CougsInSpace/CougSat1-Hardware/CougSat1-RadioBoard/Documentation/Native/Comms.docx

[Type the author(s)]

[Abstract]

Comms

Inter-Communication System

Revision: [Version]


# 1 Example Heading

Lorem ipsum dolor sit amet, consectetur adipiscing elit. Ut auctor dui vel orci congue imperdiet. Nunc sollicitudin sodales metus. Nunc congue, sem semper egestas dictum, turpis augue feugiat tellus, eget posuere orci ligula ac nunc. Pellentesque quis ex lorem. Suspendisse et tincidunt massa. Curabitur maximus magna id ex ultrices pharetra vel nec ante. Aliquam erat volutpat. Phasellus at felis ullamcorper, molestie tortor a, imperdiet diam. Pellentesque ut porttitor nunc. Pellentesque pharetra at eros eget consectetur. Quisque elementum, libero et scelerisque tristique, leo augue tempor risus, sodales ultricies justo arcu tempus neque. Nulla et cursus velit. Proin sit amet auctor nulla. Mauris ultricies volutpat turpis et bibendum. Mauris sit amet turpis vel felis tristique varius non non lectus. Vestibulum dignissim volutpat erat in luctus.

## 1.1 Example Subheading

Lorem ipsum dolor sit amet, consectetur adipiscing elit. Ut auctor dui vel orci congue imperdiet. Nunc sollicitudin sodales metus. Nunc congue, sem semper egestas dictum, turpis augue feugiat tellus, eget posuere orci ligula ac nunc. Pellentesque quis ex lorem. Suspendisse et tincidunt massa. Curabitur maximus magna id ex ultrices pharetra vel nec ante. Aliquam erat volutpat. Phasellus at felis ullamcorper, molestie tortor a, imperdiet diam. Pellentesque ut porttitor nunc. Pellentesque pharetra at eros eget consectetur. Quisque elementum, libero et scelerisque tristique, leo augue tempor risus, sodales ultricies justo arcu tempus neque. Nulla et cursus velit. Proin sit amet auctor nulla. Mauris ultricies volutpat turpis et bibendum. Mauris sit amet turpis vel felis tristique varius non non lectus. Vestibulum dignissim volutpat erat in luctus.

### 1.1.1 Example Subheading

Lorem ipsum dolor sit amet, consectetur adipiscing elit. Ut auctor dui vel orci congue imperdiet. Nunc sollicitudin sodales metus. Nunc congue, sem semper egestas dictum, turpis augue feugiat tellus, eget posuere orci ligula ac nunc. Pellentesque quis ex lorem. Suspendisse et tincidunt massa. Curabitur maximus magna id ex ultrices pharetra vel nec ante. Aliquam erat volutpat. Phasellus at felis ullamcorper, molestie tortor a, imperdiet diam. Pellentesque ut porttitor nunc. Pellentesque pharetra at eros eget consectetur. Quisque elementum, libero et scelerisque tristique, leo augue tempor risus, sodales ultricies justo arcu tempus neque. Nulla et cursus velit. Proin sit amet auctor nulla. Mauris ultricies volutpat turpis et bibendum. Mauris sit amet turpis vel felis tristique varius non non lectus. Vestibulum dignissim volutpat erat in luctus.

# 2 Example Heading

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

## 2.1 Example Subheading

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

### 2.1.1 Example Subheading

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

Rev. [Version]

Inter-Communication System Comms
