CougsInSpace/CougSat1-Hardware/CougSat1-AvionicBoard/Documentation/Images/AvionicsBottom.1.3.0.png

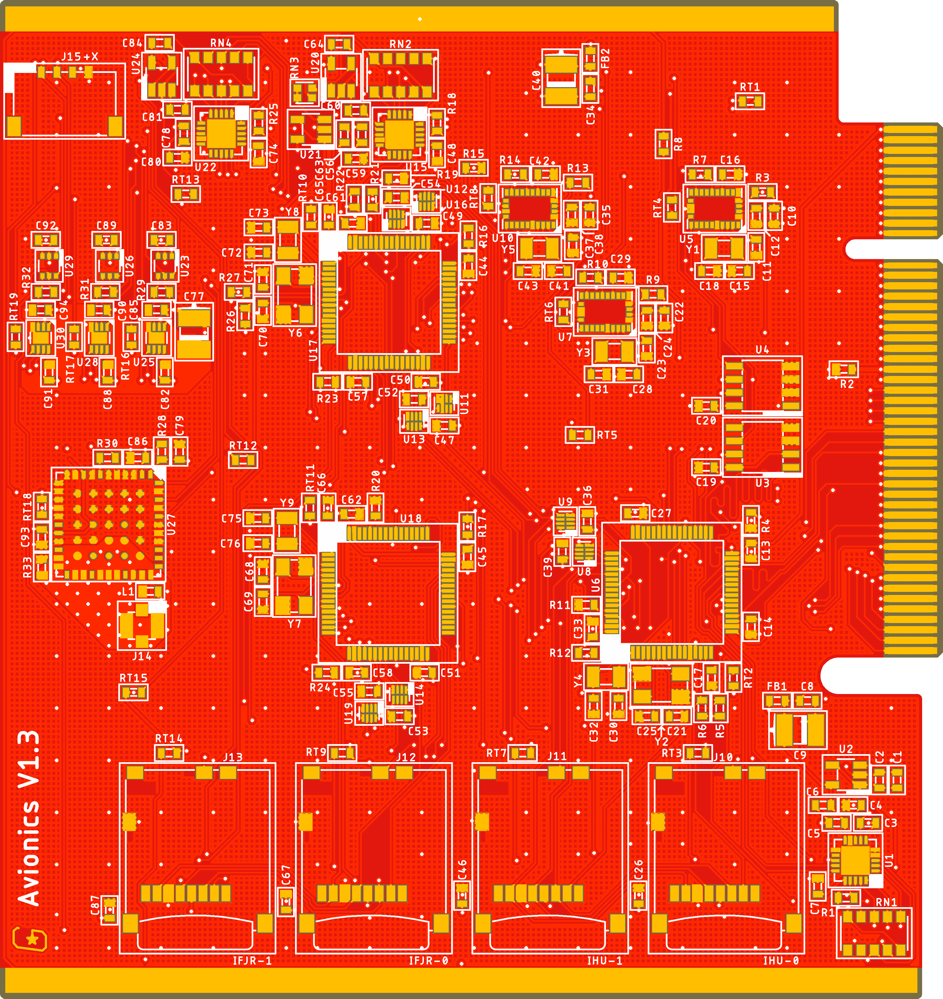
CougSat1-AvionicBoard/Documentation/Images/AvionicsBottom.1.3.0.png
