CougsInSpace/CougSat1-Hardware/CougSat1-Backplane/Documentation/Images/BackplaneBottom.3.0.4.png

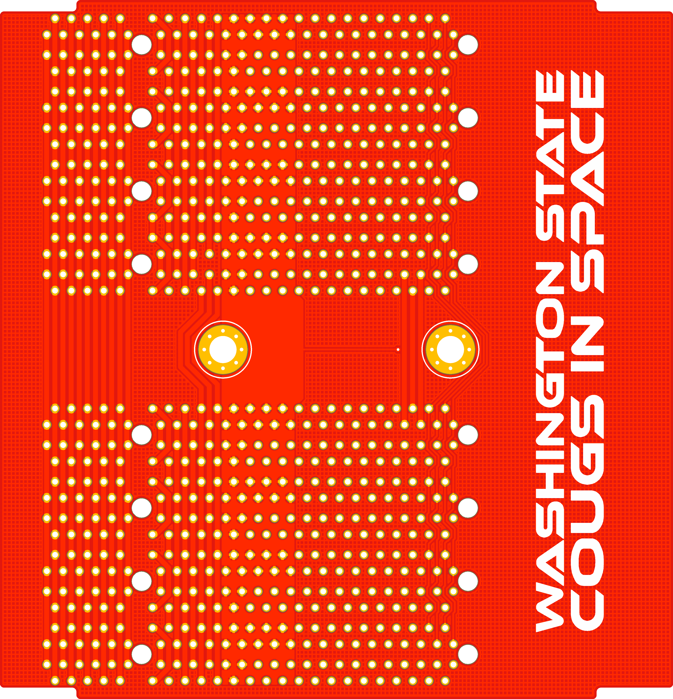
CougSat1-Backplane/Documentation/Images/BackplaneBottom.3.0.4.png
