CougsInSpace/CougSat1-Hardware/CougSat1-Backplane/Documentation/Images/BackplaneBottom.3.2.1.png

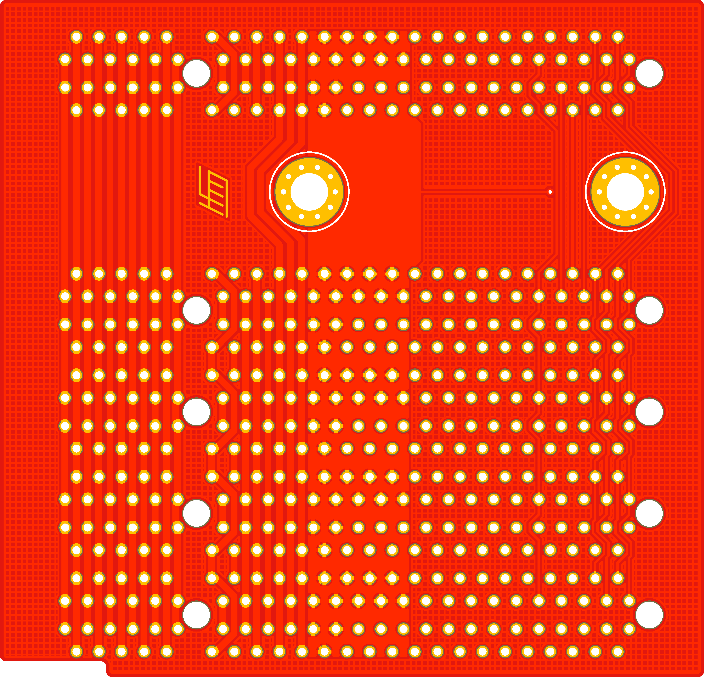
CougSat1-Backplane/Documentation/Images/BackplaneBottom.3.2.1.png
