CougsInSpace/CougSat1-Hardware/CougSat1-Backplane/Documentation/Images/BackplaneTop.3.2.1.png

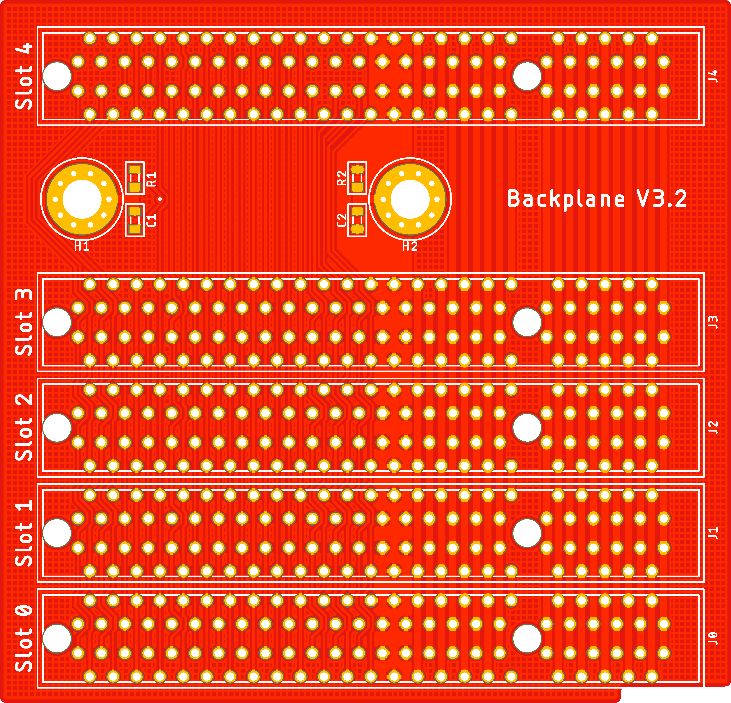
CougSat1-Backplane/Documentation/Images/BackplaneTop.3.2.1.png
