CougsInSpace/CougSat1-Hardware/CougSat1-Backplane/Documentation/Native/PCBImages/Layer_BottomSilkscreen.png

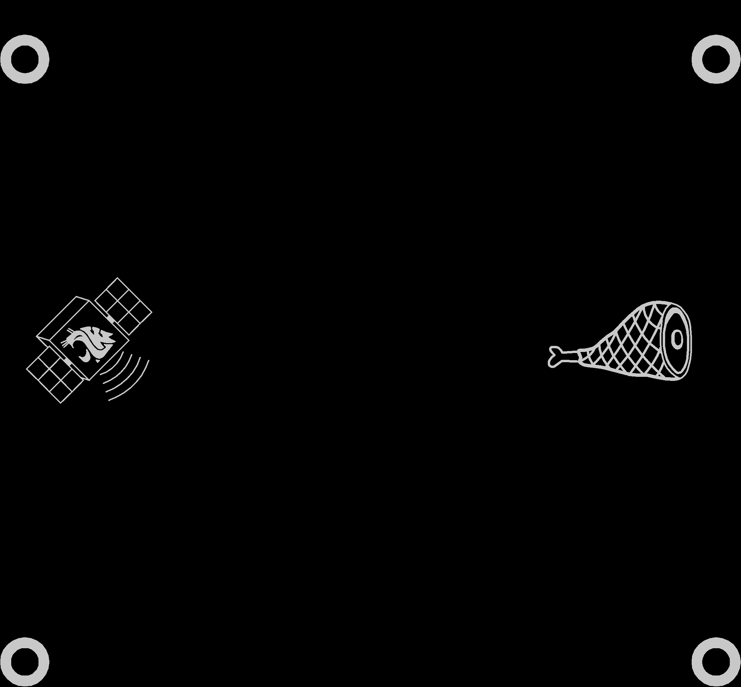
CougSat1-Backplane/Documentation/Native/PCBImages/Layer_BottomSilkscreen.png
