CougsInSpace/CougSat1-Hardware/CougSat1-Backplane/Documentation/Native/PCBImages/Layer_BottomStopmask.png

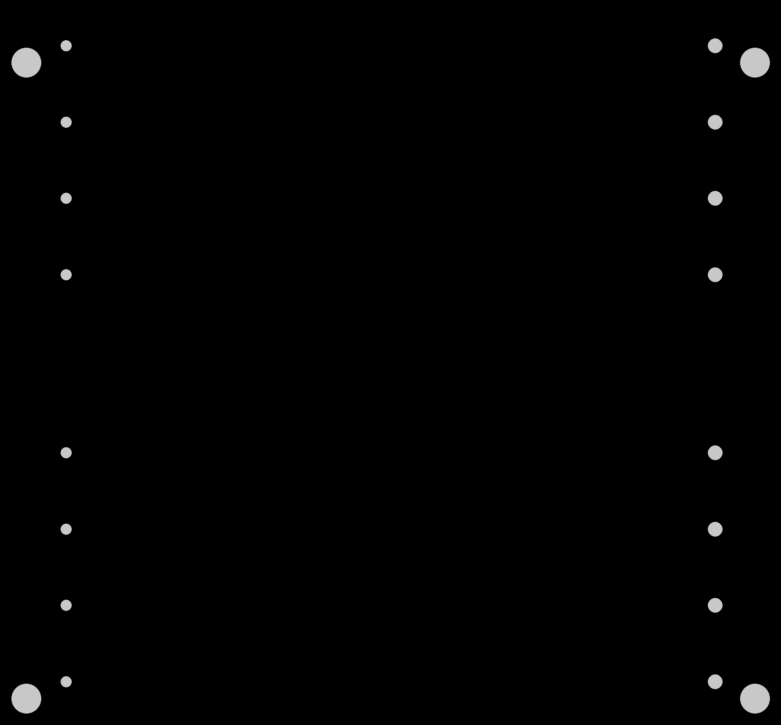
CougSat1-Backplane/Documentation/Native/PCBImages/Layer_BottomStopmask.png
