CougsInSpace/CougSat1-Hardware/CougSat1-Backplane/Documentation/Native/PCBImages/Layer_Drills.png

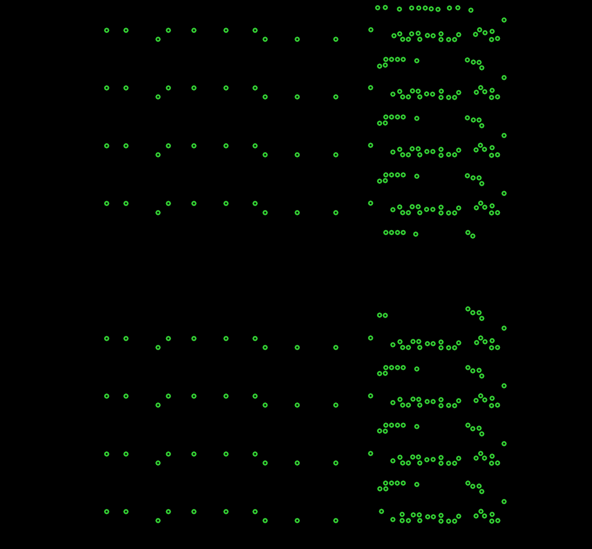
CougSat1-Backplane/Documentation/Native/PCBImages/Layer_Drills.png
