CougsInSpace/CougSat1-Hardware/CougSat1-Payload/Documentation/Images/Payload-CameraTop.1.1.2.png

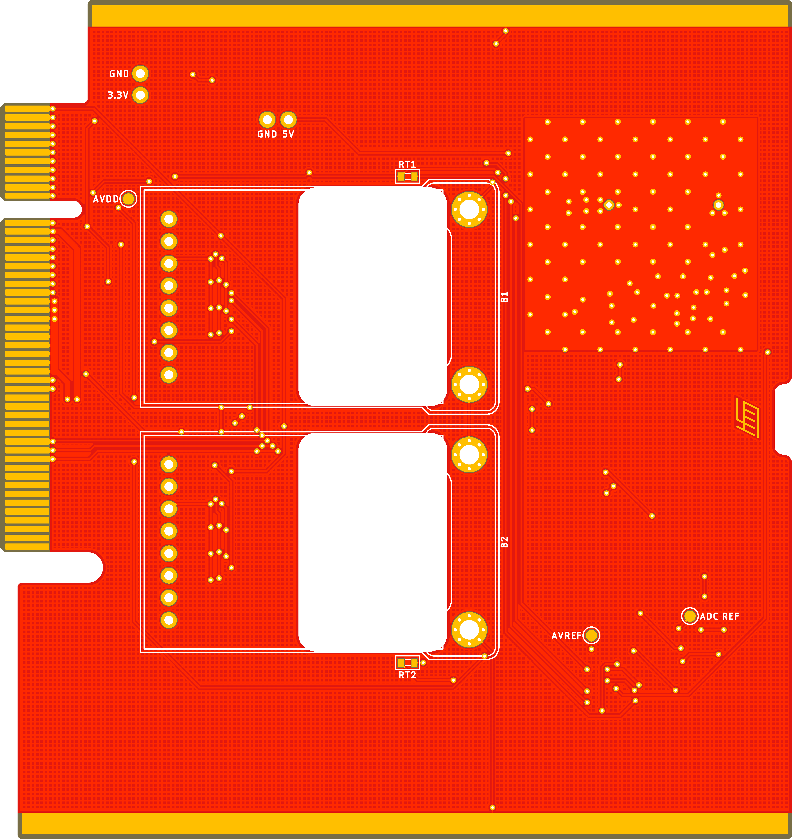
CougSat1-Payload/Documentation/Images/Payload-CameraTop.1.1.2.png
