CougsInSpace/CougSat1-Hardware/CougSat1-PowerBoard/Documentation/Images/EPSBottom.2.1.5.png

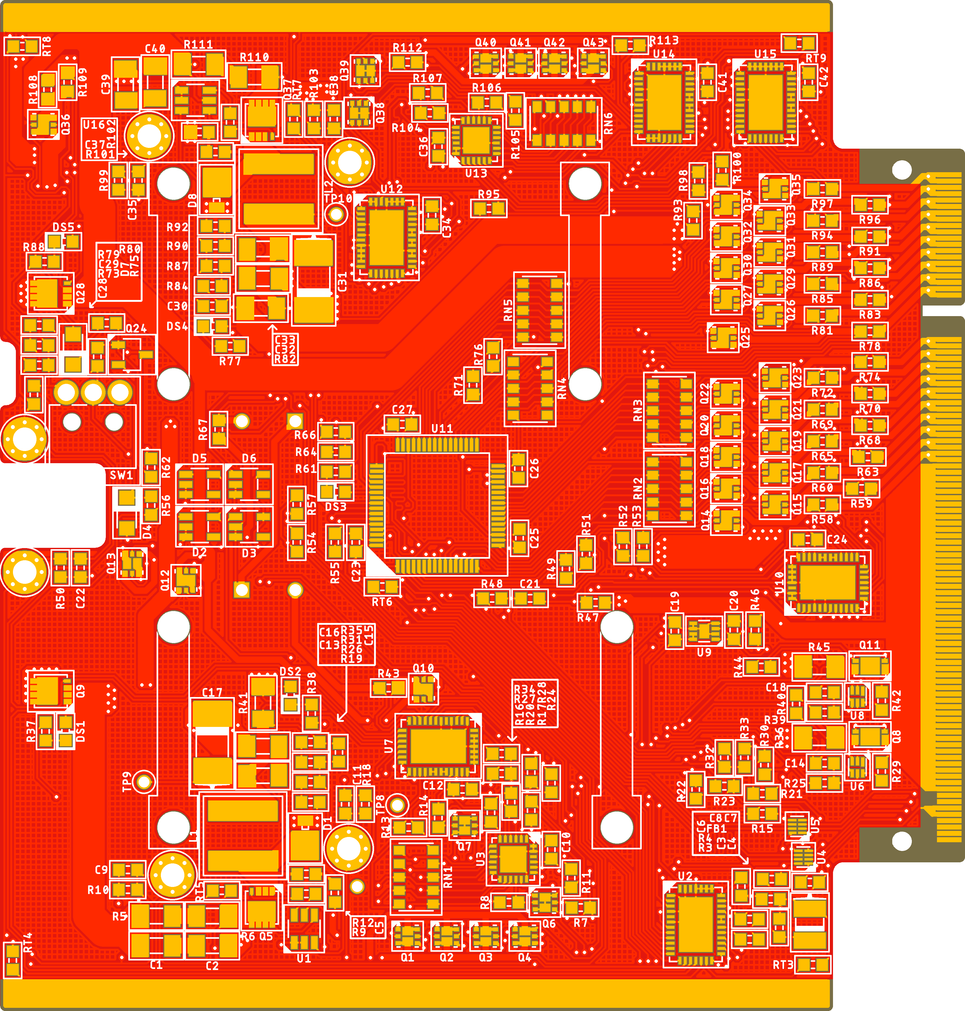
CougSat1-PowerBoard/Documentation/Images/EPSBottom.2.1.5.png
