CougsInSpace/CougSat1-Hardware/CougSat1-PowerBoard/Documentation/Images/EPSBottom.3.0.2.png

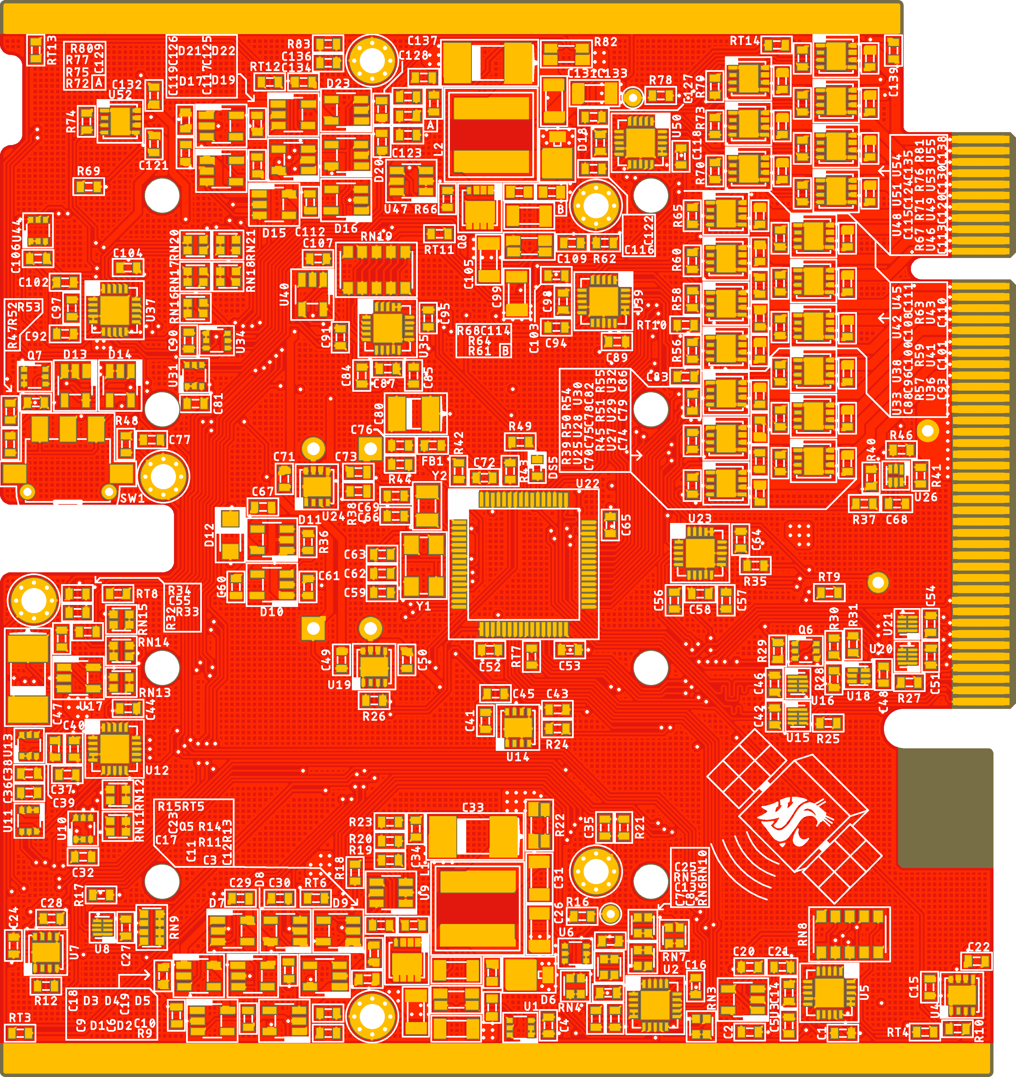
CougSat1-PowerBoard/Documentation/Images/EPSBottom.3.0.2.png
