CougsInSpace/CougSat1-Hardware/CougSat1-PowerBoard/Documentation/Images/EPSBottom.3.1.0.png

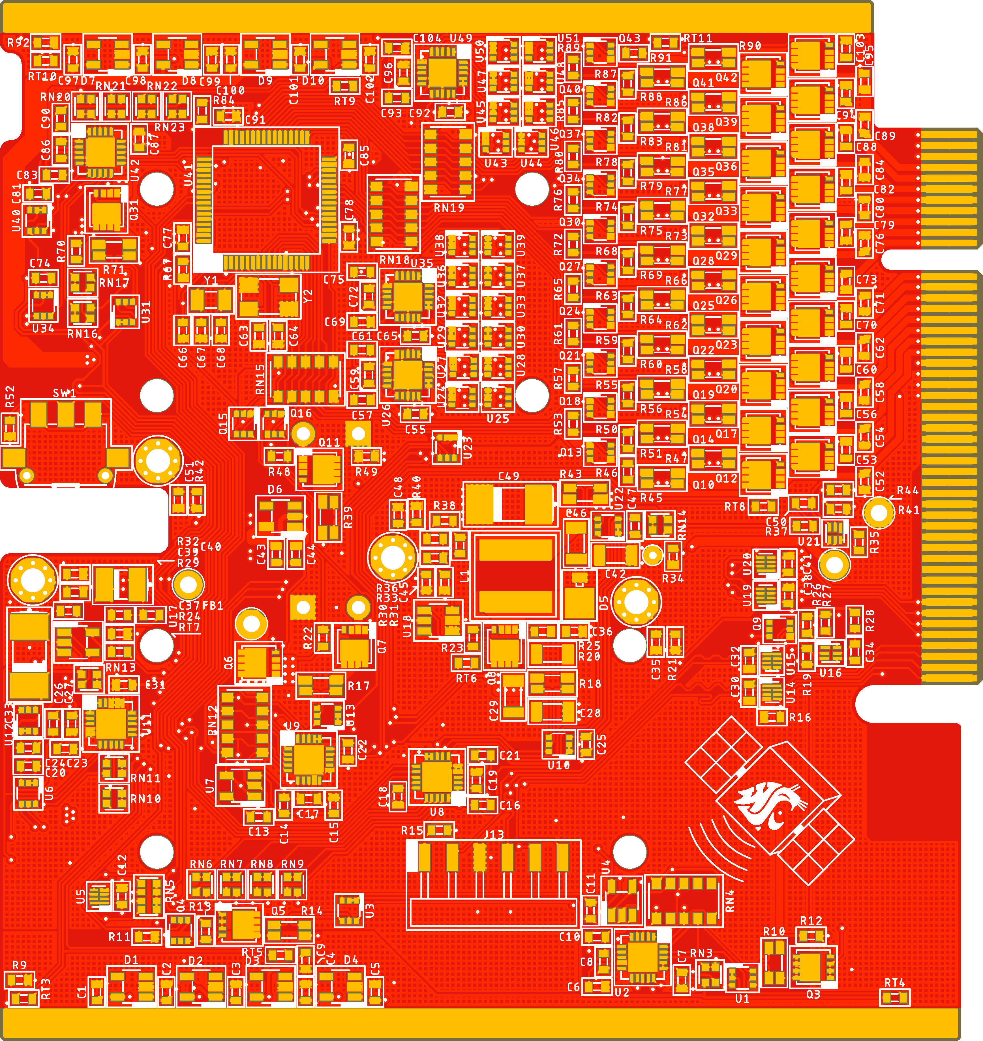
CougSat1-PowerBoard/Documentation/Images/EPSBottom.3.1.0.png
