CougsInSpace/CougSat1-Hardware/CougSat1-PowerBoard/Documentation/Images/EPSTop.2.1.5.png

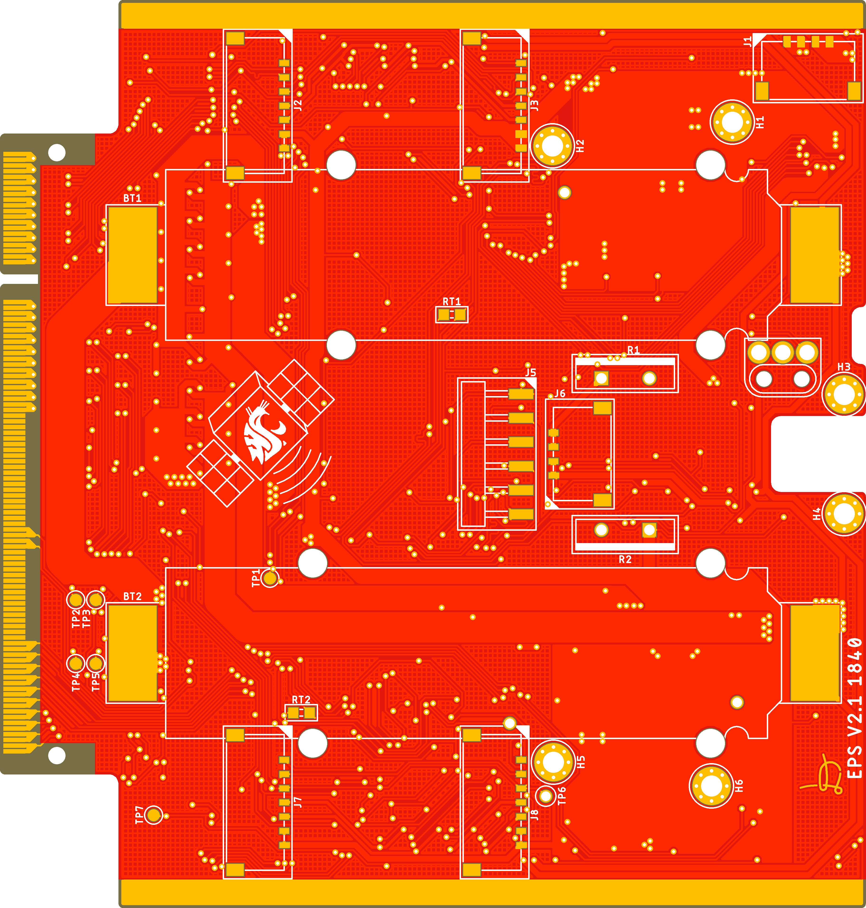
CougSat1-PowerBoard/Documentation/Images/EPSTop.2.1.5.png
