CougsInSpace/CougSat1-Hardware/CougSat1-PowerBoard/Documentation/Images/EPSTop.3.0.2.png

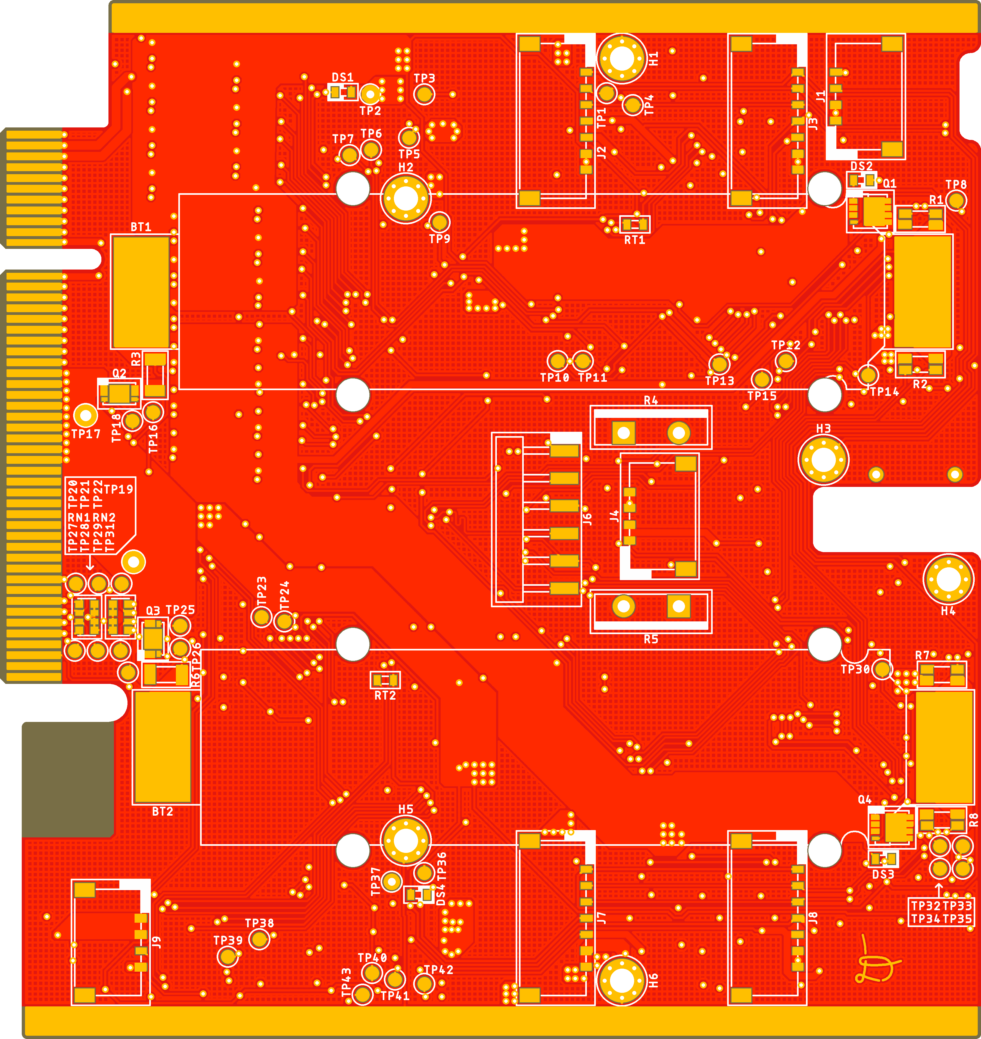
CougSat1-PowerBoard/Documentation/Images/EPSTop.3.0.2.png
