CougsInSpace/CougSat1-Hardware/CougSat1-PowerBoard/Documentation/Images/EPSTop.3.1.0.png

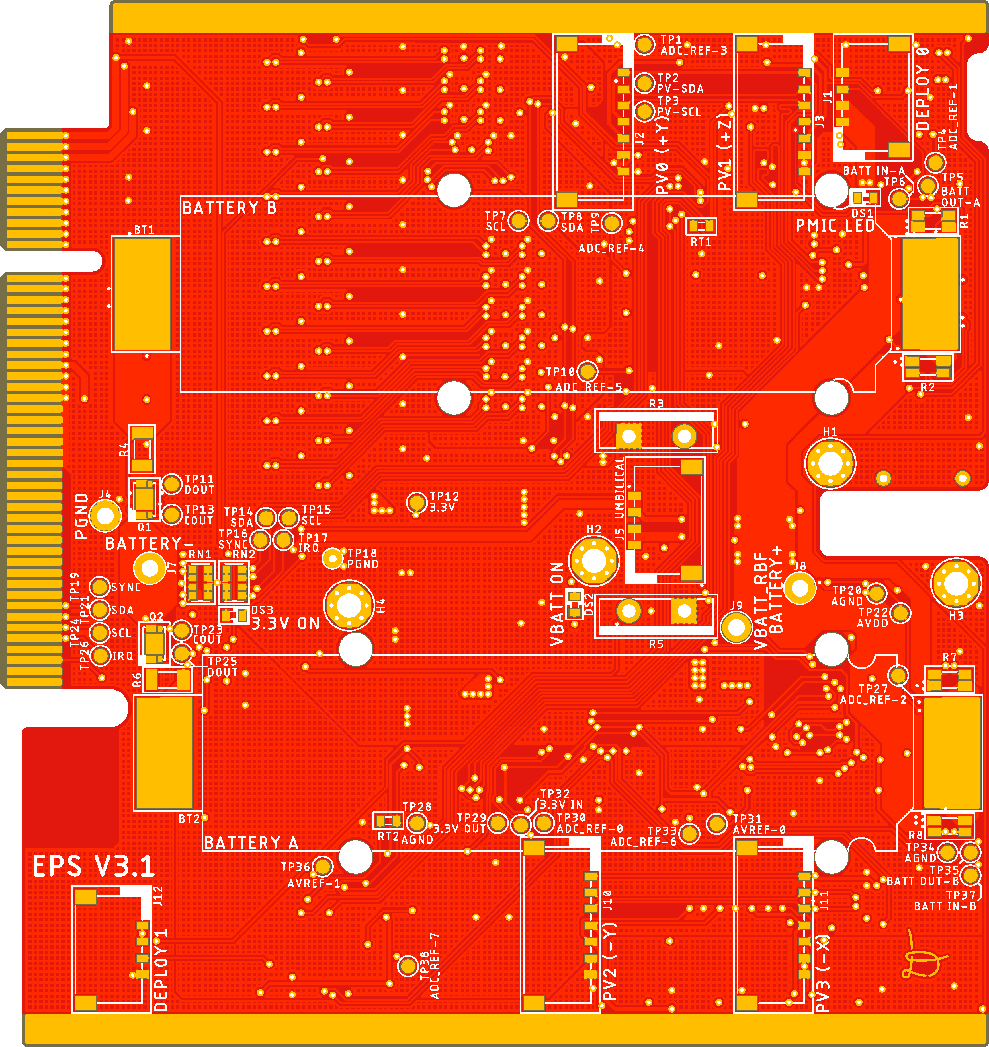
CougSat1-PowerBoard/Documentation/Images/EPSTop.3.1.0.png
