CougsInSpace/CougSat1-Hardware/CougSat1-PowerBoard/Documentation/Images/SolarPanelBottom.2.0.4.png

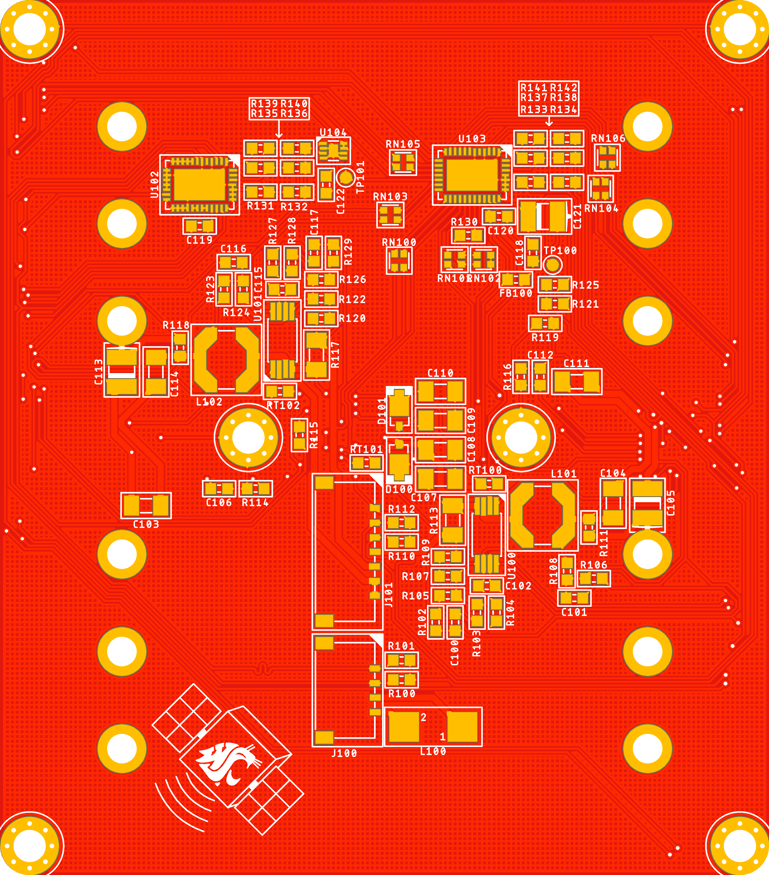
CougSat1-PowerBoard/Documentation/Images/SolarPanelBottom.2.0.4.png
