CougsInSpace/CougSat1-Hardware/CougSat1-PowerBoard/Documentation/Images/SolarPanelBottom.2.1.0.png

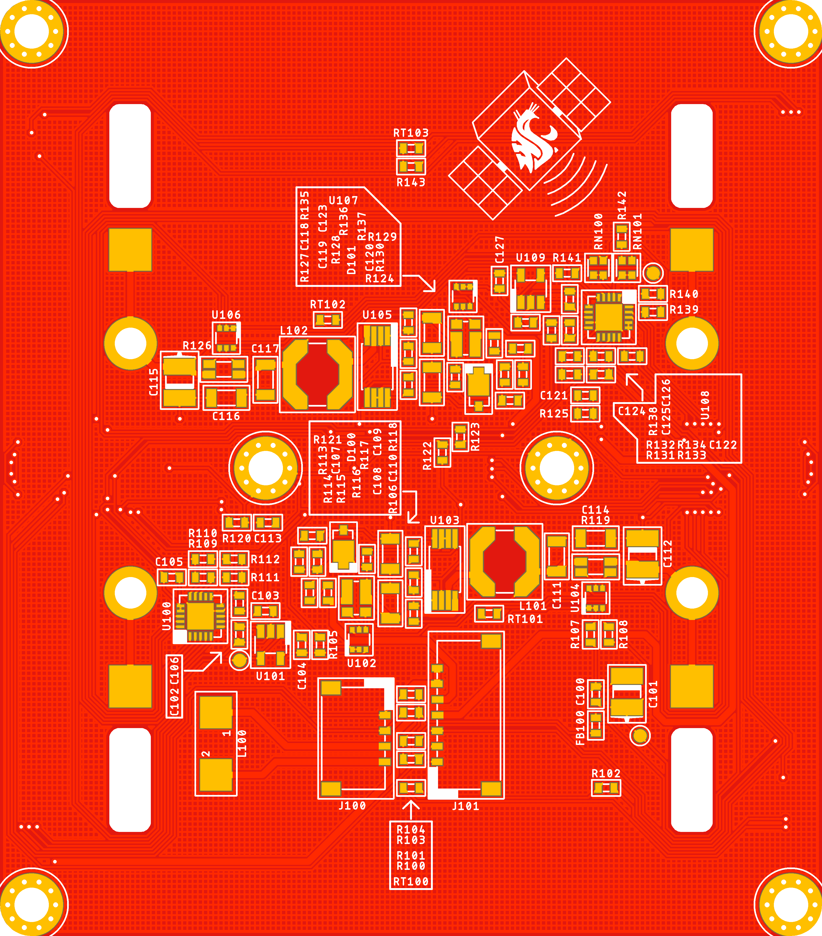
CougSat1-PowerBoard/Documentation/Images/SolarPanelBottom.2.1.0.png
