CougsInSpace/CougSat1-Hardware/CougSat1-RadioBoard/Documentation/Images/+XPanelTop.1.1.png

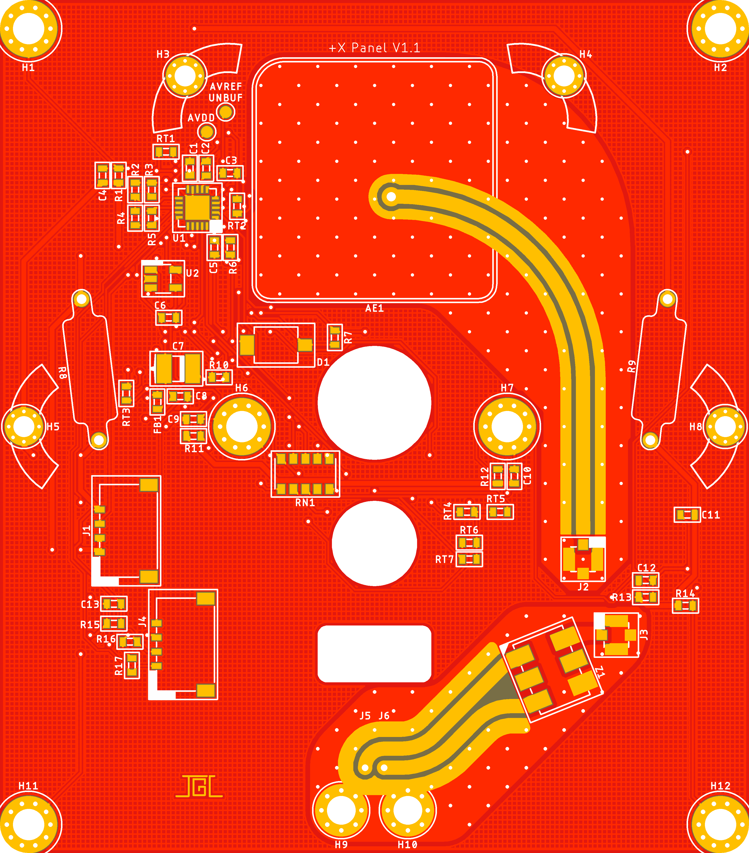
CougSat1-RadioBoard/Documentation/Images/+XPanelTop.1.1.png
