CougsInSpace/CougSat1-Hardware/CougSat1-RadioBoard/Documentation/Images/-ZPanelTop.1.1.1.png

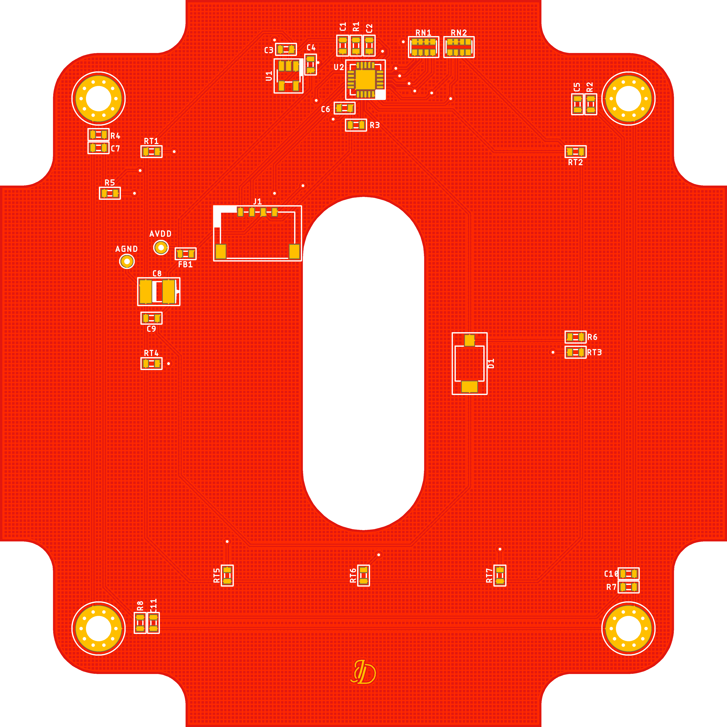
CougSat1-RadioBoard/Documentation/Images/-ZPanelTop.1.1.1.png
