CougsInSpace/CougSat1-Hardware/CougSat1-RadioBoard/Documentation/Images/CommsBottom.1.0.4.png

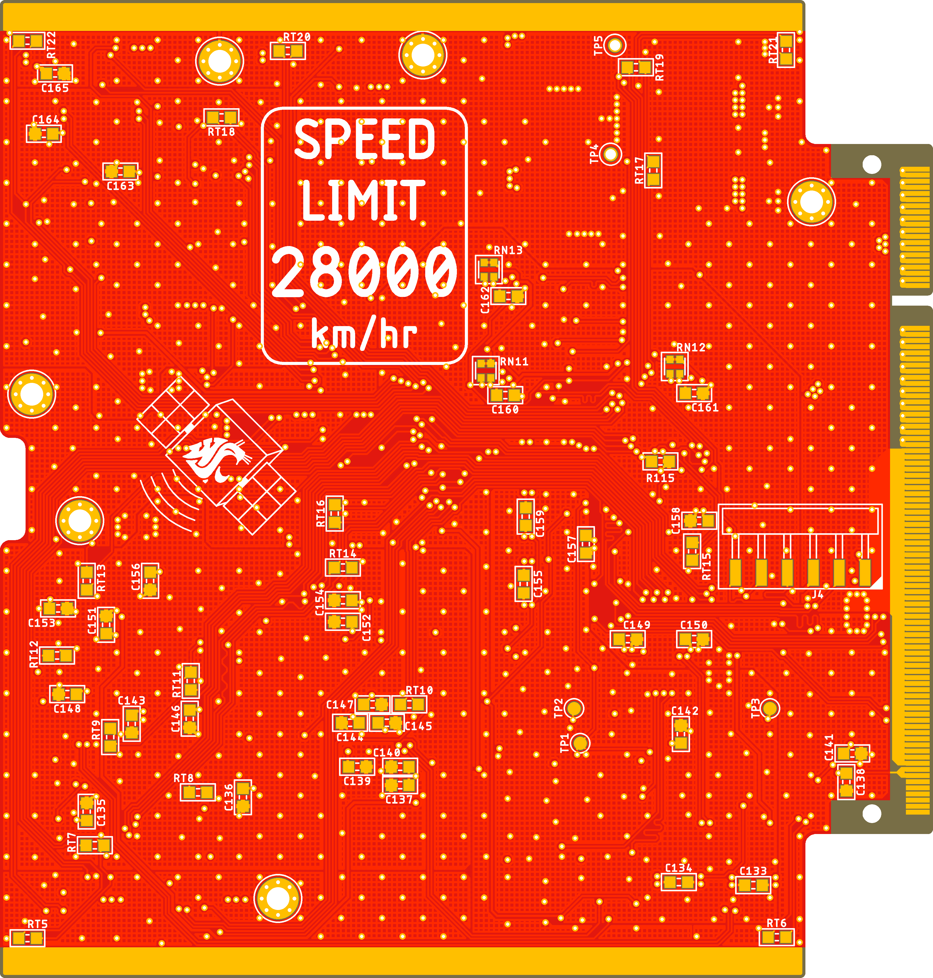
CougSat1-RadioBoard/Documentation/Images/CommsBottom.1.0.4.png
