CougsInSpace/CougSat1-Hardware/CougSat1-RadioBoard/Documentation/Images/CommsTop.1.2.0.png

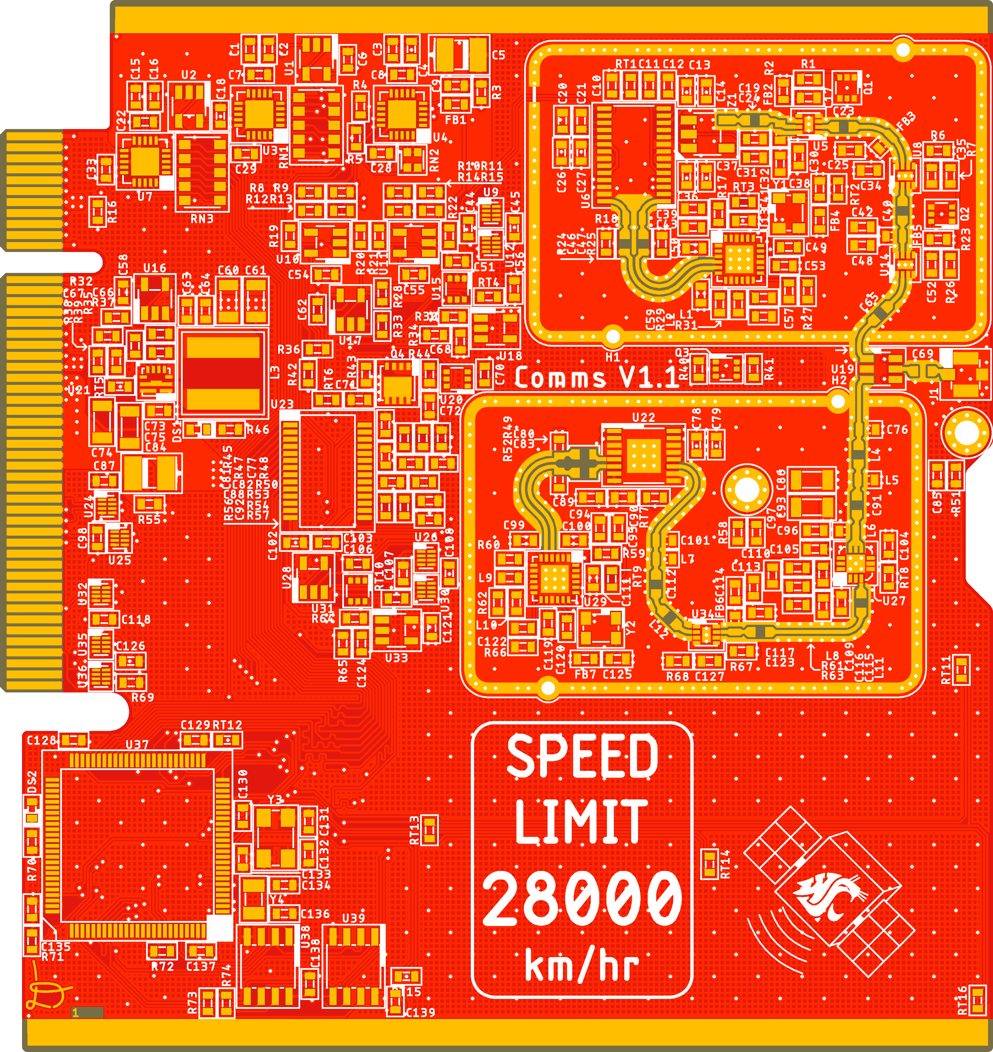
CougSat1-RadioBoard/Documentation/Images/CommsTop.1.2.0.png
