CougsInSpace/CougSat1-Hardware/CougSat1-RadioBoard/Documentation/Native/Link Budget.xlsx

Sheet: Title Page
 |  |  | AMSAT / IARU Annotated Link Model System
 | University: |  | Washington State University
 | Project: |  | CougSat-1
Developed by: Jan A. King, W3GEY/VK4GEY With Editorial Assistance and Support from Ralph Wallio, WФRPK
 | NOTE #1: |  | Enter Name of Communications Engineer:
 |  | Com. System Engineer: | Bradley Davis
 | NOTE #2: |  | Enter Name of Lead Systems Engineer
 |  | Lead Systems Engineer: | Bradley Davis
 |  |  | Enter Name of Project Manager:
 |  | Project Manager: | Bradley Davis
 | NOTE #3: | Orbit Type: | Near Circular; Polar; 600 km Altitude
 | NOTE #4: | Model Under | Helical High Speed Link
 |  | Investigation: | PICOSATELLITE
 | NOTE #5: | File Name/Revision | Link Budget 1.0.0
 |  | Date Data Last Modified: | 2020 January 17
 | NOTE #6
 |  | Date W/S Formulas | 2005 June 23
 |  | Last Modified:

Sheet: I.I.R.R.
Introduction, Instructions for Use, References, Revisions: |  |  |  |  |  |  |  |  | CougSat-1 |  | 2020 January 17
 | Introduction:
 | This spreadsheet system is an attempt to provide a new kind of learning tool. It is intended, clearly, to be a working link model in order to allow satellite
 | system designers to design and then document fully the RF radio links associated with Command (uplink) and Telemetry (downlink) equipment. It is,
 | however, also intended to be a tutorial on the RF portion of a satellite system. The model makes liberal use of "pop-up" notes and "tools" to enhance the
 | understanding (and hopefully the knowledge) of the Link Model Operator (that's you). After you use the model for awhile, let me know if I have
 | been successful. - Jan A. King, W3GEY and VK4GEY; w3gey@amsat.org
 | Instructions for Use:
 |  | Colors: | Colors are used in the link model to make it easier to find data and to protect the link model from crashing. Many of the worksheets
 |  | are interconnected in that equations in one W/S refer forward or back to data located in other worksheets. Loss of this connection could be critical.
 |  | Also, the cells are not yet protected (and may never be) as the system has not yet been finalized. Color can be used to provide "coded" messages to
 |  | the link model operator's brain, once it has been used for awhile. This has been found by the designer to be fairly effective (at least with his brain).
 |  | Color is used for both the text and the cell background. Some colors have been picked for large field areas where it is not so nice to have the
 |  | Excel cell grid structure showing. Typically, light grey |  |  |  |  |  | light green |  | light yellow | or white are used this way.
 |  | These colors have been found by our staff psychologist to have a relaxing effect on the operator. Now let's look at the important uses of color:
 |  |  | NOTE: | This is a "pop-up" note. You will see a lot of single cells throughout the model that look like this. Using your mouse, place
 |  |  | your cursor on the cell. You don't need to click. A note will pop up. These are either local instructions on how to enter data or use
 |  |  | data or some form of training note. You will find that some notes are somewhat larger than the screen. I've tried hard to avoid this, but
 |  |  | I haven't been entirely successful. The problem with this is that if you scroll to see the rest of the note and if the yellow cell scrolls off of
 |  |  | the screen then the note will close. Frustration will ensue. There are two solutions: 1) Reduce the scale of the viewing page from
 |  |  | 100% (the ususal setting) to 75% or 85%. This should allow you to see all of the note. 2) Alternatively, using the mouse, select from
 |  |  | the upper toolbar, "View", "Toolbars", and select the one called "Reviewing". There should now be a checkmark to the left of that option.
 |  |  | Now, you should find a new toolbar up above the text area of Excel. The far left icon will say "new comment" if you are making a new
 |  |  | one. But, if you move the curser over the far left icon you will notice the pop-up prompt now says "edit cell." Now, move the curser
 |  |  | over the "NOTE:" cell and left click then left click on the same far left icon. This will allow you to edit the cell BUT it will also FREEZE
 |  |  | the cell in the ON condition. Now, you can move the note around by using the slide bars on the side and bottom of the screen to see
 |  |  | all of the note. It's probably a good idea not to modify the note. You can close the note by just moving the cursor to an empty cell
 |  |  | somewhere and left clicking. It is suggested that you try this process now with the test note above at Cell [D23]. It's been set up
 |  |  | to frustrate you in just such a way as the real notes might do later on.
 |  |  | X.XX | This is a data entry cell. The link model operator is expected to enter data. The blue background means it is a critcal
 |  |  | data entry cell. It is anticipated that your system's selected value is quite likely to be different than the default value used in the cell when you
 |  |  | received this link model.
 |  |  | X.XX | This is also a data entry cell. This type of cell may not need to be changed as the value you are likely to use may be the same
 |  |  |  | as the default value.
 |  |  | X.XX | This is a cell containing an equation or a constant that should not be changed. The operator should not modify these cells. A
 |  |  | majority of the link model contains this type of cell.
 |  |  | X.XX | or | X.XX | These are cells containing important but, intermediate results. Two colors were used to provide a slight gradation
 |  |  | of importance. The orange color is considered to be a result having slightly more significance than the lighter yellow cell.
 |  |  | X.XX | This is a key "bottom line" result. It is a primary output of a particular W/S.
 |  |  | X | or | X | or | X | A few cells use conditional fomatting which allow the cell colors to change depending on
 |  |  | the outcome of the preceeding calculations. Typically a RED box means the result was not successful in achieving the desired performance.
 |  |  | A GREEN box means the result did meet or exceed the desired performance. A YELLOW box means the result achieved the performance
 |  |  | threshould but, is considered marginal.
 |  |  | Sub-Title Box |  | A pink box like this is simply a sub-title for a sub-worksheet.
 |  |  | X.XX | An olive green box is a location where data has been transferred to this worksheet from another and may be transferred to yet another.
 |  |  | No action need be taken here. It's purpose is only so that the operator is aware that the data is being transferred from and to other locations.
 |  |  | Frequency | Sometimes an olive green cell will be used to re-emphasize a frequency selection as in the "System Performance Summary" W/S.
 |  |  | Non-Coherent FSK |  | Sometimes a tan color cell is used to denote a selected system condition that is non-numeric.
 |  | Gains and Losses: |  | A positive gain or directivity is always experssed as a positive number. Sometimes the value may be seen to have a + in front of it.
 |  | Gains can also be negative (remember, the gain of an antenna is expressed as 10log(P/Pisotropic). So, if the gain in a particular direction, is below that of an
 |  | isotropic radiator, then the gain will be expressed as a negative number in dBi.
 |  | Losses in link budgets are commonly found as either positive or negative. A loss, by it's nature, is a negative quantity but, some believe that if the loss
 |  | is clearly referred to as such in the budget parameter column, it can have a positive sign. That is the case in this link budget. All losses are shown
 |  | as being a positive value. The argument is symantic. The question could be asked, "Is a positive loss a negative? And is a negative loss, positive?
 |  | The important thing for the link model operator to know when using this modeling system is that the losses are show as positive values BUT,
 |  | in the equations that sum the gains and losses to yield the result, the gains are added and the losses are subtracted. For example,
 |  | see the equation in Cell [B11] of the "Uplink" W/S.
 |  | Speciality W/S vs. Tools: |  |  | The first 13 W/Ss are all interconnected, in that they all have equations that make use of data
 |  | contained in one or more of the other W/Ss. These worksheets, taken together, constitute the link model. The next 5 W/Ss are supplementary
 |  | to the model and are considered to be tools. The important distinction is, that tools never produce results that are automatically linked
 |  | into the model itself, whereas within the first 13 W/Ss there is lots of interlinking going on. The primary process is one where data
 |  | calculated or selected in one of the Speciality W/Ss (e.g., Receivers) becomes just one entry in either the Uplink or the Downlink budget.
 |  | The usefulness of a tool is to be able to explore a specific tradeoff without having to worry about that data winding up in the formal
 |  | Uplink or Downlink pages.
 |  | There is one additional and imporatant comment about tools. Within the Speciality W/Ss, there are some embedded tools. The best
 |  | example of this is in the "Receivers" W/S. Contained in separate sub-tables is a Noise Figure/Noise Temperature Calculator (Tool)
 |  | and a Ground Station, Antenna or Sky Noise Temperature Calculation Tool.
 |  | Proceeding Through the Model: |  |  |  | Starting with the "Title Page" W/S, proceed through each Speciality W/S, adding data,
 |  | in sequence. Then select the next tab at the bottom of the W/S. The "Uplink", "Downlink" and "System Performance Summary" W/Ss
 |  | contain the final results of the model. The Tools W/Ss are located beyond the "System Perfomance Summary" W/S and may be
 |  | explored and used as they may be helpful to you. Any comments you may have on this model will be greatfully received by me. Thanks!
 |  | Jan, VK4GEY.
 | References: |  | The following references were used to prepare this link model:
 | 1 | A.R.R.L., The ARRL Antenna Handbook, American Radio Relay League, 1974, pp. 153-155.
 | 2 | Deloraine, E.M., Westman, H.P., Edie, L.C. Reference Data for Radio Engineers, 3rd Edition, Federa Telephone & Radio Corp., 1949, pp. 362-396.
 | 3 | Feher, Dr. Kamilo, Digital Communications, Satellite/Earth Station Engineering, Prentice-Hall Books, 1983, Chapter 4.
 | 4 | Ippolito, L.J.Jr., Radiowave Propagation in Satellite Communications, Van Norstrand Reinhold Co., 1986, Chapters 3 and 7.
 | 5 | Jordan, E.C. (Edit.), Reference Data for Engineers: Radio, Electronics, Computer, and Communications, 7th Edition, Howard W. Sams & Co.,
 |  | 1985, pp. 29-26 - 29-37 and pp. 30-03 - 30-11.
 | 6 | Martin, W.L., AMMOS and DSN Support of Earth Orbiting and Deep Space Missions, Jet Propulsion Laboratory, TMOD Directorate, 1996, p.44-46.
 | 7 | Morgan, W.L. and Gordon, G.D., Principles of Communicaitons Satellites, John Wiley & Sons, Inc., 1993, Chapter 2 and pp.140-143.
 | 8 | Van Wie, D.G. and Roark, R.C., A New Alert Protocol, Blue Water Design, LLC, 2003, pp. 18-23.
 | 9 | Jackson, R.B., The Canted Turnstile as an Omnidirectional Spacecraft Antenna, X-712-67-441, NASA/Goddard Space Flight Center, 1967, Entire Document.
 | Revisions: |  | The following formal revisons have been made to this Link Model System:
 | Version: | Date: | Adjustments and/or Modifications Made:
 | 2.0 | 2005-01-30 | NEW; b-Test Version
 | 2.1 | 2005-02-07 | Revised All "Pop-up" Notes; Corrected some cell colors to improve consistancy; Added reference 9; Corrected cells A19 & D19 in "Uplink" W/S.
 | 2.1.1 | 2005-02-12 | Revised Equation at Cell [B15] of "Uplink Budget" W/S. Index function should use column H values not column C values.
 | 2.1.2 | 2005-02-21 | Modified Data for Monopole Antenna Pattern in Monopole Table in "Antenna Patterns" W/S. Added 3 dB to all Values (0° to 90°)
 | 2.1.3 | 2005-02-26 | Modified "Receviers" W/S. Added loss value for cable D. Modified 2nd Stage to "Communications Receiver" at Ground Station.
 | 2.1.4 | 2005-02-27 | Added Tubo Code Option to "Modulation-Demodulation Method" W/S.
 | 2.2 | 2005-02-27 | Added EZNEC+ and Chart Wizzard Antenna Plots to "Antenna Pattern" W/S.
 | 2.2.1 | 2005-05-15 | Edited Notes in I.I.R.R W/S.
 | 2.2.2 | 2005-06-23 | Edited More Notes Throughout Link Model.

Sheet: Orbit & Frequency
System Orbit Performance: |  |  |  | CougSat-1 |  |  | 2020 January 17 |  | 0
CougSat-1
 | NOTE: |  | Blue | = User Data Entry Values |  |  | Red | = Key Results |  | NOTE: Cells Not Yet Protected
Element Reference Epoch: | 2005, 87.50000 |  | Black | = Computed Values (No Data Entry) |  |  | Blue | =Critical User Data Entry Values
Orbit Properties
Slant Range to Spacecraft vs. Elevation Angle
Parameter: | Value: | Unit:
Earth Radius: | 6378.14 | km
Height of Apogee (ha): | 410.0 | km
Height of Perigee (hp): | 408.0 | km
Semi-Major Axis (a): | 6787.1 | km
Eccentricity (e): | 0.000147
Inclination (I): | 51.64 | degrees
Argument of Perigee (w): | 142.8 | degrees
R.A.A.N. (W): | 13.94260 | degrees
Mean Anomaly (M): | 217.32 | degrees
Period: | 92.745 | minutes
dw/dt: | 3.7085 | deg./day
dW/dt: | -4.9725 | deg./day
dM/dt: | Not Implemented | deg./day
Mean Orbit Altitude: | 409.00 | km
Mean Orbit Radius: | 6787.14 | km
Sun Synchronous Inclination: | 97.07 | degrees
Elevation Angle (d): | 10.0 | degrees
Slant Range (S): | 1463.69 | km.
UPLINK & DOWNLINK Frequency Choices:
 | Option: | Frequency: |  | Wavelength (l): |  | Path Loss:
Uplink: | #1: | 145.800 | MHz | 2.056 | meters | 139.0 | dB | Uplink Frequency Choice: |  |  | 2 | 437.500 | MHz
 | #2: | 437.500 | MHz | 0.685 | meters | 148.6 | dB
 | #3: | 1269.900 | MHz | 0.236 | meters | 157.8 | dB
Operator Selected Option: | #4: | 145.800 | MHz | 2.056 | meters | 139.0 | dB
 |  |  |  |  |  |  |  | Path Loss = 22.0 + 20 log (S/l)
Downlink: | #1: | 145.800 | MHz | 2.056 | meters | 139.0 | dB | Downlink Frequency Choice: |  |  | 2 | 437.450 | MHz
 | #2: | 437.450 | MHz | 0.685 | meters | 148.6 | dB
 | #3: | 2405.000 | MHz | 0.125 | meters | 163.4 | dB
Operator Selected Option: | #4: | 1269.900 | MHz | 0.236 | meters | 157.8 | dB
 | NOTE:

Sheet: Transmitters
System Transmitters & Line Losses: |  |  |  |  | CougSat-1 |  |  |  | 2020 January 17
 | Uplink Transmitter System (At Ground Station):
 | NOTE:
 |  | Block Diagram:
 |  |  |  |  | Line B |  | Line C |  | Antenna Mismatch
 |  | Transmitter Power: |  | 10.00 | Watts = | 10.0 | dBW = | 40.00 | dBm
 |  | Cable or Waveguide ("Line") Losses:
 |  |  | Line A Length: |  |  |  |  | 0.0 | meters
 |  |  | Line B Length: |  |  |  |  | 0.0 | meters
 |  |  | Line C Length: |  |  |  |  | 10.0 | meters
 |  |  | Total Line Length (Line A+B+C): |  |  |  |  | 10.0 | meters
 |  |  | Cable/W. Guide Type: |  |  |  |  | RG-8 | cable
 |  |  | Cable/W.Guide Loss/meter: | 0.05 dB/m | At (freq.) | 437.5 | MHz = | 0.5 | dB
 |  | Other Components in Line:
 |  |  | No. of In-Line Connectors: | 4 | Connectors X 0.05 dB/Con. = |  |  | 0.2 | dB
 |  |  | Filter Insertion Losses: |  |  |  |  | 0.0 | dB
 |  |  | Other In-Line Losses: | Device: |  |  |  | 0 | dB
 |  |  | Antenna Mismatch Losses: |  | (See "VSWR Loss Tool" W/S) |  |  | 0.18 | dB
 |  | Total Line Losses: |  |  |  |  |  | 0.88 | dB
 |  | Total Power Delivered to Antenna: |  |  |  |  |  | 9.12 | dBW
 | Downlink Transmitter System (At Spacecraft):
 |  | Block Diagram:
 |  |  | Line A |  | Line B |  | Line C |  | Antenna Mismatch
 |  | Transmitter Power: |  | 1.000 | Watts = | 0.0 | dBW = | 30.00 | dBm
 |  | Cable or Waveguide Loss:
 |  |  | Line A Length: |  |  |  |  | 0 | meters
 |  |  | Line B Length: |  |  |  |  | 0 | meters
 |  |  | Line C Length: |  |  |  |  | 0.1 | meters
 |  |  | Total Line Length (Lines A+B+C): |  |  |  |  | 0.1 | meters
 |  |  | Cable/Guide Type: |  |  |  |  | RG-188/AU | cable
 |  |  | Cable/Guide Loss/meter: | 0.58 dB/m | At (freq.) | 437.45 | MHz = | 0.058 | dB
 |  | Other Components in Line:
 |  |  | No. of In-Line Connectors: | 2 | Connectors X 0.05 dB = |  |  | 0.1 | dB
 |  |  | Filter Insertion Losses: |  |  |  |  | 0.0 | dB
 |  |  | Other In-Line Losses: | Device: |  |  |  | 0 | dB
 |  |  | Antenna Mismatch Losses: |  | (See "VSWR Loss Tool" W/S) |  |  | 0.180 | dB
 |  | Total Line Losses: |  |  |  |  |  | 0.34 | dB
 |  | Total RF Power Delivered to Antenna: |  |  |  |  |  | -0.34 | dBW

Sheet: Receivers
System Receivers and Line Losses: |  |  |  |  |  |  | CougSat-1 |  |  | 2020 January 17
 | Uplink Receiver System (At Spacecraft):
 |  | NOTE:
 |  | Block Diagram: |  |  |  |  |  |  |  |  |  | Section Verification
 |  |  |  |  |  |  |  | TLNA |  | T2nd Stage
 |  |  |  |  |  |  |  |  |  |  |  | Com. System Engineer: |  |  | John Oakes
 |  |  |  |  |  |  |  |  |  |  |  |  | x
 |  |  | LA |  | LB |  | LC
 |  |  |  |  |  |  |  |  |  |  |  | Lead Systems Engineer: |  |  | Philip Zanin Holtzman
 |  |  | To |  | To |  |  |  |  |  |  |  | X
 |  |  |  |  |  |  |  |  | To | To
 |  |  | System Noise Temperature (Ts):
 |  |  | Ts= (a)Ta + (1-a)To + TLNA + T2ndStage/GLNA
 |  |  | Where:
 |  |  | Ta º Antenna Temperature or Sky Temperature (°K)
 |  |  | To º System Line Temperature (Physical Temperature) (°K) º System Reference Temperature
 |  |  | TLNAº Noise Temperature of the Low Noise Amplifier (°K)
 |  |  | T2nd Stage º Noise Temperature of Next Stage Amplifier or Mixer (°K)
 |  |  | GLNA º The gain of the LNA in linear (non-dB) units |  |  |  |  | NOTE:
 |  |  | a º Feed Line Coefficient = 10^ -((LA/10)+(LB/10)+(LC/10)+(LBPF/10)+(Lother/10))
 |  |  | Where:
 |  |  |  | LA, LB, LC º All Cable or Waveguide Losses (expressed in dB)
 |  |  |  | LBPF º Insertion Loss of any bandpass fiter used in front of LNA (expressed in dB)
 |  |  |  | Lother º Insertion Loss of any other In-Line device in front of LNA (expressed in dB)
 |  |  | Cable or Waveguide "Line" Losses:
 |  |  |  | Line A Length: |  |  |  |  | 0.1 | meters
 |  |  |  | Line B Length: |  |  |  |  | 0 | meters
 |  |  |  | Line C Length: |  |  |  |  | 0 | meters
 |  |  |  | Cable/Guide Type: |  |  |  |  | RG-188/AU | cable
 |  |  |  | Cable/Guide Loss/meter: |  |  | 0.4 | dB at frequency | 437.5 | MHz
 |  |  |  | Line A Loss: |  |  |  | LA = | 0.04 | dB
 |  |  |  | Line B Loss: |  |  |  | LB = | 0 | dB
 |  |  |  | Line C Loss: |  |  |  | LC = | 0 | dB
 |  |  |  | Bandpass Filter Insertion Loss: |  |  |  | LBPF = | 0.0 | dB
 |  |  |  | Insertion Loss of Other In-Line Devices: |  |  |  | Lother = | 0.27 | dB
 |  |  |  | No. of In-Line Connectors: |  |  | 2 | X .05 dB/Con.= | 0.1 | dB
 |  |  |  | Other In-Line Device Type: |  |  |  |  | RF Switch
 |  |  |  |  |  |  |  |  |  |  |  |  | Noise Temperature/Noise Figure Calculator (Tool): |  |  |  |  |  |  | NOTE:
 |  |  |  | Total In-Line Losses from Antenna to LNA: |  |  |  |  | 0.41 | dB
 |  |  |  |  |  |  |  |  |  |  |  |  |  |  | NFdB = 10 LOG10[1+(T/To)]
 |  |  | Transmission Line Coefficient: |  |  |  |  | a = | 0.9099 |  |  |  |  |  |  | or
 |  |  |  |  |  |  |  |  |  |  |  |  |  |  | T = To[10^(NFdB/10)-1]
 |  |  | Antenna or "Sky" Temperature: |  |  | NOTE: |  | Ta = | 152.5 | K | From Charlie Brown
 |  |  |  |  |  |  |  |  |  |  | 1/2 sky, 1/2 earth |  | From Charlie Brown
 |  |  | Spacecraft Temperature: |  |  |  |  | To = | 280 | K |  |  | Galactic Noise |  | NFdB = | 1.0 | dB | T = | 72.5 | K
 |  |  |  |  |  |  |  |  |  |  |  |  | 145MHZ | 190.00 K
 |  |  | LNA Temperature: |  |  |  |  | TLNA = | 97.7 | K |  |  | 435MHz | 15.00 K |  |  | OR
 |  |  | LNA Gain: |  | 19.5 | dB |  | GLNA = | 89.1 |  |  |  |  |  | T = | 190.0 | K | NFdB = | 2.25 | dB
 |  |  | 2nd Stage Temperature: |  |  |  |  | T2ndStage = | 97.7 | K
 |  |  |  |  |  |  |  |  |  |  |  |  |  |  |  | Enter Data Here: |  |  | Result is Here
 |  |  | System Noise Temperature: |  |  |  |  | Ts = | 262.8 | K
 | Downlink Receiver System (At Ground Station):
 |  | Block Diagram:
 |  |  |  |  |  |  |  | TLNA |  | TComRcvr
 |  |  | LA |  | LB |  | LC
 |  |  | To |  | To
 |  |  | System Noise Temperature (Ts):
 |  |  | Ts= (a)Ta + (1-a)To + TLNA + TComRcvr/(GLNA/LD)
 |  |  | Where:
 |  |  | Ta º Antenna Temperature or Sky Temperature (°K)
 |  |  | To º System Line Temperature (Physical Temperature) (°K)
 |  |  | TLNAº Noise Temperature of the Low Noise Amplifier (°K)
 |  |  | TComRcvr º Noise Temperature of Communications Receiver Front End (°K)
 |  |  | GLNA º The gain of the LNA in linear (non-dB) units |  |  |  |  | NOTE:
 |  |  | a º Feed Line Coefficient = 10^ -((LA/10)+(LB/10)+(LC/10)+(LBPF/10)+(Lother/10))
 |  |  | Where:
 |  |  |  | LA, LB, LC º All Cable or Waveguide Losses (expressed in dB)
 |  |  |  | LBPF º Insertion Loss of any bandpass fiter used in front of LNA (expressed in dB)
 |  |  |  | Lother º Insertion Loss of any other In-Line device in front of LNA (expressed in dB)
 |  |  | Cable or Waveguide "Line" Losses: |  |  |  | NOTE:
 |  |  |  | Line A Length: |  |  |  |  | 0 | meters
 |  |  |  | Line B Length: |  |  |  |  | 0 | meters
 |  |  |  | Line C Length: |  |  |  |  | 0 | meters
 |  |  |  | Cable/Guide Type: |  |  |  |  | RG-8U
 |  |  |  | Cable/Guide Loss/meter: |  |  | 0.092 | dB/m (at freq.) | 437.4 | MHz
 |  |  |  | Line A Loss: |  |  |  | LA = | 0 | dB
 |  |  |  | Line B Loss: |  |  |  | LB = | 0 | dB
 |  |  |  | Line C Loss: |  |  |  | LC = | 0 | dB
 |  |  |  | Bandpass Filter Insertion Loss: |  |  |  | LBPF = | 0.0 | dB
 |  |  |  | Insertion Loss of Other In-Line Devices: |  |  |  | Lother = | 0.0 | dB |  |  | Ground Station, Antenna or Sky Noise Temperature Calculation Tool:
 |  |  |  | No. of In-Line Connectors: |  |  | 6 | X 0.05 dB/con.= | 0.3 | dB
 |  |  |  | Other In-Line Device Type: |  |  |  |  | none |  |  |  |  | Galactic Noise Component:
 |  |  |  | Total In-Line Losses from Antenna to LNA: |  |  |  |  | 0.30 | dB |  |  |  |  | Receiver Frequency: |  |  | 437.5 | MHz
 |  |  | Transmission Line Coefficient: |  |  |  |  | a = | 0.9333 |  |  |  |  |  | Coldest Galactic Noise Temp.: |  |  | 19.86861861 | K
 |  |  | Antenna or "Sky" Temperature: |  |  | NOTE: |  | Ta = | 132.552663 | K |  |  |  |  | Warmest Galactic Noise Temp: |  |  | 84.25093839 | K
 |  |  | Ground Station Feedline Temperature: |  |  |  |  | To = | 290 | K
 |  |  |  |  |  |  |  |  |  |  |  |  |  | Terrestrial Noise Component:
 |  |  | LNA Temperature: |  |  |  |  | TLNA = | 70 | K
 |  |  |  |  |  |  |  |  |  |  |  |  |  |  | Receiver Bandwidth: |  |  | 9.0 | KHz
 |  |  | LNA Gain: |  | 29.0 | dB |  | GLNA = | 794.3
 |  |  |  |  |  |  |  |  |  |  |  |  |  | NOTE: | Estimated or Measured Noise Level: |  |  | -140 | dBm
 |  |  | Cable/Waveguide D Length: |  |  | NOTE: |  |  | 10.0 | meteres
 |  |  |  |  |  |  |  |  |  |  |  |  |  |  | Noise Source Effective Temperature: |  |  | 80.49288445 | K
 |  |  | Cable/Waveguide D Type: |  |  |  |  |  | RG-8U
 |  |  |  |  |  |  |  |  |  |  |  |  |  | Minimum Sky Noise Temp: |  |  |  | 100.3615031 | K
 |  |  | Cable/Waveguide D Loss/meter: |  |  |  |  |  | 0.170 | dB/m
 |  |  |  |  |  |  |  |  |  |  |  |  |  | Maximum Sky Noise Temp: |  |  |  | 164.7438228 | K
 |  |  | Cable/Waveguide D Loss: |  |  |  |  |  | 1.7 | dB
 |  |  | Communications Receiver Front End Temperature |  |  |  |  | TComRcvr = | 270 | K
 |  |  | System Noise Temperature: |  |  |  |  | Ts = | 213.5643591 | K
 |  |  | front-end noise temperature: A measure of the thermal noise generated in the first stage of a receiver.
 |  |  | Noise factor is defined as the ratio of the Carrier Power to Thermal Noise ratio at the input of a device to the
 |  |  | Carrier Power to Thermal Noise ratio at the output of the device. Noise factor is defined by the following ratio. |  |  |  |  |  |  |  |  | F = (Ci / Ni) / (Co / No)
 |  |  | The Noise Figure is the decibel representation of the noise factor.
 |  |  | NF(db) = 10 * Log10 (F)
 |  |  | Given a noise factor, it is possible to calculate an equivalent noise temperature using the following expression.
 |  |  | Where To is 290 degrees Kelvin.
 |  |  | Where series losses (transmission line loss) is present, their impact is expressed as a power ratio of input over output (L),
 |  |  | and included, the noise factor is amended to the following expression.
 |  |  | L is a ratio in this expression, whereas in practice it will often be given in decibels, and must be converted.
 |  |  | Noise temperature (T) = 290 * (10^(Noise Figure/10)-1) K

Sheet: Antenna Gain
System Antenna Gains (Directivities): |  |  |  |  |  | CougSat-1 |  |  |  |  | 2020 January 17
Uplink Antenna System:
 | NOTE:
 | Ground Station:
 |  |  |  | Frequency: | 437.5 | MHz |  |  | Wavelength: | 0.6853 | meters
 |  |  |  |  | Operator Selects Option 1 to 4 Here
 |  |  |  | 2 | Helix |  |  |  | Polarization: | RHCP
OPTION:
1 | Yagi |  | Boom Length (l): | 3.2 |  | Optimum Elements (n): | 12 | per Plane | (in V and in H) |  |  | Maximum Gain: | 16.3 | dBiC | Beamwidth: | 30.6 | ° | Antenna Length: |  | 2.193 | meters
2 | Helix |  | Turns (n): | 10 |  | Turn Spacing (l): | 0.25 |  | Circumference (l): | 1.0 |  | Gain: | 15.7 | dBiC | Beamwidth: | 33.0 | ° |  | Antenna Length: | 1.713 | meters
3 | Parabolic Reflector |  |  |  |  | Diameter: | 5.4 m |  | Aperture Efficiency: | 55% |  | Gain: | 25.3 | dBiC | Beamwidth: | 8.9 | °
4 | User Defined |  | 22 Element Yagi (22XB 2m OSCAR BOOMER) |  |  |  |  |  |  |  |  | Gain: | 16.1 | dBiC | Beamwidth: | 30.0 | ° | Antenna Length: |  | 4.043017143 | meters
 | Spacecraft:
 |  |  |  | Frequency: | 437.5 | MHz |  |  | Wavelength: | 0.6853 | meters
 |  |  |  |  | Operator Selects Option 1 to 5 Here
 |  |  |  | 2 | Dipole |  |  |  | Polarization: | Linear
OPTION:
1 | Monopole |  |  |  |  | Gain: | 2.15 | dBiL |  | Beamwidth: | 156.2 | ° | No Radiation in Back Hemisphere AND Null on Axis ("Tip Null")
2 | Dipole |  |  |  |  | Gain: | 2.15 | dBiL |  | Beamwidth: | 156.2 | ° | Null On Axis; Both Poles
3 | Canted Turnstyle |  |  |  |  | Gain: | 0.5 | dBiC | (typical) | Beamwidth: | 180 | ° | Circular Pol. On Axis; RHCP one pole, LHCP Opposite Pole, Linear in Equatorial Plane
4 | Quadrifilar Helix |  | Loop (l): | 1/2 |  | Gain: | 4.0 | dBiC |  | Beamwidth: | 150 | ° | No Radiation in Back Hemisphere; Excellent Axial Ratio Performance Off-Axis
5 | Other (User Defined) |  | Isotropic |  |  | Gain: | 0.0 | dBi (L or C) |  | Beamwidth: | 360 | ° | Isotropic antenna, omnidirectional, antenna pattern is added to Link Budget during Matlab analysis
 |  | UPLINK |  |  |  |  |  |  | DOWNLINK
Downlink Antenna System:
 | Spacecraft:
 |  |  |  | Frequency: | 437.45 | MHz |  |  | Wavelength: | 0.6853 | meters
 |  |  |  |  | Operator Selects Option 1 to 5 Here
 |  |  |  | 2 | Dipole |  |  |  | Polarization: | Linear
OPTION:
1 | Monopole |  |  |  |  | Gain: | 2.15 | dBiL |  | Beamwidth: | 156.2 | ° | No Radiation in Back Hemisphere & Null on Axis ("Tip Null")
2 | Dipole |  |  |  |  | Gain: | 2.15 | dBiL |  | Beamwidth: | 156.2 | ° | Null On Axis; Both Poles
3 | Canted Turnstyle |  |  |  |  | Gain: | 0.5 | dBiC | (typical) | Beamwidth: | 180 | ° | Circular Pol. On Axis; RHCP one pole, LHCP Opposite Pole, Linear in Equatorial Plane
4 | Quadrifilar Helix |  | Loop (l): | 1/2 |  | Gain: | 4.0 | dBiC |  | Beamwidth: | 150 | ° | No Radiation in Back Hemisphere
5 | Other (User Defined) |  | Helical Antenna |  |  | Gain: | 10.0 | dBi (L or C) |  | Beamwidth: | 52 | ° | Isotropic antenna, omnidirectional, antenna pattern is added to Link Budget during Matlab analysis
 | Ground Station:
 |  |  |  | Frequency: | 437.45 | MHz |  |  | Wavelength: | 0.6853 | meters
 |  |  |  |  | Operator Selects Option 1 to 4 Here
 |  |  |  | 2 | Helix |  |  |  | Polarization: | RHCP
OPTION:
1 | Yagi |  | Boom Length (l): | 2.0 |  | Optimum Elements (n): | 12 | per Plane | (in V and in H) |  |  | Maximum Gain: | 14.1 | dBiC | Beamwidth: | 39.7 | ° | Antenna Length: |  | 1.371 | meters
2 | Helix |  | Turns (n): | 10 |  | Turn Spacing (l): | 0.25 |  | Circumference (l): | 1.0 |  | Gain: | 15.7 | dBiC | Beamwidth: | 33.0 | ° | Antenna Length: |  | 1.713 | meters
3 | Parabolic Reflector |  |  |  |  | Diameter: | 5.4 m |  | Aperture Efficiency: | 55% |  | Gain: | 25.3 | dBiC | Beamwidth: | 259.2 | °
4 | User Defined |  | 38 Element Yagi (738XB 70cm OSCAR BOOMER) |  |  |  |  |  |  |  |  | Gain: | 17.6 | dBiC | Beamwidth: | 24.0 | ° | Antenna Length: |  | 3.0086227 | meters
 |  |  | Look-Up Table
 | Optimum Yagi Antenna Performance:
 | Boom |  | Optimum |  | Maximum
 | Length (l): |  | No. Elements (n): |  | Gain (dBi):
 | 0.35 |  | 3 |  | 9.65
 | 0.55 |  | 4 |  | 10.86
 | 0.80 |  | 5 |  | 11.85
 | 1.15 |  | 6 |  | 12.45
 | 1.45 |  | 7 |  | 13.35
 | 1.80 |  | 8 |  | 14.05
 | 2.10 |  | 9 |  | 14.40
 | 2.45 |  | 10 |  | 15.25
 | 2.80 |  | 11 |  | 15.95
 | 3.15 |  | 12 |  | 16.30
 | 3.55 |  | 13 |  | 16.95
 | 4.00 |  | 14 |  | 17.45
 | 4.40 |  | 15 |  | 18.15
 | 4.75 |  | 16 |  | 18.65
 | 5.20 |  | 17 |  | 19.35
 | 5.55 |  | 18 |  | 19.85
 | 6.00 |  | 19 |  | 20.25
 | 6.50 |  | 20 |  | 20.75
 | 7.00 |  | 21 |  | 21.35
 | 7.50 |  | 22 |  | 21.65
 | Data Taken from ARRL Antenna Book

Sheet: Antenna Pointing Losses
System Antenna Pointing Losses: |  |  |  |  |  | CougSat-1 |  |  |  | 2020 January 17
 | NOTE: | Uplink: |  |  |  | Downlink:
 |  |  |  | Spacecraft
 |  |  |  | Antenna
 |  |  |  | [Types 1 thru 5]
 |  |  |  | Ground Station
 |  |  |  | Antenna
 |  |  |  | [Type 1,2,3 or 4]
 |  | Figure 1 |  |  |  | Figure 2
Antenna Loss Determination: |  |  |  |  |  |  |  |  |  |  |  |  |  |  |  | (See Also Figure 8)
Uplink Antenna System:
 | NOTE:
 | Ground Station: |  |  |  |  |  |  |  |  |  |  |  |  |  | NOTE:
 |  |  | Uplink | Frequency: | 437.5 | MHz |  |  | Wavelength: | 0.6853 | meters
 |  |  |  |  | This Option was Selected on the Previous Page
 |  |  |  | 2 | Helix |  |  |  | Polarization: | RHCP
 | 1 | Yagi |  |  | Maximum Gain: | 16.3 | dBiC | Beamwidth: | 30.6 | ° |  |  |  | 24.16
 | 2 | Helix |  |  | Gain: | 15.7 | dBiC | Beamwidth: | 33.0 | °
 | 3 | Parabolic Reflector |  |  | Gain: | 25.3 | dBiC | Beamwidth: | 8.9 | °
 | 4 | User Defined |  |  | Gain: | 16.1 | dBiC | Beamwidth: | 30.0 | °
 |  | Esimated Pointing Error (θ1): |  |  | 5 | ° | Approx. Antenna Pointing Loss: |  |  | 0.3 | dB
 | Spacecraft:
 |  |  | Uplink | Frequency: | 437.5 | MHz |  |  | Wavelength: | 0.6853 | meters |  |  | Antenna Roll-Off
 |  |  |  |  | This Option was Selected on the Previous Page
 |  |  |  | 2 | Dipole |  |  |  | Polarization: | Linear |  | Antenna |  | Calculation Formulas
 |  |  |  |  |  |  |  |  |  |  |  | Coordinate System:
 | 1 | Monopole |  |  |  | Gain: | 2.15 | dBiL | Beamwidth: | 156.2 | ° | See Figures 1and 3 | monopole | 3.0 | dB
 | 2 | Dipole |  |  |  | Gain: | 2.15 | dBiL | Beamwidth: | 156.2 | ° | See Figures 1and 4 | dipole | 0.6 | dB
 | 3 | Canted Turnstyle |  |  |  | Gain: | 2.0 | dBiC | Beamwidth: | 180 | ° | See Figures 1, 5 & 8 | canted turnstyle | 16.9 | dB
 | 4 | Quadrifilar Helix |  | Loop (l): | 1/2 | Gain: | 4.0 | dBiC | Beamwidth: | 150 | ° | See Figures 1and 6 | quadrifilar helix | 0.5 | dB
 | 5 | Other (User Defined) |  | Isotropic |  | Gain: | 0.0 | dBi | Beamwidth: | 360 | ° | See Figures 1and 7 | Isotropic | 0.0 | dB
 |  | Angle between S/C symmetry axis |  |  |  |  |  | Approx. Antenna
 |  | and vector from S/C to gnd. station (θ2): |  |  |  | 30 | ° | Pointing Loss: |  | 0.6 | dB
 |  | UPLINK |  |  |  |  |  |  | DOWNLINK
Downlink Antenna System:
 | Spacecraft:
 |  |  | Downlink | Frequency: | 437.45 | MHz |  |  | Wavelength: | 0.6853 | meters |  |  | Antenna Roll-Off
 |  |  |  |  | This Option was Selected on the Previous Page
 |  |  |  | 2 | Dipole |  |  |  | Polarization: | Linear |  | Antenna |  | Calculation Formulas
 |  |  |  |  |  |  |  |  |  |  |  | Coordinate System:
 | 1 | Monopole |  |  |  | Gain: | 2.15 | dBiL | Beamwidth: | 156.2 | ° | See Figures 2 and 3 | monopole | 3.0 | dB
 | 2 | Dipole |  |  |  | Gain: | 2.15 | dBiL | Beamwidth: | 156.2 | ° | See Figures 2 and 4 | dipole | 0.6 | dB
 | 3 | Canted Turnstyle |  |  |  | Gain: | 2.0 | dBiC | Beamwidth: | 180 | ° | See Figures 2, 5 & 8 | canted turnstyle | 16.9 | dB
 | 4 | Quadrifilar Helix |  | Loop (l): | 1/2 | Gain: | 4.0 | dBiC | Beamwidth: | 150 | ° | See Figures 2 and 6 | quadrifilar helix | 0.5 | dB
 | 5 | Other (User Defined) |  | Helical Antenna |  | Gain: | 10.0 | dBi | Beamwidth: | 52 | ° | See Figures 2 and 7 | Helical Antenna | 0.5 | dB
 |  | Angle between S/C symmetry axis |  |  |  |  |  | Approx. Antenna
 |  | and vector from S/C to gnd. station (θ3): |  |  |  | 30 | ° | Pointing Loss: |  | 0.6 | dB
 | Ground Station:
 |  |  | Downlink | Frequency: | 437.45 | MHz |  |  | Wavelength: | 0.6853 | meters
 |  |  |  |  | This Option was Selected on the Previous Page
 |  |  |  | 2 | Helix |  |  |  | Polarization: | RHCP
 | 1 | Yagi |  |  | Maximum Gain: | 14.1 | dBiC | Beamwidth: | 39.7 | ° |  |  |  | 24.16
 | 2 | Helix |  |  | Gain: | 15.7 | dBiC | Beamwidth: | 33.0 | °
 | 3 | Parabolic Reflector |  |  | Gain: | 25.3 | dBiC | Beamwidth: | 259.2 | °
 | 4 | User Defined |  |  | Gain: | 17.6 | dBiC | Beamwidth: | 24.0 | °
 |  | Esimated Pointing Error (θ4): |  |  | 5 | ° | Approx. Antenna Pointing Loss: |  |  | 0.3 | dB

Sheet: Polarization Loss
System Polarization Loss and Cross Polarization Isolation: |  |  |  |  |  |  |  |  | CougSat-1 |  |  | 2020 January 17
 |  |  |  | Power Emitted (or Received) with Antenna Aligned with Major Axis
 | Axial Ratio ≡ 10*LOG
 |  |  |  | Power Emitted (or Received) with Antenna Aligned with Minor Axis |  |  |  |  |  | Circular |  | Elliptical |  | Linear
 | NOTE: |  |  |  |  |  |  |  |  | Right Hand or Left Hand |  | Right Hand or Left Hand |  | Vertical or Horizontal
 |  |  |  |  |  |  |  |  |  |  |  |  |  | Axial Ratio = ∞
 |  |  |  |  |  |  | Transmit Antenna
 |  |  |  |  |  |  |  |  |  |  |  |  |  | Axial Ratio = ∞
 |  |  |  |  |  |  | Receive Antenna
 | NOTE:
 | UPLINK: | Operator selects uplink antenna characteristics in blue boxes.
 |  | Polarization Loss Calculation:
 | Co-Polarization Loss:
 |  |  |  | Axial ratio of Tx Antenna (Ant. #1) in dB = | 3.00 | [dB] |  |  |  |  |  |  | Polarization Angle (θ) ≡
 |  |  |  | Axial ratio (Ant. #1) = | 2.00 | [ ] |  |  |  |  |  |  | Angle between transmit and receive
 |  |  |  | Axial ratio of Rx Antenna (Ant. #2) in dB = | 20.00 | [dB] |  |  |  |  |  |  | major axes.
 |  |  |  | Axial ratio (Ant. #2) = | 100.00 | [ ]
 |  |  |  | Polarization Angle θ between antennas = | 90.0 | [degrees] | (worst case)
 |  |  |  | Polarization Angle θ between antennas = | 1.570796327 | [Radians]
 |  |  |  | Polarization Loss = | 0.20883 | [ ]
 |  |  |  | Polarization Loss = | 6.80 | [dB] |  |  |  |  | Polarization Loss Equation:
 | Cross Polarization Coupling/Isolation: |  |  |  |  |  |  | PL | = 0.5*(1+((1-r_1^2)*(1-r_2^2)*COS(2*θ)+4*r_1*r_2)/((1+r_1^2)*(1+r_2^2)))
 |  | Cross Pol. Power Fraction = |  |  | 0.79117
 |  | Cross Pol. Power Fraction = |  |  | -1.02 | [dB]
 |  | Cross Polarization Isolation = |  |  | 7.82 | [dB]
 | DOWNLINK: |  | Operator selects uplink antenna characteristics in blue boxes.
 |  | Polarization Loss Calculation:
 | Co-Polarization Loss:
 |  |  |  | Axial ratio of Tx Antenna (Ant. #1) in dB = | 20.00 | [dB]
 |  |  |  | Axial ratio (Ant. #1) = | 100.00 | [ ]
 |  |  |  | Axial ratio of Rx Antenna (Ant. #2) in dB = | 3.00 | [dB]
 |  |  |  | Axial ratio (Ant. #2) = | 2.00 | [ ]
 |  |  |  | Polarization Angle θ between antennas = | 90.0 | [degrees] | (worst case)
 |  |  |  | Polarization Angle θ between antennas = | 1.570796327 | [Radians]
 |  |  |  | Polarization Loss = | 0.20883 | [ ]
 |  |  |  | Polarization Loss = | 6.80 | [dB]
 | Cross Polarization Coupling/Isolation:
 |  | Cross Pol. Power Fraction = |  |  | 0.79117
 |  | Cross Pol. Power Fraction = |  |  | -1.02 | [dB]
 |  | Cross Polarization Isolation = |  |  | 7.82 | [dB]
 |  |  |  |  | Example Calculations:
 |  |  | Tx Ant. |  | Rx Ant. |  | θ |  | Pol. Loss
 |  |  | A.R. #1: |  | A.R. #2: |  | (degrees) |  | (dB)
 |  |  | (dB) |  | (dB)
 | Tx Circular, |  | 0.0 |  | 0.0 |  | 90.0 |  | 0.0
 | Rx Variable: |  | 0.0 |  | 1.0 |  | 90.0 |  | -0.1
 |  |  | 0.0 |  | 2.0 |  | 90.0 |  | -0.2
 |  |  | 0.0 |  | 3.0 |  | 90.0 |  | -0.5
 |  |  | 0.0 |  | 6.0 |  | 90.0 |  | -1.3
 |  |  | 0.0 |  | 10.0 |  | 90.0 |  | -2.2
 |  |  | 0.0 |  | 30.0 |  | 90.0 |  | -3.0 |  | NOTE: A linearly polarized antenna may be
 |  |  | 0.0 |  | 30.0 |  | 0.0 |  | -3.0 |  | represented by an Axial Ratio value of 30 dB.
 | Tx & Rx Elliptical: |  | 3.0 |  | 3.0 |  | 0.0 |  | 0.0
 |  |  | 3.0 |  | 3.0 |  | 45.0 |  | -0.9 |  | NOTE: This is a typical small satellite case.
 |  |  | 3.0 |  | 3.0 |  | 90.0 |  | -1.9
 | Tx & Rx Linear: |  | 30.0 |  | 30.0 |  | 0.0 |  | 0.0
 |  |  | 30.0 |  | 30.0 |  | 30.0 |  | -1.2
 |  |  | 30.0 |  | 30.0 |  | 45.0 |  | -3.0
 |  |  | 30.0 |  | 30.0 |  | 60.0 |  | -6.0
 |  |  | 30.0 |  | 30.0 |  | 90.0 |  | -54.0
 | Tx Elliptical, |  | 2.0 |  | 30.0 |  | 0.0 |  | -1.4
 | Rx Linear |  | 2.0 |  | 30.0 |  | 45.0 |  | -3.0 |  | NOTE: This is also a typical small satellite case.
 |  |  | 2.0 |  | 30.0 |  | 90.0 |  | -4.0

Sheet: Atmos. & Ionos. Losses
Atmospheric and Ionospheric Losses: |  |  |  |  |  | CougSat-1 | 2020 January 17
 | Loss due to Atmospheric Gases: |  |  |  |  | Link Losses Resulting from Signals Passing Through Atmospheric Gases:
 | Uplink and Downlink:
 | Elevation Angle: |  | Loss: | Unit:
 | 0 | ° | 10.2 | dB | Losses due to atmospheric gases (Nitrogen, Oxygen, Carbon Dioxide, Hydrogen, etc.)
 |  |  |  |  | are nearly independent of atmospheric temperature, mean density and relative humidity
 | 2.5 | ° | 4.6 | dB | at frequencies below 2 GHz. Atmospheric absorption depends strongly upon the total number of molecules
 |  |  |  |  | distributed along the path between the spacecraft and the ground station. This, in turn,
 | 5 | ° | 2.1 | dB | means that the losses from or to the satellite are elevation angle dependent.
 | 10 | ° | 1.1 | dB | The table to the left is a look-up table. The minimum elevation angle selected in the
 |  |  |  |  | "Orbit & Frequency" worksheet is matched against the closest fit from the table and the
 | 30 | ° | 0.4 | dB | result is given at Cell [D23] and is automatically inserted into the uplink and downlink budgets.
 | 45 | ° | 0.3 | dB | The data used here is taken from "Radiowave Propagation in Satellite Communications" by
 |  |  |  |  | Louis J. Ippolito, Jr., Van Nostrand-Reinhold, 1986, pp. 33-34, Tables 3-3a-c.
 | 90 | ° | 0.0 | dB
 |  |  |  |  | One additional interpolated value is added at 2.5° elevation angle. This was not taken
 |  |  |  |  | from Ippolito's text.
 | Min. Elev. Angle: |  | 10 | deg.
 |  |  |  |  | If you are using uplink or downlink frequencies above 2 GHz, refer to the referenced text given above
 | Loss Determined: |  | 1.1 | dB | to determine the appropriate atmosperic losses. At millimeter wave frequencies the losses can be much higher.
 |  |  |  |  |  | Link Losses Resulting from Signals Passing Through the Ionosphere:
 | Loss due to Ionosphere: |  |  |  | Radio waves passing through the ionosphere at VHF, UHF and Microwave frequencies are influenced
 | Uplink: | Loss Determined: |  | 0.4 dB | far less by this layer of ionized particles than at frequencies in the HF, MF and LF portions of the
 | Frequency: | Unit: | Loss: | Unit: | radio spectrum. While there is certainly some correlation between the elevation angle to a
 |  |  |  |  | satellite and the signal absorption or scintillation experienced, this dependency is nearly masked
 | 146 | MHz | 0.7 | dB | out by the time variability of effects.
 | 438 | MHz | 0.4 | dB
 | 2410 | MHz | 0.1 | dB | There is, however, a frequency depencency that can be quantified, on average. As transmitter frequencies
 | 145.8 | MHz | 0.7 | dB | go below 100 MHz there are times when the attenuation can increase to as much as tens of dB,
 |  |  |  |  | especially at low elevation angles. The ionosphere certainly limits the lowest frequency at which
 |  |  |  |  | satellite communications is feasible. Below 20 MHz, during solar maximum space signals are usually
 | Link Model Operator Estimate Inserted Here. |  |  |  | fully absorbed or reflected by the layers of the ionosphere (D, E, F1 and F2).
 |  |  |  |  | The values provided in this table are approximate mean values for low earth station elevation angles.
 | Loss due to Ionosphere: |  |  |  | It is proposed that these values can be conservatively used in satellite link analyses. The higher order
 | Downlink: | Loss Determined: |  | 0.4 dB | statistics of these loss parameters would be interesting to review, however, this effort is more
 | Frequency: | Unit: | Loss: | Unit: | than is necessary for the development of an effective link budget.
 | 146 | MHz | 0.7 | dB | The losses determined here for the uplink and downlink are based on the operator-selected frequency
 | 438 | MHz | 0.4 | dB | choice made in the "Orbit & Frequency" worksheet. If the "User Defined" option is selected by the
 | 2410 | MHz | 0.1 | dB | link model operator, then the operator must estimate the appropriate ionospheric loss value and manually
 | 1269.9 | MHz | 0.2 | dB | insert it in either Cell [D35] or Cell [D48] accordingly.
 | Link Model Operator Estimate Inserted Here. |  |  |  | Proceed to the "Modulation-Demodulation Method" W/S.
 | If the "Link Model Operator" has selected a
 | user option for the frequency, then an
 | estimate of the ionospheric losses must be
 | provided by the operator.

Sheet: Modulation-Demodulation Method
Modulation/Demodulation Method: |  |  |  | CougSat-1 |  | 2020 January 17
NOTE: |  |  |  | Select Here: | Choice Made: | Result:
UPLINK: |  | Modulation, Coding & BER Option: |  | 13 | QPSK |  | Eb/No:
Command Link |  |  |  |  |  |  | Threshold
 | Option: | Modulation Type: | Coding: | Bit Error Rate Spec: | Required Eb/No (dB): |  | 9.6
 | 1 | AFSK/FM | None | 0.0001 | 21.0 |  | dB
 | 2 | AFSK/FM | None | 1e-05 | 23.2
 | 3 | G3RUH FSK | None | 0.0001 | 16.7
 | 4 | G3RUH FSK | None | 1e-05 | 18.0
 | 5 | Non-Coherent FSK | None | 0.0001 | 13.4
 | 6 | Non-Coherent FSK | None | 1e-05 | 13.8
 | 7 | Coherent FSK | None | 0.0001 | 10.5
 | 8 | Coherent FSK | None | 1e-05 | 11.9
 | 9 | GMSK | None | 0.0001 | 8.4
 | 10 | GMSK | None | 1e-05 | 9.6
 | 11 | BPSK | None | 1e-05 | 9.6
 | 12 | BPSK | None | 1e-06 | 10.5
 | 13 | QPSK | None | 1e-05 | 9.6
 | 14 | QPSK | None | 1e-06 | 10.5
 | 15 | BPSK | Convolutional R=1/2, K=7 | 1e-06 | 4.8
 | 16 | BPSK | Conv. R=1/2,K=7 & R.S. (255,223) | 1e-06 | 2.5
 | 17 | BPSK | Conv. R=1/6,K=15 & R.S. (255,223) | 1e-07 | 0.8
 | 18 | User Defined | None | 1e-05 | 9.6
 |  |  | Operator Estimate of Implementation Loss
 | NOTE: |  | Implementation Loss Estimate: | 0.0 | dB
 |  | UPLINK: |  | DOWNLINK:
 |  |  |  | Select Here: | Choice Made: | Result:
DOWNLINK: |  | Modulation, Coding & BER Option: |  | 13 | QPSK |  | Eb/No:
Telemetry Link: |  |  |  |  |  |  | Threshold
 | Option: | Modulation Type: | Coding: | Bit Error Rate Spec: | Required Eb/No (dB): |  | 9.6
 | 1 | AFSK/FM | None | 0.0001 | 21.0 |  | dB
 | 2 | AFSK/FM | None | 1e-05 | 23.2
 | 3 | G3RUH FSK | None | 0.0001 | 16.7
 | 4 | G3RUH FSK | None | 1e-05 | 18.0
 | 5 | Non-Coherent FSK | None | 0.0001 | 13.4
 | 6 | Non-Coherent FSK | None | 1e-05 | 13.8
 | 7 | Coherent FSK | None | 0.0001 | 10.5
 | 8 | Coherent FSK | None | 1e-05 | 11.9
 | 9 | GMSK | None | 0.0001 | 8.4
 | 10 | GMSK | None | 1e-05 | 9.6
 | 11 | BPSK | None | 1e-05 | 9.6
 | 12 | BPSK | None | 1e-06 | 10.5
 | 13 | QPSK | None | 1e-05 | 9.6
 | 14 | QPSK | None | 1e-06 | 10.5
 | 15 | BPSK | Convolutional R=1/2, K=7 | 1e-06 | 4.8
 | 16 | BPSK | Conv. R=1/2,K=7 & R.S. (255,223) | 1e-06 | 2.5
 | 17 | BPSK | Conv. R=1/6,K=15 & R.S. (255,223) | 1e-07 | 0.8
 | 18 | BPSK | Turbo Code (Parallel w. Interleaver) | 1e-06 | 0.75
 | 19 | User Defined | None | 1e-05 | 9.6
 |  |  | Operator Estimate of Implementation Loss
 |  |  | Implementation Loss Estimate: | 0.0 | dB
 | NOTE:

Sheet: Uplink Budget
CougSat-1 | NOTE: |  | CougSat-1 |  | Date Data Last Modified:
Uplink Command Budget: |  |  | 0 |  | 2020 January 17
Parameter: | Value: | Units: | Comments:
Ground Station:
Ground Station Transmitter Power Output: | 10.0 | watts | This value is transferred from "Transmitters" W/S, Cell [E15]. |  |  |  | NOTE: Click " + " above column J to restore comment column.
In dBW: | 10.0 | dBW | Transmitter power expressed in dB above one watt
In dBm: | 40.0 | dBm | Transmitter power expressed in dB above one milliwatt
Ground Stn. Total Transmission Line Losses: | 0.9 | dB | This value is transferred from "Transmitters" W/S, Cell [I33]
Antenna Gain: | 15.7 | dBi | This value is selected at "Antenna Gain" W/S, Cell [E9]
Ground Station EIRP: | 24.9 | dBW | Ground Station Effective Isotropic Radiated Power (EIRP) [EIRP=Pt x Ltl x Ga]
Uplink Path:
Ground Station Antenna Pointing Loss: | 0.3 | dB | This value is calculated in the "Antenna Pointing Losses" W/S, and transferred from Cell [K41]
Gnd-to-S/C Antenna Polarization Losses: | 6.8 | dB | This value is calculated in the "Polarization Loss" W/S and is transferred from Cell [F40].
Path Loss: | 148.6 | dB | Lp = 22 + 20LOG(D/l); Transferred from "Orbit & Frequency" W/S
Atmospheric Losses: | 1.1 | dB | This value is transferred from "Atmos. & Ionos. Losses" W/S, Cell [D23]
Ionospheric Losses: | 0.4 | dB | This value is transferred from "Atmos. & Ionos. Losses" W/S, Cell [D47:D50]
Rain Losses: | 0.0 | dB | This value should be estimated by the link model operator and place into Cell [B18]
Isotropic Signal Level at Spacecraft: | -132.3 | dBW | This is the signal level received in space in the vacinity of the spacecraft using an omnidirectional antenna.
Spacecraft (Eb/No Method):
------- Eb/No Method -------
Spacecraft Antenna Pointing Loss: | 0.6 | dB | This value is transferred from "Antenna Pointing Losses" W/S, Cell [K59]
Spacecraft Antenna Gain: | 2.1 | dBi | This value is selected at "Antenna Gain" W/S, Cell [E22]
Spacecraft Total Transmission Line Losses: | 0.4 | dB | This value is transferred from the "Receivers" W/S, Cell [J52]
Spacecraft Effective Noise Temperature: | 262.7822698 | K | This value is calculated in the "Receivers" W/S and Transferred from Cell [J67]
Spacecraft Figure of Merrit (G/T): | -22.5 | dB/K | G/T = Ga-Ltl-10log(Ts). This is the uptimate measure of the receiver's performance.
S/C Signal-to-Noise Power Density (S/No): | 74.5 | dBHz | Boltzman's Constant: |  | -228.6 | dBW/K/Hz
System Desired Data Rate: | 200000 | bps | Operator selects this value. Be Careful! This is the data rate, not the symbol rate.
In dBHz: | 53.0 | dBHz | This is simply = 10log(R); R= data rate
Command System Eb/No: | 21.5 | dB
Demodulation Method Seleted: | QPSK |  | Values selected in "Modulation-Demodulation W/S, Cell [E3]
Forward Error Correction Coding Used: | None |  | Value selected in "Modulation-Demodulation" W/S, also Cell [E3]
System Allowed or Specified Bit-Error-Rate: | 1e-05 |  | The selected value is transferred from the "Modulation-Demodulation W/S, Cells [E6:E23]
Demodulator Implementation Loss: | 0.0 | dB | This value is transferred from the "Modulation-Demodulation W/S, Cell[E25]
Telemetry System Required Eb/No: | 9.6 | dB | The selected value is transferred from the "Modulation-Demodulation W/S, Cells [F6:F23]
Eb/No Threshold: | 9.6 | dB | This is the result of the "Modulation-Demodulation" W/S and is transferred from Cell [H32]
System Link Margin: | 11.9 | dB
Spacecraft Alternative Signal Analysis Method (SNR Computation): |  |  |  | NOTE:
---------- SNR Method ------------
Spacecraft Antenna Pointing Loss: | 0.6 | dB | This value is transferred from "Antenna Pointing Losses" W/S, Cell [K59]
Spacecraft Antenna Gain: | 2.1 | dBi | This value is selected at "Antenna Gain" W/S, Cell [E22]
Spacecraft Total Transmission Line Losses: | 0.4 | dB | This value is transferred from the "Receivers" W/S, Cell [J52]
Spacecraft Effective Noise Temperature: | 262.7822698 | K | This value is calculated in the "Receivers" W/S and Transferred from Cell [J67]
Spacecraft Figure of Merrit (G/T): | -22.5 | dB/K | G/T = Ga-Ltl-10log(Ts). This is the ultimate measure of the receiver's performance.
Signal Power at Spacecraft LNA Input: | -131.2 | dBW | Ps = Piso+Ga-Lpl-Ltl; This is the signal power that has arrived at the ground station receiver.
Spacecraft Receiver Bandwidth: | 120000 | Hz | Signal Spectrum Must Pass Through This Data Filter.
Spacecraft Receiver Noise Power (Pn = kTB) | -153.6 | dBW | Pn = K + 10log(Ts) + 10log(B). This is the total noise power arriving at the ground station receiver.
Signal-to-Noise Power Ratio at G.S. Rcvr: | 22.4 | dB | Ps/Pn = Ps(in dBW) - Pn(in dBW)
Analog or Digital System Required S/N: | 9.6 | dB | If system is digital, use values from "Modulation-Demodulation" W/S. If analog, use appropriate value from text book.
System Link Margin | 12.8 | dB

Sheet: Downlink Budget
CougSat-1 | NOTE: |  | CougSat-1 | Date Data Last Modified:
Downlink Telemetry Budget: |  |  | 0 | 2020 January 17
Parameter: | Value: | Units: | Comments:
Spacecraft:
Spacecraft Transmitter Power Output: | 1.0 | watts | This value is transferred from "Transmitters" W/S, Cell [E50] |  |  | NOTE: Click " + " above column K to restore comment column.
In dBW: | 0.0 | dBW | Transmitter power expressed in dB above one watt
In dBm: | 30.0 | dBm | Transmitter power expressed in dB above one milliwatt
Spacecraft Total Transmission Line Losses: | 0.3 | dB | This value is transferred from "Transmitters" W/S, Cell [I68]
Spacecraft Antenna Gain: | 2.1 | dBi | This value is selected at "Antenna Gain" W/S, Cell [E37]
Spacecraft EIRP: | 1.8 | dBW | Spacecraft Effective Isotropic Radiated Power (EIRP) [EIRP=Pt x Ltl x Ga]
Downlink Path:
Spacecraft Antenna Pointing Loss: | 0.6 | dB | This value is calculated in the "Antenna Pointing Losses" W/S, and trasferred from Cell [K79]
S/C-to-Ground Antenna Polarization Loss: | 6.8 | dB | This value is calculated in the "Polarization Loss" W/S and is transferred from Cell [F60].
Path Loss: | 148.6 | dB | Lp = 22 + 20LOG(D/l); Transferred from "Orbit & Frequency" W/S
Atmospheric Loss: | 1.1 | dB | This value is transferred from "Atmos. & Ionos. Losses" W/S, Cell [D23]
Ionospheric Loss: | 0.4 | dB | This value is transferred from "Atmos. & Ionos. Losses" W/S, Cell [D47:D50]
Rain Loss: | 0.0 | dB | This value should be estimated by the link model operator and place into Cell [B18]
Isotropic Signal Level at Ground Station: | -155.7 | dBW | This is the signal level received at the Earth in the vacinity of the ground station using an omnidirectional antenna.
Ground Station (EbNo Method):
------- Eb/No Method -------
Ground Station Antenna Pointing Loss: | 0.3 | dB | This value is transferred from "Antenna Pointing Losses" W/S, Cell [K96]
Ground Station Antenna Gain: | 15.7 | dBi | This value is selected at "Antenna Gain" W/S, Cell [E52]
Ground Station Total Transmission Line Losses: | 0.3 | dB | This value is transferred from the "Receivers" W/S, Cell [J123]
Ground Station Effective Noise Temperature: | 213.5643591 | K | This value is calculated in the "Receivers" W/S and Transferred from Cell [J138]
Ground Station Figure of Merrit (G/T): | -7.9 | dB/K | G/T = Ga-Ltl-10log(Ts). This is the uptimate measure of the receiver's performance.
G.S. Signal-to-Noise Power Density (S/No): | 64.8 | dBHz | Boltzman's Constant: | -228.6 | dBW/K/Hz
System Desired Data Rate: | 200000 | bps | Operator selects this value. Be Careful! This is the data rate, not the symbol rate.
In dBHz: | 53.0 | dBHz | This is simply = 10log(R); R= data rate
Telemetry System Eb/No for the Downlink: | 11.8 | dB
Demodulation Method Seleted: | QPSK |  | Values selected in "Modulation-Demodulation W/S, Cell [E30]
Forward Error Correction Coding Used: | None |  | Value selected in "Modulation-Demodulation" W/S, also Cell [E30]
System Allowed or Specified Bit-Error-Rate: | 1e-05 |  | The selected value is transferred from the "Modulation-Demodulation W/S, Cells [E33:E50]
Demodulator Implementation Loss: | 0 | dB | This value is transferred from the "Modulation-Demodulation W/S, Cell[E52]
Telemetry System Required Eb/No: | 9.6 | dB | The selected value is transferred from the "Modulation-Demodulation W/S, Cells [F33:F50]
Eb/No Threshold: | 9.6 | dB | This is the result of the "Modulation-Demodulation" W/S and is transferred from Cell [H32]
System Link Margin: | 2.2 | dB
Ground Station Alternative Signal Analysis Method (SNR Computation):
---------- SNR Method ------------
Ground Station Antenna Pointing Loss: | 0.3 | dB | This value is transferred from "Antenna Pointing Losses" W/S, Cell [K96]
Ground Station Antenna Gain: | 15.7 | dBi | This value is selected at "Antenna Gain" W/S, Cell [E52]
Ground Station Total Transmission Line Losses: | 0.3 | dB | This value is transferred from the "Receivers" W/S, Cell [J123]
Ground Station Effective Noise Temperature: | 213.5643591 | K | This value is calculated in the "Receivers" W/S and Transferred from Cell [J138]
Ground Station Figure of Merrit (G/T): | -7.9 | dB/K | G/T = Ga-Ltl-10log(Ts). This is the ultimate measure of the receiver's performance.
Signal Power at Ground Station LNA Input: | -140.5 | dBW | Ps = Piso+Ga-Lpl-Ltl; This is the signal power that has arrived at the ground station receiver.
Ground Station Receiver Bandwidth (B): | 120000 | Hz | Signal Spectrum Must Pass Through This Data Filter
G.S. Receiver Noise Power (Pn = kTB) | -154.5 | dBW | Pn = K + 10log(Ts) + 10log(B). This is the total noise power arriving at the ground station receiver.
Signal-to-Noise Power Ratio at G.S. Rcvr: | 14.0 | dB | Ps/Pn = Ps(in dBW) - Pn(in dBW)
Analog or Digital System Required S/N: | 9.6 | dB | If system is digital, use values from "Modulation-Demodulation" W/S. If analog, use appropriate value from text book.
System Link Margin | 4.4 | dB

Sheet: System Peformance Summary
System Performance Summary: |  |  |  |  |  | CougSat-1 |  |  |  | 2020 January 17
 | COMMAND |  |  |  |  |  |  | TELEMETRY
 | UPLINK SYSTEM: |  |  | Frequency: | 437.50 MHz |  |  | DOWNLINK SYSTEM: |  |  | Frequency: | 437.45 MHz
Eb/No Method: | Eb/No = | 21.5 dB |  | Link Margin: | 11.9 dB | LINK CLOSES |  |  | R = | 200000 bps
 |  |  |  |  |  |  |  |  |  |  |  | Modulation Method:
S/N Method: | S/N = | 22.4 dB |  | Link Margin: | 12.8 dB | LINK CLOSES |  |  |  |  |  | QPSK
NOTE: |  |  |  |  |  |  |  |  |  |  |  | F.E.C. Encoder Type:
 |  | R = | 200000 bps |  |  |  |  |  |  |  |  | None
 |  |  |  |  |  |  |  |  |  |  |  | hTx = | 40.0%
 |  |  |  |  | F.E.C. Decoder Type:
 |  |  |  |  | None |  |  |  |  |  |  | Tx DC Pwr: | 2.5 watts
 |  |  |  |  |  |  |  |  |  |  |  | Tx Dissipation: | 1.5 watts
 |  |  |  |  |  |  |  |  |  | Line A
 |  |  |  |  | Spec. B.E.R.: | 1e-05 |  |  |  |  |  | PTx = | 1.0 watts
 |  |  |  |  | Demodulator Type:
 |  |  |  |  | QPSK |  |  |  |  |  |  | LA = | 0.0 dB
 |  |  |  |  | Eb/No Threshold: | 9.6 dB
 |  |  |  |  |  |  |  |  |  |  |  | LTXbpf = | 0.0 dB
 |  |  |  |  |  |  |  |  |  | Line B
 |  |  |  |  |  |  |  |  |  |  |  | LB = | 0.0 dB
 |  |  |  |  | BRbpf = | 120000 Hz
 |  |  |  |  | (Used Only in S/N Calc.) |  |  |  |  |  |  | LTother = | 0.0 dB
 |  |  |  |  |  |  |  |  |  |  |  | 0
 |  |  |  |  |  |  |  |  |  |  |  | LC = | 0.1 dB
 |  |  |  |  |  |  |  |  |  | Line C
 |  |  |  |  |  |  |  |  |  |  |  | Ltotal line = | 0.3 dB
 |  |  |  |  |  |  |  |  |  |  | Transmit Antenna
 |  |  |  |  | G/T = | -22.5 dB/K
 |  |  |  |  |  |  |  |  |  |  |  | GT = | 2.1 dBi
 |  |  |  |  | Tsys = | 262.7822698 K |  |  |  |  |  | Polarization: | Linear
 |  |  |  |  |  |  |  |  |  |  |  | EIRPS/C = | 1.8 dBW
 |  |  |  |  | T2nd Amp = | 97.7 K
 |  |  |  |  |  |  |  |  |  |  |  | Total Link Losses:
 |  |  |  |  |  |  |  |  |  |  |  | 157.8 | dB
 |  |  |  |  |  |  |  |  |  |  |  | LP = | 148.6 dB
 |  |  |  |  | GLNA = | 19.5 dB
 |  |  |  |  | TLNA = | 97.7 K |  |  |  |  |  | GR = | 15.7 dBi
 |  |  |  |  |  |  |  |  |  |  |  | Polarization: | RHCP
 |  |  |  |  | Ltotal line = | 0.41 dB
 |  |  |  |  |  |  |  |  |  |  | Receive Antenna
 |  |  |  | Line A | LA = | 0.04 dB
 |  |  |  |  | LRbpf = | 0.0 dB
 |  |  |  |  |  |  |  |  |  |  | Line C | LC = | 0.00 dB
 |  |  |  | Line B | LB = | 0.00 dB
 |  |  |  |  |  |  |  |  |  |  |  | LRother = | 0.0 dB
 |  |  |  |  |  |  |  |  |  |  |  | none
 |  |  |  |  | LTother = | 0.3 dB
 |  |  |  |  | RF Switch |  |  |  |  |  | Line B | LB = | 0.00 dB
 |  |  |  | Line C | LC= | 0.00 dB
 |  |  |  |  |  |  |  |  |  |  |  | LRbpf = | 0.0 dB
 |  |  |  | Receive Antenna
 |  |  |  |  |  |  |  |  |  |  | Line A | LA = | 0.04 dB
 |  |  |  |  | GR = | 2.1 dBi
 |  |  |  |  | Polarization: | RHCP |  |  |  |  |  | Ltotal = | 0.4 dB
 |  |  |  |  | Lp = | 148.6 dB |  |  |  |  |  | TLNA = | 70 K
 |  |  |  |  | Total Link Losses: |  |  |  |  |  |  | GLNA = | 29.0 dB
 |  |  |  |  | 157.8 | dB
 |  |  |  |  | EIRPgs = | 24.9 dBW
 |  |  |  |  |  |  |  |  |  |  |  | T2nd amp = | 270 K
 |  |  |  |  | GT = | 15.7 dBi
 |  |  |  |  | Polarization: | RHCP
 |  |  |  | Transmit Antenna
 |  |  |  |  | Ltotal line = | 0.88 dB
 |  |  |  | Line C | LC = | 0.500 dB
 |  |  |  |  | LTother = | 0.0 dBi
 |  |  |  |  | 0 |  |  |  |  |  |  | BRbpf = | 120000 Hz
 |  |  |  |  |  |  |  |  |  |  |  | (Used only in S/N Calc.)
 |  |  |  | Line B | LB = | 0.000 dB
 |  |  |  |  | LTbpf = | 0.0 dB |  |  |  |  |  | Spec. B.E.R.: | 1e-05
 |  |  |  |  |  |  |  |  |  |  |  | Demodulator Type:
 |  |  |  | Line A | LA = | 0.000 dB |  |  |  |  |  | QPSK
 |  |  |  |  |  |  |  |  |  |  |  | Eb/No Threshold: | 9.6 dB
 |  |  |  |  | PTx = | 10.0 watts
 |  |  |  |  |  |  |  |  |  |  |  | F.E.C. Decoder Type:
 |  |  |  |  |  |  |  |  |  |  |  | None
 |  |  |  |  | Modulation Method:
 |  |  |  |  | QPSK
 |  |  |  |  |  |  |  |  | R = | 200000 Hz
 |  |  |  |  | F.E.C. Encoder Type:
 |  |  |  |  | None |  | Eb/No Method: |  | Eb/No = | 11.8 dB |  | Link Margin: | 2.2 dB | MARGINAL LINK
 |  | R = | 200000 bps |  |  |  | S/N Method: |  | S/N = | 14.0 dB |  | Link Margin: | 4.4 dB | MARGINAL LINK

Sheet: Antenna Patterns
Commonly Used Spacecraft Antenna Radiation Patterns
Spacecraft Antennas:
NOTE:
 | Monopole: | S/C Ð wrt Symmetry Axis (θ)°: | Antenna Gain (dBi):
 |  | 0 | -156.98
 |  | 5 | -5.45
 |  | 10 | -2.45
 |  | 15 | -0.72
 |  | 20 | 0.49
 |  | 25 | 1.41
 |  | 30 | 2.14
 |  | 35 | 2.74
 |  | 40 | 3.23
 |  | 45 | 3.64 |  |  |  |  | Monopole Polar Radiation Plot
 |  | 50 | 3.99 |  |  |  |  |  | HERE
 |  | 55 | 4.28
 |  | 60 | 4.53
 |  | 65 | 4.72
 |  | 70 | 4.88
 |  | 75 | 5.00
 |  | 80 | 5.08
 |  | 85 | 5.13
 |  | 90 | 5.15
 |  | 92.5 | 0.00
 |  | 95 | -20.00
 |  | 97.5 | -60.00
 |  | 100 | -160.00
 |  | 110 | No Signal
 |  |  |  |  |  |  |  |  |  |  | MONOPOLE ELEVATION PATTERN
 |  |  |  |  | Peak Gain: |  | 5.15 | dBi
 |  |  |  |  | Beamwidth: |  | 38.6 | degrees | (-3dB gain loss)
 |  |  |  |  | Peak Gain at: |  | 0.0 | degrees | Elevation
 |  |  |  |  | Outer Ring: |  | 5.15 | dBi | (Add this value to 0.0 dB)
 |  |  |  |  | Azimuth Cut: |  | 0.0 | degrees
 | Dipole: | S/C Ð wrt Symmetry Axis (θ)°: | Antenna Gain (dBi):
 |  | 0 | 2.15
 |  | 10 | 2.08
 |  | 20 | 1.88
 |  | 30 | 1.53
 |  | 40 | 0.99
 |  | 50 | 0.23
 |  | 60 | -0.86
 |  | 70 | -2.51
 |  | 80 | -5.45
 |  | 85 | -8.45
 |  | 87.5 | -11.45
 |  | 90 | -40.00
 |  | 92.5 | -11.45
 |  | 95 | -8.45
 |  | 100 | -5.45
 |  | 110 | -2.51
 |  | 120 | -0.86
 |  | 130 | 0.23
 |  | 140 | 0.99
 |  | 150 | 1.53
 |  | 160 | 1.88
 |  | 170 | 2.08
 |  | 180 | 2.15
 |  | 190 | 2.08
 |  | 200 | 1.88
 |  | 210 | 1.53
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
 |  | 155.00001 | -7.6
 |  | 160.00001 | -8.1
 |  | 165.00001 | -8.8
 |  | 170.00001 | -9.8
 |  | 175.00001 | -11.0
 |  | 180.00001 | -12.6
 |  | 185.00001 | -11.0
 |  | 190.00001 | -9.8
 |  | 195.00001 | -8.8
 |  | 200.00001 | -8.1
 |  | 205.00001 | -7.6
 |  | 210.00001 | -7.4
 |  | 215.00001 | -7.3
 |  | 220.00001 | -7.4
 |  | 225.00001 | -7.7
 |  | 230.00001 | -8.4
 |  | 235.00001 | -9.3
 |  | 240.00001 | -10.7
 |  | 245.00001 | -12.9
 |  | 250.00001 | -16.4
 |  | 255.00001 | -23.7
 |  | 260.00001 | -30.2
 |  | 265.00001 | -17.3
 |  | 270.00001 | -8.6
 |  | 275.00001 | -6.0
 |  | 280.00001 | -4.0
 |  | 285.00001 | -2.3
 |  | 290.00001 | -0.9
 |  | 295.00001 | 0.3
 |  | 300.00001 | 1.3
 |  | 305.00001 | 2.2
 |  | 310.00001 | 3.0
 |  | 315.00001 | 3.7
 |  | 320.00001 | 4.2
 |  | 325.00001 | 4.7
 |  | 330.00001 | 5.1
 |  | 335.00001 | 5.4
 |  | 340.00001 | 5.7
 |  | 345.00001 | 5.9
 |  | 350.00001 | 6.0
 |  | 355.00001 | 6.0

Sheet: Beam Roll-Off Tool
 |  | "Design a Dish"
Antenna Beam Roll-Off Tool
Beam Roll-Off & Sidelobe Positions Based on Sin (θ)/ θ Formulation |  |  |  |  |  |  |  | J. A. King | 2020 January 17
Frequency: | 1.27 | GHz |  | Peak Gain: | 23.4 dBi |  | (See Plot at Next Worksheet)
Antenna Dia.: | 1.5 | Meters
Aperture Efficiency: | 55 | % | Half Power | (P/2) Beamwidth: | 11.0 | ° | =2q (@ -3dB Roll-off) |  |  | 5.51
NOTE: | NOTE: Do not modify or use cells to left of table.
 |  |  |  |  | Pwr (q) w.r.t. Peak Gain: |  |  | q (degrees):
 | 0.0001 | 0.000305 | 304.6174198 | 1.000000 | 0.00 | dB |  | 6.910495265e-06 | Main Lobe
 | 0.1 | 0.000305 | 304.6171105 | 0.9999990496 | -0.000004 | dB |  | 0.007
 | 3.5 | 0.0003042387085 | 304.2387085 | 0.9987568291 | -0.01 | dB |  | 0.242
 | 10 | 0.0003015368961 | 301.5368961 | 0.9898873015 | -0.04 | dB |  | 0.7
 | 25 | 0.0002857699123 | 285.7699123 | 0.9381273435 | -0.3 | dB |  | 1.7
 | 30 | 0.0002777777778 | 277.7777778 | 0.911890712 | -0.4 | dB |  | 2.1
 | 40 | 0.0002582349445 | 258.2349445 | 0.8477353706 | -0.7 | dB |  | 2.8
 | 47 | 0.0002421359153 | 242.1359153 | 0.7948853719 | -1.00 | dB |  | 3.2
 | 56.5 | 0.0002178292941 | 217.8292941 | 0.7150914365 | -1.5 | dB |  | 3.9
 | 60 | 0.0002083333333 | 208.3333333 | 0.683918034 | -1.6 | dB |  | 4.1
 | 70 | 0.0001802086166 | 180.2086166 | 0.5915900295 | -2.3 | dB |  | 4.8
 | 79.76 | 0.0001522240349 | 152.2240349 | 0.499722061 | -3.01 | dB |  | 5.5 | (Half Power B.W.)/2
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
 | 820 | 1.442365126e-06 | 1.442365126 | 0.004735005701 | -23.2 | dB |  | 56.7
 | 830 | 1.281785777e-06 | 1.281785777 | 0.00420785476 | -23.8 | dB |  | 57.4
 | 840 | 1.06292517e-06 | 1.06292517 | 0.003489377725 | -24.6 | dB |  | 58.0

Sheet: Line Loss Tools & Tables
Transmission Line Loss Tools and Tables:
 | NOTE:
 | Ground Station Systems:
 |  | Best Internet Cable Loss Calculator: |  |  |  | http://www.ocarc.ca/coax.htm
 |  | 2nd Best Internet Cable Loss Calculator: |  |  |  | http://www.timesmicrowave.com/cgi-bin/calculate.pl
 |  | Coax Cable Loss Tables:
 |  |  |  |  |  | http://www.radio-ware.com/products/techinfo/coax.loss.htm
 |  |  |  |  |  | http://www.meteorscatter.net/cable.htm
 |  | Wave Guide Loss Table: |  |  |  | http://www.advancedmicrowave.com/products/product_frame.htm
 |  | Wave Guide Primer: |  |  |  | http://www.microwaves101.com/encyclopedia/waveguide.cfm#frequency
 | Spacecraft Systems:
 | RG-188 A/U: A PTFE (Teflon)-wrapped "clean" cable for general purpose spacecraft transmission lines.
 |  | Losses are quite high per unit length as the cable diameter is only 0.098" (2.49 mm). Still, the losses are acceptable
 |  | for short cable runs. The shield is silver plated copper (19 strands, each #33AWG). Typically used with SMA or SMC connectors.
 |  | This is the most commonly used cable for short coax runs in very small spacecraft but, connector installation is moderately difficult.
 | Band: | Frequency: |  | Attenuation (dB/100 m): |  |  | Attenuation (dB/m):
 | 1 | 10 | MHz | 12.0 | dB/100m |  | 0.12 | dB/m
 | 2 | 30 | MHz | 17.0 | dB/100m |  | 0.17 | dB/m |  | Band: | 8
 | 3 | 50 | MHz | - | dB/100m |  | - | dB/m
 | 4 | 100 | MHz | 28.0 | dB/100m |  | 0.28 | dB/m |  | Frequency: | 435 MHz
 | 5 | 145 | MHz | 32.0 | dB/100m |  | 0.32 | dB/m
 | 6 | 200 | MHz | 40.0 | dB/100m |  | 0.4 | dB/m |  | Cable Length: | 0.10 m
 | 7 | 400 | MHz | - | dB/100m |  | - | dB/m
 | 8 | 435 | MHz | 58.0 | dB/100m |  | 0.58 | dB/m |  | Cable Loss: | 0.06 dB
 | 9 | 500 | MHz | 68.0 | dB/100m |  | 0.68 | dB/m
 | 10 | 1270 | MHz | 113.0 | dB/100m |  | 1.13 | dB/m
 | 11 | 2400 | MHz | 165.0 | dB/100m |  | 1.65 | dB/m |  |  | NOTE:
 | 12 | 3300 | MHz | 268.0 | dB/100m |  | 2.68 | dB/m
 | 13 | 5000 | MHz | - | dB/100m |  | - | dB/m | Data courtesy K1TTT, W3LPL,PE1OYF, DJ5RH
 | RG-142 A/U: An FEP (Teflon) solid covered "clean" cable for general purpose spacecraft transmission lines.
 |  | Losses are moderate per unit length as the cable diameter is 0.195" (4.95 mm). The losses are quite acceptable even
 |  | for longer S/C cable runs. The cable is double shielded with two silver coated copper braids. The center conductor is
 |  | solid copper AWG #18. Typically used with SMA or even TNC connectors. Connector installation is moderately difficult.
 | Band: | Frequency: |  | Attenuation (dB/100 m): |  |  | Attenuation (dB/m):
 | 1 | 10 | MHz | 7.0 | dB/100m |  | 0.07 | dB/m
 | 2 | 30 | MHz | 9.0 | dB/100m |  | 0.09 | dB/m |  | Band: | 8
 | 3 | 50 | MHz | - | dB/100m |  | - | dB/m
 | 4 | 100 | MHz | 14.0 | dB/100m |  | 0.14 | dB/m |  | Frequency: | 435 MHz
 | 5 | 145 | MHz | 15.0 | dB/100m |  | 0.15 | dB/m
 | 6 | 200 | MHz | 20.0 | dB/100m |  | 0.2 | dB/m |  | Cable Length: | 0.10 m
 | 7 | 400 | MHz | 28.0 | dB/100m |  | 0.28 | dB/m
 | 8 | 435 | MHz | 30.0 | dB/100m |  | 0.3 | dB/m |  | Cable Loss: | 0.03 dB
 | 9 | 500 | MHz | 35.0 | dB/100m |  | 0.35 | dB/m
 | 10 | 1270 | MHz | 49.0 | dB/100m |  | 0.49 | dB/m
 | 11 | 2400 | MHz | 72.0 | dB/100m |  | 0.72 | dB/m |  |  | NOTE:
 | 12 | 3300 | MHz | 95.0 | dB/100m |  | 0.95 | dB/m
 | 13 | 5000 | MHz | 128.0 | dB/100m |  | 1.28 | dB/m | Data courtesy K1TTT, W3LPL, PE1OYF, DJ5RH
 | RG-303 /U: A PTFE (Teflon) solid covered "clean" cable for ruggedized spacecraft transmission line applications.
 |  | Losses are moderate per unit length as the cable diameter is 0.170" (4.32 mm). The losses are quite acceptable even
 |  | for longer S/C cable runs. The cable is single shielded with a silver coated copper braid. The center conductor is
 |  | silver over copper over steel 0.039" (1 mm) dia. Typically used with SMA or even TNC connectors. This is a very rugged cable type.
 | Band: | Frequency: |  | Attenuation (dB/100 m): |  |  | Attenuation (dB/m):
 | 1 | 10 | MHz | 9.3 | dB/100m |  | 0.0931 | dB/m
 | 2 | 30 | MHz | 12.0 | dB/100m |  | 0.12 | dB/m |  | Band: | 8
 | 3 | 50 | MHz | - | dB/100m |  | - | dB/m
 | 4 | 100 | MHz | 18.6 | dB/100m |  | 0.186 | dB/m |  | Frequency: | 435 MHz
 | 5 | 145 | MHz | 19.9 | dB/100m |  | 0.1995 | dB/m
 | 6 | 200 | MHz | 26.6 | dB/100m |  | 0.266 | dB/m |  | Cable Length: | 0.10 m
 | 7 | 400 | MHz | 37.2 | dB/100m |  | 0.3724 | dB/m
 | 8 | 435 | MHz | 40.0 | dB/100m |  | 0.4 | dB/m |  | Cable Loss: | 0.04 dB
 | 9 | 500 | MHz | 46.5 | dB/100m |  | 0.4655 | dB/m
 | 10 | 1270 | MHz | 65.2 | dB/100m |  | 0.652 | dB/m
 | 11 | 2400 | MHz | 95.8 | dB/100m |  | 0.9575 | dB/m |  |  | NOTE:
 | 12 | 3300 | MHz | 126.4 | dB/100m |  | 1.264 | dB/m
 | 13 | 5000 | MHz | 170.2 | dB/100m |  | 1.702 | dB/m | Can not find data source. Data estimated by VK4GEY.
 | 50 W Semi-Rigid Cable (0.085" dia.): Semi-Rigid cable is intended to be bent and/or formed one time and then left in position. This
 |  | cable has a solid copper outer conductor (tube). Some versions are silver plated. This version has an exterior diameter of 0.86"
 |  | (2.18 mm) and a solid copper inner conductor. SMA, SMC or TNC connectors can be used and are easily installed.
 |  | Losses are superior to flexible cables.
 | Band: | Frequency: |  | Attenuation (dB/100 m): |  |  | Attenuation (dB/m):
 | 1 | 30 | MHz | 13.0 | dB/100m |  | 0.13 | dB/m
 | 2 | 145 | MHz | 25.0 | dB/100m |  | 0.25 | dB/m |  | Band: | 3
 | 3 | 435 | MHz | 33.0 | dB/100m |  | 0.33 | dB/m
 | 4 | 1270 | MHz | 53.0 | dB/100m |  | 0.53 | dB/m |  | Frequency: | 435 MHz
 | 5 | 2000 | MHz | 88.6 | dB/100m |  | 0.89 | dB/m
 | 6 | 2400 | MHz | 96.0 | dB/100m |  | 0.96 | dB/m |  | Cable Length: | 0.10 m
 | 7 | 10000 | MHz | 200.1 | dB/100m |  | 2.00 | dB/m
 | 8 | 18000 | MHz | 275.5 | dB/100m |  | 2.75 | dB/m |  | Cable Loss: | 0.03 dB
 |  |  |  |  |  |  |  |  |  |  | NOTE:
 |  |  |  |  |  |  |  |  | Data courtesy Storm Products Co. [Bold Text].
 |  |  |  |  |  |  |  |  | Data extrapolated by VK4GEY
 | 50 W Semi-Rigid Cable (0.141" dia.): Semi-Rigid cable is intended to be bent and/or formed one time and then left in position. This
 |  | cable has a solid copper outer conductor (tube). Some versions are silver plated. This version has an exterior diameter of 0141"
 |  | (3.58 mm) and a solid copper inner conductor. SMA, SMC or TNC connectors can be used and are easily installed.
 |  | Losses are superior to flexible cables.
 | Band: | Frequency: |  | Attenuation (dB/100 m): |  |  | Attenuation (dB/m):
 | 1 | 30 | MHz | 8.0 | dB/100m |  | 0.08 | dB/m
 | 2 | 145 | MHz | 15.0 | dB/100m |  | 0.15 | dB/m |  | Band: | 3
 | 3 | 435 | MHz | 24.0 | dB/100m |  | 0.24 | dB/m
 | 4 | 1270 | MHz | 57.5 | dB/100m |  | 0.57 | dB/m |  | Frequency: | 435 MHz
 | 5 | 2000 | MHz | 65.6 | dB/100m |  | 0.66 | dB/m
 | 6 | 2400 | MHz | 68.5 | dB/100m |  | 0.69 | dB/m |  | Cable Length: | 0.10 m
 | 7 | 10000 | MHz | 91.8 | dB/100m |  | 0.92 | dB/m
 | 8 | 18000 | MHz | 124.6 | dB/100m |  | 1.25 | dB/m |  | Cable Loss: | 0.02 dB
 |  |  |  |  |  |  |  |  |  |  | NOTE:
 |  |  |  |  |  |  |  |  | Data courtesy Storm Products Co.[Bold Text].
 |  |  |  |  |  |  |  |  | Data extrapolated by VK4GEY

Sheet: VSWR Loss Tool
Losses Resulting from Antenna Mismatch - Measured Using Voltage Standing Wave Ratio(VSWR) Method
 | NOTE:
 |  | Transmitter Power Output: |  | 30.0 | watts
 |  |  |  |  |  | Manually Enter Results of Test #1 or Test #2 at Cell [H8]
 |  | Measured or Estimated VSWR: |  | 1.5 | :1
 |  | Power Reflected and Lost: |  | 1.20 | watts | 4.0% | % of Power
 |  | Power Transmitted: |  | 28.80 | watts | 96.0% | % of Power
 |  | Power Loss due to Mismatch (dB): |  | 0.18 | dB | This value should be entered in the "Transmitters" W/S
 |  |  |  |  |  | at Cell [I31].
 |  |  |  |  |  |  |  |  |  |  |  | Don't Change These Formulas
 |  |  |  |  |  |  |  |  |  |  |  | |Ztx| = | 50.0 | W
 |  |  |  |  |  |  |  | Measured Ztx: | 50 | 0.0 j
 |  |  |  |  |  |  |  |  |  |  |  | |Zsys| = | 79.1 | W
 |  |  |  |  |  |  |  | Measured Zsys: | 75 | -25.0 j
 |  |  |  |  |  |  |  |  |  |  |  |  | NOTE:
 |  |  |  |  |  |  |  | VSWR: | 1.58 :1
 |  |  |  |  |  |  |  |  |  | TEST 1
 |  |  |  |  |  |  |  |  |  |  | OR
 |  |  |  |  |  |  |  |  |  | TEST 2
 |  |  |  |  |  |  |  | Forward Power Measured: |  | 5.0 watts
 |  |  |  |  |  |  |  | Reverse Power Measured: |  | 0.2 watts
 |  |  |  |  |  |  |  | VSWR: |  | 1.58 :1
 |  |  | NOTE:

Sheet: Orbit Shape Data
Earth and Orbit Shape for Figure in Orbit & Frequency W/S [NOTE: DO NOT MODIFY]
NOTE: | Y | X | R | Y1 | X1 | R1
 | 3.519943181 | -1.9 | 16 | 3.57456291 | -1.9 | 16.2
 | 3.546477125 | -1.85 | 16 | 3.6 | -1.85 | 16.2
 | 3.57211422 | -1.8 | 16 | 3.62456894 | -1.8 | 16.2
 | 3.596873642 | -1.75 | 16 | 3.648287269 | -1.75 | 16.2
 | 3.620773398 | -1.7 | 16 | 3.671171475 | -1.7 | 16.2
 | 3.643830402 | -1.65 | 16 | 3.693237063 | -1.65 | 16.2
 | 3.666060556 | -1.6 | 16 | 3.71449862 | -1.6 | 16.2
 | 3.687478813 | -1.55 | 16 | 3.734969879 | -1.55 | 16.2
 | 3.708099244 | -1.5 | 16 | 3.754663767 | -1.5 | 16.2
 | 3.727935085 | -1.45 | 16 | 3.773592453 | -1.45 | 16.2
 | 3.746998799 | -1.4 | 16 | 3.791767398 | -1.4 | 16.2
 | 3.765302113 | -1.35 | 16 | 3.809199391 | -1.35 | 16.2
 | 3.782856064 | -1.3 | 16 | 3.825898587 | -1.3 | 16.2
 | 3.799671038 | -1.25 | 16 | 3.841874542 | -1.25 | 16.2
 | 3.815756806 | -1.2 | 16 | 3.857136243 | -1.2 | 16.2
 | 3.831122551 | -1.15 | 16 | 3.871692137 | -1.15 | 16.2
 | 3.845776905 | -1.1 | 16 | 3.885550154 | -1.1 | 16.2
 | 3.85972797 | -1.05 | 16 | 3.898717738 | -1.05 | 16.2
 | 3.872983346 | -1 | 16 | 3.911201861 | -1 | 16.2
 | 3.885550154 | -0.95 | 16 | 3.923009049 | -0.95 | 16.2
 | 3.897435054 | -0.9 | 16 | 3.934145396 | -0.9 | 16.2
 | 3.908644266 | -0.85 | 16 | 3.944616585 | -0.85 | 16.2
 | 3.919183588 | -0.8 | 16 | 3.954427898 | -0.8 | 16.2
 | 3.929058411 | -0.75 | 16 | 3.963584237 | -0.75 | 16.2
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
 | 3.620773398 | 1.7 | 16 | 3.648287269 | 1.7 | 16.2
 | 3.596873642 | 1.75 | 16 | 3.62456894 | 1.75 | 16.2
 | 3.57211422 | 1.8 | 16 | 3.6 | 1.8 | 16.2
 | 3.546477125 | 1.85 | 16 | 3.57456291 | 1.85 | 16.2
 | 3.519943181 | 1.9 | 16 | 3.548239 | 1.9 | 16.2
