CougsInSpace/CougSat1-Hardware/CougSat1-Payload/CADModel/Germination.1.0.0.stp

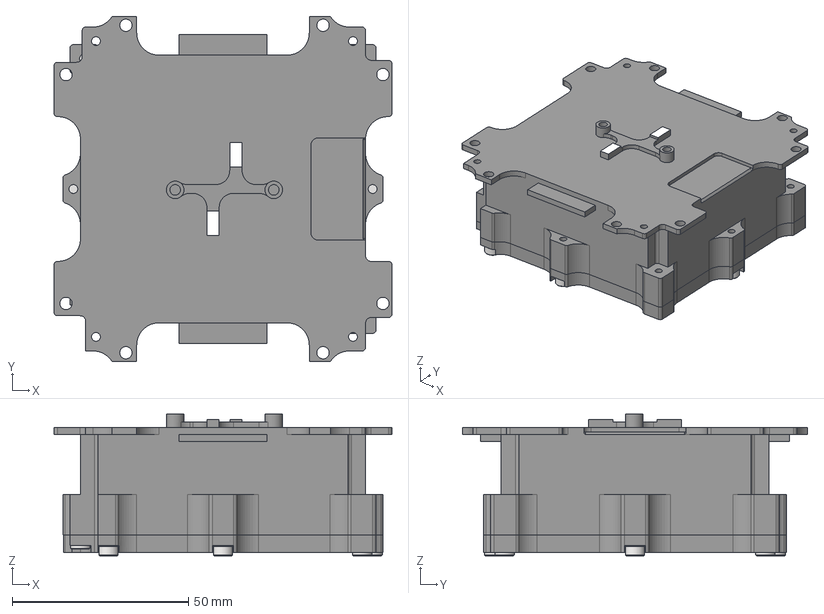
[picture p101: CAD file, 2020-10-22]
CougSat1-Payload/CADModel/Germination.1.0.0.stp
96.0 x 98.0 x 40.3 mm
Germination_Bottom
Germination_Top
Bolt_M3x0.35_6mm_SH x 6
