CougsInSpace/CougSat1-Hardware/CougSat1-RadioBoard/CADModel/-ZPanel.1.1.1.stp

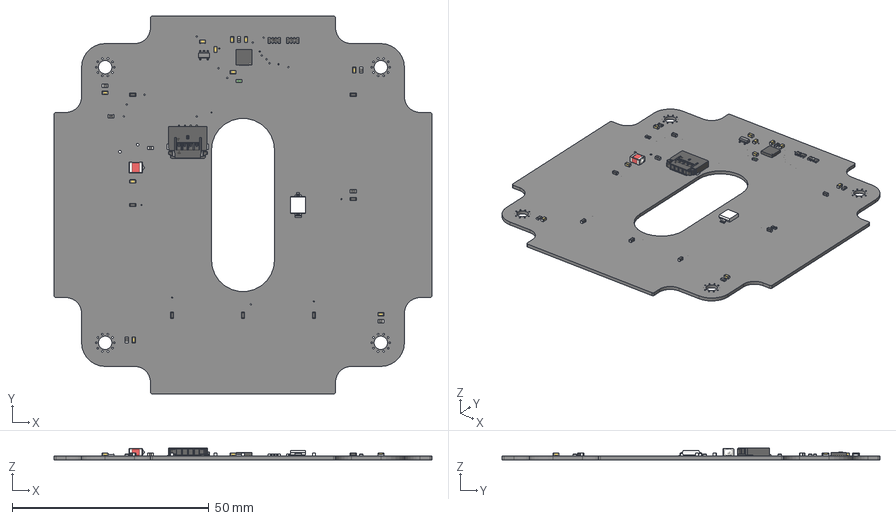
[picture p102: CAD file, 2020-03-05]
CougSat1-RadioBoard/CADModel/-ZPanel.1.1.1.stp
96.0 x 96.0 x 3.00 mm
Resistor_1608-0.5mm
Capacitor_1608-0.8mm
Capacitor_4028-Tantalum
Capacitor_1608-0.8mm_1
ResistorArray-1632 x 2
Resistor_1608-0.5mm_1 x 7
Capacitor_1608-0.8mm_2 x 8
Semiconductor_QFN24-4x4
Semiconductor_SOT23-5
Photodiode_SFH2430
PicoLock--J-4
PicoLock--P-4
-ZPanel_PCB
