CougsInSpace/CougSat1-Hardware/CougSat1-Structure/CADModel/Native/STR_nX (1).SLDPRT

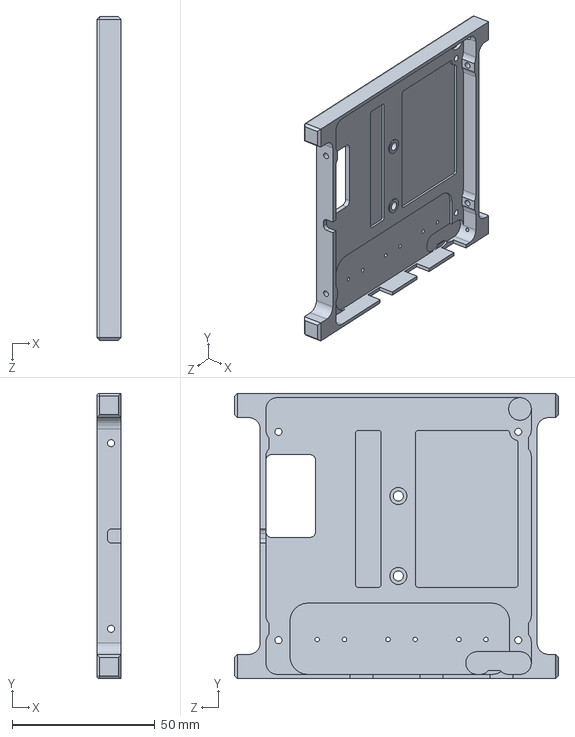
[picture p103: CAD file, 2020-10-22]
CougSat1-Structure/CADModel/Native/STR_nX (1).SLDPRT
8.50 x 100.0 x 113.5 mm
