CougsInSpace/CougSat1-Hardware/CougSat1-Structure/CADModel/Structure.2.18.0.stp

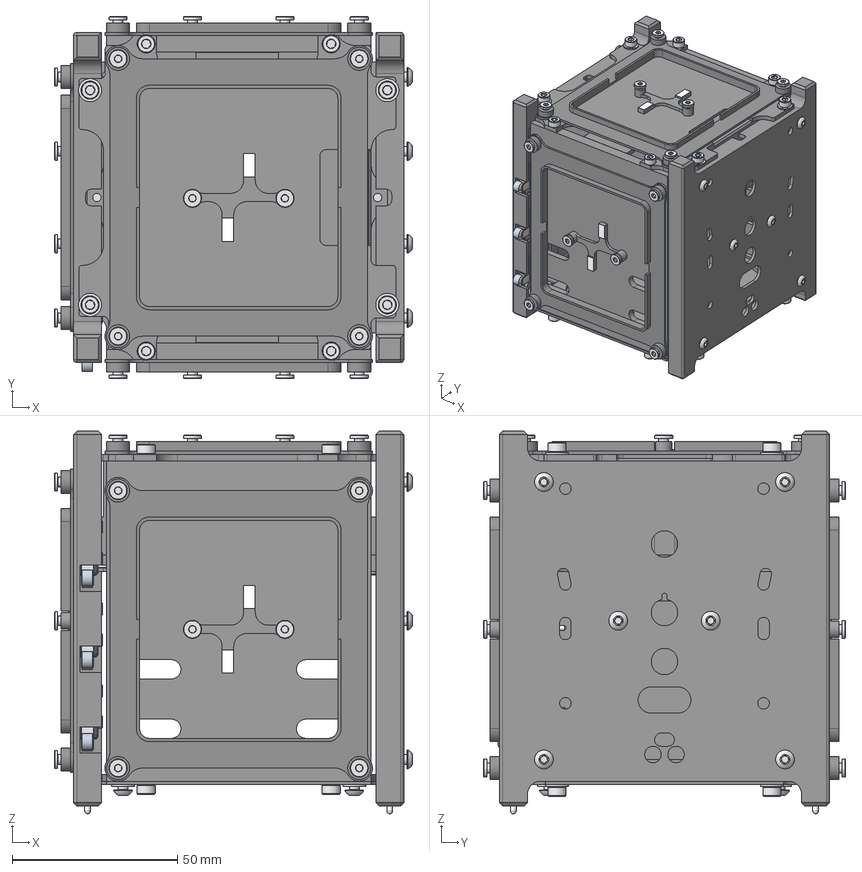
[picture p104: CAD file, 2020-10-22]
CougSat1-Structure/CADModel/Structure.2.18.0.stp
108.4 x 109.6 x 115.9 mm
Spring_Separation x 2
Washer_3.2x7.0x0.6mm x 12
Bolt_M3x0.35_6mm_SH_1 x 14
Bolt_M3x0.35_6mm_SH x 18
48-03A1 x 2
Structure_+X
Structure_-X
Structure_-Z
Structure_MagnetorquerForm x 4
Structure_SolarPanelHeatsink x 3
Structure_Y x 2
Germination_Bottom
Germination_Top
