CougsInSpace/CougSat1-Hardware/CougSat1-RadioBoard/CADModel/-ZPanel.1.0.0.stp

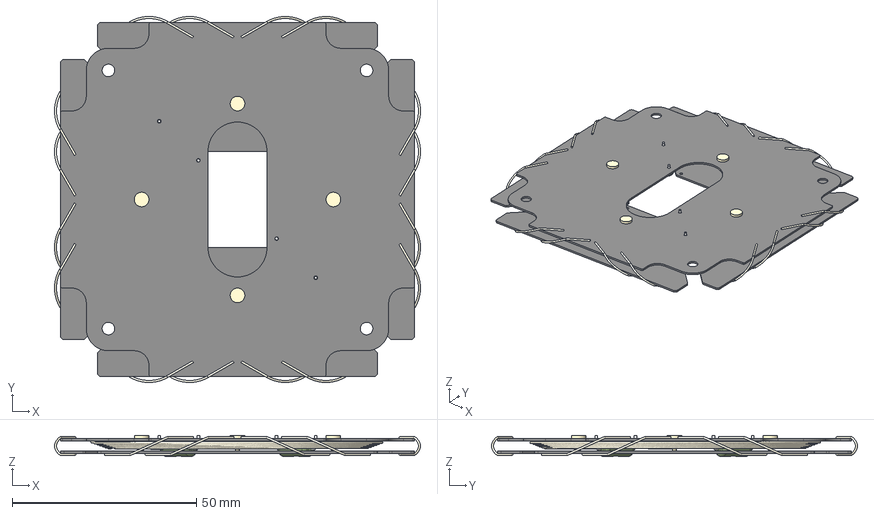
[picture p105: CAD file, 2018-11-18]
CougSat1-RadioBoard/CADModel/-ZPanel.1.0.0.stp
99.2 x 99.2 x 5.80 mm
-ZPanel_PCB
-ZPanel_AntennaStored
PicoLock--J-4
PicoLock--P-4
U.FL_Male
U.FL_Female
Resistor_TH-15mm x 2
-ZPanel_PCBExtender x 4
-ZPanel_SpringLeft x 8
-ZPanel_SpringRight x 8
Base x 4
Plunger x 4
