CougsInSpace/CougSat1-Hardware/CougSat1-Structure/CADModel/Native/Str_nZ4.SLDPRT

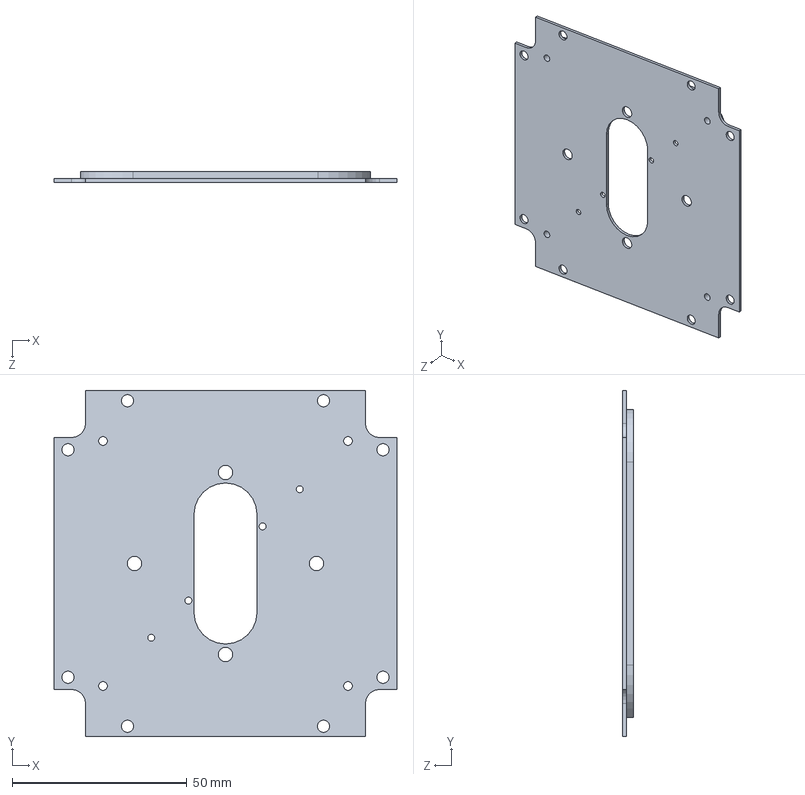
[picture p106: CAD file, 2020-10-22]
CougSat1-Structure/CADModel/Native/Str_nZ4.SLDPRT
98.0 x 99.0 x 3.00 mm
