CougsInSpace/CougSat1-Hardware/CougSat1-Structure/CADModel/Native/SolarHeatSinkStandoff.SLDPRT

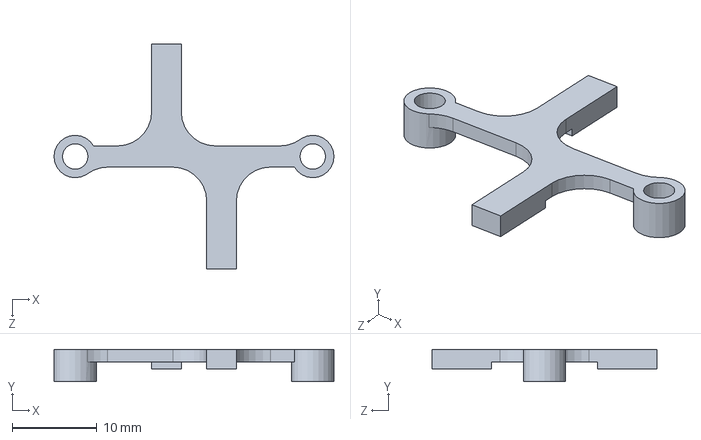
[picture p107: CAD file, 2020-10-22]
CougSat1-Structure/CADModel/Native/SolarHeatSinkStandoff.SLDPRT
33.0 x 3.80 x 26.5 mm
