CougsInSpace/CougSat1-Hardware/CougSat1-Structure/CADModel/Native/Clamping Plate -E.SLDPRT

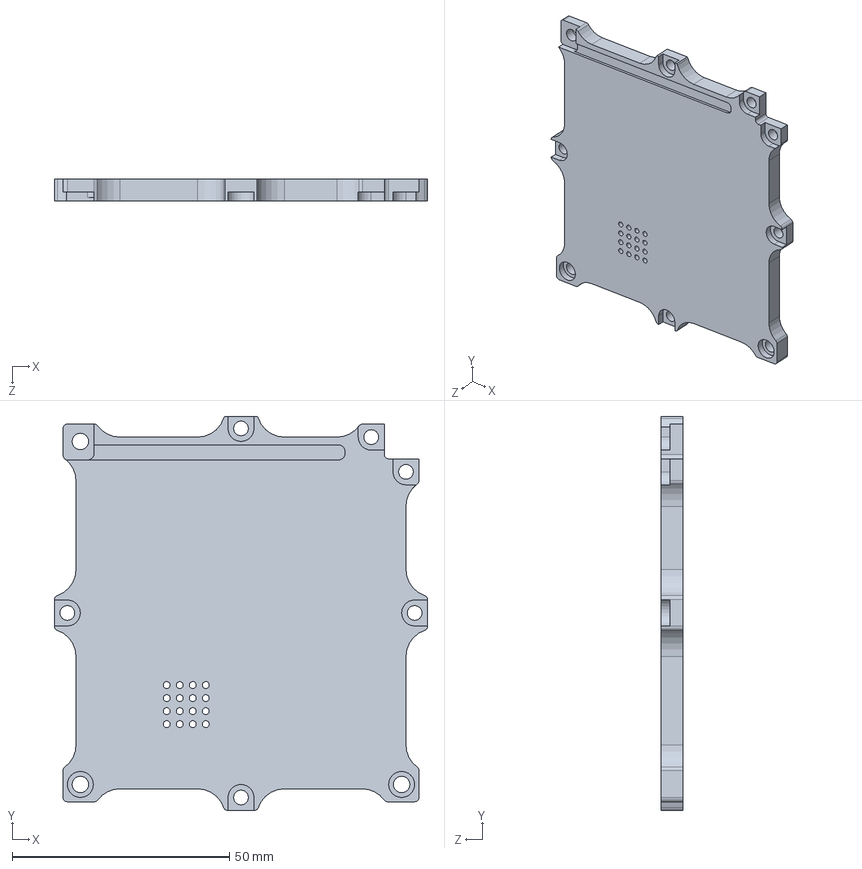
[picture p108: CAD file, 2020-10-22]
CougSat1-Structure/CADModel/Native/Clamping Plate -E.SLDPRT
86.0 x 90.8 x 5.00 mm
