CougsInSpace/CougSat1-Hardware/CougSat1-Structure/CADModel/Native/Chamber Base -E.SLDPRT

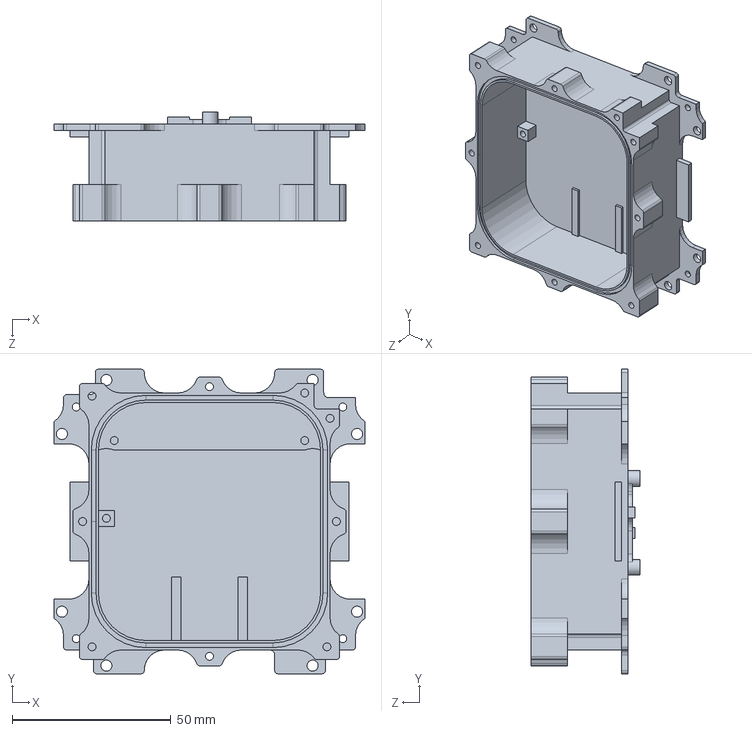
[picture p109: CAD file, 2020-10-22]
CougSat1-Structure/CADModel/Native/Chamber Base -E.SLDPRT
98.0 x 96.0 x 34.3 mm
