CougsInSpace/CougSat1-Hardware/CougSat1-Structure/CADModel/Native/STR_nY.SLDPRT

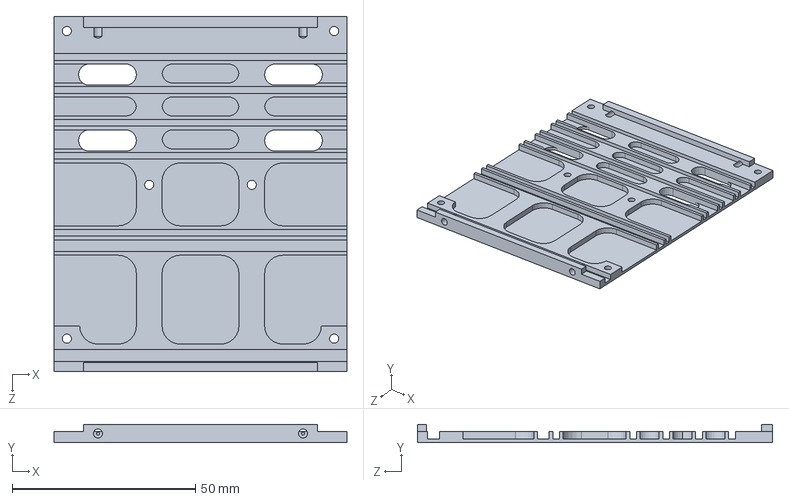
[picture p110: CAD file, 2020-10-22]
CougSat1-Structure/CADModel/Native/STR_nY.SLDPRT
80.0 x 5.00 x 97.0 mm
