CougsInSpace/CougSat1-Hardware/CougSat1-Structure/CADModel/Native/MagnetorquerStandoff.SLDPRT

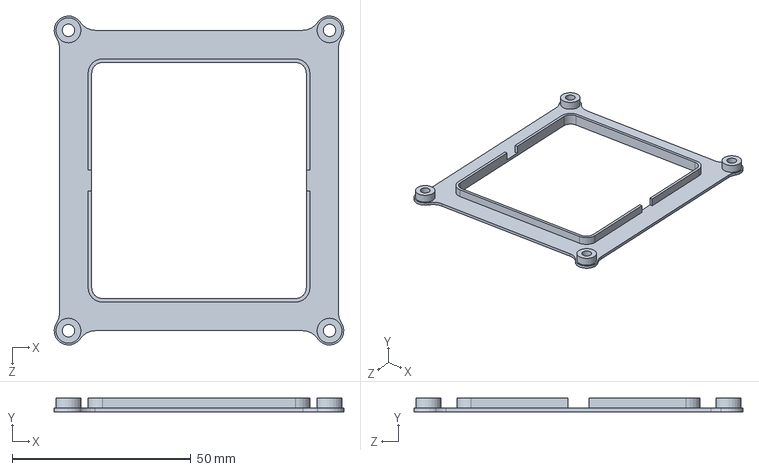
[picture p111: CAD file, 2020-10-22]
CougSat1-Structure/CADModel/Native/MagnetorquerStandoff.SLDPRT
81.0 x 3.80 x 92.0 mm
