CougsInSpace/CougSat1-Hardware/(list of files, cad)

Other CAD files:
CougSat1-Structure/CADModel/Native/STR_pX.SLDPRT
CougSat1-AvionicBoard/CADModel/Native/Avionics.iam
CougSat1-AvionicBoard/CADModel/Native/Avionics_PCB.ipt
CougSat1-Backplane/CADModel/Native/Backplane.iam
CougSat1-Backplane/CADModel/Native/Backplane_CenterNut.ipt
CougSat1-Backplane/CADModel/Native/Backplane_PCB.ipt
CougSat1-Backplane/Documentation/Native/CardRailStandard.ipt
CougSat1-Backplane/Documentation/Native/CardStandard.idw
CougSat1-Backplane/Documentation/Native/CardStandard.ipt
CougSat1-GroundStation/CADModel/Native/Ground.iam
CougSat1-GroundStation/CADModel/Native/Ground_Antenna230mm.iam
CougSat1-GroundStation/CADModel/Native/Ground_Antenna230mm_Helix.ipt
CougSat1-GroundStation/CADModel/Native/Ground_Antenna230mm_Reflector.ipt
CougSat1-GroundStation/CADModel/Native/Ground_Antenna230mm_Support.ipt
CougSat1-GroundStation/CADModel/Native/Ground_Antenna230mm_SupportArm.ipt
CougSat1-GroundStation/CADModel/Native/Ground_Antenna700mm.iam
CougSat1-GroundStation/CADModel/Native/Ground_Antenna700mm_Helix.ipt
CougSat1-GroundStation/CADModel/Native/Ground_Antenna700mm_Reflector.ipt
CougSat1-GroundStation/CADModel/Native/Ground_Antenna700mm_Support.ipt
CougSat1-GroundStation/CADModel/Native/Ground_Antenna700mm_SupportArm.ipt
CougSat1-GroundStation/CADModel/Native/Ground_Tracker.iam
CougSat1-GroundStation/CADModel/Native/Ground_Tracker_Bearing.ipt
CougSat1-GroundStation/CADModel/Native/Ground_Tracker_CrossTube.ipt
CougSat1-GroundStation/CADModel/Native/Ground_Tracker_CrossTubeCollar.ipt
CougSat1-GroundStation/CADModel/Native/Ground_Tracker_ElevationGear.ipt
CougSat1-GroundStation/CADModel/Native/Ground_Tracker_ElevationPinion.ipt
CougSat1-GroundStation/CADModel/Native/Ground_Tracker_ServoMount.ipt
CougSat1-GroundStation/CADModel/Native/Ground_Tracker_Spacer.ipt
CougSat1-GroundStation/CADModel/Native/Ground_Tracker_TripodMount.ipt
CougSat1-Payload/CADModel/Imported/Germination.iam
CougSat1-Payload/CADModel/Imported/Germination_Bottom.ipt
CougSat1-Payload/CADModel/Imported/Germination_Top.ipt
CougSat1-Payload/CADModel/Native/Payload-Camera.iam
CougSat1-Payload/CADModel/Native/Payload-Camera_PCB.ipt
CougSat1-Payload/CADModel/Native/Payload-Camera_Support.ipt
CougSat1-Payload/CADModel/Native/Payload-Interposer.iam
CougSat1-Payload/CADModel/Native/Payload-Interposer_PCB.ipt
CougSat1-PowerBoard/CADModel/Native/EPS.iam
CougSat1-PowerBoard/CADModel/Native/EPS_BatteryHeatsink.ipt
CougSat1-PowerBoard/CADModel/Native/EPS_BatteryTab.ipt
CougSat1-PowerBoard/CADModel/Native/EPS_BatteyTie.ipt
CougSat1-PowerBoard/CADModel/Native/EPS_PCB.ipt
CougSat1-PowerBoard/CADModel/Native/EPS_RBFPinHolder.ipt
CougSat1-PowerBoard/CADModel/Native/EPS_RegulatorHeatsink-A.ipt
CougSat1-PowerBoard/CADModel/Native/EPS_RegulatorHeatsink-B.ipt
CougSat1-PowerBoard/CADModel/Native/EPS_RegulatorHeatsink.ipt
CougSat1-PowerBoard/CADModel/Native/EPS_RegulatorHeatsinkBatteryAdapter.ipt
CougSat1-PowerBoard/CADModel/Native/EPS_RegulatorHeatsinkClamp.ipt
CougSat1-PowerBoard/CADModel/Native/SolarPanel.iam
CougSat1-PowerBoard/CADModel/Native/SolarPanel_CellJumper.ipt
CougSat1-PowerBoard/CADModel/Native/SolarPanel_PCB.ipt
CougSat1-RadioBoard/CADModel/Native/+XPanel.iam
CougSat1-RadioBoard/CADModel/Native/+XPanel_AntennaDeployed.ipt
CougSat1-RadioBoard/CADModel/Native/+XPanel_AntennaMount.ipt
CougSat1-RadioBoard/CADModel/Native/+XPanel_AntennaPost.ipt
CougSat1-RadioBoard/CADModel/Native/+XPanel_AntennaStored+Y.ipt
CougSat1-RadioBoard/CADModel/Native/+XPanel_AntennaStored-Y.ipt
CougSat1-RadioBoard/CADModel/Native/+XPanel_PCB.ipt
CougSat1-RadioBoard/CADModel/Native/-ZPanel.iam
CougSat1-RadioBoard/CADModel/Native/-ZPanel_PCB.ipt
CougSat1-RadioBoard/CADModel/Native/Comms_PCB.ipt
CougSat1-Structure/CADModel/Imported/Structure.iam
CougSat1-Structure/CADModel/Imported/Structure_+X.ipt
CougSat1-Structure/CADModel/Imported/Structure_-X.ipt
CougSat1-Structure/CADModel/Imported/Structure_-Z.ipt
CougSat1-Structure/CADModel/Imported/Structure_MagnetorquerForm.ipt
CougSat1-Structure/CADModel/Imported/Structure_SolarPanelHeatsink.ipt
CougSat1-Structure/CADModel/Imported/Structure_Y.ipt
CougSat1/CADModel/Native/CougSat-1/AIP/Cable and Harness/CougSat-1.Harness.iam
