CougsInSpace/CougSat1-Hardware/CougSat1-Structure/Documentation/Native/CougSat1 Assembly Process 9.10.18.docx

CougSat1 Rough Assembly Process (As of 9.10.18)

This document describes the rough assembly of CougSat1

The 4 primary structural parts look like this, and are fitted as seen below:

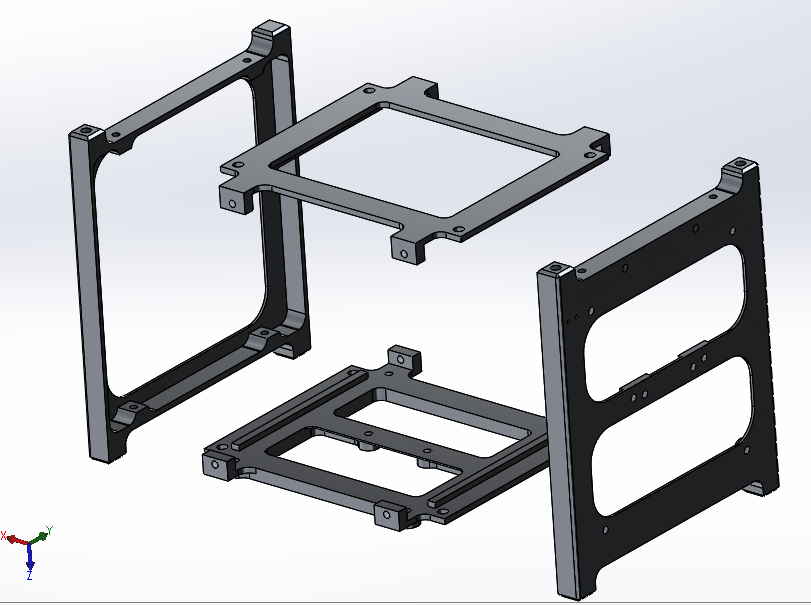
[picture p112: figure]
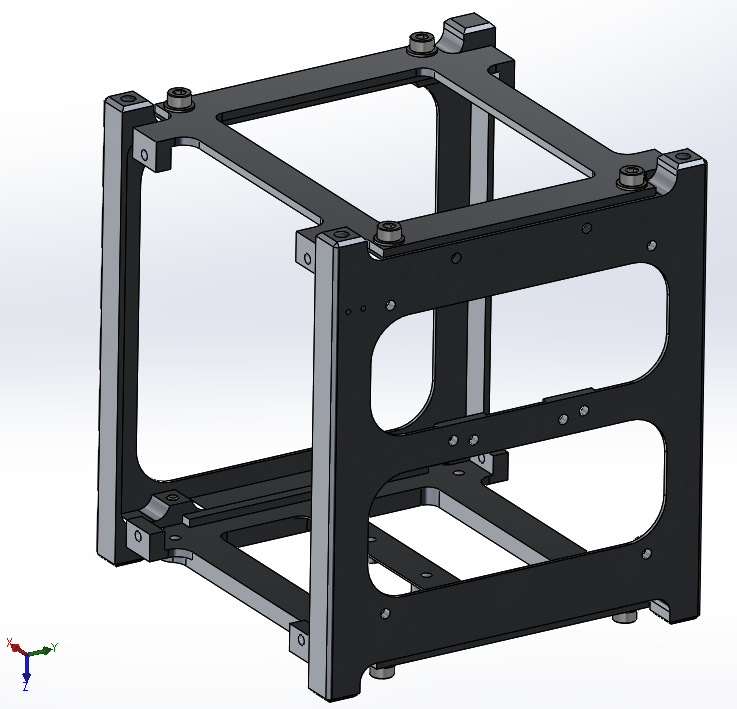
[picture p113: figure]
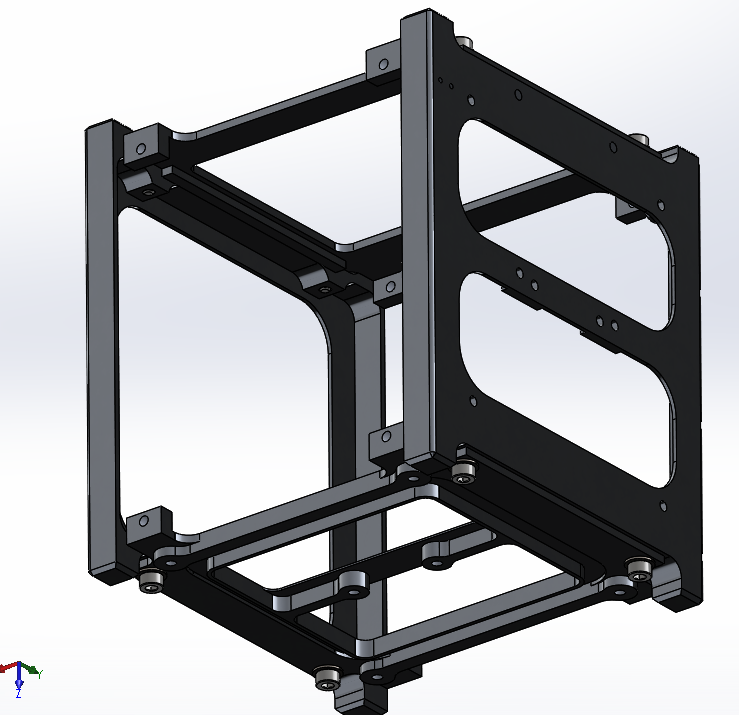
[picture p114: figure]

Fitting will be done before the final assembly process. This will attach all major parts to ensure they fit, including the board and backplane, as well as the sideplates of the structure. We will ensure the boards are not being overly stressed and that the overall dimensions of the assembled structure are within the allowed volume limits. This does not need to be done in a cleanroom.

ASSEMBLY:

1. The structure will be set up as followed (the side plates, frontplane (left) and top/bottom should not have been moved since last disassembly). Only the backplane should be missing from the structural parts.

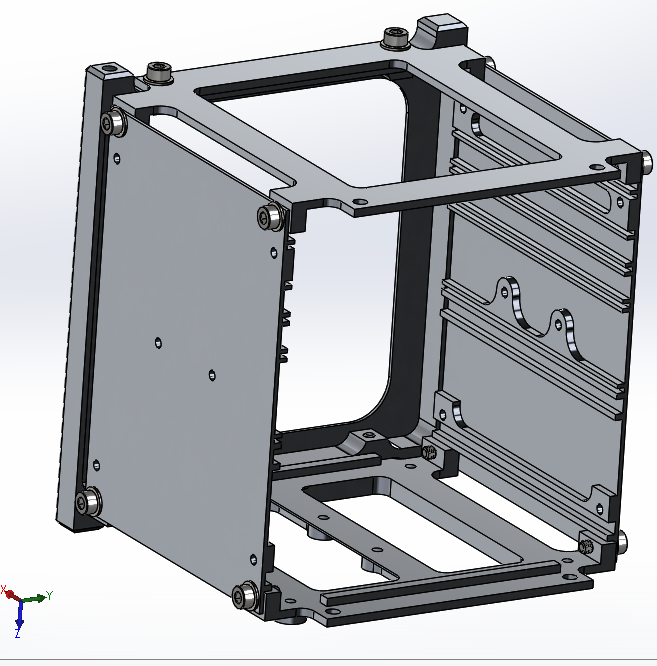
[picture p115: figure]

2. Then the backboard will have the backplane attached to it as such:

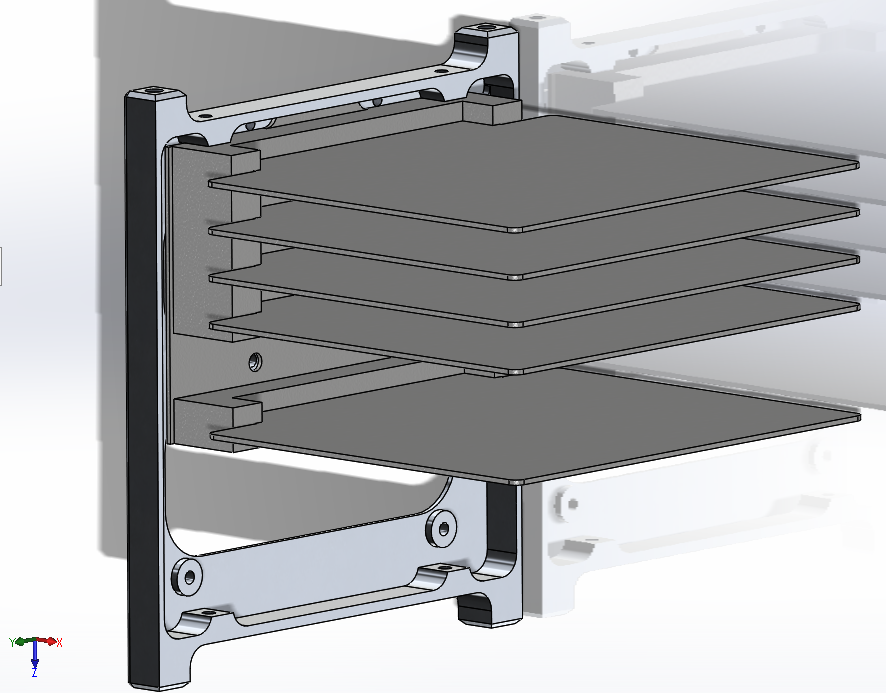
[picture p116: figure]
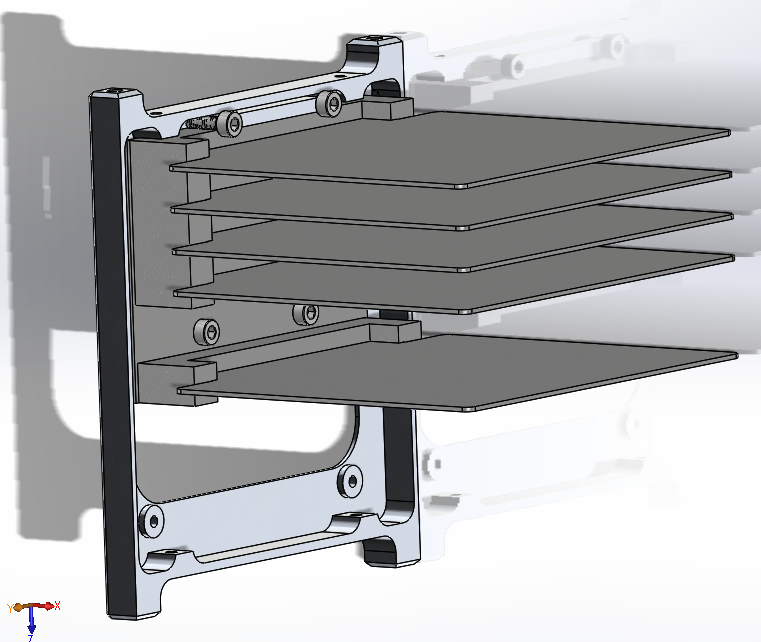
[picture p117: figure]

3. And the separation spring/deployment switch will be attached (may be before step 2)

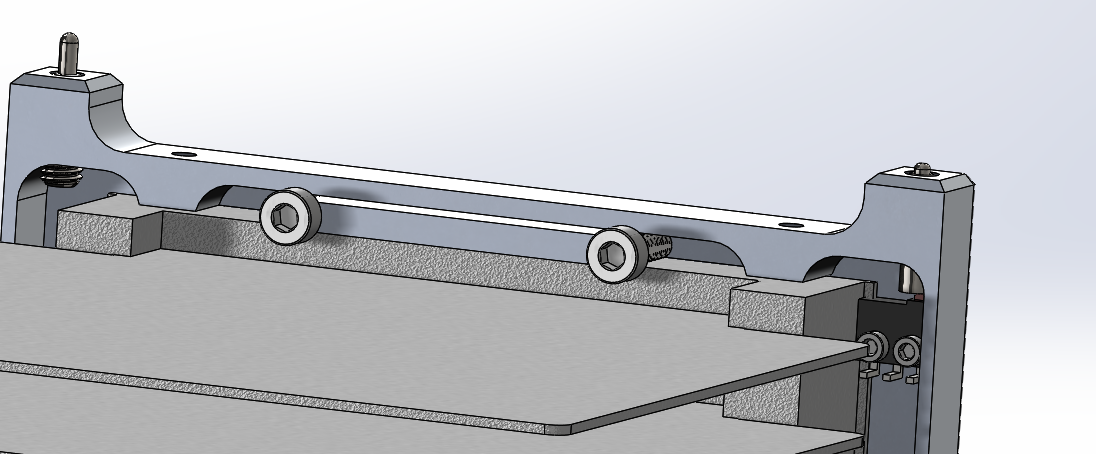
[picture p118: figure]

4. This backplate will be inserted into the structure with the boards sliding into the slots:

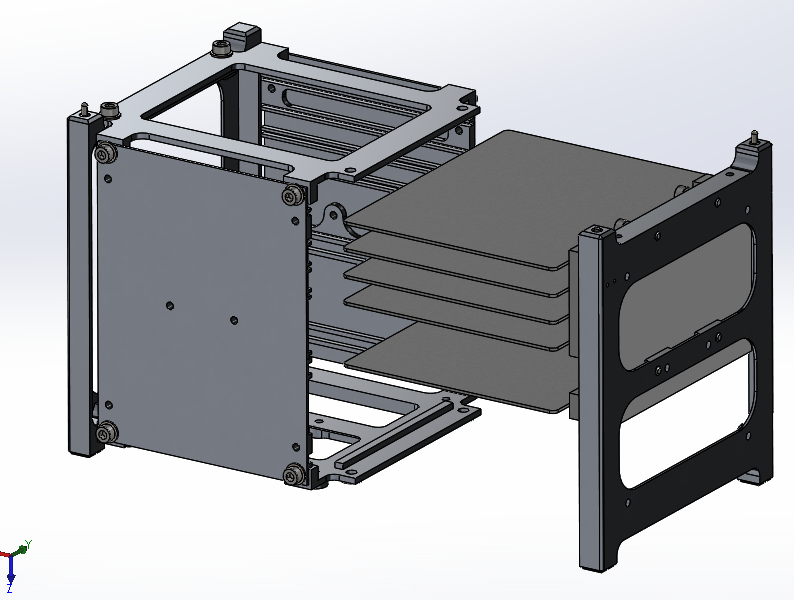
[picture p119: figure]
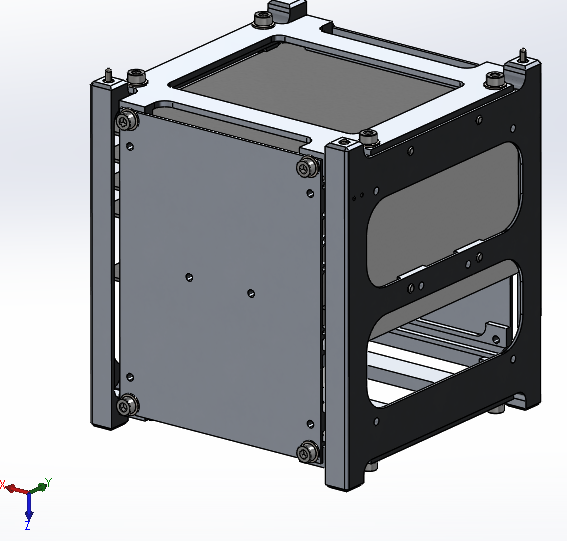
[picture p120: figure]

5. The magnetorquers and standoffs for the solar arrays will be installed, one by one:

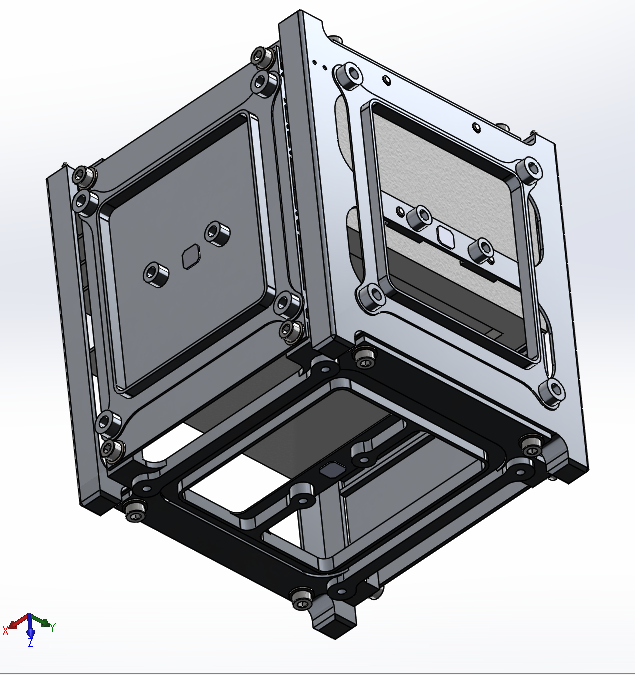
[picture p121: figure]
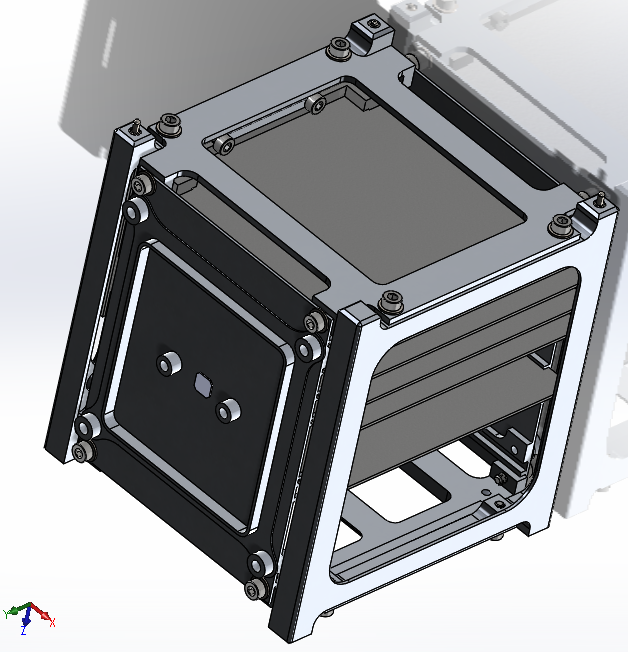
[picture p122: figure]

6. Finally, the solar arrays will be attached:

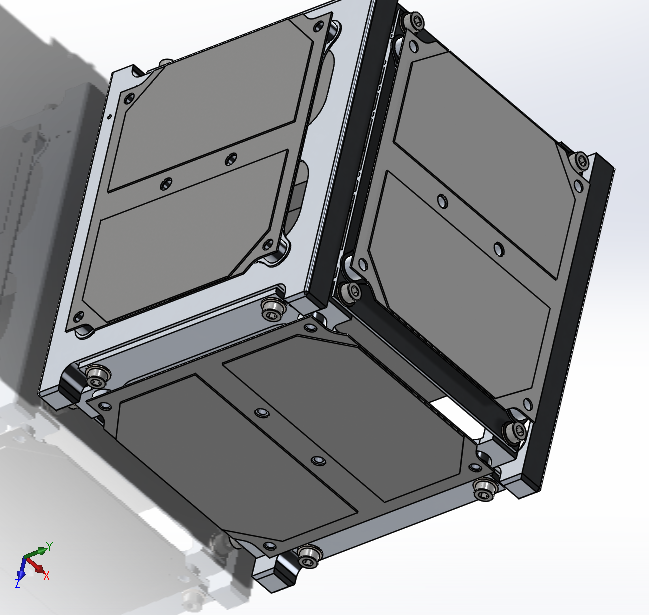
[picture p123: figure]
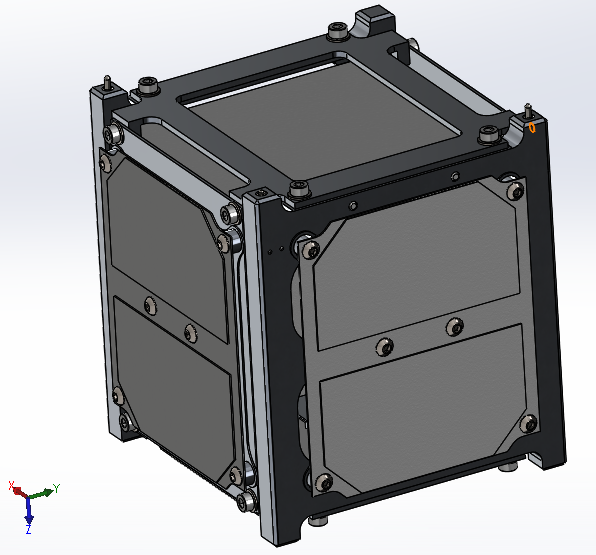
[picture p124: figure]
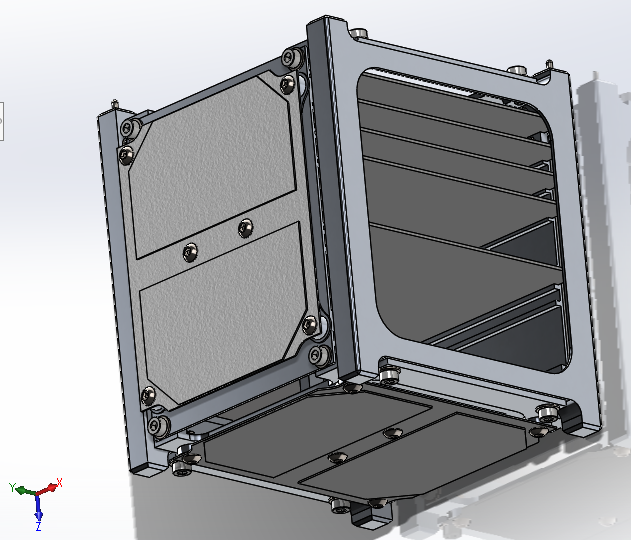
[picture p125: figure]
