CougsInSpace/CougSat1-Hardware/CougSat1-RadioBoard/Testing/Comms.1.0/3.10/5V - Efficiency.xlsx

Sheet: By Loads
Voltage In | Current In | Voltage Out | Shunt Out | Current Out | Power In | Power Out | Efficiency
3.256 V | 24.1 mA | 5.201 V | 0.544 mV | 10.9 mA | 78.5 mW | 56.6 mW | 72.1%
3.695 V | 21.2 mA | 5.209 V | 0.547 mV | 10.9 mA | 78.3 mW | 57.0 mW | 72.7%
4.067 V | 18.4 mA | 5.208 V | 0.542 mV | 10.8 mA | 74.8 mW | 56.5 mW | 75.4%
Voltage In | Current In | Voltage Out | Shunt Out | Current Out | Power In | Power Out | Efficiency
3.330 V | 38.6 mA | 5.198 V | 0.882 mV | 17.6 mA | 128.5 mW | 91.7 mW | 71.3%
3.637 V | 35.0 mA | 5.204 V | 0.883 mV | 17.7 mA | 127.3 mW | 91.9 mW | 72.2%
4.045 V | 30.6 mA | 5.206 V | 0.882 mV | 17.6 mA | 123.8 mW | 91.8 mW | 74.2%
Voltage In | Current In | Voltage Out | Shunt Out | Current Out | Power In | Power Out | Efficiency
3.279 V | 66.3 mA | 5.209 V | 1.941 mV | 38.8 mA | 217.4 mW | 202.2 mW | 93.0%
3.693 V | 58.4 mA | 5.209 V | 1.941 mV | 38.8 mA | 215.7 mW | 202.2 mW | 93.8%
4.107 V | 52.1 mA | 5.208 V | 1.941 mV | 38.8 mA | 214.0 mW | 202.2 mW | 94.5%
Voltage In | Current In | Voltage Out | Shunt Out | Current Out | Power In | Power Out | Efficiency
3.245 V | 139.2 mA | 5.209 V | 4.060 mV | 81.2 mA | 451.7 mW | 423.0 mW | 93.6%
3.679 V | 121.6 mA | 5.209 V | 4.057 mV | 81.1 mA | 447.4 mW | 422.7 mW | 94.5%
4.105 V | 108.1 mA | 5.209 V | 4.053 mV | 81.1 mA | 443.8 mW | 422.2 mW | 95.2%
Voltage In | Current In | Voltage Out | Shunt Out | Current Out | Power In | Power Out | Efficiency
3.268 V | 180.6 mA | 5.205 V | 5.313 mV | 106.3 mA | 590.2 mW | 553.1 mW | 93.7%
3.712 V | 157.7 mA | 5.208 V | 5.320 mV | 106.4 mA | 585.4 mW | 554.1 mW | 94.7%
4.038 V | 144.1 mA | 5.208 V | 5.315 mV | 106.3 mA | 581.9 mW | 553.6 mW | 95.1%
Voltage In | Current In | Voltage Out | Shunt Out | Current Out | Power In | Power Out | Efficiency
3.239 V | 303.7 mA | 5.195 V | 8.876 mV | 177.5 mA | 983.7 mW | 922.2 mW | 93.8%
3.721 V | 263.6 mA | 5.200 V | 8.913 mV | 178.3 mA | 980.9 mW | 927.0 mW | 94.5%
4.084 V | 281.4 mA | 5.196 V | 10.577 mV | 211.5 mA | 1149.2 mW | 1099.2 mW | 95.6%

Sheet: By Input
3.3V In |  | 3.7V In |  | 4.1V In
Load | Efficiency | Load | Efficiency | Load | Efficiency
56.6 mW | 72.1% | 57.0 mW | 72.7% | 56.5 mW | 75.4%
91.7 mW | 71.3% | 91.9 mW | 72.2% | 91.8 mW | 74.2%
202.2 mW | 93.0% | 202.2 mW | 93.8% | 202.2 mW | 94.5%
423.0 mW | 93.6% | 422.7 mW | 94.5% | 422.2 mW | 95.2%
553.1 mW | 93.7% | 554.1 mW | 94.7% | 553.6 mW | 95.1%
922.2 mW | 93.8% | 927.0 mW | 94.5% | 1099.2 mW | 95.6%
