CougsInSpace/CougSat1-Hardware/CougSat1-RadioBoard/Testing/Comms.1.0/3.10/9V - Efficiency.xlsx

Sheet: By Loads
Voltage In | Shunt In | Current In | Voltage Out | Shunt Out | Current Out | Power In | Power Out | Efficiency
3.291 V | 2.055 mV | 41.1 mA | 8.985 V | 0.566 mV | 11.3 mA | 135.3 mW | 101.7 mW | 75.2%
3.691 V | 1.814 mV | 36.3 mA | 8.984 V | 0.567 mV | 11.3 mA | 133.9 mW | 101.9 mW | 76.1%
4.092 V | 1.628 mV | 32.6 mA | 8.984 V | 0.570 mV | 11.4 mA | 133.2 mW | 102.4 mW | 76.9%
Voltage In | Shunt In | Current In | Voltage Out | Shunt Out | Current Out | Power In | Power Out | Efficiency
3.286 V | 3.233 mV | 64.7 mA | 8.985 V | 0.992 mV | 19.8 mA | 212.5 mW | 178.3 mW | 83.9%
3.687 V | 2.877 mV | 57.5 mA | 8.985 V | 0.992 mV | 19.8 mA | 212.1 mW | 178.3 mW | 84.0%
4.089 V | 2.605 mV | 52.1 mA | 8.985 V | 0.991 mV | 19.8 mA | 213.0 mW | 178.1 mW | 83.6%
Voltage In | Shunt In | Current In | Voltage Out | Shunt Out | Current Out | Power In | Power Out | Efficiency
3.292 V | 7.167 mV | 143.3 mA | 8.986 V | 2.366 mV | 47.3 mA | 471.9 mW | 425.2 mW | 90.1%
3.695 V | 6.411 mV | 128.2 mA | 8.986 V | 2.375 mV | 47.5 mA | 473.8 mW | 426.8 mW | 90.1%
4.098 V | 5.752 mV | 115.0 mA | 8.986 V | 2.381 mV | 47.6 mA | 471.4 mW | 427.9 mW | 90.8%
Voltage In | Shunt In | Current In | Voltage Out | Shunt Out | Current Out | Power In | Power Out | Efficiency
3.297 V | 14.08 mV | 281.6 mA | 8.988 V | 4.772 mV | 95.4 mA | 928.4 mW | 857.8 mW | 92.4%
3.703 V | 12.53 mV | 250.6 mA | 8.987 V | 4.780 mV | 95.6 mA | 928.0 mW | 859.2 mW | 92.6%
4.098 V | 11.25 mV | 225.0 mA | 8.987 V | 4.776 mV | 95.5 mA | 922.0 mW | 858.4 mW | 93.1%
Voltage In | Shunt In | Current In | Voltage Out | Shunt Out | Current Out | Power In | Power Out | Efficiency
3.296 V | 22.67 mV | 453.4 mA | 8.990 V | 7.733 mV | 154.7 mA | 1494.4064 mW | 1390.3934 mW | 93.0%
3.696 V | 20.15 mV | 403.0 mA | 8.989 V | 7.754 mV | 155.1 mA | 1489.488 mW | 1394.01412 mW | 93.6%
4.093 V | 18.12 mV | 362.4 mA | 8.988 V | 7.765 mV | 155.3 mA | 1483.3032 mW | 1395.8364 mW | 94.1%
Voltage In | Shunt In | Current In | Voltage Out | Shunt Out | Current Out | Power In | Power Out | Efficiency
3.298 V | 38.65 mV | 773.0 mA | 8.995 V | 13.29 mV | 265.8 mA | 2549.354 mW | 2390.871 mW | 93.8%
3.694 V | 34.42 mV | 688.4 mA | 8.994 V | 13.31 mV | 266.2 mA | 2542.9496 mW | 2394.2028 mW | 94.2%
4.098 V | 30.96 mV | 619.2 mA | 8.992 V | 13.33 mV | 266.6 mA | 2537.4816 mW | 2397.2672 mW | 94.5%

Sheet: By Input
3.3V In |  | 3.7V In |  | 4.1V In
Load | Efficiency | Load | Efficiency | Load | Efficiency
101.7 mW | 75.2% | 101.9 mW | 76.1% | 102.4 mW | 76.9%
178.3 mW | 83.9% | 178.3 mW | 84.0% | 178.1 mW | 83.6%
425.2 mW | 90.1% | 426.8 mW | 90.1% | 427.9 mW | 90.8%
857.8 mW | 92.4% | 859.2 mW | 92.6% | 858.4 mW | 93.1%
1390.4 mW | 93.0% | 1394.0 mW | 93.6% | 1395.8 mW | 94.1%
2390.9 mW | 93.8% | 2394.2 mW | 94.2% | 2397.3 mW | 94.5%
