CougsInSpace/CougSat1-Hardware/CougSat1-PowerBoard/Testing/SolarPanel.2.0/3.2/Efficiency.xlsx

Sheet: By Loads
Shunt Voltage In | Current In | Voltage In | Shunt Voltage Out | Current Out | Voltage Out | Power In | Power Out | Efficiency
48.100 mV | 962.0 mA | 2.500 V | 55.200 mV | 552.0 mA | 3.100 V | 2405.0 mW | 1711.2 mW | 71.15%
61.100 mV | 1222.0 mA | 2.404 V | 65.200 mV | 652.0 mA | 3.200 V | 2937.7 mW | 2086.4 mW | 71.02%
62.100 mV | 1242.0 mA | 2.407 V | 64.200 mV | 642.0 mA | 3.300 V | 2989.5 mW | 2118.6 mW | 70.87%
59.700 mV | 1194.0 mA | 2.411 V | 60.300 mV | 603.0 mA | 3.400 V | 2878.7 mW | 2050.2 mW | 71.22%
25.200 mV | 504.0 mA | 1.988 V | 24.100 mV | 241.0 mA | 3.377 V | 1002.0 mW | 813.9 mW | 81.23%
24.600 mV | 492.0 mA | 2.480 V | 14.600 mV | 146.0 mA | 4.061 V | 1220.2 mW | 592.9 mW | 48.59%
 | 0.0 mA | 2.500 V |  | 0.0 mA |  | 0.0 mW | 0.0 mW | #DIV/0!
 | 0.0 mA | 2.500 V |  | 0.0 mA |  | 0.0 mW | 0.0 mW | #DIV/0!
 | 0.0 mA | 2.500 V |  | 0.0 mA |  | 0.0 mW | 0.0 mW | #DIV/0!

Sheet: By Input
2.5V In
Load | Efficiency
0.000 W | 0.0%
0.000 W | 0.0%
0.000 W | 0.0%
0.000 W | 0.0%
0.000 W | 0.0%
0.000 W | 0.0%
0.000 W | 0.0%
