CougsInSpace/CougSat1-Hardware/CougSat1-PowerBoard/Testing/EPS.2.1/3.8/Efficiency.xlsx

Sheet: By Loads
Voltage In | Shunt In | Current In | Voltage Out | Shunt Out | Current Out | Power In | Power Out | Efficiency
3.042 V | 0.211 mV | 0.01 A | 3.042 V | 0.105 mV | 0.010 A | 0.0321 W | 0.0319 W | 99.5%
3.332 V | 0.242 mV | 0.01 A | 3.317 V | 0.115 mV | 0.011 A | 0.0403 W | 0.0381 W | 94.6%
3.705 V | 0.225 mV | 0.01 A | 3.333 V | 0.110 mV | 0.011 A | 0.0417 W | 0.0367 W | 88.0%
4.015 V | 0.206 mV | 0.01 A | 3.335 V | 0.113 mV | 0.011 A | 0.0414 W | 0.0377 W | 91.1%
Voltage In | Shunt In | Current In | Voltage Out | Shunt Out | Current Out | Power In | Power Out | Efficiency
3.025 V | 2.10 mV | 0.11 A | 3.025 V | 1.03 mV | 0.103 A | 0.318 W | 0.312 W | 98.1%
3.302 V | 2.31 mV | 0.12 A | 3.287 V | 1.12 mV | 0.112 A | 0.381 W | 0.368 W | 96.5%
3.701 V | 2.14 mV | 0.11 A | 3.304 V | 1.13 mV | 0.113 A | 0.396 W | 0.373 W | 94.3%
4.012 V | 1.99 mV | 0.10 A | 3.290 V | 1.13 mV | 0.113 A | 0.399 W | 0.372 W | 93.1%
Voltage In | Shunt In | Current In | Voltage Out | Shunt Out | Current Out | Power In | Power Out | Efficiency
3.006 V | 6.17 mV | 0.31 A | 2.983 V | 3.01 mV | 0.301 A | 0.927 W | 0.898 W | 96.8%
3.357 V | 6.80 mV | 0.34 A | 3.297 V | 3.33 mV | 0.333 A | 1.14 W | 1.10 W | 96.2%
3.754 V | 6.22 mV | 0.31 A | 3.293 V | 3.32 mV | 0.332 A | 1.17 W | 1.09 W | 93.6%
3.989 V | 5.93 mV | 0.30 A | 3.296 V | 3.35 mV | 0.335 A | 1.18 W | 1.10 W | 93.4%
Voltage In | Shunt In | Current In | Voltage Out | Shunt Out | Current Out | Power In | Power Out | Efficiency
3.055 V | 12.4 mV | 0.62 A | 3.012 V | 6.06 mV | 0.61 A | 1.89 W | 1.83 W | 96.4%
3.297 V | 13.4 mV | 0.67 A | 3.246 V | 6.54 mV | 0.65 A | 2.21 W | 2.12 W | 96.1%
3.751 V | 12.3 mV | 0.61 A | 3.274 V | 6.60 mV | 0.66 A | 2.31 W | 2.16 W | 93.7%
4.003 V | 11.7 mV | 0.58 A | 3.276 V | 6.64 mV | 0.66 A | 2.34 W | 2.18 W | 92.9%
Voltage In | Shunt In | Current In | Voltage Out | Shunt Out | Current Out | Power In | Power Out | Efficiency
2.995 V | 18.0 mV | 0.90 A | 2.933 V | 8.80 mV | 0.88 A | 2.70 W | 2.58 W | 95.8%
3.335 V | 20.1 mV | 1.01 A | 3.265 V | 9.77 mV | 0.98 A | 3.35 W | 3.19 W | 95.2%
3.710 V | 18.5 mV | 0.93 A | 3.263 V | 9.78 mV | 0.98 A | 3.43 W | 3.19 W | 93.0%
3.986 V | 17.5 mV | 0.88 A | 3.272 V | 9.88 mV | 0.99 A | 3.49 W | 3.23 W | 92.7%
Voltage In | Shunt In | Current In | Voltage Out | Shunt Out | Current Out | Power In | Power Out | Efficiency
2.950 V | 28.0 mV | 1.40 A | 2.853 V | 13.7 mV | 1.37 A | 4.13 W | 3.91 W | 94.6%
3.272 V | 31.0 mV | 1.55 A | 3.156 V | 15.1 mV | 1.51 A | 5.07 W | 4.77 W | 94.0%
3.674 V | 29.8 mV | 1.49 A | 3.255 V | 15.6 mV | 1.56 A | 5.47 W | 5.08 W | 92.8%
3.936 V | 28.3 mV | 1.42 A | 3.260 V | 15.7 mV | 1.57 A | 5.57 W | 5.12 W | 91.9%
Voltage In | Shunt In | Current In | Voltage Out | Shunt Out | Current Out | Power In | Power Out | Efficiency
2.890 V | 43.1 mV | 2.16 A | 2.733 V | 21.0 mV | 2.10 A | 6.23 W | 5.74 W | 92.2%
3.296 V | 49.0 mV | 2.45 A | 3.123 V | 23.9 mV | 2.39 A | 8.08 W | 7.46 W | 92.4%
3.596 V | 49.4 mV | 2.47 A | 3.239 V | 25.0 mV | 2.50 A | 8.88 W | 8.10 W | 91.2%
3.951 V | 46.0 mV | 2.30 A | 3.241 V | 25.1 mV | 2.51 A | 9.09 W | 8.13 W | 89.5%

Sheet: By Input
3.0V In |  | 3.3V In |  | 3.7V In |  | 4.1V In
Load | Efficiency | Load | Efficiency | Load | Efficiency | Load | Efficiency
0.032 W | 99.5% | 0.038 W | 94.6% | 0.037 W | 88.0% | 0.038 W | 91.1%
0.312 W | 98.1% | 0.368 W | 96.5% | 0.373 W | 94.3% | 0.372 W | 93.1%
0.898 W | 96.8% | 1.098 W | 96.2% | 1.093 W | 93.6% | 1.104 W | 93.4%
1.825 W | 96.4% | 2.123 W | 96.1% | 2.161 W | 93.7% | 2.175 W | 92.9%
2.581 W | 95.8% | 3.190 W | 95.2% | 3.191 W | 93.0% | 3.233 W | 92.7%
3.909 W | 94.6% | 4.766 W | 94.0% | 5.078 W | 92.8% | 5.118 W | 91.9%
5.739 W | 92.2% | 7.464 W | 92.4% | 8.098 W | 91.2% | 8.135 W | 89.5%
