CougsInSpace/CougSat1-Hardware/CougSat1-PowerBoard/Testing/EPS.2.1/3.8/RegulatorA-10kHz.csv

-5.28E-02
5.28E-02
5.12E-02
-5.52E-02
5.12E-02
-5.36E-02
-5.28E-02
5.20E-02
-5.28E-02
5.28E-02
5.36E-02
-5.36E-02
-5.44E-02
5.36E-02
-5.44E-02
5.36E-02
-5.36E-02
5.44E-02
-5.36E-02
5.44E-02
-5.28E-02
5.04E-02
-5.36E-02
5.20E-02
5.12E-02
-5.28E-02
5.12E-02
-5.36E-02
5.12E-02
-5.36E-02
-5.52E-02
5.12E-02
-5.36E-02
5.44E-02
-5.28E-02
5.28E-02
5.12E-02
-5.36E-02
-5.36E-02
5.12E-02
-5.36E-02
5.12E-02
-5.28E-02
5.28E-02
-5.28E-02
5.28E-02
-5.28E-02
5.12E-02
5.12E-02
-5.36E-02
5.44E-02
-5.28E-02
-5.28E-02
5.28E-02
5.12E-02
-5.36E-02
5.12E-02
-5.28E-02
5.28E-02
-5.36E-02
-5.44E-02
5.12E-02
-5.28E-02
5.28E-02
-5.28E-02
5.28E-02
5.28E-02
-5.28E-02
-5.20E-02
5.52E-02
-5.28E-02
5.44E-02
5.52E-02
-5.36E-02
5.12E-02
-5.28E-02
5.52E-02
-5.36E-02
5.44E-02
-5.12E-02
-5.12E-02
5.36E-02
5.28E-02
-5.36E-02
-5.28E-02
5.20E-02
-5.28E-02
5.44E-02
5.44E-02
-5.20E-02
-5.20E-02
5.28E-02
-5.28E-02
5.28E-02
-5.20E-02
5.44E-02
-5.20E-02
5.28E-02
-5.28E-02
5.44E-02
-5.44E-02
5.36E-02
-5.20E-02
5.28E-02
5.36E-02
-5.28E-02
5.28E-02
-5.28E-02
5.12E-02
-5.28E-02
-5.28E-02
5.52E-02
5.28E-02
-5.36E-02
5.52E-02
-5.28E-02
5.52E-02
-5.28E-02
5.28E-02
-5.20E-02
-5.20E-02
5.44E-02
-5.36E-02
5.28E-02
5.44E-02
-5.36E-02
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
