CougsInSpace/CougSat1-Hardware/CougSat1-PowerBoard/Testing/EPS.2.1/3.7/VBATT-A Short Circuit - Applied.png

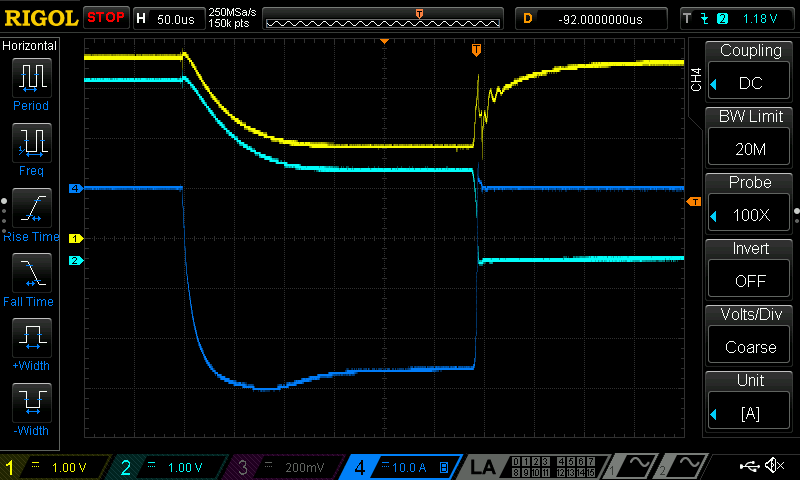
CougSat1-PowerBoard/Testing/EPS.2.1/3.7/VBATT-A Short Circuit - Applied.png
