CougsInSpace/CougSat1-Hardware/CougSat1-PowerBoard/Testing/EPS.2.1/3.9/VBATT-A 10µF.png

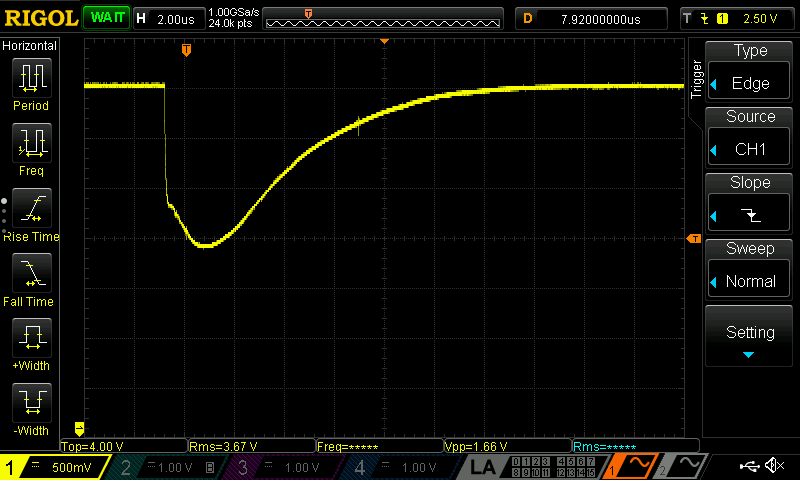
CougSat1-PowerBoard/Testing/EPS.2.1/3.9/VBATT-A 10µF.png
