CougsInSpace/CougSat1-Hardware/CougSat1-PowerBoard/Testing/EPS.2.1/3.10/3.3V-B 1A Short Removed.png

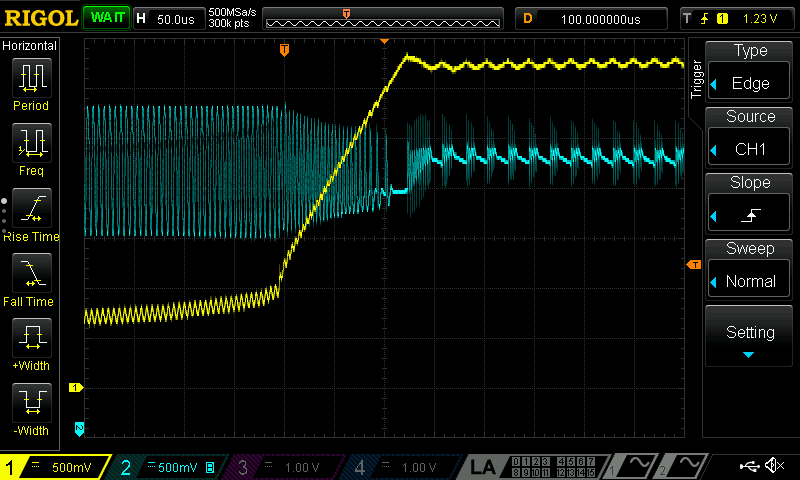
CougSat1-PowerBoard/Testing/EPS.2.1/3.10/3.3V-B 1A Short Removed.png
