CougsInSpace/CougSat1-Hardware/CougSat1-PowerBoard/Testing/EPS.3.0/3.2/Insertion and removal.png

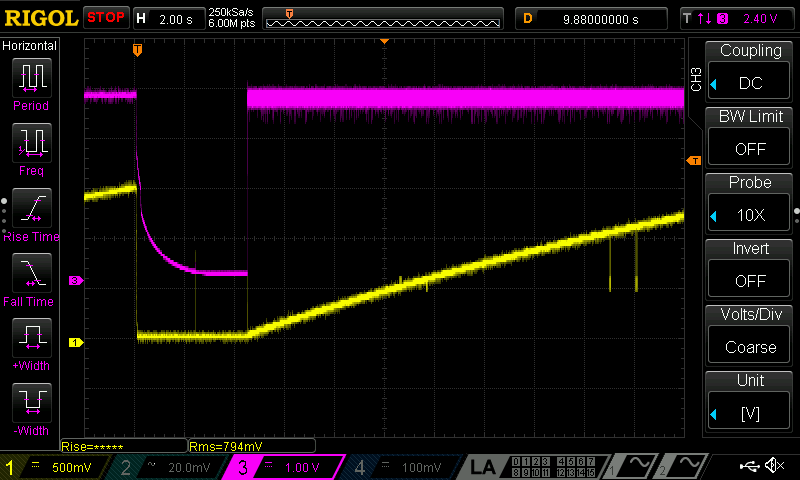
CougSat1-PowerBoard/Testing/EPS.3.0/3.2/Insertion and removal.png
