CougsInSpace/CougSat1-Hardware/CougSat1-PowerBoard/Testing/EPS.3.0/3.7/OCC-B-Applied.png

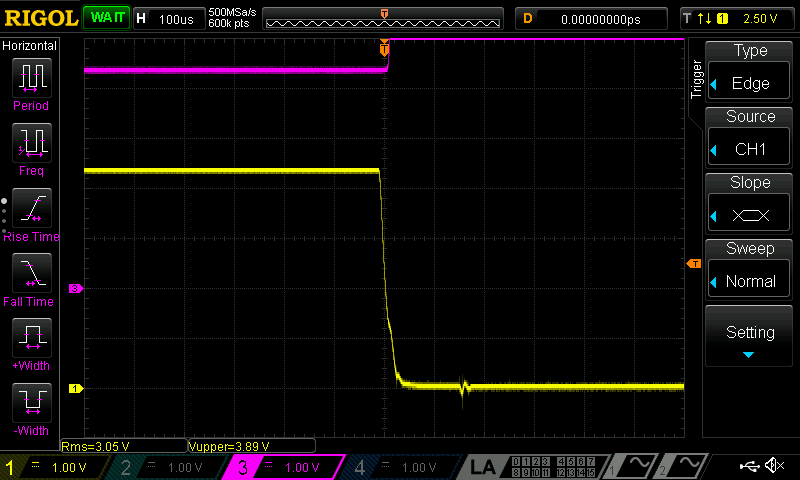
CougSat1-PowerBoard/Testing/EPS.3.0/3.7/OCC-B-Applied.png
