CougsInSpace/CougSat1-Hardware/CougSat1-PowerBoard/Testing/EPS.3.0/3.7/SCD-A-Removed.png

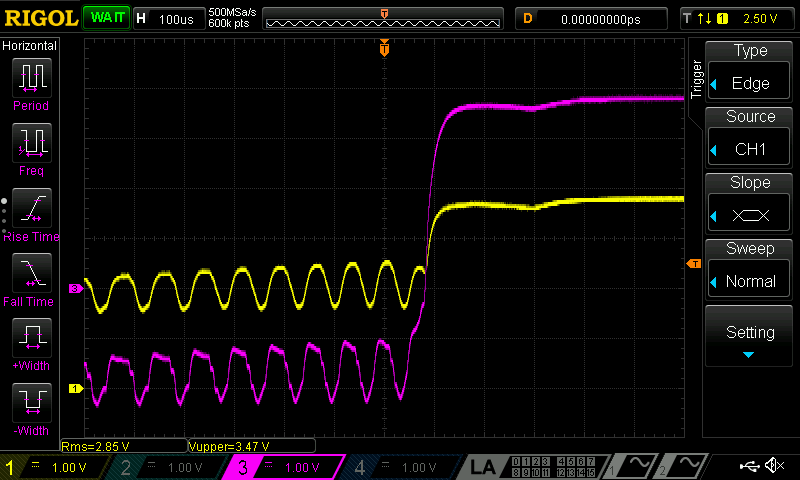
CougSat1-PowerBoard/Testing/EPS.3.0/3.7/SCD-A-Removed.png
