CougsInSpace/CougSat1-Hardware/CougSat1-PowerBoard/Testing/EPS.3.0/3.8/A - Ripple.png

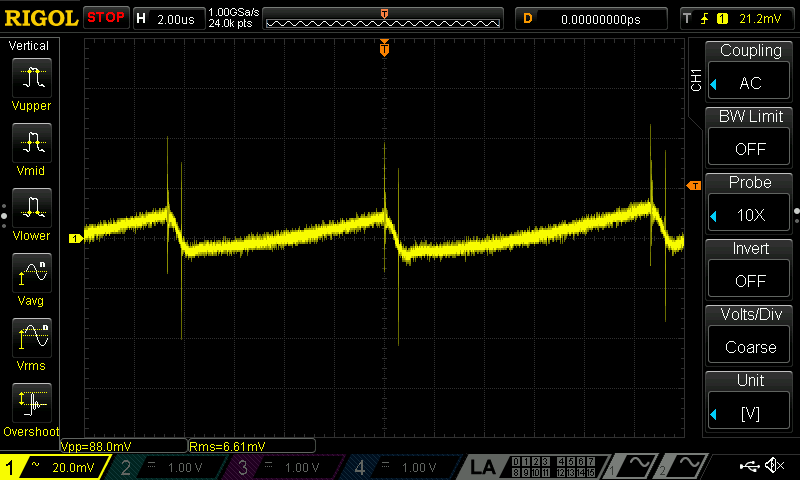
CougSat1-PowerBoard/Testing/EPS.3.0/3.8/A - Ripple.png
