CougsInSpace/CougSat1-Hardware/CougSat1-PowerBoard/Testing/EPS.3.0/3.9/A - 1A Removed.png

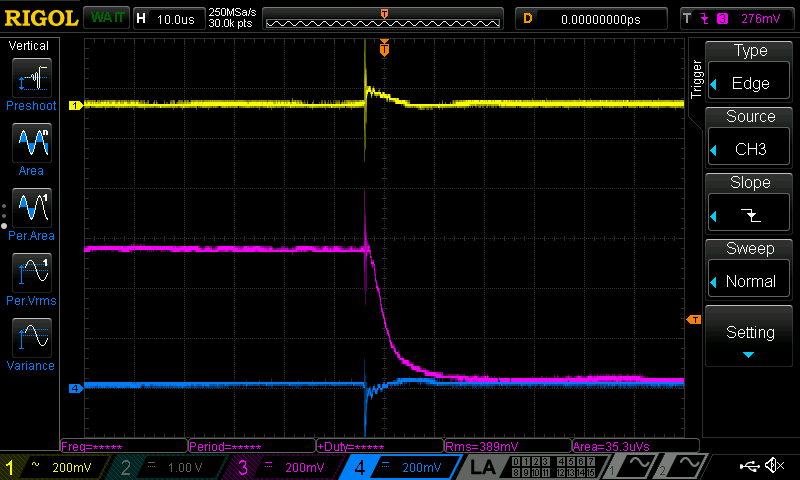
CougSat1-PowerBoard/Testing/EPS.3.0/3.9/A - 1A Removed.png
