CougsInSpace/CougSat1-Hardware/CougSat1-PowerBoard/Testing/EPS.3.0/3.10/A - 1A 10µF MLCC.png

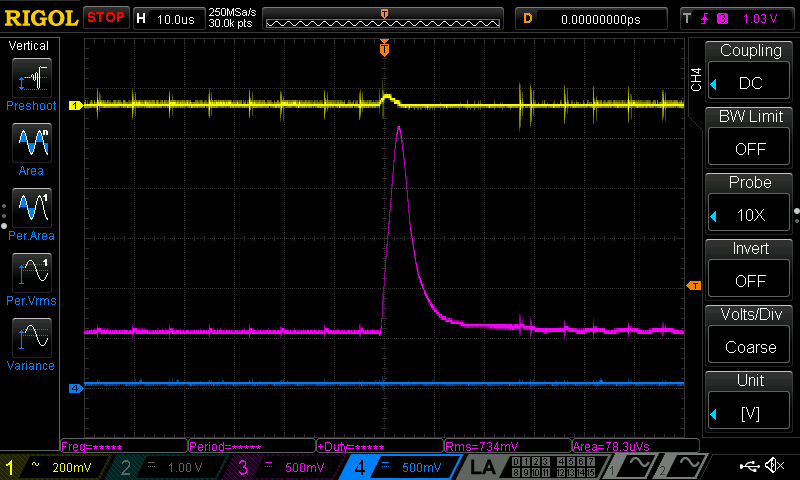
CougSat1-PowerBoard/Testing/EPS.3.0/3.10/A - 1A 10µF MLCC.png
