CougsInSpace/CougSat1-Hardware/CougSat1-PowerBoard/Testing/EPS.3.0/3.10/A - Short Continuous.png

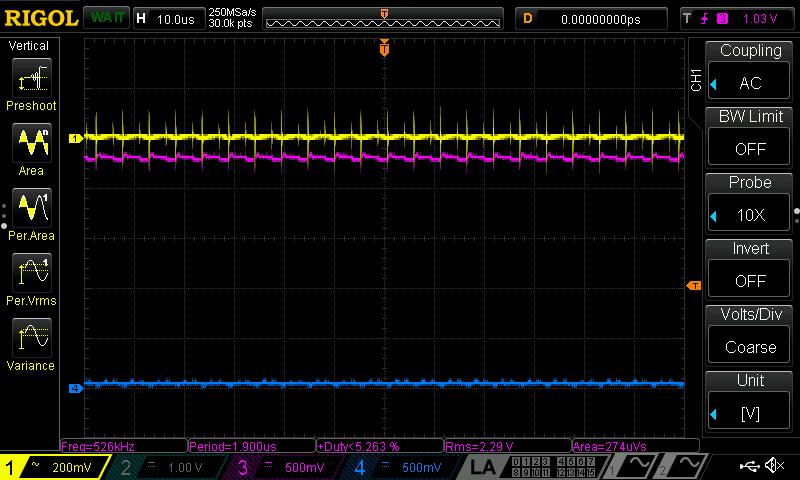
CougSat1-PowerBoard/Testing/EPS.3.0/3.10/A - Short Continuous.png
