CougsInSpace/CougSat1-Hardware/CougSat1-PowerBoard/Testing/EPS.3.0/3.10/B - 1A Short Removed.png

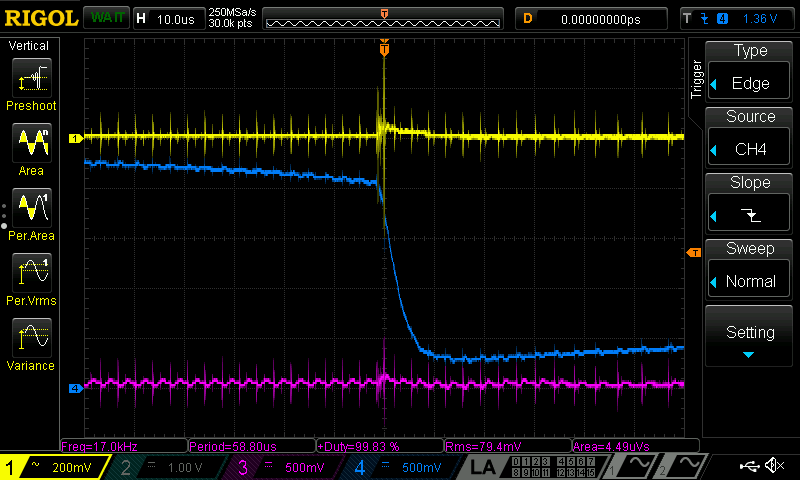
CougSat1-PowerBoard/Testing/EPS.3.0/3.10/B - 1A Short Removed.png
