CougsInSpace/CougSat1-Hardware/CougSat1-PowerBoard/Testing/EPS.3.0/3.10/B - Short Applied.png

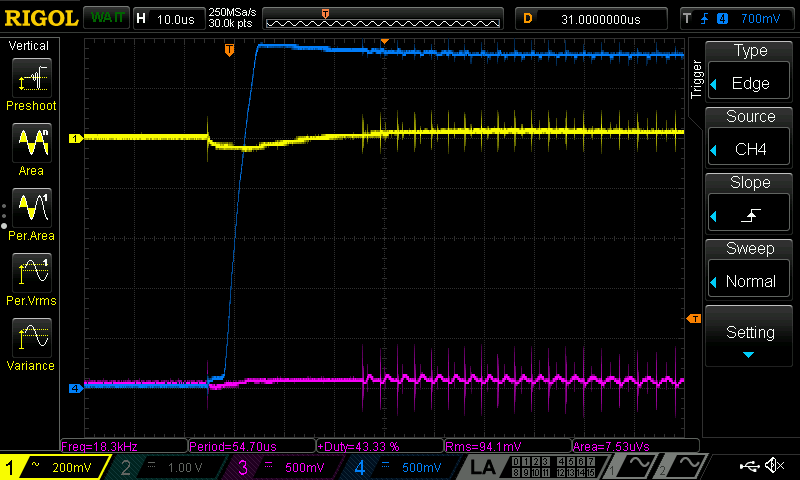
CougSat1-PowerBoard/Testing/EPS.3.0/3.10/B - Short Applied.png
