CougsInSpace/CougSat1-Hardware/CougSat1-PowerBoard/Testing/EPS.3.0/3.11/I2C.png

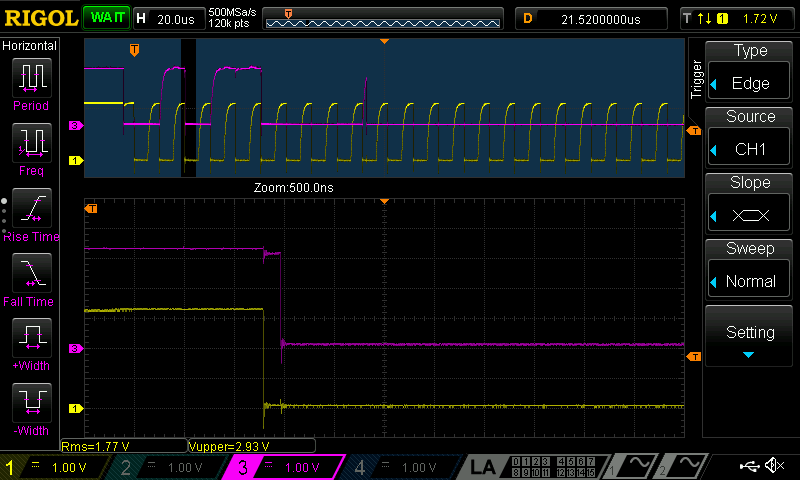
CougSat1-PowerBoard/Testing/EPS.3.0/3.11/I2C.png
