CougsInSpace/CougSat1-Hardware/CougSat1-RadioBoard/Testing/Comms.1.0/3.3/I2C.png

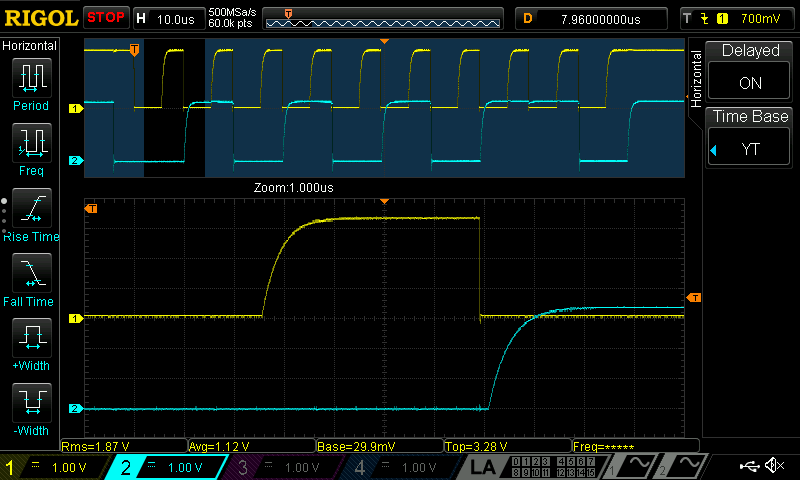
CougSat1-RadioBoard/Testing/Comms.1.0/3.3/I2C.png
