CougsInSpace/CougSat1-Hardware/CougSat1-RadioBoard/Testing/Comms.1.0/3.10/5V - Short Continuous.png

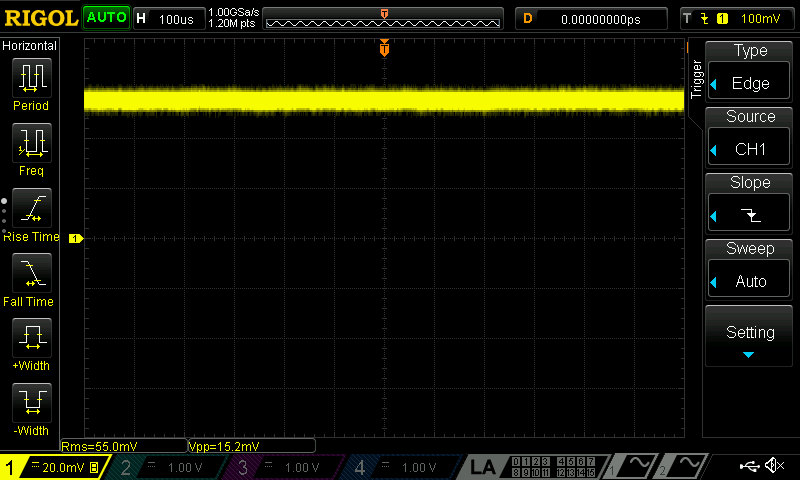
CougSat1-RadioBoard/Testing/Comms.1.0/3.10/5V - Short Continuous.png
