CougsInSpace/CougSat1-Hardware/CougSat1-RadioBoard/Testing/Comms.1.0/3.10/9V - 10µF.png

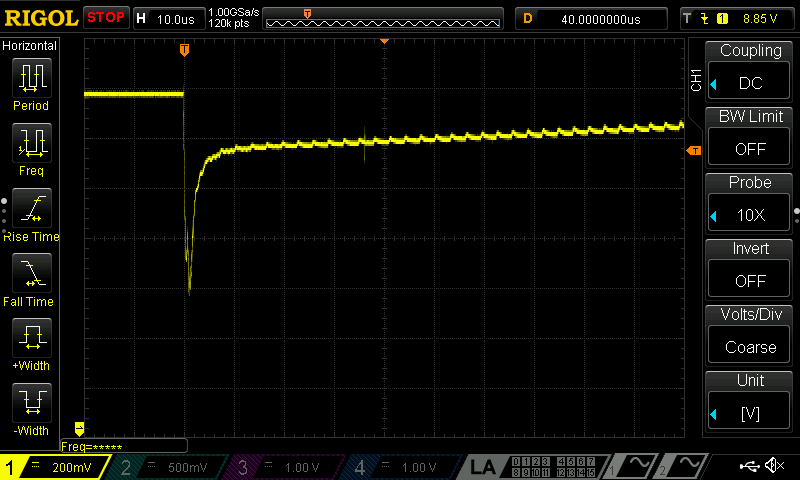
CougSat1-RadioBoard/Testing/Comms.1.0/3.10/9V - 10µF.png
