CougsInSpace/CougSat1-Hardware/CougSat1-RadioBoard/Testing/Comms.1.0/3.13/MOD_230_ID.png

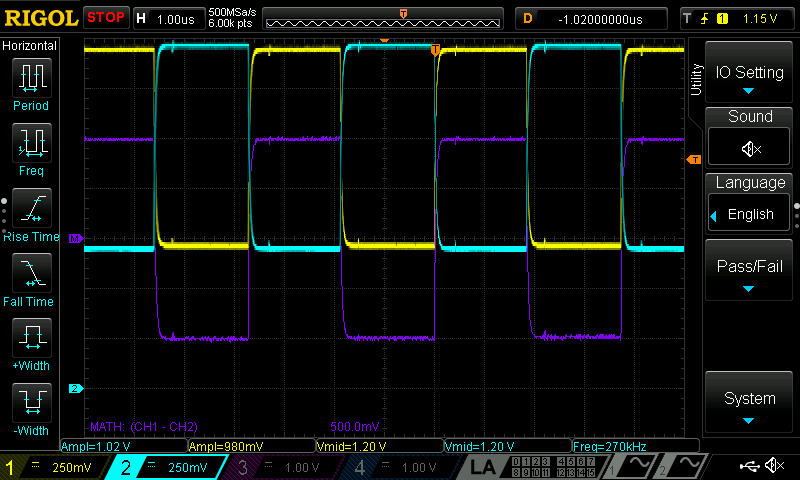
CougSat1-RadioBoard/Testing/Comms.1.0/3.13/MOD_230_ID.png
