CougsInSpace/CougSat1-Hardware/CougSat1-RadioBoard/Testing/Comms.1.0/3.14/230mm.png

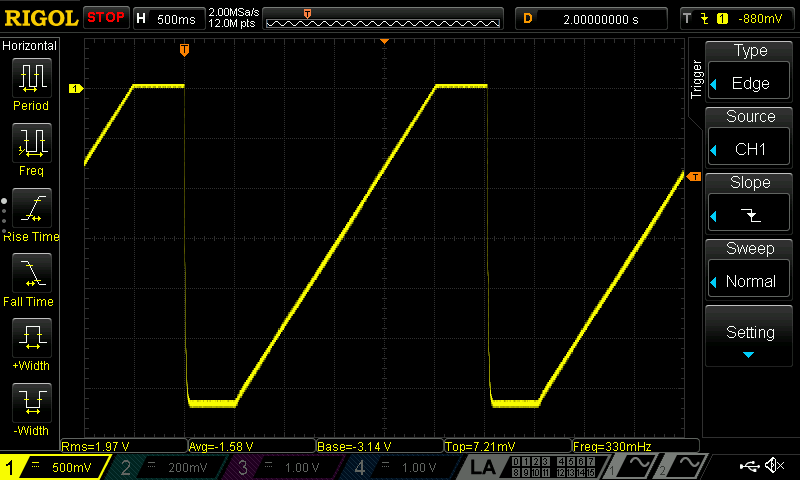
CougSat1-RadioBoard/Testing/Comms.1.0/3.14/230mm.png
