CougsInSpace/CougSat1-Hardware/(threads)

Thread 1 (2018-04-08):

EPS: Test basic solar panel function

reidcol12, 2018-04-08:
Test current voltage output of solar cell

WattsUp, 2018-07-22:
Solar cells output 2.45Voc and 25mAsc under our grow light
Voltages of 2.7 have been recorded under the real sun through the window
Currents of 80mA have been recorded under the real sun through the window
Our SpectroLabs contact confirmed we will not see the rated 400mA without being in orbit or under an artifical sun with AM0 spectrum.

Closed 2018-07-22.

Thread 11 (2018-04-12):

Order Germination Enclosure Parts for Prototyping

colinwarn, 2018-04-12:
**To Buy:**
-Srynge. Hydrophonics gel
-CO2 Sensor. DigiKey B
-Aluminum.
-Aluminized Mylar (buy)
-Blue and red LEDS. Small ones B.
-Electrical connection restrictions to the CO2 sensor. Limitations on how they’re connection.
-Pass through. Hit up Greg
-Camera (Bradley)
-Nutrient substraites (cotton balls, plant vitamins), Lady May have some
-Pressure sensor
-Heating resistor
-Temperature.

Closed 2018-06-24.

Thread 12 (2018-04-12):

Integrate Germination Chamber into CubeSat (due end of October)

colinwarn, 2018-04-12:
As stated above.  This includes:

-Mounting all of the following components:
- -Deployment System
- -CO2 Sensor
- -Blue and red LEDS. Small ones B.
- -Pass through.
- -Camera
- -Nutrient substrates (cotton balls, plant vitamins),
- -Pressure sensor
- -Heating resistor
- -Temperature.

-Place gasket
-Leak Test
-Attaching the enclosure to the Cubesat.
-Wiring the components to systems
-Programming the components

Most up to date design review reference document:
https://docs.google.com/document/d/1KBFZvgP-oryENmhXvi5IniEUsiZV1cuqhVG-OTOQ64g/edit

colinwarn, 2021-09-05:
Redundant.

Closed 2021-09-05.

Thread 14 (2018-04-12):

Get Vibration Testing Equipment and Facility

colinwarn, 2018-04-12:
-Find/obtain equipment to run vibration tests on.
-Find piezoelectric accelerometers to use
-Create mounting board

Closed 2018-06-24.

Thread 15 (2018-04-12):

Machine Cougsat-I Prototype I

colinwarn, 2018-04-12:
-Determine whether we can mill it in-house or whether we'll have to mill it in a local shop.
-Mill two side panels, a front plane and the top/bottom mounts.

WattsUp, 2018-07-20:
This was completed with the fabrication of the model for the aerospace launch

Closed 2018-07-20.

Thread 2 (2018-04-12):

AVIONICS: Test GPS Reciever

WattsUp, 2018-04-12:

WattsUp, 2018-05-29:
The GPS got a lock once the antenna was placed on the board. I assume the board was acting as a ground plane for the antenna. The board with the antenna will need to act in this way as well
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

Closed 2018-05-29.

Thread 20 (2018-04-22):

Research Thermal Expansion of PCBs

WattsUp, 2018-04-22:

WattsUp, 2018-07-06:
FR4 vs the copper vs the solder vs the components
Large components could have the leads torn/stressed off with differential expansion

mvguerrero, 2018-10-24:
(The research gathered from the 21st is included in the new slack channel "ec-research" and is available for any to observe)
In conclusion, the heating and cooling of the satellite will fatigue the components of the PCB's. If we want to determine more specific information about parts we are worried about, we need to find the exact material properties of each PCB element , and the exact physical arrangement of the components in question.
Once we create a baseline for temperature ranges the interior of the satellite reaches we can find the stress developed from differences of thermal expansion. Once our equations of interior temperatures are established we can better predict the extent that this phenomenon would be a problem with our current arrangements of PCB's
 An issue for next sprint would be to use this research to determine which components are at the most risk, and determine from their physical arrangement if the part experiences forces outside the fatigue limit, and if not or how many cycles it would take to reach that limit and fail.

Closed 2018-10-24.

Thread 21 (2018-04-22):

Backplane Board Updates

colinwarn, 2018-04-22:
Bradley has informed us that we get full reign to move the holes as we see fit.  Let's not make their job too hard now.

We'll also have to figure out how to mount a solar panel as well as a mangetorquer on the back of it.

Closed 2018-06-24.

Thread 27 (2018-04-29):

STRUCT - Fitting components (end of summer)

colinwarn, 2018-04-29:
o	Get attitude’s final mounting mechanism (end of summer)
o	Get attitude’s prototyped mounting mechanism (end of May)
o	Get power’s final board dimensions (end of summer)
o	Send power backplane board dimensions (end of May) – Colin

Closed 2018-07-25.

Thread 31 (2018-04-29):

PAYLOAD - Solidworks Analysis of payload vibration-pressure testing (end of June)

colinwarn, 2018-04-29:
Test the leakrate of payload when under GEVS-7000 Acceptance testing levels.

Thread 33 (2018-04-29):

Physical Analysis of vibration-pressure leak testing (mid July)

colinwarn, 2018-04-29:

Thread 35 (2018-04-30):

Early stage vibration analysis guide (June 15th)

colinwarn, 2018-04-30:
[general process, not necessarily step by step details]

Closed 2018-06-24.

Thread 39 (2018-04-30):

Model Mk1 components (end of May)

colinwarn, 2018-04-30:
To model:
Boards
Batteries
Magnetorquers x3
Insulation
Payload
Cameras/Lasers
Solar Panels

Closed 2018-06-25.

Thread 40 (2018-04-30):

STRUCT - Assemble Mk2 components (end of August)

colinwarn, 2018-04-30:
Model and assemble components for the final CougSat iteration.

WattsUp, 2018-07-20:
Duplicate of #98

Abandoning this issue

Closed 2018-07-20.

Thread 51 (2018-05-06):

Integrate Camera (May 21st)

colinwarn, 2018-05-06:
Determine which camera we'll be using for our germination enclosure.

Determine how we'll mount said camera.

Closed 2018-06-24.

Thread 52 (2018-05-09):

Test MPPT Charger in CC/CV Mode

reidcol12, 2018-05-09:
Ensure that the MPPT circuit on the power board can successfully charge a Lithium-ion battery starting in constant current mode and moving to constant voltage mode.

Thread 53 (2018-05-09):

Test/Verify Battery Protection Circuit on Powerboard (due May 13th)

reidcol12, 2018-05-09:
Verify that the battery protection IC on the powerboard does protect the battery for the expected conditions.

WattsUp, 2018-05-16:
Over voltage protection: PASS 4.25V
Under voltage protection: PASS 2.8V
Short circuit protection: PASS, re-enables after charger (solar) is on
Over current protection: Probably PASS, cannot test without large load resistors but SCP works and they use the same mechanism

Closed 2018-05-16.

Thread 56 (2018-05-10):

Make a List of All Components That Need to Be Modeled, and Where They'll Be Placed (May 31st)

colinwarn, 2018-05-10:
4-6 10g PCB boards
Backplane
Magnetorquers x3
Batteries x2
Insulation
Payload
A camera (on top of the one in payload) and a laser
Solar panels
Separation switch

Closed 2018-06-24.

Thread 61 (2018-05-17):

EPS: Define Solar Panel ⇄ EPS Hardware Interface

WattsUp, 2018-05-17:

WattsUp, 2018-07-19:
9 Conductors:

1. 3.3V for measurement ICs
2. I²C SDA
3. I²C SCL
4. PV_IN-A
5. PV_IN-B
6. PGND
7. PGND
8. Magnetorquer +
9. Magnetorquer -

Closed 2018-07-19.

Thread 63 (2018-05-17):

EPS: Draw Solar Panel Board Outline V2.0

WattsUp, 2018-05-17:

WattsUp, 2018-07-13:
The solar panels on +Z, -X, AND (-Y OR +Y) will have magnetorquers underneath them. Work with #277

WattsUp, 2018-10-24:
[SolarPanel_PCB.pdf](https://github.com/CougsInSpace/CougSat1-Hardware/files/2508588/SolarPanel_PCB.pdf)
Greg has approved this design

Closed 2018-10-24.

Thread 80 (2018-05-17):

EPS: Test Power Channel Control V2.1

WattsUp, 2018-05-17:

WattsUp, 2019-04-03:
Test results: Fail
See report for more details

Closed 2019-04-03.

Thread 82 (2018-05-17):

EPS: Test ADCs V2.1

WattsUp, 2018-05-17:

WattsUp, 2019-05-20:
The EPS's current ADCs short their inputs when off, test the solar panel or comms and implement that circuit

Closed 2019-05-20.

Thread 83 (2018-05-20):

EPS: Remove VRefCurrent Divider

WattsUp, 2018-05-20:
ADCs only work with 0.7V across Vref. Remove the divider so the VRef IC's output of 1.024V is directly across the ADC's Vref

Closed 2018-07-27.

Thread 93 (2018-05-30):

THERMAL - Thermal Simulation Contraption (due end of July)

colinwarn, 2018-05-30:
Create a contraption that roughly simulates the thermal environment our Cubesat will be in:  Allowing us to  test the payload's environmental control system.

mvguerrero, 2018-06-10:
Looks like we will get the chance to use a real metal model in this case. Greg commented that the rates would be the same, but the internal temperatures may differ since it's a simpler model.

Closed 2018-06-30.

Thread 94 (2018-05-30):

ENVIRONMENTAL CONTROL - Bakeout Testing With Respect to Payload

colinwarn, 2018-05-30:
We are currently planning to germinate either corn, wheat or peas:  Each of which can survive between 0 and 38 degrees Celsius optimally.  Given our satellite has to go through thermal vacuum testing, we need thermal to check to see if this testing could potentially kill out seeds: And if so whether we can get a waiver or how we can make sure our seeds survive said testing.

mvguerrero, 2018-08-02:
[627972main_LSP-REQ-317_01A.pdf](https://github.com/CougsInSpace/CougSat1-Hardware/files/2251821/627972main_LSP-REQ-317_01A.pdf)
 Kevin found this about Bakeout Testing

daelinmalizia, 2018-08-02:
We also have a CAD thermal simulation currently in progress. We had some software issues, but now we need to update it to account for radiation.

mvguerrero, 2018-08-28:
We are encountering an issue where as we add more simulated insulation, the internal equilibrium temperature would rise compared to having none. We are unsure if this phenomenon is based in reality or an issue with the simulation.

mvguerrero, 2018-09-02:
This is information from Levi:
Currently the thermal study is defined as follows, with "bonding" contact sets between the Kapton layers, as well as radiative surfaces defined. Currently the simulation results don't indicate that temperature drops very much. This is probably a fault within the definitions of the simulation and will need to be tried with several differing initial settings as well as try to compare with other similar thermal studies found online. Biggest roadblocks thus far are (1) trying to accurately define the initial settings and (2)  making sure the simulation results are in line with real world experiments.
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

mvguerrero, 2019-09-15:
MICROTASK: Research Bakeout procedure and  post the conditions of the test. These conditions are used in simulation of the test

mvguerrero, 2019-09-15:
MICROTASK: Use the Grabcad Payload chamber, or its analogue in a thermal simulation which is like the bake out procedure, and list results.

mvguerrero, 2019-09-15:
MICROTASK: Create bakeout test thermal simulation with Bus (satellite body) surface, and list results

mvguerrero, 2019-09-15:
MICROTASK: Combine the bakeout tests together using superposition and list results.

mvguerrero, 2019-09-29:
With the news that NANORACKS does not require a bakeout test to be performed for our hardware to launch. Since Cougsat 1 will ride in a pressurized container alongside ISS supplies, the container will not experience outgassing conditions. Therefore, the extreme temperatures we were concerned about the seeds facing in a bakeout test will no longer be an issue.

Closed 2019-09-29.

Thread 97 (2018-05-30):

STRUCT- Machine Mounting Mechanism for Connector (due end of July)

colinwarn, 2018-05-30:
Machine mounting mechanism for this part to Bradley's board.
Part model can be found on the GrabCad under Components -> PowerBoard -> PinHolder

colinwarn, 2018-07-05:
Abandoned due to the connector already having a mounting mechanism.

Closed 2018-07-05.

Thread 98 (2018-05-31):

STRUCT - Initial Assembly of Components (due end of September)

colinwarn, 2018-05-31:
Assemble all of the components for the CougSat-I MK2 launch.  **Note**: Disregard integrating the laser for now.

Use this guide to determine where to locate the components:
https://drive.google.com/open?id=1dSMHhPlmZaIyFk8FEH8SmxUpdRj2TDZR

All the components can be found in the component folder on our GrabCad:
https://workbench.grabcad.com/workbench/projects/gcZyVL8e3jBFst25EMOCFOSOSSCCtw5Og6qSO3SCIElLVA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

Use the MKV2 Version of the satellite.  Also include the Chamber MK1 version.

To Do:
Go through components and use feature recognition. See how complicated it makes the model. If it's too complicated, model by hand. Hand weigh part. Know what material it's made out of. Moment of inertia.
Get for each part:
-Weight
-Moment of intertia
-Center of Mass

Closed 2018-09-02.

Thread 100 (2018-06-05):

STRUCT - Create a Metal Model of the Germination Chamber (end of October)

colinwarn, 2018-06-05:
Create a simplified payload chamber that we can send to get manufacture out of aluminum:  Allowing thermal to start testing said chamber.

colinwarn, 2021-09-05:
Prototyped model was machined around a year ago. Final model is being machined as we speak.

Closed 2021-09-05.

Thread 103 (2018-06-05):

STRUCT - Create Hole and Mounting Mechanism for EPS HR10 (due end of June)

colinwarn, 2018-06-05:
Create a hole and a mounting mechanism for the HR10 to our front plane.  The required hole dimensions can be found on the last page of this document, we are working with a size 7:
https://media.digikey.com/pdf/Data%20Sheets/Hirose%20PDFs/HR10_Rev2010.pdf

The part in question can be found on grabcad in CougSatI-> Components -> Powerboard -> Powerboard2.1.1.stp

colinwarn, 2018-07-13:
Redundant as this is already one requirement for the completion of the frontplane design.

Closed 2018-07-13.

Thread 99 (2018-06-05):

STRUCT - Create a Very Simplified Metal Model for Thermal (due end of June)

colinwarn, 2018-06-05:
Create a simplified metal model for thermal using the average wall thickness.  If we want to manufacture it ourselves, rails can be 6.35mm if need be so we can use .25" aluminum stock material.

Closed 2018-07-13.

Thread 105 (2018-06-06):

THERMAL- Integrate a new or current battery in the Temperature reading Aurdino Uno Board.

mvguerrero, 2018-06-06:
Discover and order a battery for the temperature sensor OR rig the current battery meant for the Adafruit to work for the Uno board.

The Adafruit battery has a voltage of 3.7 volts, and 5 volts can be found printed on the Uno board.

Run any orders by Mario Guerrero first, and I will let Matt know through the official form.

If you inform the assembler with specific instructions to integrate the board but you can't be here to do it, Mario can assign you to the task to get credit.

mvguerrero, 2018-08-26:
Alex and Levi suggested to use the existing 9 volt connector on the microcontroller board with the appropriate 9 volt battery adapter.

Levi suggested to use the 9 volt connector since it is much more compact. He demonstrated that unless mounted diagonally it would not fit within the metal model which Structures had created.

Mario added that the 9 volt battery will allow good power storage capacity, as well as a replaceable and generic power source. This is ideal for testing, as the setup can easily be replicated in case of failure.

Alex volunteered his own Arduino connector and battery for the team to use for now, and additional connectors and batteries are on the way. He had tested this method on his own setup, and it had worked with a nearly identical board.

Closed 2018-08-26.

Thread 106 (2018-06-06):

THERMAL- Program or use software capable of helping interpret Arduino data

mvguerrero, 2018-06-06:
Find a way to read the SD card text file in Excell or Matlab, and plot it.
 Stretch goals: Find maxes, mins, and slope of the data.

mvguerrero, 2018-06-10:
If you would like to work on this project, I  will attach an example of the SD card output to this comment for you to use.

mvguerrero, 2018-08-26:
Alex Lambert approached this problem through Excell , and successfully created a plot from the data stored in the text file. He is now working on a way to make it more friendly to excell. But for now we can use what he created.
-Mario Guerrero

Closed 2018-08-26.

Thread 108 (2018-06-06):

THERMAL- Get GrabCAD accounts and Link it to The CIS Group. Solidworks Download Optional

mvguerrero, 2018-06-06:
Download Solidworks and get a grabcad account. Aaron can link you to the grabcad once you make an account.

If you don't have access to a computer which can run solidworks, let me know below as well. You can still get access to the Grabcad, and be ready once you are back at Voiland and have access to the Computer/CAD lab.

Post your progress below, and the issue will close when everyone has an account.

mvguerrero, 2018-06-17:
I have a linked grabcad account, but not solidworks yet. I will work on getting Solidworks.

WattsUp, 2018-06-24:
Add this information to a formal document or just Slack not an issue

Abandoning this issue

Closed 2018-06-24.

Thread 109 (2018-06-06):

THERMAL- Learn the basics of Aurdino assembly and programming

mvguerrero, 2018-06-06:
Alex has taken the task of becoming familiar with the creation of useful micro controller based gadgets.

He has bought a kit with the requisite parts and instructions to gain this capability.
Please tell me your github name so I can give you credit Alex

WattsUp, 2018-07-20:
Not directly related to CougSat-1. Not an issue

Abandoning this issue.

Closed 2018-07-20.

Thread 110 (2018-06-06):

THERMAL- Live Documentation Zone

mvguerrero, 2018-06-06:
Mario will post the current Thermal Team documentation he has created here.
Feel free to comment so I can improve it!
-Mario

mvguerrero, 2018-06-17:
[Thermal Team Documentation V1.docx](https://github.com/CougsInSpace/CougSat1-Hardware/files/2109388/Thermal.Team.Documentation.V1.docx)

WattsUp, 2018-06-23:
Either put documentation in the repository or the Google Drive

Closing this issue

Closed 2018-06-23.

Thread 112 (2018-06-06):

THERMAL- Math Based Thermal Models

mvguerrero, 2018-06-06:
Meet with Dr. Ian Richards to create a mathematical model of the space environment, as it pertains to Cougsat 1.  Topics include:
Orbit timing
Orbit period
Beta angle
Heat dissipation
Temperature dependency

mvguerrero, 2018-06-08:
The scholar document for cube sat thermal analysis showed our procedure for our work:
1: Thermal calculations for cube without internal components
2: Determining orbit time and cube rotation determination
3: Beta angle defining system temperature dependency
4: Power budget and analysis with all components

Done: Found that cold dependent is a priority, and our beta angle must be less than 60deg. Still need an exact, part to part power budget
-Kevin

WattsUp, 2019-09-16:
What is the reason for reopening this?

mvguerrero, 2019-09-25:
Issue was reopened to add more information from the team's old drive. Instead we added the information in the resources tab. Closing issue

Closed 2019-09-25.

Thread 114 (2018-06-06):

ENVIRONMENTAL CONTROL: Store the thermal vacuum

mvguerrero, 2018-06-06:
Housing indefinitely
Will need to transport it

WattsUp, 2018-06-07:
Darin can house the T-Vac for the foreseeable future.

mvguerrero, 2018-06-07:
Darin is housing the T-Vac at his apartment

mvguerrero, 2018-06-17:
The oven is no longer at our disposal, Thus this issue is reopened

mvguerrero, 2018-09-11:
I recontacted Darin, he is very busy and cannot spare much time. But he is now asking the individual who lent us the T-Vac if we can borrow it again. He will still get credit for resolving this issue.

mvguerrero, 2019-01-20:
We already have a vacuum chamber which we can modify to suit our needs. we no longer need to seek the T-Vac

Closed 2019-01-20.

Thread 117 (2018-06-12):

COUGSAT-1: Create System Requirements

WattsUp, 2018-06-12:

WattsUp, 2018-07-08:
This also involves a SRR

WattsUp, 2018-07-08:
Need to separate system requirements and design requirements
"The CubeSat shall have contact with the ground station at all times" vs "The RCS should be full duplex"
Must haves vs nice to haves
And design requirement should be traceable to a system requirement
System requirements are a "constitution": able to change but difficult/long process

Change CubeSat specifications to "Must comply with CubeSat Specification 3.1.1" to allow the CubeSat document to change without needing to update our document. It's okay with a small project though. Might add  a revision number that we are referencing to.

Rename priority levels: minimum requirement (non negotiable), can change the value, cosmetic, etc.
Key performance parameters
Bare minimum
Expectations
All design requirements are equal

CodySigvartson, 2018-07-09:
[meetingnotes.docx](https://github.com/CougsInSpace/CougSat1-Hardware/files/2174283/meetingnotes.docx)

This file contains notes on requirement revisions from the SRR. If you have any questions please reach out to me

Closed 2018-09-11.

Thread 131 (2018-06-24):

BACKPLANE: Test Circuits V2.1

WattsUp, 2018-06-24:

WattsUp, 2019-02-26:
The large thermal mass made soldering difficult and the test could not be passed. Changing to backplane 3.0 with a PCIe x8 connector

Closed 2019-02-26.

Thread 132 (2018-06-24):

Comms: Evaluate Prototype

WattsUp, 2018-06-24:

WattsUp, 2018-08-29:
Too slow. Senior design team says it can go faster with multi-thousand dollar software
Range tested not performed
Integration into CougSat-1 is difficult

I recommend the CC1110 is not pursued in future iterations of Comms

Closed 2018-08-29.

Thread 144 (2018-06-24):

Comms: Test Non-RF Circuits V1.0

WattsUp, 2018-06-24:
- [x] 3.1
- [x] 3.2
- [x] 3.3
- [x] ~3.4~ Testing in #497
- [x] ~3.5~ Changing ADCs
- [x] ~3.6~ Changing ADCs
- [x] ~3.7~ Changing ADCs
- [x] 3.8
- [x] 3.9
- [x] 3.10 - 5V
- [x] 3.10 - 9V
- [x] 3.11
- [x] 3.13
- [x] 3.14

WattsUp, 2019-07-31:
This is complete, 3.4 was requires a lot of software and was broken off to #497

Closed 2019-07-31.

Thread 186 (2018-06-24):

PAYLOAD: Review Germination Schematic V1.0

WattsUp, 2018-06-24:

WattsUp, 2020-03-10:
Fixed in #560

Closed 2020-03-10.

Thread 189 (2018-06-24):

PAYLOAD: Germination Board Layout V1.0

WattsUp, 2018-06-24:

WattsUp, 2019-10-14:
This is done, being reviewed in #171

WattsUp, 2019-10-14:
Wrong one silly

Thread 217 (2018-06-24):

GROUND: Fabricate Antenna Tracker and Antennas V1.0

WattsUp, 2018-06-24:

colinwarn, 2019-03-31:
Finished.  Check the room for the parts.

Please award points to the following people to the following amount:

Aiden Pyle - 10 points
Makenna Mullen - 8 Points
Alyssa Hovenkotter - 8 Points

RyanDorosh, 2020-03-01:
The individual towers were completed a while ago, I just forgot to close this issue.

Closed 2020-03-01.

Thread 223 (2018-06-26):

EPS: Write Software for controlling switched outputs and solar panel GPIO

reidcol12, 2018-06-26:

WattsUp, 2018-06-26:
Wrong repository

Abandoning this issue

Closed 2018-06-26.

Thread 227 (2018-06-26):

EPS: Write Software for Regulating Battery Temperature

reidcol12, 2018-06-26:

WattsUp, 2018-06-26:
Wrong repository

Abandoning this issue

Closed 2018-06-26.

Thread 229 (2018-06-27):

PAYLOAD: CAD Germination Chamber V1.0

ugradbhull, 2018-06-27:

ugradbhull, 2018-08-23:
Germination chamber design is completed, the design is prepared for review and verification.

Design file is on GrabCad

Closed 2018-08-23.

Thread 234 (2018-06-27):

PAYLOAD: Validate seal specifications and bolt pattern of Payload System V1.0 via thermal vacuum and vibration testing

ugradbhull, 2018-06-27:

Thread 238 (2018-06-27):

PAYLOAD: Create BOM

ugradbhull, 2018-06-27:

ugradbhull, 2018-10-21:
The bill of materials has been created and uploaded to the Payload Google Drive: Payload Seed Germination

WattsUp, 2018-11-10:
Here it is: https://drive.google.com/file/d/1bHMbOwo5KyuRpMogXwbD9WomerX-OgpM/view?usp=sharing

Closed 2018-11-10.

Thread 239 (2018-06-27):

PAYLOAD: Verify and print final drawings and assembly plans for Payload System V1.0

ugradbhull, 2018-06-27:

ugradbhull, 2018-10-21:
Engineering drawings for V1.0 were created.  The drawings are located in the Payload Google Drive: Payload Seed Germination.

Thread 243 (2018-06-29):

STRUCT: Frontplane (+X Cover) Design (due end of July)

colinwarn, 2018-06-29:
Create a 1-2mm panel for the frontplane of the Cubesat that can integrate:

-Umbilical cord hole
-RBF Hole
(solar panels?)
(magnetorquer?)
(Thermal insulation?)

Attitude is responsible for their own mounting mechanism.

WattsUp, 2018-07-02:
It will need pass through for two antenna cables. Maybe three.
No solar panels nor magnetorquer mounting needed

colinwarn, 2018-07-16:
[Front Plane.PDF](https://github.com/CougsInSpace/CougSat1-Hardware/files/2199541/Front.Plane.PDF)
[Front Plane.zip](https://github.com/CougsInSpace/CougSat1-Hardware/files/2199542/Front.Plane.zip)

Latest update to drawings.

colinwarn, 2018-07-17:
[Front Plane.PDF](https://github.com/CougsInSpace/CougSat1-Hardware/files/2203537/Front.Plane.PDF)
[Front Plane.zip](https://github.com/CougsInSpace/CougSat1-Hardware/files/2203538/Front.Plane.zip)

Closed 2018-07-18.

Thread 247 (2018-06-30):

STRUCT: Materials/Parts List with Debris, Outgassing and Hazardous-Designations (due end of October)

colinwarn, 2018-06-30:
Look through all the supplier documents here: https://github.com/CougsInSpace/Resources/tree/master/SupplierDocuments

Crash course on outgassing can be found in this document: https://drive.google.com/file/d/1uy2kXfHkFSPg6wRNPbymaeKjLZSRC59o/view

Make sure components don't outgass.  Check orbital inclination to make sure we'll enter the atmosphere within 25 years to meet orbital debris requirement. For hazardous requirement, check through AFSPCMAN 91-710 Vol 3 for major materials such as solder and aluminum.  Also make sure we have nothing radioactive.

Verify each component doesn't outgass too much.

-What is it's total mass loss when heated up ? (TMV)
-What percentage of the mass collects into volatile condensable materials? (CVCM)
-Is it hazardous according to the specifications found in AFSPCMAN 91-710 Vol 3?

TMV and CVCM data can be found here:
https://outgassing.nasa.gov/cgi/uncgi/search/search_html.sh

colinwarn, 2018-10-21:
Outgassing list compilation: https://drive.google.com/open?id=1LmuybV8ii0qVm2OSRNyNGKrupDe8NRez

Closed 2018-10-20.

Thread 272 (2018-07-02):

EPS: Test RBF Pin Holder V1.0

WattsUp, 2018-07-02:

WattsUp, 2019-05-20:
The pin is difficult to remove and the mount wobbles so much that the switch disconnects. Redesign with a softer detent or a twist lock mechanism and an L shape to stop wibble wobble

Closed 2019-05-20.

Thread 273 (2018-07-07):

Comms: Design Antenna(s)

WattsUp, 2018-07-07:

WattsUp, 2018-07-07:
Attempted to solder to nitinol, all attempts failed. May need special flux/solder/electroplate it
Surface is conductive to maybe mechanical attachment but need to consider RF
Spot welding nitinol to ENIG 1oz works but weakens the nitinol and the bold between the nitonol and PCB is not that strong

WattsUp, 2018-07-08:
Crimping a 0.1in male pin on to nitinol without black oxide yielded a strong mechanical connection (I cannot pull the wire out) and good electrical connection (my dmm said 0.5Ω but not sure about RF loss there).
We crimp some connector on and then solder the connector to the board or solder a pin socket into the board and just insert the nitinol. Like this connector: https://www.digikey.com/product-detail/en/mill-max-manufacturing-corp/3016-0-15-15-21-27-10-0/ED1034-ND/436434
My gut feeling is the pin socket I linked will work. But, we will need to test RF losses and attempt soldering with different nitinol

As for the antenna design, a simple dipole, each whip 1/4λ, will work for the primary communication. I am also thinking about a deployable helix antenna made out of nitinol for either 33cm, 23cm, or 12.5cm bands. This would be for high speed downlink with high gain. Will need to check a link budget

Closed 2018-11-18.

Thread 275 (2018-07-09):

IFJR: Test Tri-State Buffers

WattsUp, 2018-07-09:
Should disconnect the JTAG from the processor and allow the processor to use SWD

WattsUp, 2018-07-22:
This is working properly. Each board needs to pull up the enable pin so they can be programmed via SWD.
Once the enable pin was asserted high, ST-Link could communicate with the IC
The fall time was 4ns with ground antenna probing. Rounding to 10ns up and down means we can reach 100MHz for JTAG. STM shows they default to 9MHz. And work down to 140kHz.

Closed 2018-07-22.

Thread 276 (2018-07-10):

EPS: Develop Temperature Sensor Solution

WattsUp, 2018-07-10:
ON EPS V2.0, we used thermally conductive epoxy to connect the thermistors and the ICs. This resulted in a poor job.

Task: figure out what is the best method for measuring temperatures of ICs.
Different adhesive
Different temperature sensors
Different application process
.....

WattsUp, 2018-08-08:
How about place an smd thermistor close to the IC and have the PCB transfer the heat. This needs to be tested. The thermistor should be +/- 2K off of the actual dut. For the battery, a sil pad could easily be used, they have low out gassing ones.

Thread 291 (2018-07-24):

Get Center of Mass Calculation (due end of September)

colinwarn, 2018-07-24:
-Make sure each component's mass estimate is within 1 gram of it's datasheet weight
-Assemble all components

Center of Mass must be within 2cm^3 of the center of CougSat-I

max volume design - Max volume for hand modeled parts. Fit check, assume worst case. Use premade CAD parts when possible.
mass: For parts 20g or larger, worry about center of mass distribution.
vibration: More than 10% the mass of the board, model it. For connection areas, get contacting surface area modeled correctly.

Unless you can tell explicitly by looking at the object where a given material is, assume uniform distribution.

WattsUp, 2018-07-24:
3.2.14 and 3.2.14.1: within 2cm, not 2 cm³. A volume dimension here doesn't make sense. I believe this means the point can be inside of a 4cm cube centered about the geometric center and not a 4cm diameter sphere. It is kind of ambiguous

Closed 2018-09-03.

Thread 293 (2018-07-27):

EPS: Test MPPT Off State

WattsUp, 2018-07-27:
Apply battery voltage (3.0-4.1V) through a diode to the output on the evaluation board and measure the current when there is no sun and full sun. This current should be zero

WattsUp, 2018-08-23:
At 4.2V battery voltage, the current draw from the battery without a solar panel was 0.15mA. That might be due to the evaluation board's CMOS circuitry

I conclude the MPPT does not drain the battery if there is no sun

Closed 2018-08-23.

Thread 297 (2018-08-09):

EPS: Characterize 3.3V SMPS on EPS V2.0

WattsUp, 2018-08-09:
If the values satisfy our requirements, the design will be reused on EPS V2.1.

WattsUp, 2018-08-10:
90mVpp=2.7% under 2A load and 3.7V input
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
50MHz frequency, same test case
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
The switching spike is the 50MHz as seen in the spectrum analyzer
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
Ripple is about 15mVpp = 0.5%
Average voltage is 3.265V = 1.3%
The only measurement out of requirements is the noise figure 2.7% vs 1%. I believe this can be reduced with improved filtering on EPS V2.1. I approve EPS V2.0  3.3V SMPS for use on EPS V2.1 provided effort is made to improve the noise figure.

Closed 2018-08-10.

Thread 308 (2018-09-06):

ENVIRONMENTAL CONTROL - Orbital and Radiation analysis

kevvillarreal, 2018-09-06:
Using an orbital simulator and or iterations, determine the max and min temperatures for our cube in orbit using our thermal shielding materials. Also determine if our beta angle is sufficient to keep our temperature in range to provide a successful mission.

mvguerrero, 2018-09-27:
Here's a quick summary of the meeting with Dr. Richards
Meeting with Dr. Richards said what we had was on track and good. Missing a few things such as the transient calculations, ( we assumed steady state). Steady state assumes our mass is close to zero. If our mass is zero as we pass the line between dark and light, the temperature change will be instant.  CANNOT ASSUME STEADY STATE. That's where the mass comes in. He said our radiation equation was right, but we need to set it equal to the (M*CP*DeltaTemp)/Time. He also said that because our layering will be very small in mass, using it will have a great effect on the radiation equations than the MCPDeltaT/Time. We have good equations, that we just need to hone with existing information. We also got input on how to test with the vacuum chamber. Summary: we are going to strap a resistor coil to one side of the satellite, we can measure the temperature of the resistor on one side, assume it's the same all around the resistor. We will measure the power consumed by the resistor, and extrapolate the energy output in watts.  Then we read the measurements from the cubesat's interior, and compare to the equation model.

These refinements must be made before the issue is closed, so we are moving the sprint

mvguerrero, 2019-03-24:
In our albeit short experience with free orbital simulation software like NASA's GMAT, we have concluded that utilizing this method of environmental simulation is not time effective for our time-frame. There's a steep learning curve to be surmounted before viable results could be had, and there's no way to know if someone who reached that level will stay with us. Overall, the risks outweigh the benefits for the team at this stage of our project.

Since we explored this method and invested in learning enough about it to know it won't be viable, I am downgrading this issue to Intermediate. We didn't utilize the simulation software to the fullest extent, but I want to be fair to those who worked hard to discover this fact.

Closed 2019-03-24.

Thread 309 (2018-09-06):

EPS: Determine Requirements for Test Board (Due 9/30/18)

reidcol12, 2018-09-06:
The new members of the power team will work on developing a board that can be used to test/prototype new equipment for the power board. This may include things like trying different ways to measure temperature on a processor, using potentiometers to find optimal resistor values for ICs, etc. This will serve as a good introduction to designing PCBs.

WattsUp, 2018-10-23:
No longer creating this board

Thread 311 (2018-09-09):

ENVIRONMENTAL CONTROL-Radiation Equations

Cory-Palmieri1, 2018-09-09:
Develop a Radiation Equation to simulate our thermal layering.

mvguerrero, 2018-11-11:
After our meeting with Dr. Richards, we learned we are still on the right track. When considering the thermal mass of the insulation, we can consider it as constant because the thickness is so small, thus the temperature difference on either side of the insulation is negligible. However the thermal mass of the satellite such as the frame and the components is not, for now we will be simplifying the satellite into "chunks" of materials for calculations.

Mikte, 2019-03-24:
Concluded Radiation calculations.
Created two similar equations representing the thermal behavior of the satellite: one equation determining the inside temperature of the satellite and it's components and another determining the exterior temperature of the satellite (mainly MLI with options for more if necessary).

_Determine Temps based on present material of satellite (modifications available)_
[Interior Temps_Alex Lambert.xlsx](https://github.com/CougsInSpace/CougSat1-Hardware/files/3000911/Interior.Temps_Alex.Lambert.xlsx)

Closed 2019-03-24.

Thread 312 (2018-09-11):

Verify Structure and Assembly Procedure

GregWallace24, 2018-09-11:
Due end of Sunday Sept. 16
Add other teamleads to the assignees as needed

On the GrabCad go to:
CougSat1(Mk2, Master) -> Mk2V12 -> StructureAssemblyVOLUMEMODEL.SLDASM

Also look at:
[CougSat1 Assembly Process 9.10.18.docx](https://github.com/CougsInSpace/CougSat1-Hardware/files/2368970/CougSat1.Assembly.Process.9.10.18.docx)

First, view the GrabCad file described above.  You don’t need solidworks to view the design or take simple measurements, but it is recommended.  You can get Solidworks for yourself from the school or you can access it in Sloan 249 (Message Colin or I and we will tell you how to get on the computers.  I won’t write it here because this is publicly visible).

Then view the rough outline of the assembly process we intend to use (uploaded here).  Several parts aren’t fully designed yet, so they aren’t in the model.

Your job for this issue is to verify that this structure design (Mk2V12) and assembly process do not interfere with your designs yet.  This does not need to be the final design.  The purpose is to push us all towards finalization.

If you cannot describe specifically how it interferes with your subsystem and don’t have detailed modification requests, then it does not interfere with your current design, so mark as accepted.  You can always request edits later.  This issue is NOT intended to verify everything fits: we can’t predict the future.  For non-vital suggestions, we can set them up and implement them when we move onto the next revision (if we do another revision).

If this issue is accepted, then this is the structure will become Revision A, and will be the official one.  After, we will assume there are no problems with the structure unless you notify us.  For modification, you will need to create an issue.  In the case of change, we will create a new revision and then again ask you all to verify that it does not interfere.

If it is not accepted then we will make the requested edits and ask you to verify again in a similar matter.

colinwarn, 2019-01-20:
Final model finished: https://github.com/CougsInSpace/CougSat1-Hardware/tree/Structure/CougSat1-Structure

Closed 2019-01-20.

Thread 315 (2018-09-12):

Design Adapter Board for Vibration Table (due  September 23rd)

colinwarn, 2018-09-12:
Design an adapter board for a small shaker table in ETRL 001.

Dimensions and picture of the shaker table can be found here:
https://imgur.com/a/fIy4bha

Bolts are 8-32 for the small holes and 10-32 for the big hole.

Closed 2018-09-23.

Thread 317 (2018-09-12):

Machine Adapter Board for Vibration Table (due October 5th)

colinwarn, 2018-09-12:

GregWallace24, 2018-09-22:
Goal: Create a mass setup to be tested by the small vibration table.  We want to test at least up to 2kg on the small vibe table in the 406 lab (basement of ETRL) to see if it could be able to test our whole cubesat.  Preferably, have an adaptable setup so we can work our way up to 2kg in increments of 0.25kg or 0.5kg.  Ryan has the dimensions of the mounting holes and has an adapter design.  So we'd like you two to work together to complete this setup and test it out.  This doesn't need to work for testing any specific part, just seeing what mass the vibe table is capable of managing.

We can buy parts off McMaster.com, but preferably use scrap metal from the FIZ and the CIS room (EME 107, where we meet on fridays).  Talk to Colin about these, he is friends with the guys in the FIZ and knows what scrap you can use in the CIS room.  We will likely buy some fasteners for mounting, just to ensure we have the right length.

Let Colin or I know when you have questions!

Thread 319 (2018-09-14):

Find Replacement Motor for Big Vibe Table (due end of November)

colinwarn, 2018-09-14:

Closed 2019-01-12.

Thread 331 (2018-09-23):

Design Main Mounting Plate for Vibration Table (due October 21st)

colinwarn, 2018-09-23:
Picture of shaker:
https://imgur.com/a/fIy4bha

Closed 2018-10-08.

Thread 334 (2018-09-25):

EPS: Write Functional Tests V2.1

WattsUp, 2018-09-25:
Battery Charging
Battery Protection
3.3V Regulator
Power Channel Control
ADCs
PMIC
Any other components

Closed 2018-10-22.

Thread 346 (2018-10-07):

ENVIROMENTAL CONTROL-Create Mass Estimate for Insulation Systems

mvguerrero, 2018-10-07:
In order to establish Environmental Control's portion of the overall mass of the bus and payload, an an overestimation must be made of our insulation systems. An overestimation must be made due to the fact that one side of the satellite lacks exterior hardware such as solar panels and aluminium structure.

mvguerrero, 2018-10-07:
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

Levi calculated the mass of our layering system with a various amount of layers for a system which is evenly spread across the sat.  This information provides a low and a high estimate for the potential mass of our thermal systems. If the image is not displaying properly, it reads:
1 Layer-0.0144kg;5 Layers-0.057kg; 10 Layers-0.144kg; 15 Layers-0.171kg

Closed 2018-10-07.

Thread 348 (2018-10-07):

ENVIRONMENTAL CONTROL- Implement the Lockheed-Martin MLI equations to analyze our Insulation Systems

mvguerrero, 2018-10-07:
Lockheed-Martin developed an equation to represent the total heat flux of a system insulated with MLI in particular. We hope to utilize these equations to more accurately assess the efficacy of our insulation systems.

mvguerrero, 2018-10-07:
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
Here is a snippet of the equations in question

mvguerrero, 2018-10-07:
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
Here's some performance graphs of Lockheed MLI

mvguerrero, 2018-10-07:
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
Here's the refrences at the end of the document

mvguerrero, 2018-10-07:
[CEC2015 Quantifying MLI Thermal Conduction.pdf](https://github.com/CougsInSpace/CougSat1-Hardware/files/2454428/CEC2015.Quantifying.MLI.Thermal.Conduction.pdf)
And here is the document itself

mvguerrero, 2018-10-14:
This task was deemed to be not be as helpful to our goal of creating a model for multi layered insulation, as most of the information required a greater understanding of the subject than we currently have.

Closed 2018-10-14.

Thread 352 (2018-10-14):

ENVIRONMENTAL CONTROL-Temperature Logger Practical Test

mvguerrero, 2018-10-14:
Our refurbished ABS cubesat skeleton models have been updated to work with the new temperature logger, and we now have a heat lamp to apply radiative heat to the system. We intend to plot the temperature data, and compare to the skeleton without insulation.

Stretch goal would be to compare that to our current iteration of the thermal model, but we would have to account for atmosphere.

mvguerrero, 2018-10-14:
The heat lamp itself has a rating of 250 Watts.

mvguerrero, 2018-10-24:
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

These data were gathered as a result of our initial testing of the temperature logger, and it has been shown to provide a steady and reliable source of wireless temperature recording. The only issue we ran into was ensuring that the board and sensor reached room temperature between each test. This can be shown on the first image where some of the data is strange for that reason.

(This issue was finalized during the 21st, but since Github was down I am closing it now)

Closed 2018-10-24.

Thread 354 (2018-10-14):

PAYLOAD: Design cut-extrude into the clamping plate

ugradbhull, 2018-10-14:
Remove a 7mm by 3mm from the clamping plate so that the bolt tab from STR-nX<4> can fit inside the pocket.

ugradbhull, 2018-10-15:
Pocket created and the chamber is integrated in its proper mating orientation.

Closed 2018-10-15.

Thread 355 (2018-10-15):

Research Best Practices for Soldering Solar Cells (due end of October)

colinwarn, 2018-10-15:
Writeup a 1-2 page report on best practices for soldering solar cells for space applications.

Some resources:

How to Solder Circuits: "Soldering Rockets":
https://www.youtube.com/watch?v=xsxZSePV9bE

colinwarn, 2018-11-04:
1-2 Page Writeup: https://drive.google.com/open?id=1cjFGJFt8zu4RyTbEJ4aJebug7TSMNX_f

Closed 2018-11-04.

Thread 360 (2018-10-20):

COMMS: Evaluate RF Chain

WattsUp, 2018-10-20:
ICs under evaluation
https://www.digikey.com/product-detail/en/analog-devices-inc/AD8348ARUZ-REEL7/AD8348ARUZ-REEL7CT-ND/4885431
https://www.digikey.com/product-detail/en/analog-devices-inc/AD8346ARUZ/AD8346ARUZ-ND/671088
https://www.digikey.com/product-detail/en/analog-devices-inc/AD8345AREZ/AD8345AREZ-ND/671087
https://www.digikey.com/product-detail/en/analog-devices-inc/ADF4360-7BCPZRL7/ADF4360-7BCPZRL7CT-ND/3903818

WattsUp, 2018-11-08:
The AD8346 may have been damaged from too large of an input voltage on the local oscillator.
The AD8345 was transmission and the IQ could change the phase. The IQ was connected to a low impedance driver, the waveform generator of the oscilloscope couldn't drive it. It perhaps is due to wrong source impedance.
The ADF4360 required too many discrete components to solder up. It will be tested on the prototype
The AD8348 couldn't be tested without a consistent clock generator (the spectrum analyzer varied its phase and frequency during operation). It will be tested on the prototype

Closed 2018-11-08.

Thread 364 (2018-10-21):

Safety Case for CubeSat

colinwarn, 2018-10-21:
Watertight case, cart for moving, small profile.

WattsUp, 2018-10-24:
I recommend we purchase the Pelican 1300 with anti-static foam. (This is already on the equipment wishlist, might need to remind Matt). The foam will probably be cut out by us to ensure a nice fit

colinwarn, 2019-01-22:
Pelican case ordered: https://www.casesbypelican.net/mobile/product.aspx?ProductCode=APP-1300A-Static

Closed 2019-01-22.

Thread 367 (2018-10-22):

ELECTRICAL: Create Board With Pass Filters for Testing

hendrikmelse, 2018-10-22:

WattsUp, 2018-10-31:
Schematic and board are done:
https://github.com/CougsInSpace/Resources/tree/master/Subsystems/Electronics/Testing/Filters

WattsUp, 2018-11-07:
Assembly and testing is a part of #409. This issue is complete

Closed 2018-11-07.

Thread 372 (2018-10-23):

PAYLOAD: Write Germination Board V1.0 Documentation

WattsUp, 2018-10-23:

WattsUp, 2020-03-10:
Fixed in #560

Closed 2020-03-10.

Thread 373 (2018-10-23):

PAYLOAD: Create an itemized purchase request for pressure testing

ugradbhull, 2018-10-23:
Need to get a purchase order approved:
- pressure sensor
- pass through
- gaskets (pass thru, pressurization fitting, master gasket, pressure transducer for calibration)
- 6061-S stock material (McMaster Carr or on campus location)

Thread 374 (2018-10-23):

PAYLOAD: Create schedule for pressure test

ugradbhull, 2018-10-23:
- Get quotes on manufacturing time for:
    > clamping base and plate
    > gaskets
- locate air compressor
- select testing location
- order and assemble testing instrumentation

Closed 2019-02-14.

Thread 379 (2018-10-25):

ENVIRONMENTAL CONTROL-Research Solar Panel PCB Expansion and Fatigue

mvguerrero, 2018-10-25:
Sunday's research brought a  lot of general info about differential thermal expansion, but we would like to focus on Solar Panel PCB's in this next issue.

mvguerrero, 2018-11-11:
We found the thermal expansion coef for GaAs(5.73*10^-6 celcius^-1) and Germanium (5.9*10^-6 cecius^-1)
We can't find the thermal expansion coef for GALNP2 and we are still searching

jacob-nichols, 2019-04-08:
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

I got the PCB thermal expansion coefficients for the gold/copper alloy as well as the fiberglass. The fiberglass coefficient was given in 2 ways, lengthwise and crosswise. I was not able to get information regarding when the difference in the coefficients becomes dangerous.
I used these links to get the information:
Alloy - https://www.engineeringtoolbox.com/linear-expansion-coefficients-d_95.html
FR4 - https://www.farnell.com/datasheets/1644697.pdf
Unit Conversions:
- http://www.unitconversion.org/unit_converter/thermal-expansion.html
- http://asm.matweb.com/search/GetUnits.asp

mvguerrero, 2019-04-14:
Hey, I think we can find the point at which the expansion is dangerous through theory.
Assuming that the danger comes from the strain caused from differential expansion, we need to find the strain developed due to the difference of expansion coefficients. Also we need to know the endurance limit curve for the material with expands slower. The endurance limit is dependent on both the cycles endured, and the strain at which the cycles take place. That would also give us a lifetime or the part. If it's below the curve, then we shouldn't have any trouble, and if it's above, then we need to find the lifetime.

mvguerrero, 2019-11-17:
This situation should not be a problem for our sat, as it will run cold according to our latest calculations. The thermal cycling will be very slight, and the materials involved should not expand enough for us to worry about.

Closed 2019-11-17.

Thread 380 (2018-10-28):

ADCS - Add addition ADC to solar panels

phillip-whitworth, 2018-10-28:
ADCS needs another ADC on the solar panels to use for the connection of photodiodes.

WattsUp, 2019-02-09:
Added with a dedicated I2C to the ADCS

Closed 2019-02-09.

Thread 381 (2018-10-28):

ADCS - add photodiodes to exterior of cubesat

phillip-whitworth, 2018-10-28:
Need photodiodes for sun sensing.

WattsUp, 2019-02-05:
Solar panel is going to have one flat mounted. The +X and -Z panels will have a teepee formation of four photo diodes if space allows else just single flat ones. These diodes will connect to and ADC for direct sampling from the ADCS

Closed 2019-02-05.

Thread 382 (2018-10-28):

Board Tensile Testing Coupon Design

GregWallace24, 2018-10-28:
Create a SW model of testing coupons made of the PCB board material which we can waterjet out.  Save as DXF for waterjetting.

Assign to Jeffrey Lebo when he gets on github

Closed 2018-11-30.

Thread 383 (2018-10-28):

Waterjet out for Tensile Bolt Testing

GregWallace24, 2018-10-28:
2X Hardened steel M3 holders (COMPLETED)
2-4X Mild steel 3/4" holders (1/2" thick, "Holder0.75.dxf")
2-6X Aluminum threaded blocks (3mm thick, "AluminumBlock.dxf")

See the assembly here: https://workbench.grabcad.com/workbench/projects/gcZyVL8e3jBFst25EMOCFOSOSSCCtw5Og6qSO3SCIElLVA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

[TensileBoltTesting.zip](https://github.com/CougsInSpace/CougSat1-Hardware/files/2523350/TensileBoltTesting.zip)

Closed 2018-11-18.

Thread 385 (2018-10-28):

Design Mount for testing PCBs on the Vibe Table

GregWallace24, 2018-10-28:
[CougSatModuleStandard.2.1.1.pdf](https://github.com/CougsInSpace/CougSat1-Hardware/files/2523313/CougSatModuleStandard.2.1.1.pdf)

Design an adjustable mount for testing PCBs on the vibe table.  Should mount directly to the vibe-table-plate that Ryan made and should be adjustable between the old boards and the new boards.  Shall include holes for bolting in a basic backplane.

colinwarn, 2018-12-08:
CAD here: https://workbench.grabcad.com/workbench/projects/gcZyVL8e3jBFst25EMOCFOSOSSCCtw5Og6qSO3SCIElLVA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

Closed 2018-12-08.

Thread 386 (2018-10-29):

Integrate +X Feature To Mk2V14 pX Model

colinwarn, 2018-10-29:
Integrate the features from this model into the Mk2V14 pX:
https://workbench.grabcad.com/workbench/projects/gcZyVL8e3jBFst25EMOCFOSOSSCCtw5Og6qSO3SCIElLVA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

NOTE: DO NOT integrate the four outer 3.2mm holes.  Integrate everything else.

Mk2V14 pX Cad Link:
https://workbench.grabcad.com/workbench/projects/gcZyVL8e3jBFst25EMOCFOSOSSCCtw5Og6qSO3SCIElLVA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

colinwarn, 2018-10-30:
Model tweaked: https://workbench.grabcad.com/workbench/projects/gcZyVL8e3jBFst25EMOCFOSOSSCCtw5Og6qSO3SCIElLVA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

Closed 2018-10-30.

Thread 404 (2018-11-04):

ENVIRONMENTAL CONTROL-Research Resistor Circuit for the Vacuum Chamber

wilmothalex, 2018-11-04:
The goal of this issue is to research possible designs for creating a circuit which radiates the desired amount of heat onto a satellite model within a vacuum chamber.

mvguerrero, 2018-11-15:
[Circuit Analysis for Vacuum Chamber Heat Transfer.docx](https://github.com/CougsInSpace/CougSat1-Hardware/files/2583239/Circuit.Analysis.for.Vacuum.Chamber.Heat.Transfer.docx)

Here's the document which  the participants created!

Closed 2018-11-15.

Thread 405 (2018-11-05):

ADCS - Wrap Test Coil

phillip-whitworth, 2018-11-05:
Wrap the first coil to specs

phillip-whitworth, 2019-02-05:
We wrapped one of these and found some issues with the procedure. I think we have finished this issue but we will have other coils needing to be wrapped.

phillip-whitworth, 2019-02-05:
Need to Add Jack Price to this as well.

quintonclum-123, 2019-02-07:
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

Image of a wrapped Test Coil inside its wrapping device!

Closed 2019-02-08.

Thread 407 (2018-11-06):

CAD Design of a 3-Axis Helmholtz Coil

colinwarn, 2018-11-06:
About helmholtz coils:
https://en.wikipedia.org/wiki/Helmholtz_coil

Overview of math:
https://drive.google.com/drive/folders/1XKPRZxPWSiA8rwCXX06DLtN5xtx141Nb

Design should look like this:
http://www.ascscientific.com/HelmholzCoils.html
https://www.surrey.ac.uk/sites/default/files/styles/image_gallery/public/2018-02/helm_holtz_DSC_0893.JPG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

- Determine volume of uniform magnetic field
- Determine coil size to achieve volume

colinwarn, 2019-02-07:
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

Closed 2019-02-07.

Thread 409 (2018-11-07):

ELECTRICAL: Assemble and Test Oscilloscope Filters

WattsUp, 2018-11-07:

WattsUp, 2019-02-06:
The filter has the proper cutoffs but mismatched impedance causes some attenuation. Using a unity gain buffer helps. If the board is used a lot, a respin should be made to address the impedance mismatch.

Closed 2019-02-06.

Thread 413 (2018-11-15):

CAD Up a 3U Solar Array Deployment Mechanism

colinwarn, 2018-11-15:
Make a CAD model for deployable solar arrays for the 3U listed below.  The deployables should look something like this: https://www.clyde.space/products/28-3u-singledeployable-solar-array-short-edge

3U to design deployable solar panels for: https://workbench.grabcad.com/workbench/projects/gcZyVL8e3jBFst25EMOCFOSOSSCCtw5Og6qSO3SCIElLVA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

colinwarn, 2019-01-21:
Hinge design:
https://workbench.grabcad.com/workbench/projects/gcZyVL8e3jBFst25EMOCFOSOSSCCtw5Og6qSO3SCIElLVA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

Paper inspiration: http://edge.rit.edu/edge/P16102/public/Problem%20Definition%20Documents/Benchmarking/TripleFold%203U.pdf

Closed 2019-01-21.

Thread 414 (2018-11-15):

ENVIRONMENTAL CONTROL-Draft Vacuum Chamber Test Procedures

mvguerrero, 2018-11-15:
The goal of this issue is to create a procedure for testing components within the acrylic vacuum chamber with regards to the resistor rig.

mvguerrero, 2019-01-20:
Cody Christiansen @ctchris1 has created a fantastic template for testing procedures. Check it out!
[Test Plan - Template.docx](https://github.com/CougsInSpace/CougSat1-Hardware/files/2777136/Test.Plan.-.Template.docx)

mvguerrero, 2019-06-03:
Levi did some even more fantastic work on drafting the procedures from the plans of @ctchris1 .
Attached is the file.
[Uploading Draft_Insulation_Installation_REV01 (1).docx…]()

LeviJCarroll, 2019-09-15:
[Draft_Insulation_Installation_REV01.1.docx](https://github.com/CougsInSpace/CougSat1-Hardware/files/3614330/Draft_Insulation_Installation_REV01.1.docx)

@mvguerrero Document change for the insulation installation (Revision 1.1).
Changes include:
-Changing authority and relevant personnel to reflect moved members
-Added Daelin as a safety contact
-Minor formatting changes

Closed 2019-06-03.

Thread 424 (2019-01-14):

EPS: Fabricate Battery Heatsink V1.0

WattsUp, 2019-01-14:
CAD:
https://workbench.grabcad.com/workbench/projects/gcZyVL8e3jBFst25EMOCFOSOSSCCtw5Og6qSO3SCIElLVA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

We will need at least 2 of the one labelled EPS_BatteryHeatsink.stp for our actual board and then one of the design like EPS_BatteryHeatsink(1).STL. The one that wraps around the entire battery we will want to be around 65 mm in length and as thin as possible for heat transfer purposes.

colinwarn, 2020-10-23:
ProShop is currently machining this part.

colinwarn, 2020-11-21:
Part has been machined.

Closed 2020-11-21.

Thread 427 (2019-01-20):

ENVIRONMENTAL CONTROL-  Implement Internal Heat Dissipation in Current Calculations

mvguerrero, 2019-01-20:
In the current model, we are not regarding the heat dissipated from within the satellite to its environment. By establishing this quantity, we can further determine the impacts of our and other team's designs.

mvguerrero, 2019-01-20:
This is a link to the "All Calculations So Far" Folder on Kevin's Google drive

https://drive.google.com/open?id=1zgsYx0NiDwhIQhn-iBp9NvuTIBXync6f

mvguerrero, 2019-09-29:
This issue was solved over the summer, and I neglected to complete it. I would like to apologize for this oversight. The up to date document can be found on resource tab of our Project page.

Closed 2019-09-29.

Thread 428 (2019-01-20):

ENVIRONMENTAL CONTROL- Establish Component  Failure Temperatures

mvguerrero, 2019-01-20:
In order to determine any trouble our current design might run in to in the space environment, we should first know which components are most susceptible to heating and cooling.

mvguerrero, 2019-01-20:
A good place to start is this out-gassing document, which provides a list of materials that the satellite may have.
https://docs.google.com/spreadsheets/d/1Ffi6Van7d6UFOOZWv35CHvjAYAZviSq5Q2YHk5JZeZU/edit#gid=0

mvguerrero, 2019-09-29:
https://docs.google.com/spreadsheets/d/1-Y5DcxFlxzLKLqIWymtka-N0zlOLK5Fd1R_8o3NRlR0/edit?usp=drivesdk

This is the link to the actual spreadsheet! Originally it was done by manufacturer, but the resources page may have changed from then to now. https://github.com/CougsInSpace/Resources/tree/master/SupplierDocuments

mvguerrero, 2019-10-13:
Looking through the list of capacitors, they are very similar in component failure temps. The most strict range I found so far was -15 to 80. I am going to move on from those

Thread 435 (2019-01-22):

Create Engineering Drawing for Mk2v17 Magnetorquer Standoff

colinwarn, 2019-01-22:
Part:
https://workbench.grabcad.com/workbench/projects/gcZyVL8e3jBFst25EMOCFOSOSSCCtw5Og6qSO3SCIElLVA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

colinwarn, 2019-02-08:
Done: https://workbench.grabcad.com/workbench/projects/gcZyVL8e3jBFst25EMOCFOSOSSCCtw5Og6qSO3SCIElLVA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

Closed 2019-02-08.

Thread 436 (2019-01-22):

Create Engineering Drawing for Mk2v17 Solar Heat Sink Standoff

colinwarn, 2019-01-22:
Part:
https://workbench.grabcad.com/workbench/projects/gcZyVL8e3jBFst25EMOCFOSOSSCCtw5Og6qSO3SCIElLVA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

colinwarn, 2019-02-09:
Done: https://workbench.grabcad.com/workbench/projects/gcZyVL8e3jBFst25EMOCFOSOSSCCtw5Og6qSO3SCIElLVA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

Closed 2019-02-09.

Thread 438 (2019-01-30):

STRUCT: Create Engineering Drawing of Assembly

colinwarn, 2019-01-30:
Create an engineering drawing of the full satellite assembly, with bills of materials.

https://workbench.grabcad.com/workbench/projects/gcZyVL8e3jBFst25EMOCFOSOSSCCtw5Og6qSO3SCIElLVA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

Should end up looking something like this:
https://workbench.grabcad.com/workbench/projects/gcZyVL8e3jBFst25EMOCFOSOSSCCtw5Og6qSO3SCIElLVA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

colinwarn, 2019-02-09:
Done: https://workbench.grabcad.com/workbench/projects/gcZyVL8e3jBFst25EMOCFOSOSSCCtw5Og6qSO3SCIElLVA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

Closed 2019-02-09.

Thread 440 (2019-01-31):

ENVIRONMENTAL CONTROL- Simulate Single Orbit While Changing Qexternal

mvguerrero, 2019-01-31:
Simulating a single orbit is an important milestone, as it allows us to know what heating or Qexternal is occouring during one cycle. We can create more complex studies from this example.

mvguerrero, 2019-02-24:
With our current calculations, we have a temperature of -29 degrees C as our warm temperature. For the cold temperature we have -21 degrees Celsius .However, this does not account for the mass of the components, such as the frame.

Adding mass will smooth out the temperature fluctuations throughout the time, currently calculated at  a 3 to 4 degree difference. These results encourage us to explore insulation options for the 'Top" and "Bottom" of the sat, which would allow less heat transfer from those faces.

Closed 2019-02-24.

Thread 442 (2019-01-31):

ENVIRONMENTAL CONTROL- Define Temperatures at the Center of Each Component.

mvguerrero, 2019-01-31:
Once the effects of the space environment are discovered, it's important to understand what the resultant temperatures of the components of the satellite will experience. If the temperatures of the components are outside their operational range, we will have to modify or install thermal regulation systems.

mvguerrero, 2019-09-08:
MICROTASK:
Determine the equations for radiative heat from surface to center of a regular shape.
-Mario Guerrero

Thread 443 (2019-02-04):

Design Machining Mount for RBF Holder

colinwarn, 2019-02-04:

RyanDorosh, 2020-01-26:
The part was designed, but we no longer need it.

Closed 2020-01-26.

Thread 454 (2019-02-19):

Fabricate 4x Magnetorquer Standoffs

colinwarn, 2019-02-19:
CAD:
https://workbench.grabcad.com/workbench/projects/gcZyVL8e3jBFst25EMOCFOSOSSCCtw5Og6qSO3SCIElLVA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

colinwarn, 2019-09-04:
Parts have been machined by Reid's dad.  Dad does not have a Github.  Therefore Reid gets all the credit.

Closed 2019-09-04.

Thread 455 (2019-02-19):

Fabricate 4x Solar Heatsink Standoffs

colinwarn, 2019-02-19:
CAD:
https://workbench.grabcad.com/workbench/projects/gcZyVL8e3jBFst25EMOCFOSOSSCCtw5Og6qSO3SCIElLVA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

colinwarn, 2019-09-04:
Parts have been machined by Reid's dad.  Dad does not have a Github.  Therefore Reid gets all the credit.

Closed 2019-09-04.

Thread 475 (2019-04-18):

Torque testing Aluminum Thread

RyanDorosh, 2019-04-18:
We would like to test how much torque it takes to tear an aluminum thread using a bolt.  So we should get some 3mm thick aluminum and drill a bunch of 2.5mm holes (talk to Colin) and tap them with the M3 thread.  Then see how much torque it takes to tear out the threads (using the torque wrench).

RyanDorosh, 2019-04-22:
Aluminum Sheet with tapped holes was machined out. Actual torque testing will be done on a later date.

Closed 2019-04-21.

Thread 477 (2019-06-13):

EPS: Fix Bugs for V3.0

WattsUp, 2019-06-13:
- [x] MOD-001
- [x] MOD-002
- [x] MOD-003
- [x] MOD-004
- [x] MOD-005
- [ ] ~MOD-006~ Ideal diodes prevent cross and reverse conduction
- [x] Change switching matrix to balance the two batteries in hardware (use ideal diodes in and out; replaces MOD-006)
- [x] I2C level shifter for going to solar panels (they are 3.3V, EPS is VBATT)
- [x] Change ADC circuit to solar panel implementation
- [ ] ~Change status LED to PA_5~ Can change it in software

WattsUp, 2019-07-12:
Bug fixes have been made

Closed 2019-07-12.

Thread 488 (2019-06-17):

EPS: Test Circuits V3.0

WattsUp, 2019-06-17:

WattsUp, 2019-11-17:
This is done, being reviewed in #567.
3.3V-B has poor routing leading to failures after 5min of heavy usage
Current sensing off of the ORing current mirror doesn't work, needs an ADC buffer

Closed 2019-11-17.

Thread 492 (2019-07-15):

EPS: Create Solar Cell Simulator V1.0

WattsUp, 2019-07-15:
Has the same output voltage vs current response as the solar cells found on the solar panel

WattsUp, 2019-07-15:
Complete: https://github.com/CougsInSpace/Resources/pull/23

Closed 2019-07-15.

Thread 509 (2019-09-03):

ELECTRICAL: Electronic Load Board Layout V1.0

WattsUp, 2019-09-03:

WattsUp, 2019-09-05:
Issue moved to [CougsInSpace/Resources #26](https://github.com/CougsInSpace/Resources/issues/26) via [**ZenHub**](https://www.zenhub.com/)

Closed 2019-09-05.

Thread 517 (2019-09-03):

EPS: Fix Bugs in Solar Panel for V2.1

WattsUp, 2019-09-03:
This includes schematic, layout, document, and mCAD updates

- [x] Efficiency does not meet requirements
- [x] ADC does not function properly
- [x] Change solar cell mounting mechanism

Closed 2020-02-16.

Thread 520 (2019-09-03):

COMMS: Fix Schematic Bugs for V1.1

WattsUp, 2019-09-03:
- [x] MOD 7
- [x] ~MOD 8~ The higher band is okay since the loads are small. The higher impedance actually helps
- [x] MOD 9
- [x] ~MOD 10~ Differential modulator driver
- [x] ~MOD 11~ No negative supply
- [x] ~MOD 12~ No negative supply
- [x] ~MOD 13~ No negative supply
- [x] MOD 14
- [x] ~9V regulator does not fully turn off~ No 9V regulator
- [x] New ADC
- [x] ~9V regulator over current~ No 9V regulator
- [x] ~Filter baseband~ Replace baseband analog parts with 27-0005 DAC
- [x] Filter RF carrier
- [x] Separate RF switch from switched 9V rails
- [x] Update backplane
- [x] Change µController to 476RG or 496ZG
- [x] Add LEDs to power rails
- [x] Change clock generators to 3.1V LDO, their oscillator to a lower power one 42-106A, ~bring CE to microcontroller~ changed PC for each 3.1V rail, change Cn to 440nF
- [x]  add output filter to modulators to reduce spurs
- [x] 700mm PA: 65-0011

WattsUp, 2019-11-04:
This is done, being reviewed in #563

Closed 2019-11-04.

Thread 532 (2019-09-15):

Design and manufacture circular tube to hold ferrofluid for Payload.

RyanDorosh, 2019-09-15:
Help members of the Payload team to design a tube to hold a ferrofluid. This will need to be used to test the feasibility of this mechanism to rotate cubsat 2.

RyanDorosh, 2019-10-06:
The tube was designed and tested. It showed that it is possible to move a ferrofluid in such a device and that a metal tube will be necessary for further testing. The next phase is to test the torque the ferrofluid provides.

Closed 2019-10-06.

Thread 535 (2019-09-15):

ENVIRONMENTAL CONTROL - Vacuum Chamber Testing Procedure Radiation

LeviJCarroll, 2019-09-15:
Draft official procedure for using using the vacuum chamber for the radiation simulation. This will be using an electrical circuit configuration including resistors, wires, and a power source to simulate the 3W power that the satellite will experience in LEO.

Major subjects include:
- Safe handling of chamber including startup and shutdown
- Satellite frame with MLI layer to see effectiveness of blanket
- Circuit configuration for power output

mvguerrero, 2019-09-15:
MICROTASK: Update information to include the new safety officer, Dalin

LeviJCarroll, 2019-09-15:
>
>
> MICROTASK: Update information to include the new safety officer, Dalin

It will be added in the first draft of the document; it hasn't been created yet

mvguerrero, 2019-11-17:
Levi is working hard on the final design for the chamber, and intends to post about the goals for the documentation of the device, as it comes together.

Thread 539 (2019-09-22):

ENVIRONMENTAL CONTROL: Review Orbital Equations

mvguerrero, 2019-09-22:
Kevin is here to explain the Oribital Temperature Equations he had made in the past. We are taking notes and pictures of his explanations to further bolster our understanding of how LEO affects our surface temperature.

mvguerrero, 2019-09-22:
Here is the whiteboard writing that Kevin made
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

kevvillarreal, 2019-09-23:
These are the complete calculations used. These come directly from the SMAD.
Because our cube is so small we can assume that the internal temperature will be the same as the external temperature.
Each photo is numbered according to page order.

NOTE: Because the heat flux equations (Qsolar, Qalbedo, etc.) take into account the beta angle inside the cosine, the values are smaller for the flux as beta reaches 45 degrees.

[Calculating Temperature.zip](https://github.com/CougsInSpace/CougSat1-Hardware/files/3640434/Calculating.Temperature.zip)

mvguerrero, 2019-09-26:
This review session was very productive, and allowed new members to understand the existing sheet, and how we can improve its accuracy in the near future. Soon we will modify the sheet to include the anodized surface in our calculations.

Closed 2019-09-26.

Thread 540 (2019-09-22):

ENVIRONMENTAL CONTROL: Research Water Expansion from Freezing

mvguerrero, 2019-09-22:
The water within the payload chamber could freeze between the satilite powering and deployment. We need to know to what factor the water will increase in volume when frozen. The payload team will be able to know how much to account for. The known volume of water which they plan for is 5ml or water. How much more space does it take up when frozen? How much energy does it take to thaw 5ml of water?

mvguerrero, 2019-09-22:
Carson is planning to work on this issue, but he needs to be added to the GitHub first. This comment will be deleted when he does.

mvguerrero, 2019-09-26:
Carson collected a lot of information about his subject. To summarize, the expansion of water should only increase its volume by around 9 percent. For a volume as small as 5ml, the expansion is not very significant. Carson also calculated the energy required to bring 5ml of frozen water back to liquid. Again, this quantity of energy is relatively small, and within power budget. Carson will attach information to this post in future

carson-mock, 2019-09-29:
[Water Thermal Properties.docx](https://github.com/CougsInSpace/CougSat1-Hardware/files/3668170/Water.Thermal.Properties.docx)

Closed 2019-09-26.

Thread 542 (2019-09-22):

PAYLOAD: Conduct 50 deg C High Temperature Continuous Exposure Experiment

PieFilling, 2019-09-22:

PieFilling, 2019-09-22:
Seeds and water were heated to 50 deg C, the water was then supplied to the seeds and left at 50 deg C to assess germination viability.

Closed 2019-09-22.

Thread 549 (2019-09-29):

ENVIRONMENTAL CONTROL- Calculate the difference between an Anodized dark grey bus, and non-Anodized bus.

mvguerrero, 2019-09-29:
Since the aluminum's surface has changed from our previous calculations, we must determine the impact that this decision could have. Simulate a completely annodized aluminum surface to represent an extreme scenario, and compare that to the more reasonable ratio of solar pannels and annodized surface.

Include the previous results which used a shiny aluminum surface as well.

jacob-nichols, 2019-10-13:
With the current calculations:
     - Cold Case Temperature: -10.7 C
     - Hot Case Temperature: -4.4 C

mvguerrero, 2019-10-27:
[Temperature Analysis Update October.xlsx](https://github.com/CougsInSpace/CougSat1-Hardware/files/3776454/Temperature.Analysis.Update.October.xlsx)
This is Jacob's work for the calculations. Other Contributors researched the governing effects, and talked to teams about materials.

Closed 2019-10-27.

Thread 550 (2019-10-06):

Design and Machine a New Tube to Test the Torque of a Ferrofluid Reaction Wheel

RyanDorosh, 2019-10-06:
Design and machine a tube that can hold a ferrofluid to test the torque it can provide. The tube will most likely need to be made of metal so that the fluid won't leak. Assignees will also need to determine a reasonable method to measure the torque. The final results should include the tube and some measurements of the torque.

Closed 2020-10-23.

Thread 552 (2019-10-06):

ENVIRONMENTAL CONTROL- Determining the Source of the Vaccum Chamber Leak

mvguerrero, 2019-10-06:
Something is causing the vaccum chamber to leak slowly. It is most likely coming from the valves, but there's a lot of places it can come from.

mvguerrero, 2019-10-13:
The source of the leak has not been determined. However, the leak as been mitigated enough to begin testing. While in all likelihood the leak is coming from the umbilical, the exact source is still hard to tell.  By periodically running the air pump, we can retain our desired pressure, just with a careful eye on the pressure.

mvguerrero, 2019-11-17:
Somewhere between the metal plates and the valve there is still a very slow leak in the vacuum chamber. Currently, the leak only matters for long term experiments. And it has been determined that the optimal solution would be to run the pump occasional to return the chamber to the desired level.

Closed 2019-11-17.

Thread 553 (2019-10-06):

ENVIRONMENTAL CONTROL- Research Thermal Vaccum Cooling Equipment

mvguerrero, 2019-10-06:
We intend to create a thermal vaccum chamber which can cool a subject to temperatures which simulate the space environment. The largest challenge is selecting one which won't compromise the chamber's integrity. Research methods for cooling which fulfil these requirements.

Thread 554 (2019-10-06):

ENVIRONMENTAL CONTROL- Research Paint Application to Anodized Aluminum Surfaces

mvguerrero, 2019-10-06:
Research methods to apply paint to annodized aluminum surfaces. Keep in mind that no bubbles can form between the paint and aluminum, since they will expand in the space environment. Also be aware of outgassing for whatever method you use.

mvguerrero, 2019-10-13:
Due to the existing rules which NASA has made for Cubesats, applying paint to the "Rails" of the sat would be strictly forbidden. Therefore this issue will close.

Closed 2019-10-14.

Thread 556 (2019-10-13):

ENVIRONMENTAL CONTROL- Prototype Cooling Chamber Components.

mvguerrero, 2019-10-13:
Use Dry Ice and metal wires to conduct a study about how well metal wires can remove heat from a closed system. This method is currently the main way to remove heat from a system for testing purposes, and its efficacy should be tested in the real world.

The current conduction candidates are copper and aluminum. Copper has greater conductance than aluminum, but aluminum is much less expensive.

pteridophobia, 2019-10-20:
We may need to wrap the exposed copper with an insulator to allow the other cool to cool

mvguerrero, 2019-10-27:
The experiment informed us that aluminum would not be the ideal heat conductor for the chamber, and that coiling copper wire could work to remove heat from a system. We will have to source a medium diameter copper wire compatible with our planned system. Additional research should be done to find the exact diameter.
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

Closed 2019-10-27.

Thread 559 (2019-10-24):

Design and 3D Print a Magnetorquer Sandwich for Quinton

RyanDorosh, 2019-10-24:
Communicate with Quinton to design and 3D print out a usable "Magnetorquer Sandwich." Make sure Quinton is satisfied with the end product.

RyanDorosh, 2019-10-27:
Quinton received his "magnetorquer sandwich." Aiden finished it in a timely manner and Quinton seemed to be happy with the final product. If Quinton needs another one there won't be another issue opened for this project.

Closed 2019-10-27.

Thread 561 (2019-11-01):

Research the Pros and Cons for the Different CubeSat Frame Materials

RyanDorosh, 2019-11-01:
Those assigned to this task will have to look up the different metals available to use for the frame of a CubeSat and research their pros and cons. The list of materials is found on the CubeSat documentation. The final result should be a document with a table listing the pros and cons of each material.

RyanDorosh, 2020-01-30:
Aiden made a very nice and professional document with all of the required aspects. The document can be found in the structure google drive.

RyanDorosh, 2020-01-30:
[https://drive.google.com/drive/folders/1jmAtCJqhGFlRFRCnrbF7pzRbSC4_jmXB](url)

Closed 2020-01-30.

Thread 562 (2019-11-01):

Setup a Club 3D-Printer and Make a Training Program to use it

RyanDorosh, 2019-11-01:
This issue is mainly to reward the work done by Aiden to get a club 3D printer. This task requires organizing the setup of the 3D printer and the making of a certification program for members to use it.

RyanDorosh, 2020-02-01:
Aiden finished making the certification program. You can talk with Aiden to get certified on the printer. There is a demonstration and test part of the program.

Closed 2020-02-01.

Thread 564 (2019-11-11):

ENVIRONMENTAL CONTROL- Create Cooling Interface for Thermal Vac Chamber

mvguerrero, 2019-11-11:
A variety of solutions are available to tackle this problem, and the merits and drawbacks of each should be  considered. Develop the best possible cooling interface for the chamber. Consider efficacy, safety, and ease of construction/procurement.

mvguerrero, 2019-11-14:
At the work party, a new arrangement of cooling interface was considered. If the cooling interface is part of the wall of the vacuum chamber, then the conduction distance is reduced immensely. The currently proposed arrangement is a cylindrical device which has a channel within it for coolants to be applied. Diagrams are to be posted soon.

Thread 571 (2020-01-25):

Engineering Drawings For Final Parts

RyanDorosh, 2020-01-25:
Make the engineering drawings of the final parts.
2) Camera bracket (Al) - https://github.com/CougsInSpace/CougSat1-Hardware/blob/master/CougSat1-Payload/CADModel/Native/Payload-Camera_Support.ipt
(1) Backplane nut (Al) - https://github.com/CougsInSpace/CougSat1-Hardware/blob/master/CougSat1-Backplane/CADModel/Native/Backplane_CenterNut.ipt
(2) Battery heatsink (Al) - https://github.com/CougsInSpace/CougSat1-Hardware/blob/master/CougSat1-PowerBoard/CADModel/Native/EPS_BatteryHeatsink.ipt
(1) RBF pin holder (Al) - https://github.com/CougsInSpace/CougSat1-Hardware/blob/master/CougSat1-PowerBoard/CADModel/Native/EPS_RBFPinHolder.ipt
(1) Antenna mount (UHMW or the like) - https://github.com/CougsInSpace/CougSat1-Hardware/blob/master/CougSat1-RadioBoard/CADModel/Native/%2BXPanel_AntennaMount.ipt
(4) Antenna post (brass or copper) - https://github.com/CougsInSpace/CougSat1-Hardware/blob/master/CougSat1-RadioBoard/CADModel/Native/%2BXPanel_AntennaPost.ipt

Closed 2020-10-23.

Thread 572 (2020-01-27):

Rework The Gearbox For The Communications Tower

RyanDorosh, 2020-01-27:
Either switch out the servos currently in the gearbox with ones that will work, or redesign part of the gearbox to allow the current servos to work. Talk with communications to see what they need the tower to do. The final outcome should be a working communications tower.

Closed 2020-10-23.

Thread 573 (2020-01-27):

Create A Basic Design For Cougsat2

RyanDorosh, 2020-01-27:
Using Cougsat1 and the official CubeSat documentation to create a base design for Cougsat2 that will be refined in the future. Talk with payload to get an understanding of how much space should be devoted to their project. The final result should be a SolidWorks assembly of the frame.

RyanDorosh, 2021-09-21:
This project was completed before the pandemic. The 3D-printed model is in the club room. The design was based on a comerical 3-U CubeSat frame.

Closed 2021-09-21.

Thread 579 (2020-02-11):

EPS: Fix Schematic Errors for V3.1

WattsUp, 2020-02-11:
- [x] MOD-016
- [x] MOD-017
- [x] MOD-018
- [x] MOD-021

Closed 2020-02-23.

Thread 582 (2020-02-11):

BACKPLANE: Adjust board outline for deployment switches for V3.2

WattsUp, 2020-02-11:

WattsUp, 2020-02-23:
Fixed in #583

Closed 2020-02-23.

Thread 590 (2020-04-03):

Laser Cut Low Outgassing Plastic Cutout For Satellite

colinwarn, 2020-04-03:
Find a low outgassing material that can be preferable cutout by a laser cutter. If you can't, no worries we'll just CNC mill it.

CubeSat Design Specification, Page 8, 3.1.8.1 and 3.1.8.2 have the "low outgassing" definitions:
https://www.cubesat.org/resources

You'll find this link helpful for looking up materials:
https://outgassing.nasa.gov/

Cutout should be 0.5mm thick. It need to takeup the full red area as seen in this picture. Holes slightly larger than the ones within it's box must be cut so that the components can continue to stick through:
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

gregstolte, 2020-04-06:
Material is Lexan polycarbonate sheet

[STR_px_Plastic_Cover.zip](https://github.com/CougsInSpace/CougSat1-Hardware/files/4441114/STR_px_Plastic_Cover.zip)

colinwarn, 2020-04-17:
https://workbench.grabcad.com/workbench/projects/gcZyVL8e3jBFst25EMOCFOSOSSCCtw5Og6qSO3SCIElLVA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

Closed 2020-04-17.

Thread 591 (2020-10-23):

Create a Final Assembly Procedure Document for CougSat-I

colinwarn, 2020-10-23:
The final hardware version of CougSat-I has been finished. An assembly procedure needs to be created for us to follow early next when we begin putting this together.  Here are the tasks that need to be done in order to complete this issue:

-  Remate the Solidworks model. There are some undefined mates still open in the final version.
- Add the pX plastic cover part to the Solidworks assembly.
- Add the boards to the backplane. See this following model for boards (LINK TO BE ADDED).
- Create a step by step procedure. Will likely involve an exploded view, as well as a bill of materials.

Solidworks model:
https://workbench.grabcad.com/workbench/projects/gcZyVL8e3jBFst25EMOCFOSOSSCCtw5Og6qSO3SCIElLVA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

Thread 595 (2021-09-05):

PAYLOAD - Mount and Integrate All Satellite Components

colinwarn, 2021-09-05:
-Mounting all of the following components:

-Deployment System
-CO2 Sensor
-Blue and red LEDS. Small ones B.
-Pass through.
-Camera
-Nutrient substrates (cotton balls, plant vitamins),
-Pressure sensor
-Heating resistor
-Temperature.

Thread 596 (2021-09-05):

PAYLOAD - Leak Test

colinwarn, 2021-09-05:
Place chamber into a vacuum chamber, then using the sensor's inside of the chamber determine leak rate.
