CougsInSpace/CougSat1-Hardware/CougSat1-AvionicBoard/Documentation/Avionics.pdf

## I²C

RF

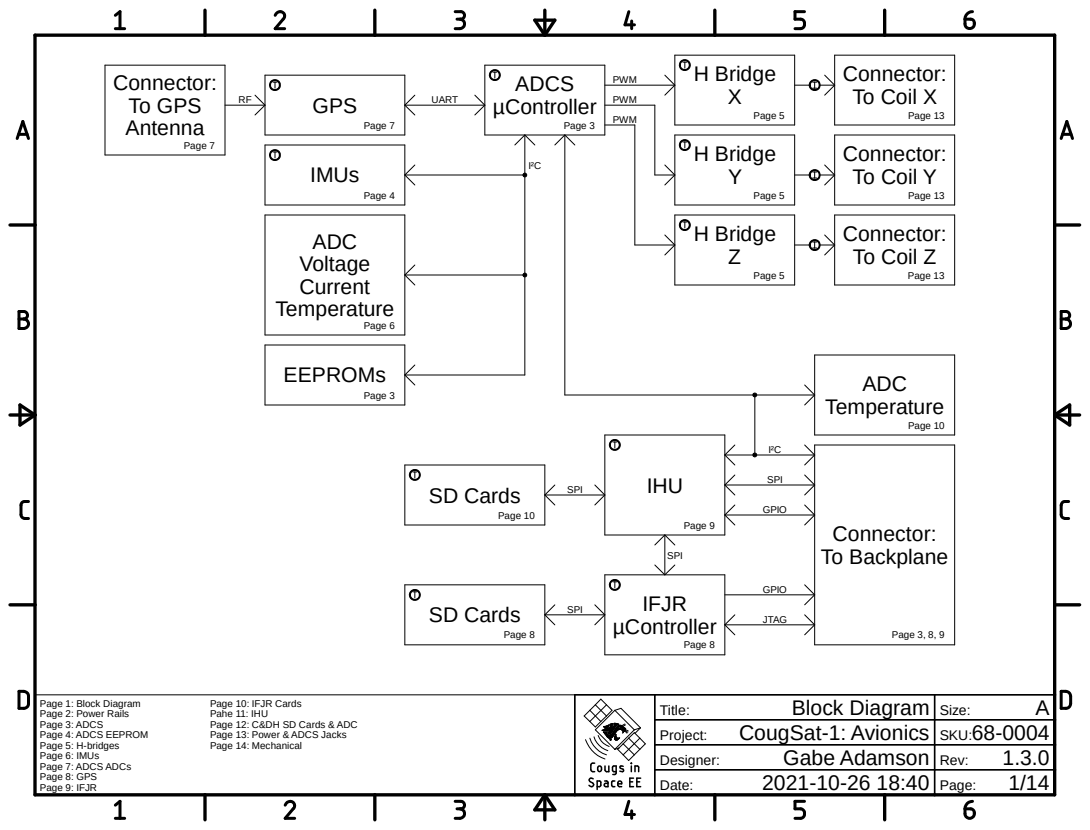
[picture p215: page 1]
PWM; UART; SPI; I²C; JTAG; GPIO; Page 3; Page 4; Page 5; Page 13; Page 6; Page 7; Page 8; Page 9; Page 10; Page 3, 8, 9; ADCS; GPS; µController; IMUs; EEPROMs; ADC Voltage Current Temperature; H Bridge X; H Bridge Y; H Bridge Z; Connector: To Coil X; Connector: To Coil Y; Connector: To Coil Z; Connector: To GPS Antenna; Connector: To Backplane; IFJR; ADC Temperature

IHU SD Cards

µController SD Cards

Page 1: Block Diagram Page 10: IFJR Cards Page 2: Power Rails Pahe 11: IHU Page 3: ADCS Page 12: C&DH SD Cards & ADC Page 4: ADCS EEPROM Page 13: Power & ADCS Jacks Page 5: H-bridges Page 14: Mechanical Page 6: IMUs Page 7: ADCS ADCs Page 8: GPS Page 9: IFJR | Block Diagram Title: | A Size:

CougSat-1: Avionics Project: | 68-0004 SKU:
Gabe Adamson Designer: | 1.3.0 Rev:
2021-10-26 18:40 Date: | 1/14 Page:

## PR_3.3V-0

IHU | C&DH

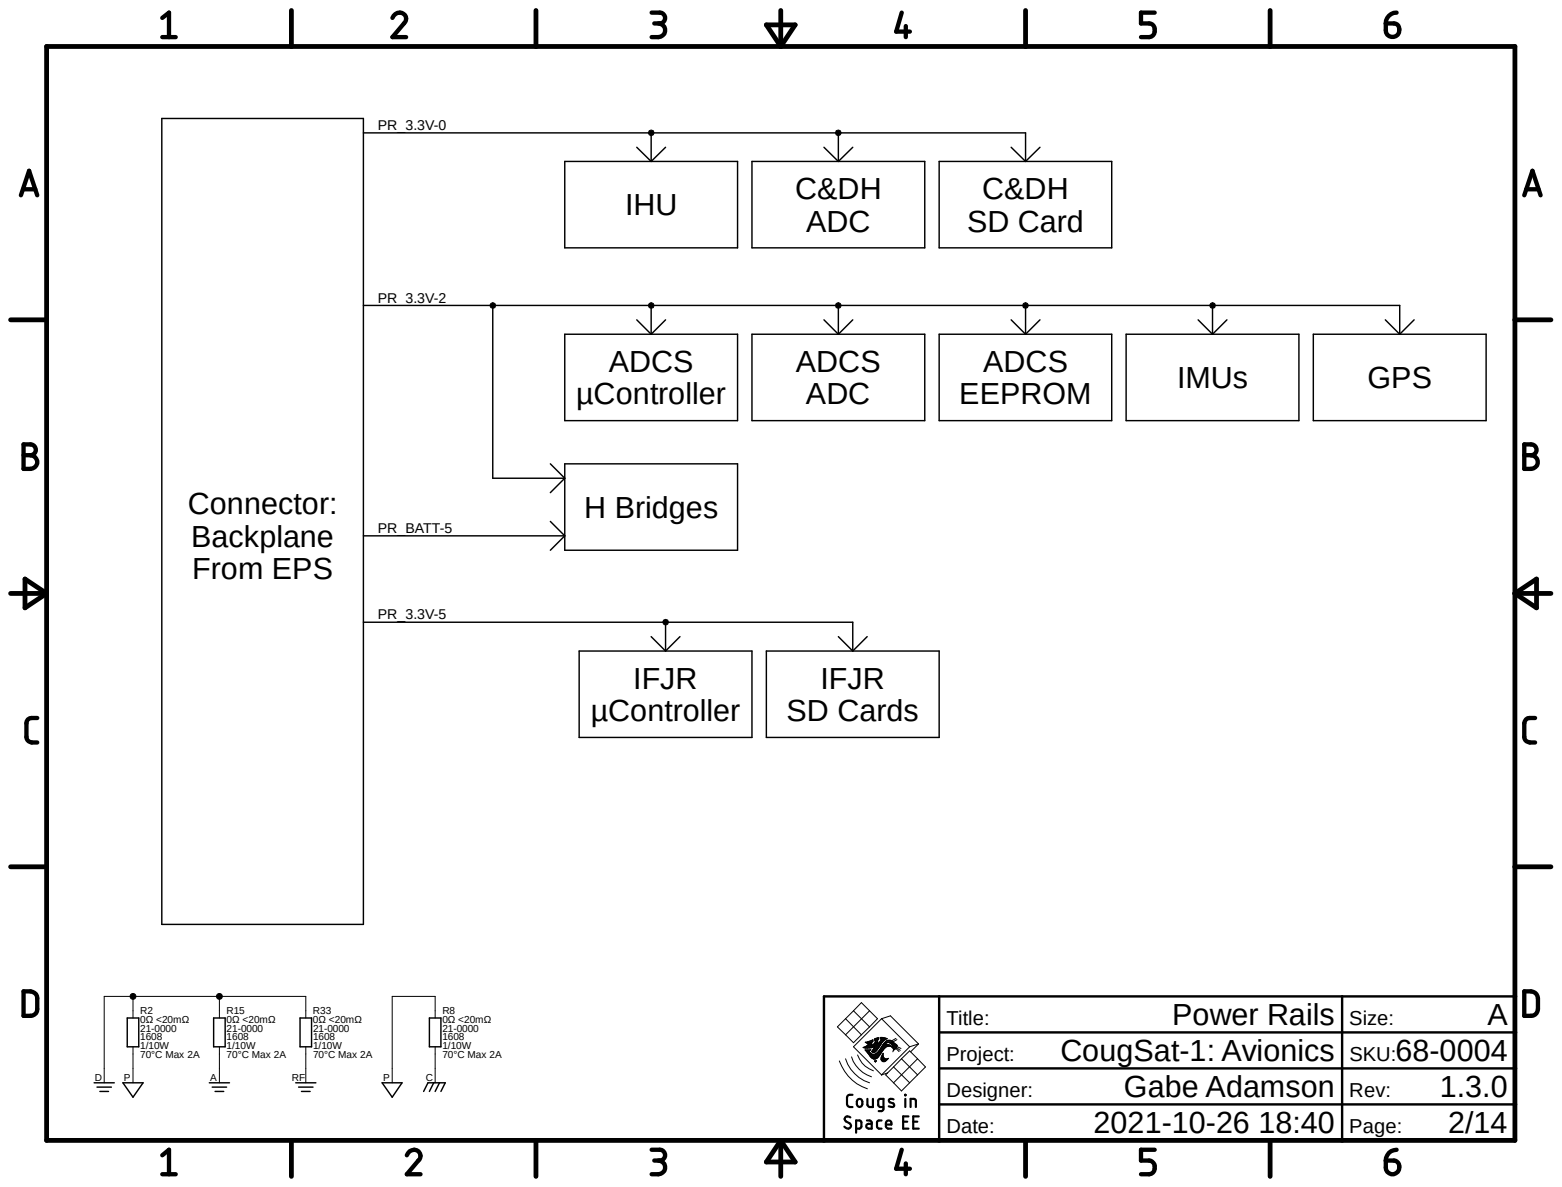
[picture p216: page 2]
PR_BATT-5; 1608 1/10W 70°C Max 2A; Connector: Backplane From EPS; SD Card; IMUs; GPS; IFJR µController; IFJR SD Cards; H Bridges; C&DH ADC; ADCS ADC; ADCS µController; ADCS EEPROM

Power Rails Title: | A Size:
CougSat-1: Avionics Project: | 68-0004 SKU:
Gabe Adamson Designer: | 1.3.0 Rev:

## CAD Note: Decoupling

61-0002

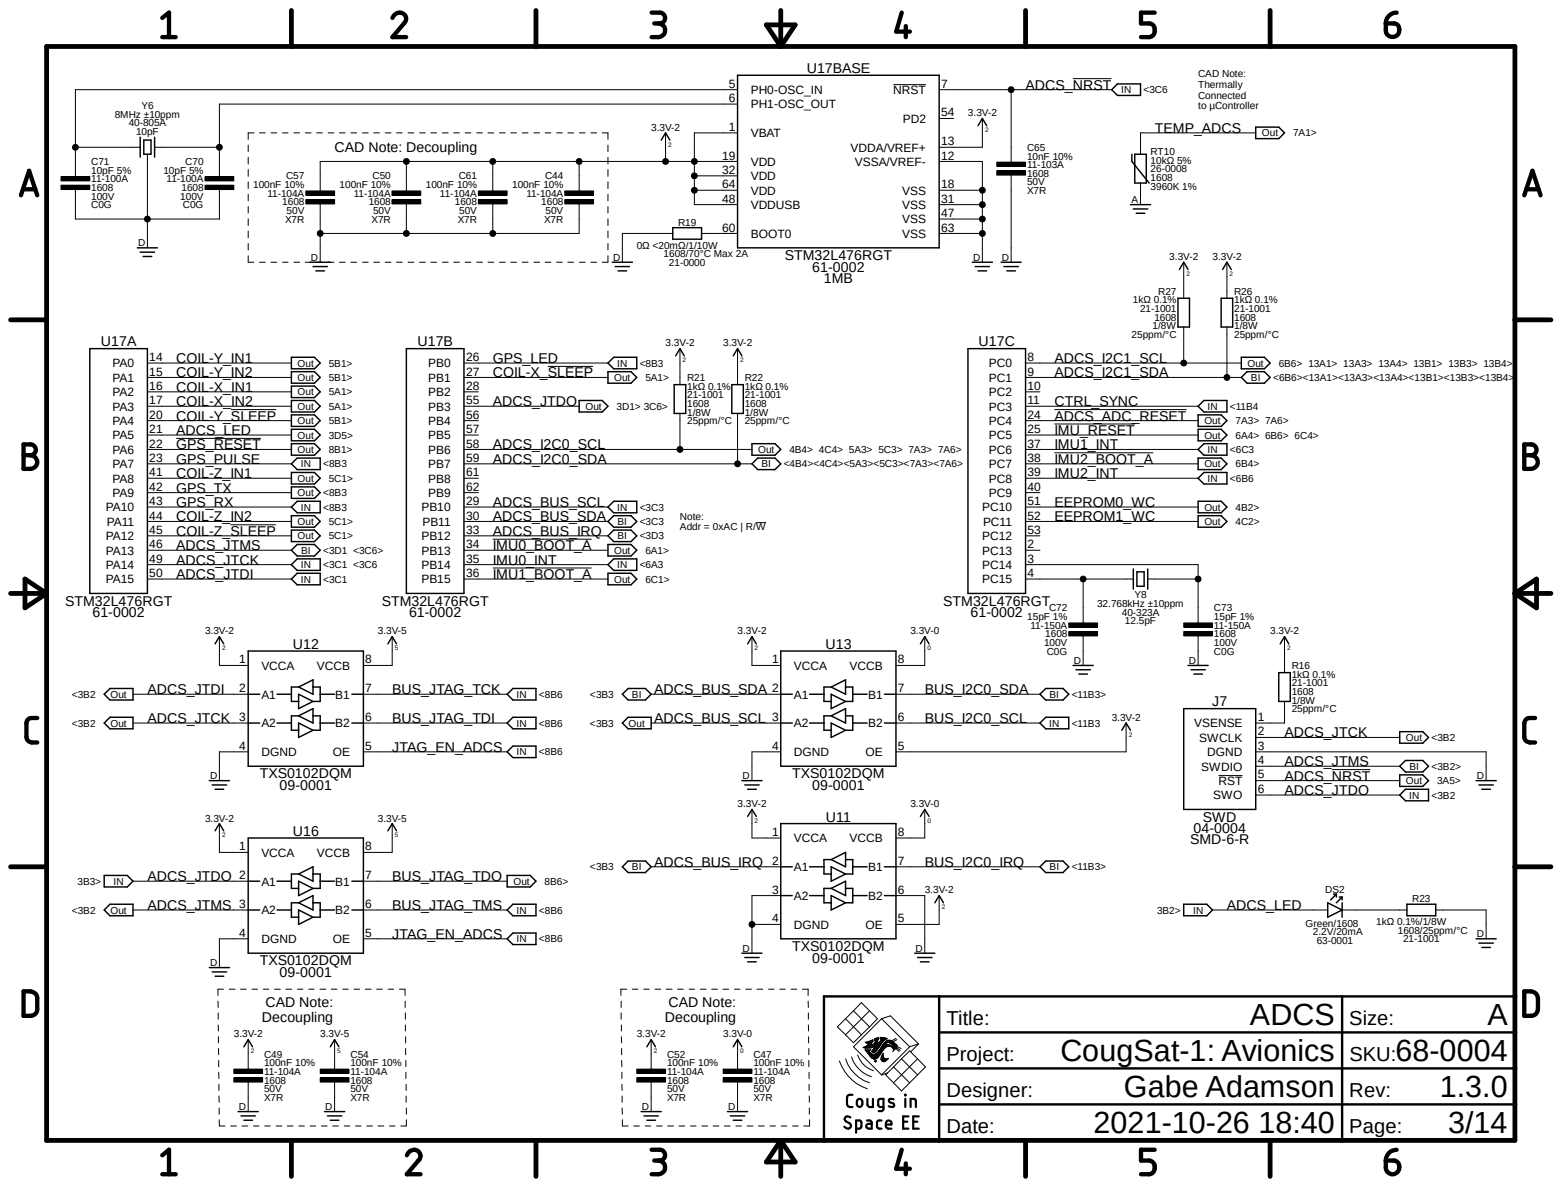
[picture p217: page 3]

CAD Note: Thermally Connected

ADCS Title: | A Size:
CougSat-1: Avionics Project: | 68-0004 SKU:
Gabe Adamson Designer: | 1.3.0 Rev:

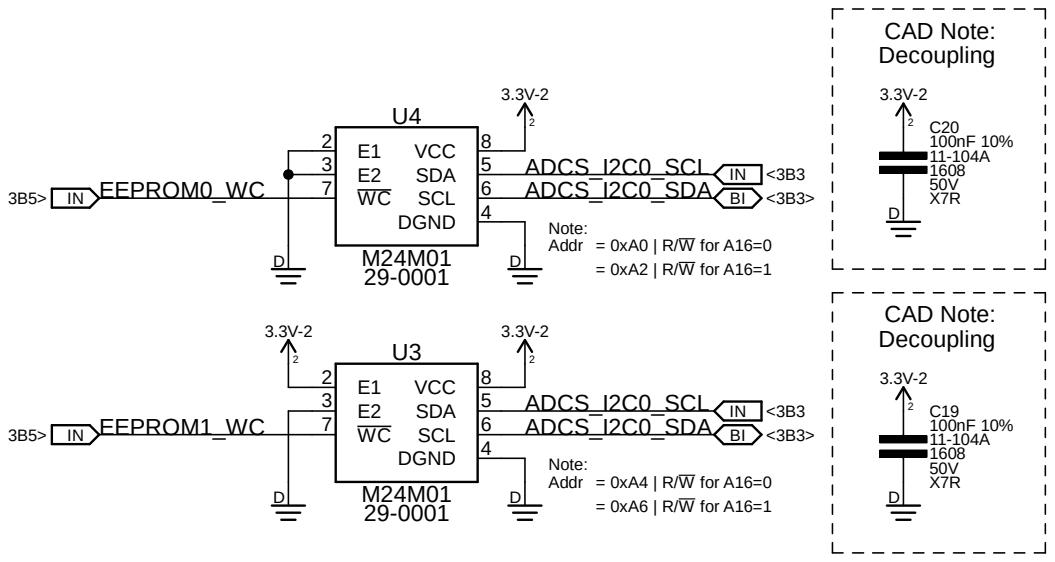
[picture p218: page 4]
CAD Note: Decoupling; CAD Note:; = 0xA2 | R/W for A16=1; = 0xA6 | R/W for A16=1; SCL; 6 DGND; 4 VCC; 8 SDA; C20 C19 ADCS_I2C0_SCL; ADCS_I2C0_SCL ADCS_I2C0_SDA; EEPROM0_WC; EEPROM1_WC

ADCS_I2C0_SDA
Decoupling Note: Addr
= 0xA0 | R/W for A16=0 Note: Addr
= 0xA4 | R/W for A16=0 D

ADCS EEPROM Title: | A Size:
CougSat-1: Avionics Project: | 68-0004 SKU:
Gabe Adamson Designer: | 1.3.0 Rev:

## CAD Note: Decoupling

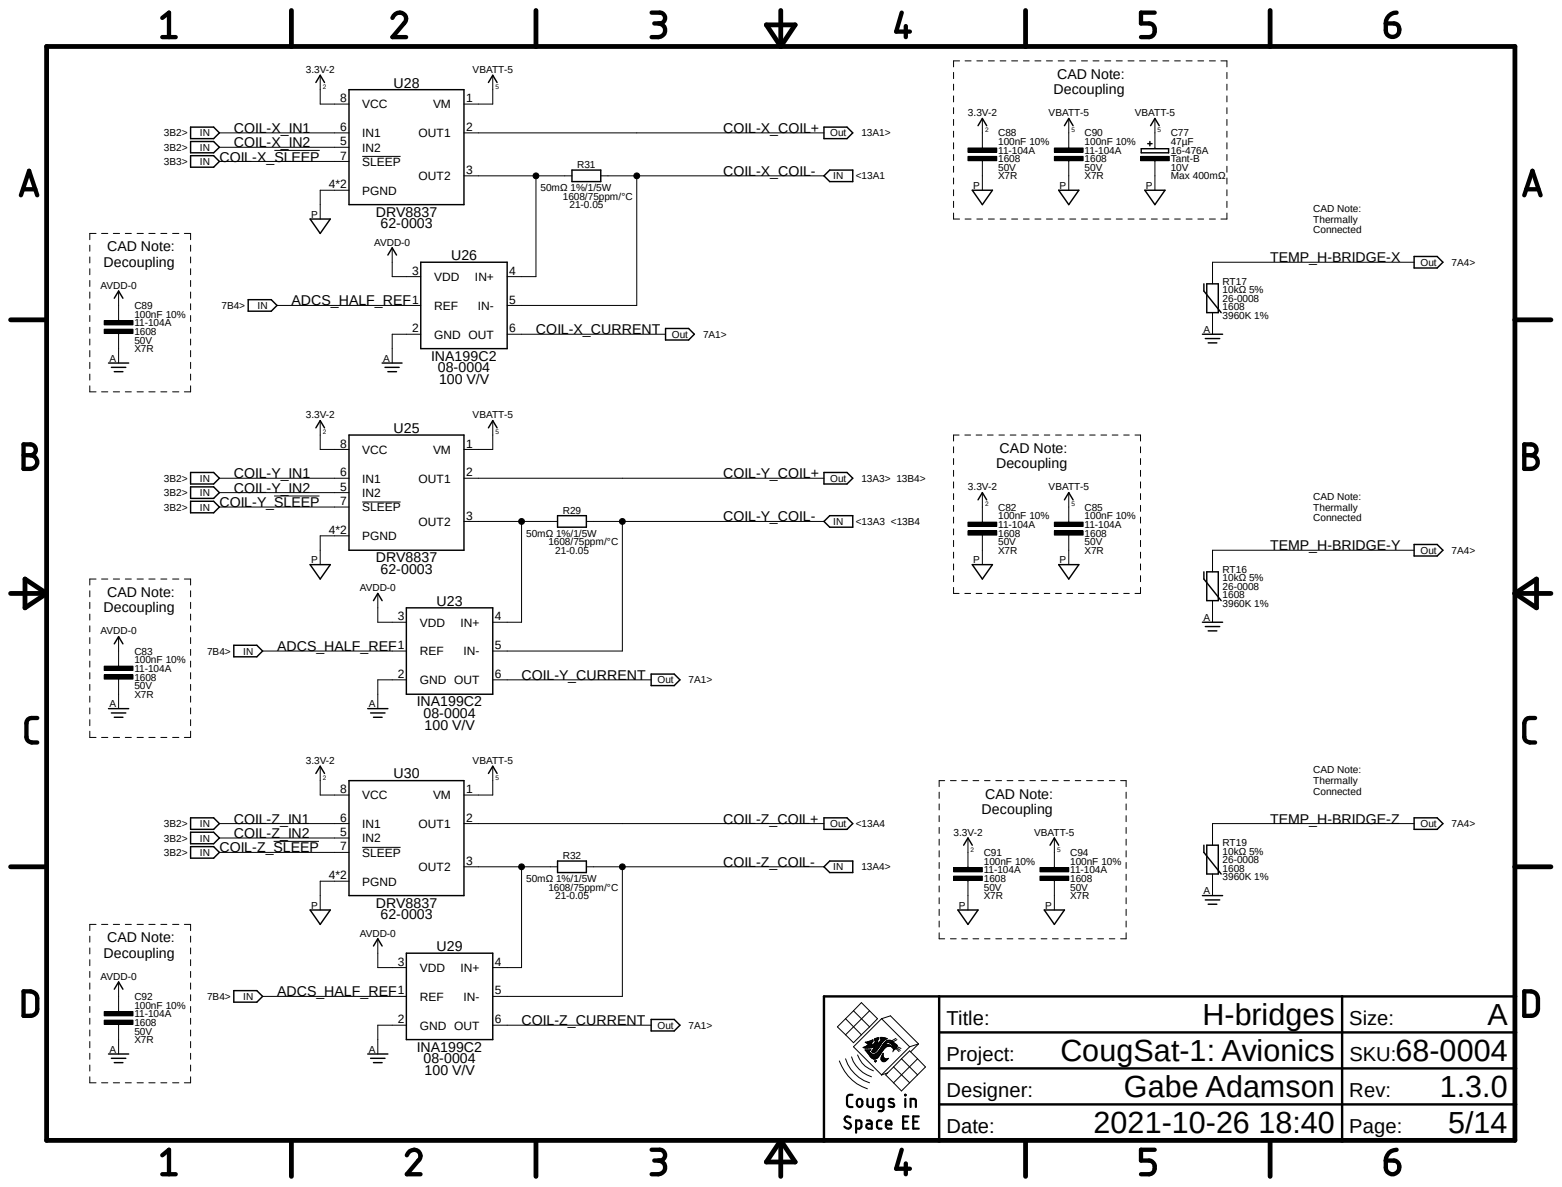
[picture p219: page 5]

CAD Note: Thermally Connected

7A4> CAD Note: Thermally Connected

H-bridges Title: | A Size:
CougSat-1: Avionics Project: | 68-0004 SKU:
Gabe Adamson Designer: | 1.3.0 Rev:

## Note: Addr = 0x28 | R/W

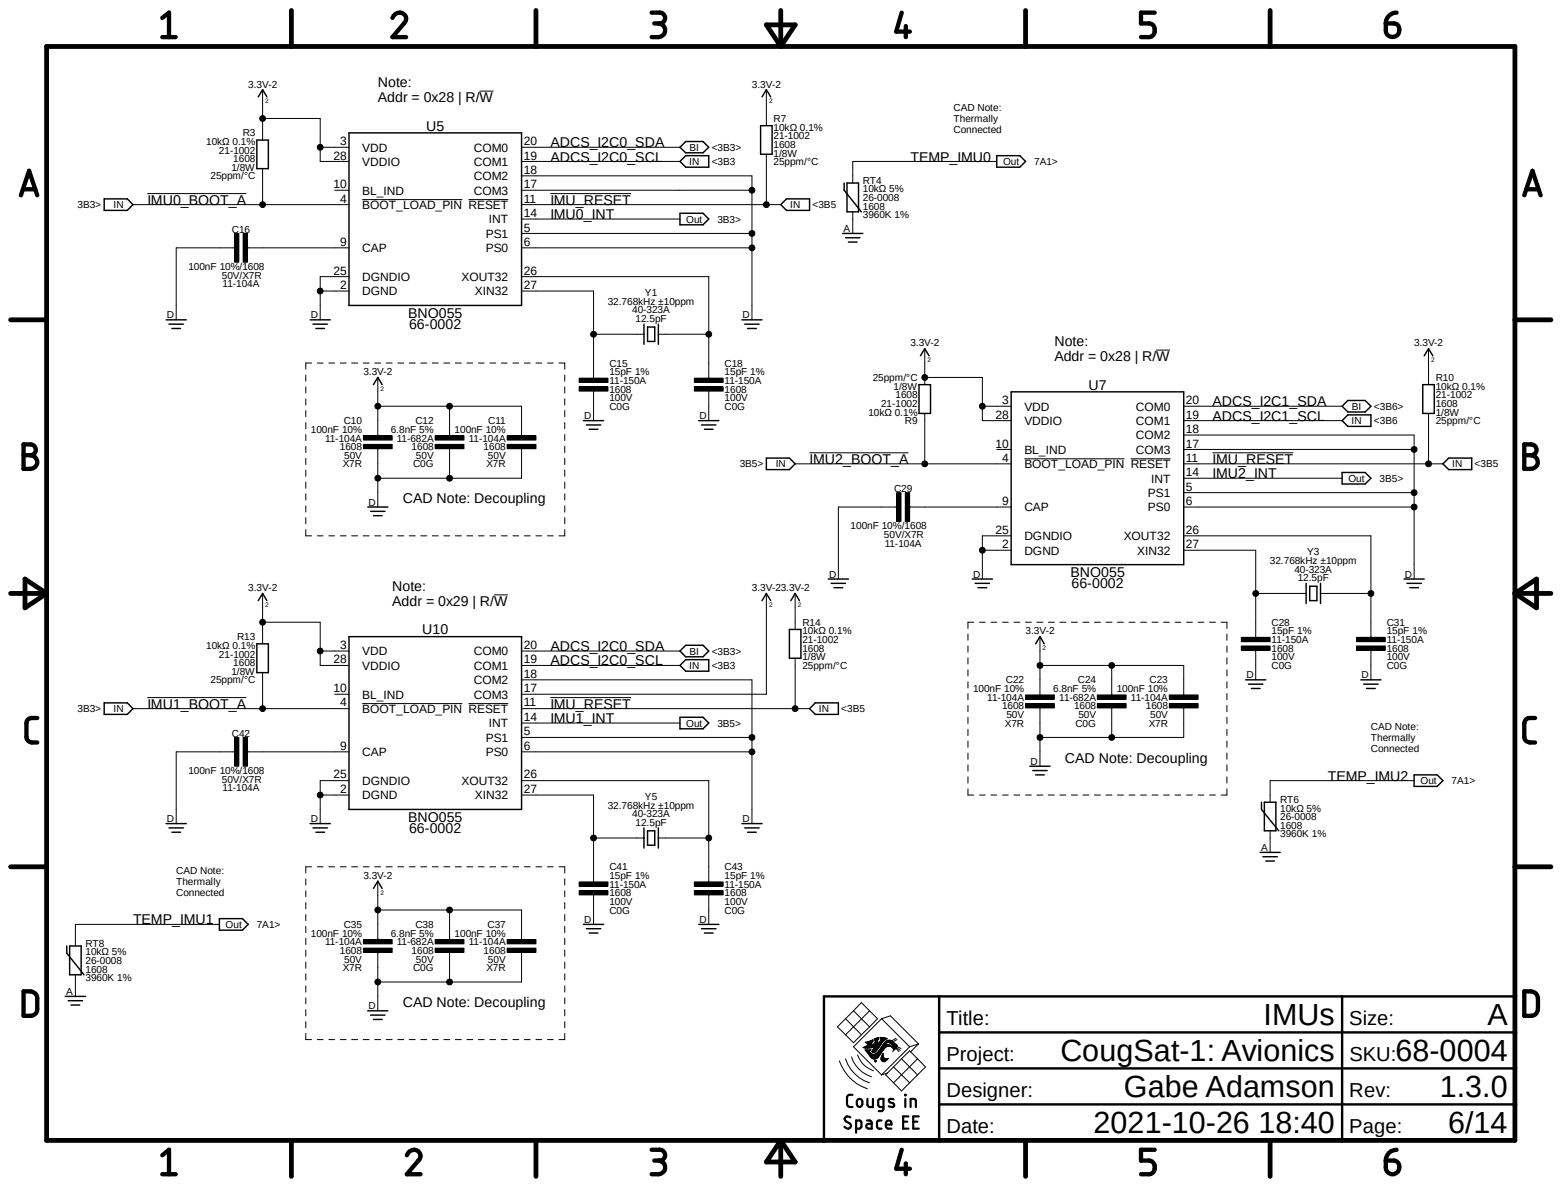
[picture p220: page 6]

CAD Note: Thermally Connected

IMUs Title: | A Size:
CougSat-1: Avionics Project: | 68-0004 SKU:
Gabe Adamson Designer: | 1.3.0 Rev:

## COIL-X_CURRENT COIL-Y_CURRENT

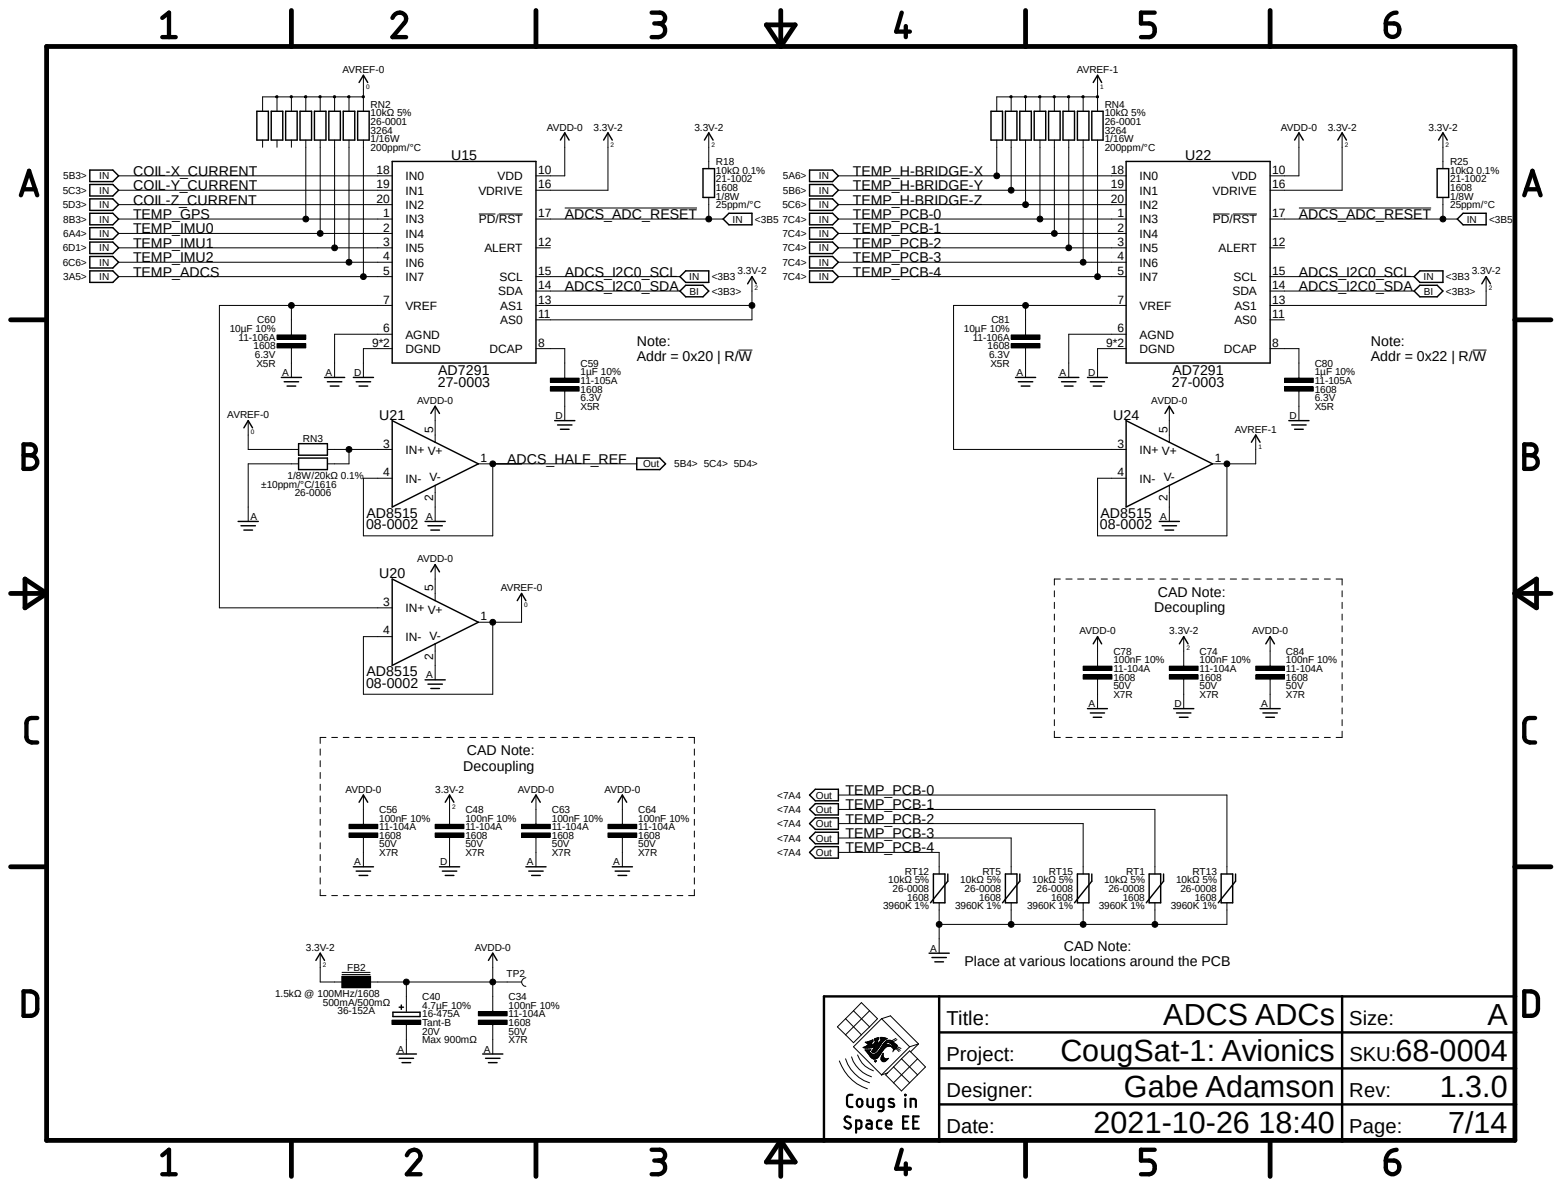
[picture p221: page 7]

Place at various locations around the PCB

ADCS ADCs Title: | A Size:
CougSat-1: Avionics Project: | 68-0004 SKU:
Gabe Adamson Designer: | 1.3.0 Rev:

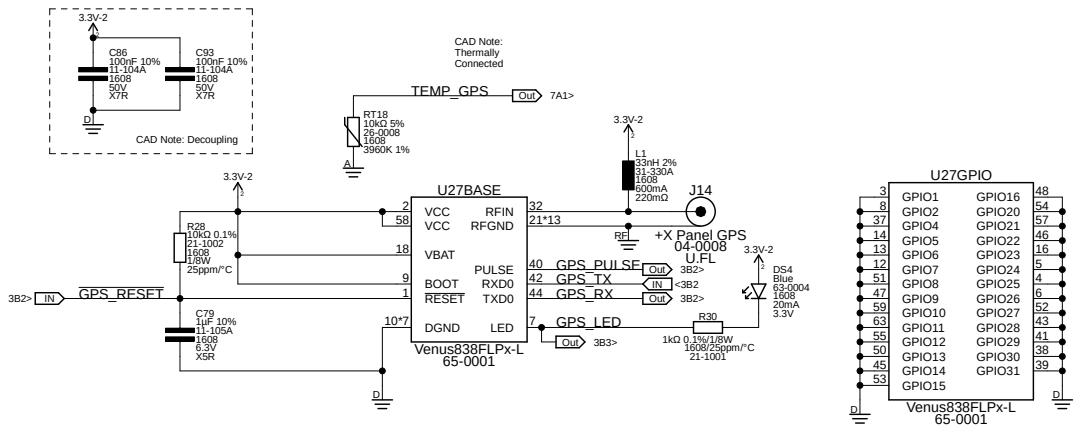
[picture p222: page 8]
/ 1608/1/8W 25ppm/°C 21-1001; D Out Out IN Out; Out; 1608 1/8W 25ppm/°C; Venus838FLPx-L; +X Panel GPS; U.FL VCC 2; VCC 58; DGND 10*7; RFGND; 21*13 RXD0; 42 TXD0; 44 RESET 1; LED; 7 BOOT 9; VBAT 18; RFIN; 32 PULSE; 40 U27BASE; GPIO1 3; GPIO25; 4 GPIO24; 5 GPIO26; 6 GPIO2 8; GPIO6 13; GPIO5 14; GPIO23; 16 GPIO4 37; GPIO30; 38 GPIO31; 39 GPIO29; 41 GPIO22; 46 GPIO28; 43 GPIO14 45; GPIO9 47; GPIO16; 48 GPIO13 50; GPIO8 51; GPIO27; 52 GPIO15 53; GPIO20; 54 GPIO12 55; GPIO21; 57 GPIO10 59; GPIO11 63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

CAD Note: Thermally Connected

CAD Note: Decoupling

GPS Title: | A Size:
CougSat-1: Avionics Project: | 68-0004 SKU:
Gabe Adamson Designer: | 1.3.0 Rev:

## CAD Note: Decoupling

61-0002

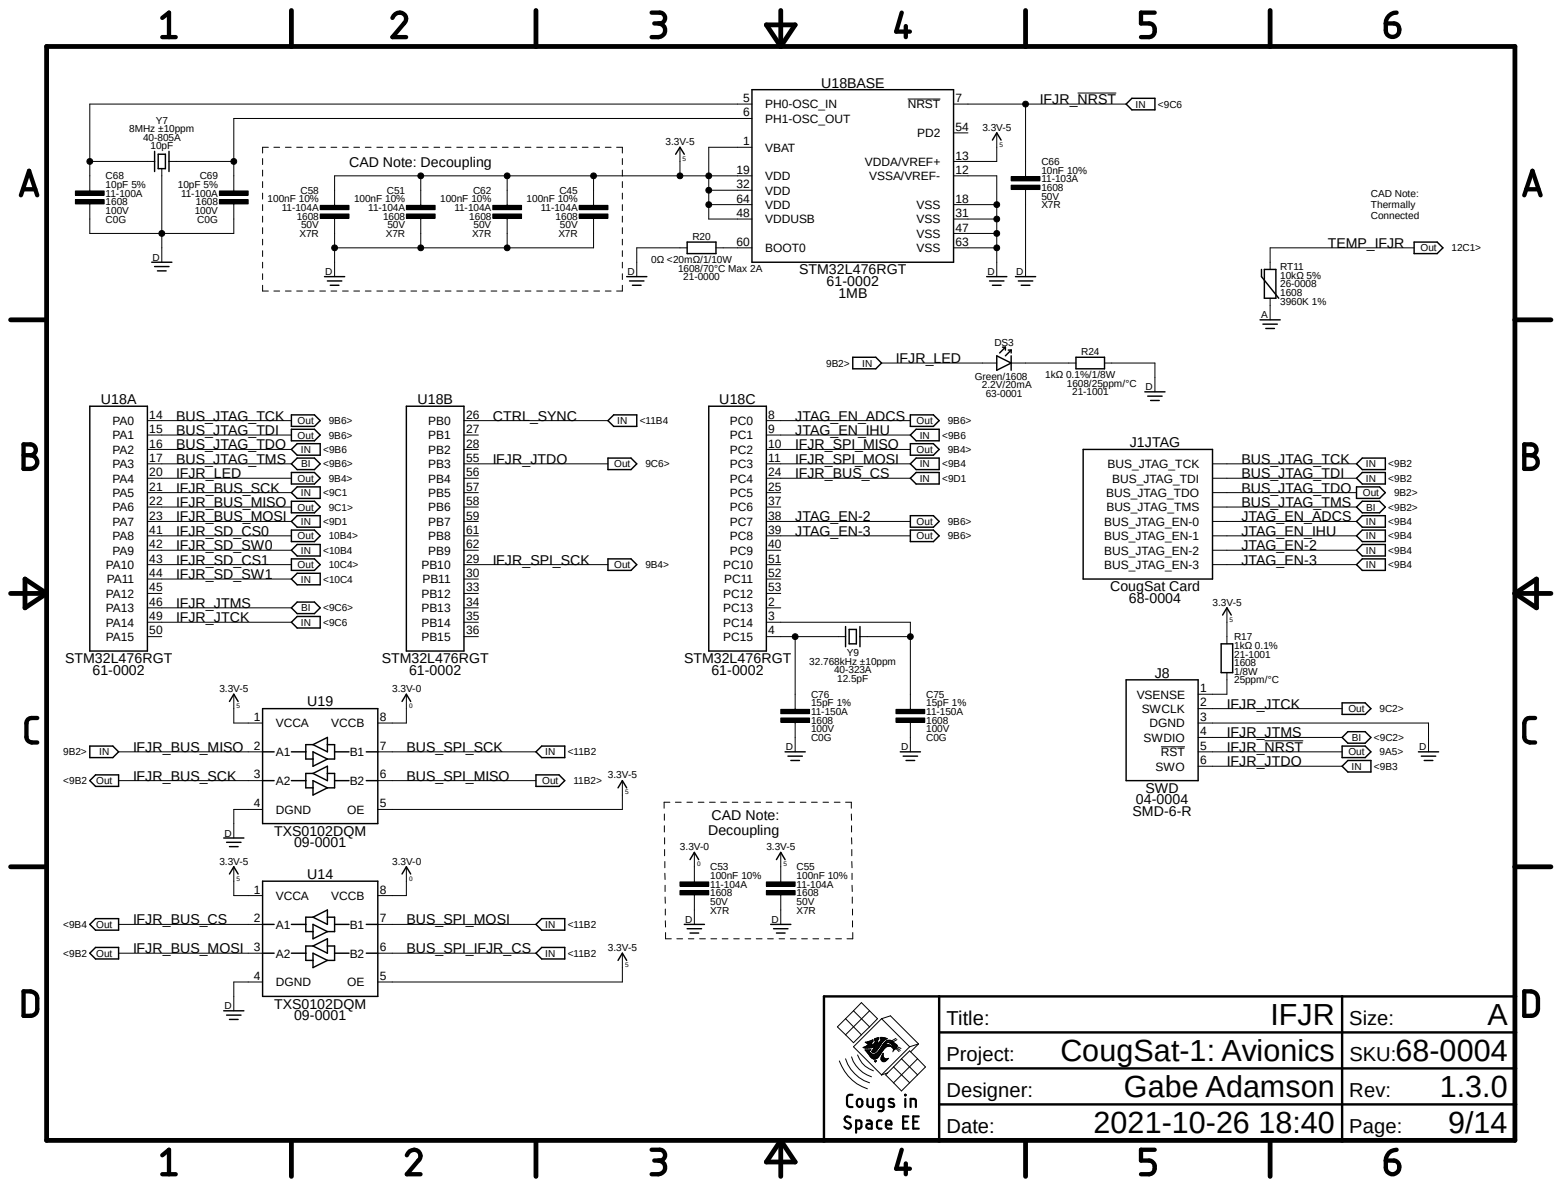
[picture p223: page 9]

IFJR Title: | A Size:
CougSat-1: Avionics Project: | 68-0004 SKU:
Gabe Adamson Designer: | 1.3.0 Rev:

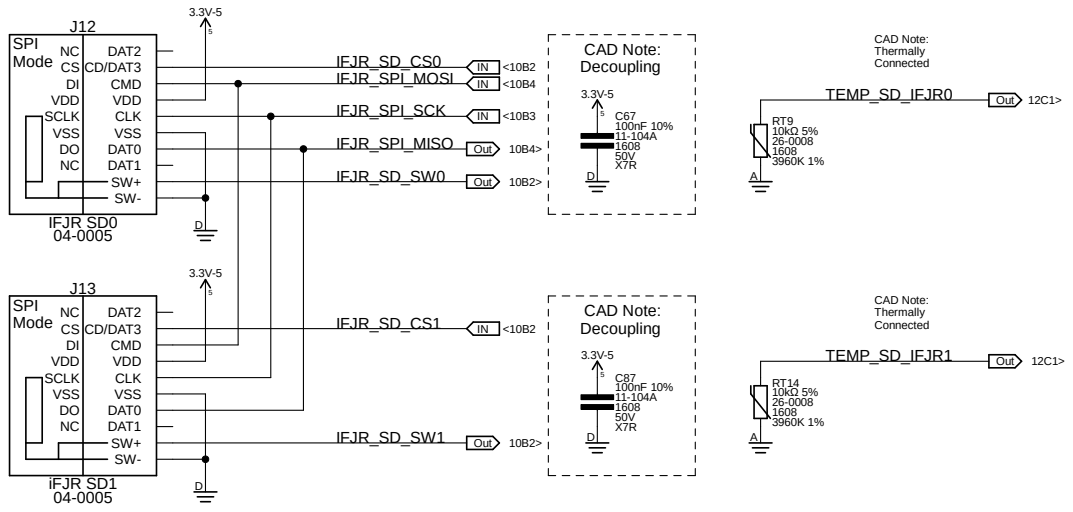
[picture p224: page 10]
CAD Note: Decoupling; CAD Note: Thermally Connected; 12C1> NC CSDI VDD; SCLK VSS DO; SPI Mode; SPI; Mode; INOut Out Out; Out; iFJR SD1 04-0005; IFJR SD0 04-0005; DAT2 CD/DAT3 CMD; VDD CLK; VSS DAT0 DAT1 SW+ SW- J12; IFJR_SD_CS0; IFJR_SD_SW0; IFJR_SD_CS1; IFJR_SD_SW1; IFJR_SPI_SCK; IFJR_SPI_MISO; IFJR_SPI_MOSI; TEMP_SD_IFJR0; TEMP_SD_IFJR1

VSS DAT0 DAT1 SW+ SW- J13 DAT2 CD/DAT3 CMD
CSDI VDD

12C1> CAD Note: Thermally Connected

IFJR Cards Title: | A Size:
CougSat-1: Avionics Project: | 68-0004 SKU:
Gabe Adamson Designer: | 1.3.0 Rev:

## CAD Note: Decoupling

61-0002

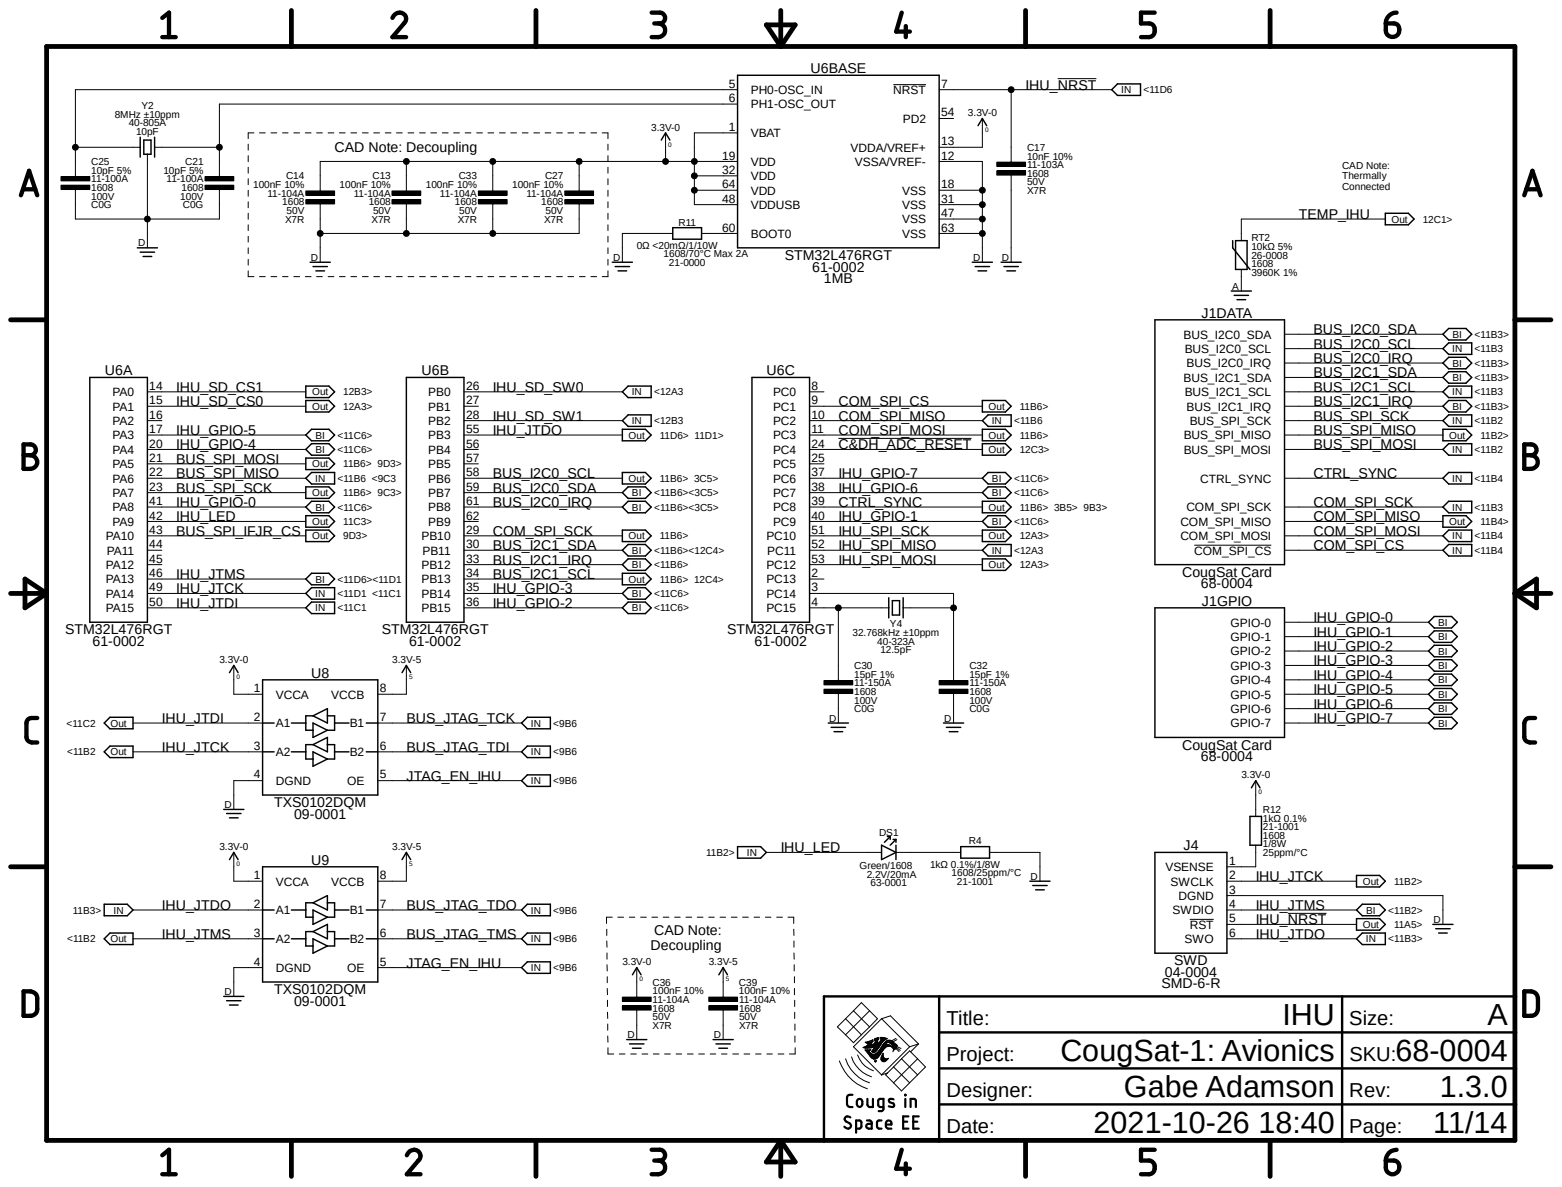
[picture p225: page 11]

CAD Note: Thermally Connected

BUS_I2C0_SDA | INOut BI IHU_GPIO-6

IHU_GPIO-0 | BUS_I2C0_IRQ

IHU Title: | A Size:
CougSat-1: Avionics Project: | 68-0004 SKU:
Gabe Adamson Designer: | 1.3.0 Rev:

## CAD Note: Decoupling

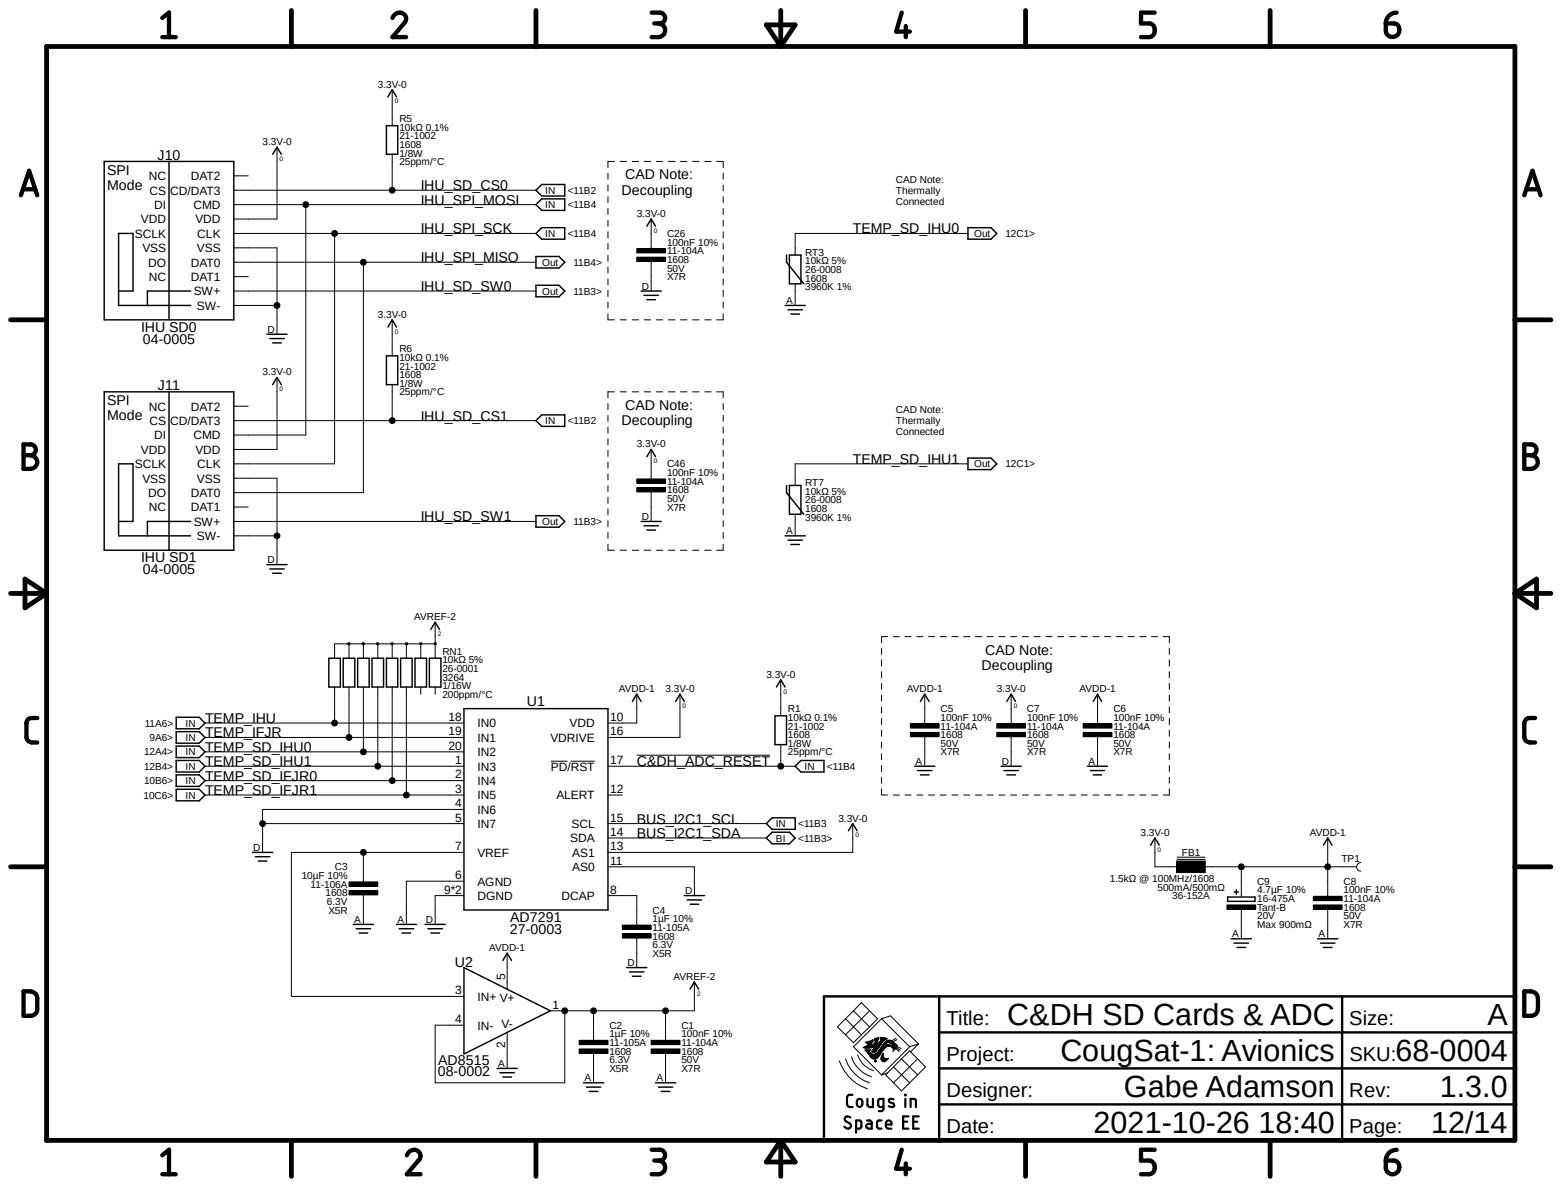
[picture p226: page 12]

VSS DAT0 DAT1 SW+ SW- J11 DAT2 CD/DAT3 CMD
CSDI VDD

CAD Note: Thermally Connected

12C1> CAD Note: Thermally Connected

C&DH SD Cards & ADC Title: | A Size:
CougSat-1: Avionics Project: | 68-0004 SKU:
Gabe Adamson Designer: | 1.3.0 Rev:

04-0001

## PicoLock

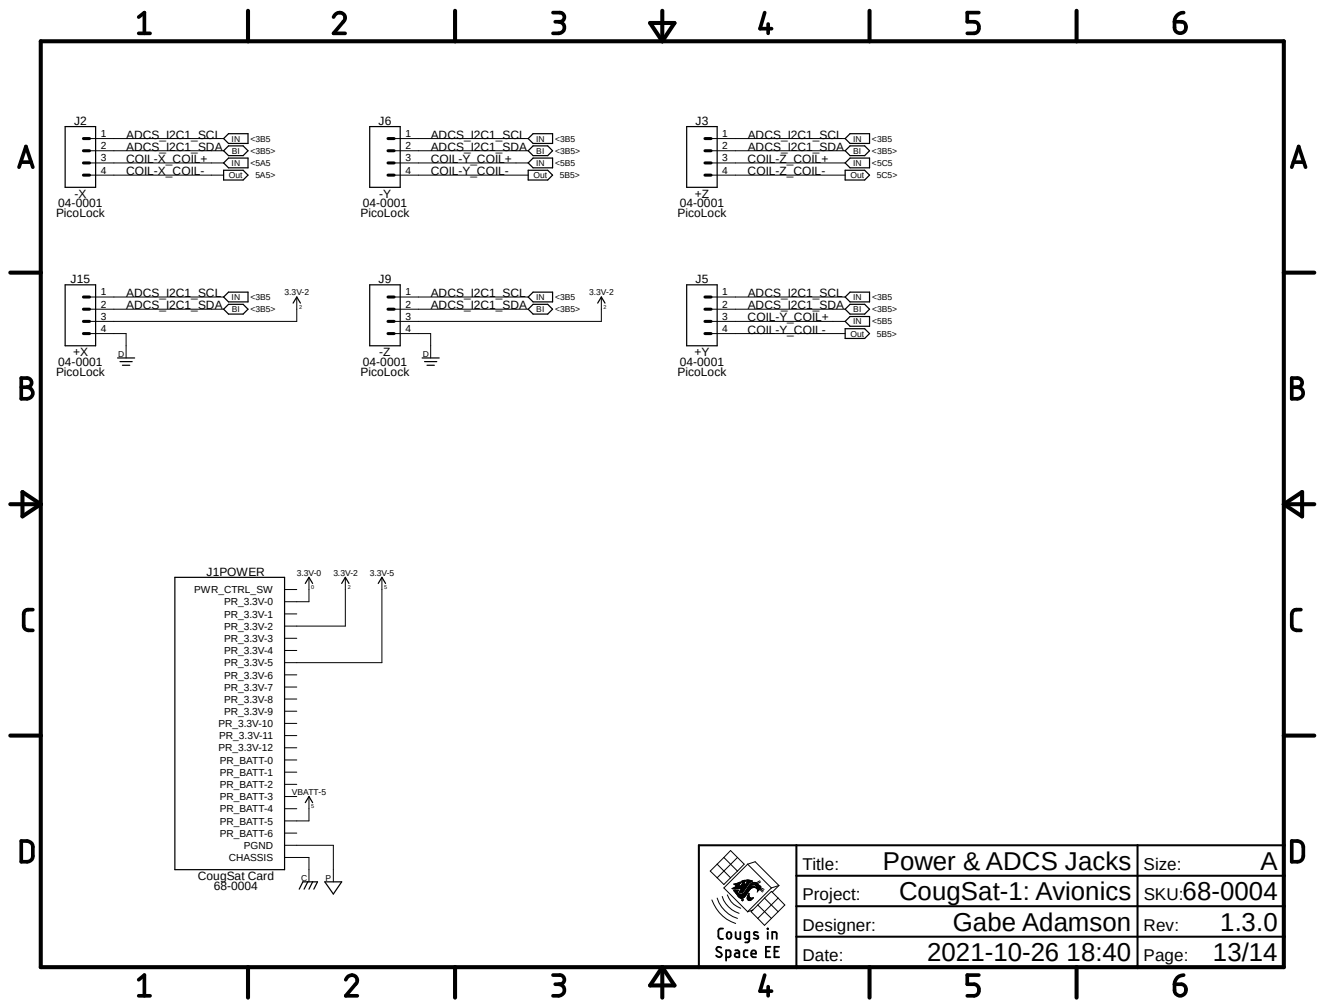
[picture p227: page 13]
04-0001 PicoLock; IN Out; Out; Out BI; INOut; 3.3V-2 VBATT-5; CougSat Card; PR_3.3V-0 PR_3.3V-1 PR_3.3V-2 PR_3.3V-3 PR_3.3V-4 PR_3.3V-5 PR_3.3V-6 PR_3.3V-7 PR_3.3V-8 PR_3.3V-9 PR_3.3V-10 PR_3.3V-11 PR_3.3V-12 PR_BATT-0 PR_BATT-1 PR_BATT-2 PR_BATT-3 PR_BATT-4 PR_BATT-5 PR_BATT-6 PGND; PWR_CTRL_SW; CHASSIS; J1POWER; COIL-X_COIL+ COIL-X_COIL-; COIL-Y_COIL+; COIL-Y_COIL-; COIL-Z_COIL+ COIL-Z_COIL-; ADCS_I2C1_SCL; ADCS_I2C1_SDA

Power & ADCS Jacks Title: | A Size:
CougSat-1: Avionics Project: | 68-0004 SKU:
Gabe Adamson Designer: | 1.3.0 Rev:

J1MECH-TOP | J1MECH-BOTTOM

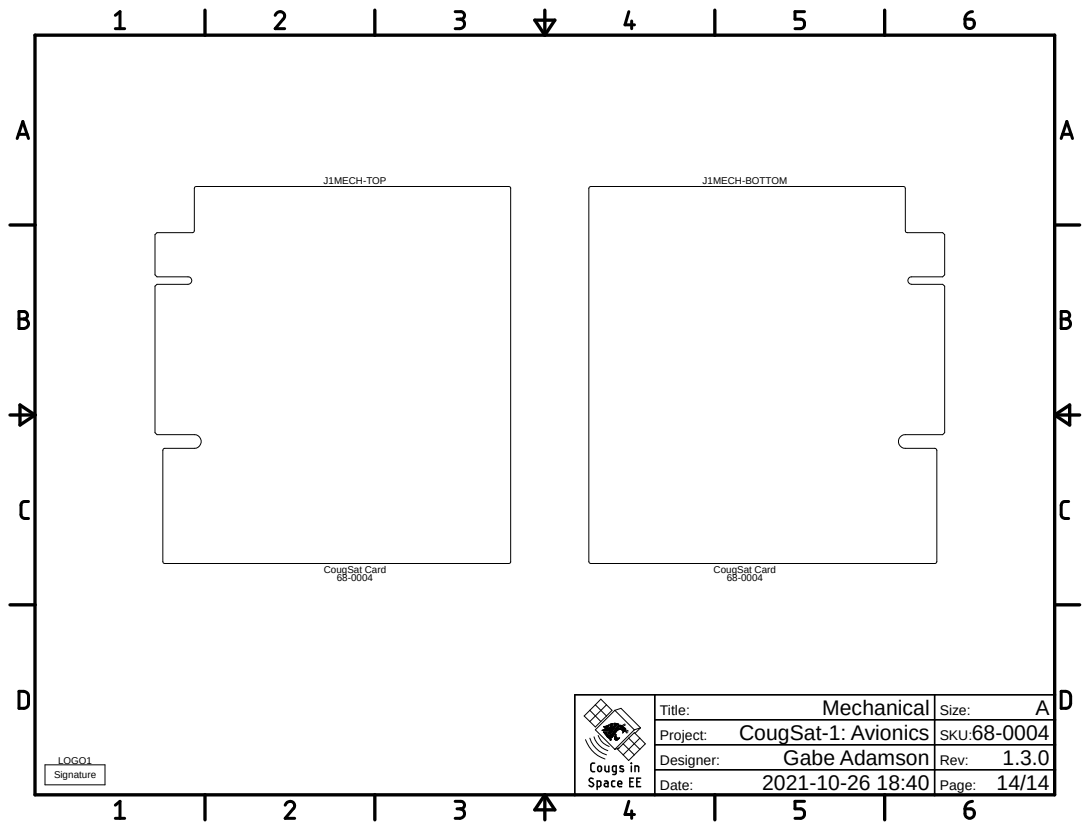
[picture p228: page 14]
68-0004 CougSat Card; CougSat Card; LOGO1 Signature

Mechanical Title: | A Size:
CougSat-1: Avionics Project: | 68-0004 SKU:
Gabe Adamson Designer: | 1.3.0 Rev:
