CougsInSpace/CougSat1-Hardware/CougSat1-PowerBoard/Documentation/EPS.pdf

## 4.1V CC

## Page 4

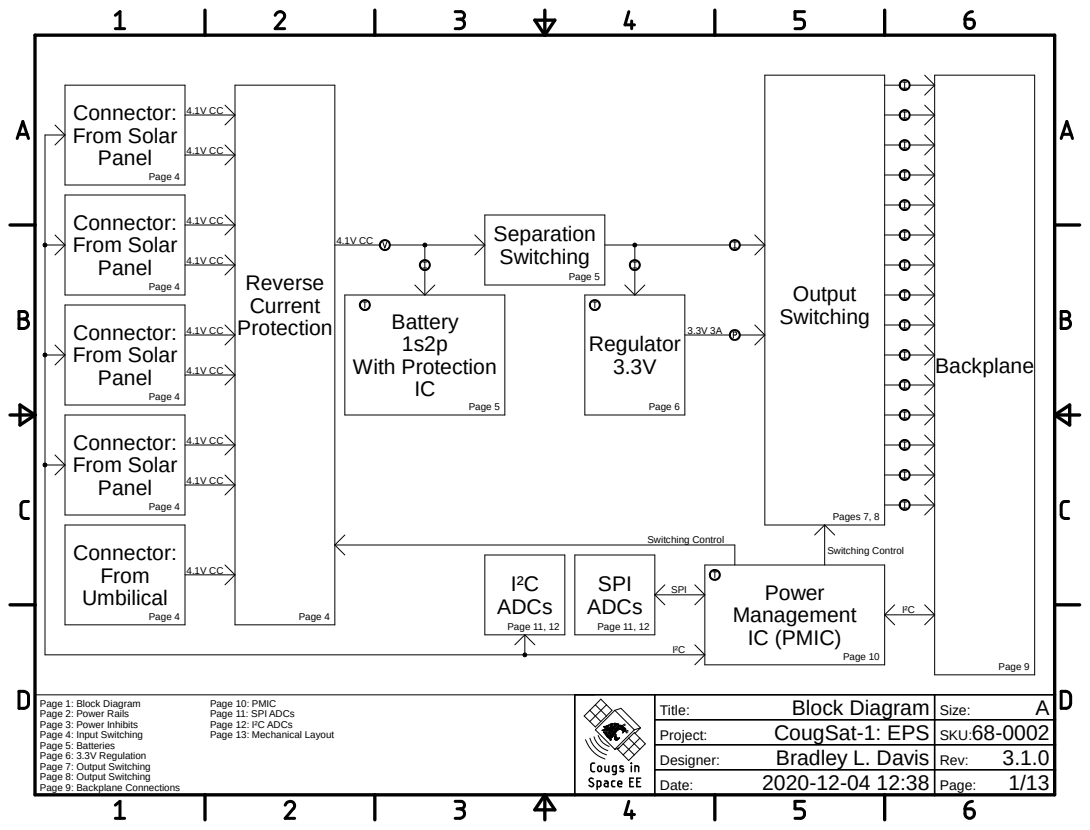
[picture p229: page 1]
I²C; Switching Control; Page 4; Page 5; Page 6; Pages 7, 8; Page 9; Page 10; Page 11, 12; SPI; Connector: From Solar Panel; Reverse Current Protection; Regulator; Backplane; Power Management IC (PMIC); I²C ADCs; Separation Switching; Connector: From Umbilical; Battery 1s2p With Protection IC; SPI ADCs; Output Switching

Page 1: Block Diagram Page 10: PMIC Page 2: Power Rails Page 11: SPI ADCs Page 3: Power Inhibits Page 12: I²C ADCs Page 4: Input Switching Page 13: Mechanical Layout Page 5: Batteries Page 6: 3.3V Regulation Page 7: Output Switching Page 8: Output Switching Page 9: Backplane Connections | Block Diagram Title: | A Size:

CougSat-1: EPS Project: | 68-0002 SKU:
Bradley L. Davis Designer: | 3.1.0 Rev:
2020-12-04 12:38 Date: | 1/13 Page:

## PR_3.3V-0: 80mA

## PR_3.3V-1: 0mA

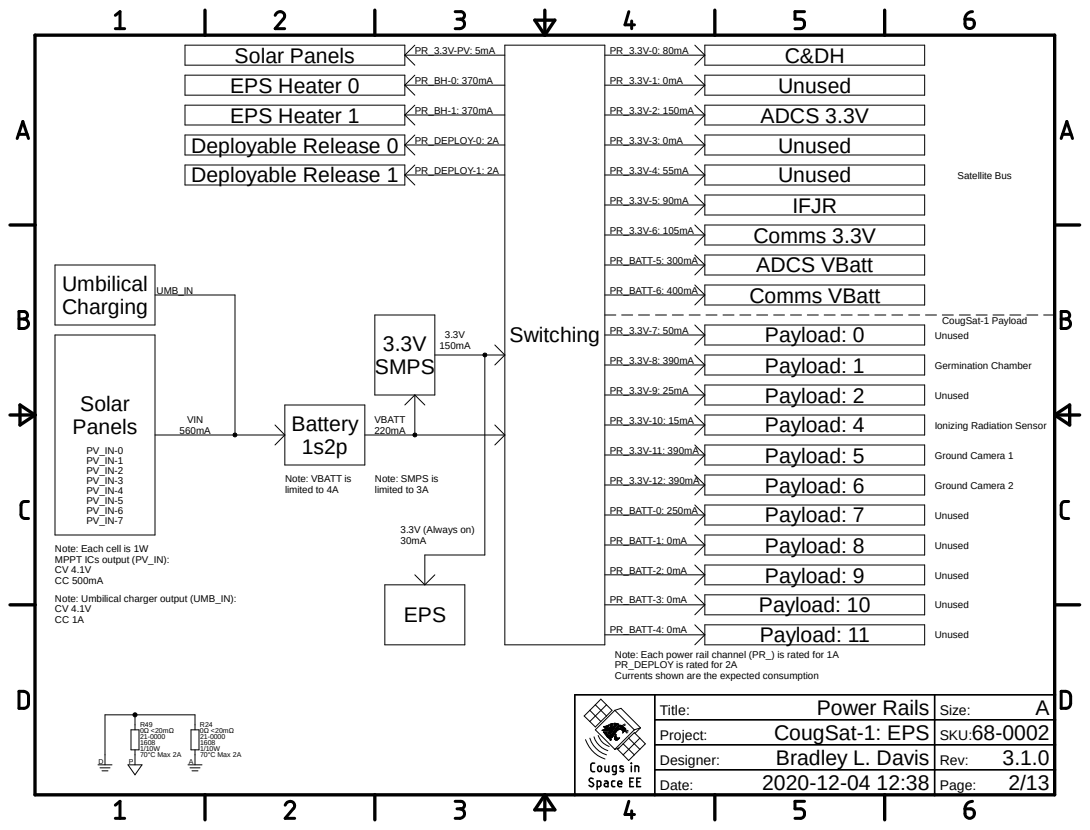
[picture p230: page 2]
3.3V (Always on) 30mA; PR_BATT-5: 300mA; PR_BATT-6: 400mA; PR_BATT-2: 0mA; PR_BATT-3: 0mA; PR_BATT-0: 250mA; PR_BATT-4: 0mA; Unused; Germination Chamber; Ground Camera 1; PR_BATT-1: 0mA; CougSat-1 Payload; Ground Camera 2; Satellite Bus; VBATT 220mA; VIN 560mA; UMB_IN; PR_DEPLOY-0: 2A; PR_DEPLOY-1: 2A; 1608 1/10W 70°C Max 2A; Solar; Panels; Battery; 3.3V SMPS; EPS; C&DH Unused ADCS 3.3V Unused Unused; ADCS VBatt; IFJR; Payload: 10; Payload: 9; Comms 3.3V; Comms VBatt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

Ionizing Radiation Sensor

Note: VBATT is
limited to 4A

Note: SMPS is
limited to 3A

Note: Each cell is 1W
MPPT ICs output (PV_IN):
Note: Umbilical charger output (UMB_IN):

Note: Each power rail channel (PR_) is rated for 1A
PR_DEPLOY is rated for 2A
Currents shown are the expected consumption

Power Rails Title: | A Size:
CougSat-1: EPS Project: | 68-0002 SKU:
Bradley L. Davis Designer: | 3.1.0 Rev:

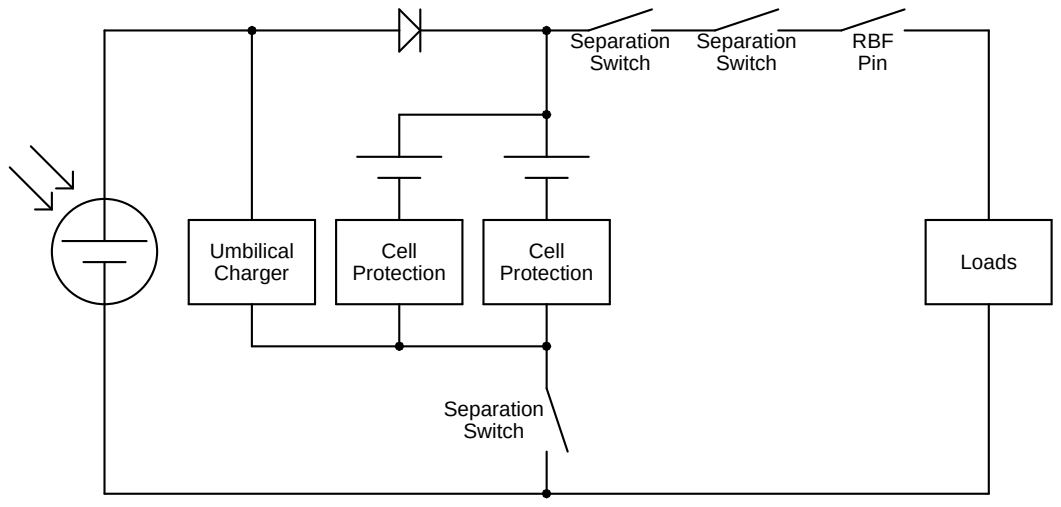
[picture p231: page 3]
Cell Protection; Umbilical Charger; Separation Switch; RBF Pin; Loads

Power Inhibits Title: | A Size:
CougSat-1: EPS Project: | 68-0002 SKU:
Bradley L. Davis Designer: | 3.1.0 Rev:

CAD Note: Decoupling | CAD Note: Decoupling
Internal PU | Internal PU | Internal PU | Internal PU

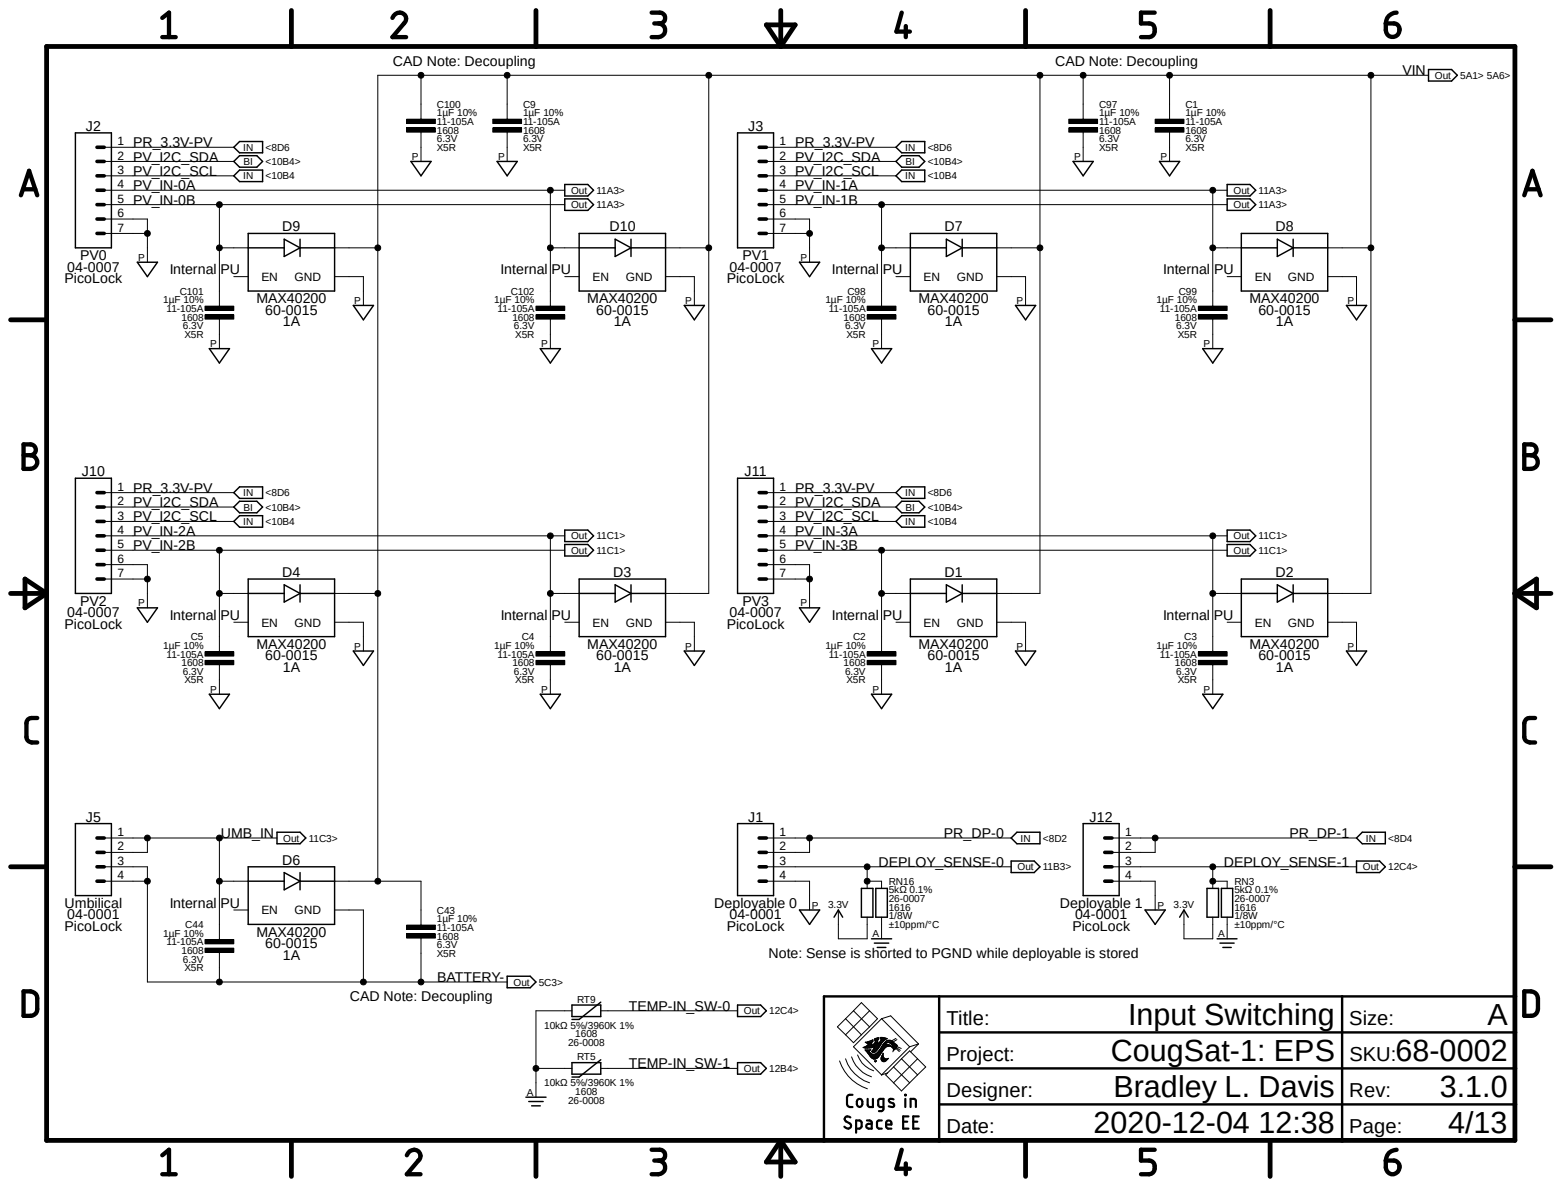
[picture p232: page 4]

Note: Sense is shorted to PGND while deployable is stored

Input Switching Title: | A Size:
CougSat-1: EPS Project: | 68-0002 SKU:
Bradley L. Davis Designer: | 3.1.0 Rev:

## CAD Note: Decoupling

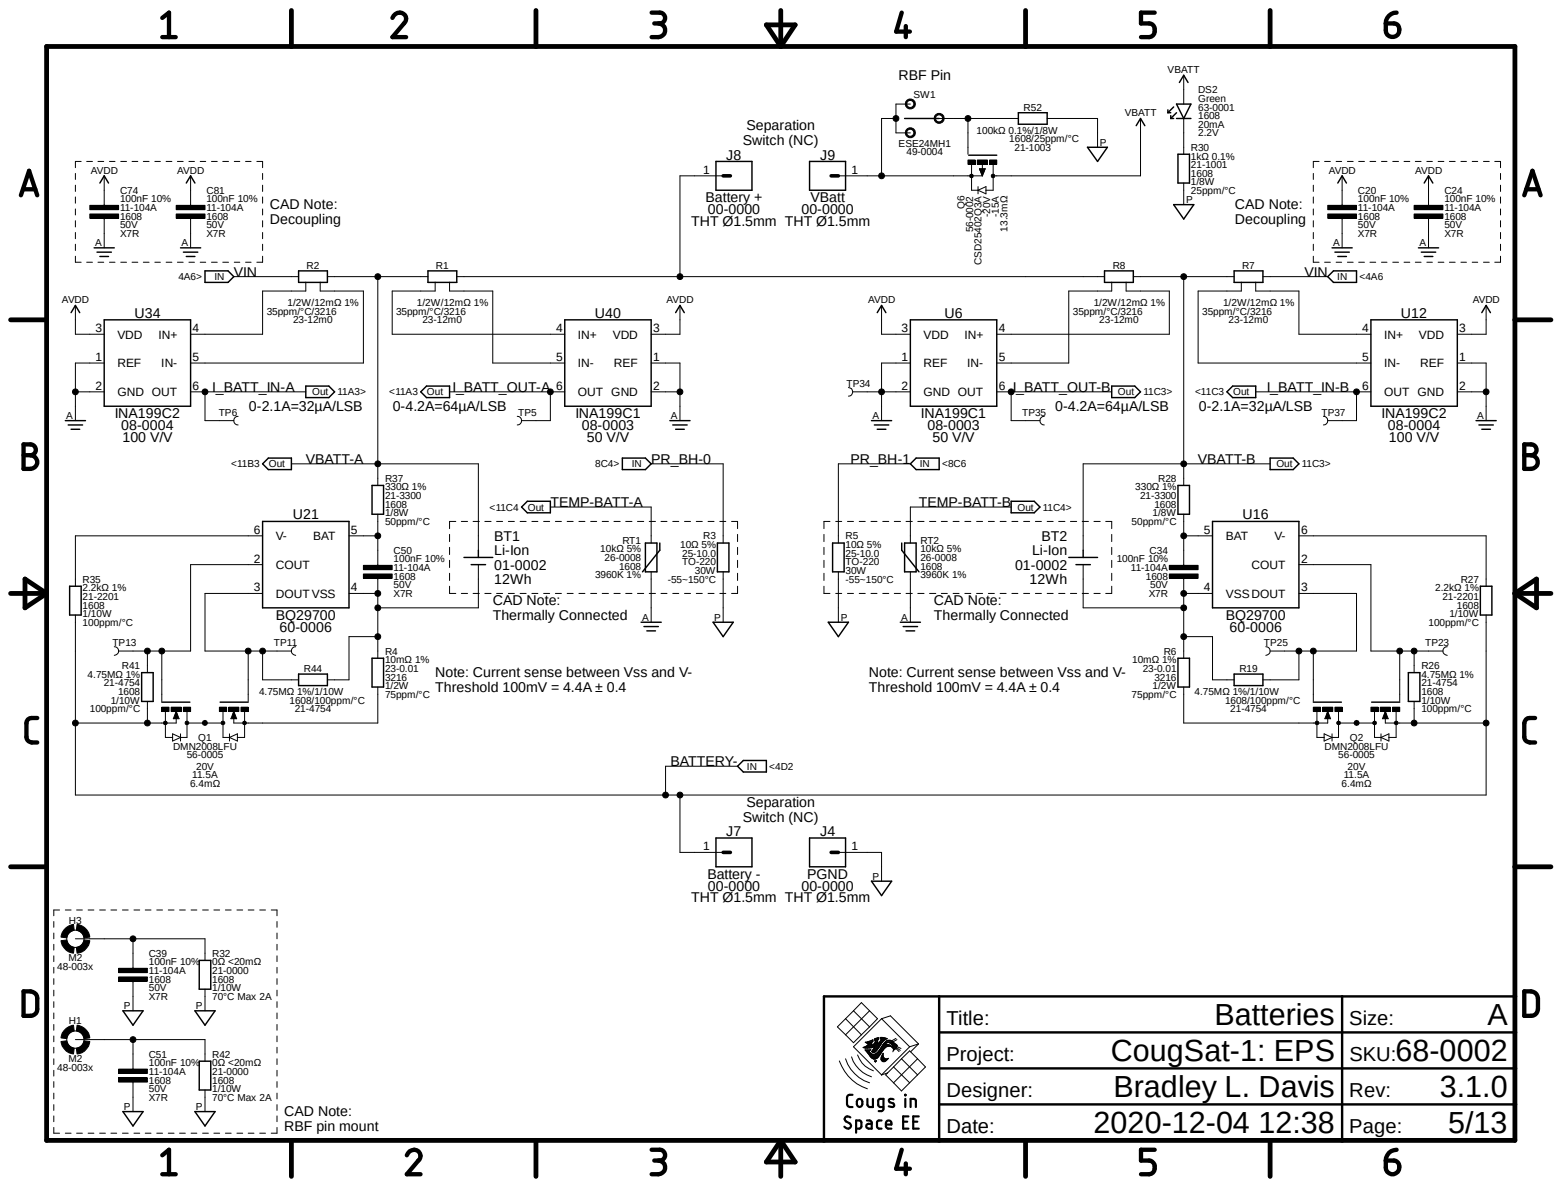
[picture p233: page 5]

Note: Current sense between Vss and V-
Threshold 100mV = 4.4A ± 0.4

Batteries Title: | A Size:
CougSat-1: EPS Project: | 68-0002 SKU:
Bradley L. Davis Designer: | 3.1.0 Rev:

## INA199C1 AVDD

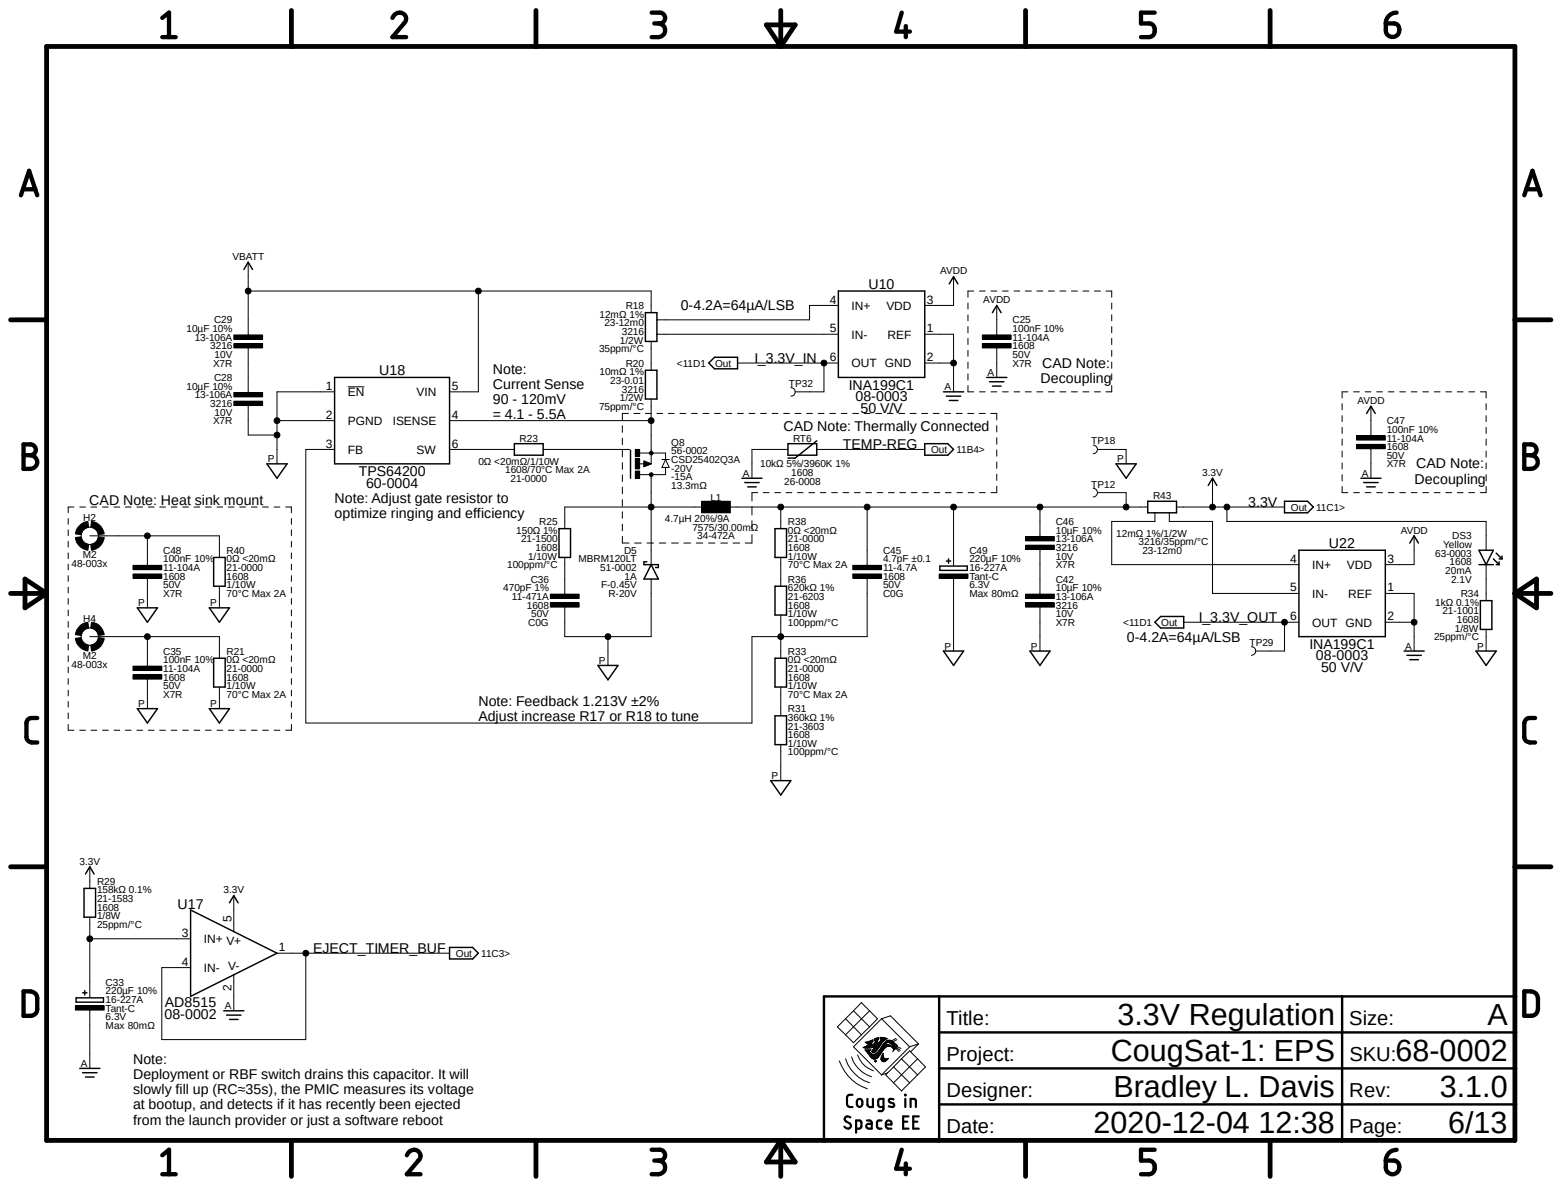
[picture p234: page 6]

CAD Note: Thermally Connected

Note: Feedback 1.213V ±2%
Adjust increase R17 or R18 to tune

3.3V Regulation Title: | A Size:
CougSat-1: EPS Project: | 68-0002 SKU:
Bradley L. Davis Designer: | 3.1.0 Rev:

Note:
Deployment or RBF switch drains this capacitor. It will
slowly fill up (RC≈35s), the PMIC measures its voltage
at bootup, and detects if it has recently been ejected
from the launch provider or just a software reboot

0-2.08A=509µA/LSB | 0-2.08A=509µA/LSB | 0-2.08A=509µA/LSB

08-0004

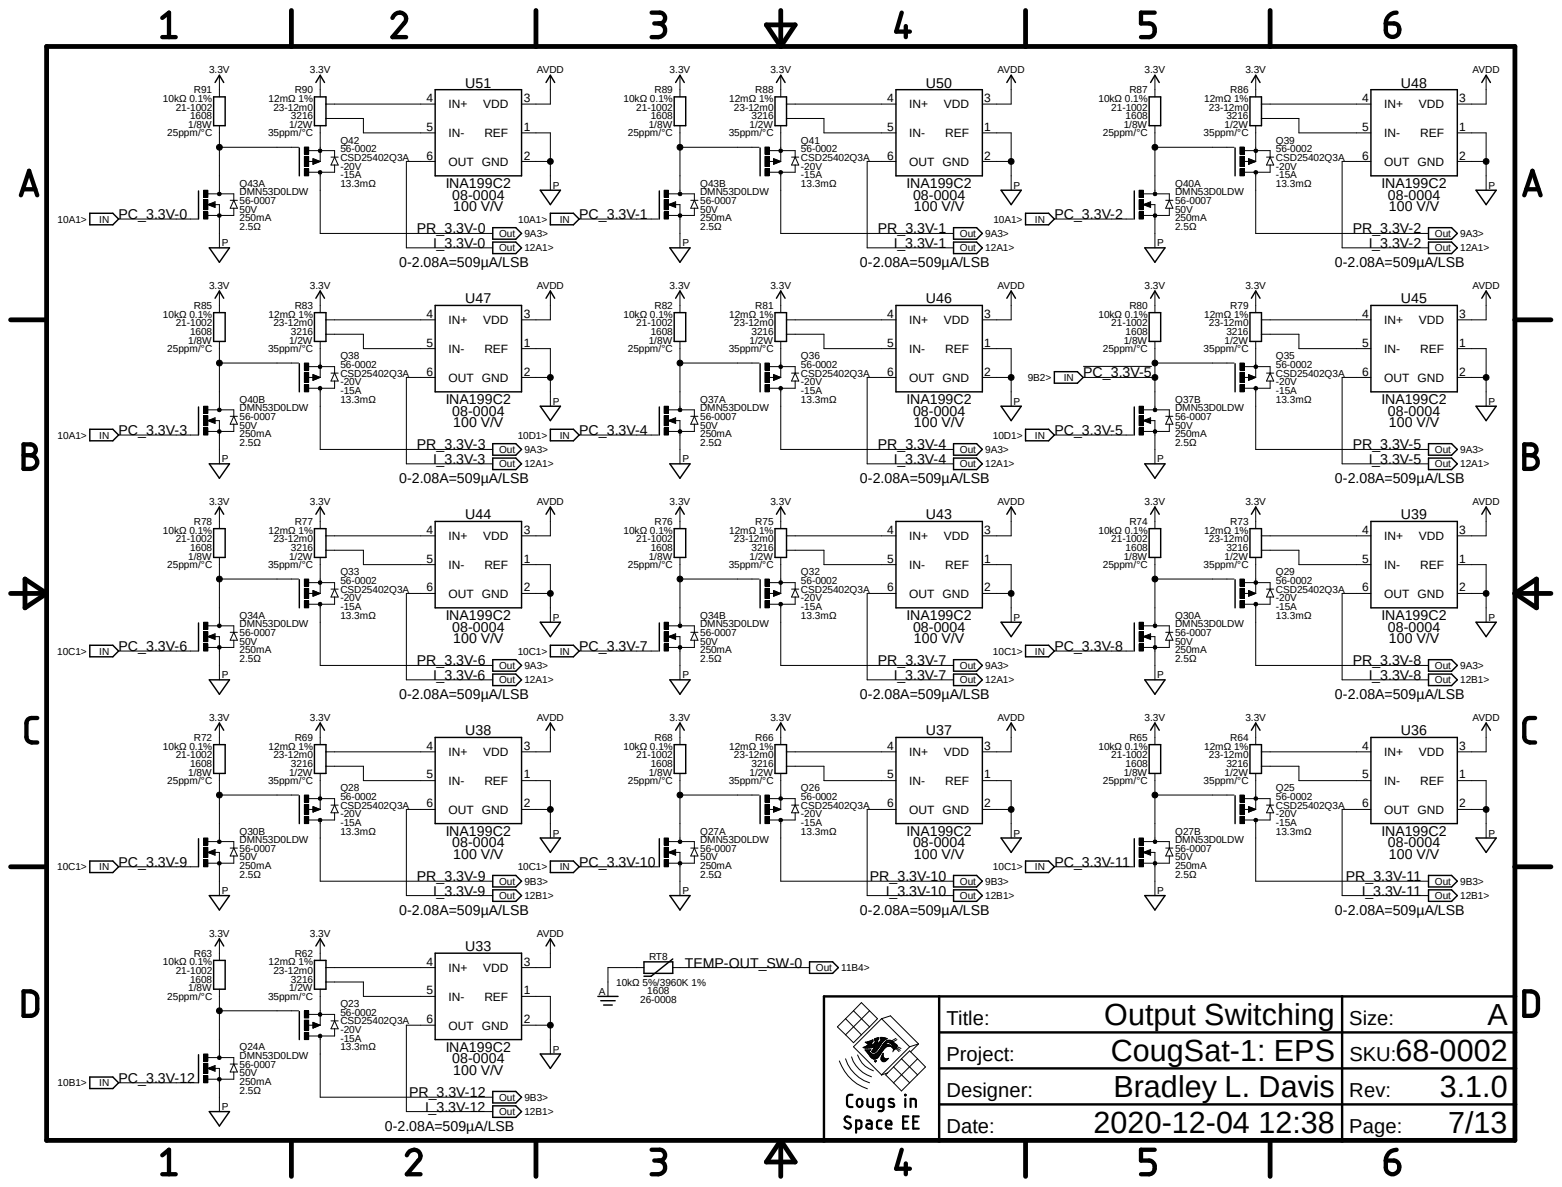
[picture p235: page 7]

Output Switching Title: | A Size:
CougSat-1: EPS Project: | 68-0002 SKU:
Bradley L. Davis Designer: | 3.1.0 Rev:

0-2.08A=509µA/LSB | 0-2.08A=509µA/LSB | 0-2.08A=509µA/LSB

08-0004

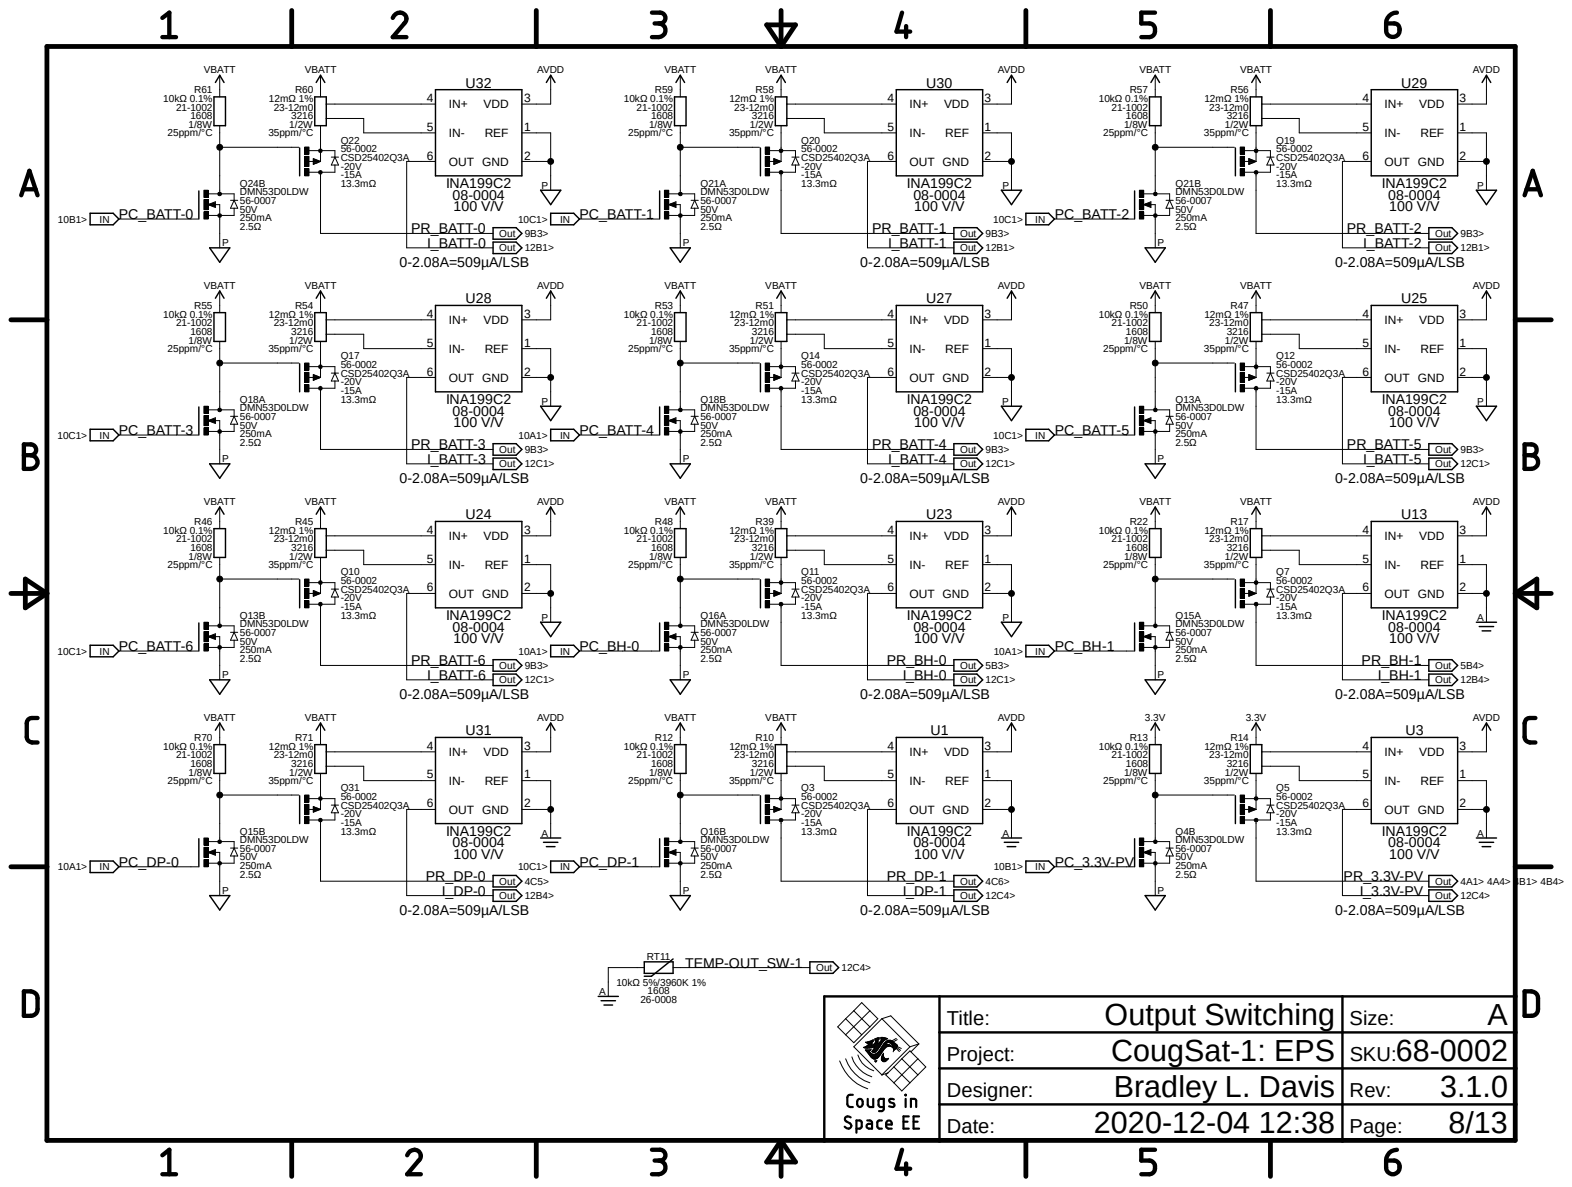
[picture p236: page 8]
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

## CAD Note: Decoupling

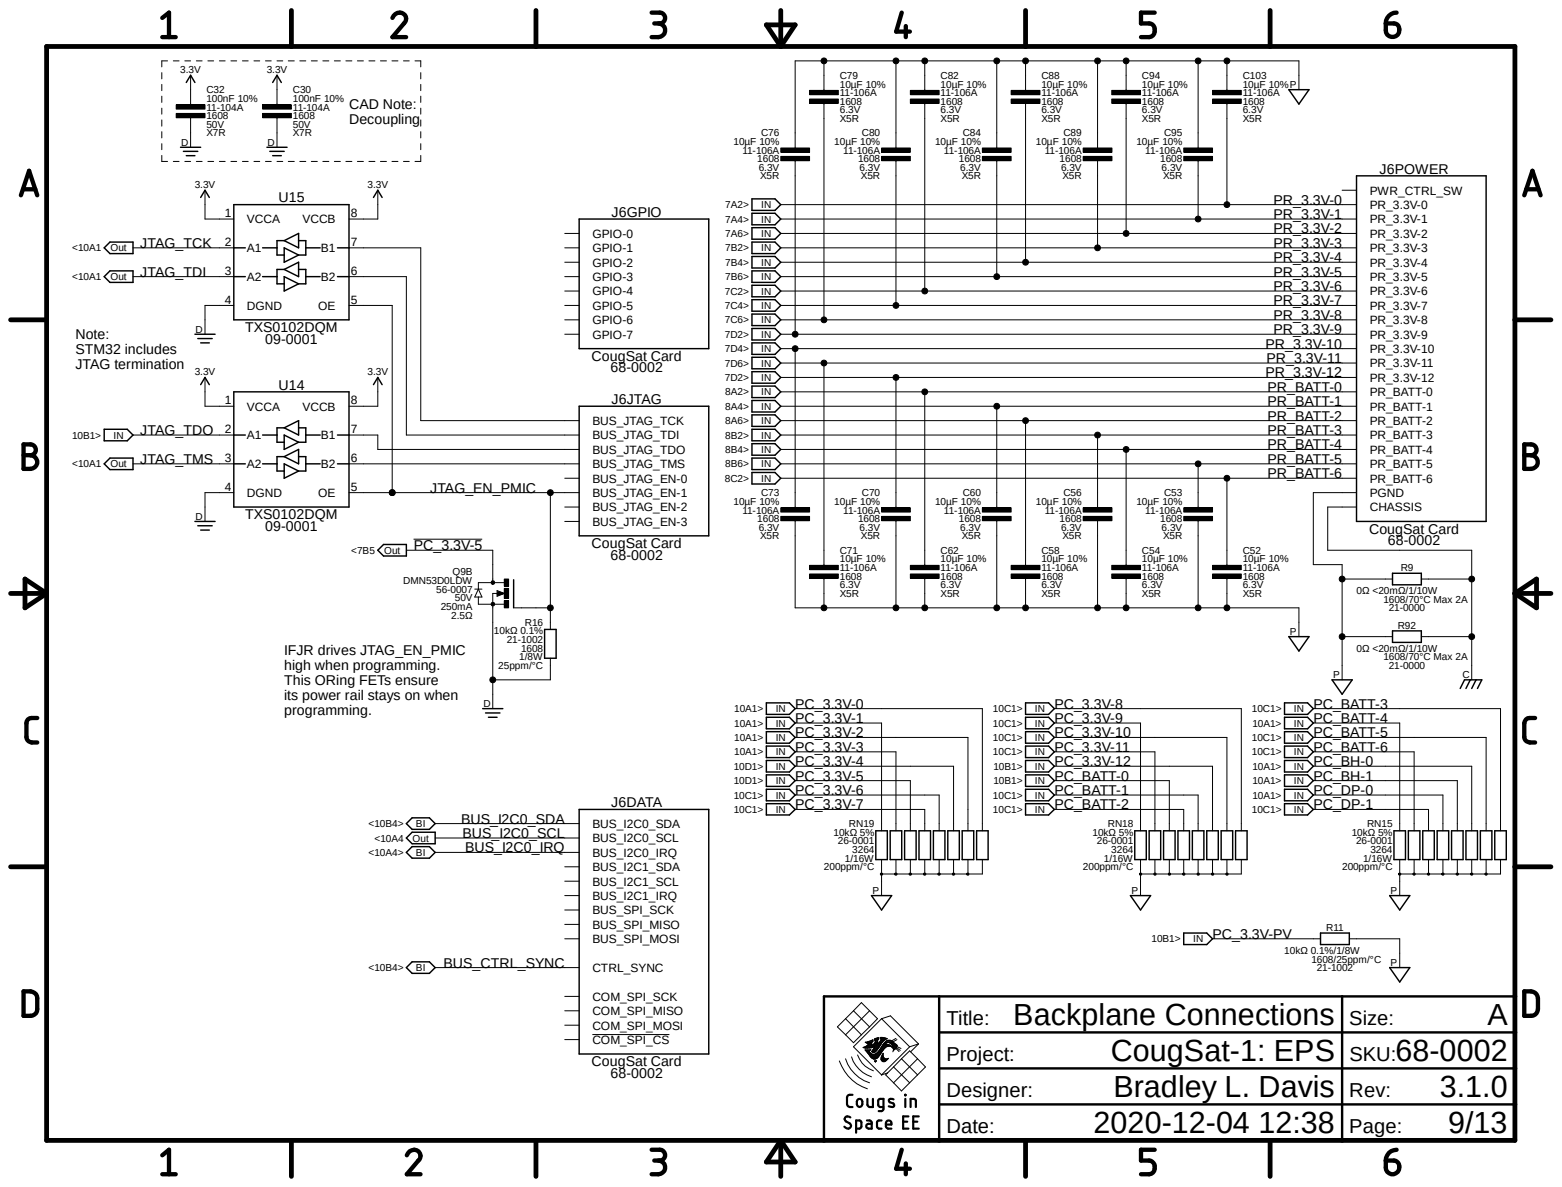
[picture p237: page 9]

J6GPIO
GPIO-0 GPIO-1 GPIO-2 GPIO-3 GPIO-4 GPIO-5 GPIO-6 GPIO-7

PR_3.3V-3
PR_3.3V-4
PR_3.3V-5
PR_3.3V-6
PR_3.3V-7

PR_3.3V-12
PR_BATT-0
PR_BATT-1
PR_BATT-3
PR_BATT-4

IFJR drives JTAG_EN_PMIC
high when programming.
This ORing FETs ensure
its power rail stays on when
programming.

Backplane Connections Title: | A Size:
CougSat-1: EPS Project: | 68-0002 SKU:
Bradley L. Davis Designer: | 3.1.0 Rev:

## CAD Note: Decoupling

# <9C2> <9C2> 9C2> <9D2> <4A1> <4A4> <4B1> <4B4> <4A1 <4A4 <4B1 <4B4

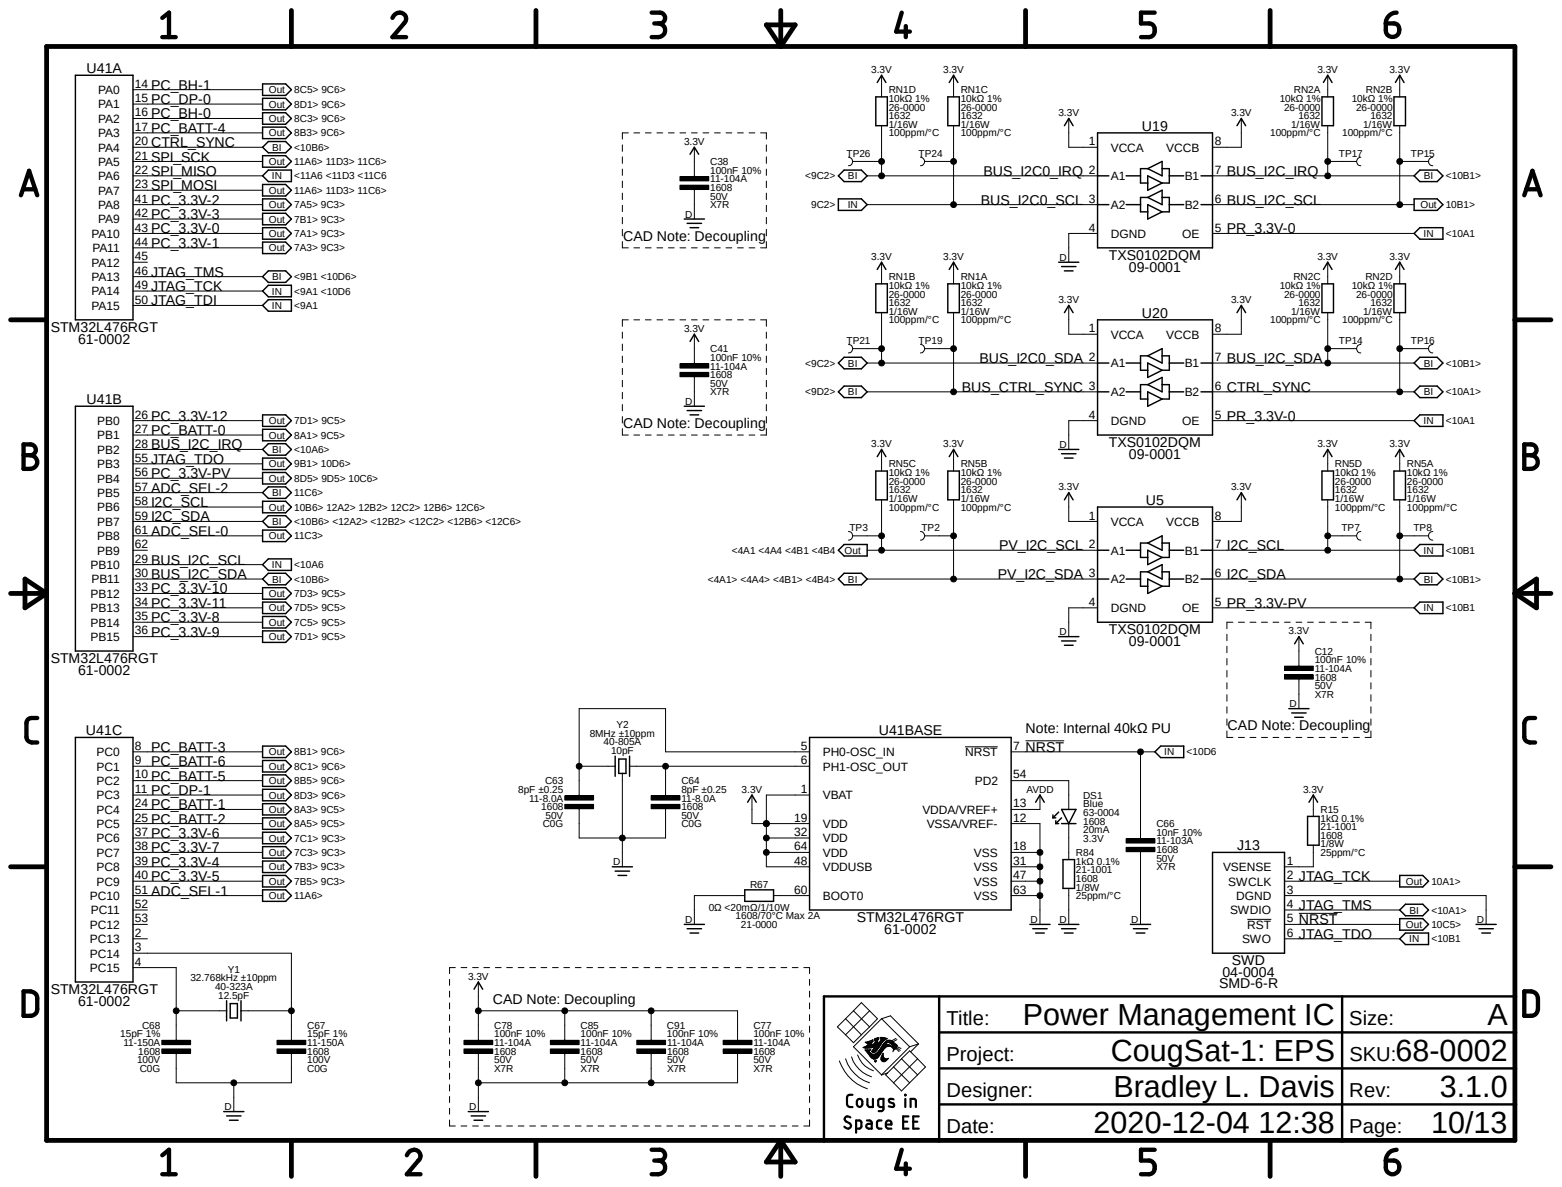
[picture p238: page 10]

Out
Out Out

BI BI BI Out Out

Out Out Out Out Out

Power Management IC Title: | A Size:
CougSat-1: EPS Project: | 68-0002 SKU:
Bradley L. Davis Designer: | 3.1.0 Rev:

## CAD Note: Decoupling

## 0-2.5V=38µV/LSB

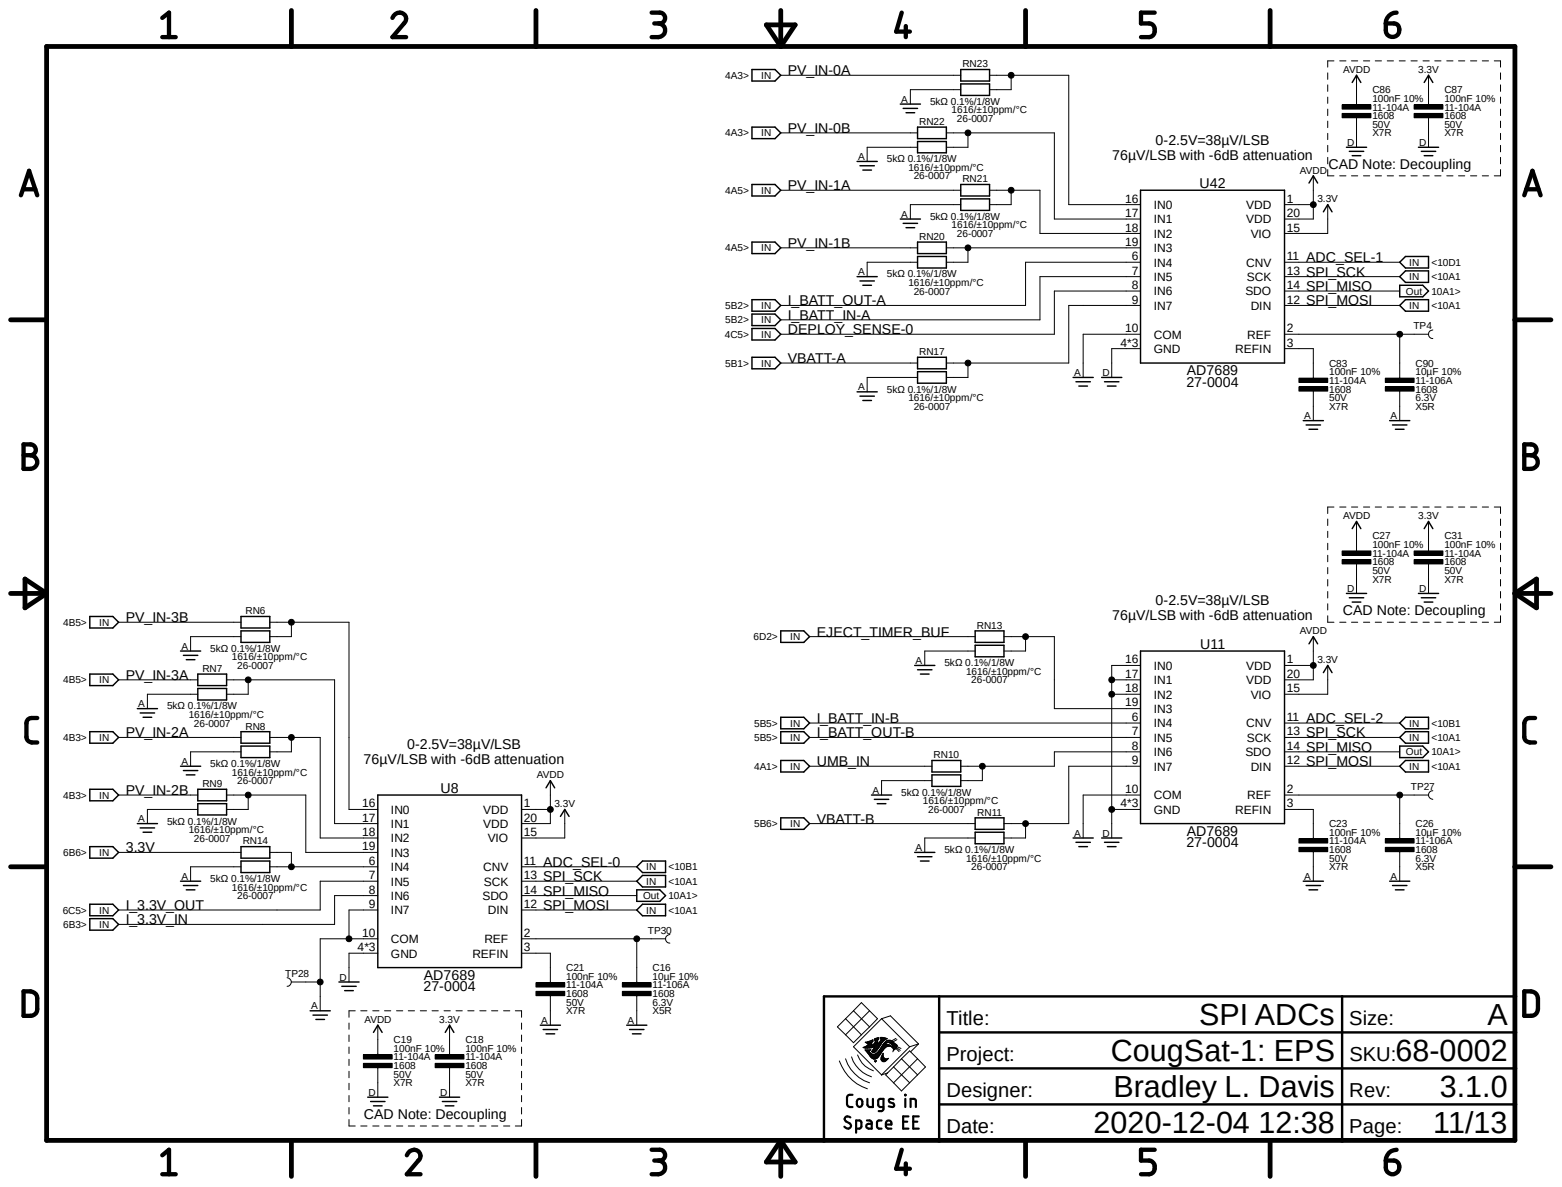
[picture p239: page 11]

SPI ADCs Title: | A Size:
CougSat-1: EPS Project: | 68-0002 SKU:
Bradley L. Davis Designer: | 3.1.0 Rev:

## CAD Note: Decoupling

## Addr=0x2C (7b)

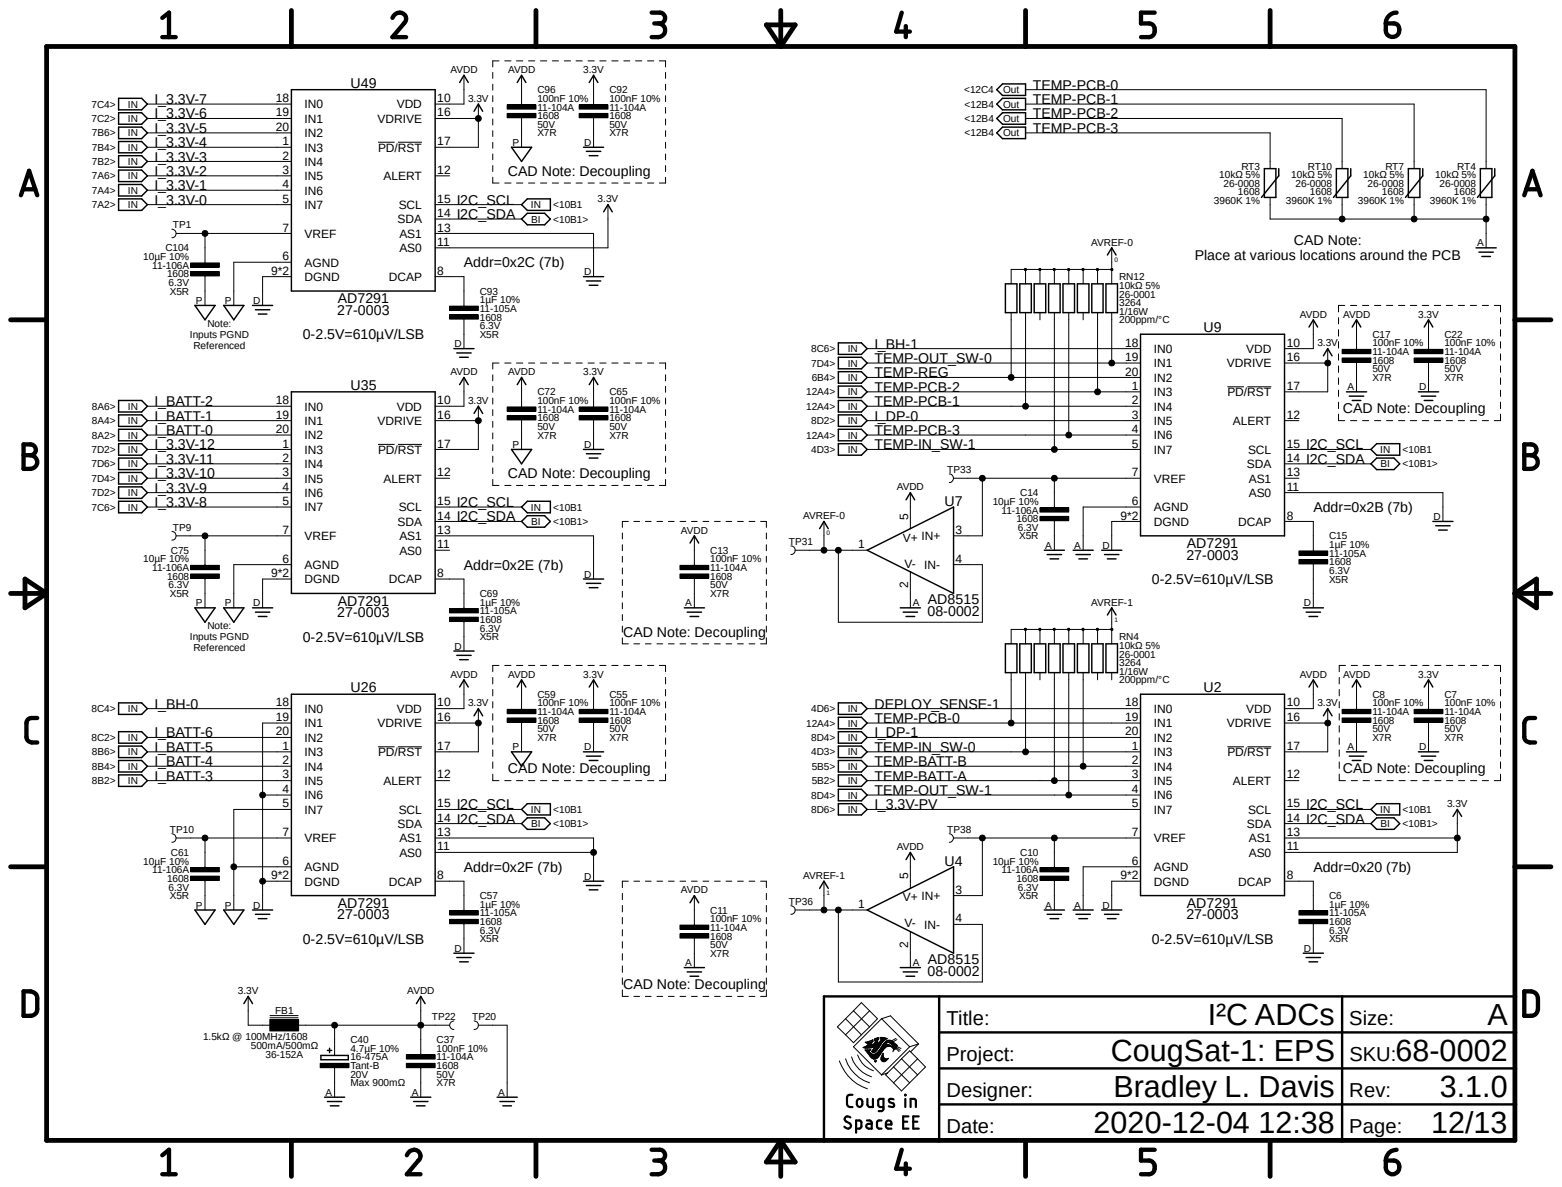
[picture p240: page 12]

Place at various locations around the PCB

I²C ADCs Title: | A Size:
CougSat-1: EPS Project: | 68-0002 SKU:
Bradley L. Davis Designer: | 3.1.0 Rev:

J6MECH-TOP | J6MECH-BOTTOM

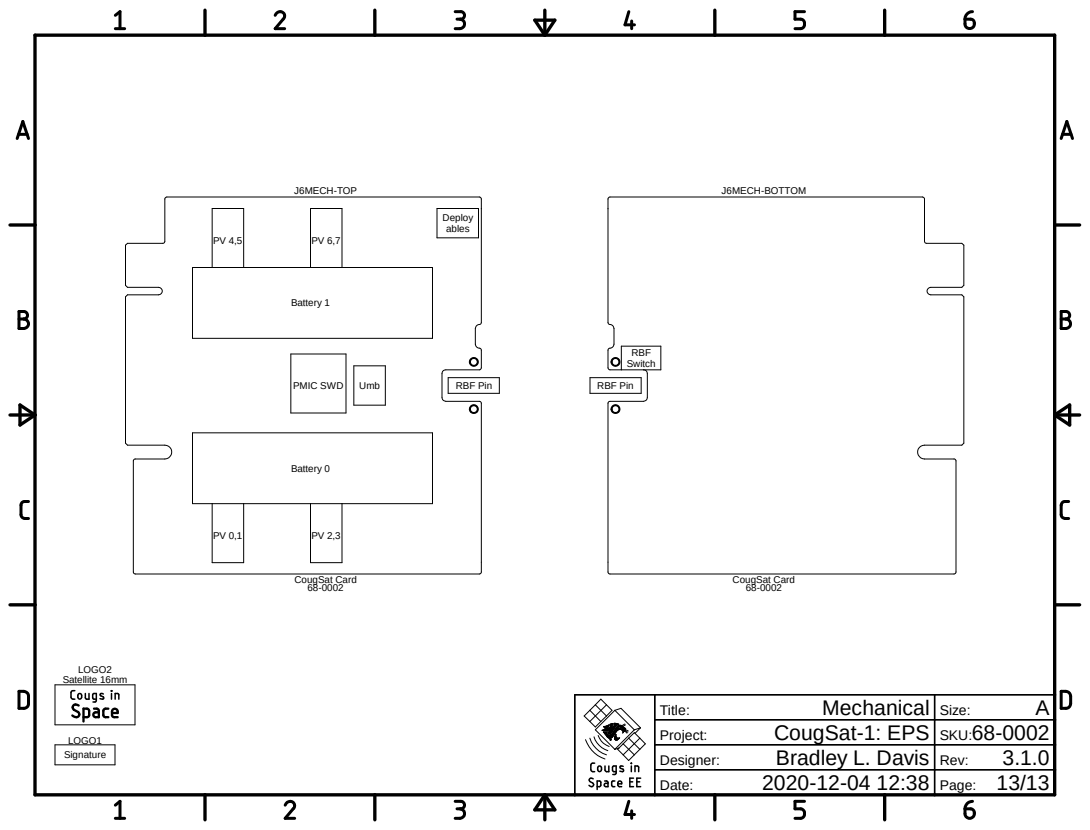
[picture p241: page 13]
Battery 0; Battery 1; PMIC SWD; Umb; RBF Pin; RBF Switch; Deploy ables; Satellite 16mm; CougSat Card; LOGO2; LOGO1; Designer:; Rev:; Bradley L. Davis; Signature

Mechanical Title: | A Size:
CougSat-1: EPS Project: | 68-0002 SKU:
