CougsInSpace/CougSat1-Hardware/CougSat1-RadioBoard/Documentation/+XPanel.pdf

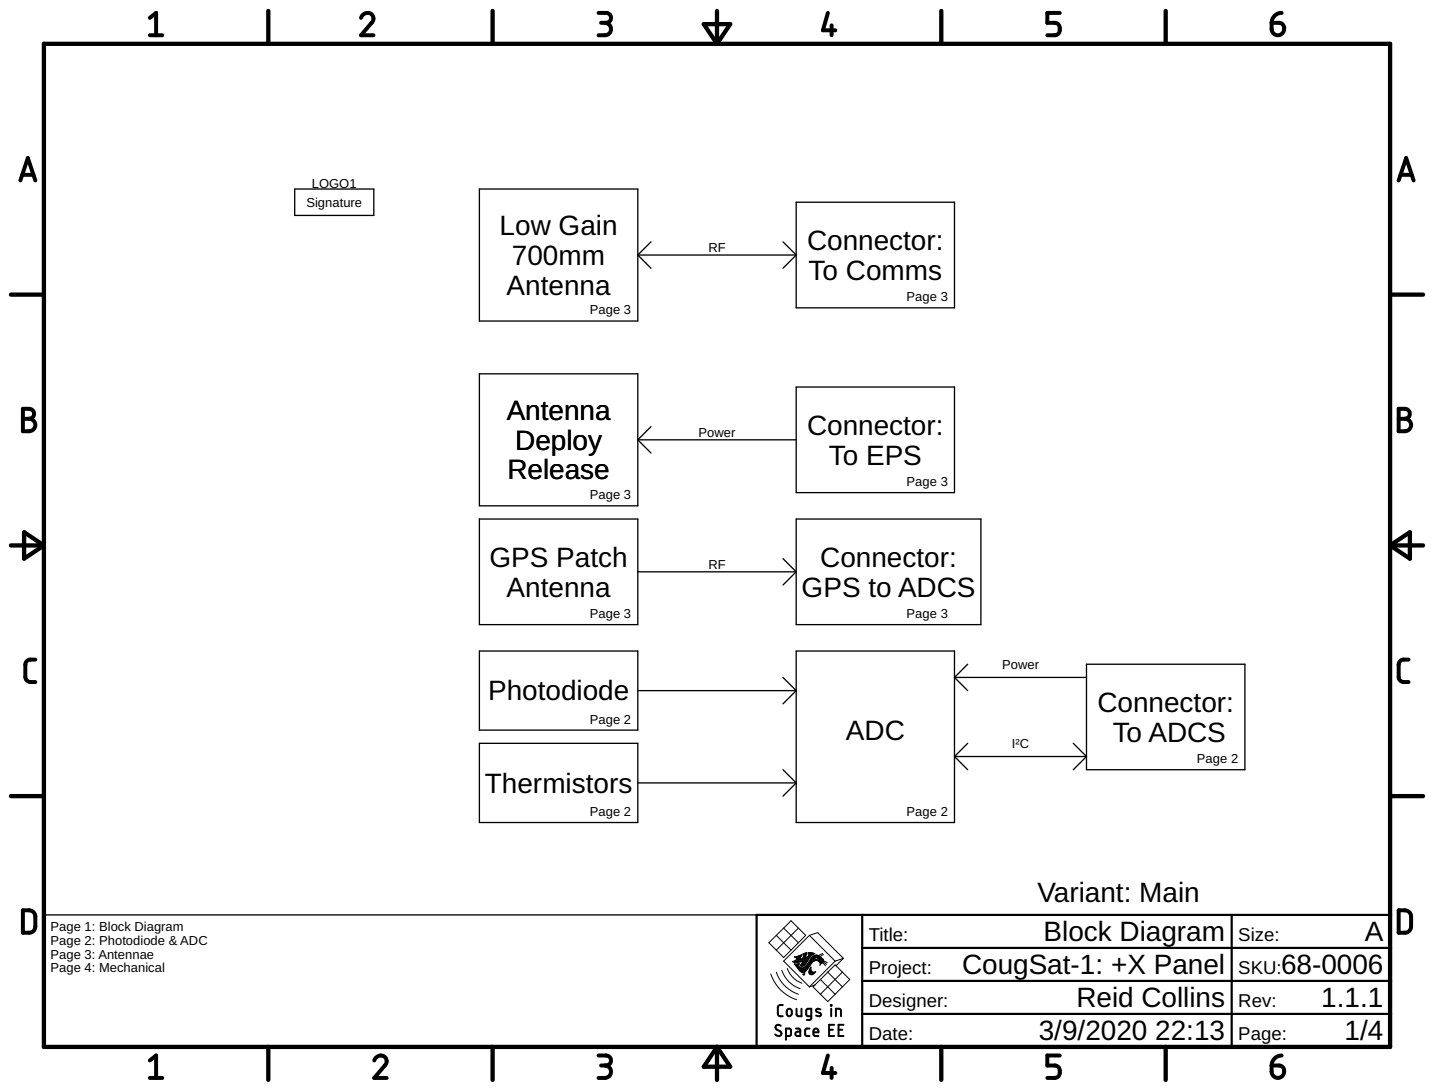
[picture p242: page 1]

Page 1: Block Diagram Page 2: Photodiode & ADC Page 3: Antennae Page 4: Mechanical | Block Diagram Title: | A Size:

CougSat-1: +X Panel Project: | 68-0006 SKU:

Reid Collins Designer: | 1.1.1 Rev:

3/9/2020 22:13 Date: | Page:

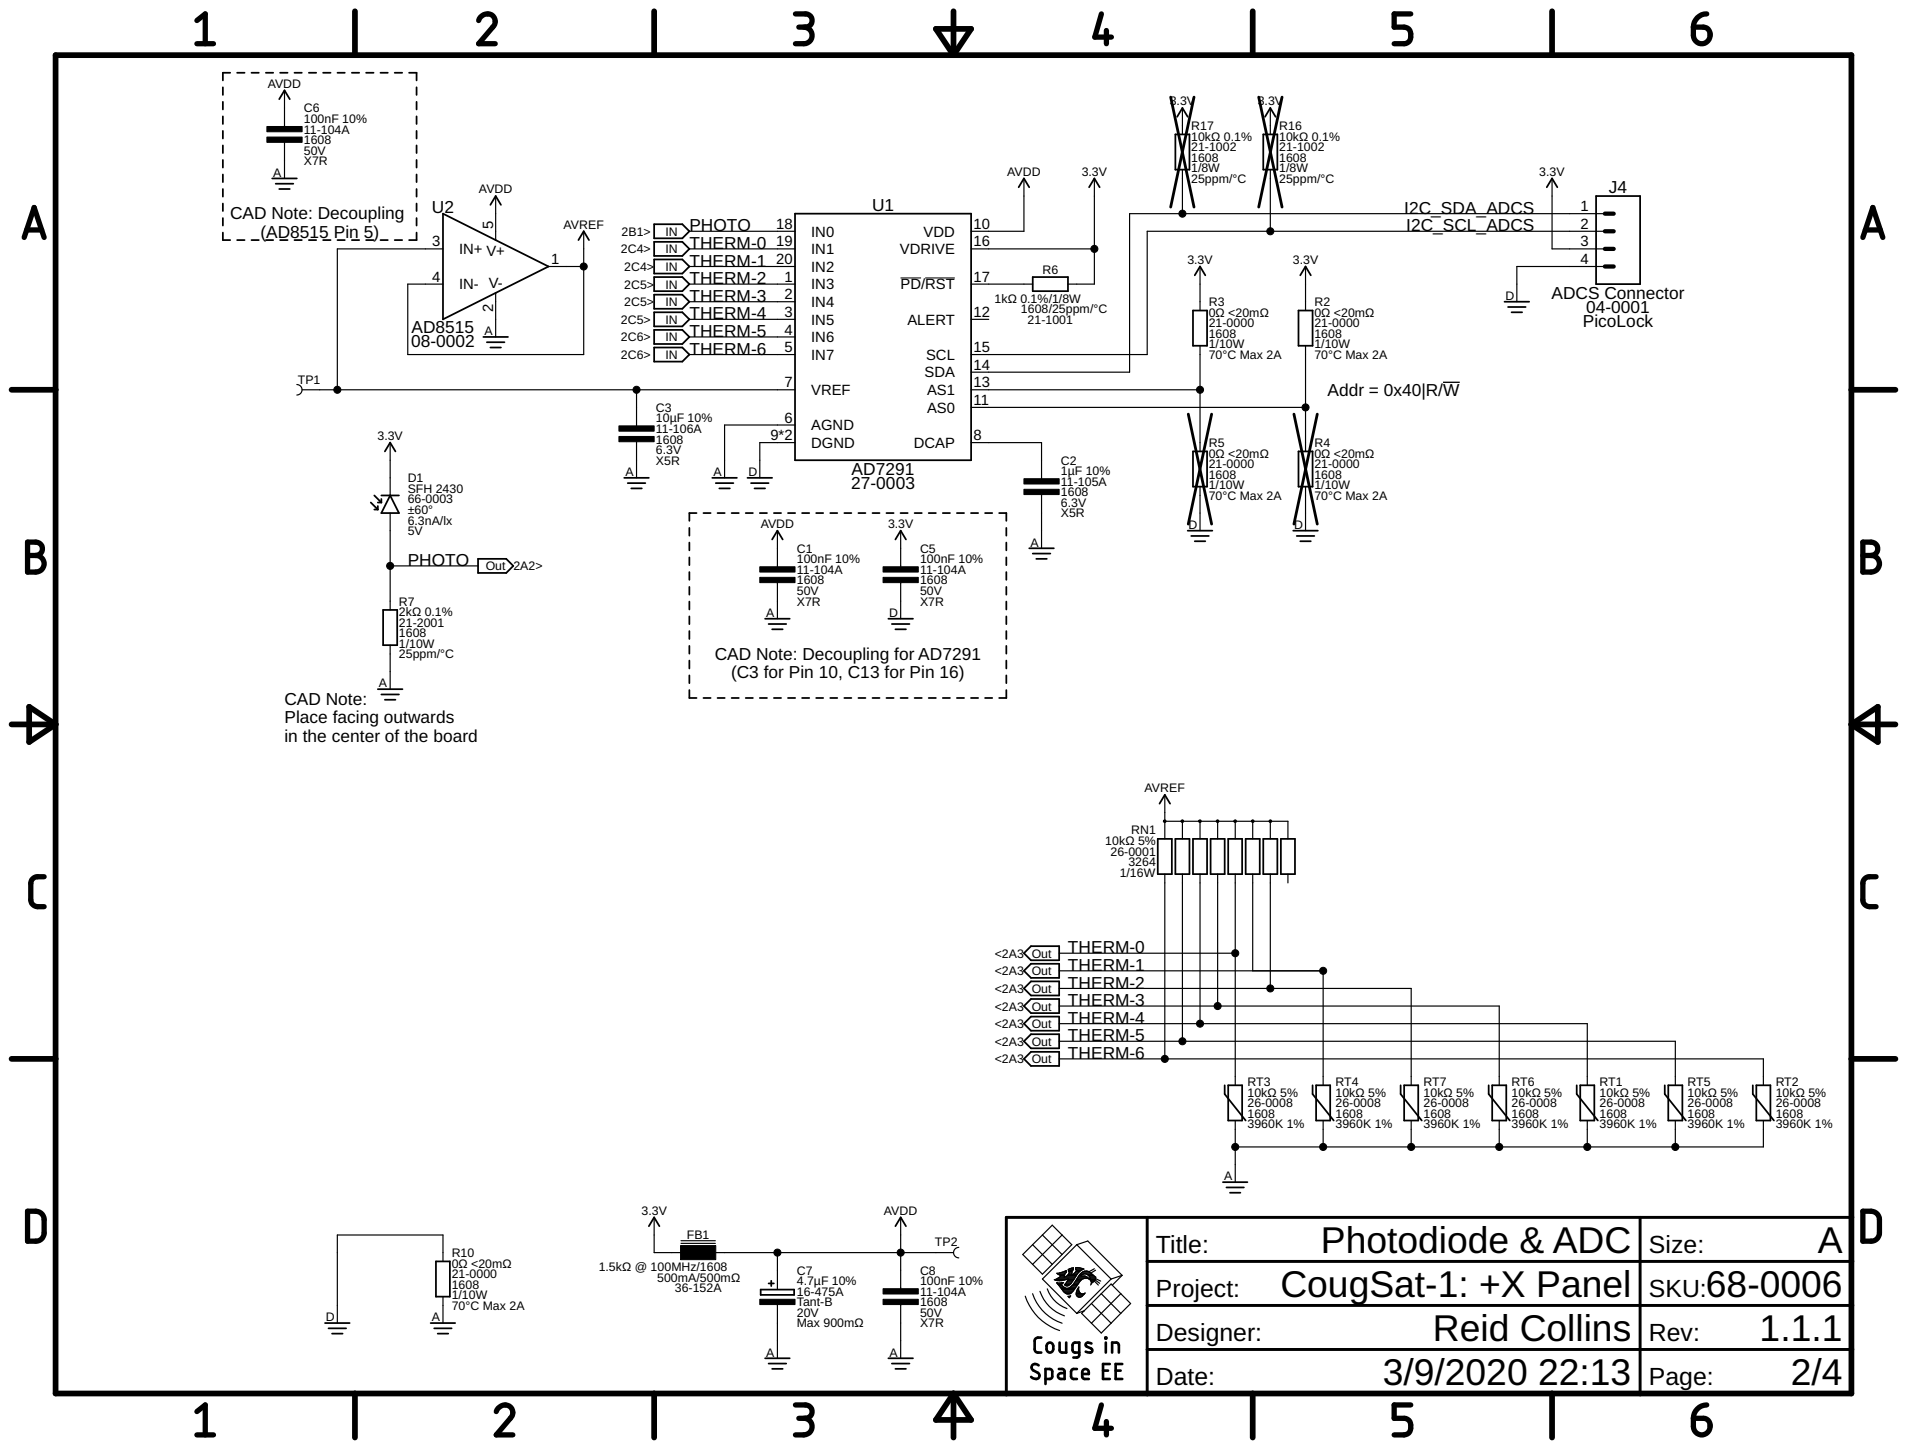
[picture p243: page 2]

CAD Note: Decoupling for AD7291
(C3 for Pin 10, C13 for Pin 16)

CAD Note: Place facing outwards

in the center of the board

THERM-0
Out Out Out

THERM-1
THERM-2
THERM-3
THERM-4
THERM-5
THERM-6

3960K 1% | 3960K 1% | 3960K 1% | 3960K 1% | 3960K 1% | 3960K 1% | 26-0008 Out

Photodiode & ADC Title: | A Size:

CougSat-1: +X Panel Project: | 68-0006 SKU:

Reid Collins Designer: | 1.1.1 Rev:

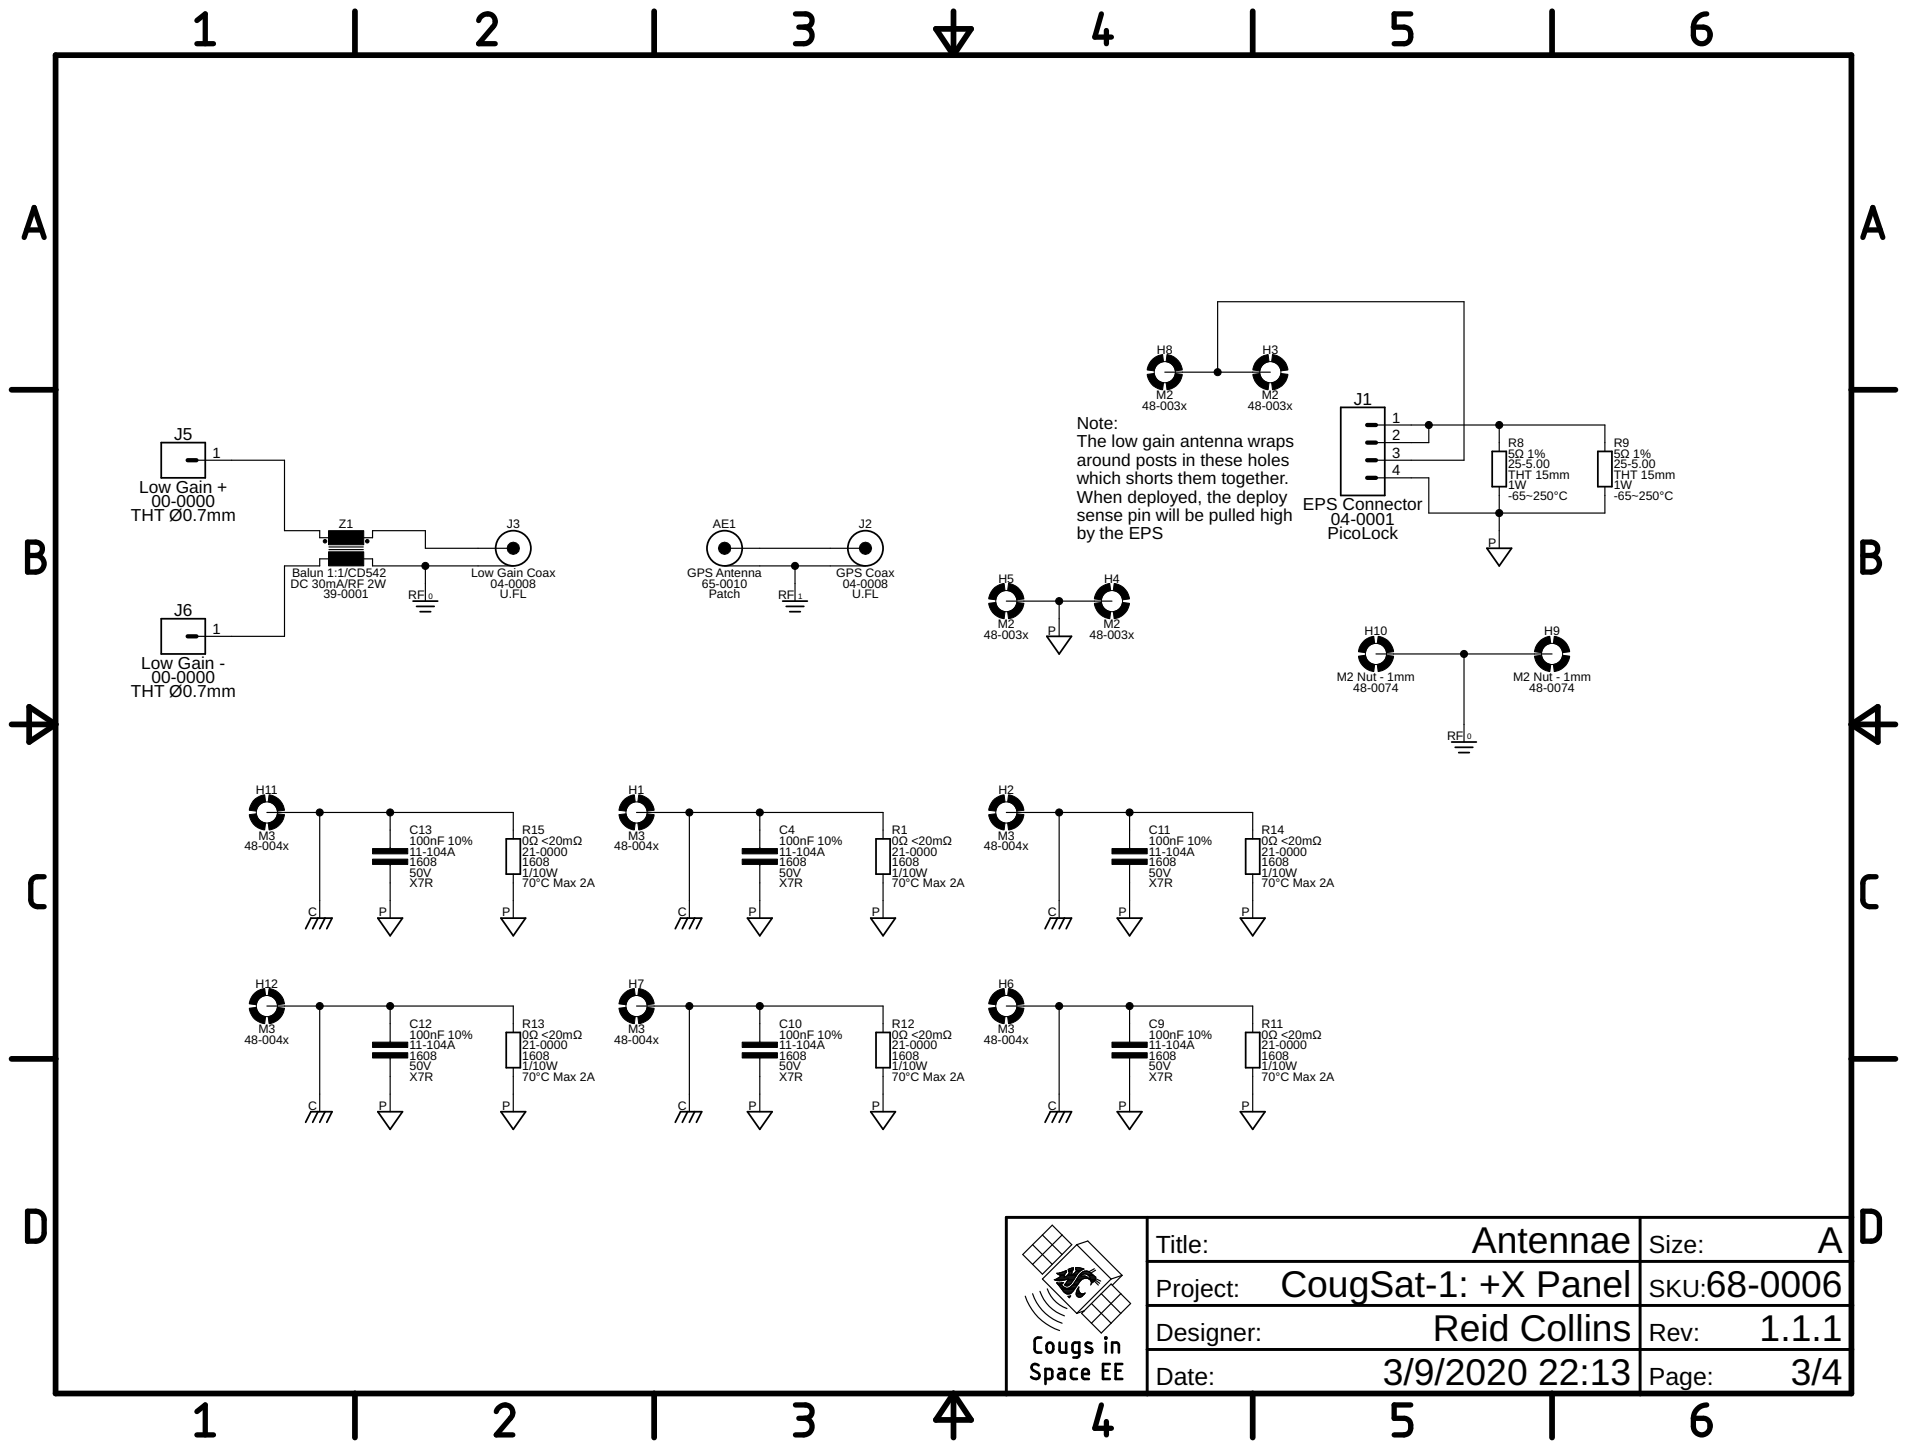
[picture p244: page 3]

Note: The low gain antenna wraps around posts in these holes which shorts them together. When deployed, the deploy

sense pin will be pulled high
by the EPS

Antennae Title: | A Size:

CougSat-1: +X Panel Project: | 68-0006 SKU:

Reid Collins Designer: | 1.1.1 Rev:

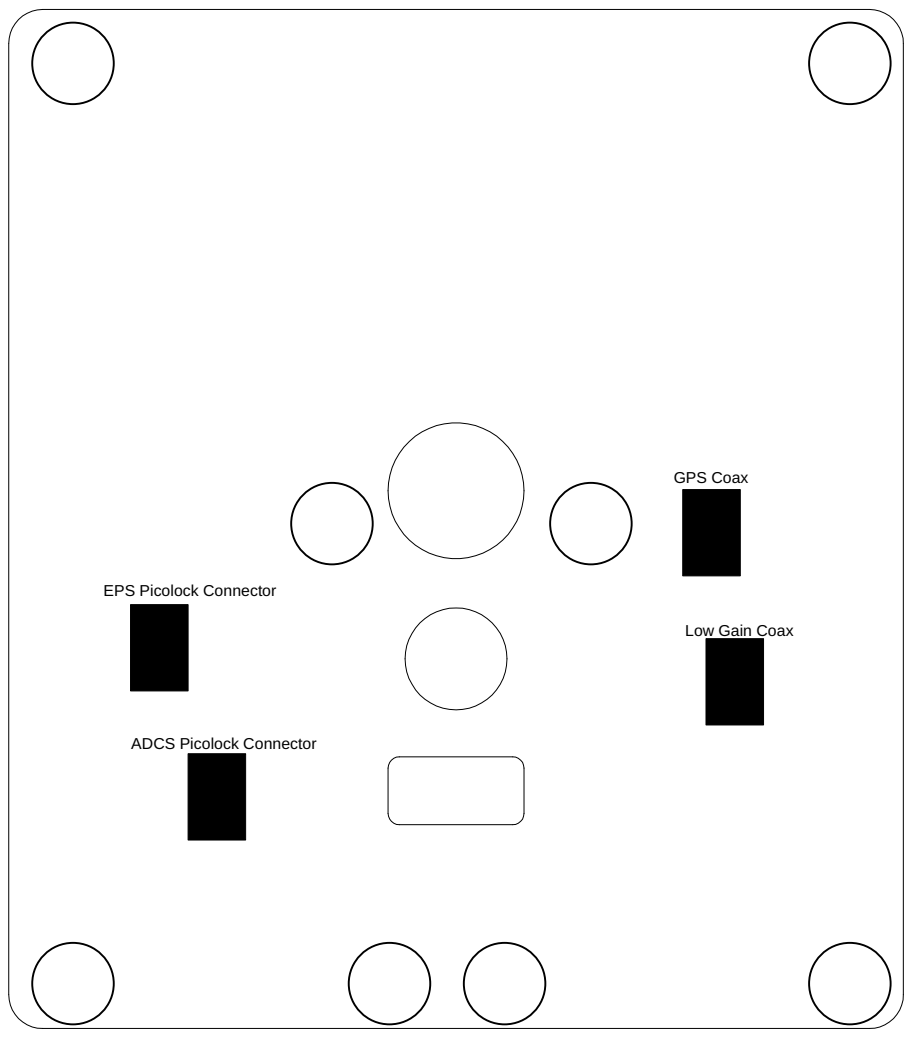
[picture p245: page 4]

Mechanical Title: | A Size:

CougSat-1: +X Panel Project: | 68-0006 SKU:

Reid Collins Designer: | 1.1.1 Rev:
