CougsInSpace/CougSat1-Hardware/CougSat1-RadioBoard/Documentation/-ZPanel.pdf

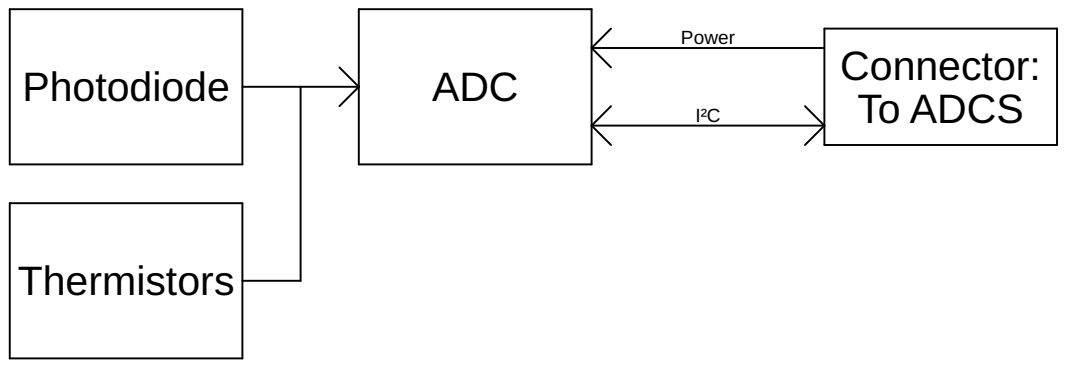
[picture p246: page 1]

Page 1: Block Diagram Page 2: Schematic Page 3: Mechanical | Block Diagram Title: | A Size:

CougSat-1: -Z Panel Project: | 68-0012 SKU:

Joshua Lungstrom Designer: | 1.1.1 Rev:

3/4/2020 23:31 Date: | Page:

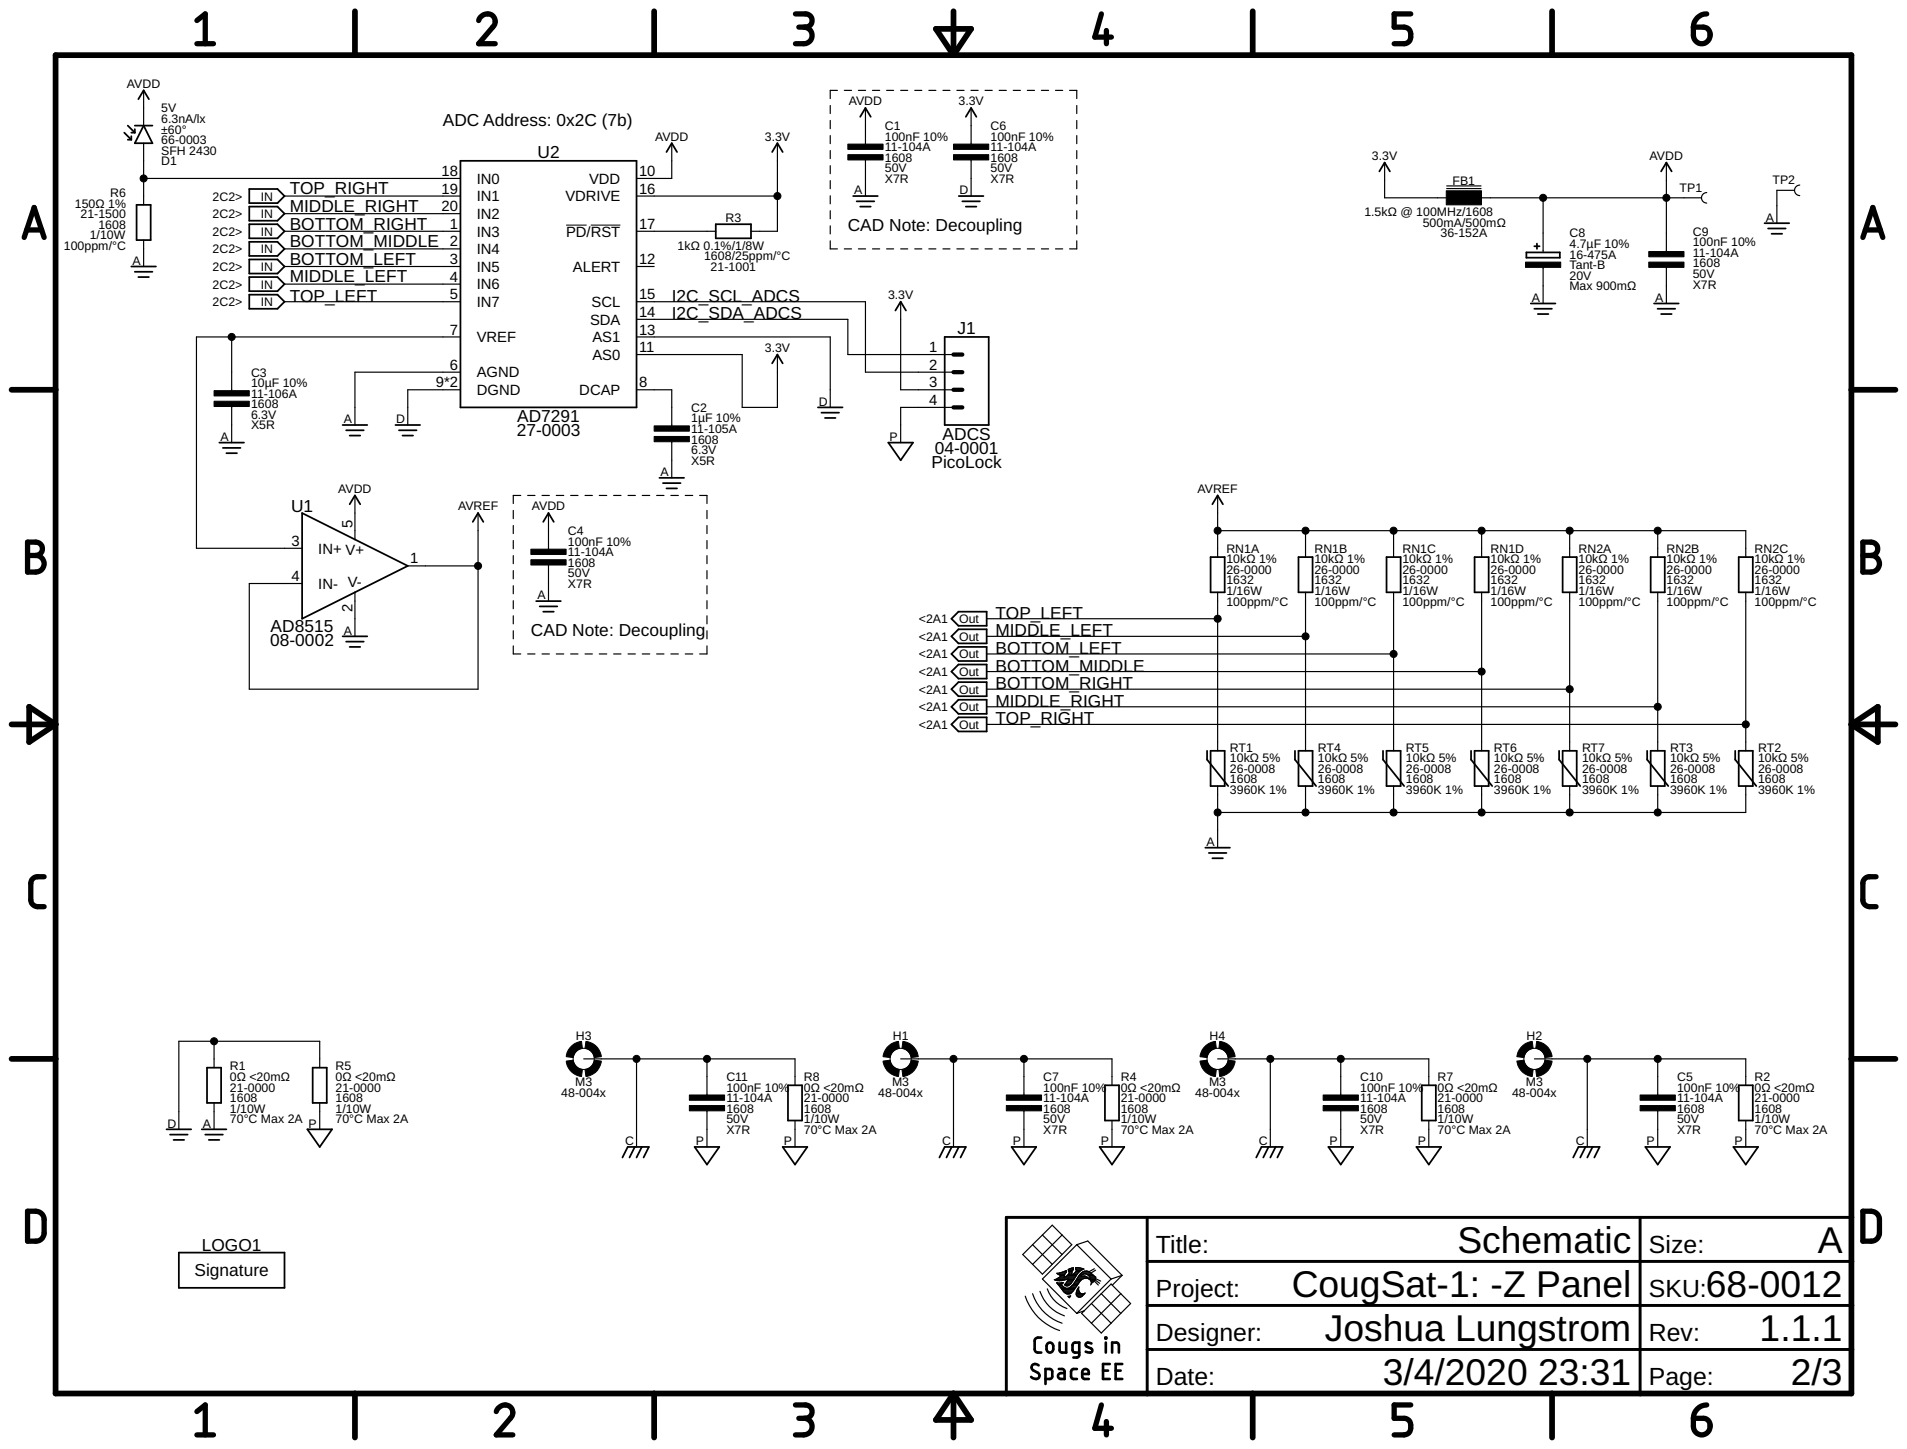
[picture p247: page 2]

Out Out Out
MIDDLE_LEFT

BOTTOM_LEFT
BOTTOM_MIDDLE
BOTTOM_RIGHT
MIDDLE_RIGHT
TOP_RIGHT

3960K 1% | 3960K 1% | 3960K 1% | 3960K 1% | 3960K 1% | 3960K 1% | 26-0008 Out

Schematic Title: | A Size:

CougSat-1: -Z Panel Project: | 68-0012 SKU:

Joshua Lungstrom Designer: | 1.1.1 Rev:

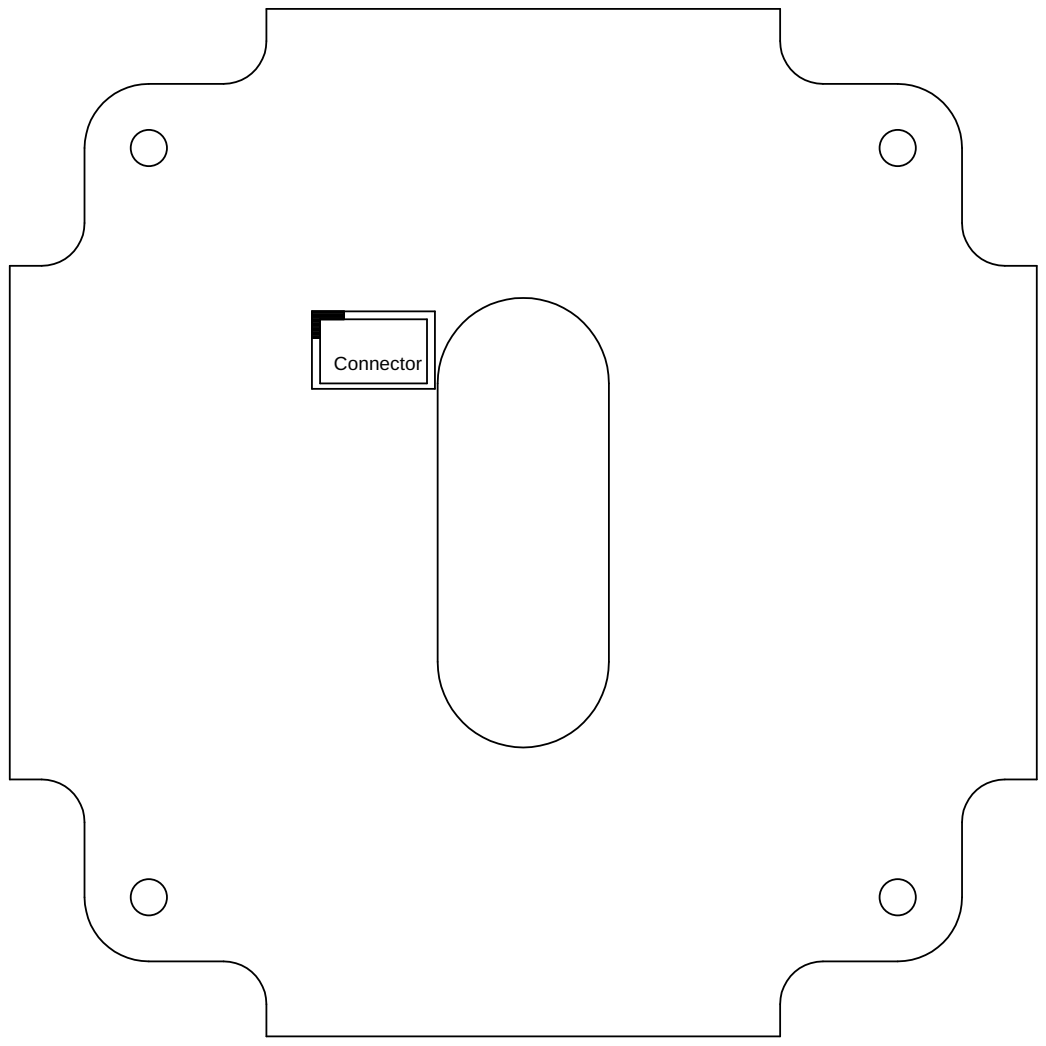
[picture p248: page 3]

Mechanical Title: | A Size:

CougSat-1: -Z Panel Project: | 68-0012 SKU:

Joshua Lungstrom Designer: | 1.1.1 Rev:
