CougsInSpace/CougSat1-Hardware/CougSat1-Backplane/Documentation/Backplane.pdf

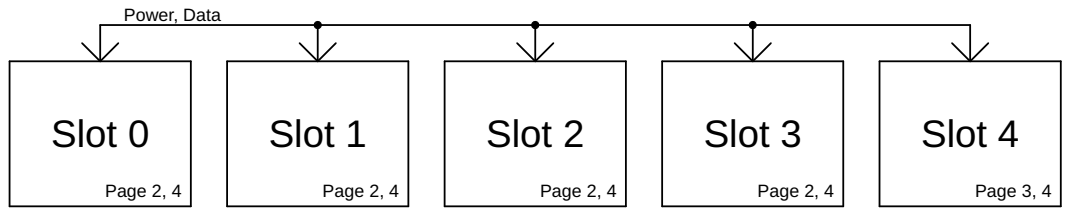
[picture p249: page 1]

Page 1: Block Diagram Page 2: Data Bus Slots 0 - 3 Page 3: Data Bus Slots 4 - 7 Page 4: Power Bus Page 5: Mechanical | Block Diagram Title: | A Size:

CougSat-1: Backplane Project: | 68-0005 SKU:

Hendrik Melse Designer: | 3.2.1 Rev:

2/15/2020 21:30 Date: | Page:

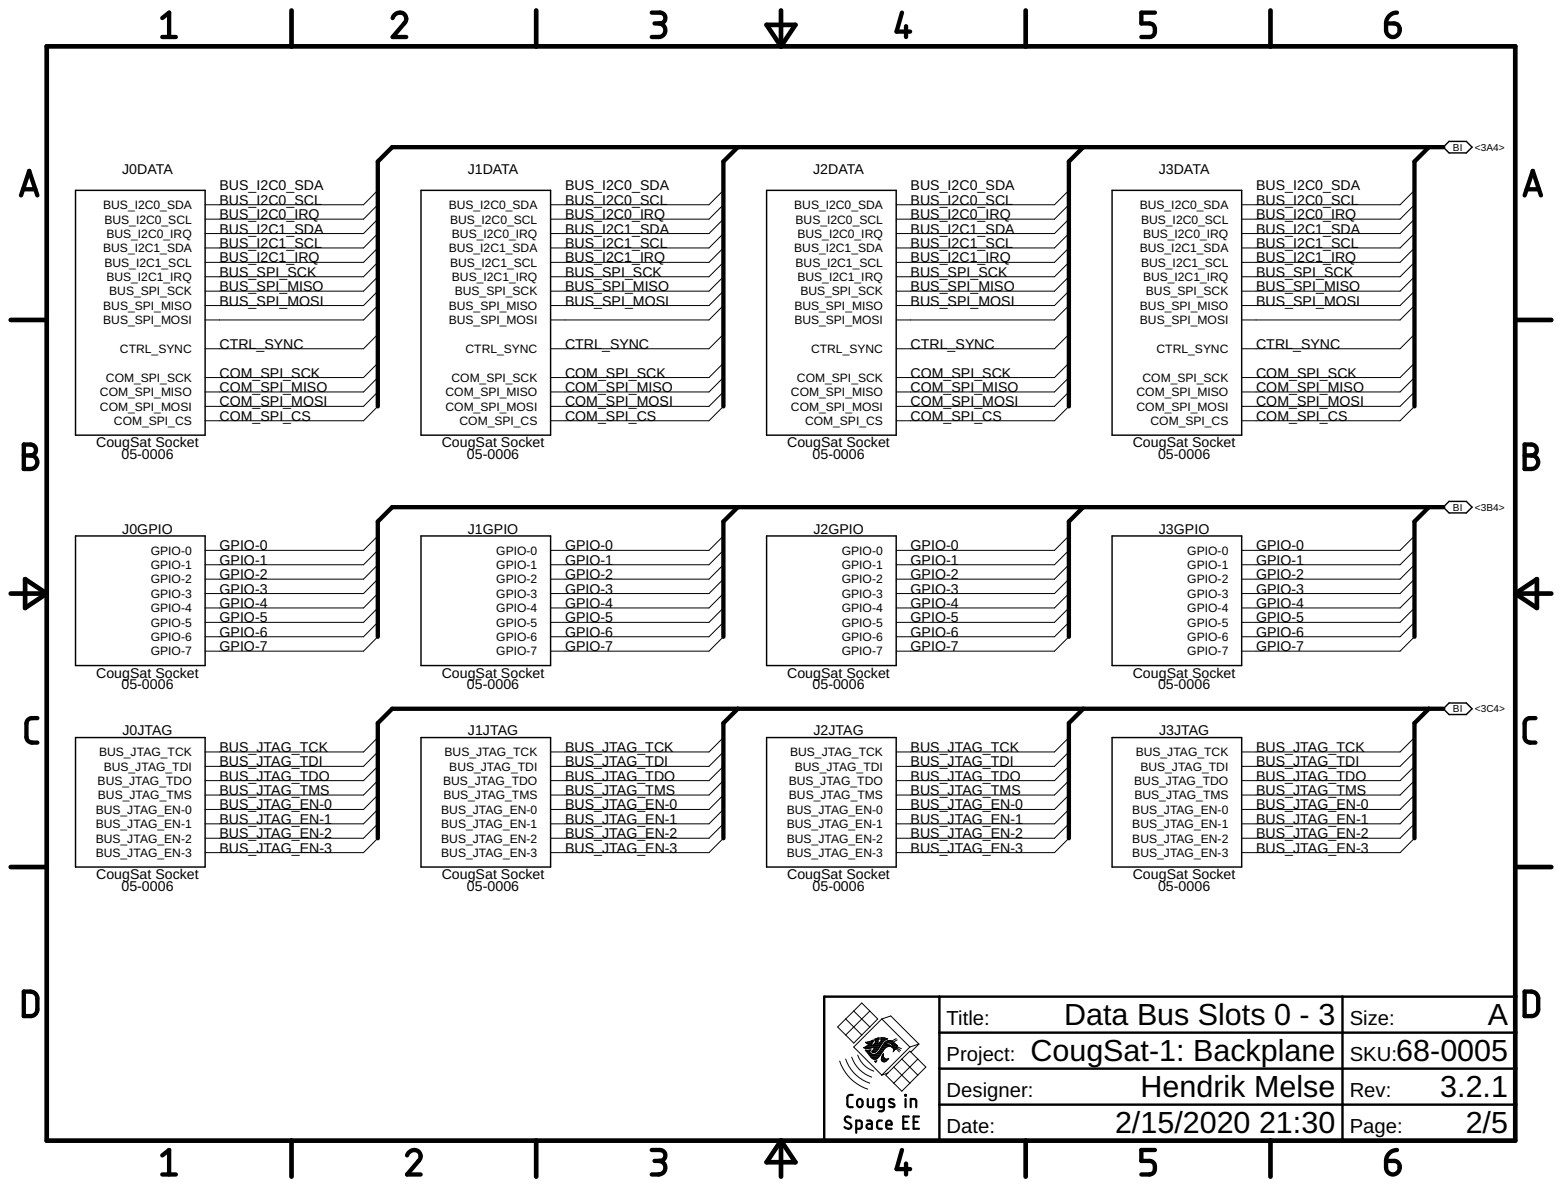
[picture p250: page 2]

J0GPIO
GPIO-0 GPIO-1 GPIO-2 GPIO-3 GPIO-4 GPIO-5 GPIO-6 GPIO-7

J1GPIO

J2GPIO

J3GPIO

Data Bus Slots 0 - 3 Title: | A Size:

CougSat-1: Backplane Project: | 68-0005 SKU:

Hendrik Melse Designer: | 3.2.1 Rev:

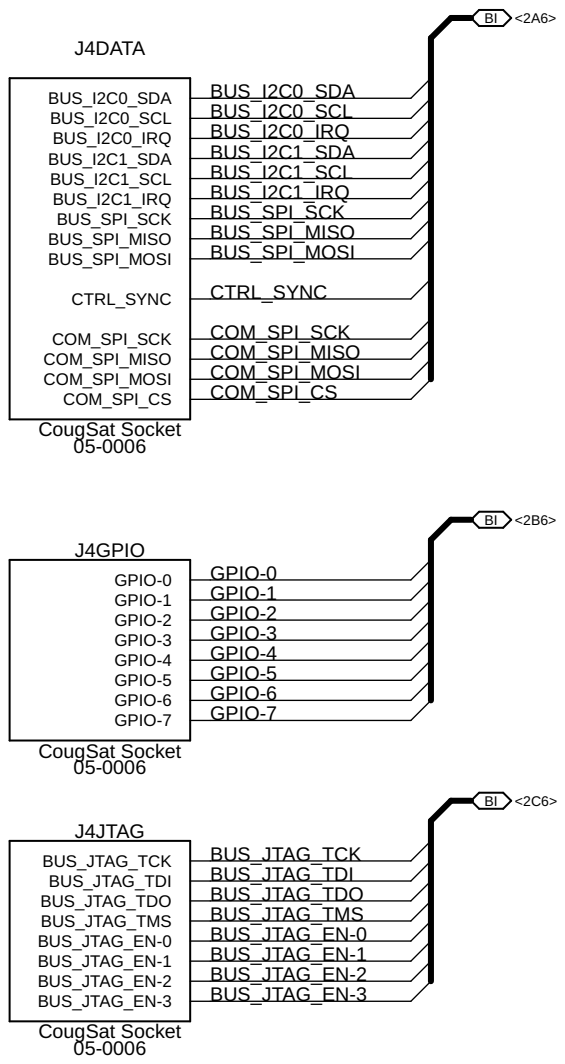
[picture p251: page 3]

J4GPIO
GPIO-0 GPIO-1 GPIO-2 GPIO-3 GPIO-4 GPIO-5 GPIO-6 GPIO-7

Data Bus Slots 4 - 7 Title: | A Size:

CougSat-1: Backplane Project: | 68-0005 SKU:

Hendrik Melse Designer: | 3.2.1 Rev:

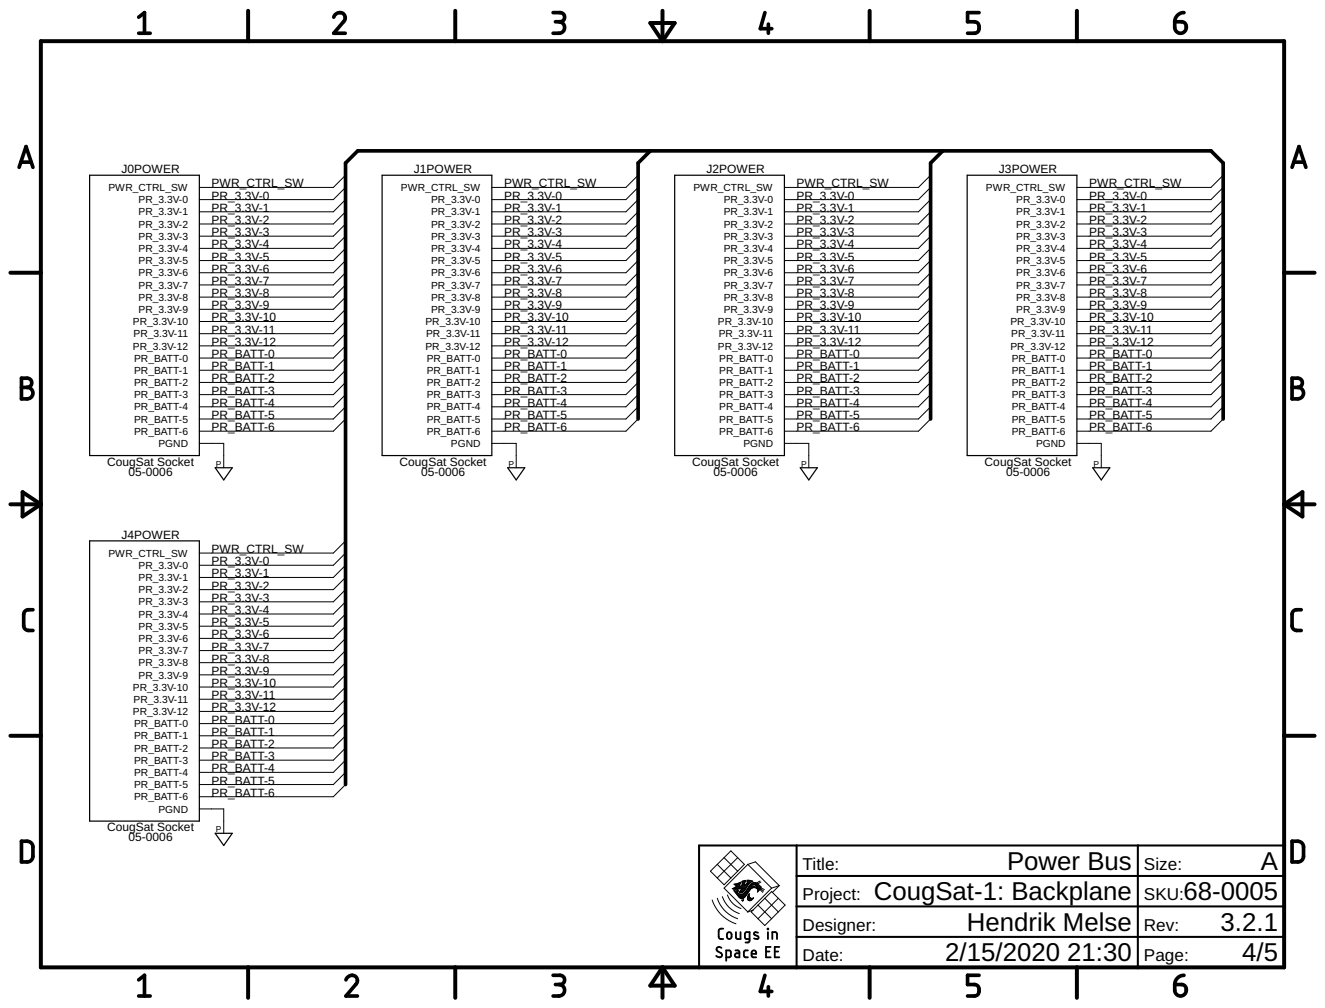
[picture p252: page 4]

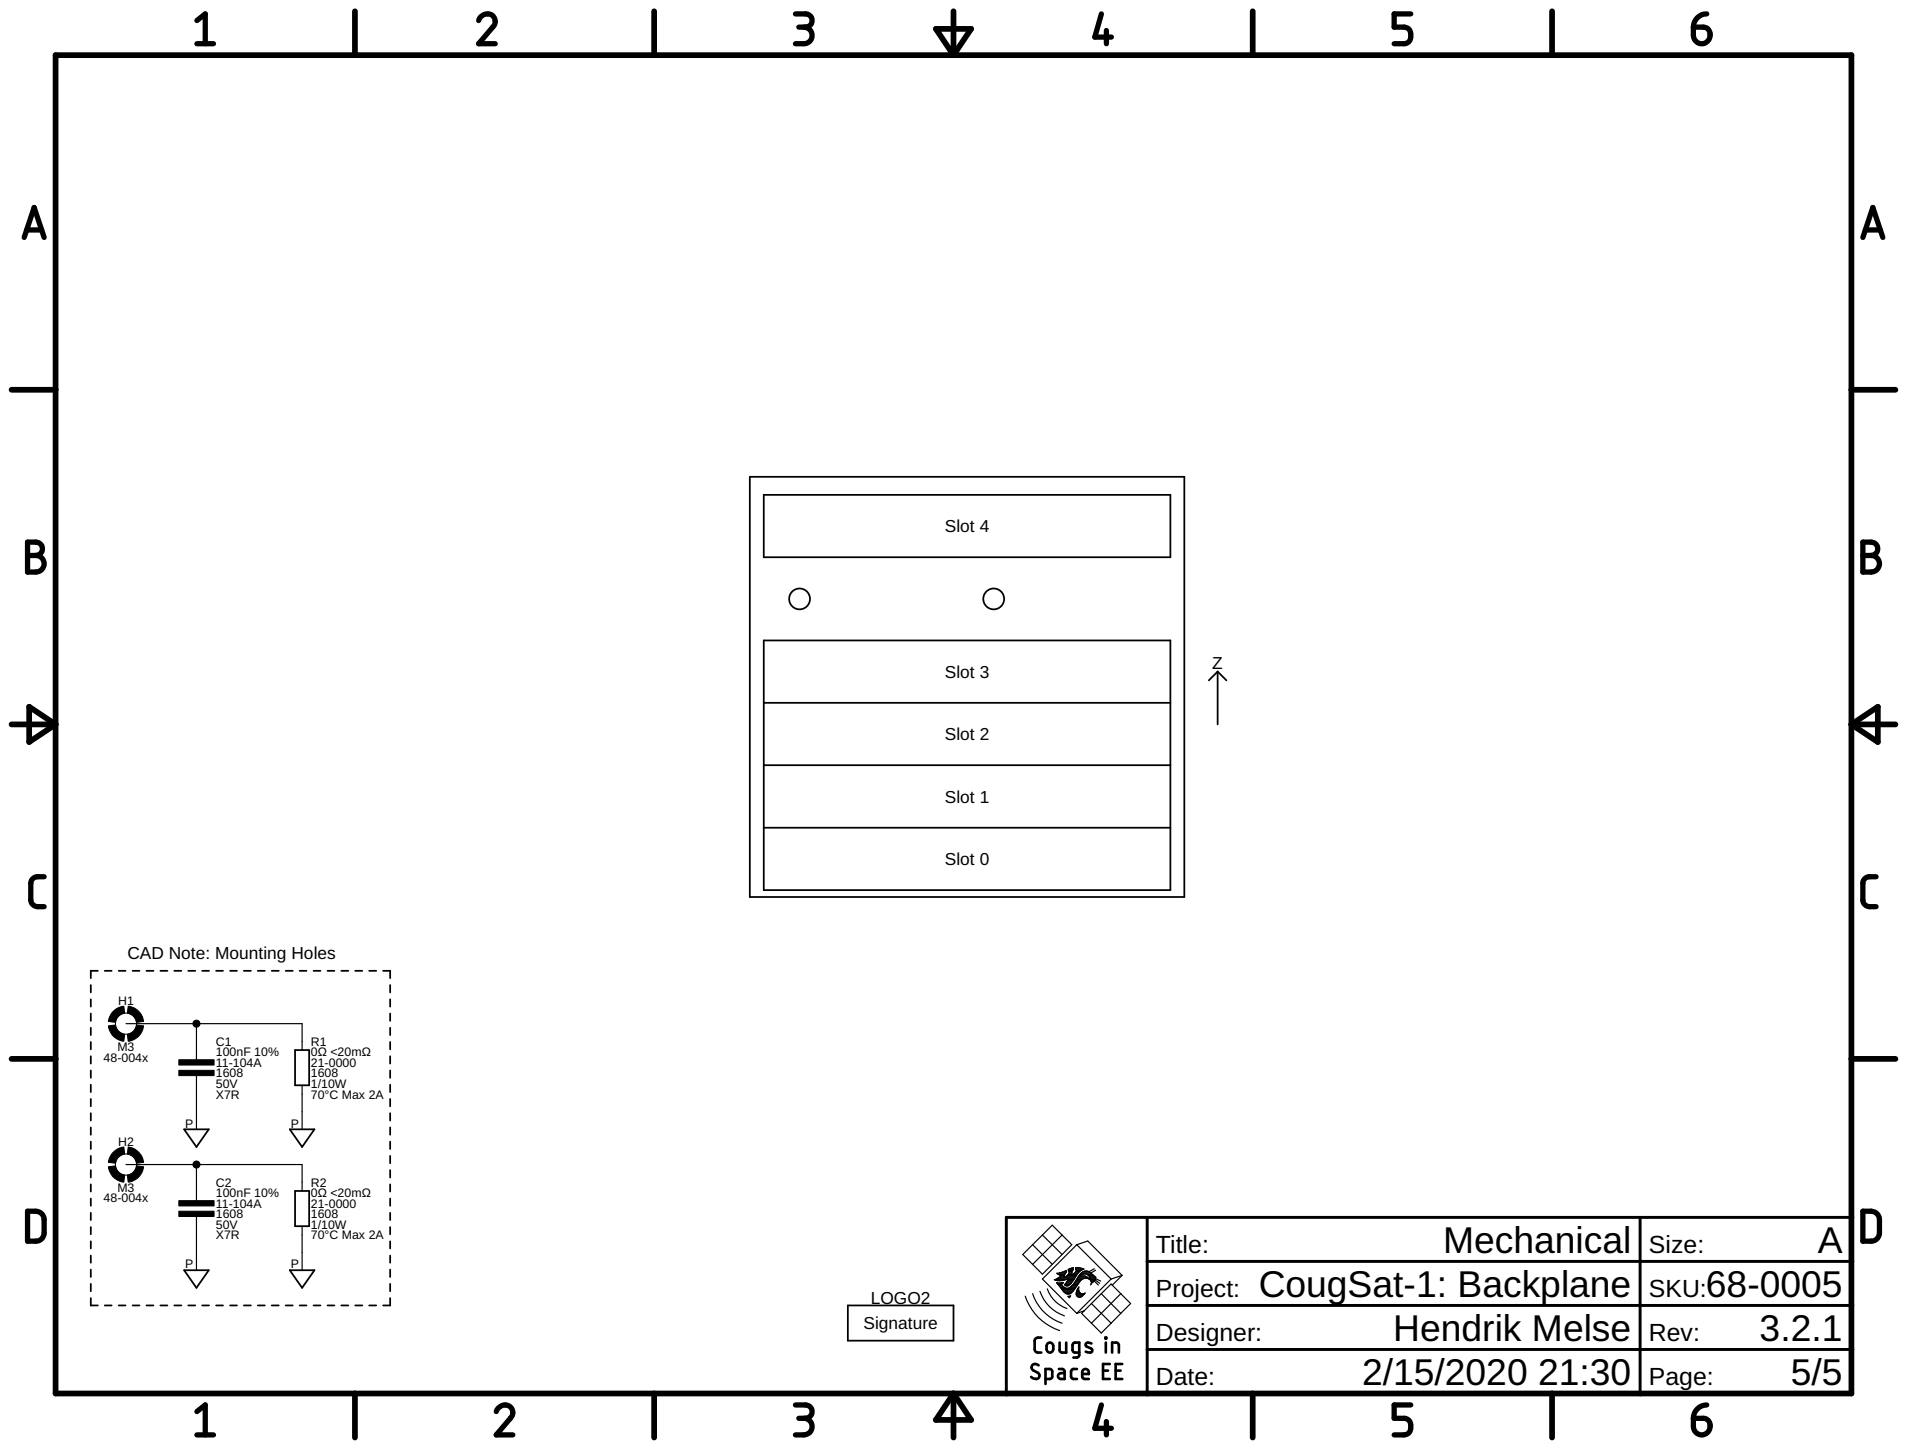
[picture p253: page 5]

Mechanical Title: | A Size:

CougSat-1: Backplane Project: | 68-0005 SKU:
