CougsInSpace/CougSat1-Hardware/CougSat1-PowerBoard/Documentation/SolarPanel-PV2.pdf

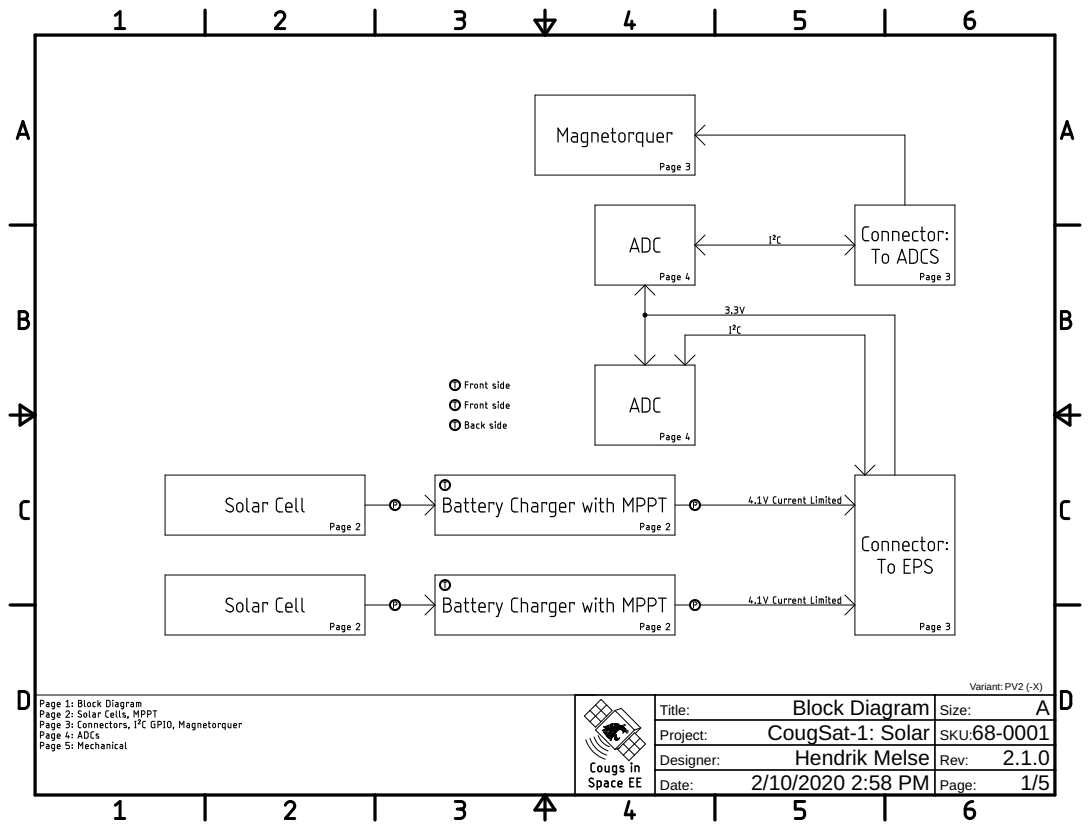
[picture p264: page 1]

Block Diagram Title: | A Size:

CougSat-1: Solar Project: | 68-0001 SKU:

Hendrik Melse Designer: | 2.1.0 Rev:

2/10/2020 2:58 PM Date: | Page:

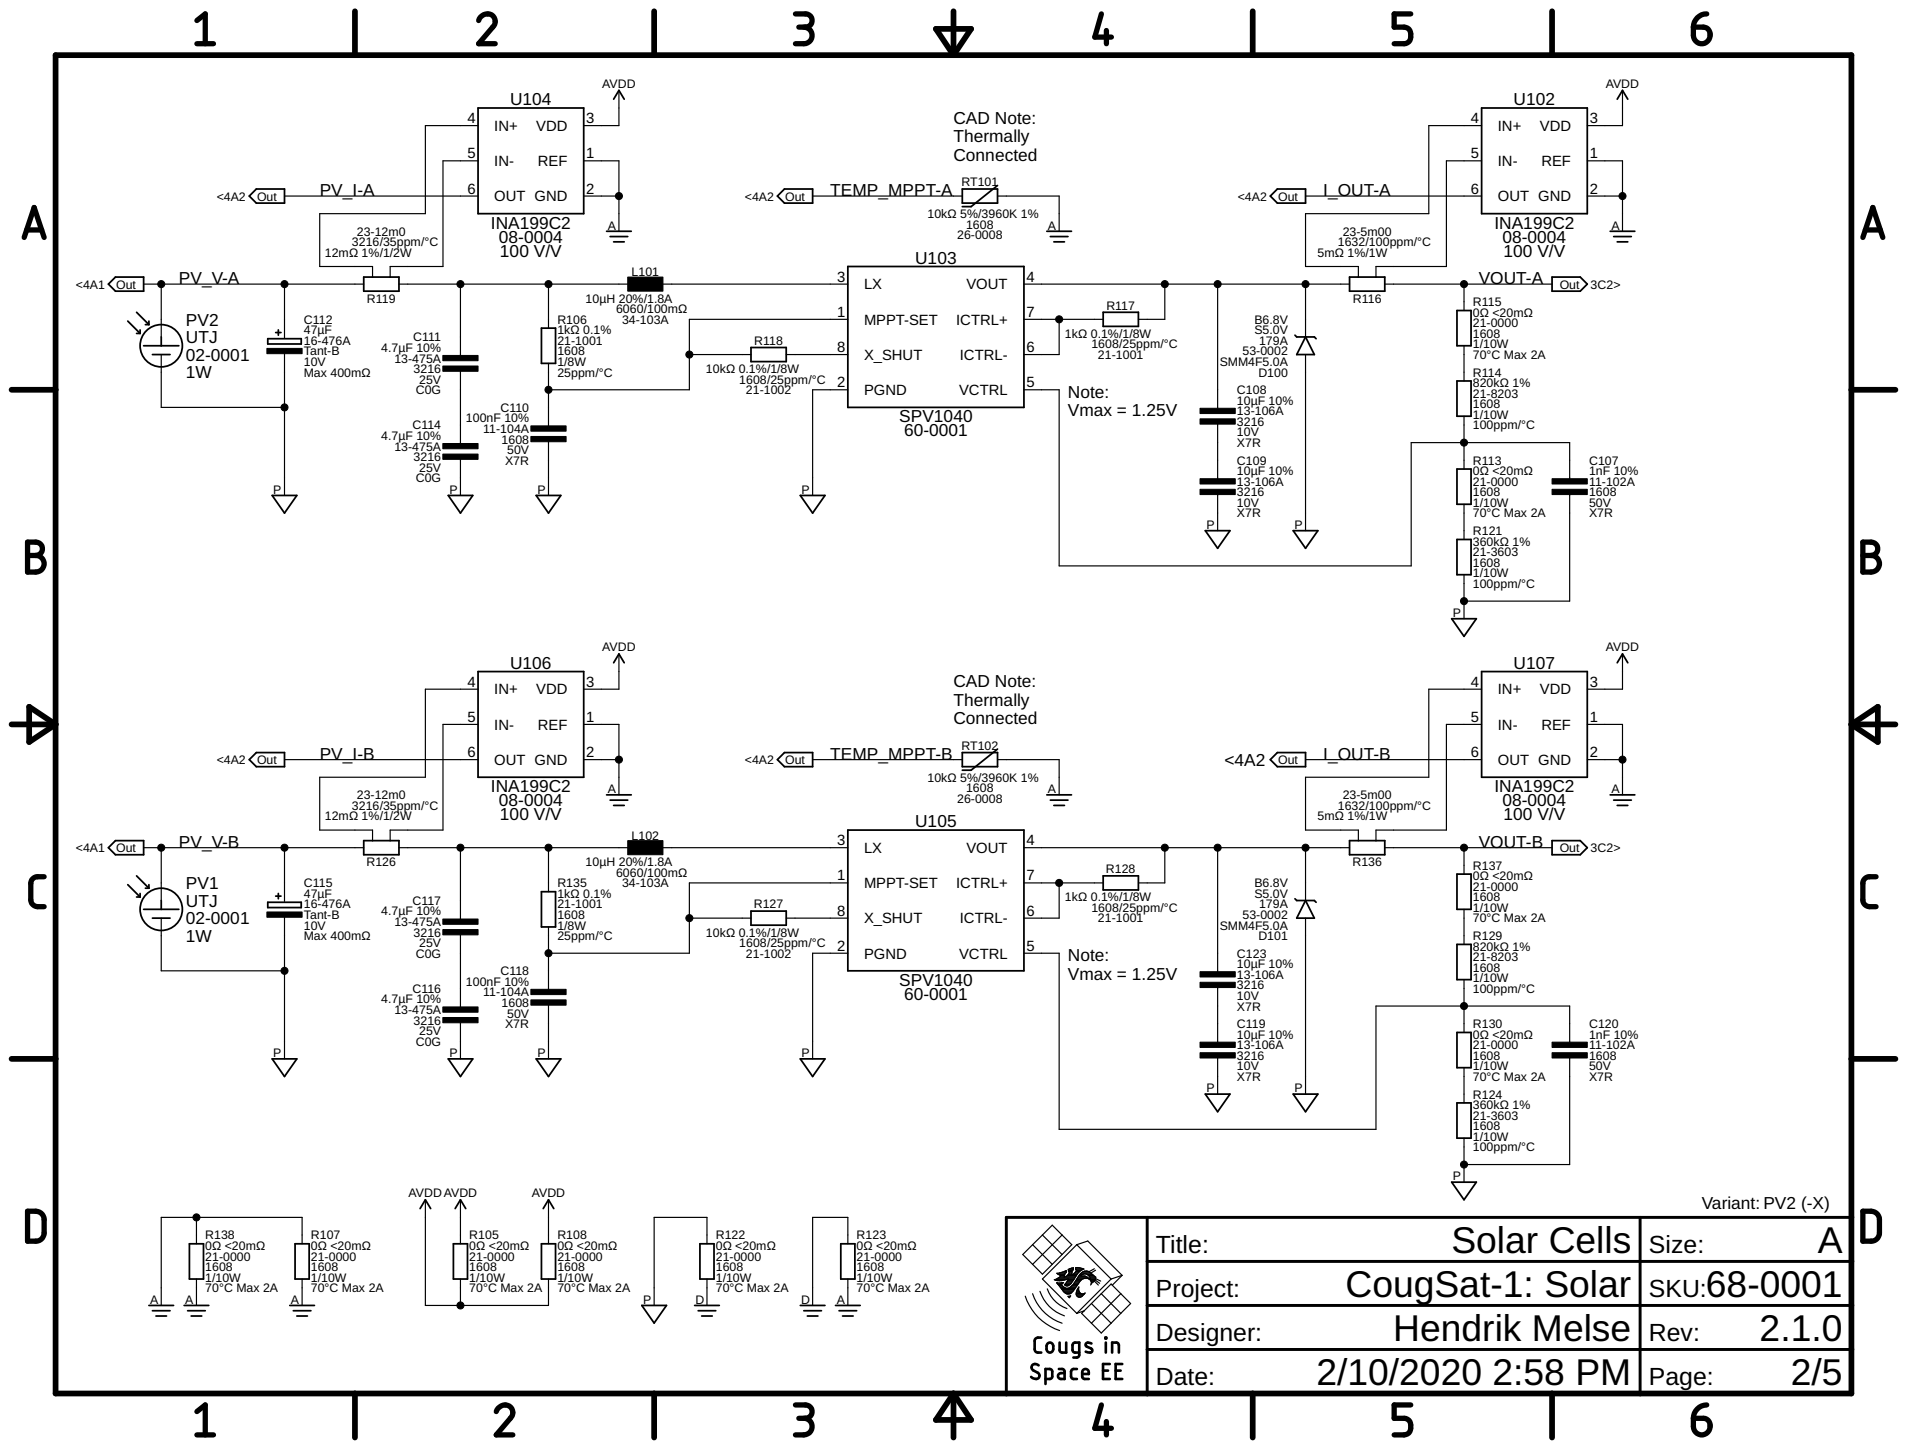
[picture p265: page 2]

Solar Cells Title: | A Size:

CougSat-1: Solar Project: | 68-0001 SKU:

Hendrik Melse Designer: | 2.1.0 Rev:

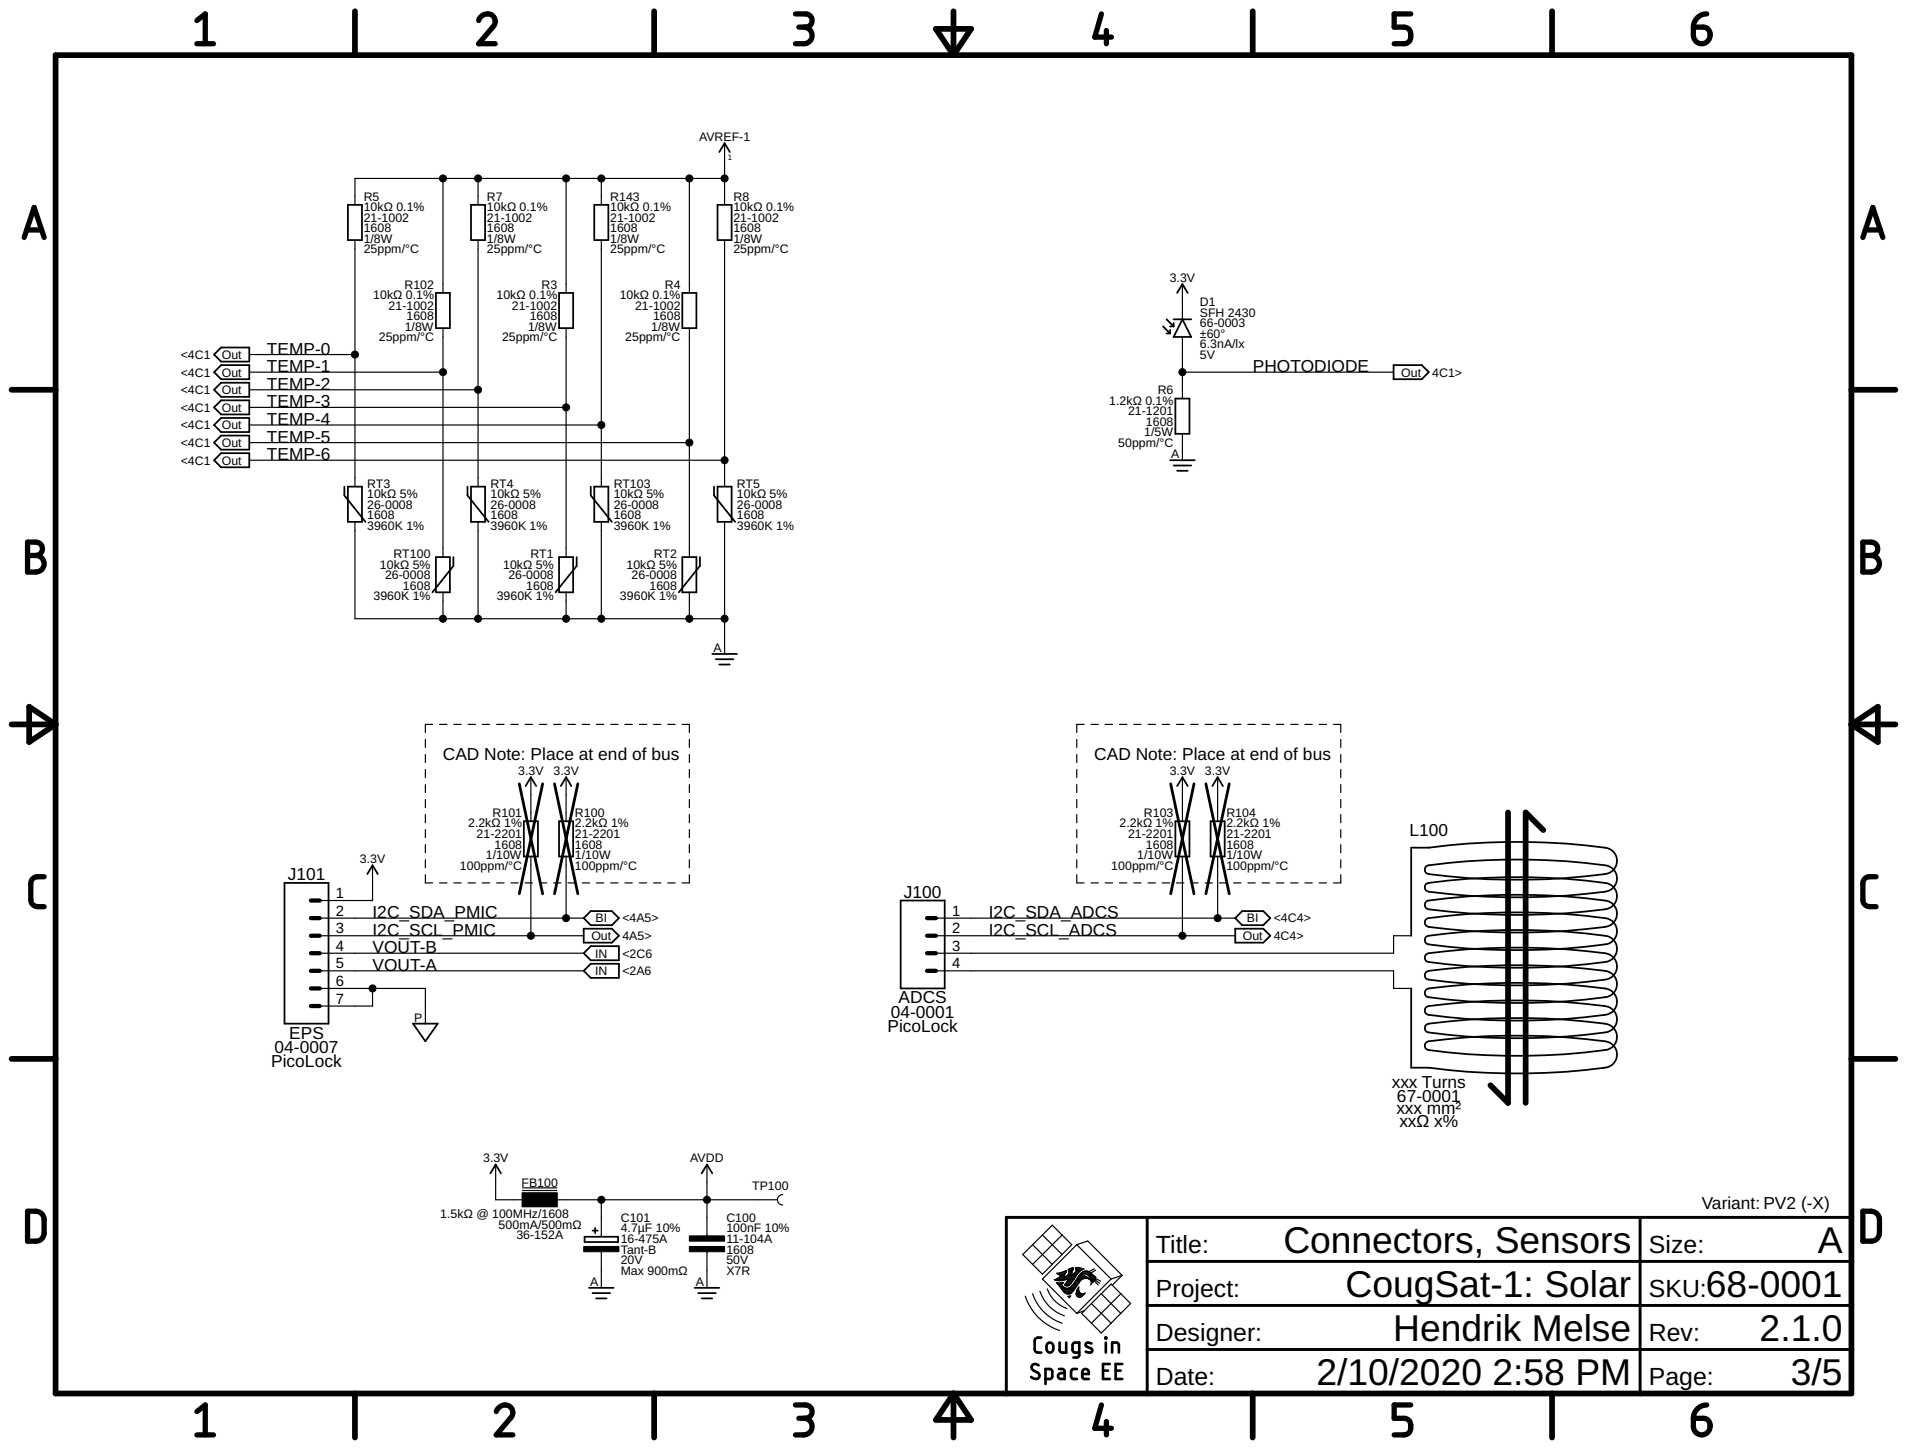
[picture p266: page 3]

TEMP-3
TEMP-4
TEMP-5
TEMP-6

CAD Note: Place at end of bus

Connectors, Sensors Title: | A Size:

CougSat-1: Solar Project: | 68-0001 SKU:

Hendrik Melse Designer: | 2.1.0 Rev:

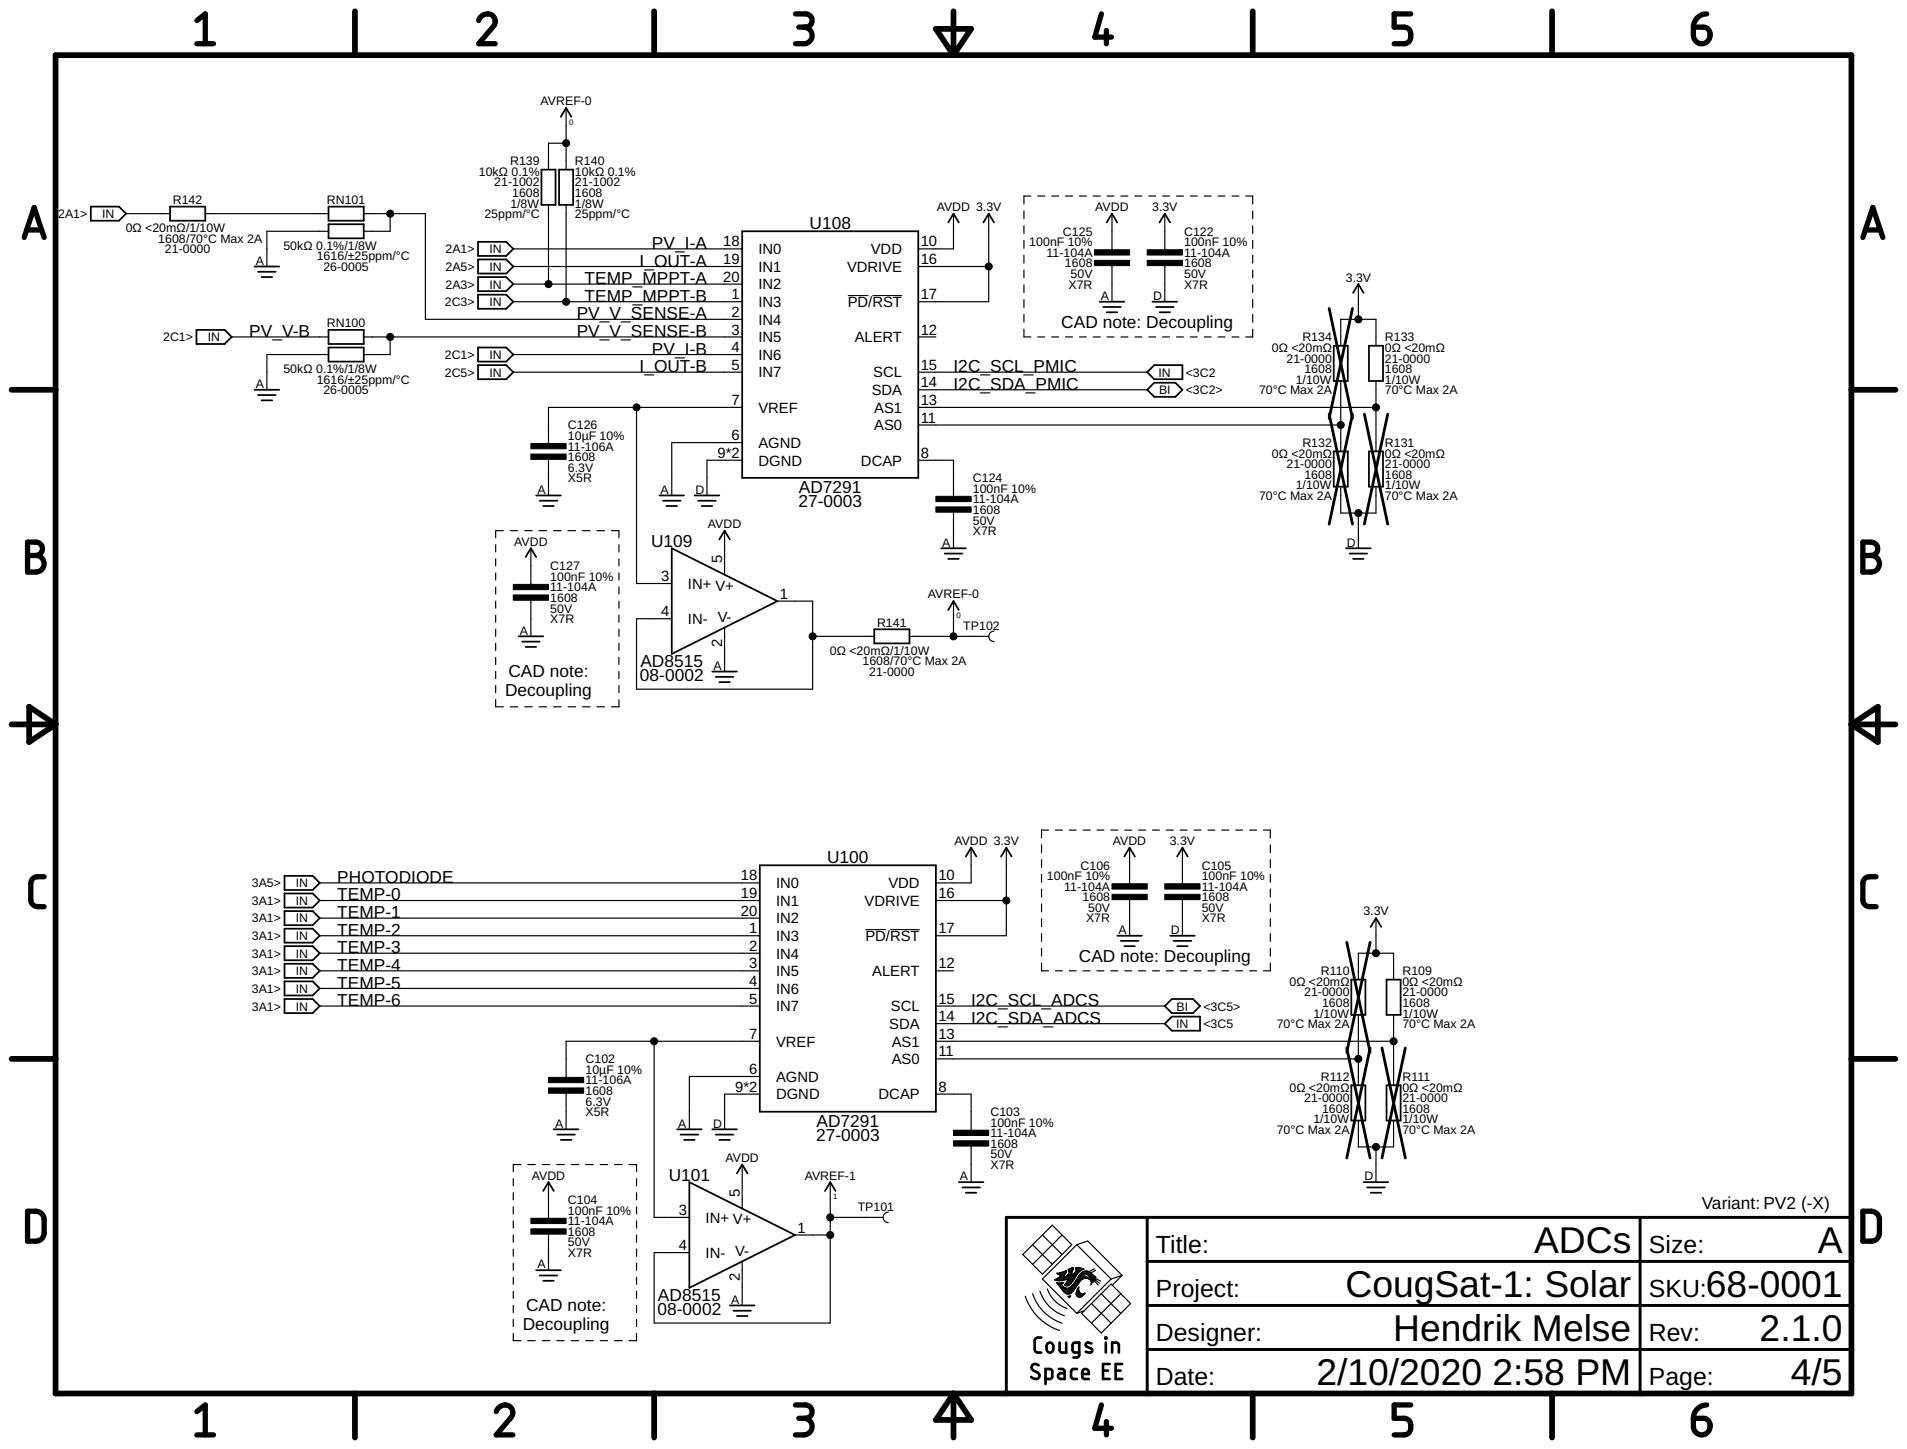
[picture p267: page 4]

ADCs Title: | A Size:

CougSat-1: Solar Project: | 68-0001 SKU:

Hendrik Melse Designer: | 2.1.0 Rev:

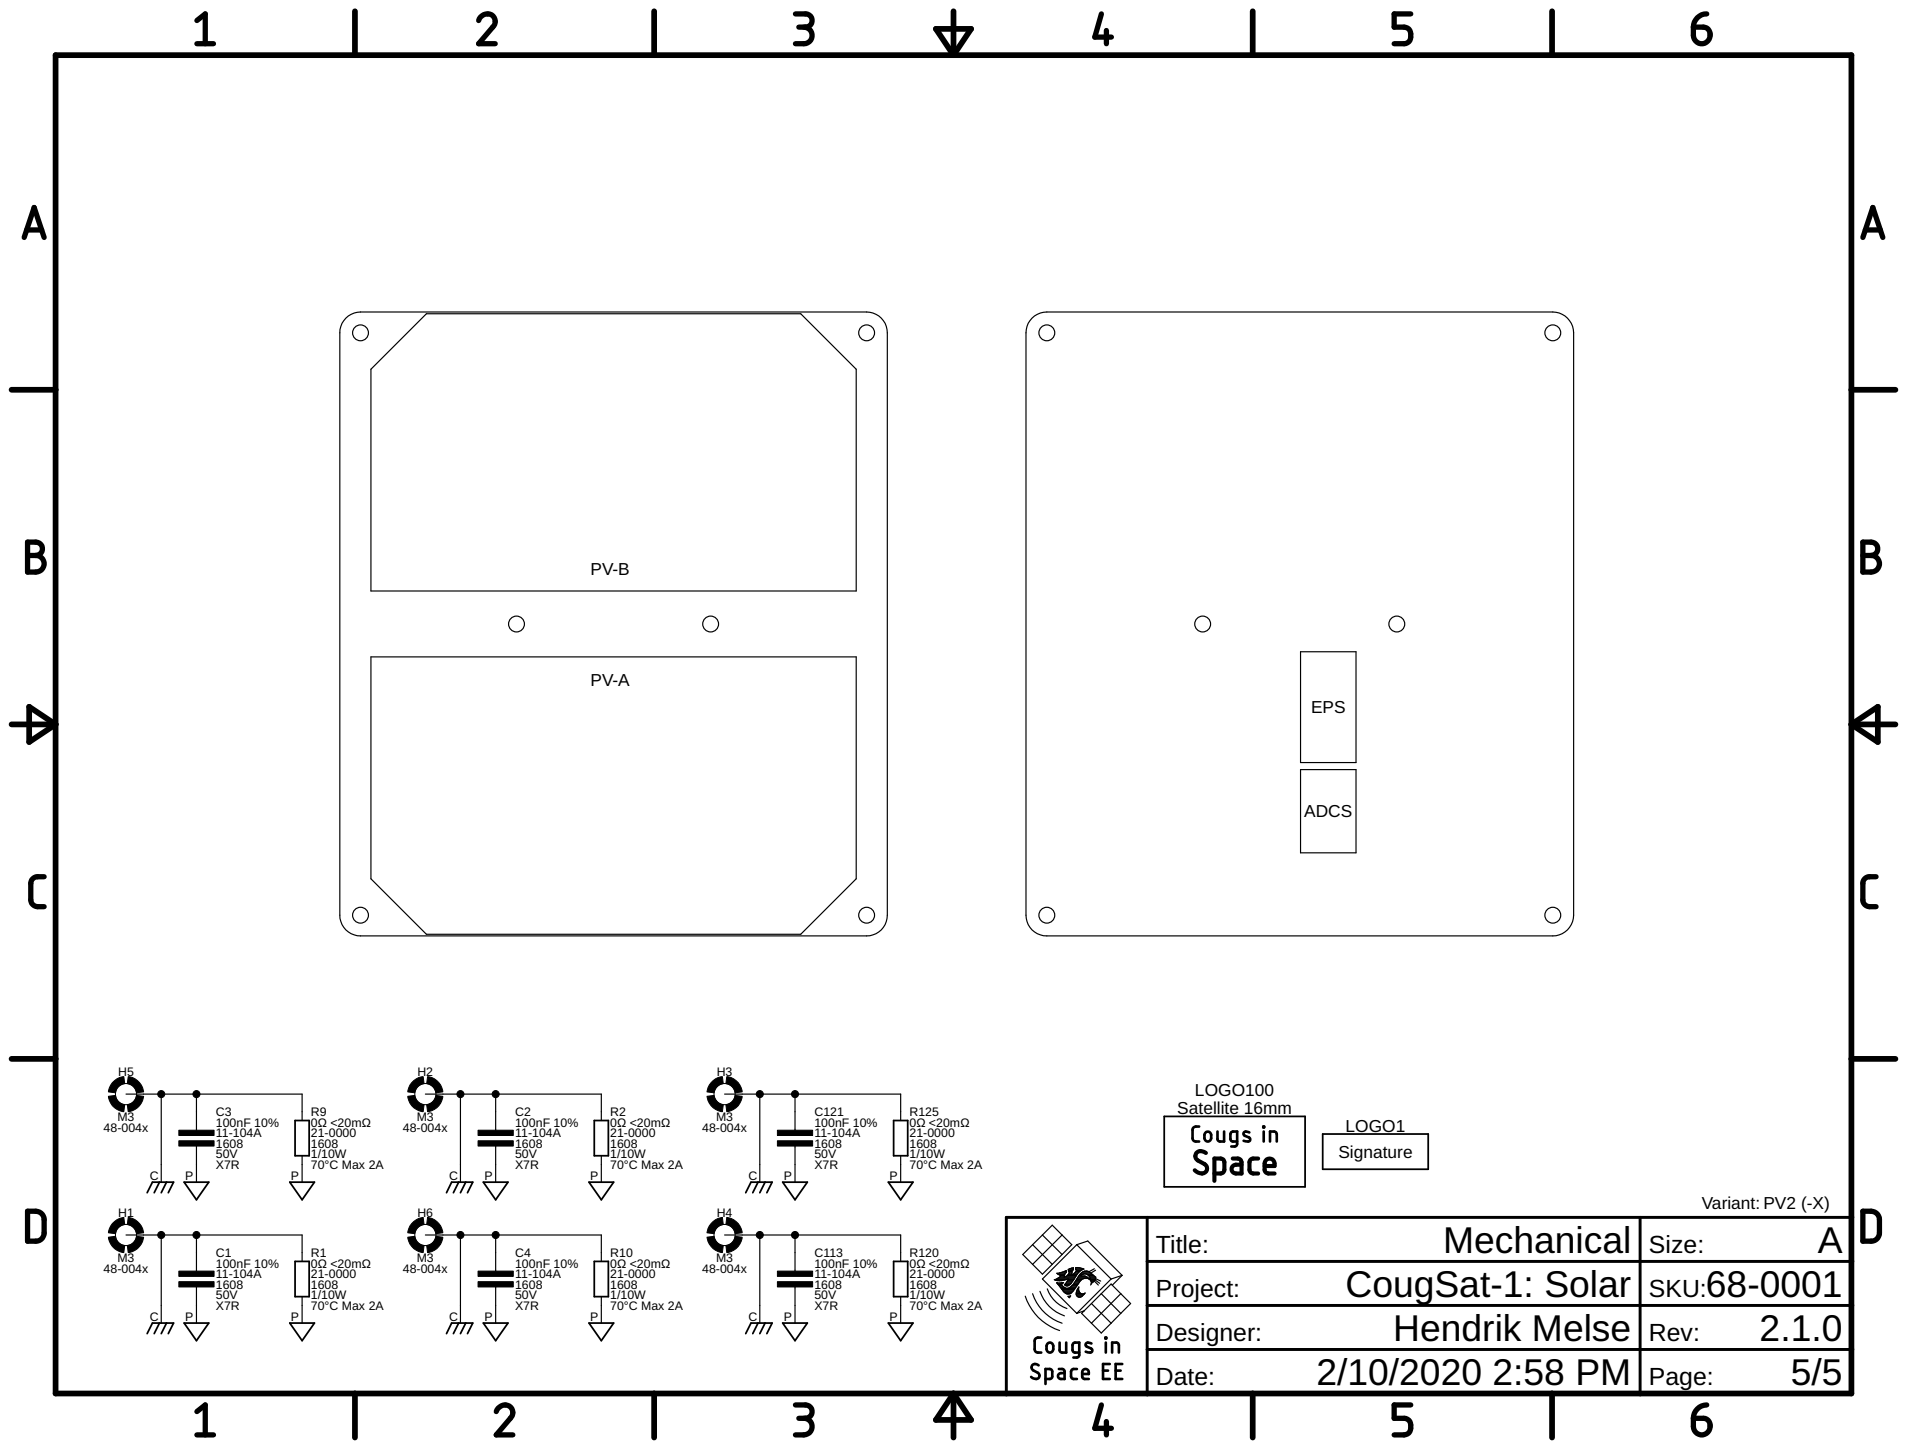
[picture p268: page 5]

Mechanical Title: | A Size:

CougSat-1: Solar Project: | 68-0001 SKU:

Hendrik Melse Designer: | 2.1.0 Rev:
