CougsInSpace/CougSat1-Hardware/CougSat1-PowerBoard/Documentation/SolarPanel-PV3.pdf

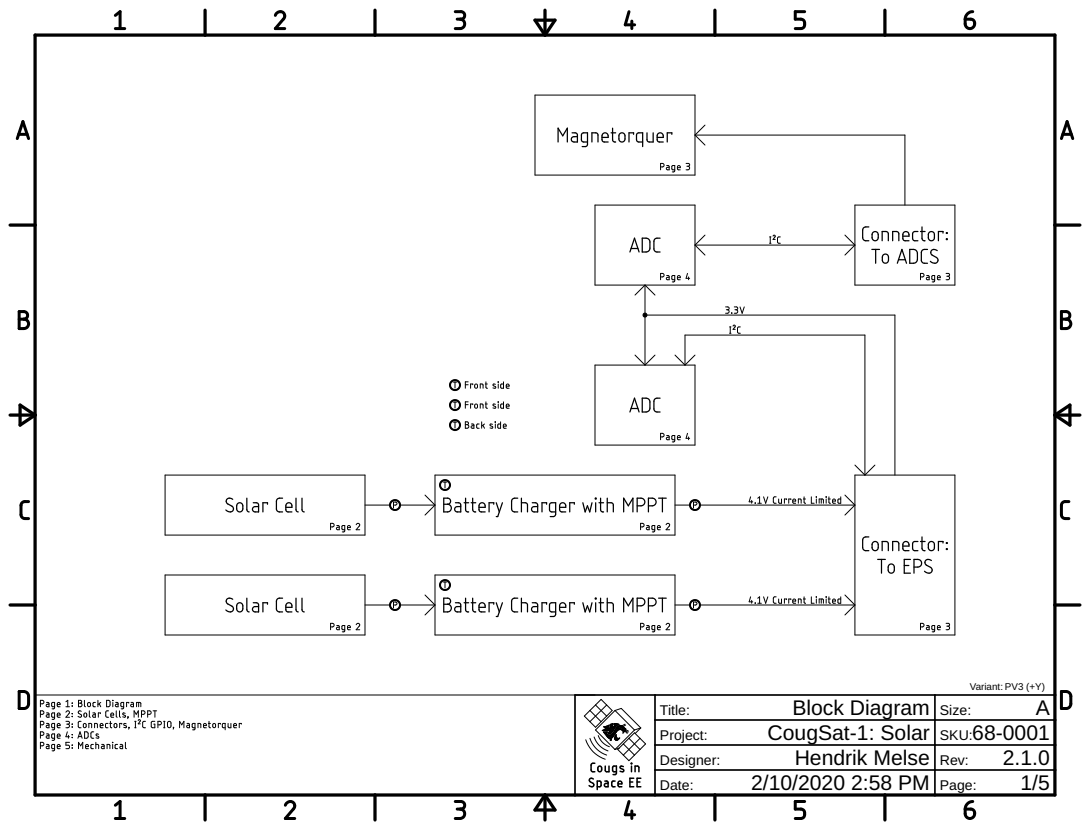
[picture p269: page 1]

Block Diagram Title: | A Size:

CougSat-1: Solar Project: | 68-0001 SKU:

Hendrik Melse Designer: | 2.1.0 Rev:

2/10/2020 2:58 PM Date: | Page:

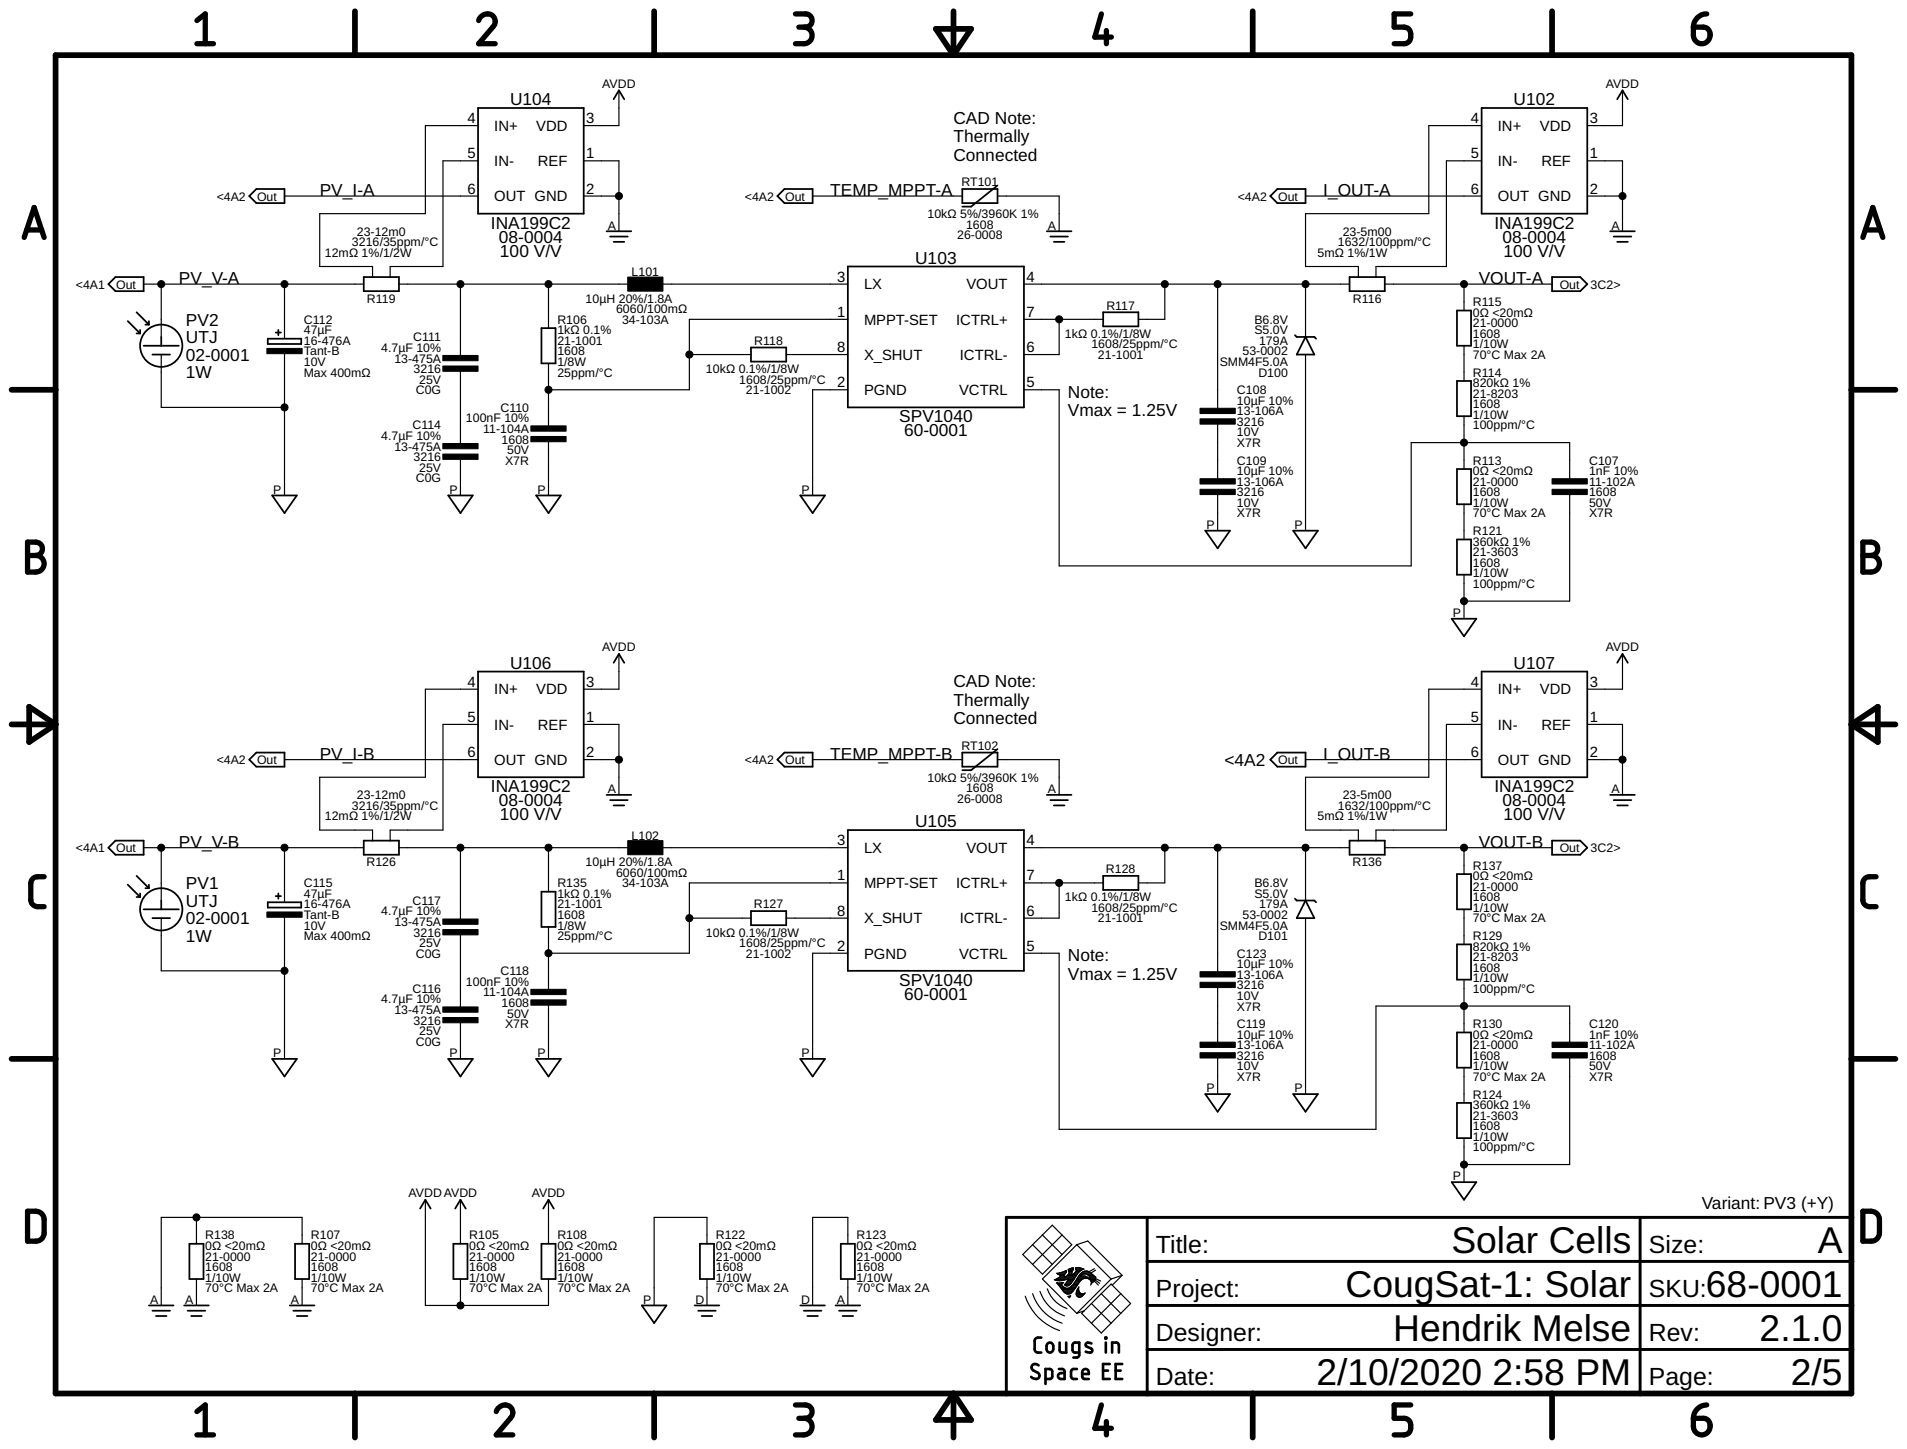
[picture p270: page 2]

Solar Cells Title: | A Size:

CougSat-1: Solar Project: | 68-0001 SKU:

Hendrik Melse Designer: | 2.1.0 Rev:

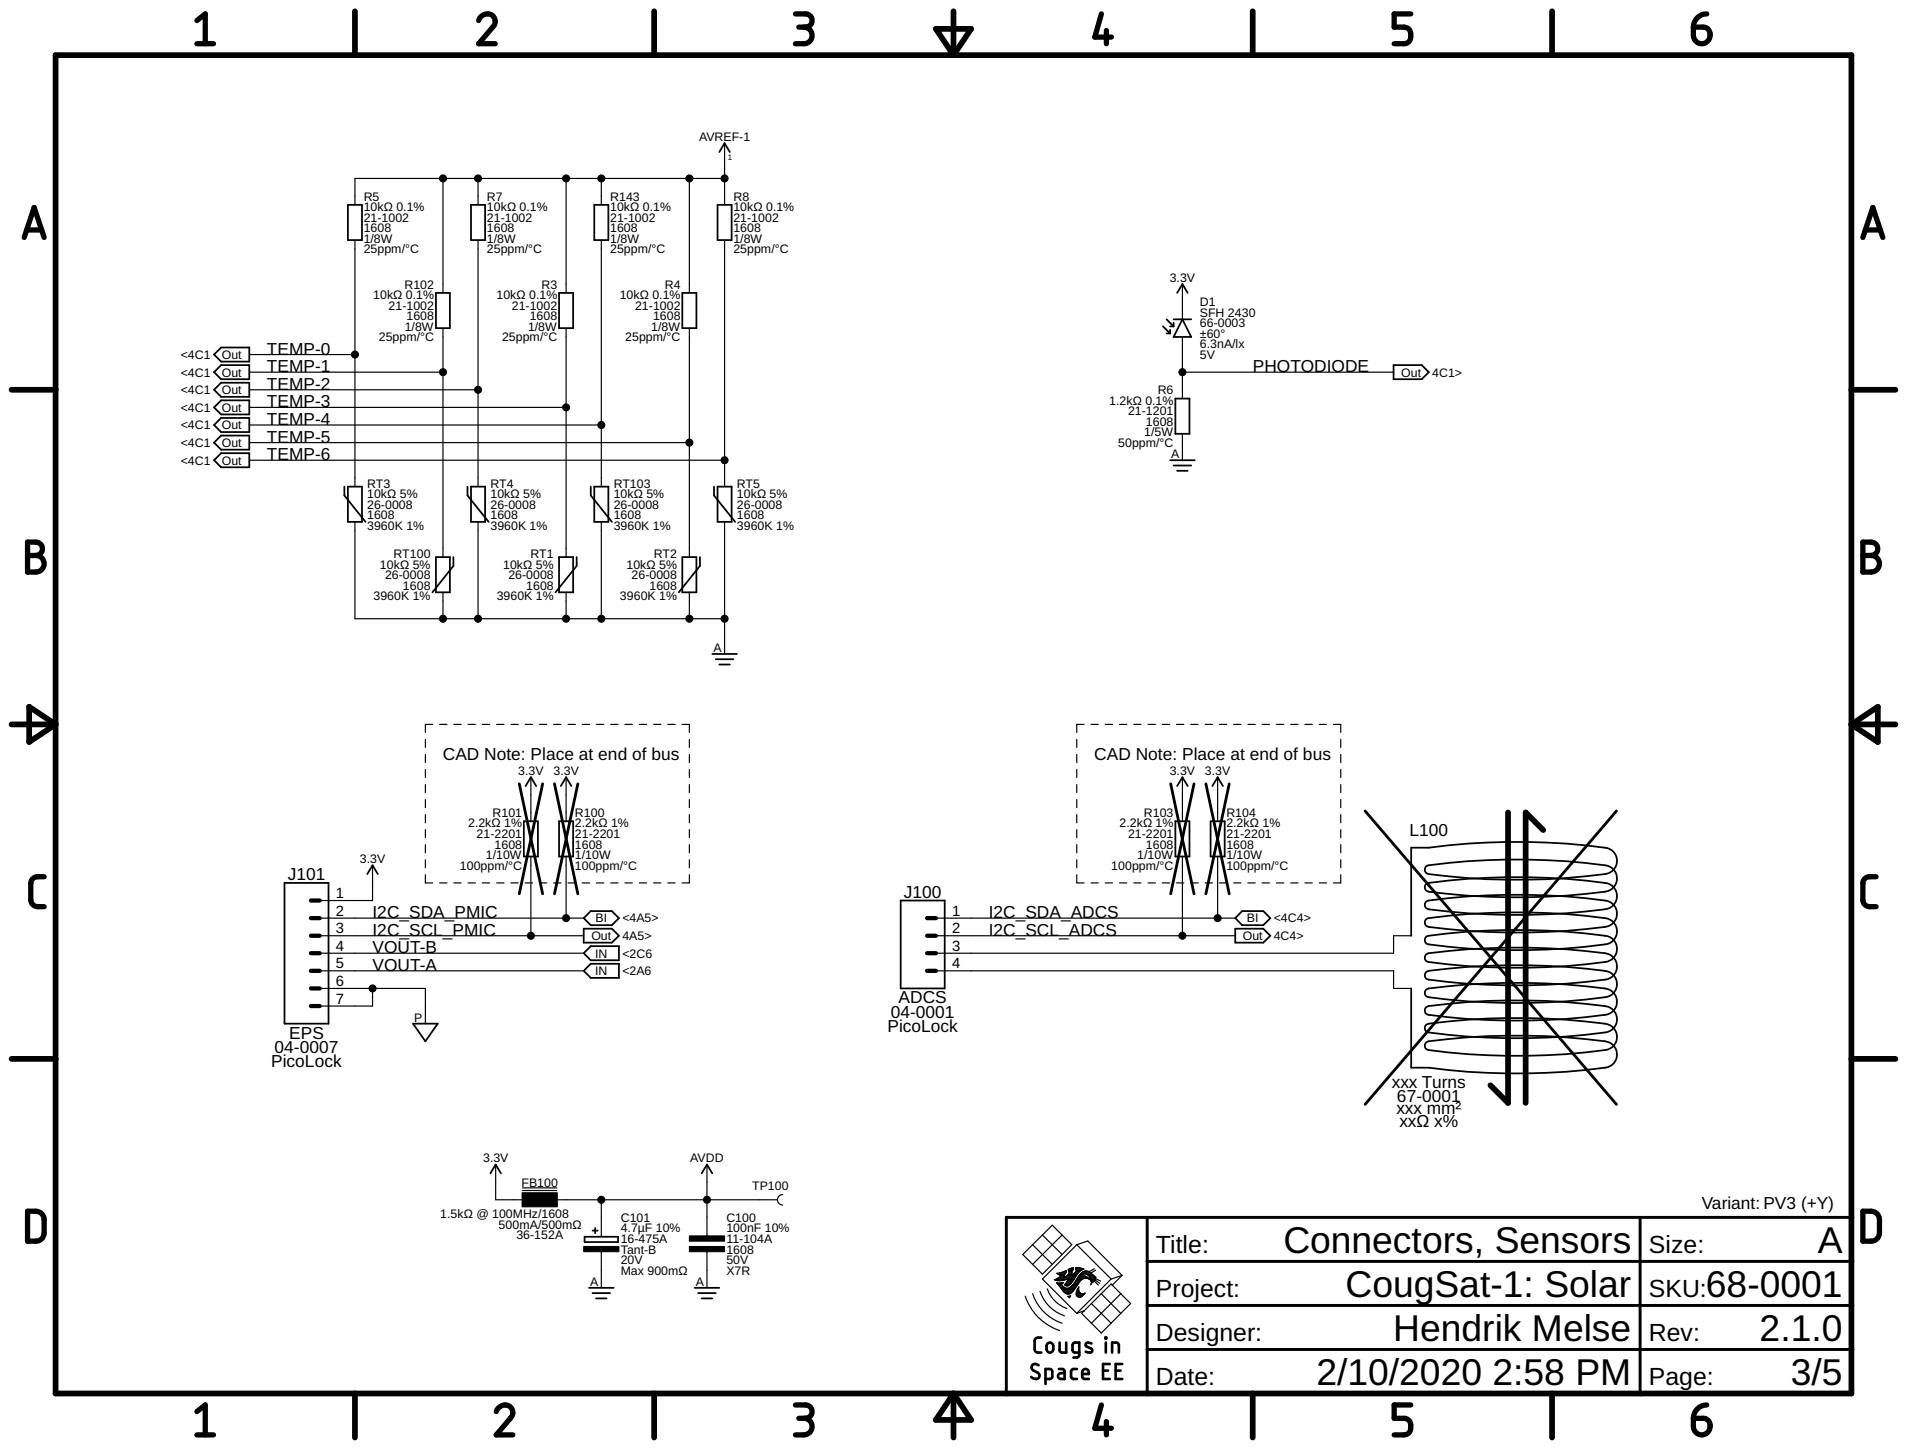
[picture p271: page 3]

TEMP-3
TEMP-4
TEMP-5
TEMP-6

CAD Note: Place at end of bus

Connectors, Sensors Title: | A Size:

CougSat-1: Solar Project: | 68-0001 SKU:

Hendrik Melse Designer: | 2.1.0 Rev:

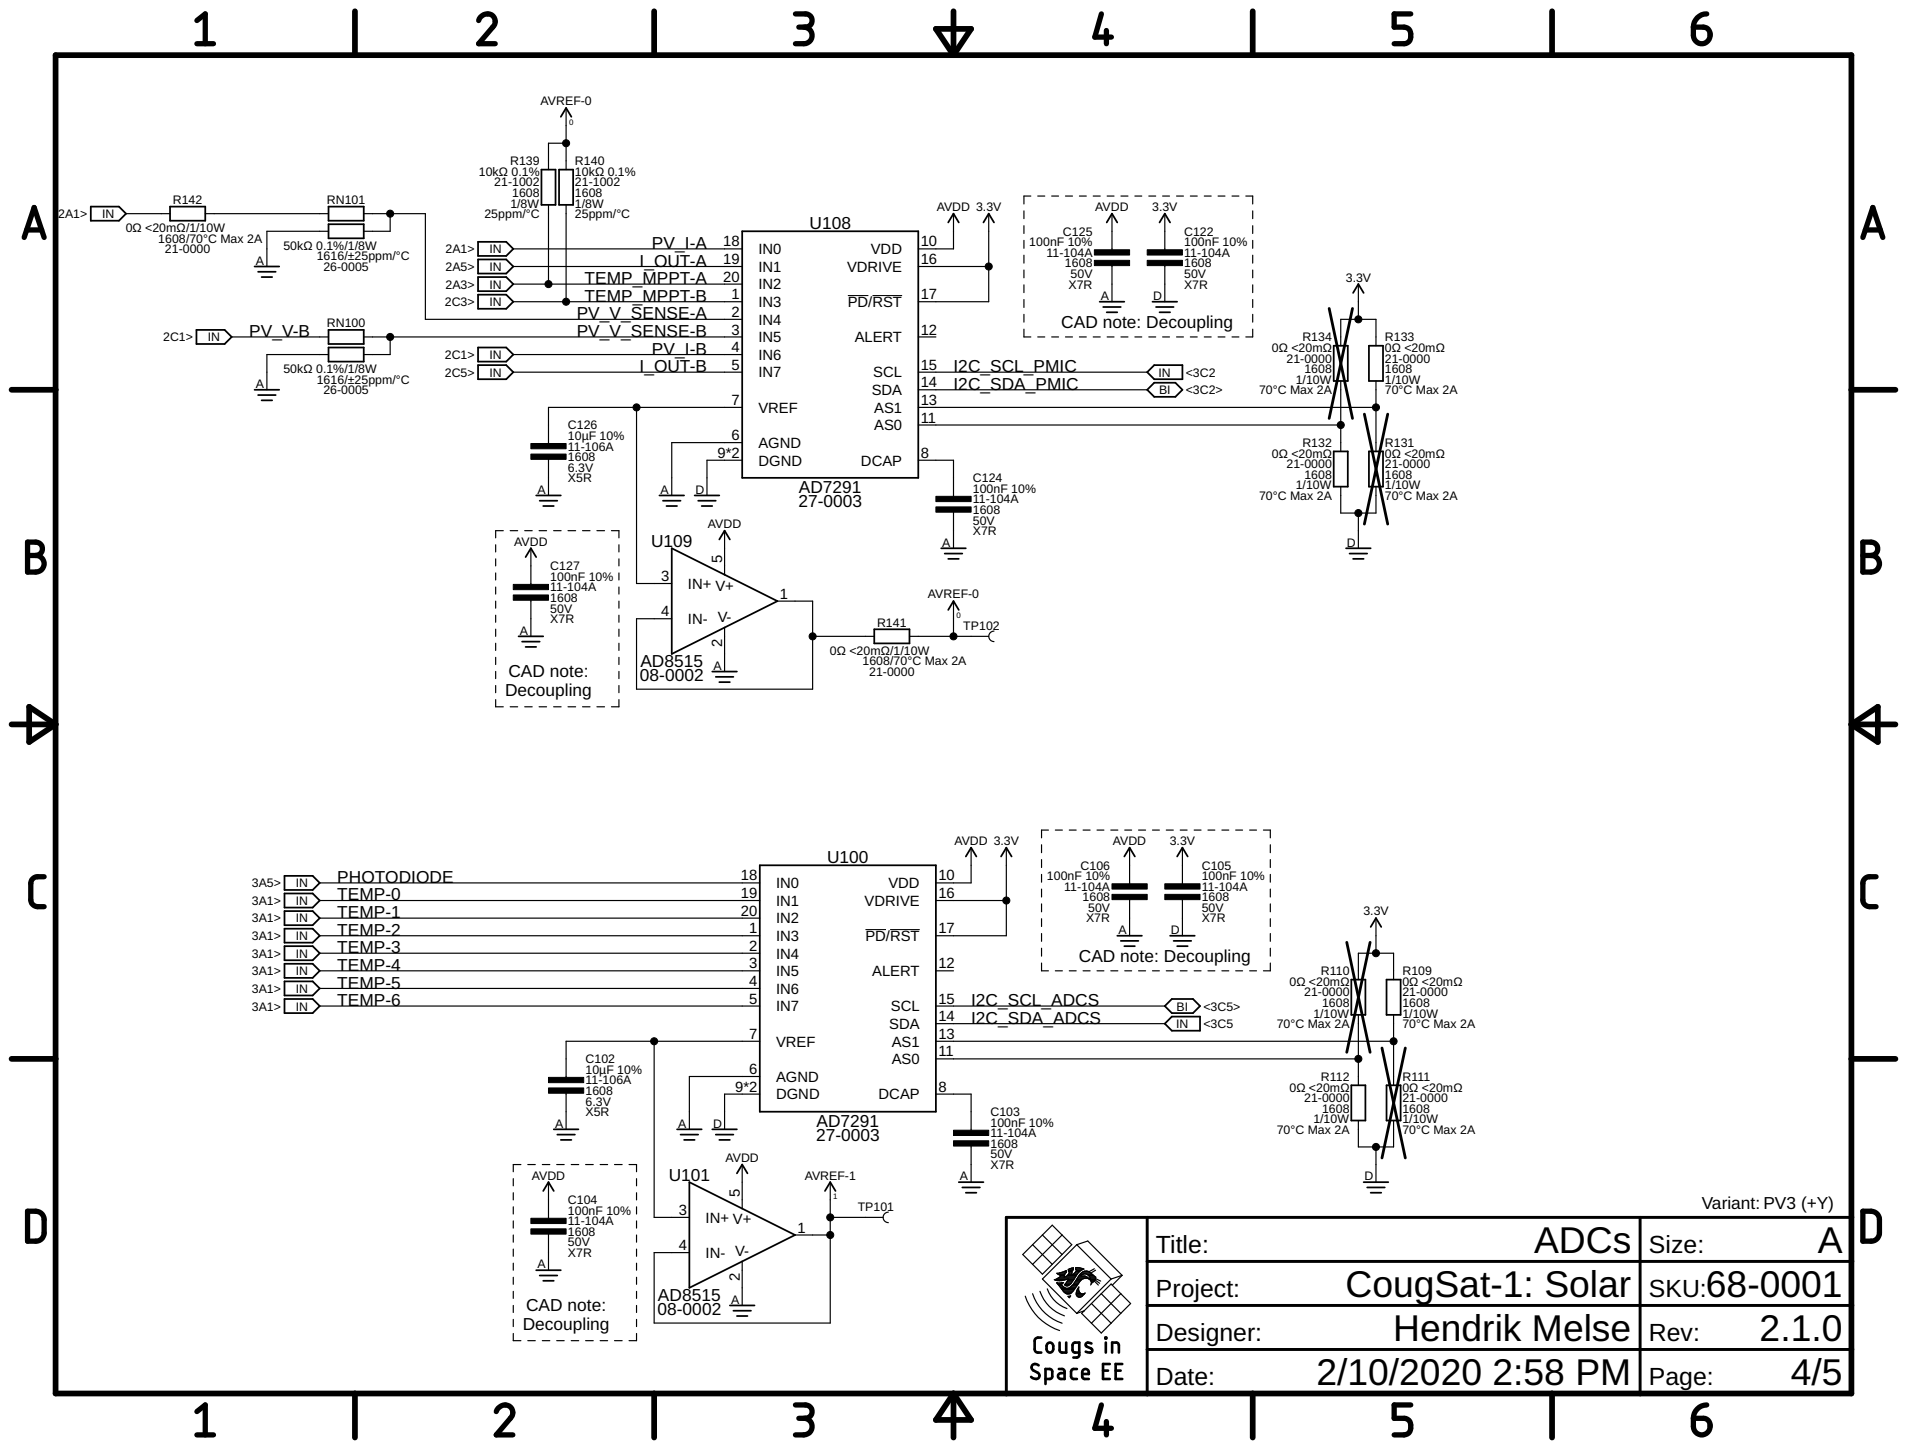
[picture p272: page 4]

ADCs Title: | A Size:

CougSat-1: Solar Project: | 68-0001 SKU:

Hendrik Melse Designer: | 2.1.0 Rev:

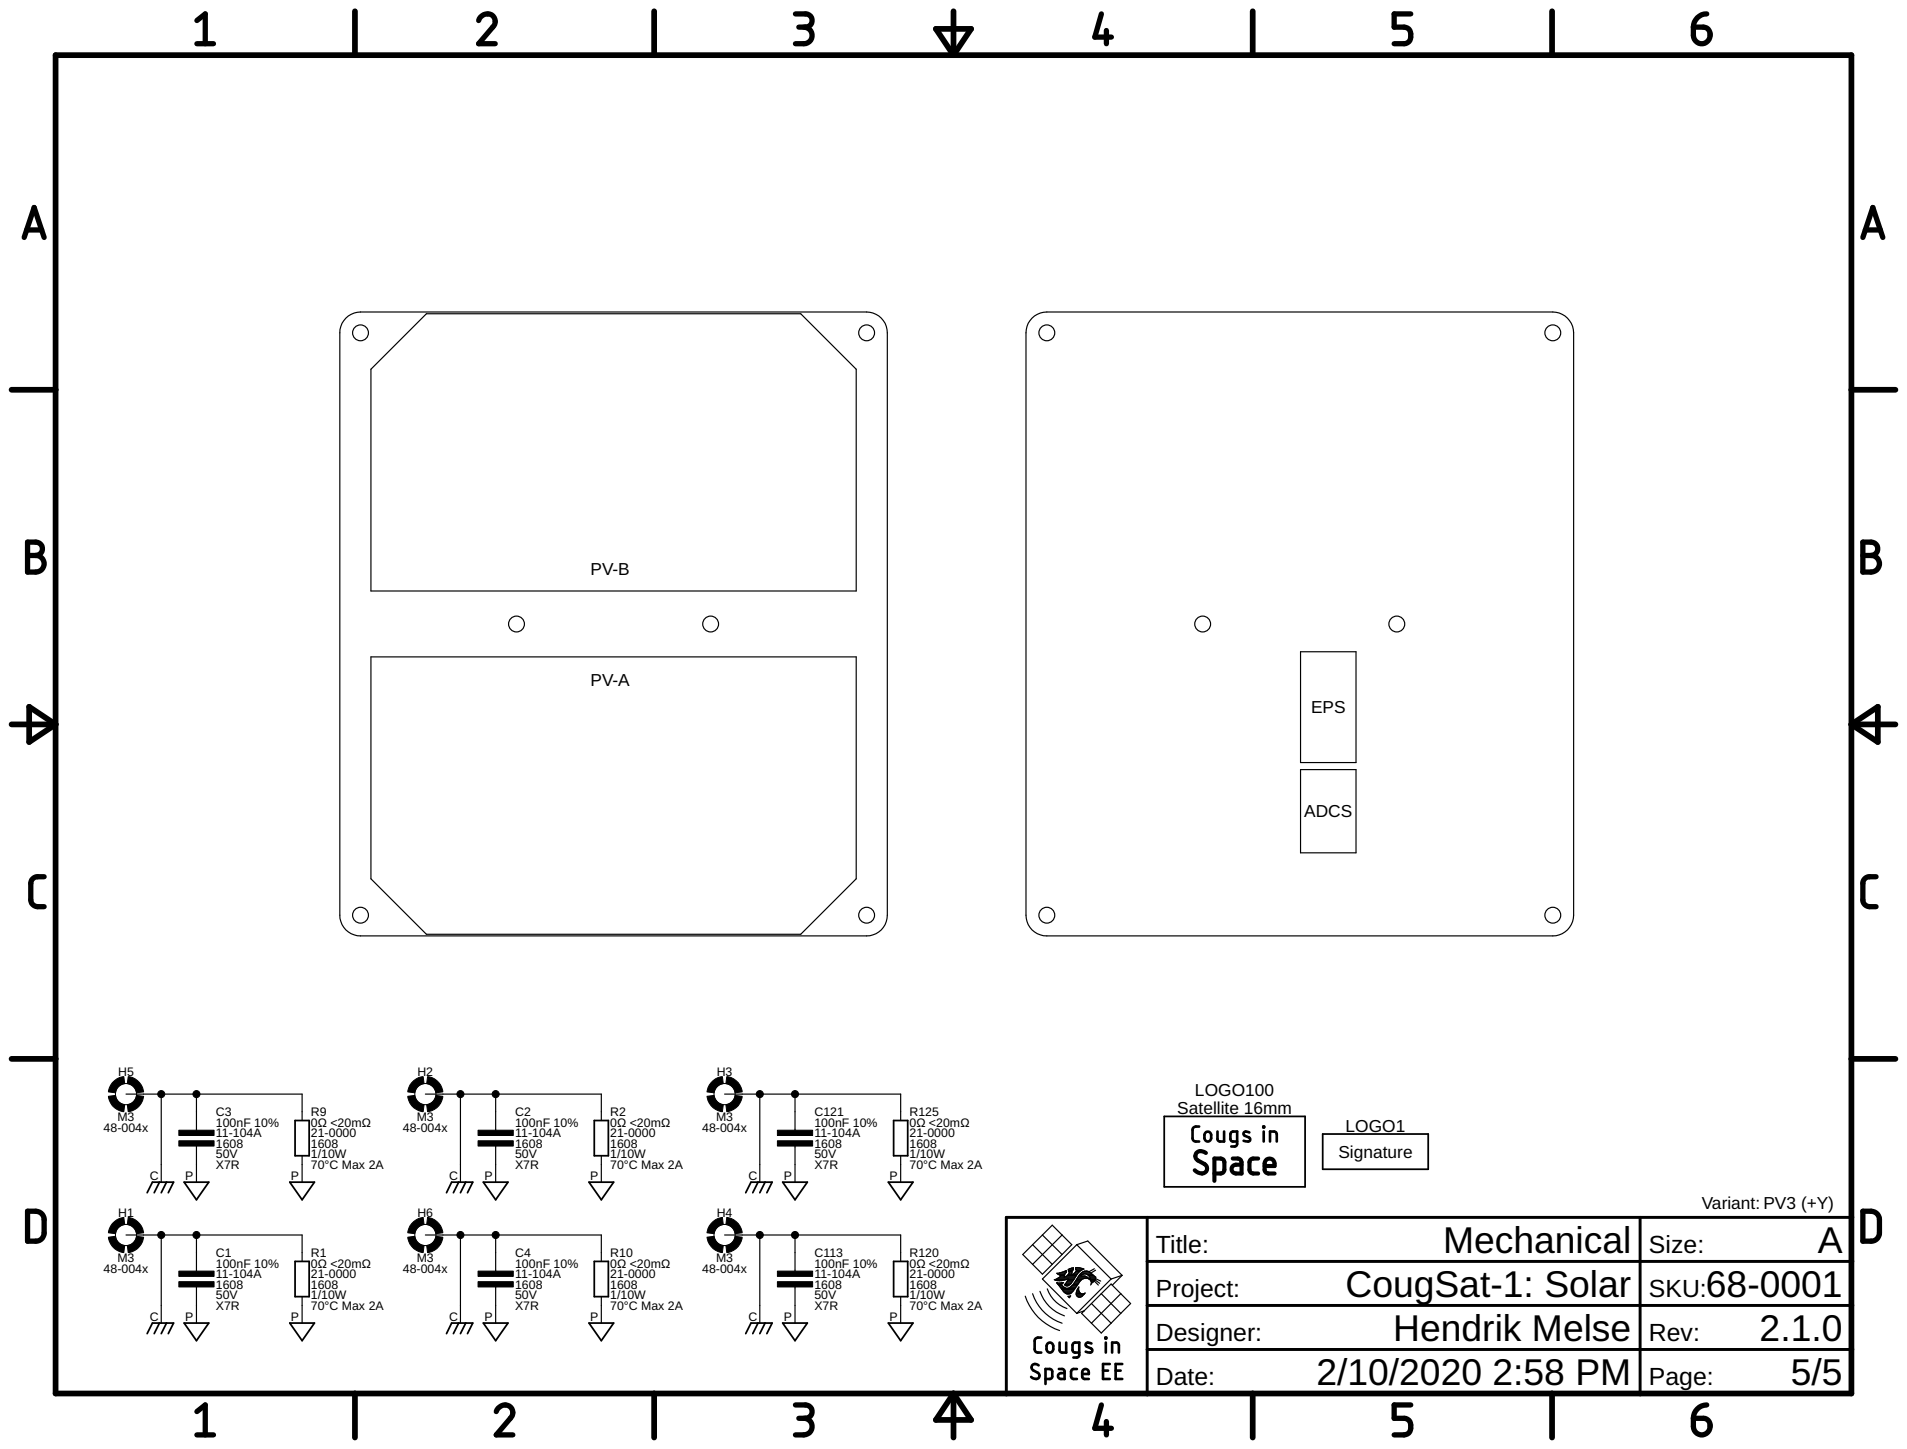
[picture p273: page 5]

Mechanical Title: | A Size:

CougSat-1: Solar Project: | 68-0001 SKU:

Hendrik Melse Designer: | 2.1.0 Rev:
