CougsInSpace/CougSat1-Hardware/CougSat1-PowerBoard/Documentation/SolarPanel.pdf

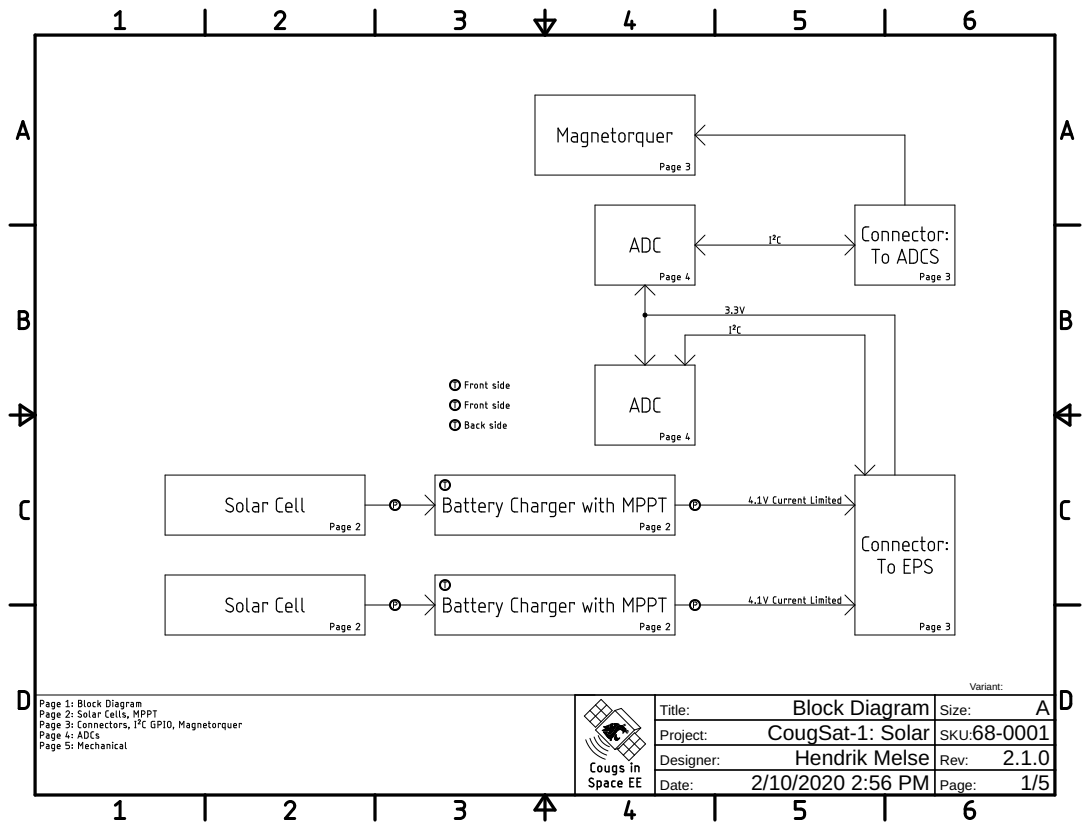
[picture p274: page 1]

Block Diagram Title: | Variant: Date: A Size:

CougSat-1: Solar Project: | 68-0001 SKU:

Hendrik Melse Designer: | 2.1.0 Rev:

2/10/2020 2:56 PM | Page:

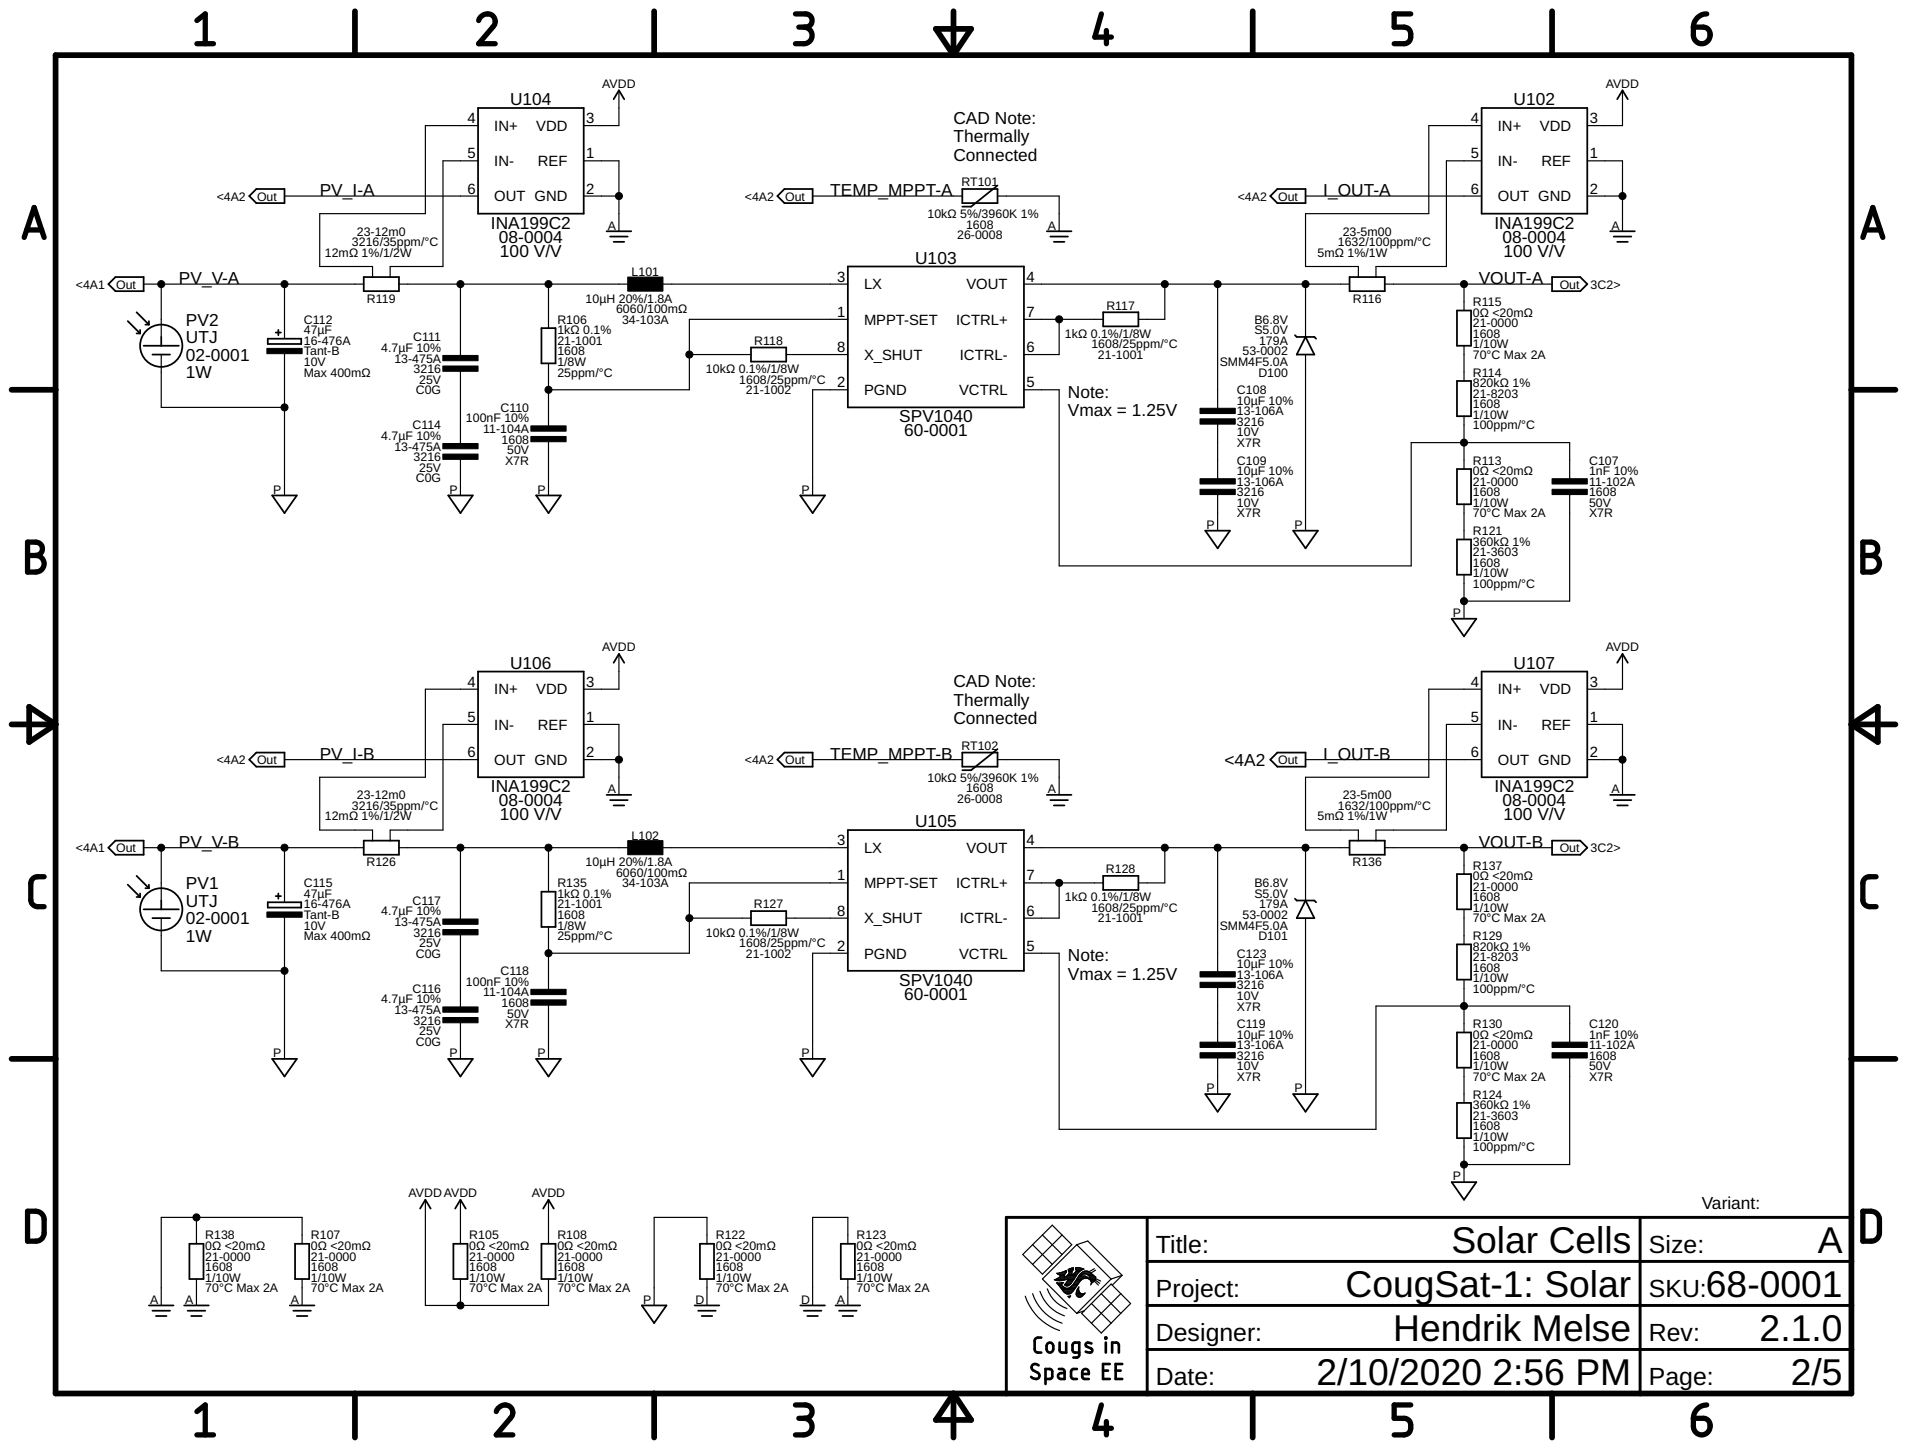
[picture p275: page 2]

Solar Cells Title: | A Size:

CougSat-1: Solar Project: | 68-0001 SKU:

Hendrik Melse Designer: | 2.1.0 Rev:

Date:

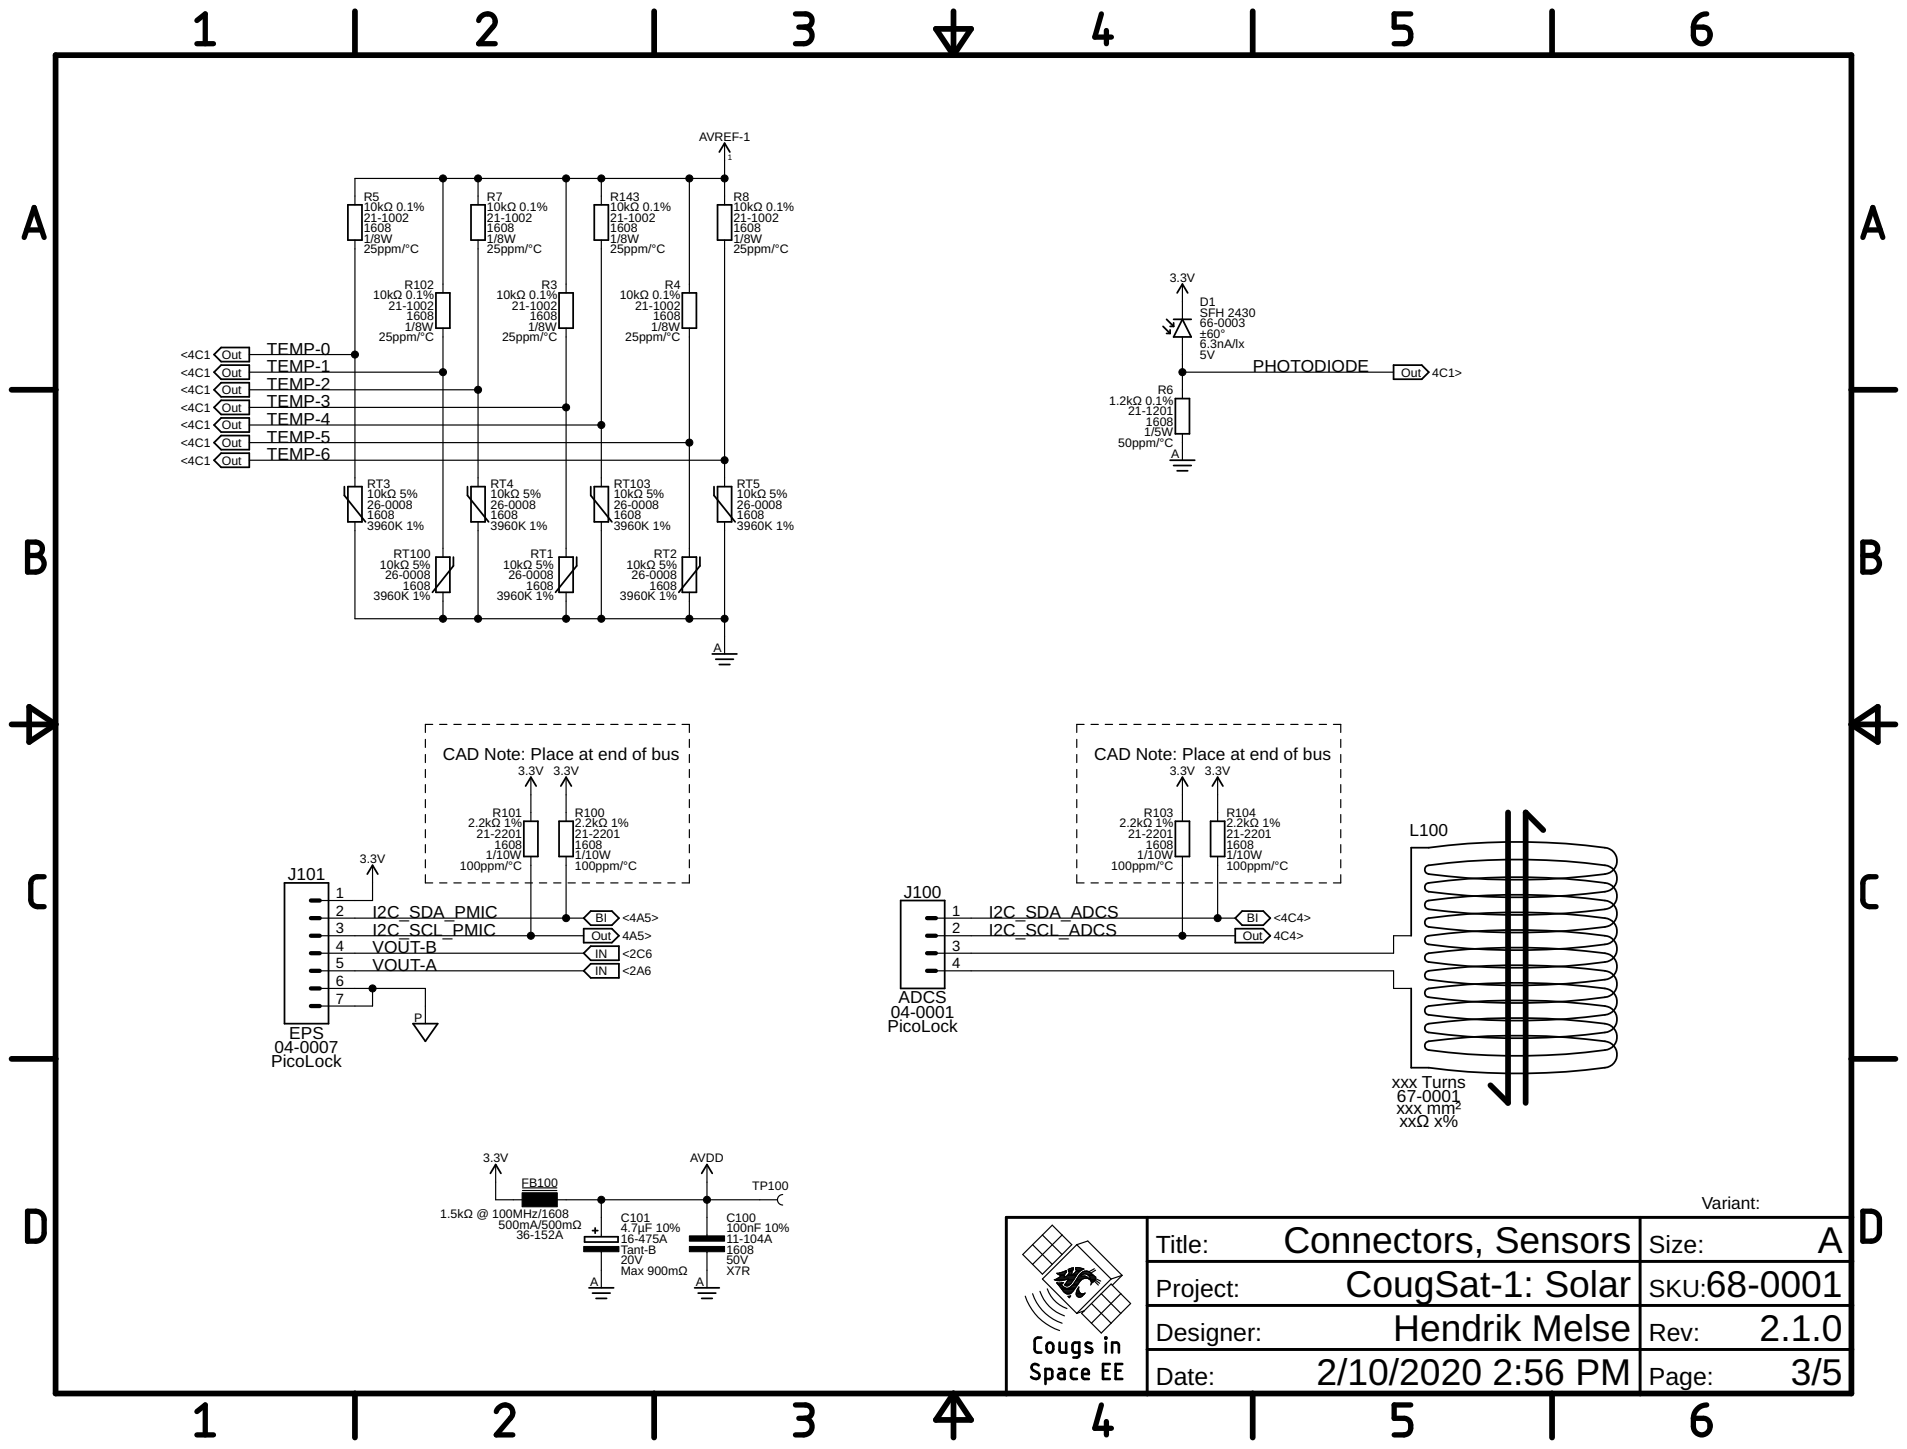
[picture p276: page 3]

TEMP-3
TEMP-4
TEMP-5
TEMP-6

CAD Note: Place at end of bus

Connectors, Sensors Title: | A Size:

CougSat-1: Solar Project: | 68-0001 SKU:

Hendrik Melse Designer: | 2.1.0 Rev:

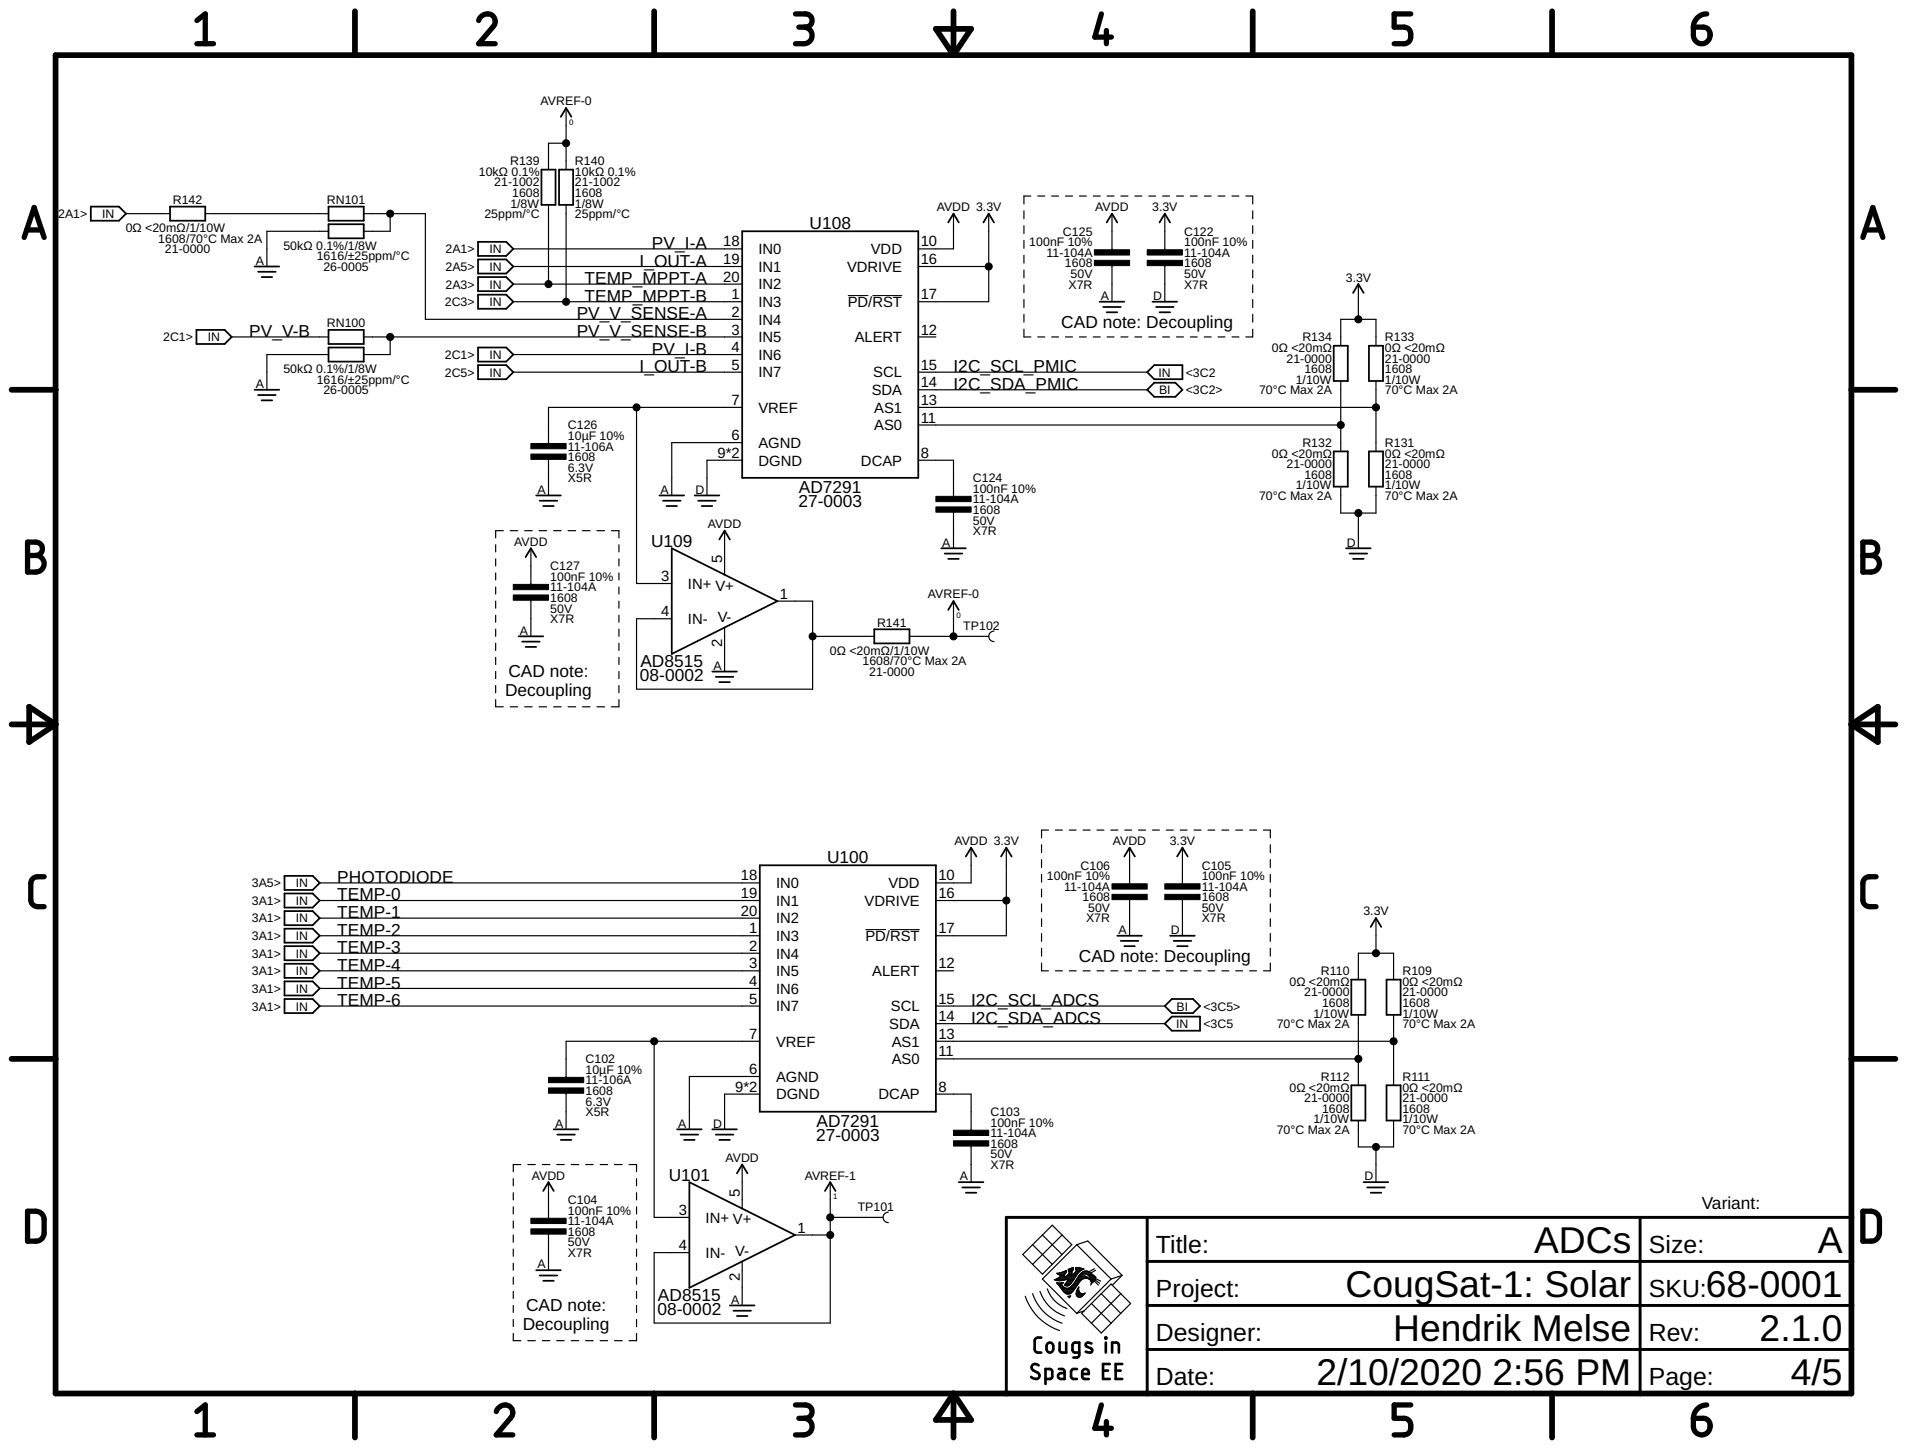
[picture p277: page 4]

ADCs Title: | A Size:

CougSat-1: Solar Project: | 68-0001 SKU:

Hendrik Melse Designer: | 2.1.0 Rev:

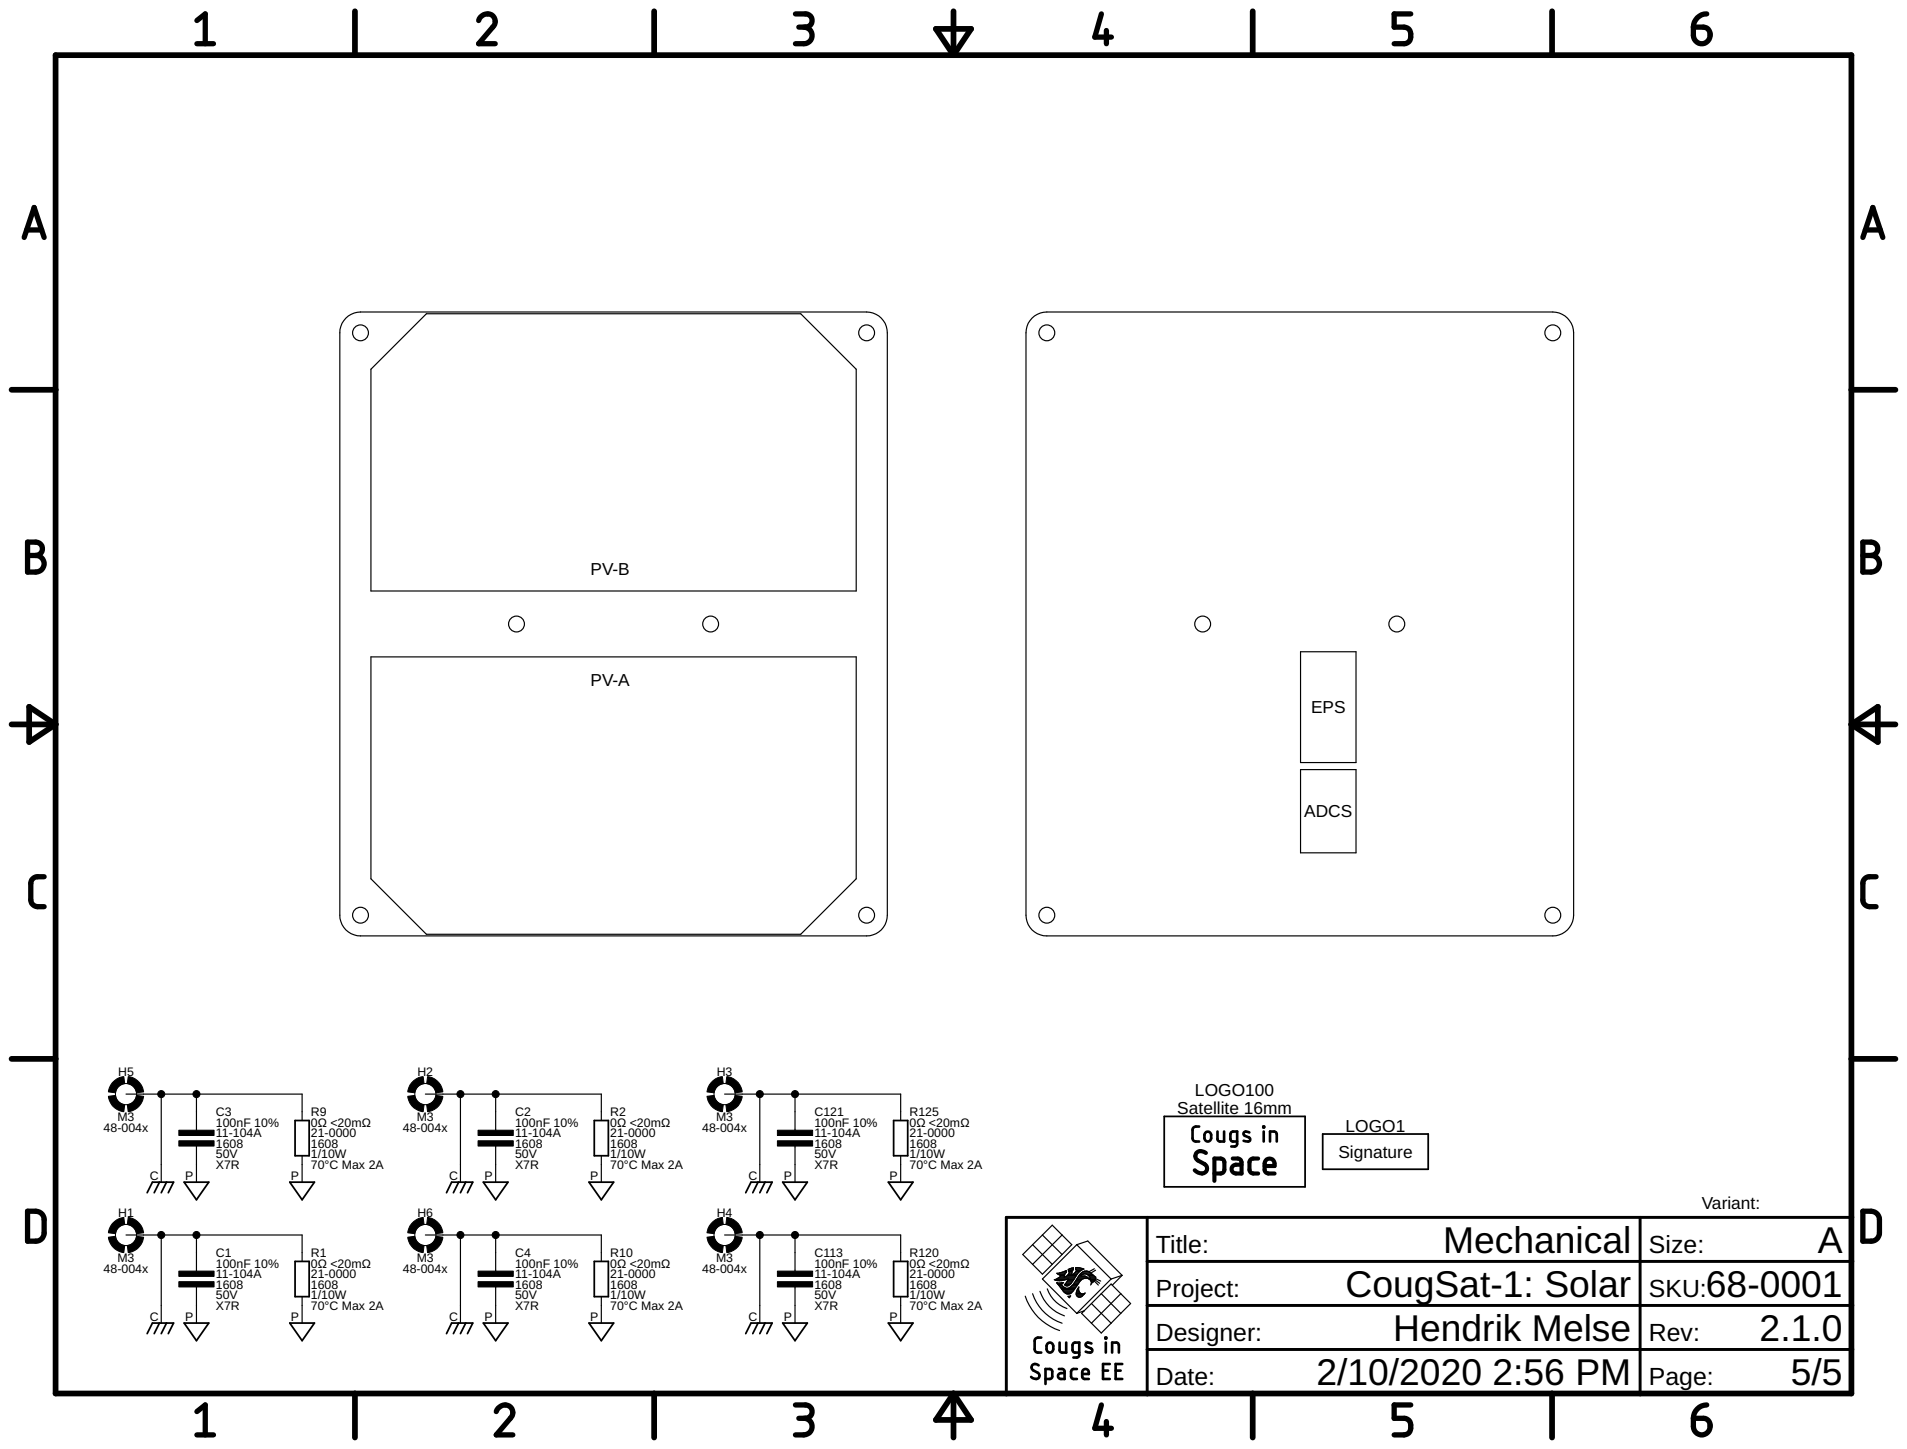
[picture p278: page 5]

Mechanical Title: | A Size:

CougSat-1: Solar Project: | 68-0001 SKU:

Hendrik Melse Designer: | 2.1.0 Rev:
