CougsInSpace/CougSat1-Hardware/CougSat1-RadioBoard/Documentation/Comms-LinkBudget.pdf

System Performance Summary: | CougSat-1 | 2020 January 17

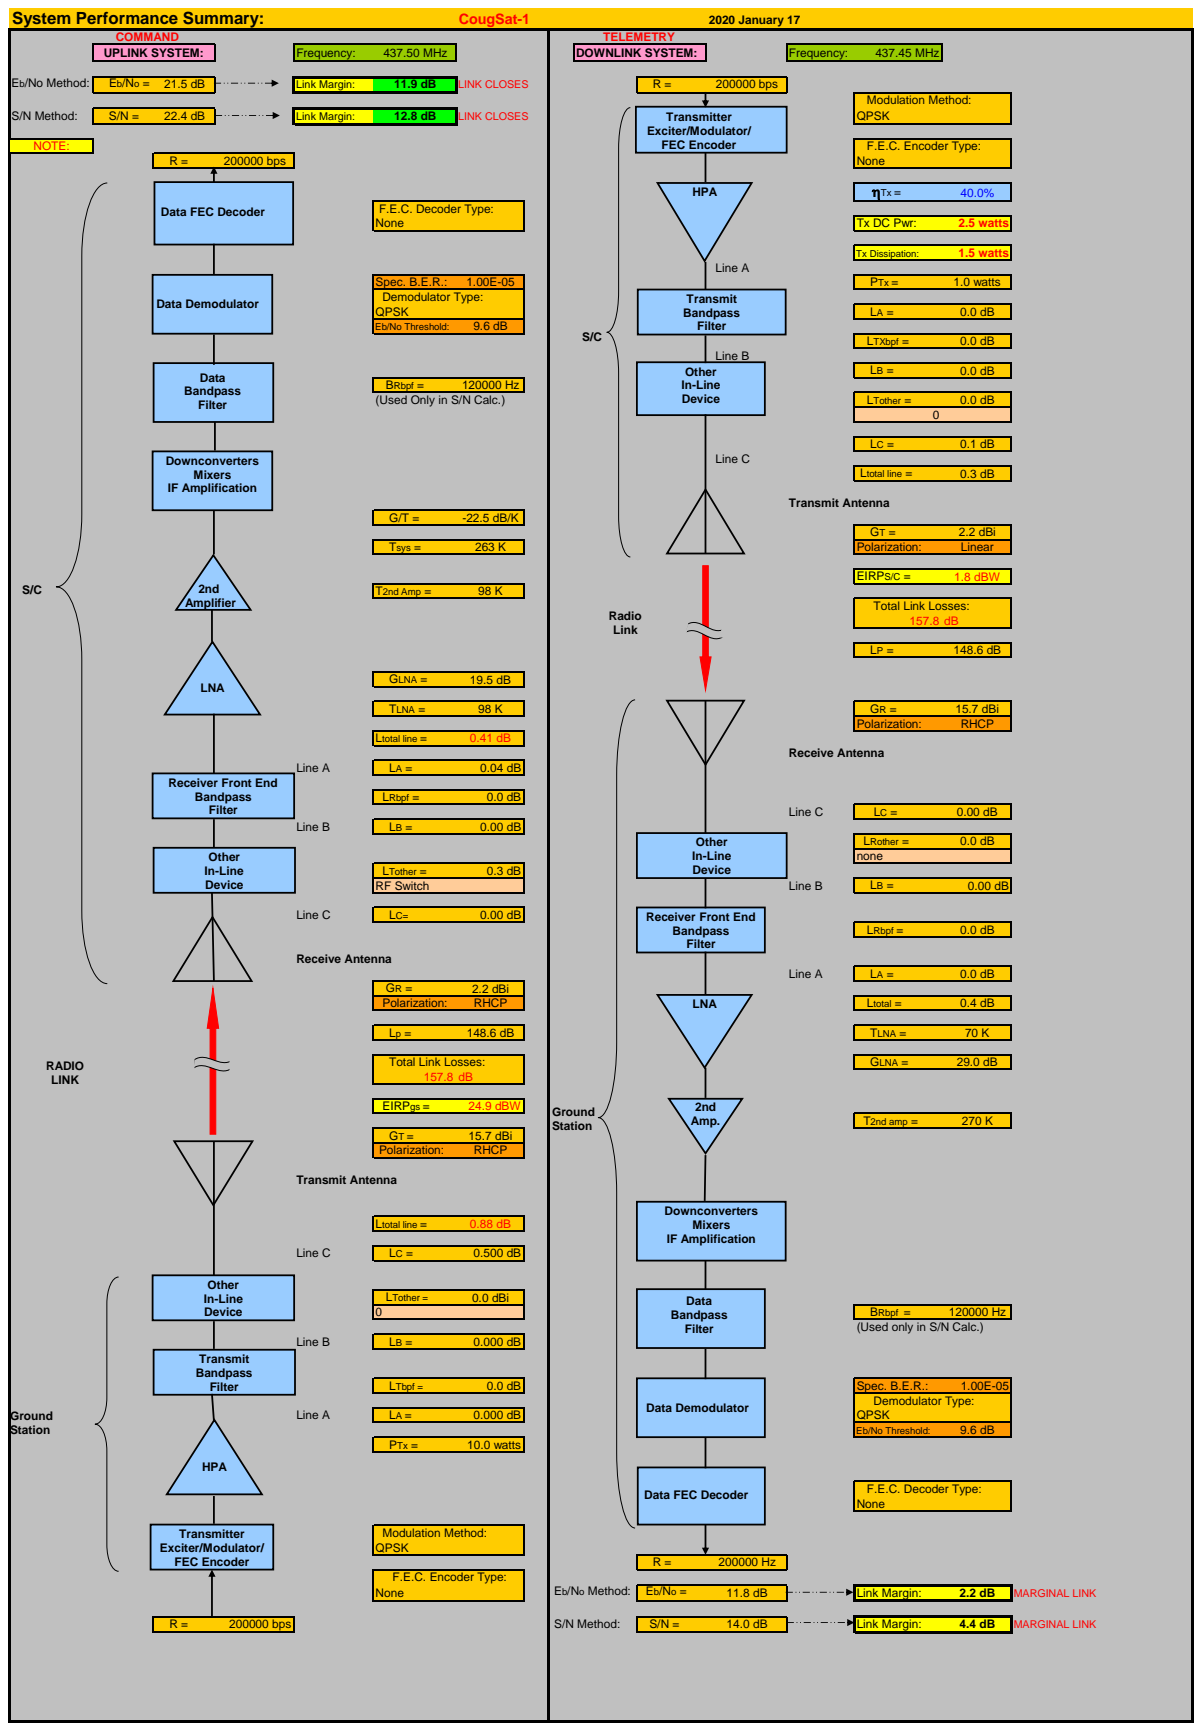
[picture p279: page 1]
COMMAND; TELEMETRY; UPLINK SYSTEM:; Frequency:; 437.50 MHz; DOWNLINK SYSTEM:; 437.45 MHz; Eb/No Method:; Link Margin:; LINK CLOSES; 200000 bps; Modulation Method:; S/N Method:; QPSK; NOTE:; F.E.C. Encoder Type:; None; hTx =; F.E.C. Decoder Type:; Tx DC Pwr:; 2.5 watts; Tx Dissipation:; 1.5 watts; Line A; Spec. B.E.R.:; PTx =; 1.0 watts; Demodulator Type:; Eb/No Threshold:; LTXbpf =; Line B; BRbpf =; (Used Only in S/N Calc.); LTother =; Line C; Ltotal line =; Transmit Antenna; 2.2 dBi; Tsys =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

Data FEC Decoder

Total Link Losses:

Receiver Front End
Bandpass
Filter

(Used only in S/N Calc.)
