CougsInSpace/CougSat1-Hardware/CougSat1-RadioBoard/Documentation/Comms.pdf

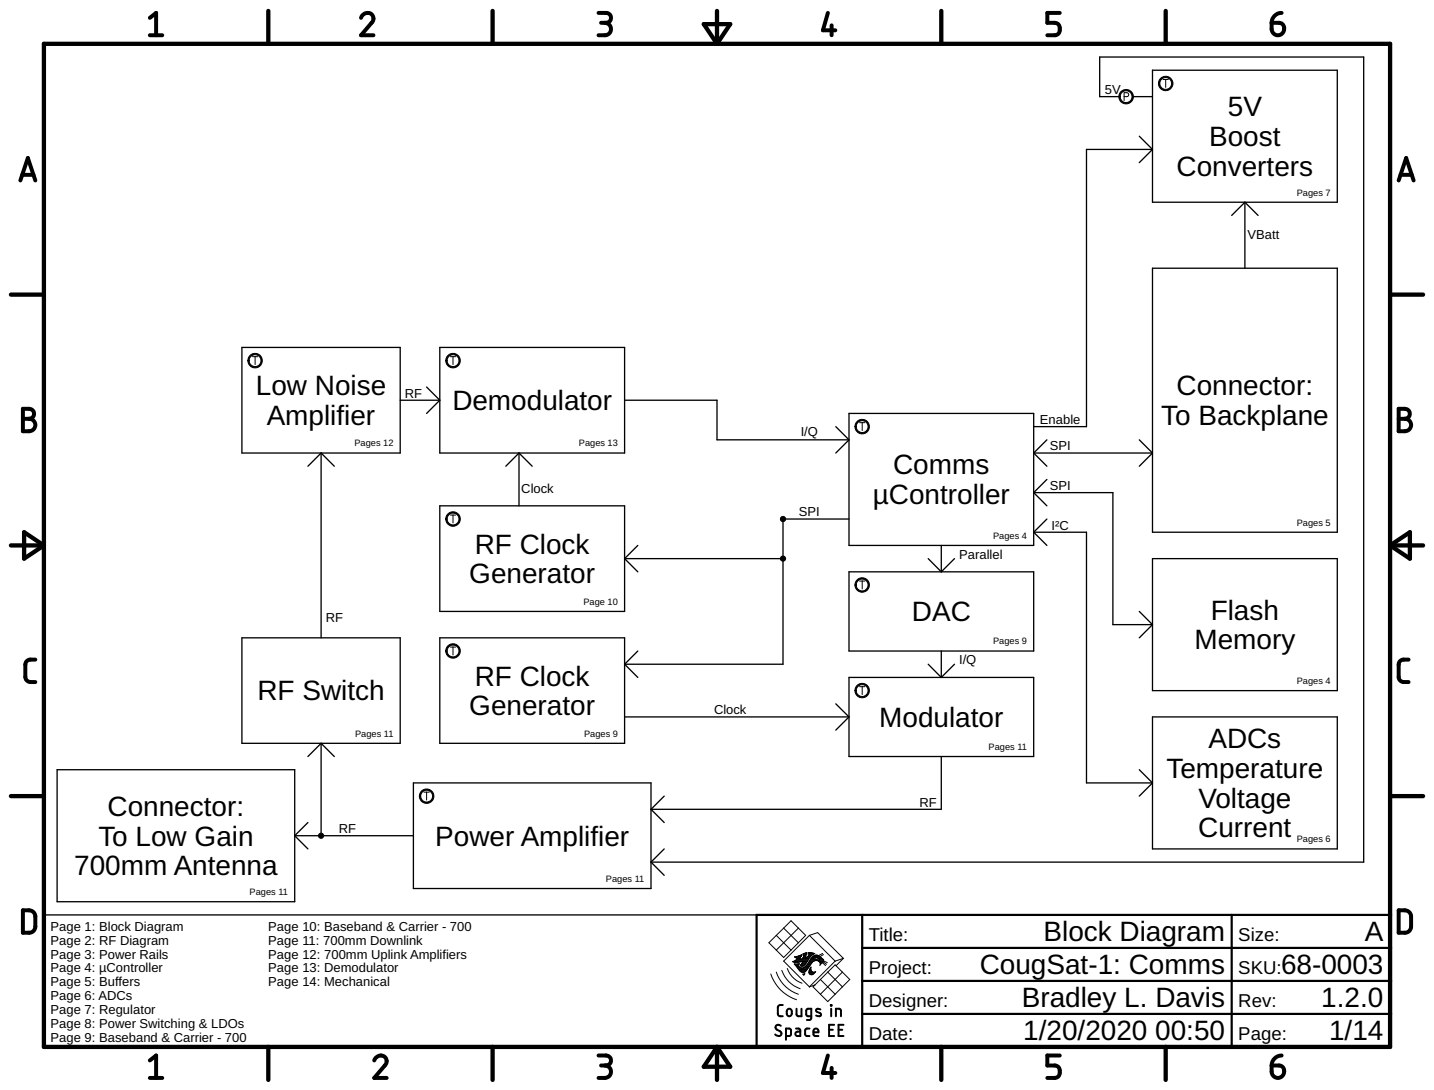
[picture p280: page 1]

Page 1: Block Diagram Page 10: Baseband & Carrier - 700 Page 2: RF Diagram Page 11: 700mm Downlink Page 3: Power Rails Page 4: µController Page 5: Buffers Page 6: ADCs Page 7: Regulator Page 8: Power Switching & LDOs Page 9: Baseband & Carrier - 700 Page 12: 700mm Uplink Amplifiers Page 13: Demodulator Page 14: Mechanical | Block Diagram Title: | A Size:

CougSat-1: Comms Project: | 68-0003 SKU:

Bradley L. Davis Designer: | 1.2.0 Rev:

1/20/2020 00:50 Date: | Page:

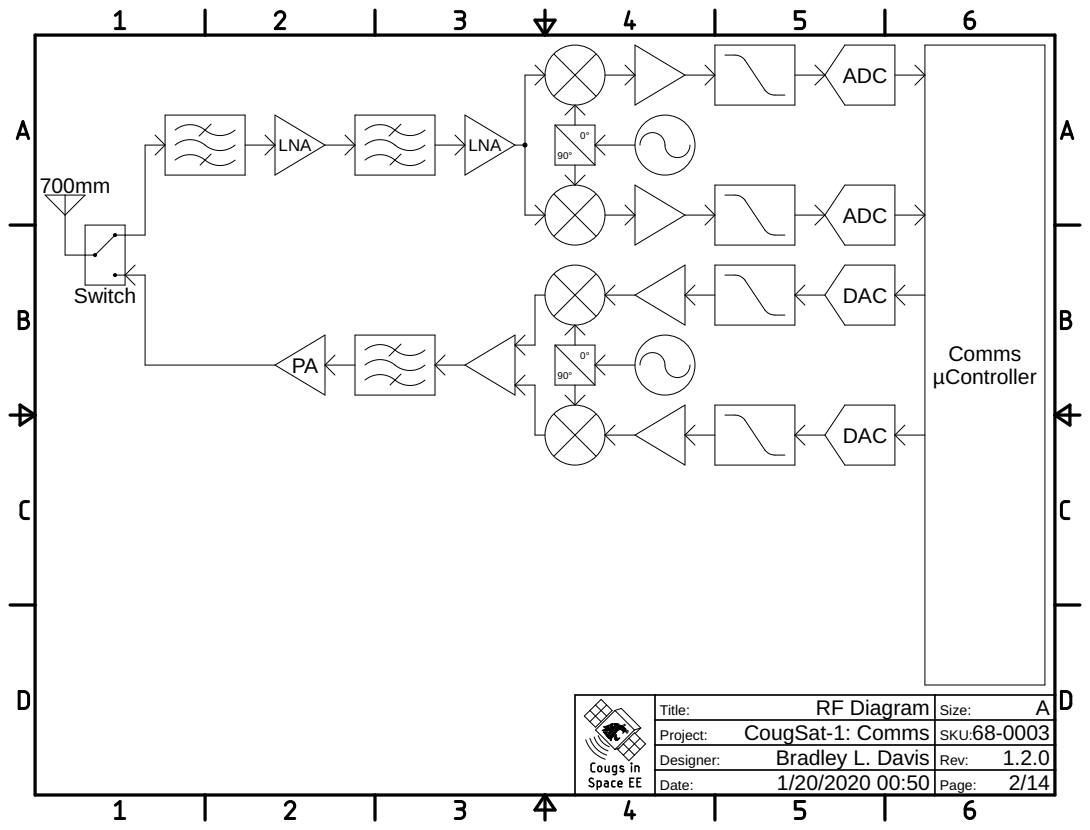
[picture p281: page 2]

RF Diagram Title: | A Size:

CougSat-1: Comms Project: | 68-0003 SKU:

Bradley L. Davis Designer: | 1.2.0 Rev:

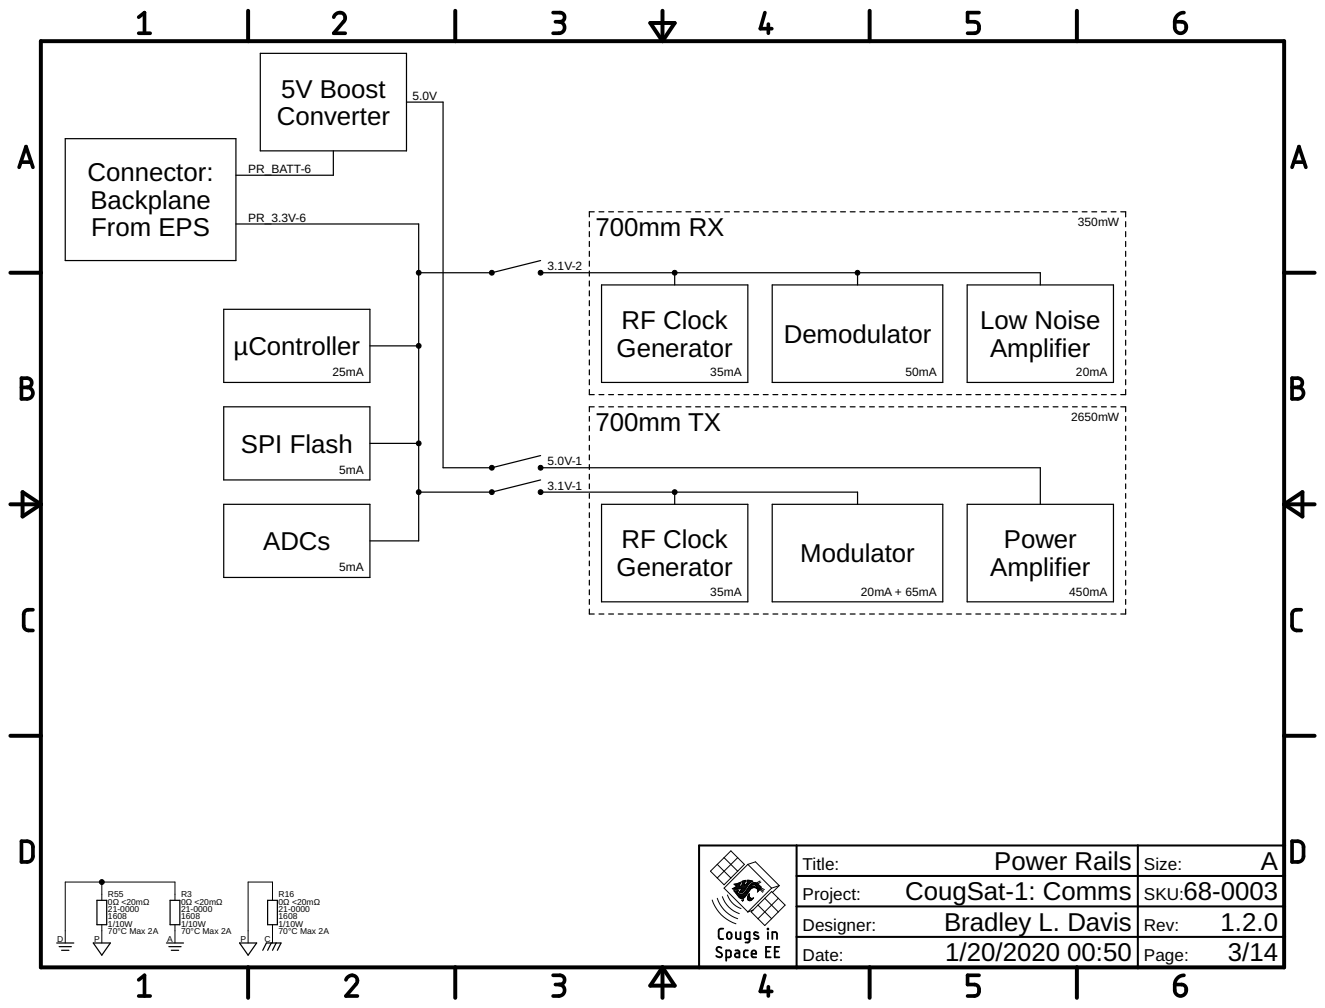
[picture p282: page 3]

Power Rails Title: | A Size:

CougSat-1: Comms Project: | 68-0003 SKU:

Bradley L. Davis Designer: | 1.2.0 Rev:

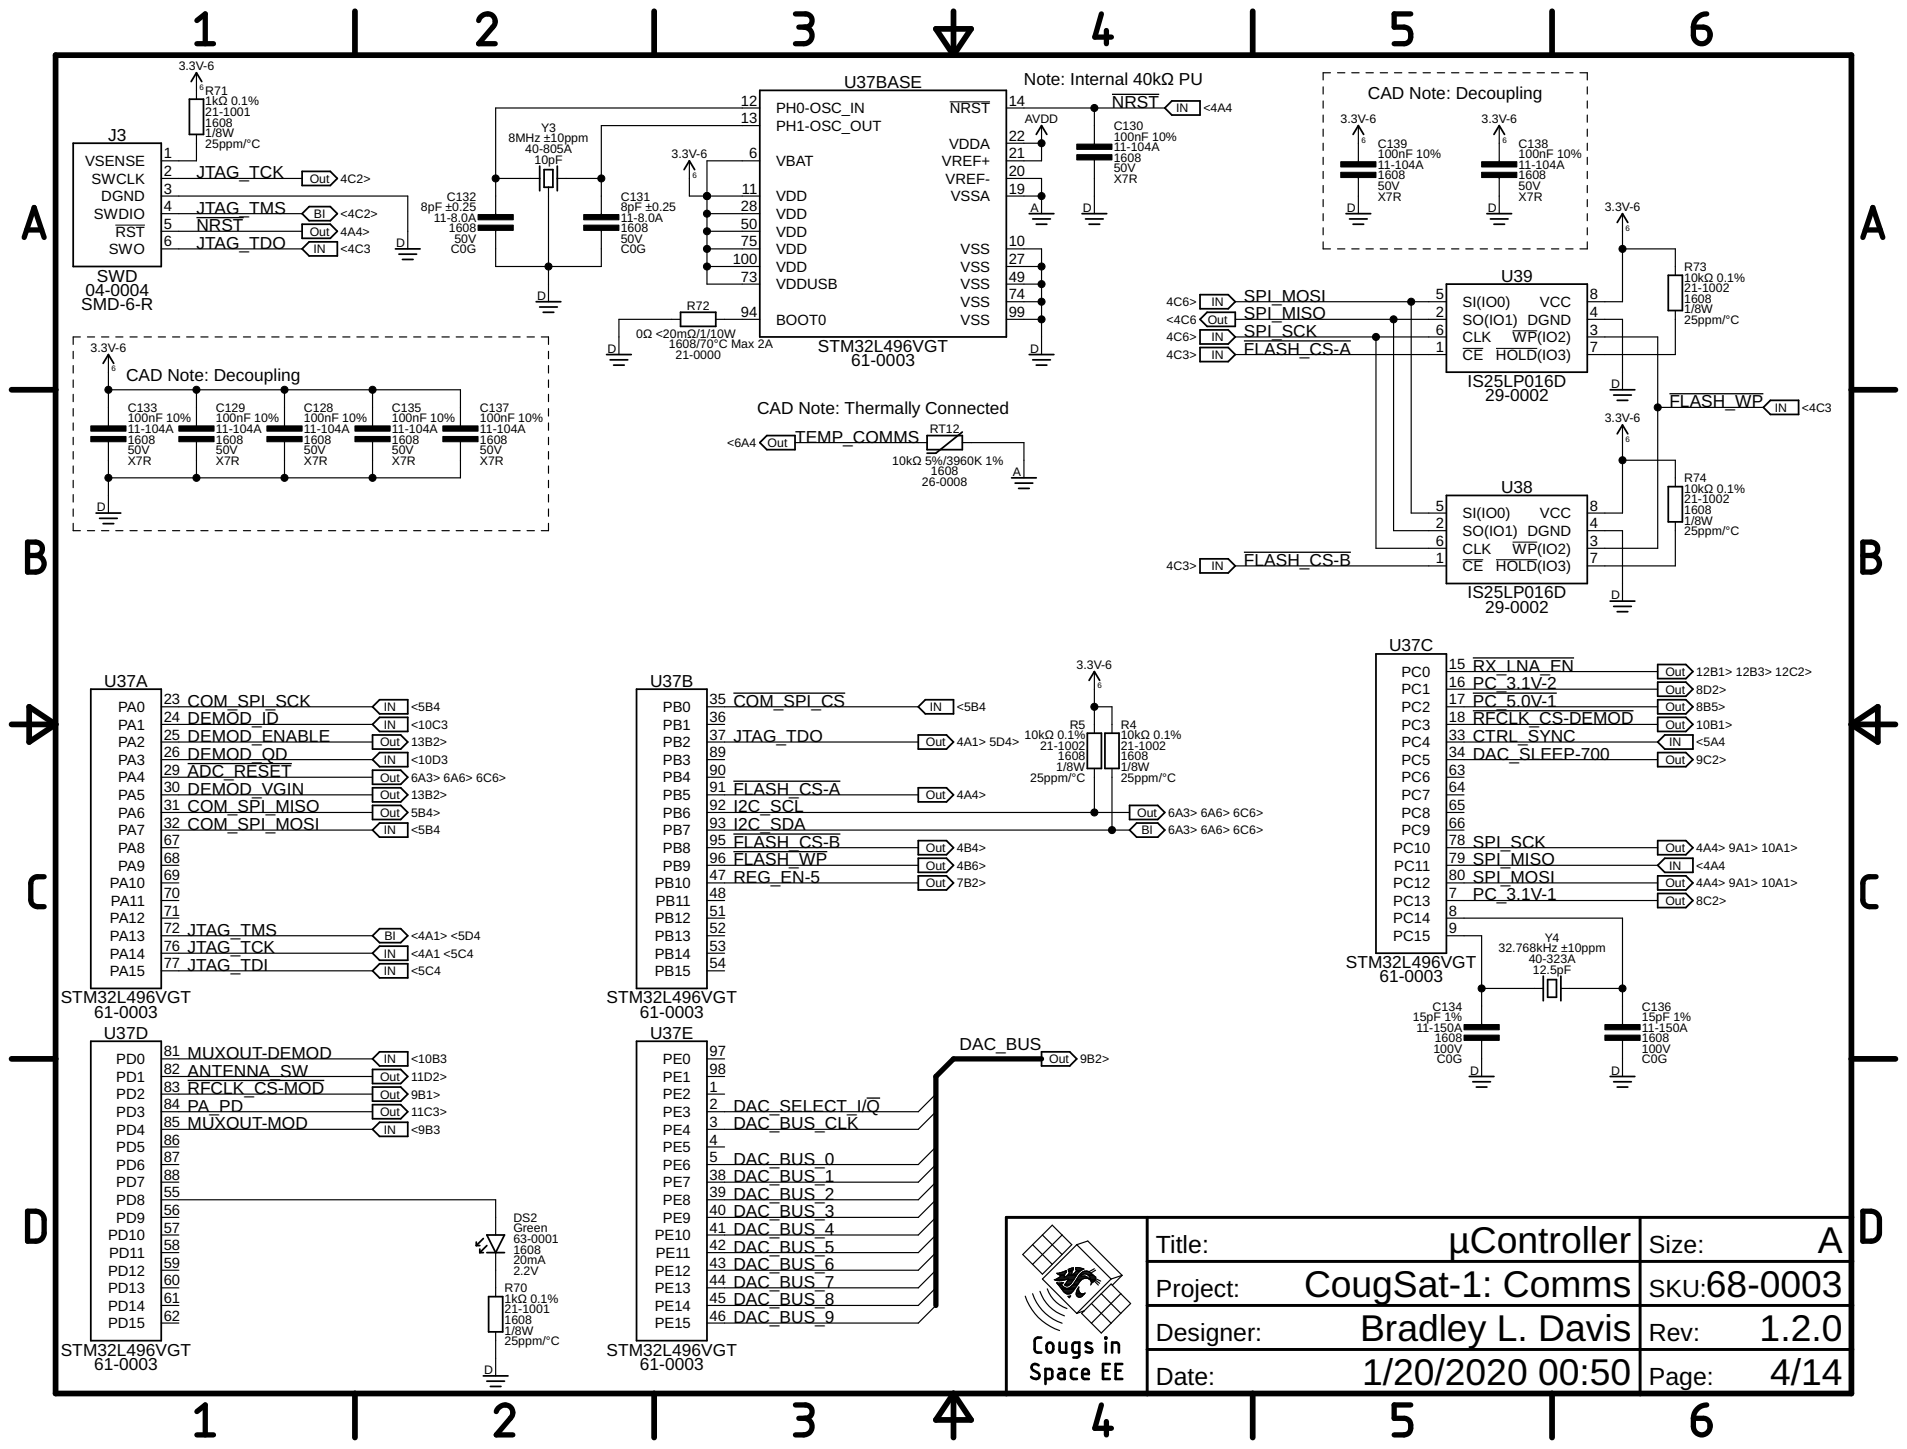
[picture p283: page 4]

CAD Note: Thermally Connected

Out Out

CougSat-1: Comms Project: | 68-0003 SKU:

46 DAC_BUS_9 | | Bradley L. Davis Designer: | 1.2.0 Rev:

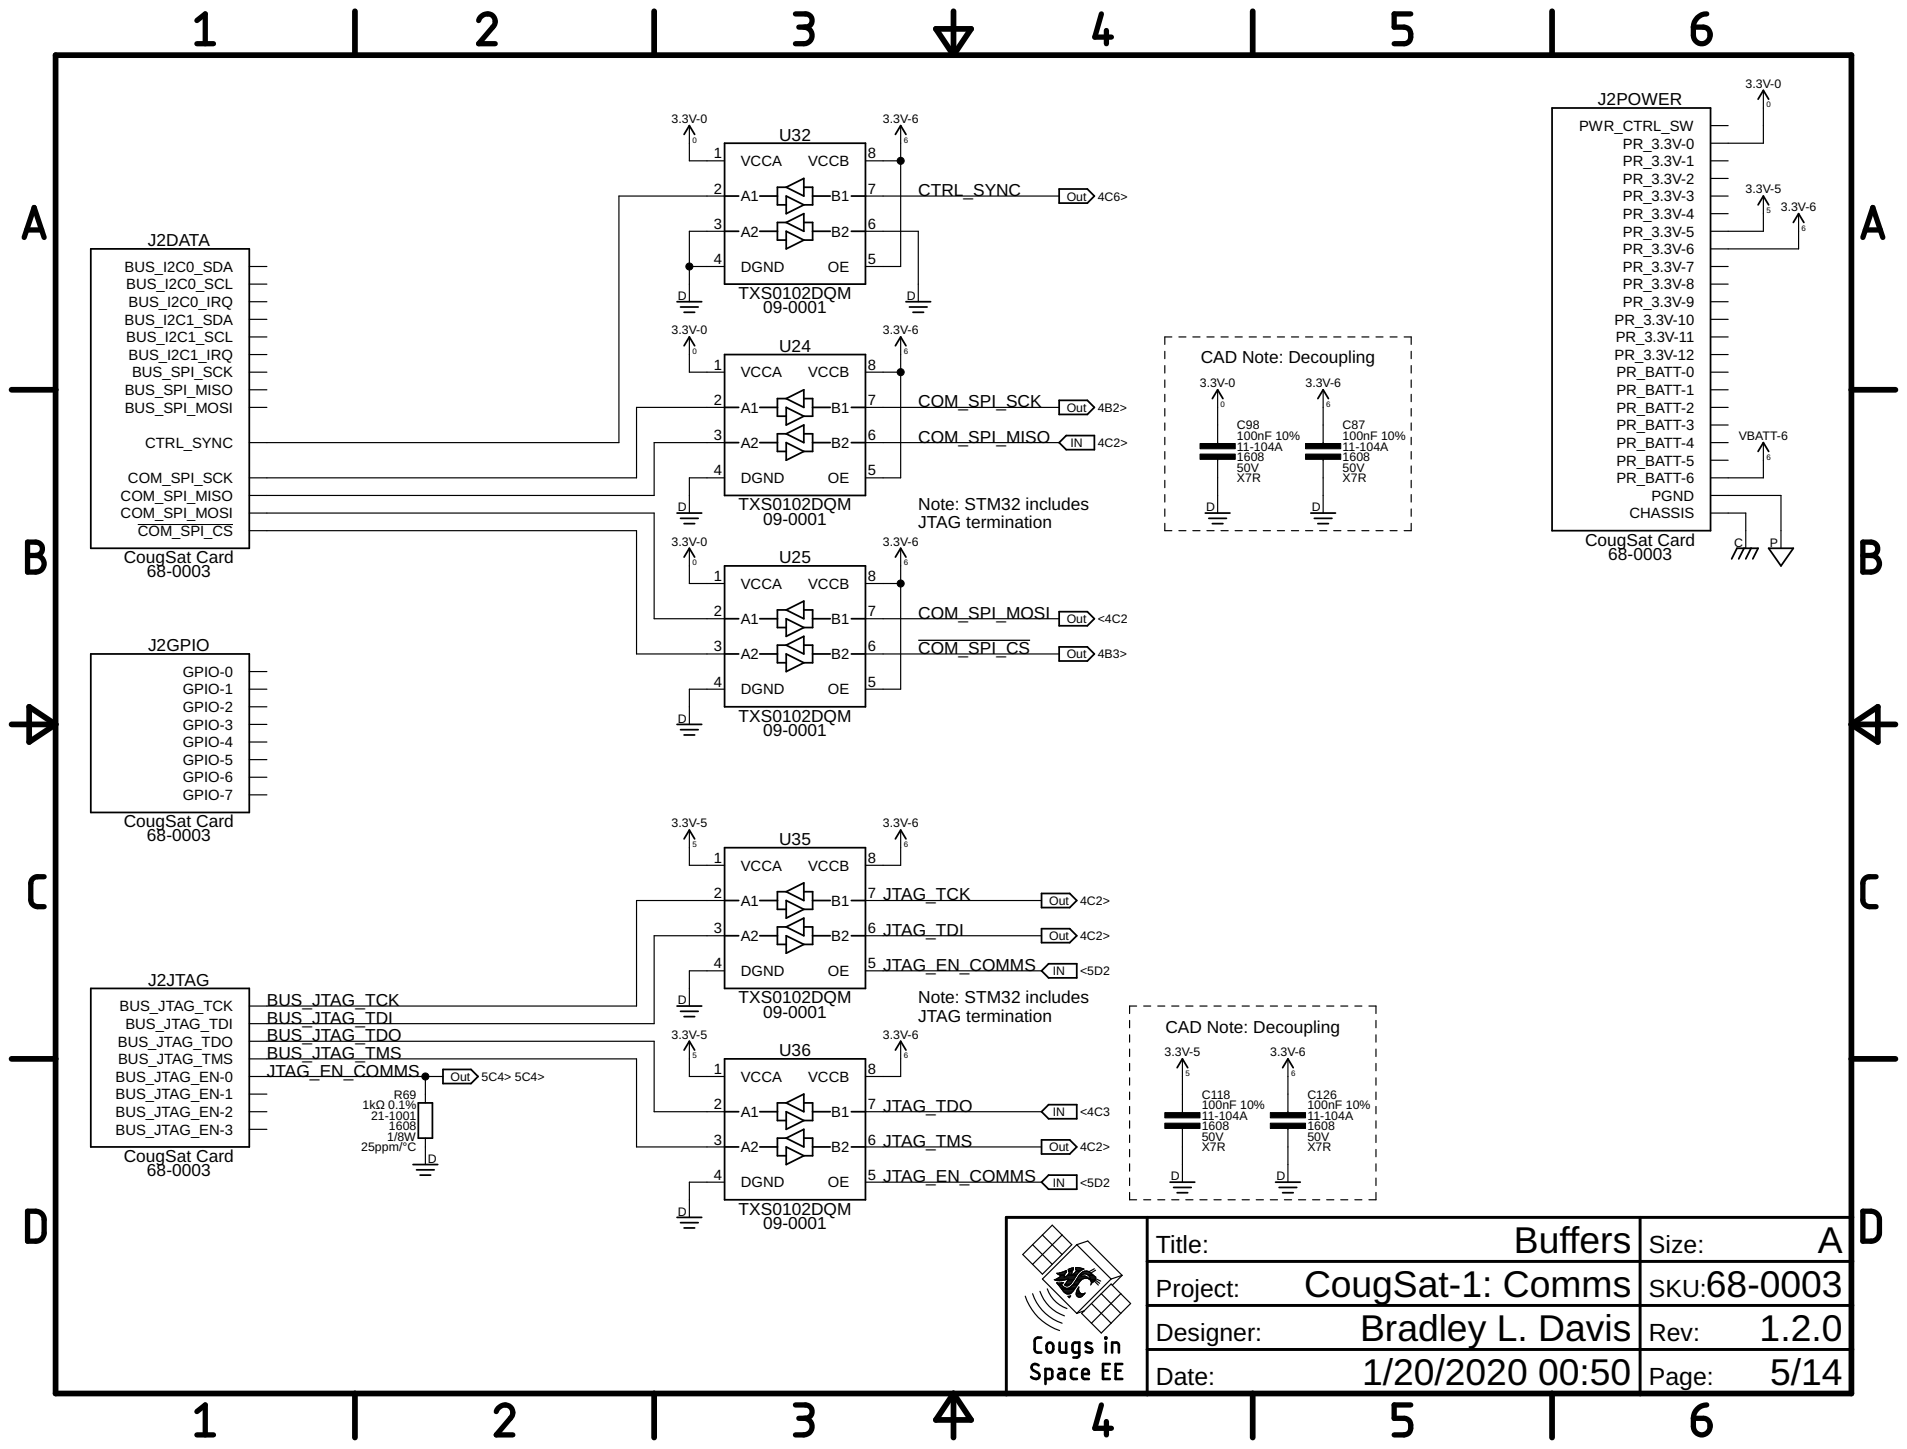
[picture p284: page 5]

J2GPIO
GPIO-0 GPIO-1 GPIO-2 GPIO-3 GPIO-4 GPIO-5 GPIO-6 GPIO-7

Buffers Title: | A Size:

CougSat-1: Comms Project: | 68-0003 SKU:

Bradley L. Davis Designer: | 1.2.0 Rev:

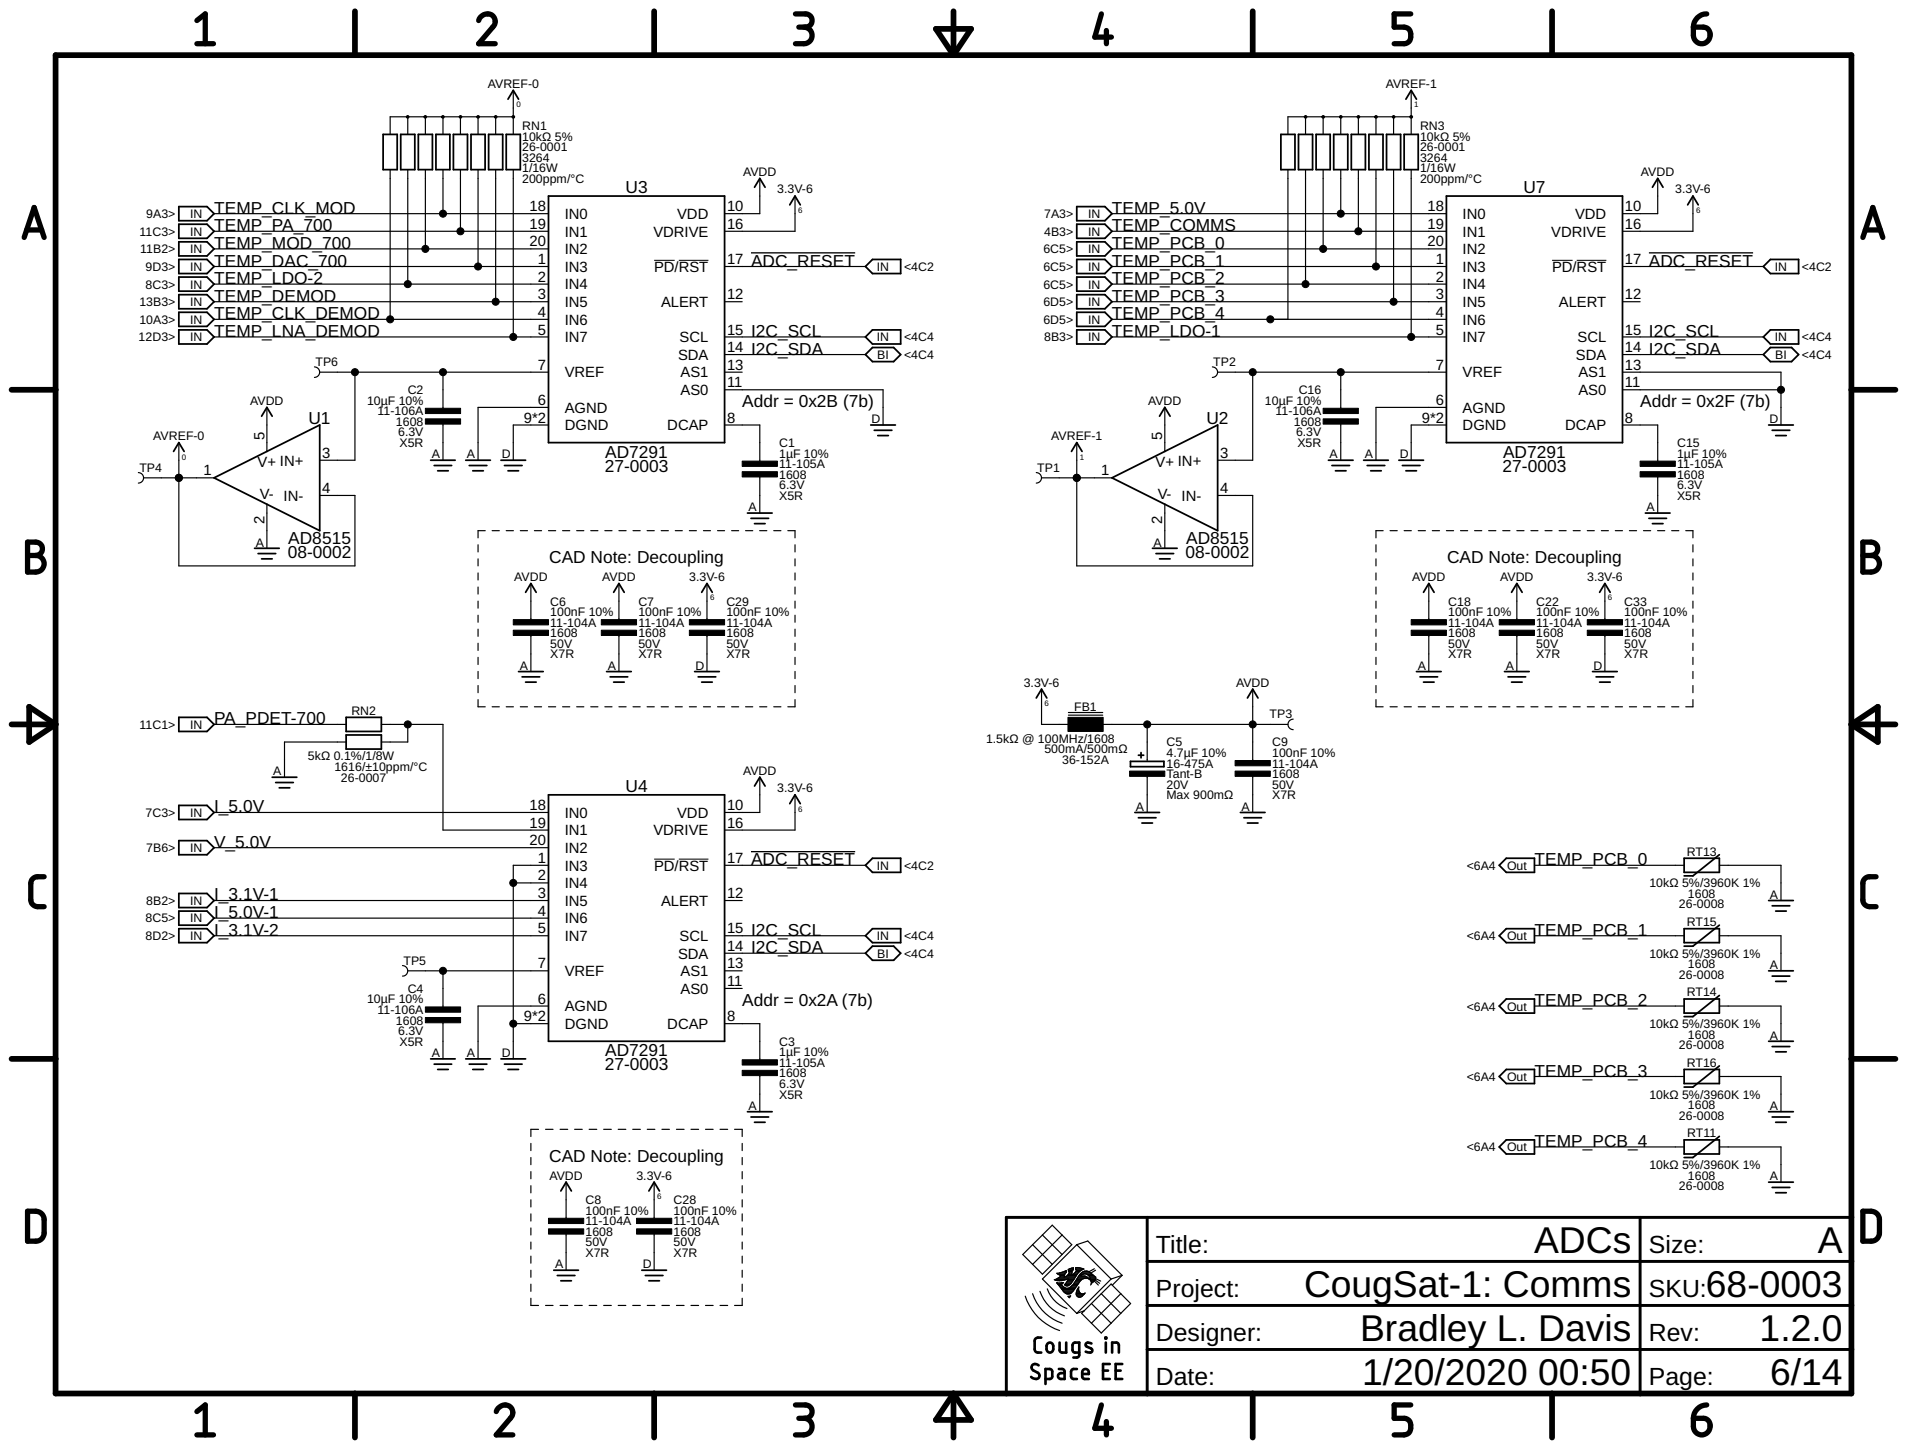
[picture p285: page 6]

ADCs Title: | A Size:

CougSat-1: Comms Project: | 68-0003 SKU:

Bradley L. Davis Designer: | 1.2.0 Rev:

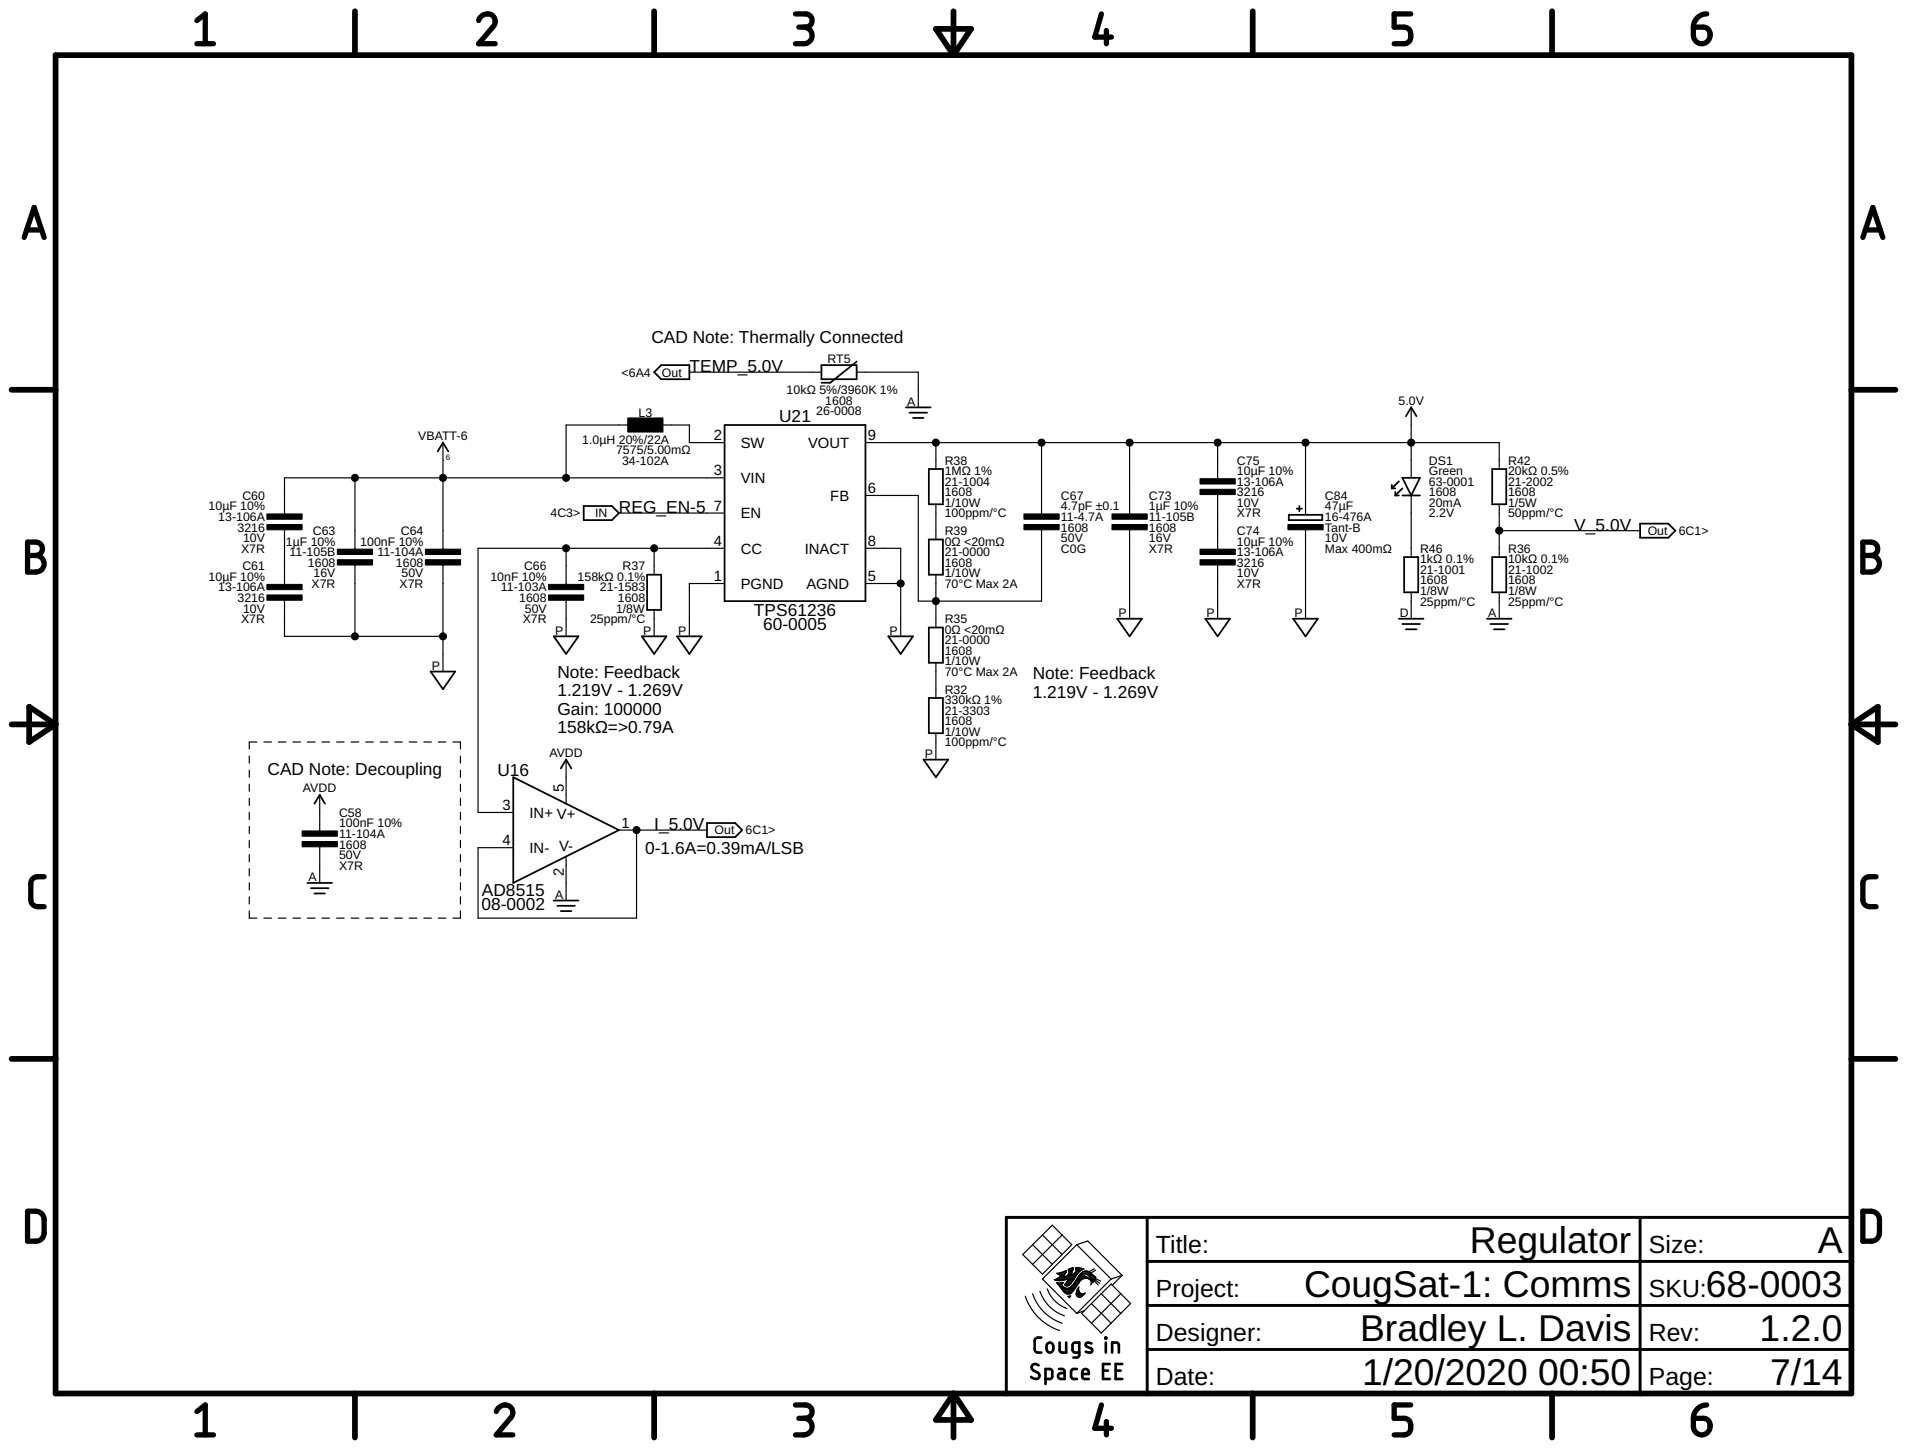
[picture p286: page 7]

CAD Note: Thermally Connected
TEMP_5.0V

Regulator Title: | A Size:

CougSat-1: Comms Project: | 68-0003 SKU:

Bradley L. Davis Designer: | 1.2.0 Rev:

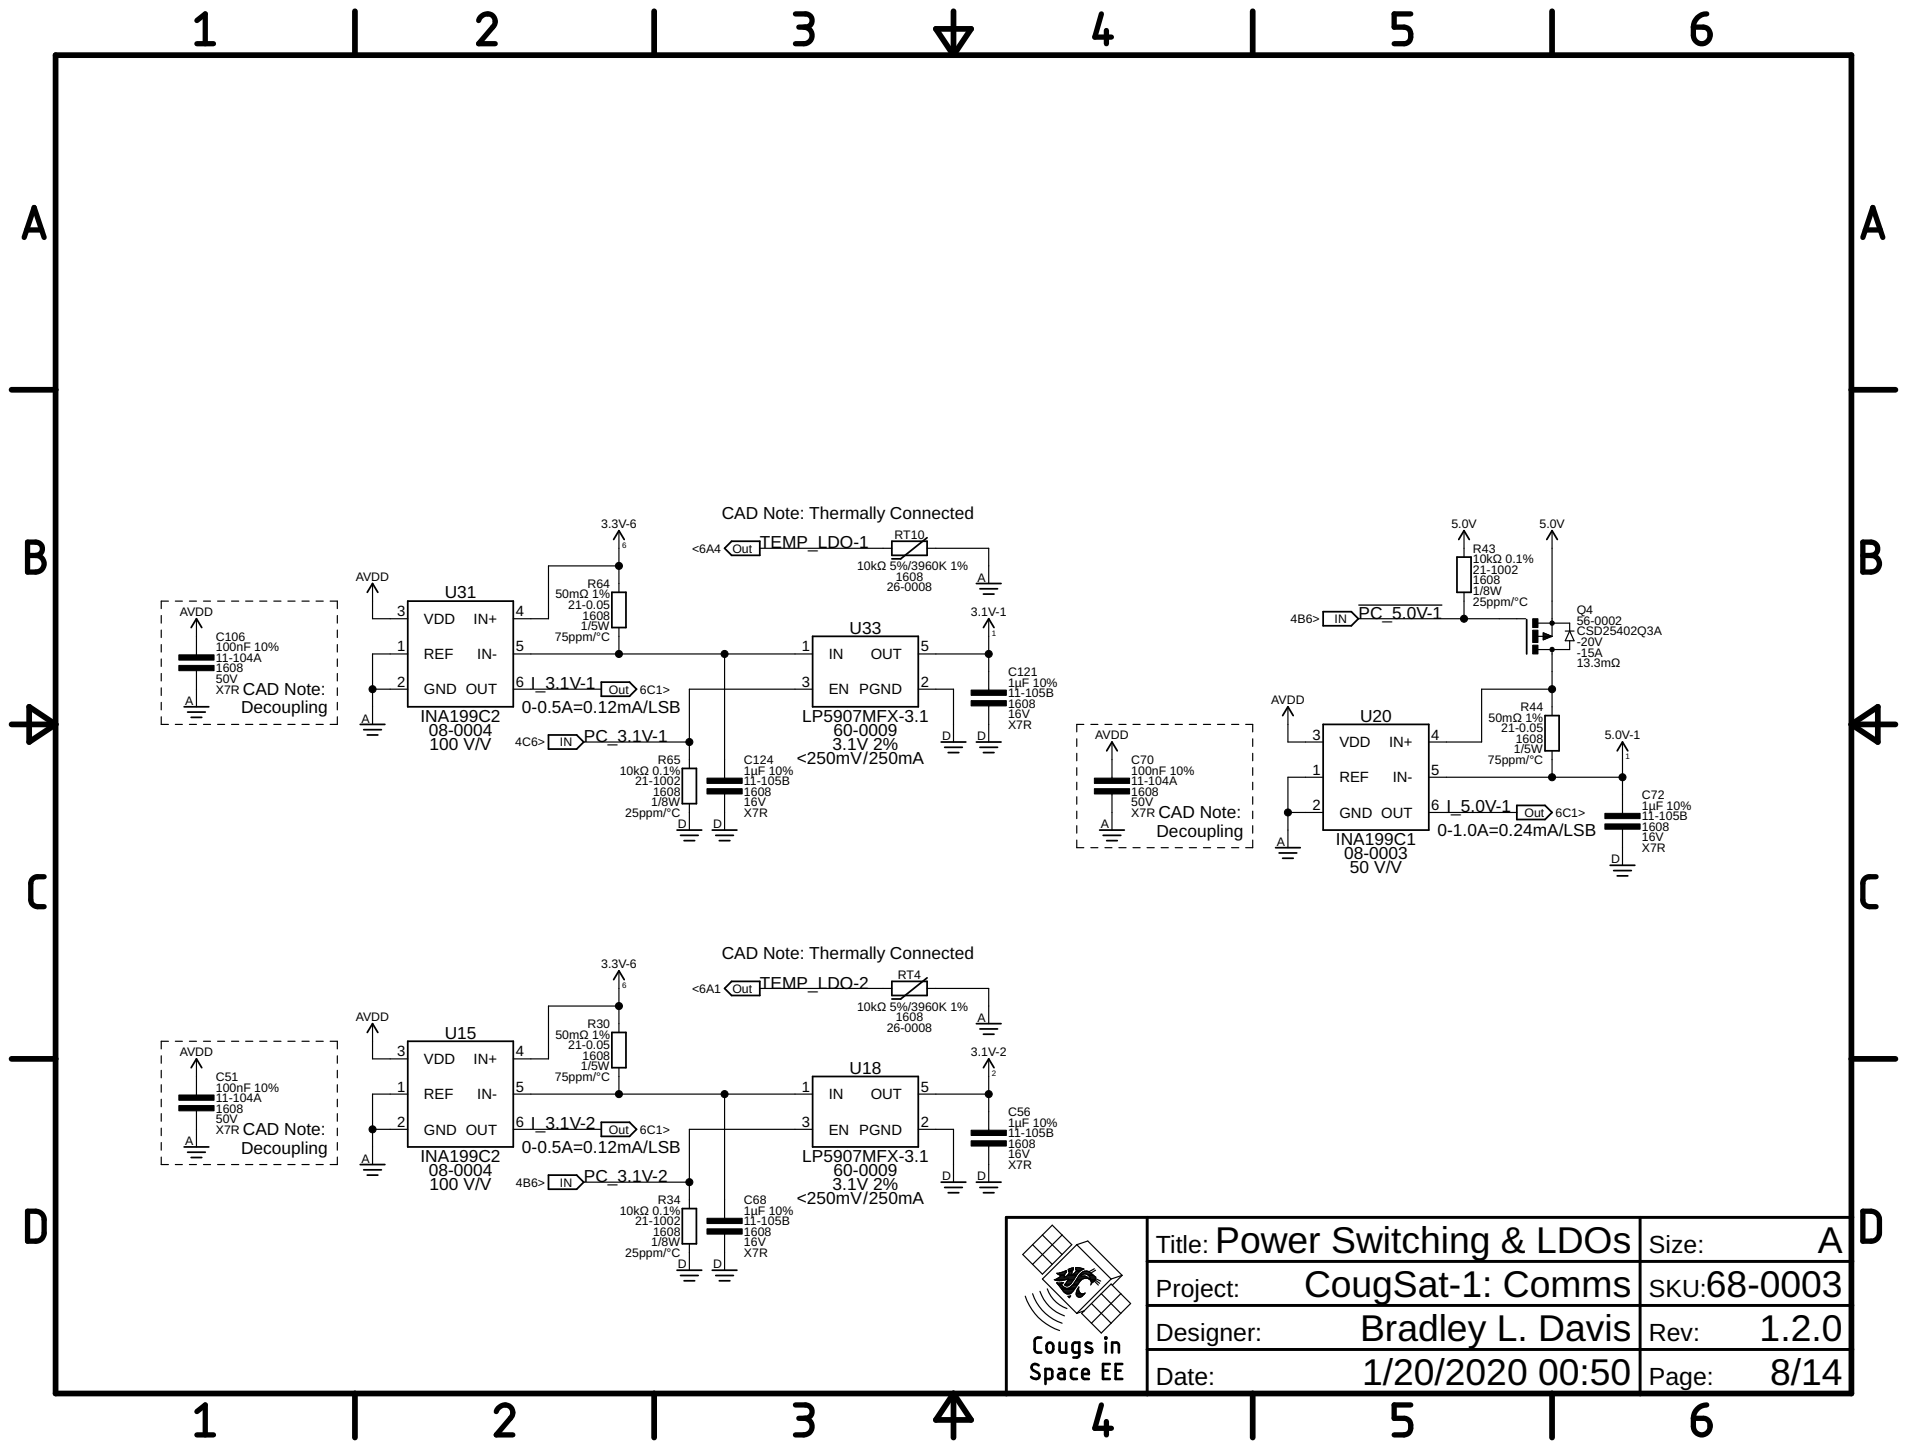
[picture p287: page 8]

CAD Note: Thermally Connected
TEMP_LDO-1

RT4 TEMP_LDO-2

Power Switching & LDOs Title: | A Size:

CougSat-1: Comms Project: | 68-0003 SKU:

Bradley L. Davis Designer: | 1.2.0 Rev:

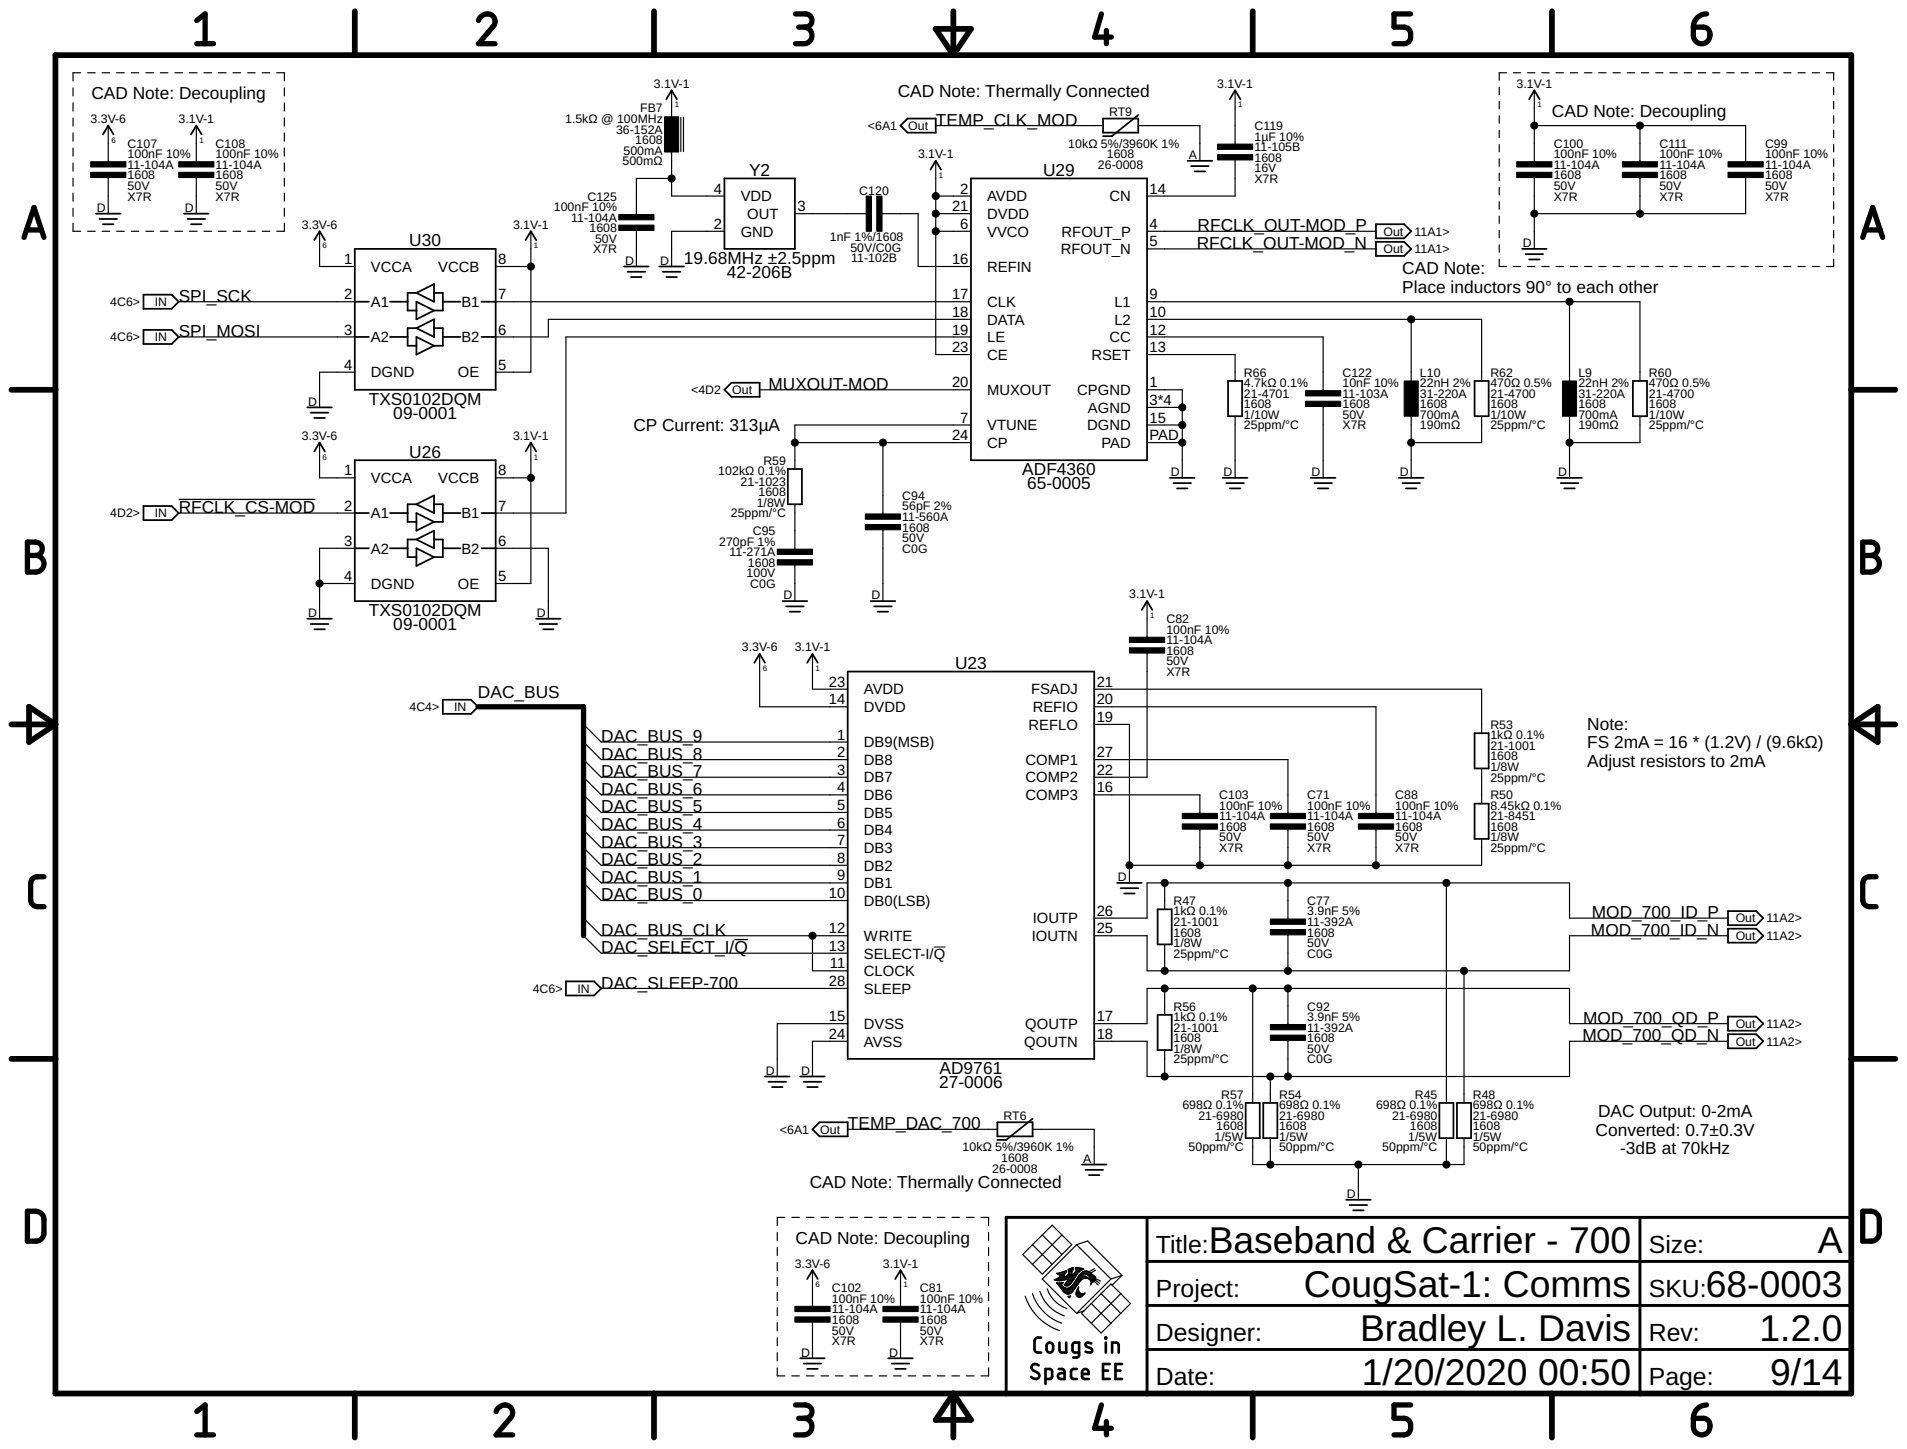
[picture p288: page 9]

CAD Note: Place inductors 90° to each other

Out Out

TEMP_DAC_700
-3dB at 70kHz CAD Note: Thermally Connected

Baseband & Carrier - 700 Title: | A Size:

CougSat-1: Comms Project: | 68-0003 SKU:

Bradley L. Davis Designer: | 1.2.0 Rev:

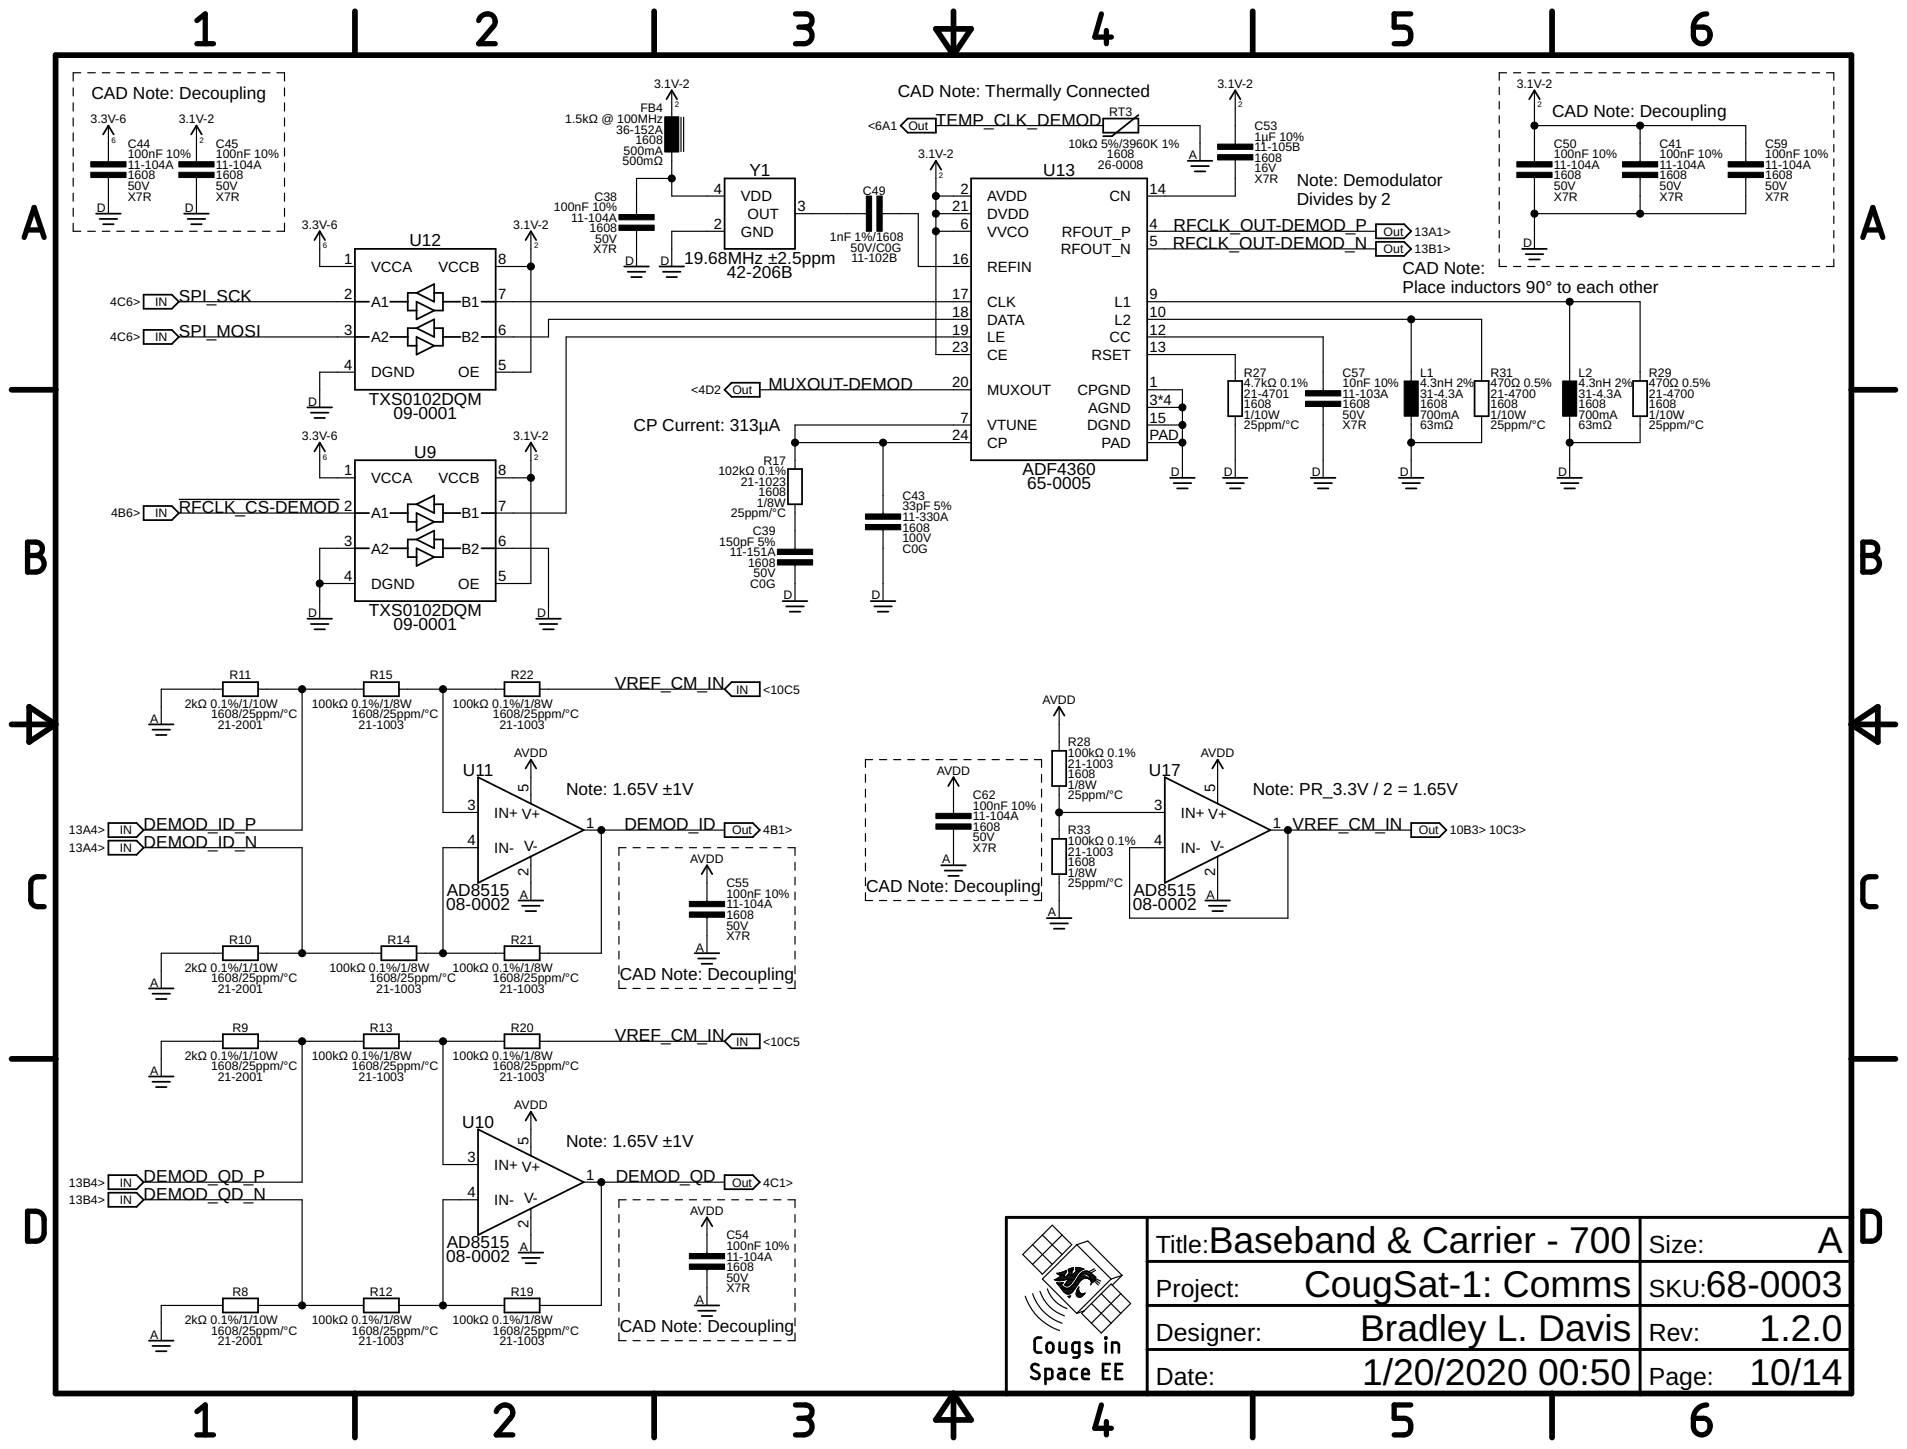
[picture p289: page 10]

CAD Note: Place inductors 90° to each other

Baseband & Carrier - 700 Title: | A Size:

CougSat-1: Comms Project: | 68-0003 SKU:

Bradley L. Davis Designer: | 1.2.0 Rev:

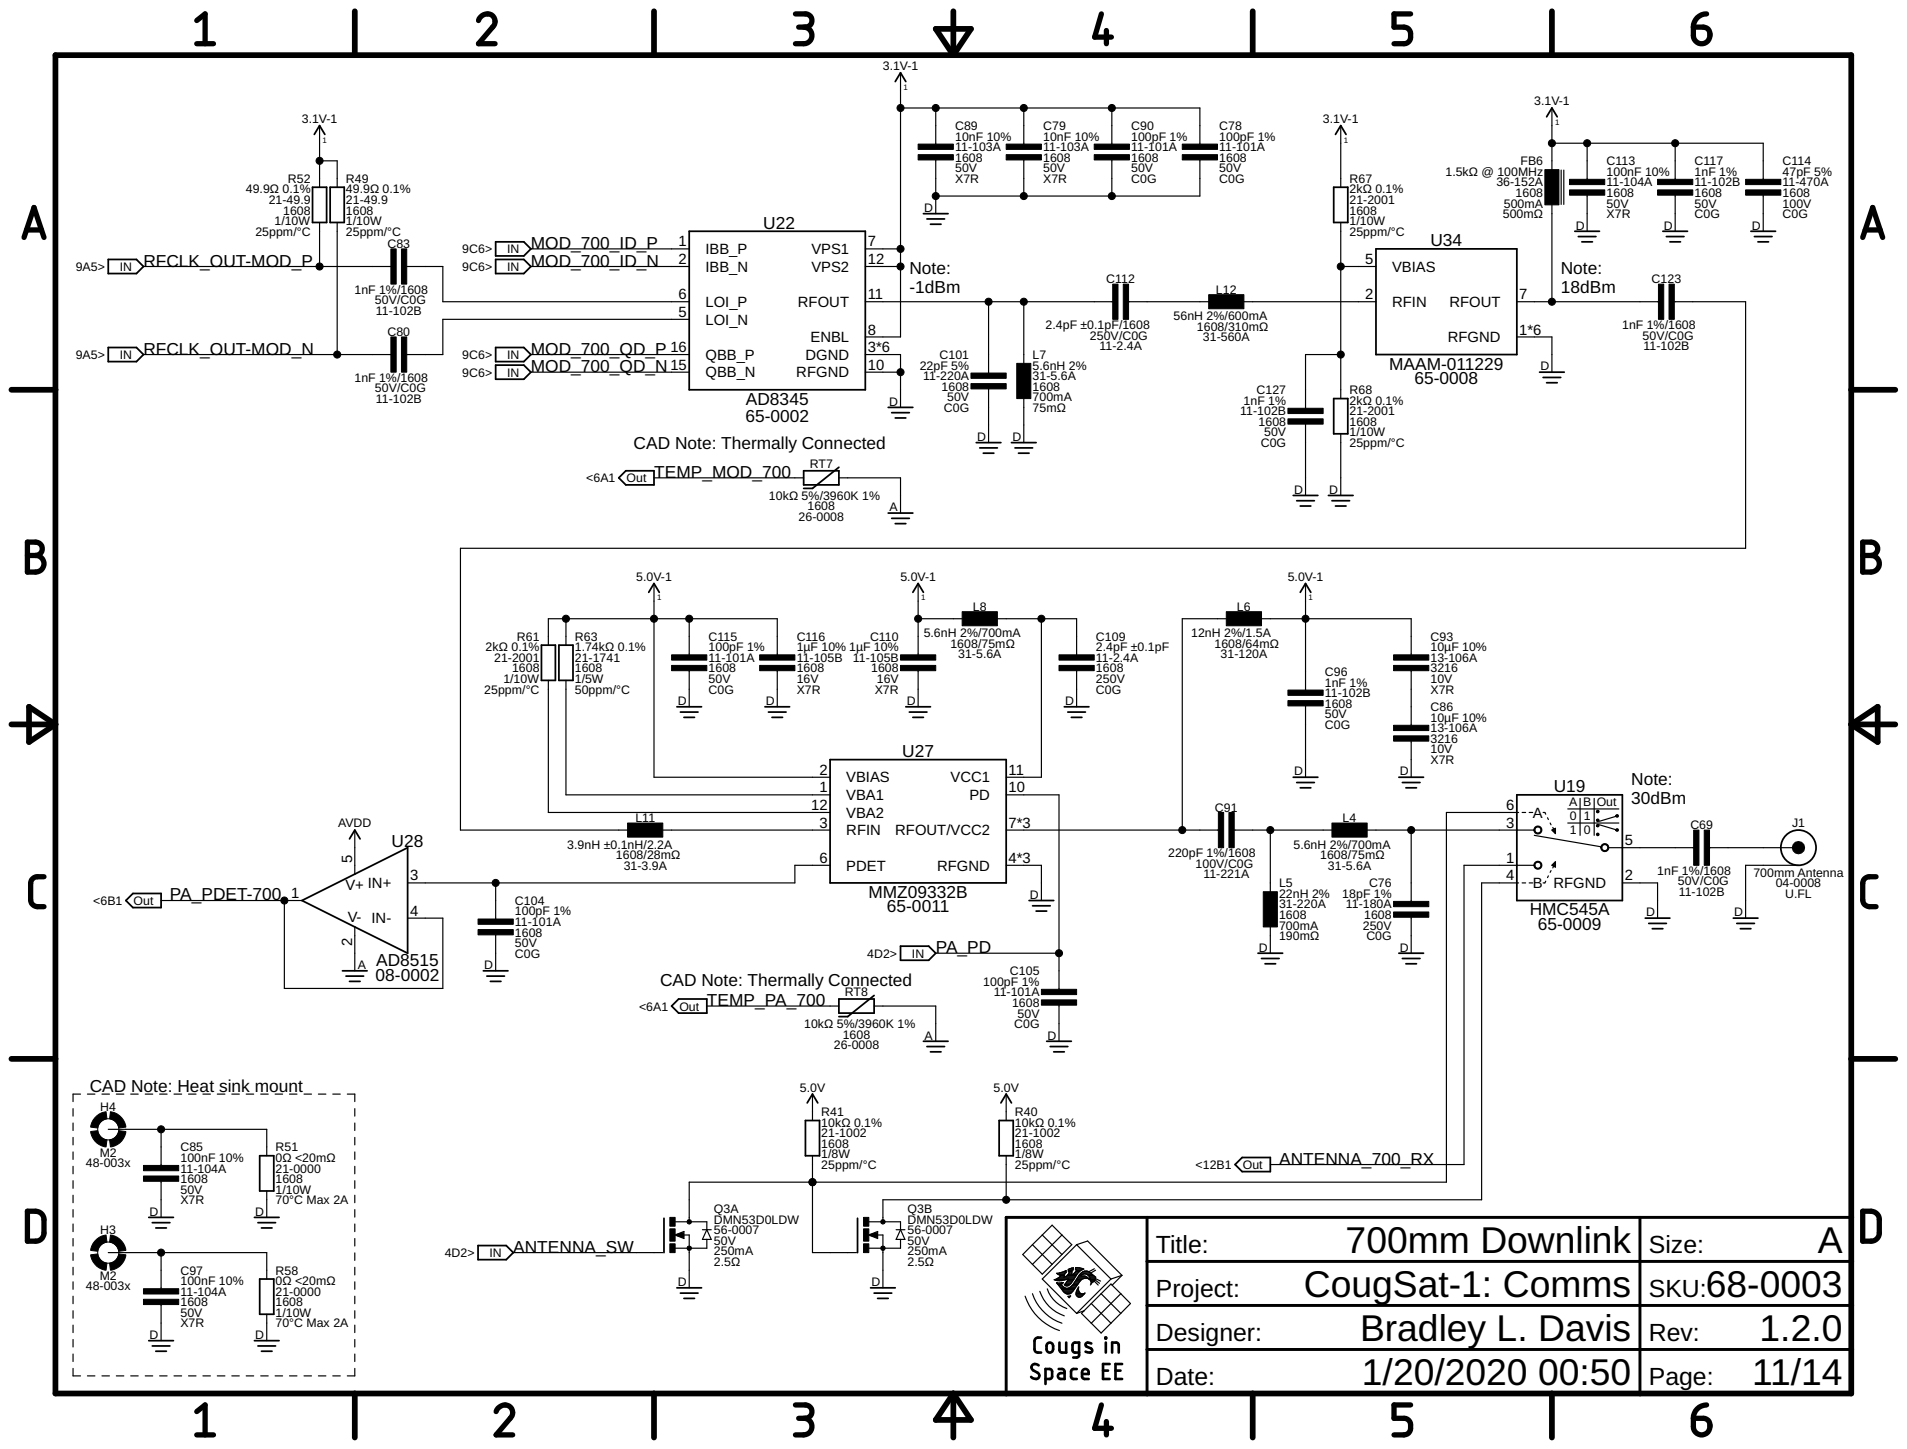
[picture p290: page 11]

CAD Note: Heat sink mount

700mm Downlink Title: | A Size:

CougSat-1: Comms Project: | 68-0003 SKU:

Bradley L. Davis Designer: | 1.2.0 Rev:

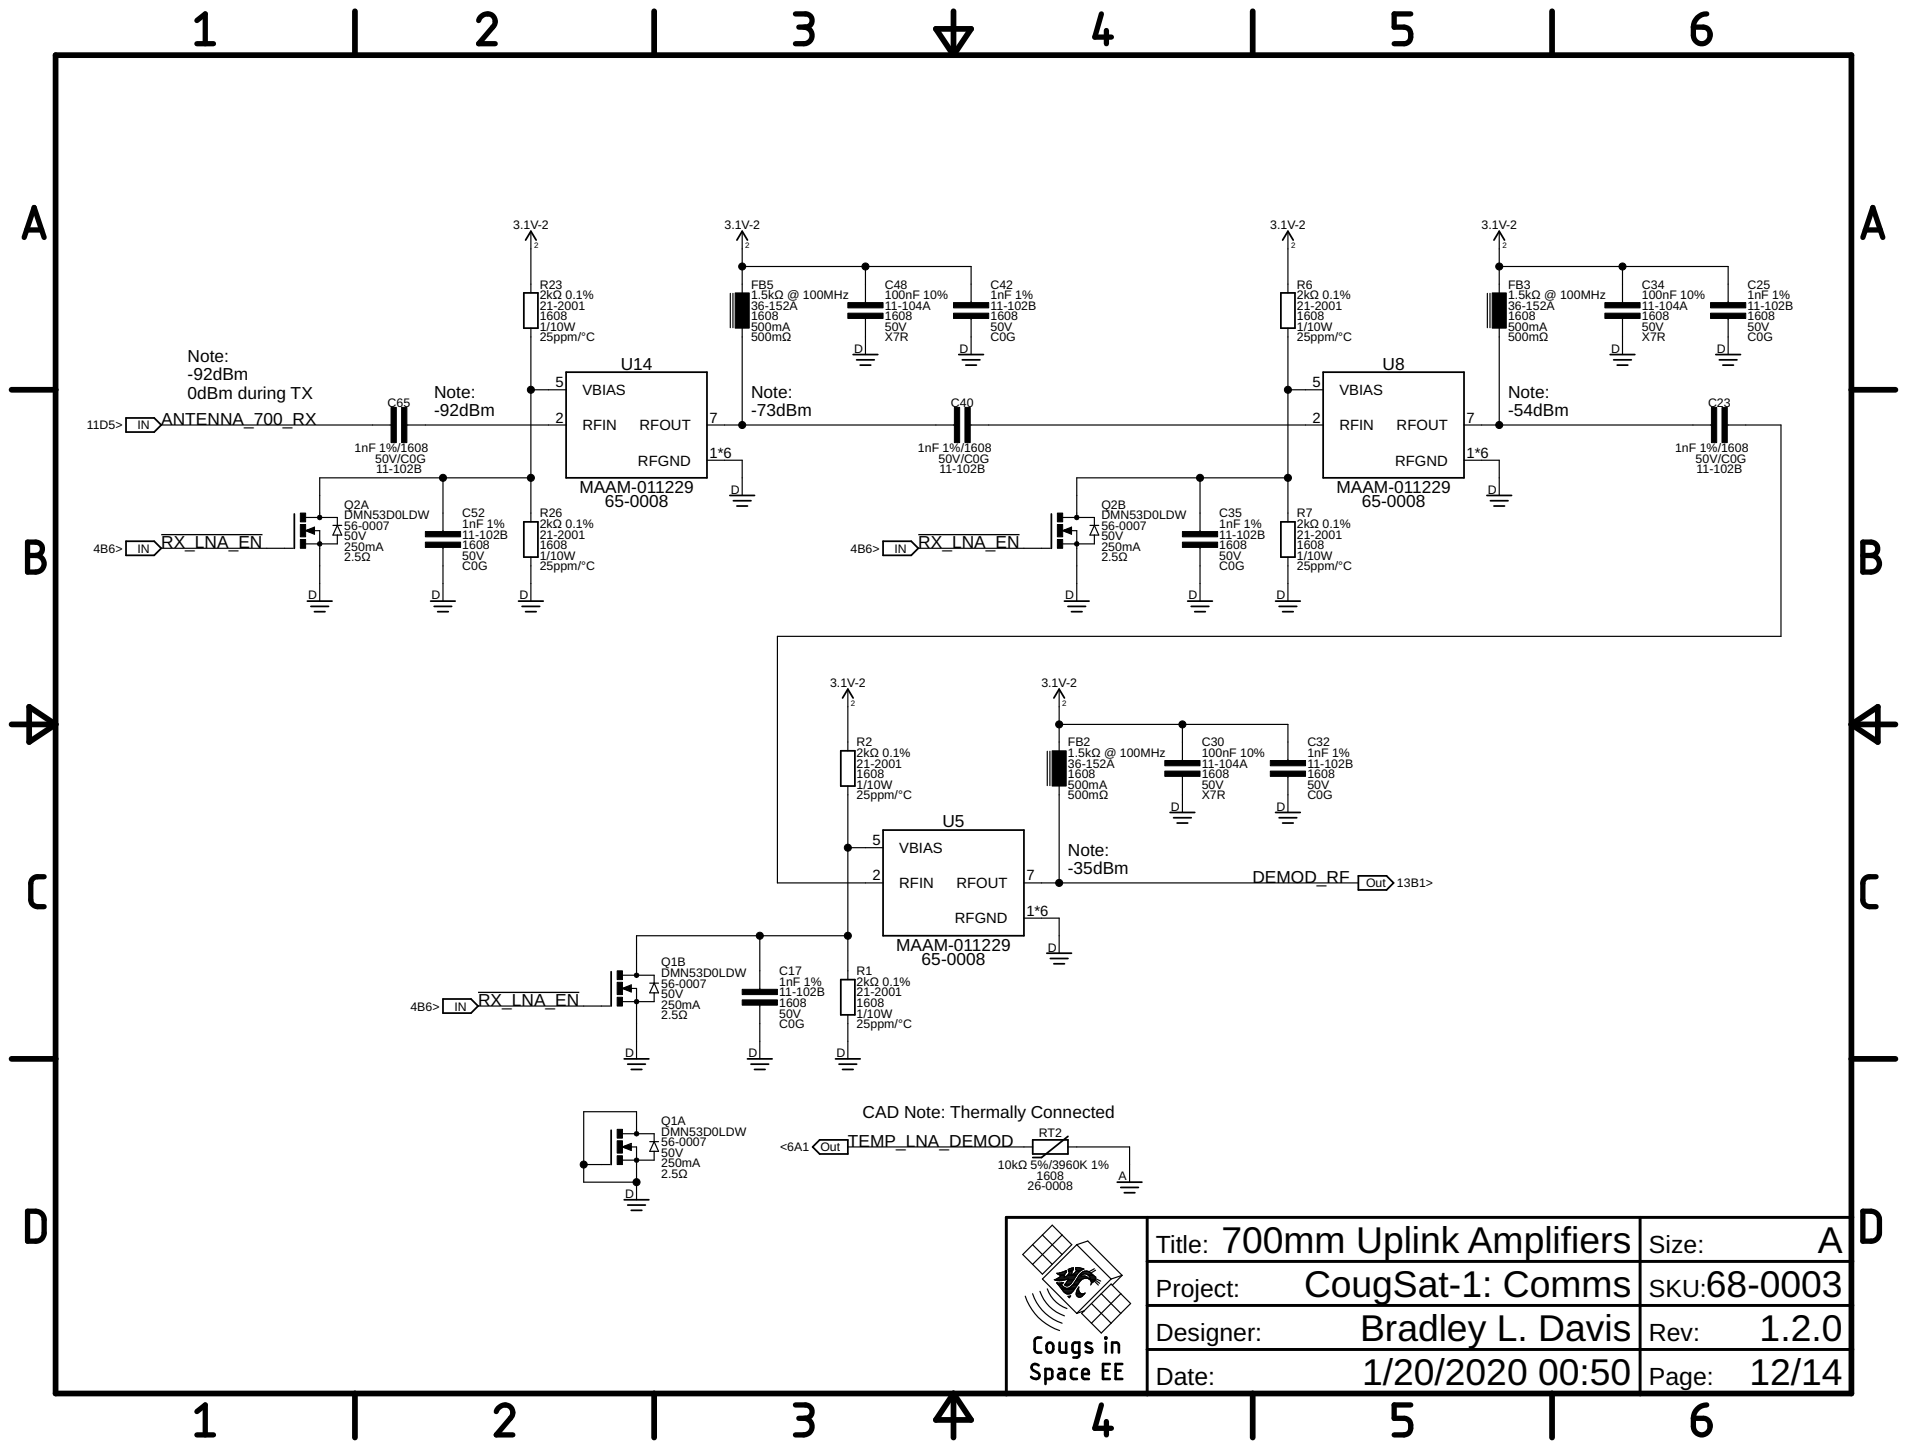
[picture p291: page 12]

700mm Uplink Amplifiers Title: | A Size:

CougSat-1: Comms Project: | 68-0003 SKU:

Bradley L. Davis Designer: | 1.2.0 Rev:

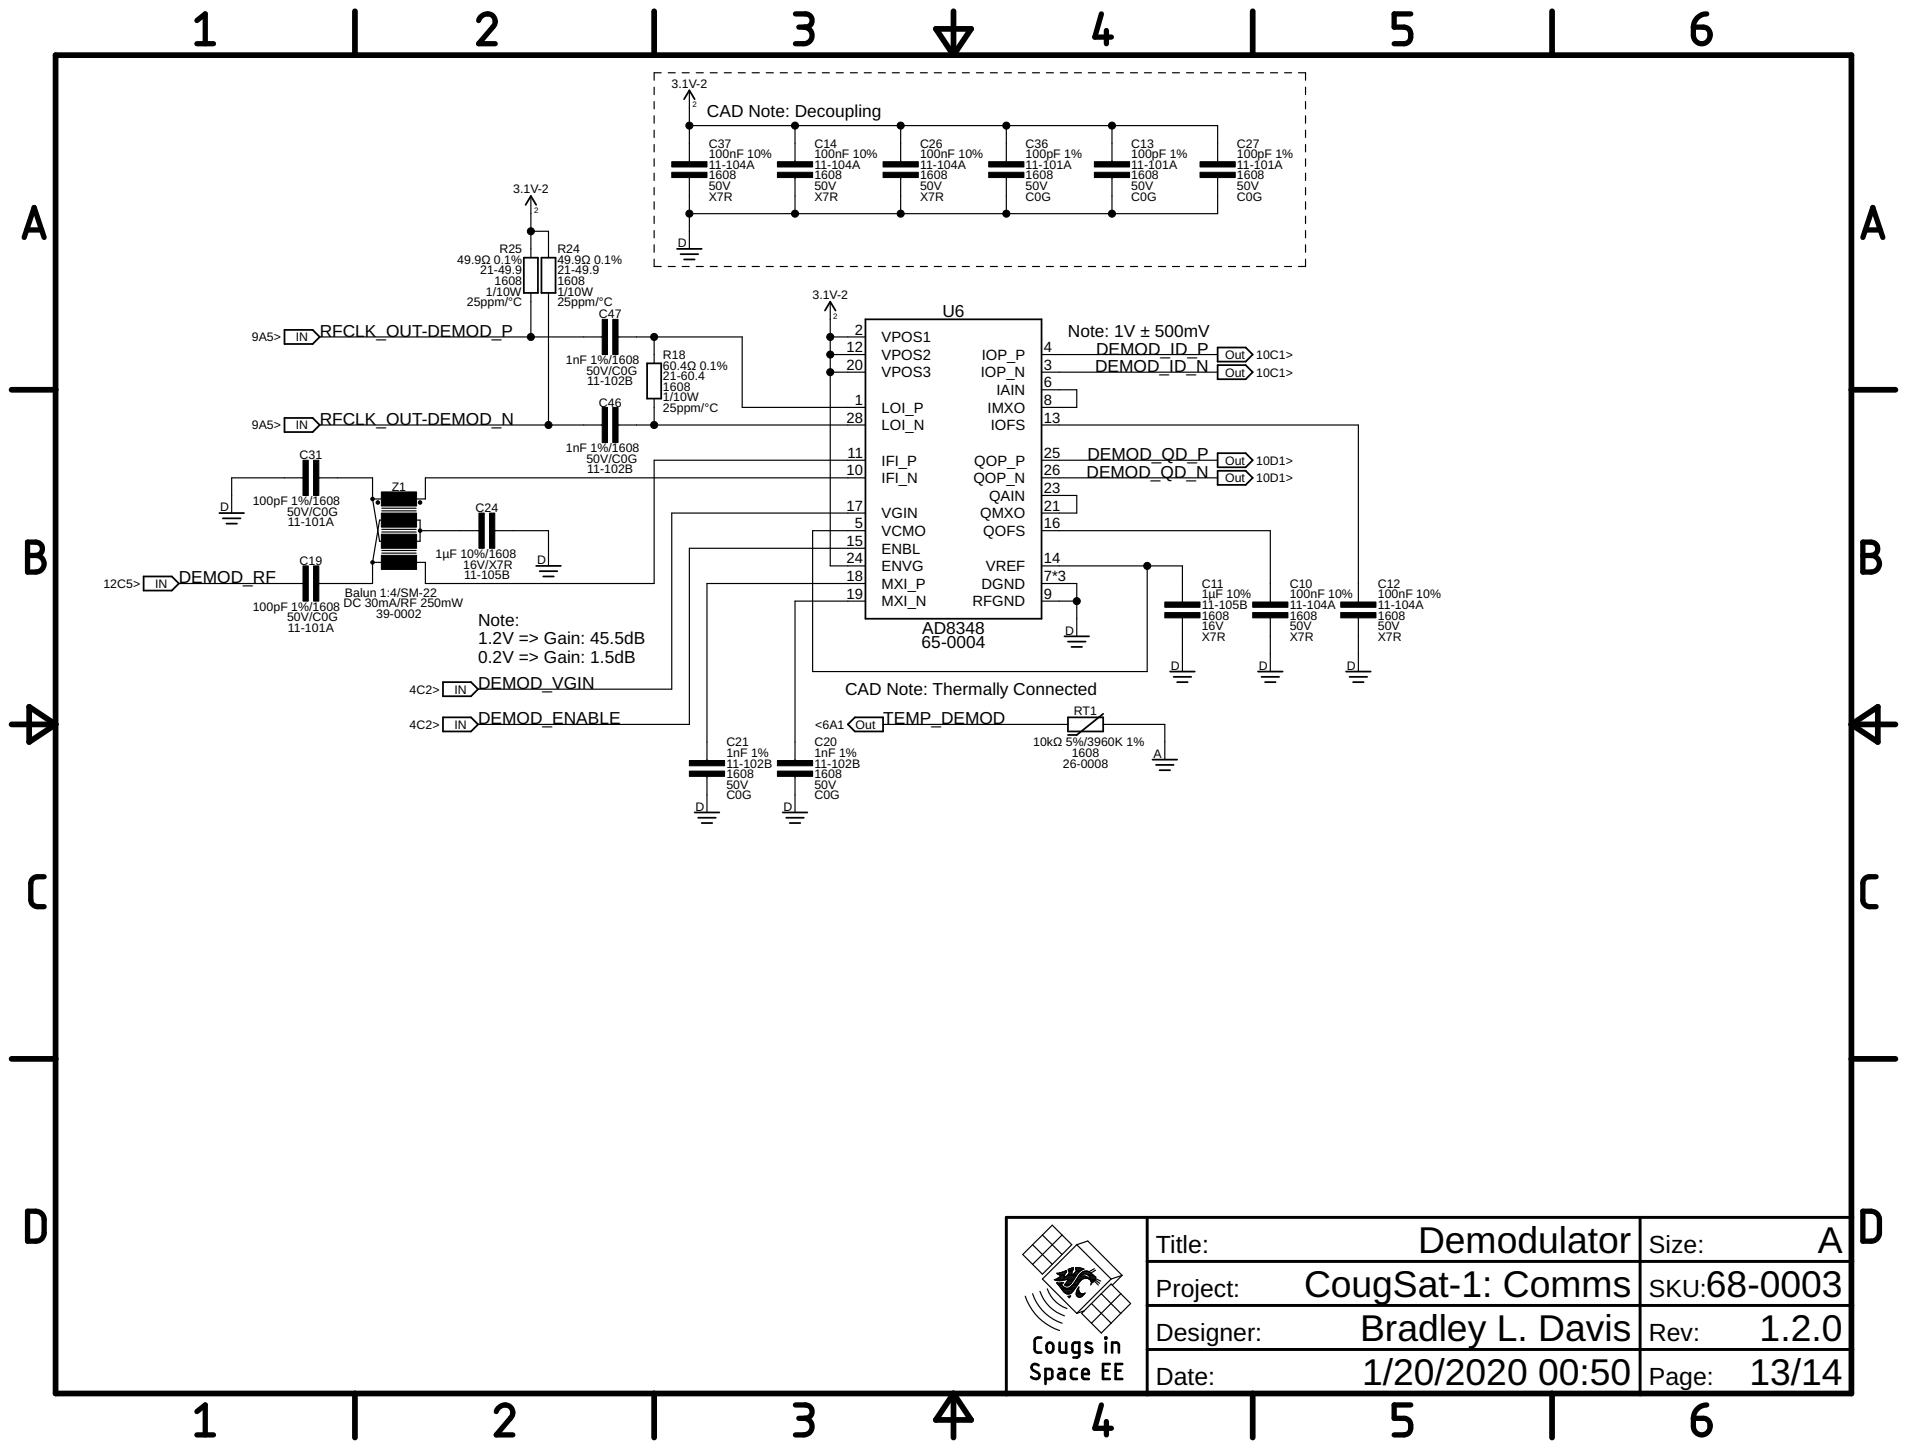
[picture p292: page 13]

Out Out

CAD Note: Thermally Connected

Demodulator Title: | A Size:

CougSat-1: Comms Project: | 68-0003 SKU:

Bradley L. Davis Designer: | 1.2.0 Rev:

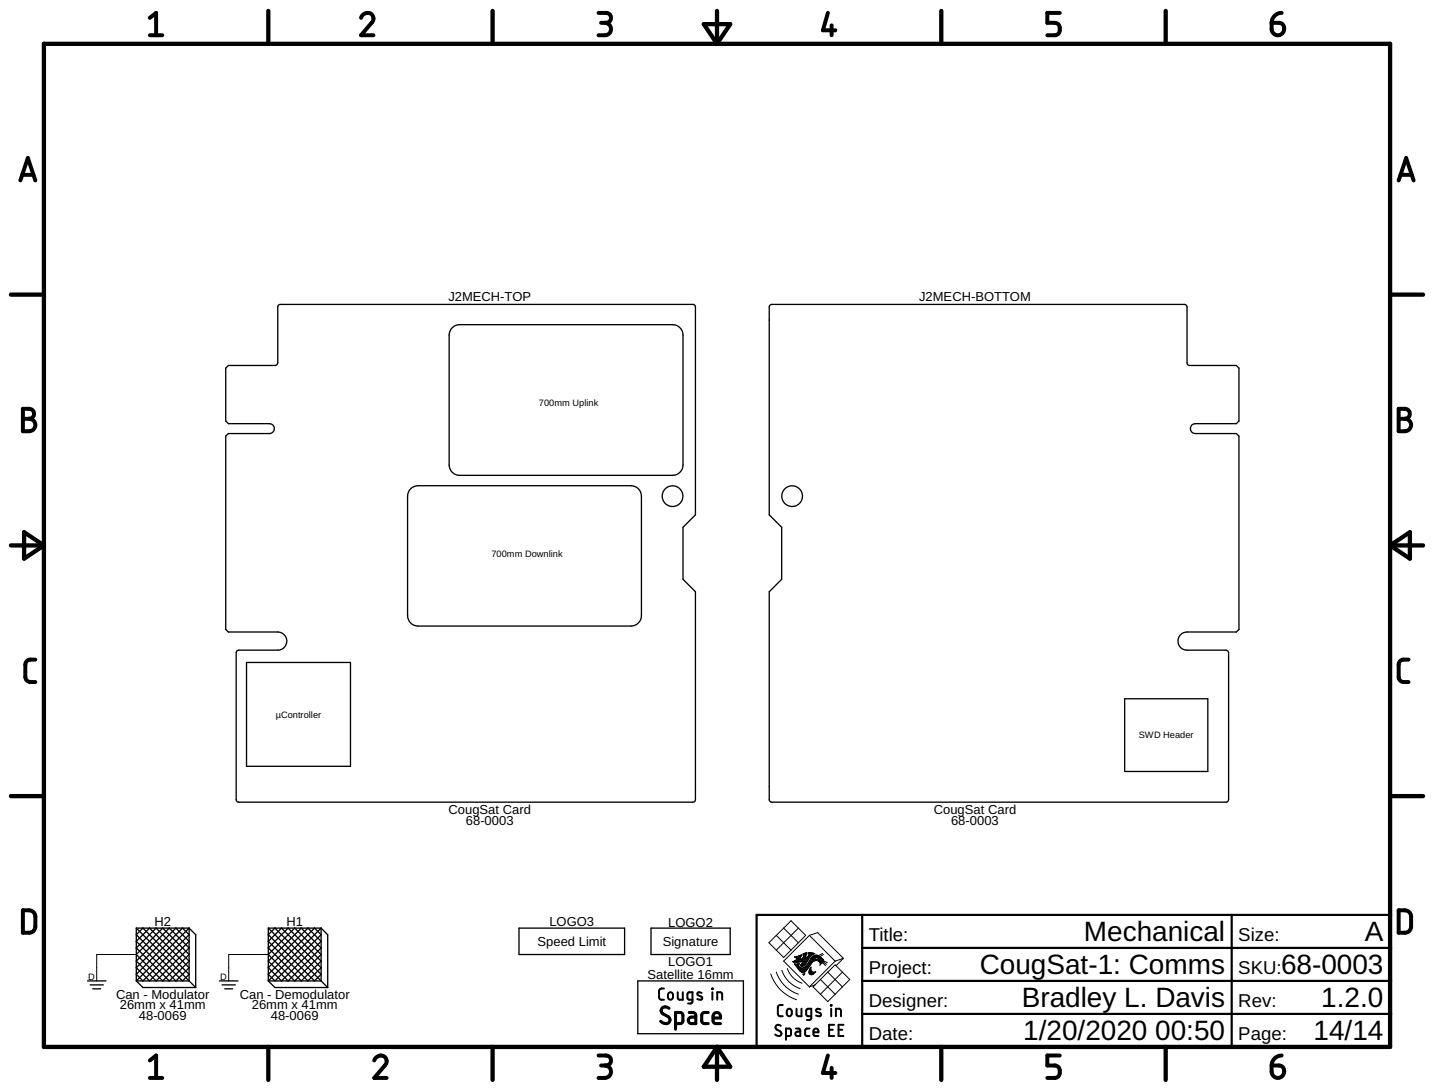
[picture p293: page 14]

Title: | A Size:

CougSat-1: Comms Project: | 68-0003 SKU:

Bradley L. Davis Designer: | 1.2.0 Rev:
