CougsInSpace/CougSat1-Hardware/CougSat1-Payload/Documentation/Payload-Camera.pdf

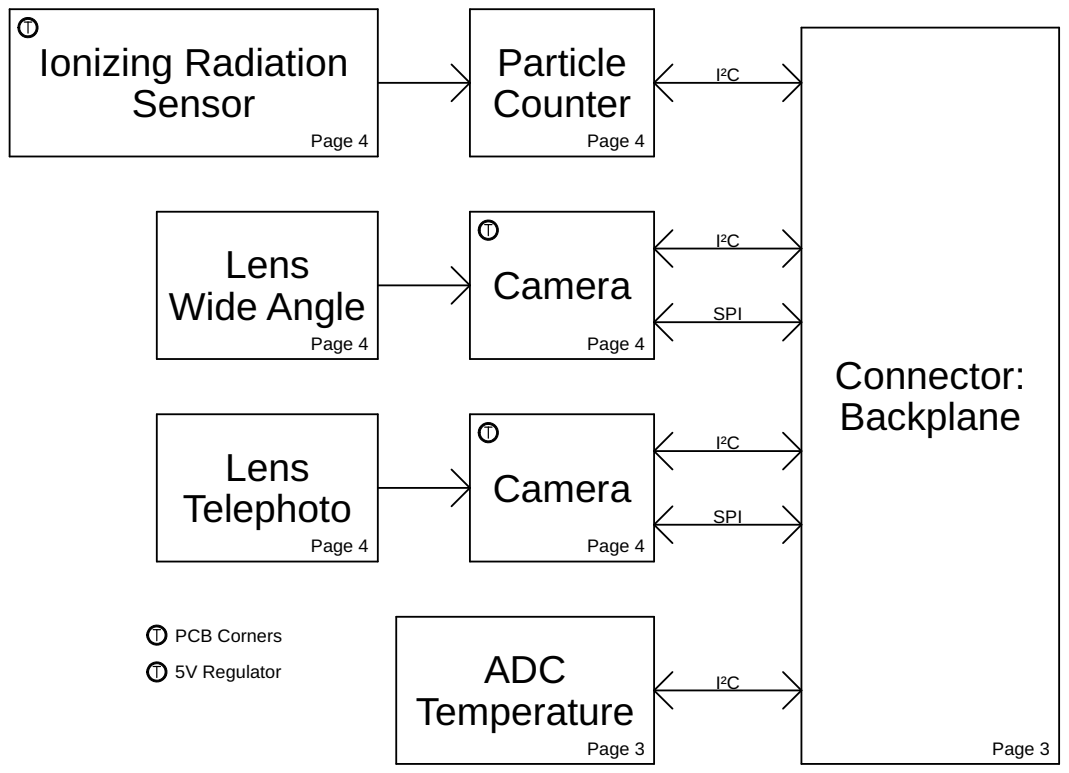
[picture p294: page 1]

Page 1: Block Diagram Page 2: Power Rails Page 3: Connector/ADC Page 4: Particle Counter, Cameras Page 5: Buffers Page 6: Mechanical | Block Diagram Title: | A Size:

CougSat-1: Camera Project: | 68-0007 SKU:

Hendrik Melse Designer: | 1.1.2 Rev:

not saved! Date: | 1/6 Page:

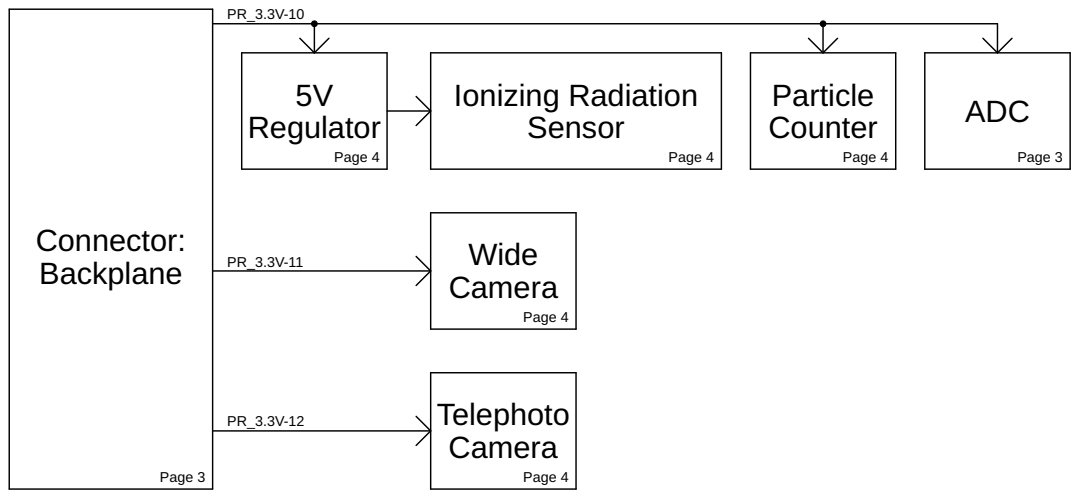
[picture p295: page 2]

Power Rails Title: | A Size:

CougSat-1: Camera Project: | 68-0007 SKU:

Hendrik Melse Designer: | 1.1.2 Rev:

not saved!

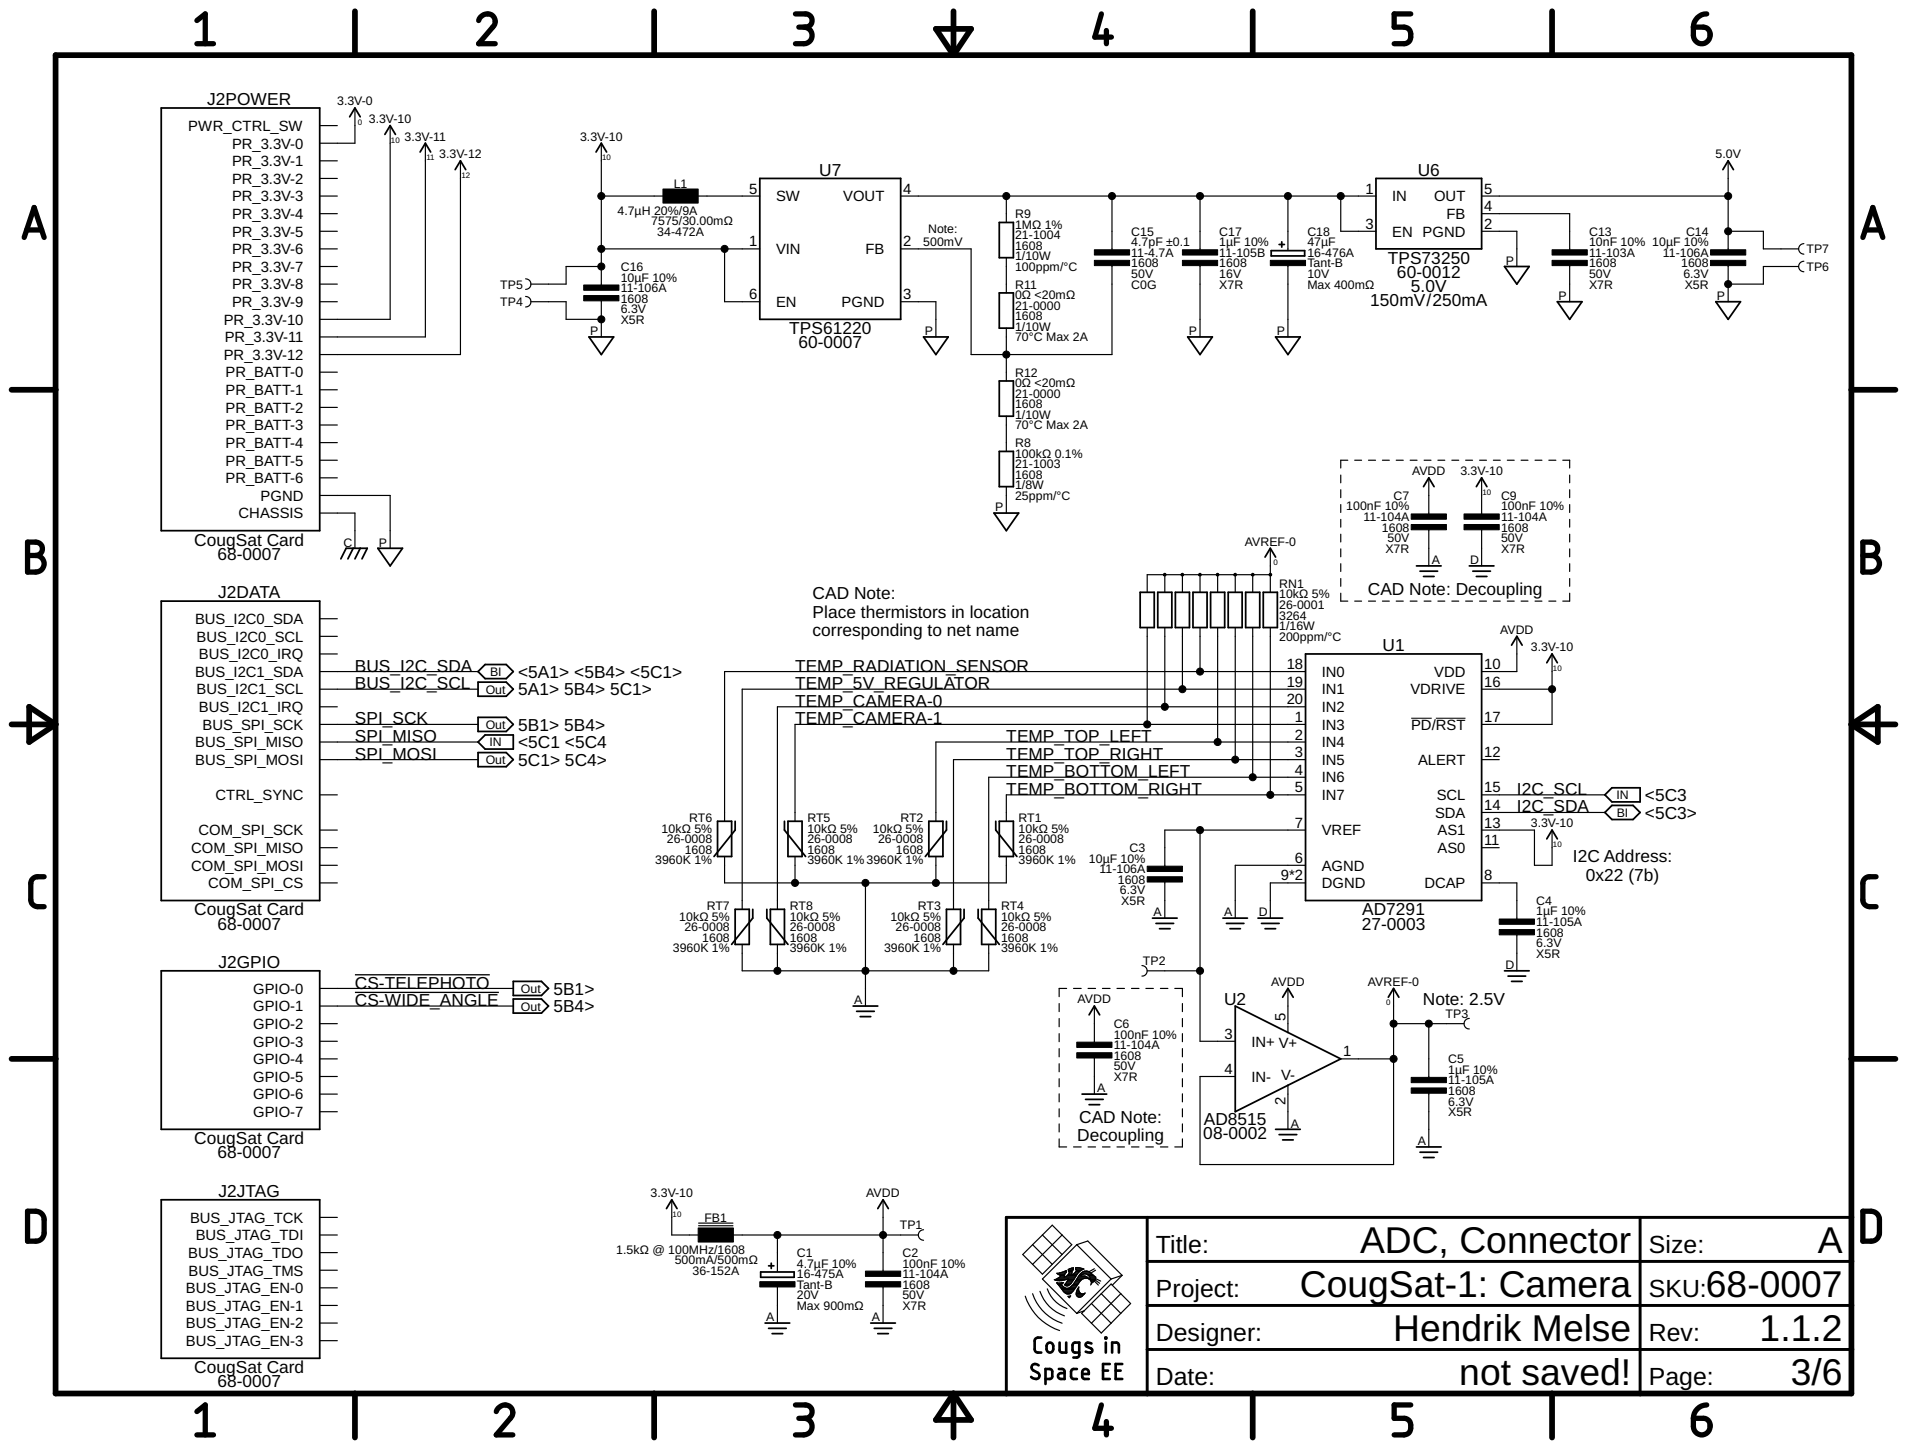
[picture p296: page 3]

CAD Note: Place thermistors in location

corresponding to net name

TEMP_5V_REGULATOR | | | | | | | 19 | 16
TEMP_CAMERA-0 | | | | | | 20
TEMP_CAMERA-1 | | | | | 1

TEMP_TOP_LEFT | | | | 2 | | I2C_SDA 3.3V-10
TEMP_TOP_RIGHT | | | 3
TEMP_BOTTOM_LEFT | | 4
TEMP_BOTTOM_RIGHT | 5

CougSat Card
GPIO-0 GPIO-1 GPIO-2 GPIO-3 GPIO-4 GPIO-5 GPIO-6 GPIO-7

ADC, Connector Title: | A Size:

CougSat-1: Camera Project: | 68-0007 SKU:

Hendrik Melse Designer: | 1.1.2 Rev:

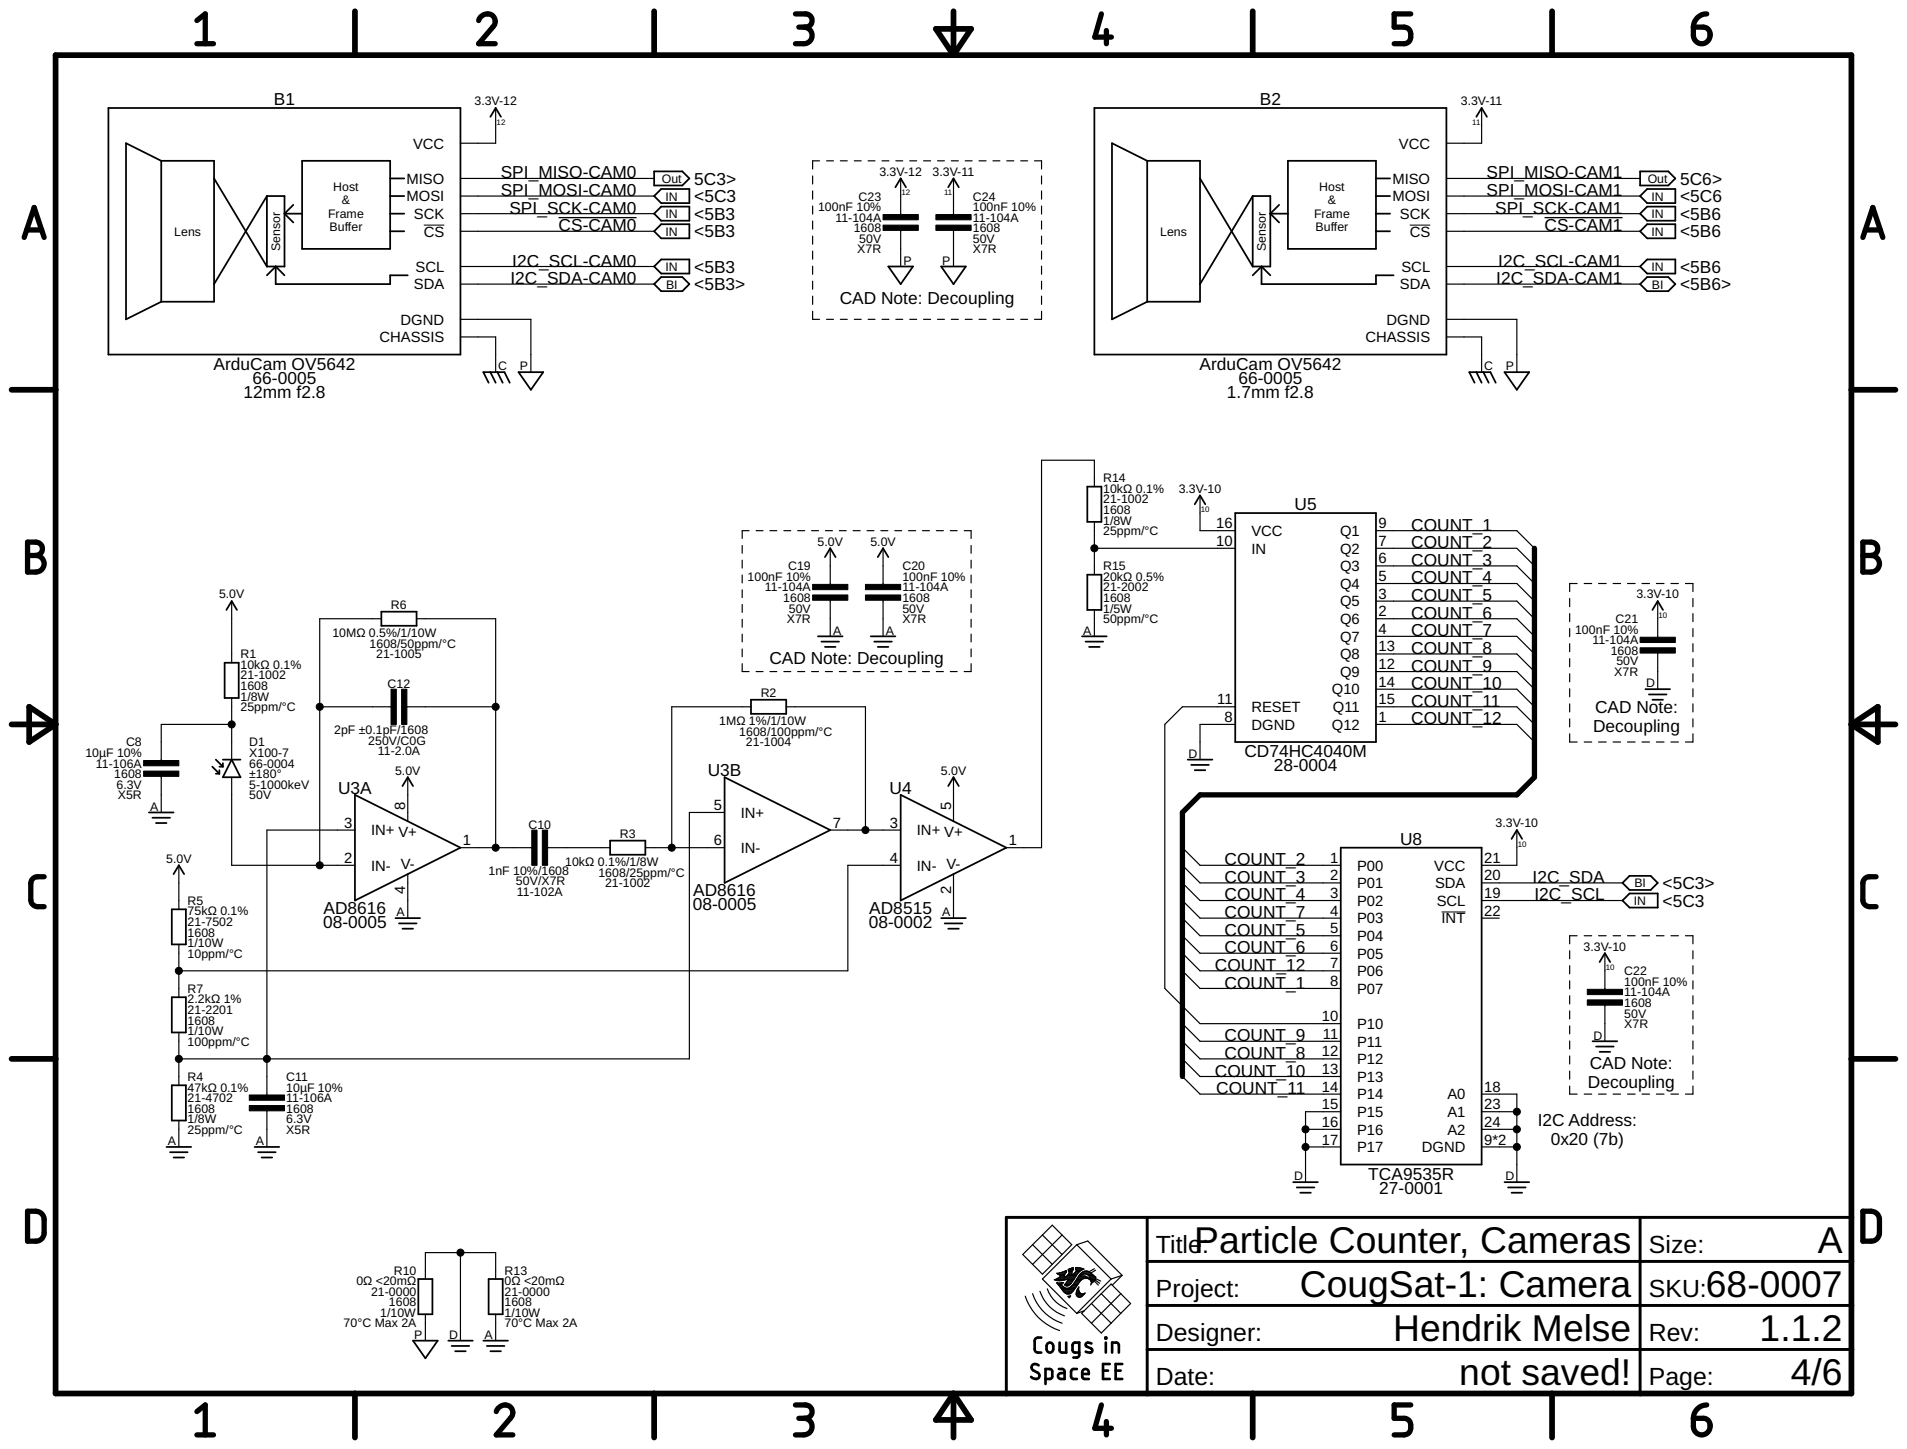
[picture p297: page 4]

Particle Counter, Cameras Title: | A Size:

CougSat-1: Camera Project: | 68-0007 SKU:

Hendrik Melse Designer: | 1.1.2 Rev:

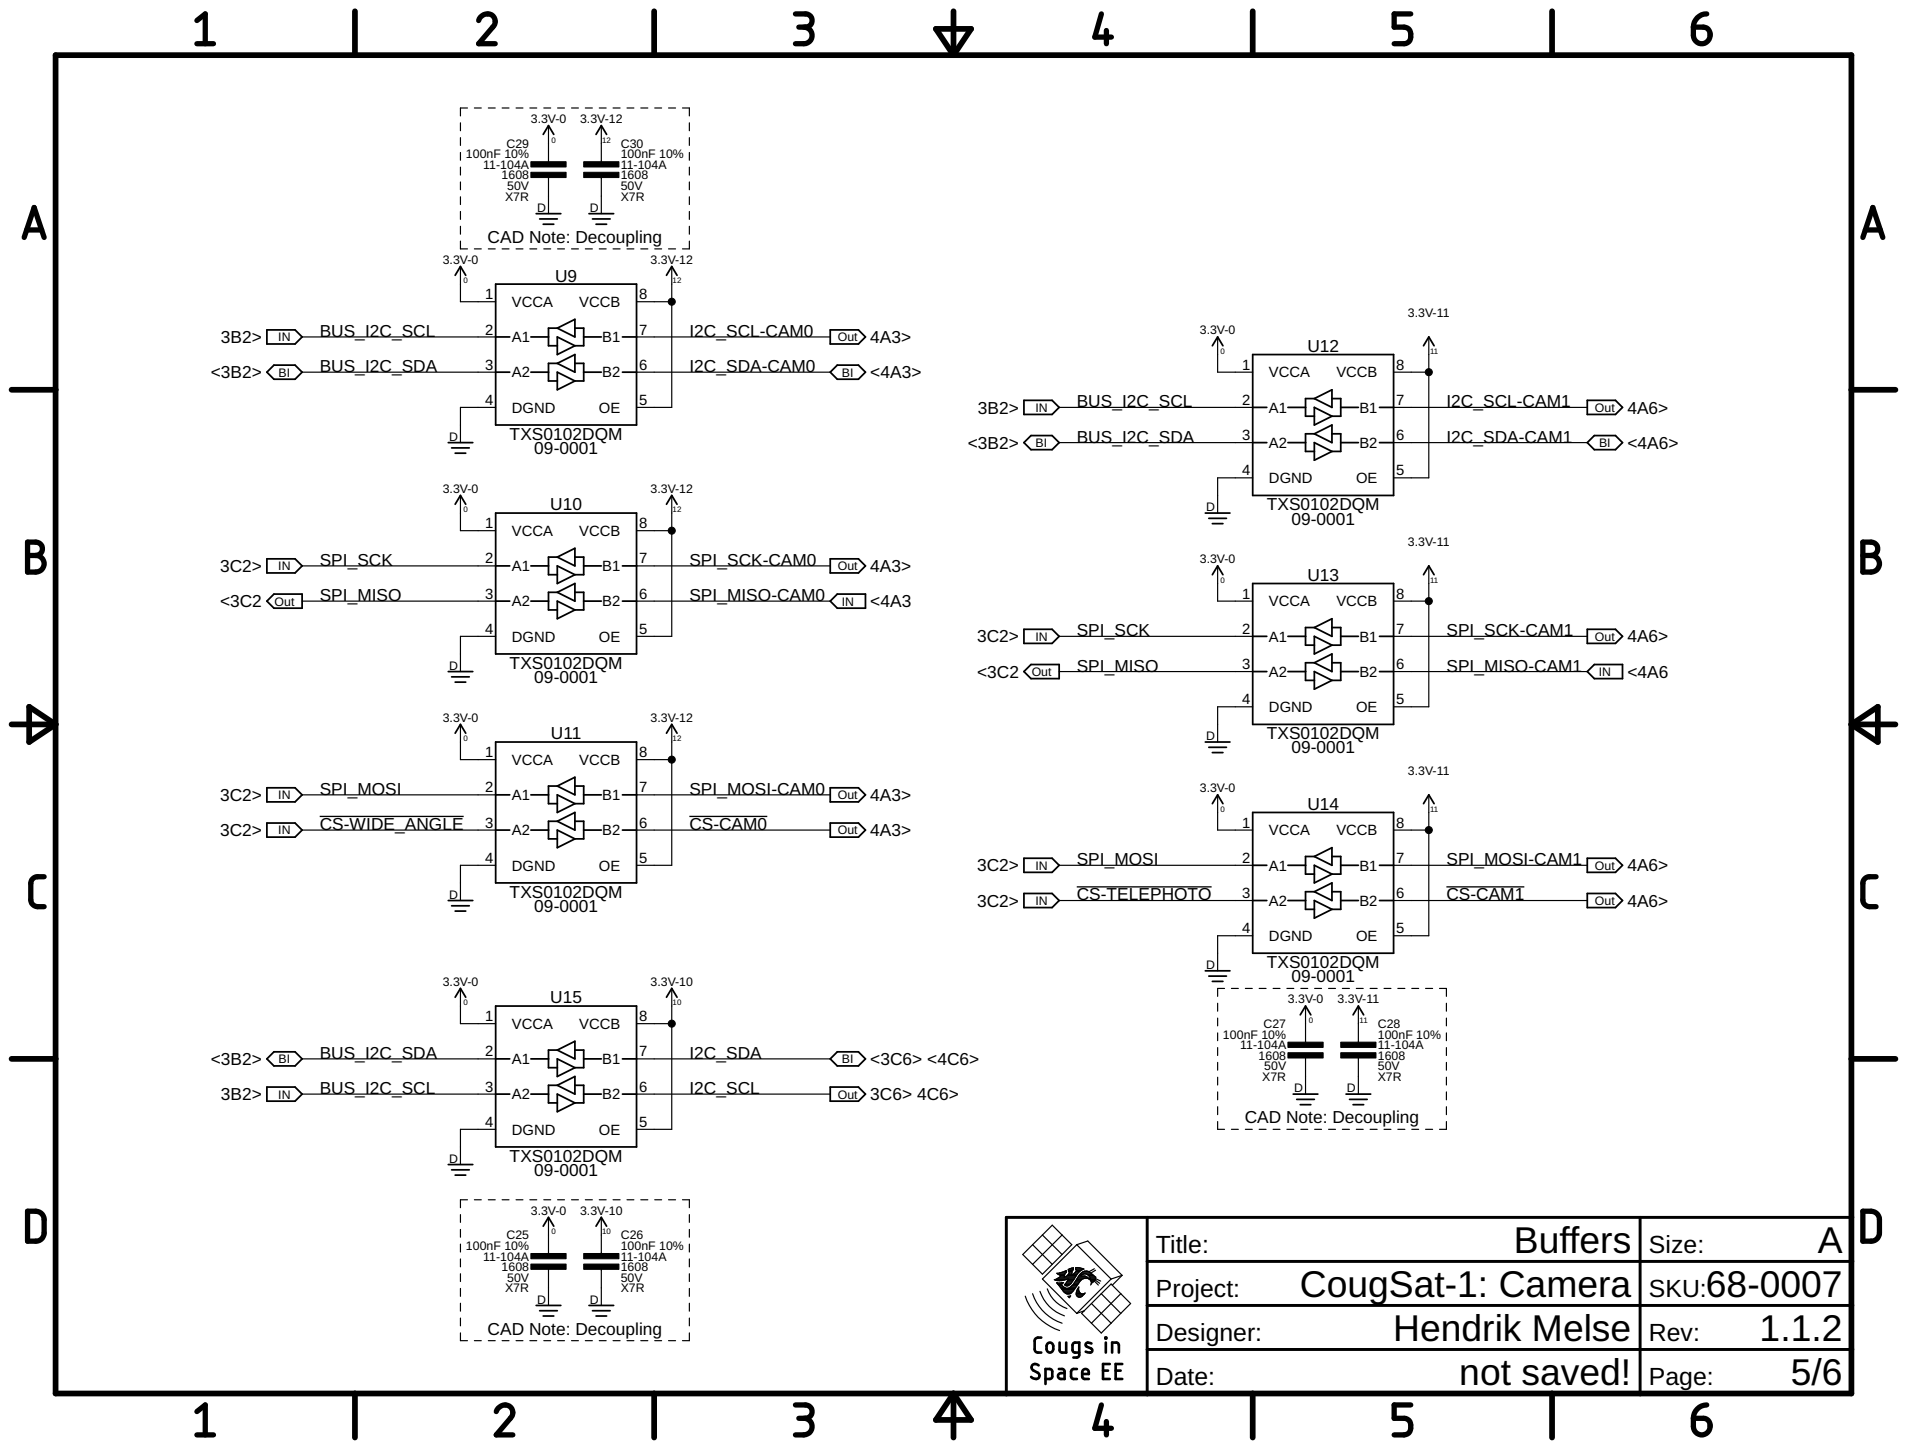
[picture p298: page 5]

Buffers Title: | A Size:

CougSat-1: Camera Project: | 68-0007 SKU:

Hendrik Melse Designer: | 1.1.2 Rev:

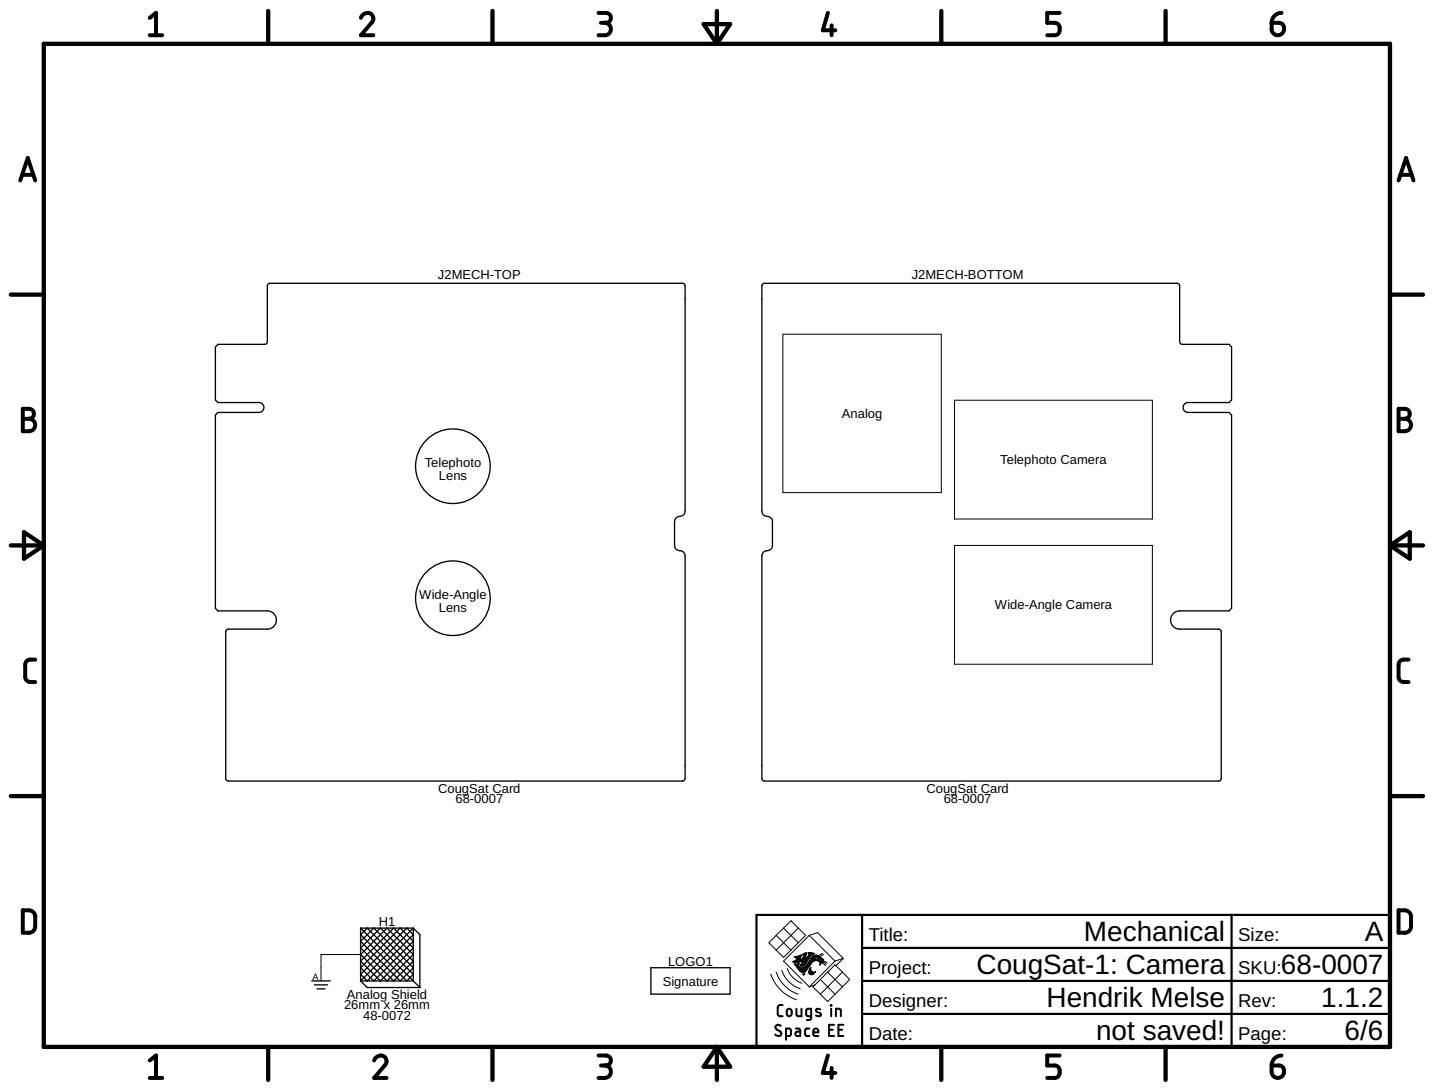
[picture p299: page 6]

Telephoto Camera Wide-Angle Camera

Mechanical Title: | A Size:

CougSat-1: Camera Project: | 68-0007 SKU:

Hendrik Melse Designer: | 1.1.2 Rev:
