CougsInSpace/CougSat1-Hardware/CougSat1-Umbilical/Documentation/Umbilical.pdf

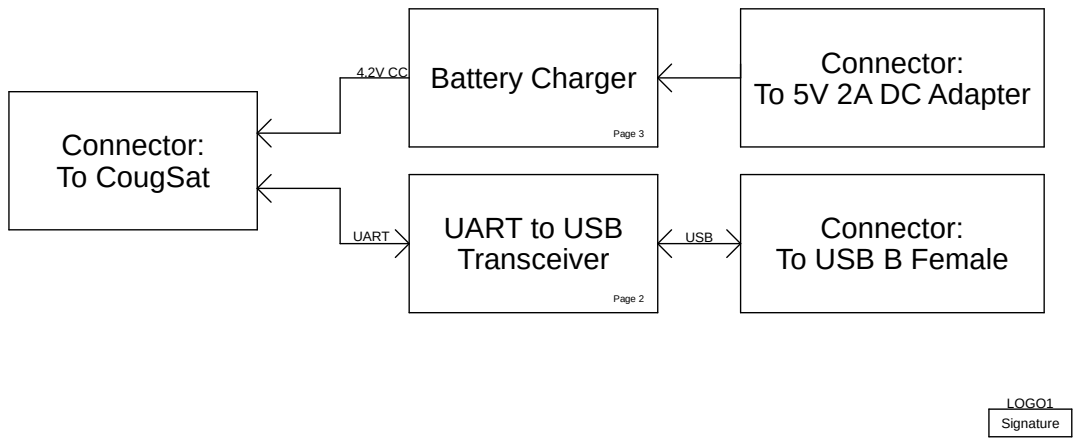
[picture p300: page 1]
UART; USB; Page 2; Page 3; LOGO1; Connector: To CougSat; Battery Charger; Signature

Connector:
To 5V 2A DC Adapter

UART to USB
Transceiver

To USB B Female

Page 1: Block Diagram Page 2: Battery Charger Page 3: Serial Transciever Page 4: Mechanical | Block Diagram Title: | A Size:

CougSat Umbilical Project: | 68-0009 SKU:
Jayson Lopez Designer: | 1.0.4 Rev:
9/25/2019 7:33 PM Date: | 1/4 Page:

05-0005 | P
5V input | 5.0V

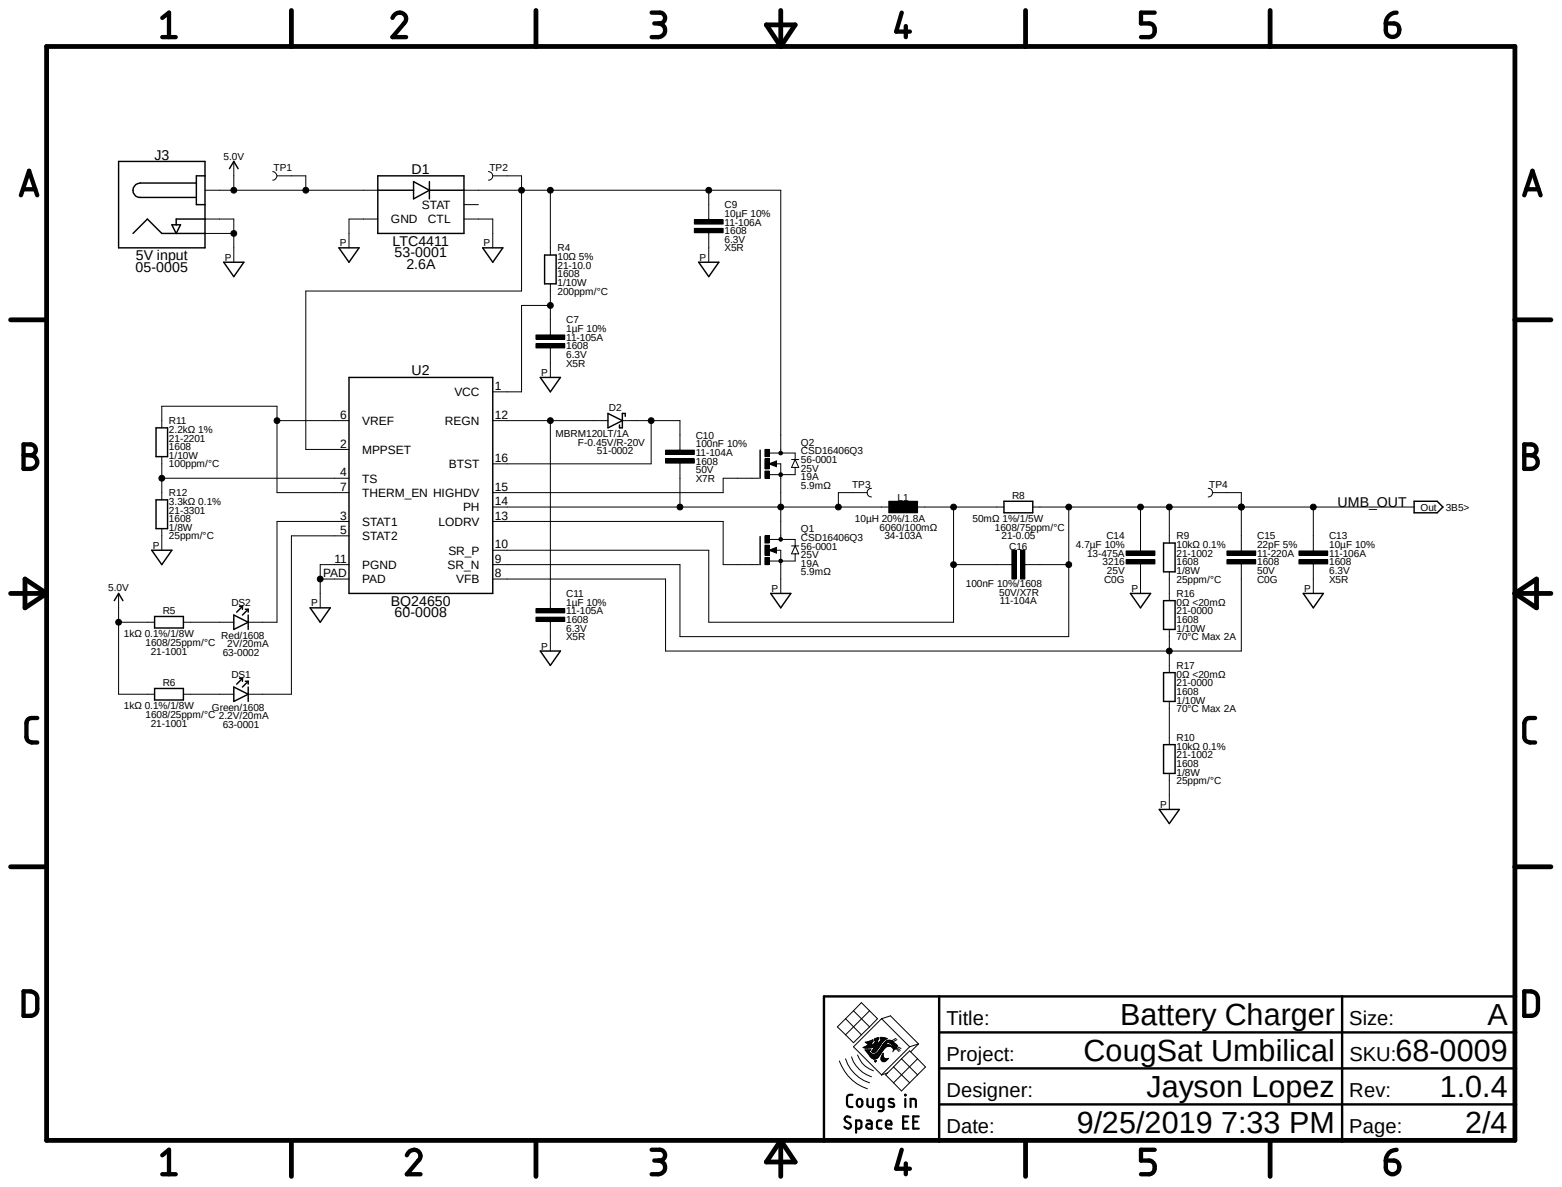
[picture p301: page 2]

Battery Charger Title: | A Size:
CougSat Umbilical Project: | 68-0009 SKU:
Jayson Lopez Designer: | 1.0.4 Rev:

J2 C1

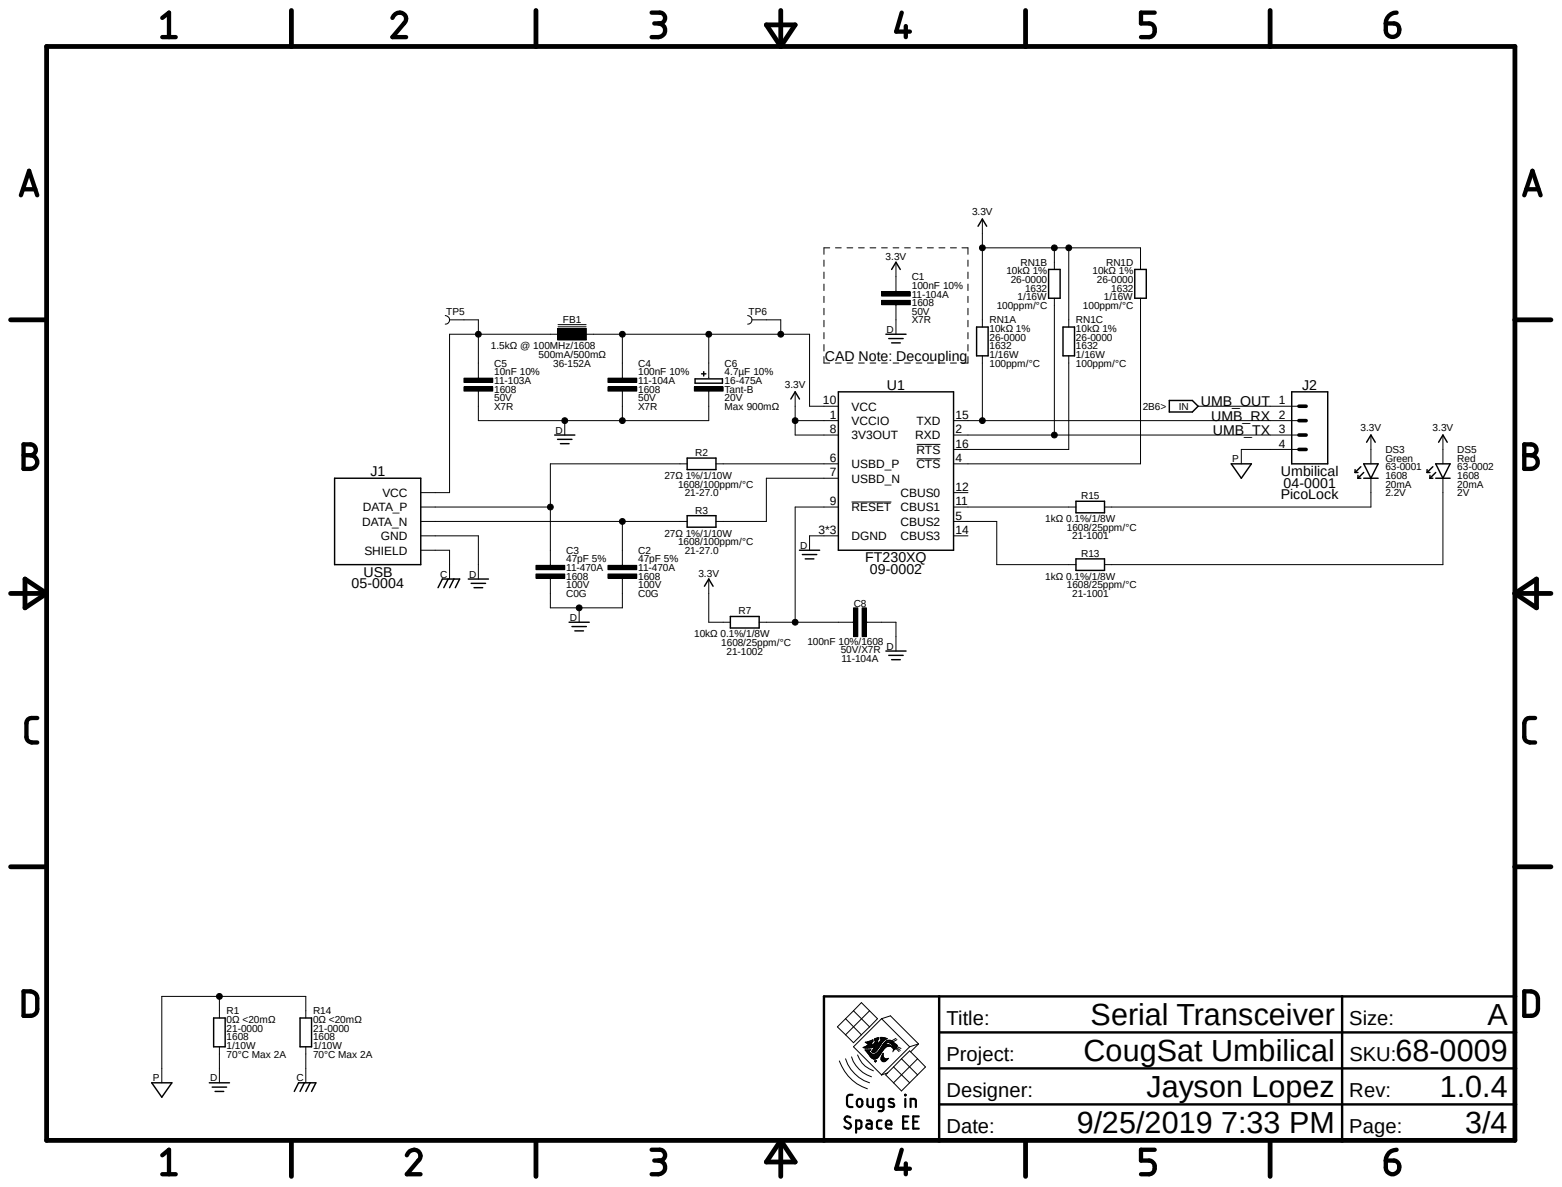
[picture p302: page 3]

Serial Transceiver Title: | A Size:
CougSat Umbilical Project: | 68-0009 SKU:
Jayson Lopez Designer: | 1.0.4 Rev:

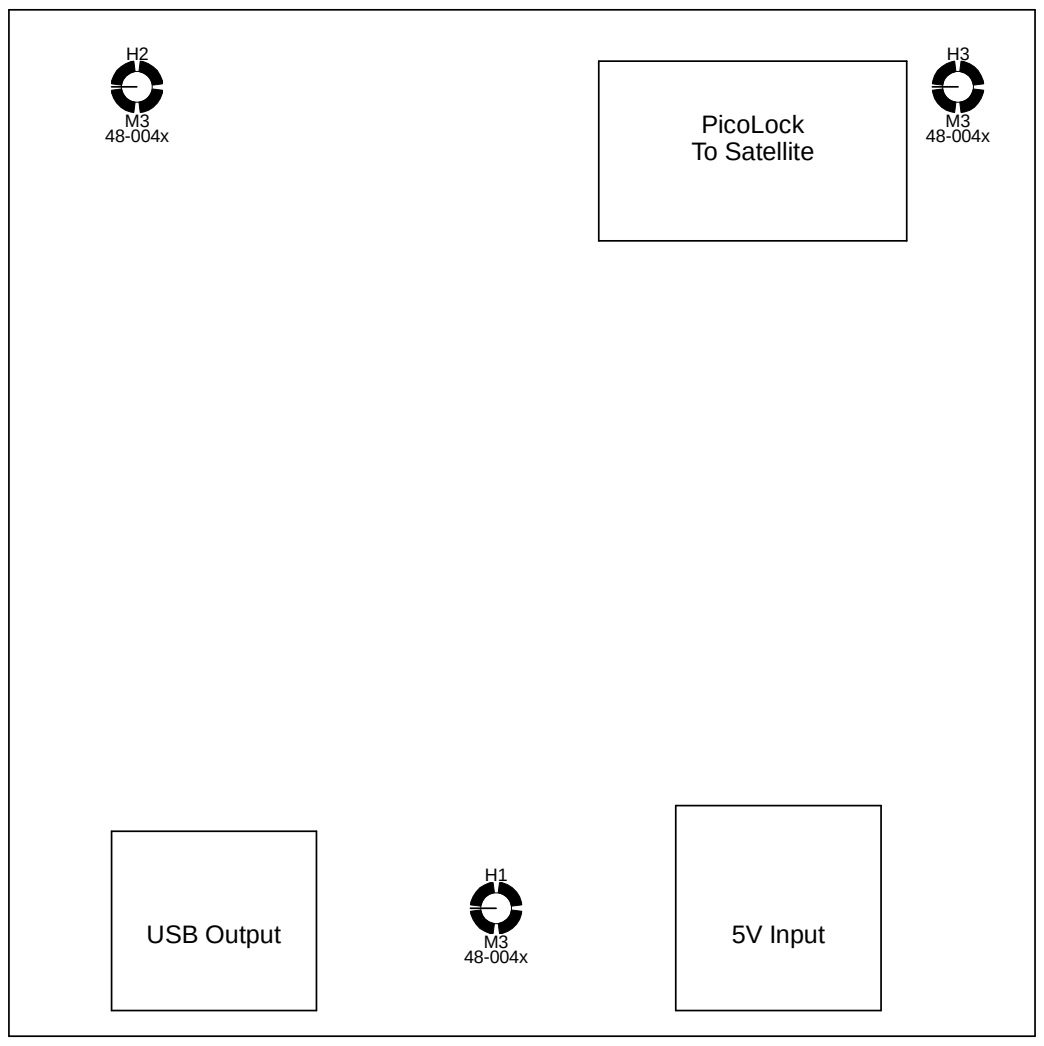
[picture p303: page 4]
PicoLock To Satellite; USB Output; 5V Input 48-004x

Mechanical Title: | A Size:
CougSat Umbilical Project: | 68-0009 SKU:
Jayson Lopez Designer: | 1.0.4 Rev:
