CougsInSpace/CougSat1-Hardware/CougSat1-GroundStation/Documentation/GroundStation.pdf

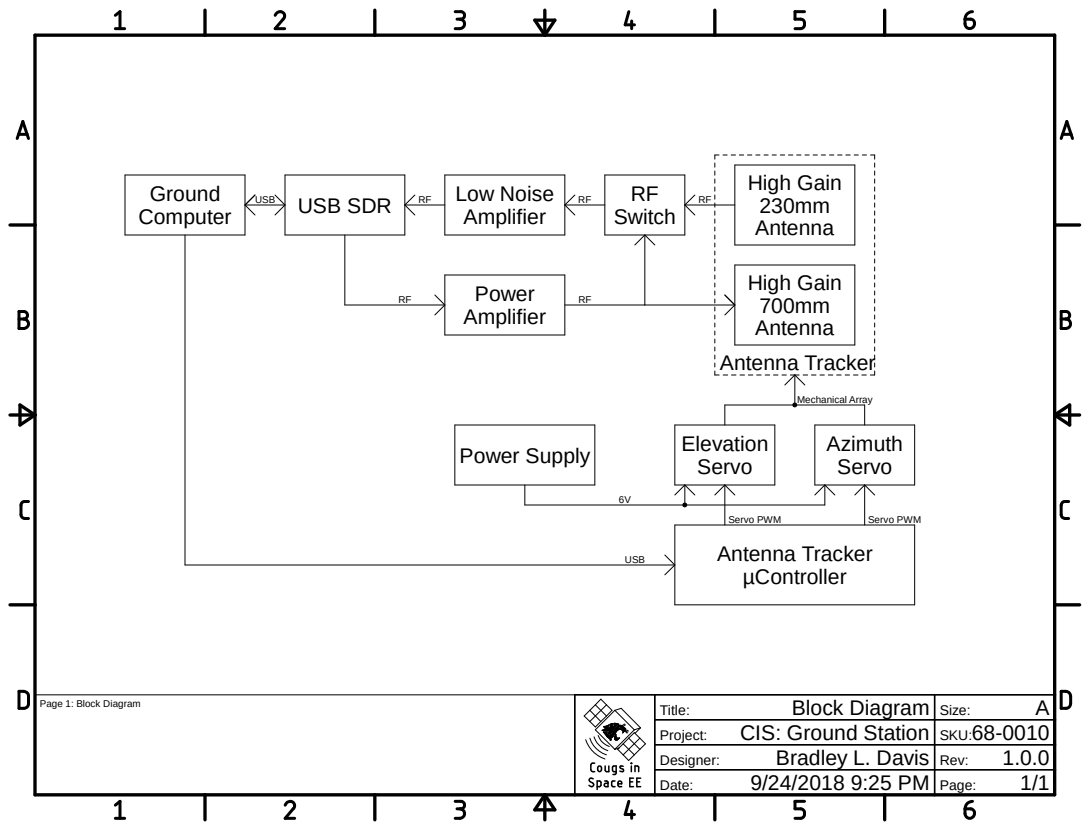
[picture p304: page 1]
Antenna Tracker; USB; Mechanical Array; Servo PWM; Ground; Computer; USB SDR; Power Amplifier; High Gain 230mm Antenna; High Gain 700mm Antenna; RF Switch; Low Noise Amplifier; Elevation Servo; Azimuth Servo; Antenna Tracker µController; Power Supply

Page 1: Block Diagram | Block Diagram Title: | A Size:

CIS: Ground Station Project: | 68-0010 SKU:
Bradley L. Davis Designer: | 1.0.0 Rev:
9/24/2018 9:25 PM Date: | 1/1 Page:
