CougsInSpace/CougSat1-Hardware/CougSat1-Structure/Documentation/Drawings/Structure.PDF

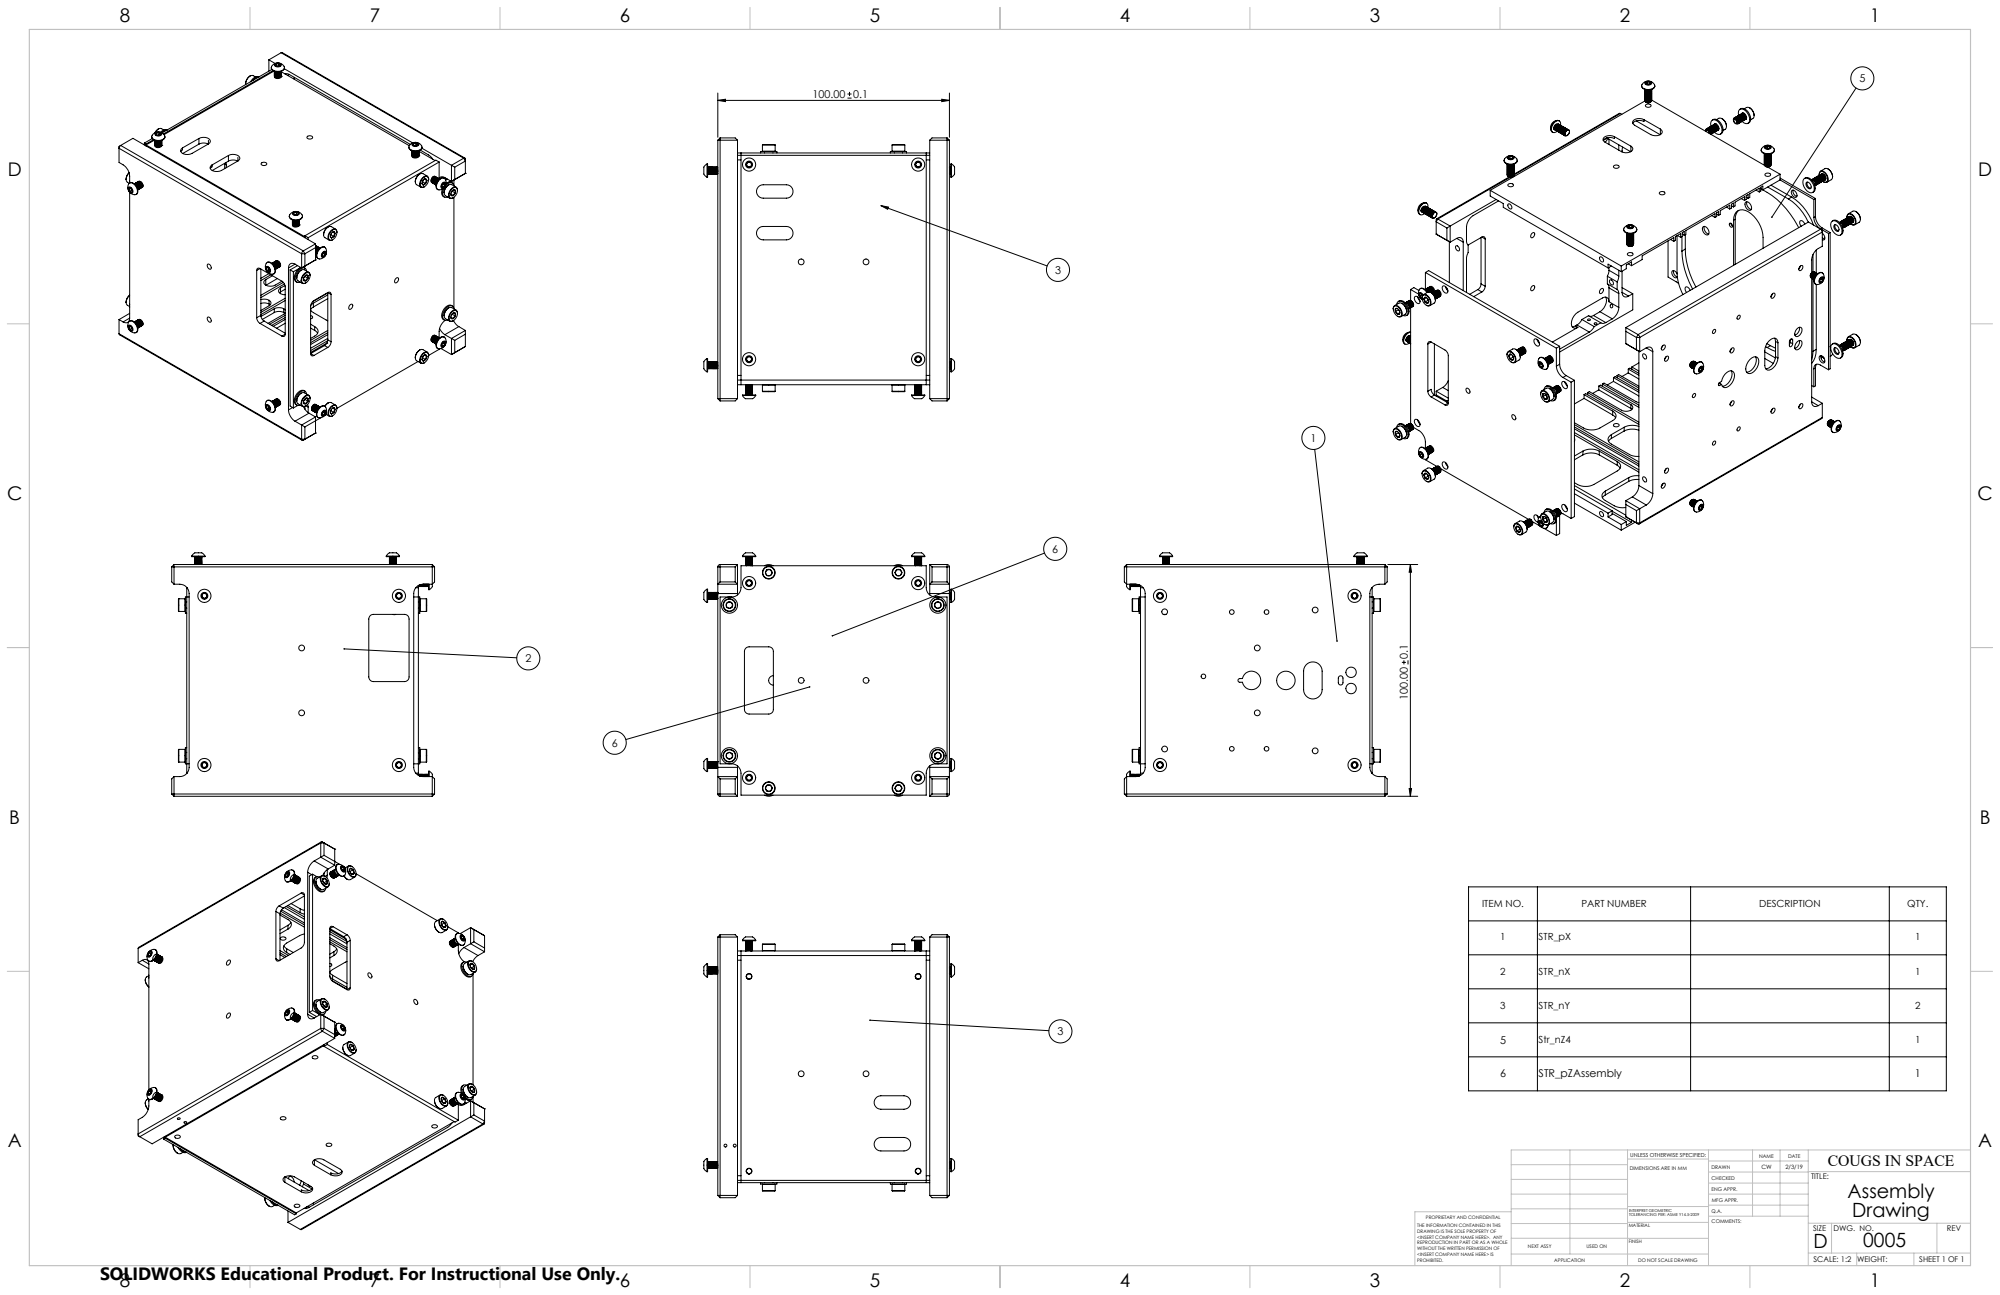
[picture p305: page 1]

ITEM NO. | PART NUMBER | DESCRIPTION | QTY.

1 | STR_pX | | 1

2 | STR_nX | | 1

3 | STR_nY | | 2

5 | Str_nZ4 | | 1

6 | STR_pZAssembly | | 1

UNLESS OTHERWISE SPECIFIED: | | | DATE | COUGS IN SPACE NAME
DIMENSIONS ARE IN MM | DRAWN | CW | 2/3/19

CHECKED | | | TITLE: Assembly Drawing

ENG APPR.
MFG APPR.

INTERPRET GEOMETRIC TOLERANCING PER: ASME Y14.5-2009 | Q.A.
MATERIAL | | SIZE D | DWG. NO. 0005 | REV

PROPRIETARY AND CONFIDENTIAL
THE INFORMATION CONTAINED IN THIS
DRAWING IS THE SOLE PROPERTY OF
<INSERT COMPANY NAME HERE>. ANY
REPRODUCTION IN PART OR AS A WHOLE
WITHOUT THE WRITTEN PERMISSION OF
<INSERT COMPANY NAME HERE> IS
PROHIBITED.

NEXT ASSY | USED ON | FINISH

SOLIDWORKS Educational Product. For Instructional Use Only.

APPLICATION | DO NOT SCALE DRAWING | | SCALE: 1:2 | WEIGHT: | SHEET 1 OF 1
