CougsInSpace/CougSat1-Hardware/CougSat1-Structure/Documentation/Drawings/Structure_MagnetorquerStandoff.PDF

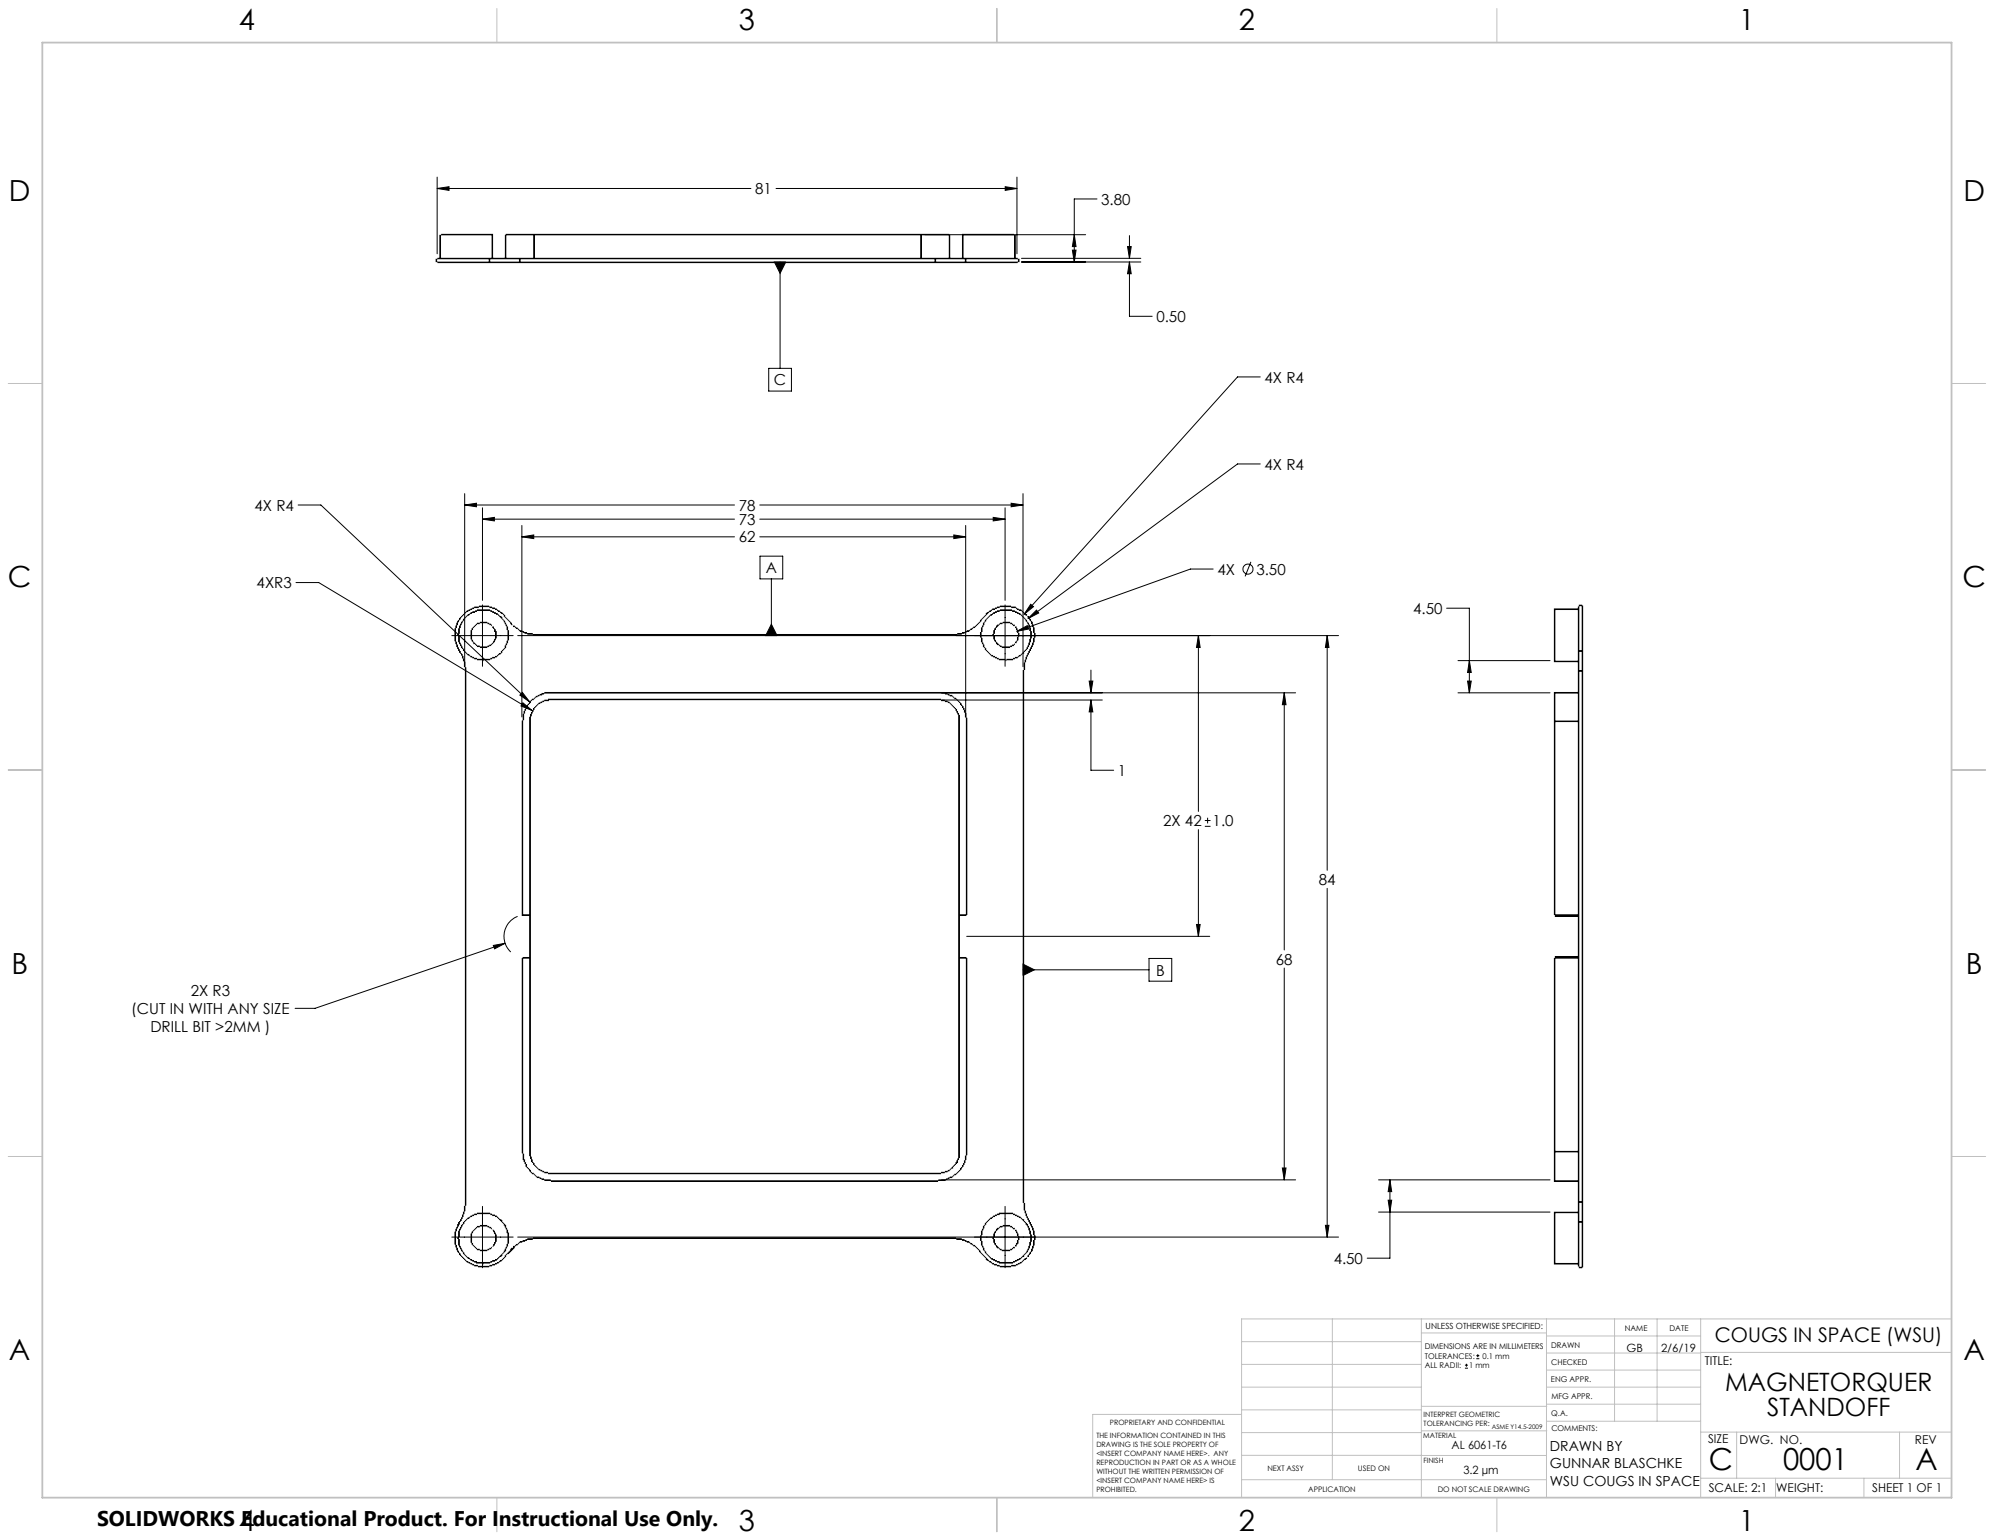
[picture p306: page 1]

(CUT IN WITH ANY SIZE
DRILL BIT >2MM )

UNLESS OTHERWISE SPECIFIED: | | NAME | DATE | COUGS IN SPACE (WSU)
DIMENSIONS ARE IN MILLIMETERS TOLERANCES: 0.1 mm ALL RADII: 1 mm | DRAWN | GB | 2/6/19

CHECKED | | | TITLE: MAGNETORQUER STANDOFF

ENG APPR.
MFG APPR.

INTERPRET GEOMETRIC TOLERANCING PER: ASME Y14.5-2009 | Q.A.
MATERIAL AL 6061-T6 | | SIZE C | DWG. NO. 0001 | REV A

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

COMMENTS:
DRAWN BY
GUNNAR BLASCHKE
WSU COUGS IN SPACE

NEXT ASSY | USED ON | FINISH 3.2 µm

APPLICATION | DO NOT SCALE DRAWING | | SCALE: 2:1 | WEIGHT: | SHEET 1 OF 1

SOLIDWORKS Educational Product. For Instructional Use Only.
