CougsInSpace/CougSat1-Hardware/CougSat1-Structure/Documentation/Drawings/Structure_nX.PDF

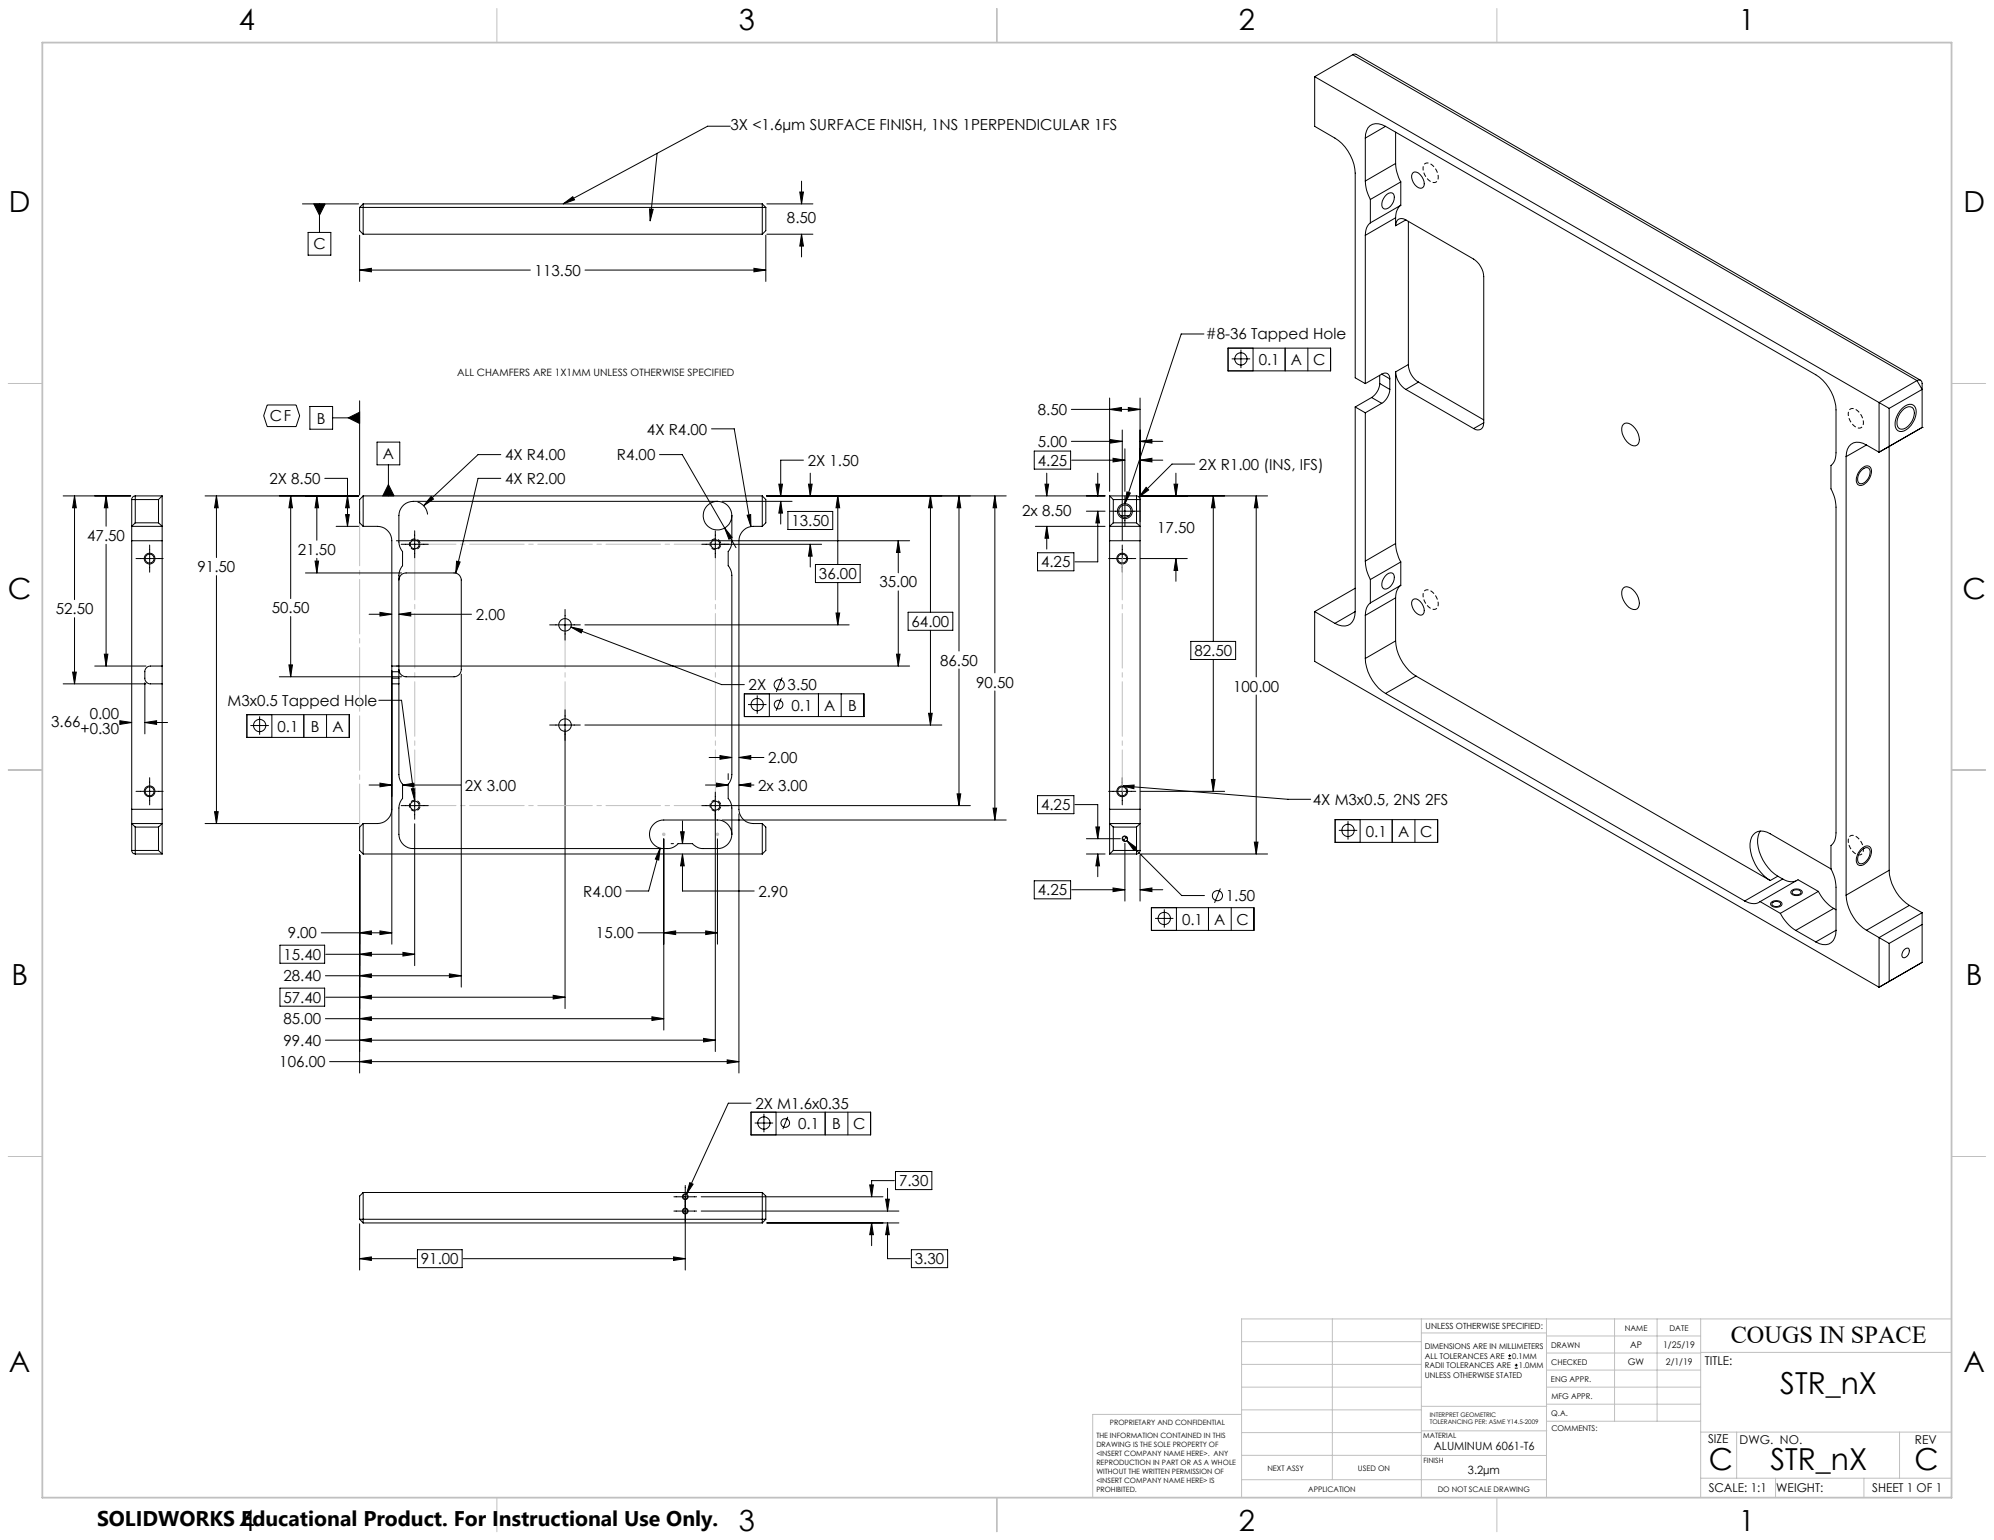
[picture p307: page 1]
M3x0.5 Tapped Hole; 3X <1.6µm SURFACE FINISH, 1NS 1PERPENDICULAR 1FS; 2X R1.00 (INS, IFS); #8-36 Tapped Hole

ALL CHAMFERS ARE 1X1MM UNLESS OTHERWISE SPECIFIED

UNLESS OTHERWISE SPECIFIED: | | | DATE | COUGS IN SPACE NAME
DIMENSIONS ARE IN MILLIMETERS ALL TOLERANCES ARE 0.1MM RADII TOLERANCES ARE 1.0MM UNLESS OTHERWISE STATED | DRAWN | AP | 1/25/19

CHECKED | GW | 2/1/19 | TITLE: STR_nX

ENG APPR.
MFG APPR.

INTERPRET GEOMETRIC TOLERANCING PER: ASME Y14.5-2009 | Q.A.
MATERIAL ALUMINUM 6061-T6 | | SIZE C | DWG. NO. STR_nX | REV C

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

NEXT ASSY | USED ON | 3.2µm FINISH

APPLICATION | DO NOT SCALE DRAWING | | SCALE: 1:1 | WEIGHT: | SHEET 1 OF 1

SOLIDWORKS Educational Product. For Instructional Use Only.
