CougsInSpace/CougSat1-Hardware/CougSat1-Structure/Documentation/Drawings/Structure_nY.PDF

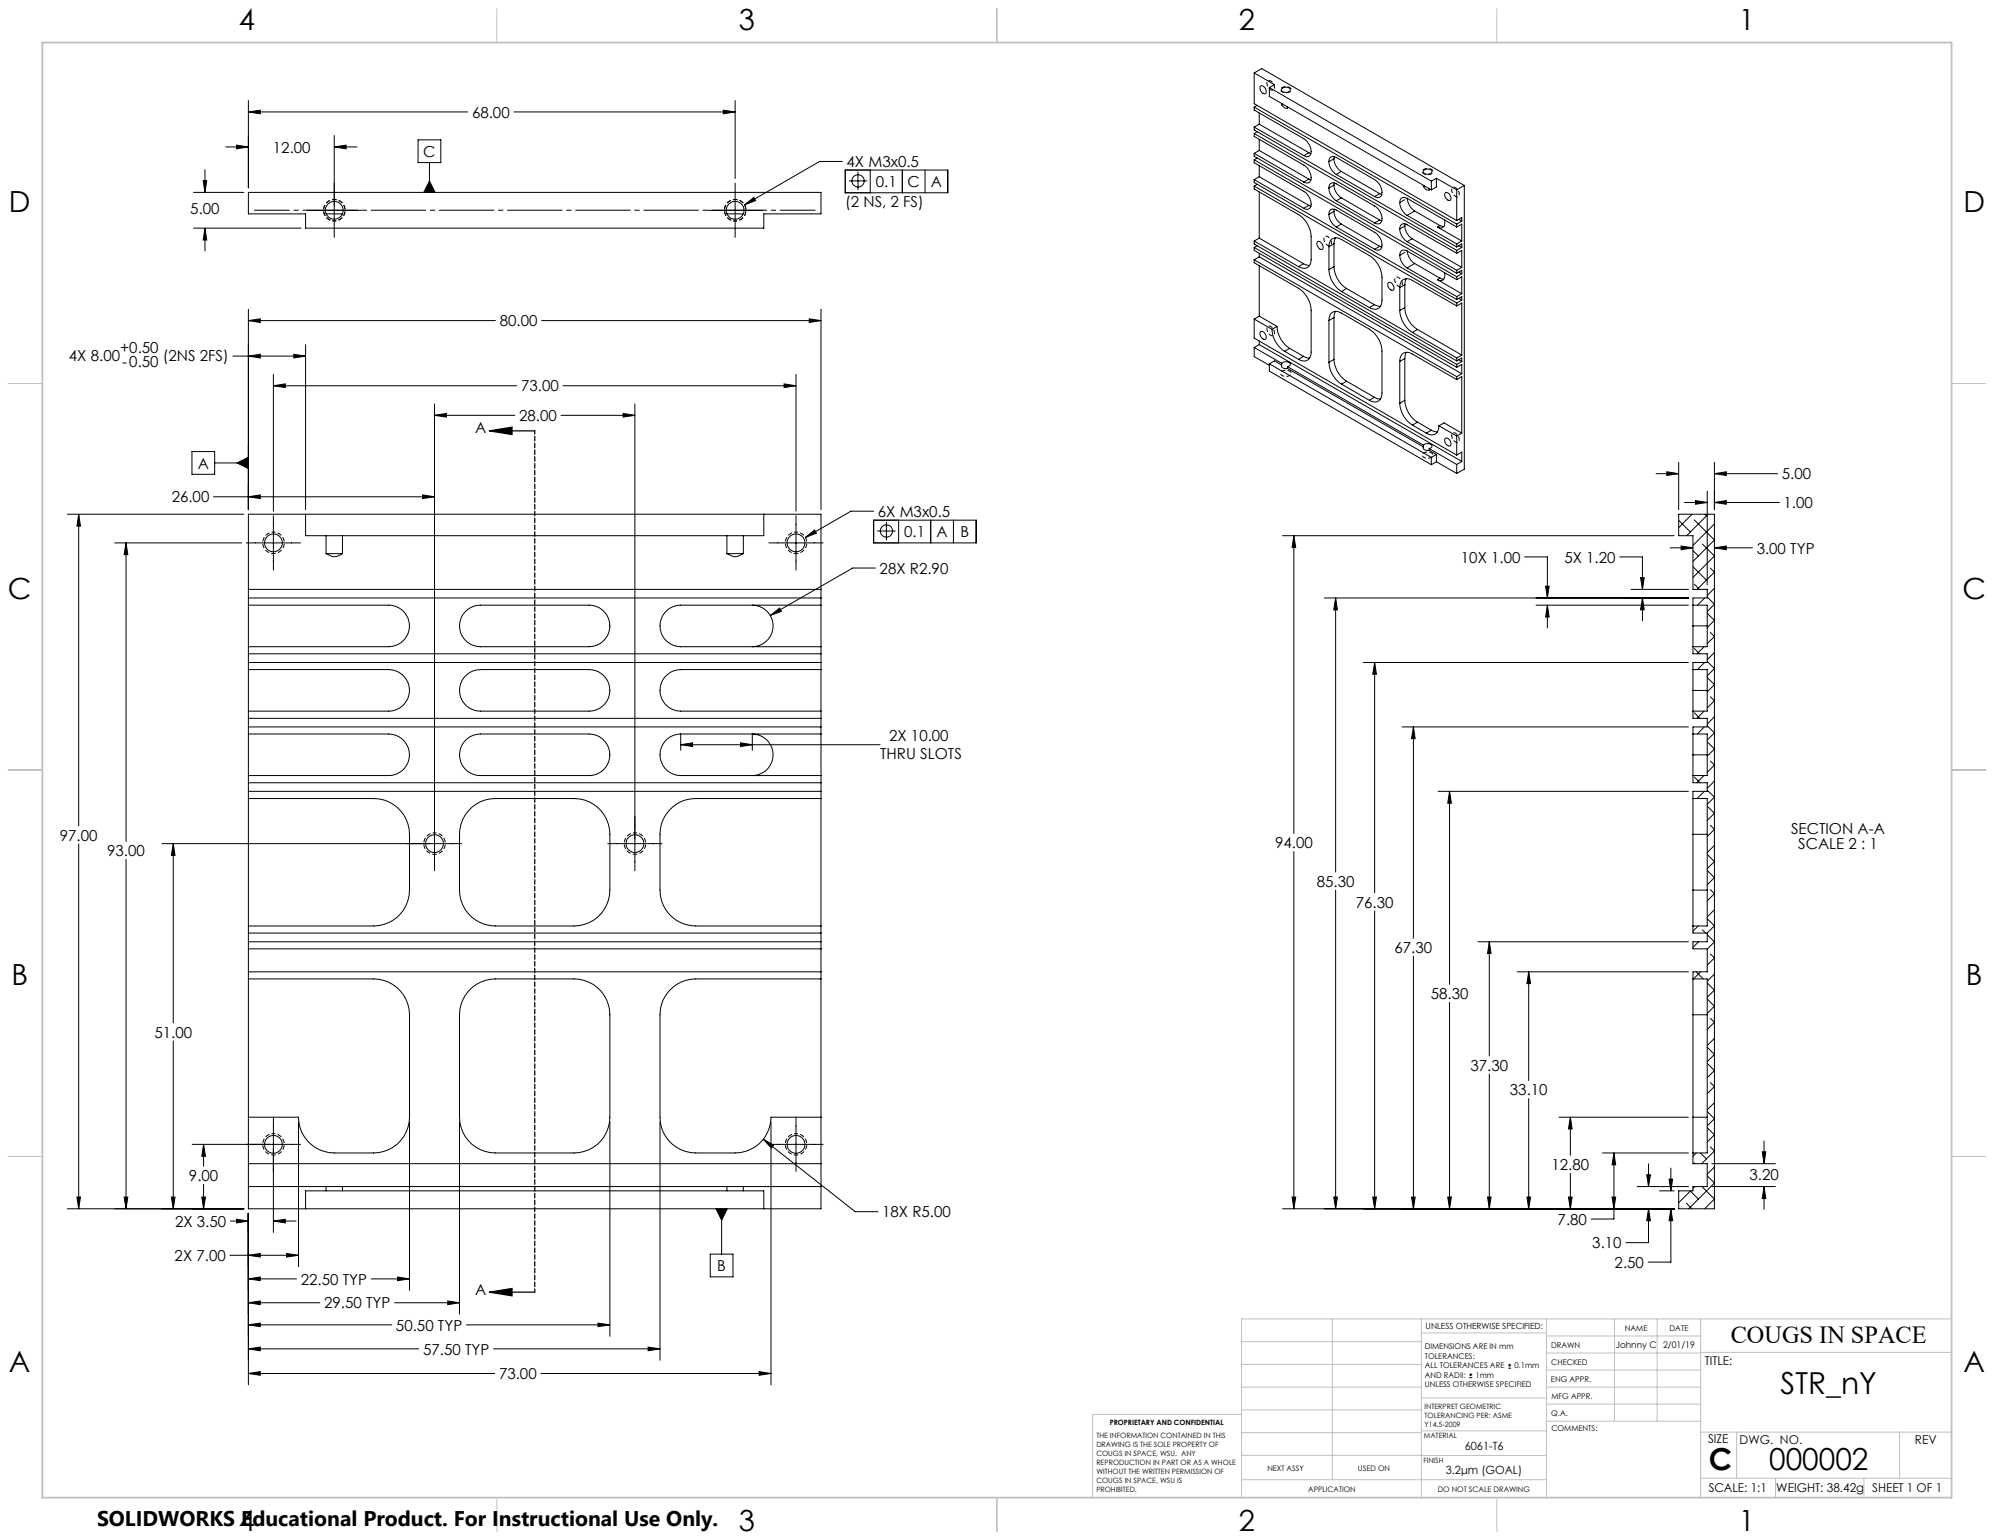
[picture p308: page 1]
29.50 TYP; 57.50 TYP; 50.50 TYP; 22.50 TYP; 2X 10.00 THRU SLOTS; 3.00 TYP; SECTION A-A SCALE 2 : 1

UNLESS OTHERWISE SPECIFIED: | | | DATE | COUGS IN SPACE NAME
DIMENSIONS ARE IN mm TOLERANCES: ALL TOLERANCES ARE 0.1mm AND RADII: 1mm UNLESS OTHERWISE SPECIFIED | DRAWN | Johnny C | 2/01/19

CHECKED | | | TITLE: STR_nY

ENG APPR.
MFG APPR.
Q.A.

INTERPRET GEOMETRIC
TOLERANCING PER: ASME

PROPRIETARY AND CONFIDENTIAL
THE INFORMATION CONTAINED IN THIS
DRAWING IS THE SOLE PROPERTY OF
COUGS IN SPACE, WSU. ANY
REPRODUCTION IN PART OR AS A WHOLE
WITHOUT THE WRITTEN PERMISSION OF
COUGS IN SPACE, WSU IS
PROHIBITED.

MATERIAL 6061-T6 | | SIZE C | DWG. NO. 000002 | REV

NEXT ASSY | USED ON | 3.2μm (GOAL) FINISH

APPLICATION | DO NOT SCALE DRAWING | | SCALE: 1:1 | WEIGHT: 38.42g | SHEET 1 OF 1

SOLIDWORKS Educational Product. For Instructional Use Only.
