CougsInSpace/CougSat1-Hardware/CougSat1-Structure/Documentation/Drawings/Structure_nZ.PDF

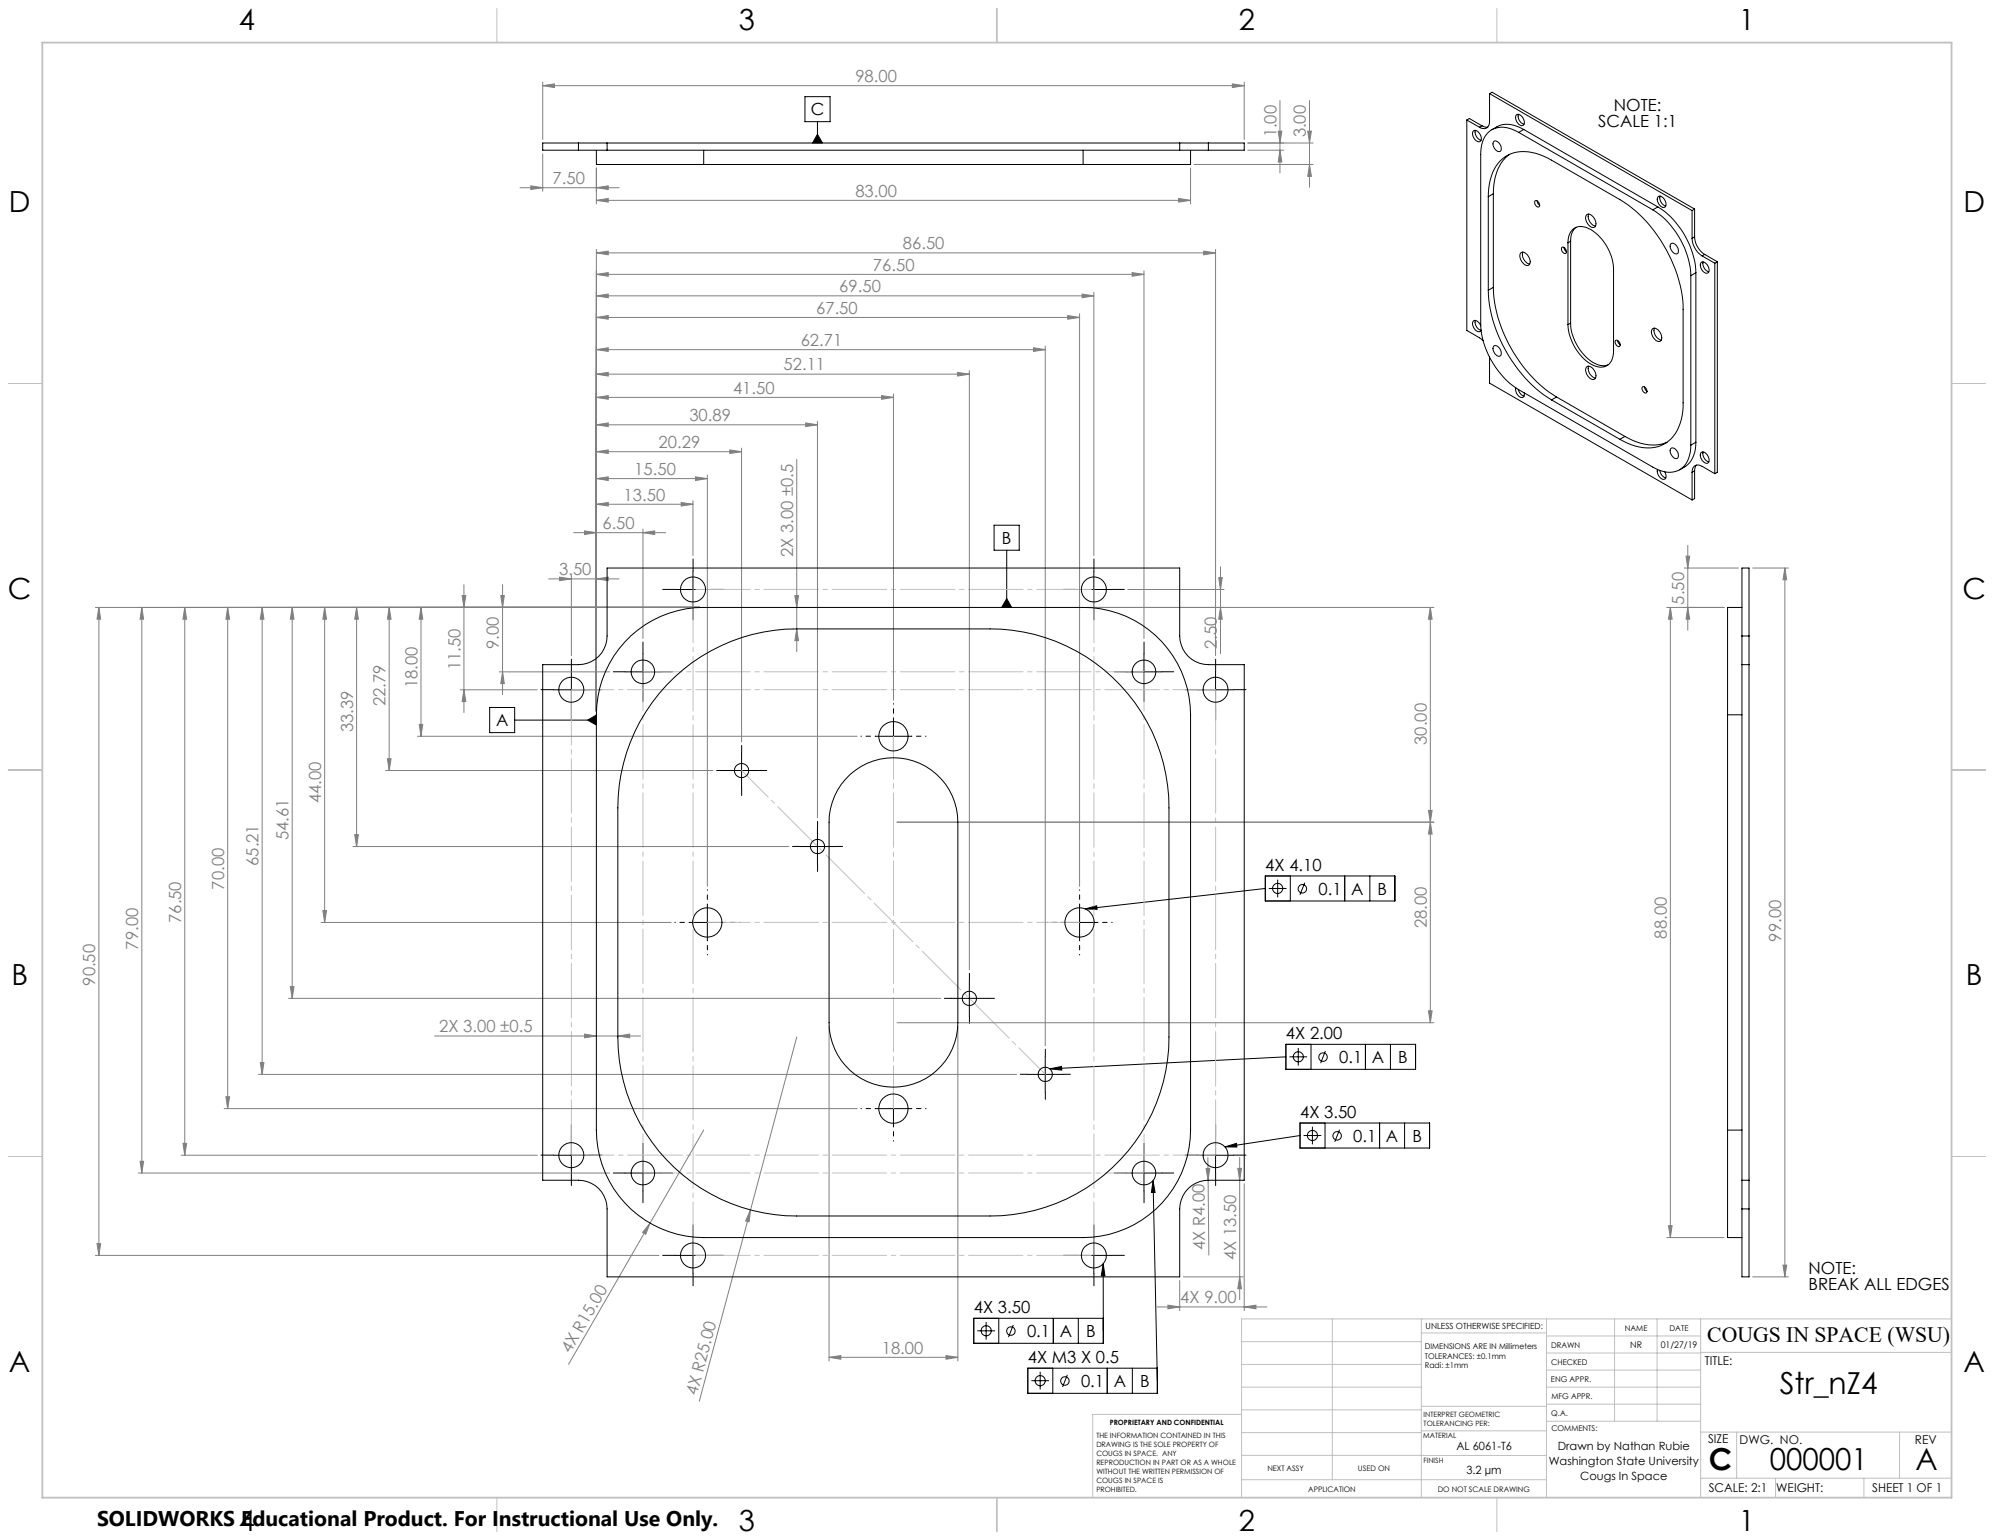
[picture p309: page 1]
SCALE 1:1

NOTE:
BREAK ALL EDGES

UNLESS OTHERWISE SPECIFIED: | | | DATE | COUGS IN SPACE (WSU) NAME
DIMENSIONS ARE IN Millimeters TOLERANCES: ±0.1mm Radi: ±1mm | DRAWN | NR | 01/27/19

CHECKED | | | TITLE: Str_nZ4

ENG APPR.
MFG APPR.

INTERPRET GEOMETRIC TOLERANCING PER: | Q.A.
MATERIAL AL 6061-T6 | | SIZE C | DWG. NO. 000001 | REV A

PROPRIETARY AND CONFIDENTIAL
THE INFORMATION CONTAINED IN THIS
DRAWING IS THE SOLE PROPERTY OF
COUGS IN SPACE. ANY
REPRODUCTION IN PART OR AS A WHOLE
WITHOUT THE WRITTEN PERMISSION OF
COUGS IN SPACE IS
PROHIBITED.

COMMENTS:
Drawn by Nathan Rubie
Washington State University
Cougs In Space

NEXT ASSY | USED ON | 3.2 µm FINISH

APPLICATION | DO NOT SCALE DRAWING | | SCALE: 2:1 | WEIGHT: | SHEET 1 OF 1

SOLIDWORKS Educational Product. For Instructional Use Only.
