CougsInSpace/CougSat1-Hardware/CougSat1-Structure/Documentation/Drawings/Structure_pX.PDF

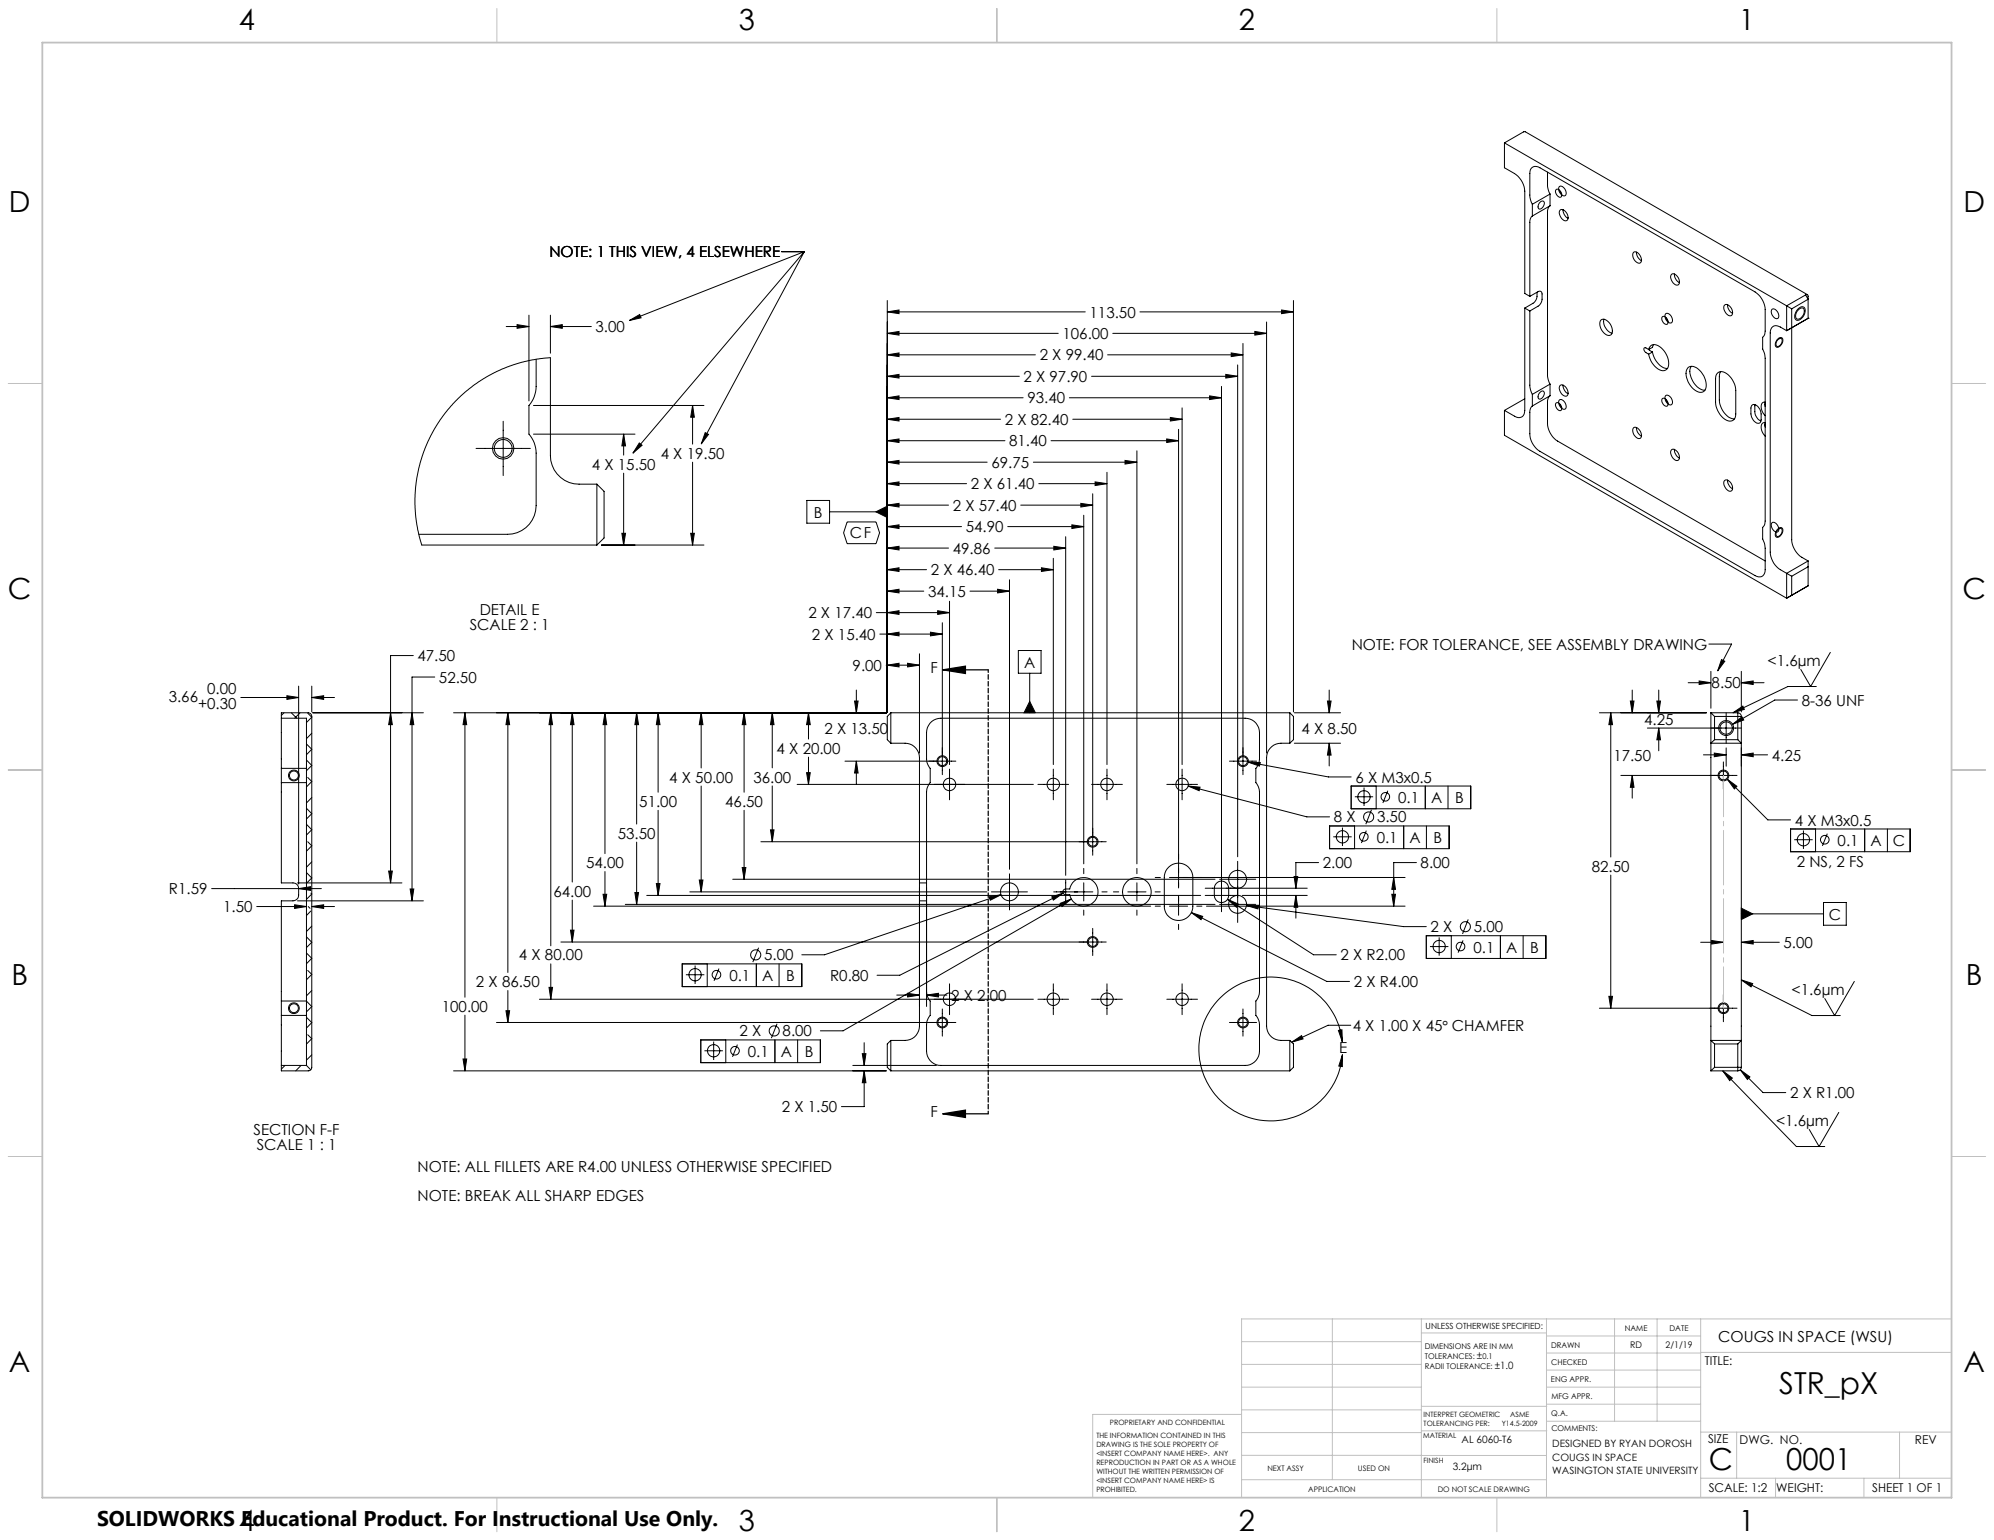
[picture p310: page 1]
4 X 1.00 X 45° CHAMFER; 8-36 UNF; DETAIL E SCALE 2 : 1; SECTION F-F SCALE 1 : 1

NOTE: 1 THIS VIEW, 4 ELSEWHERE

NOTE: FOR TOLERANCE, SEE ASSEMBLY DRAWING

NOTE: ALL FILLETS ARE R4.00 UNLESS OTHERWISE SPECIFIED
NOTE: BREAK ALL SHARP EDGES

UNLESS OTHERWISE SPECIFIED: | | NAME | DATE | COUGS IN SPACE (WSU)
DIMENSIONS ARE IN MM TOLERANCES: ±0.1 RADII TOLERANCE: ±1.0 | DRAWN | RD | 2/1/19

CHECKED | | | TITLE: STR_pX

ENG APPR.
MFG APPR.

INTERPRET GEOMETRIC ASME TOLERANCING PER: Y14.5-2009 | Q.A.
MATERIAL AL 6060-T6 | | SIZE C | DWG. NO. 0001 | REV

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

COMMENTS:
DESIGNED BY RYAN DOROSH
COUGS IN SPACE
WASINGTON STATE UNIVERSITY

NEXT ASSY | USED ON | FINISH 3.2µm

APPLICATION | DO NOT SCALE DRAWING | | SCALE: 1:2 | WEIGHT: | SHEET 1 OF 1

SOLIDWORKS Educational Product. For Instructional Use Only.
