CougsInSpace/CougSat1-Hardware/CougSat1-Structure/Documentation/Drawings/Structure_pZ.PDF

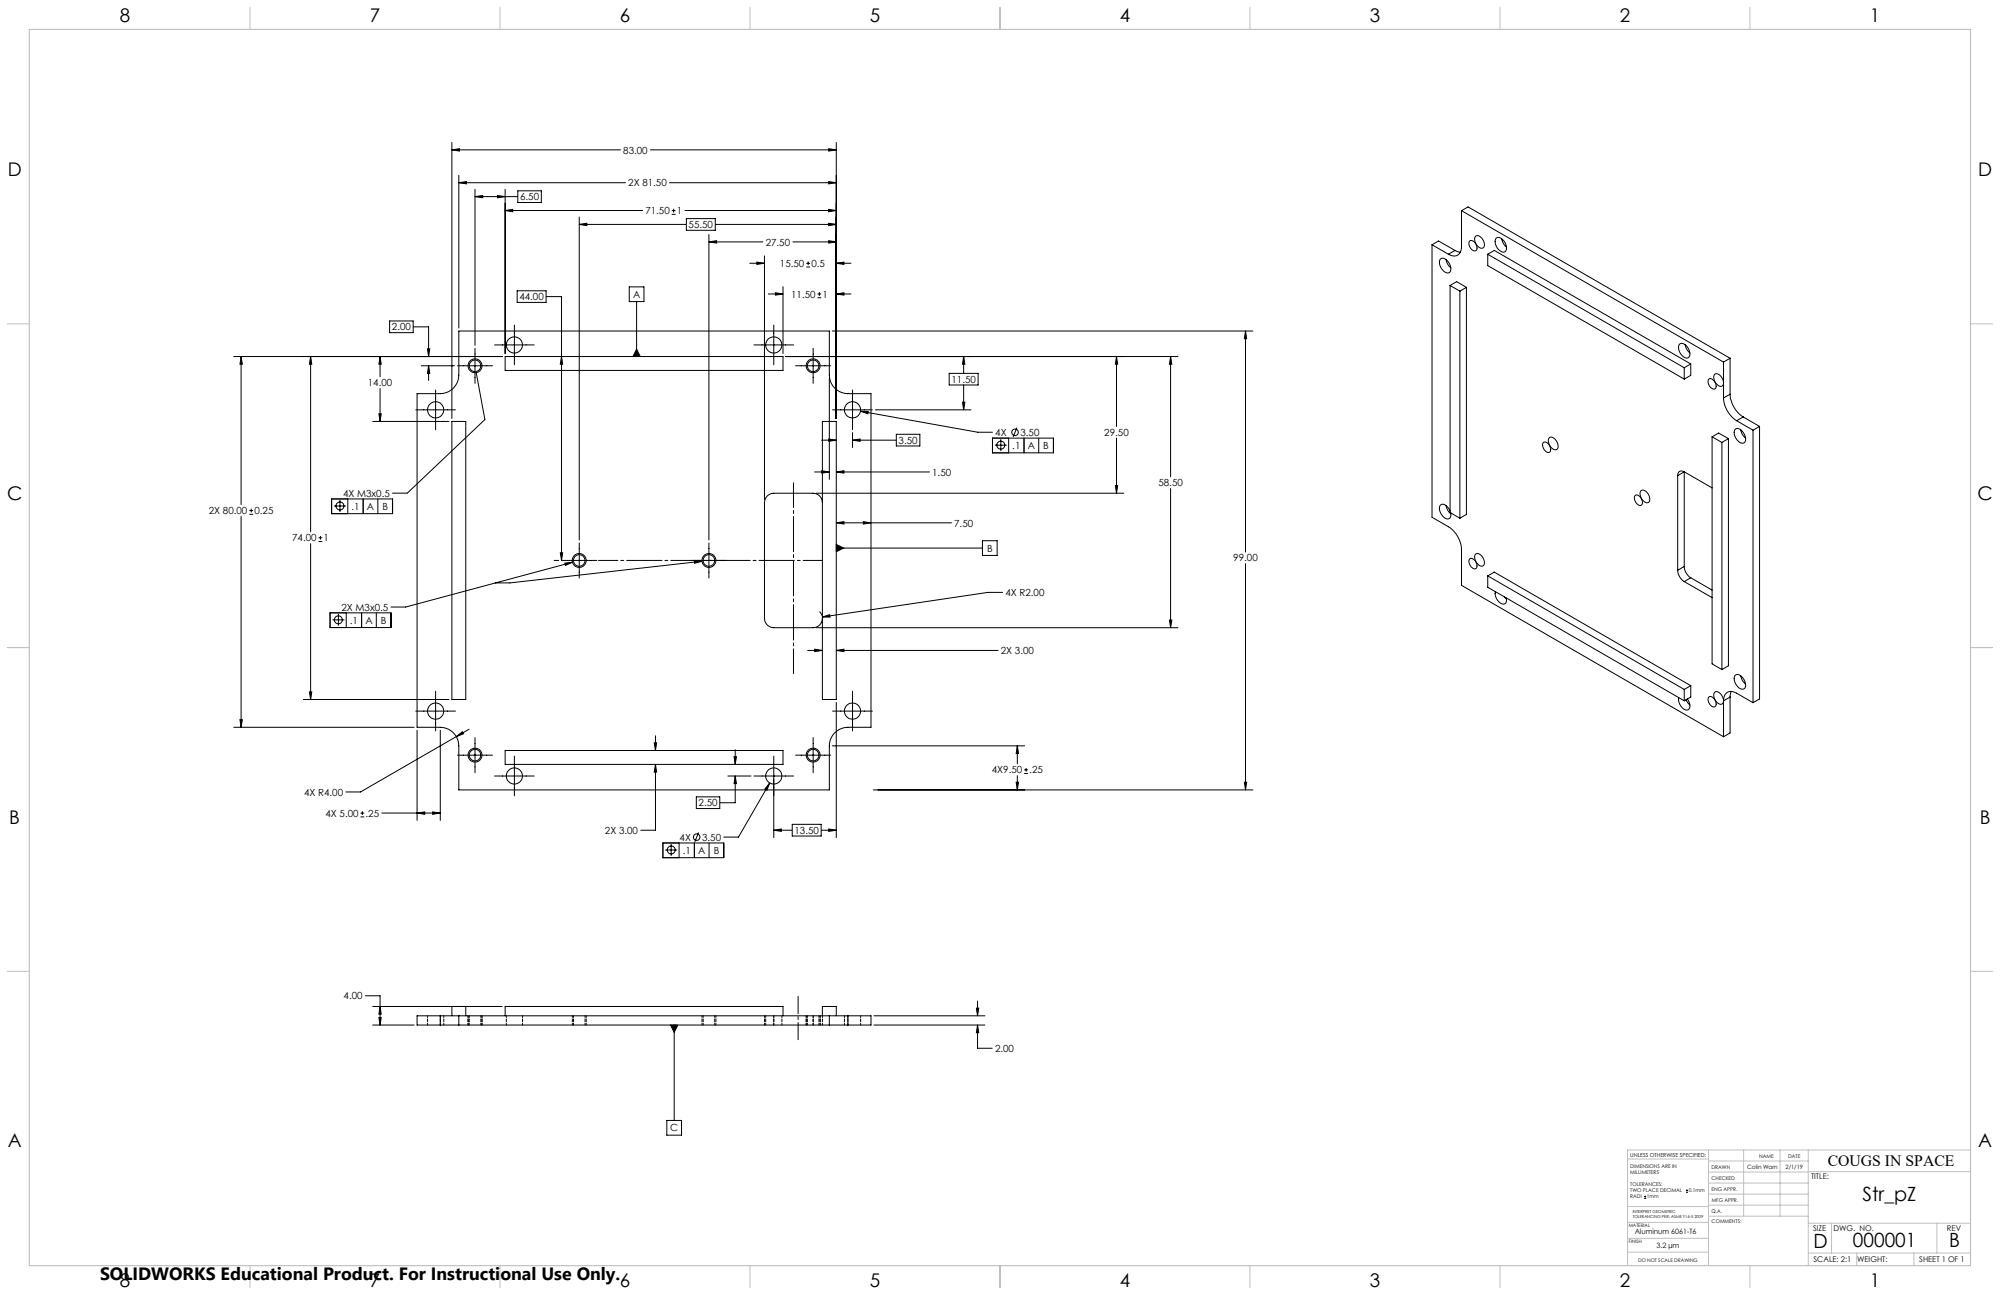
[picture p311: page 1]
Aluminum 6061-T6; SHEET 1 OF 1; SCALE: 2:1; WEIGHT:; DWG. NO.; REV; 3.2 µm FINISH

UNLESS OTHERWISE SPECIFIED: | | | DATE | COUGS IN SPACE NAME
DIMENSIONS ARE IN MILLIMETERS TOLERANCES: TWO PLACE DECIMAL 0.1mm RADI 1mm | DRAWN | Colin Warn | 2/1/19

CHECKED | | | TITLE: Str_pZ

ENG APPR.
MFG APPR.

INTERPRET GEOMETRIC TOLERANCING PER: ASME Y14-5 2009 | Q.A.

SOLIDWORKS Educational Product. For Instructional Use Only.

DO NOT SCALE DRAWING
