CougsInSpace/CougSat1-Hardware/CougSat1-Structure/Documentation/Drawings/Structure_SolarHeatSinkStandoff.PDF

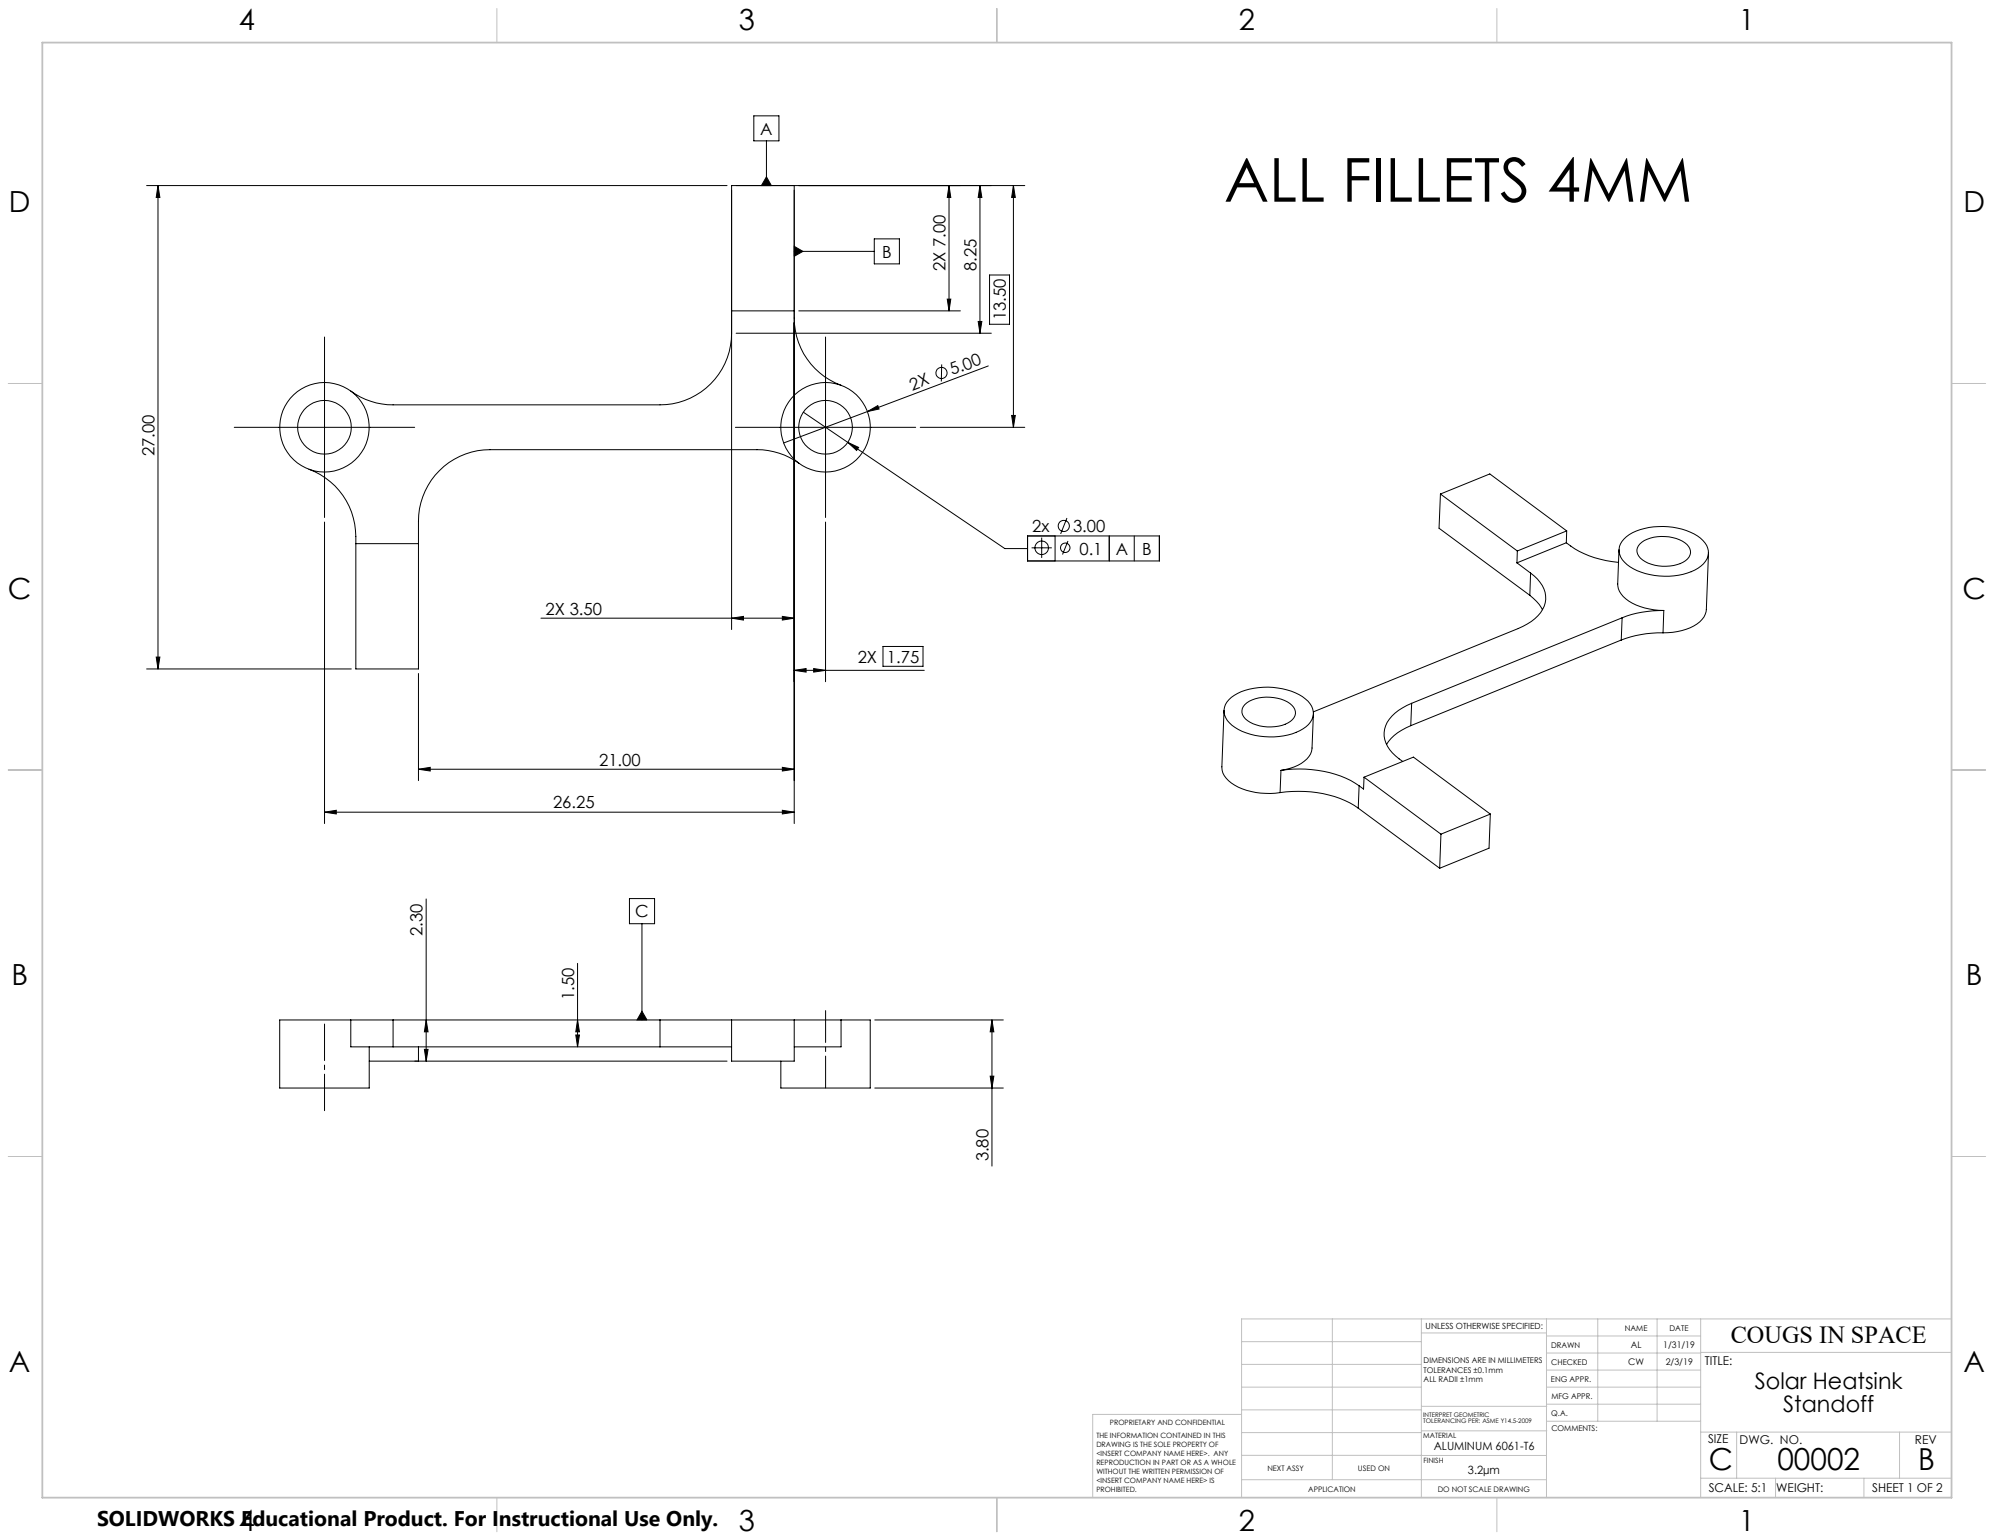
[picture p312: page 1]
ALL FILLETS 4MM

UNLESS OTHERWISE SPECIFIED: | | | DATE | COUGS IN SPACE NAME
DIMENSIONS ARE IN MILLIMETERS TOLERANCES ±0.1mm ALL RADII ±1mm | DRAWN | AL | 1/31/19

CHECKED | CW | 2/3/19 | TITLE: Solar Heatsink Standoff

ENG APPR.
MFG APPR.

INTERPRET GEOMETRIC TOLERANCING PER: ASME Y14.5-2009 | Q.A.
MATERIAL ALUMINUM 6061-T6 | | SIZE C | DWG. NO. 00002 | REV B

PROPRIETARY AND CONFIDENTIAL
THE INFORMATION CONTAINED IN THIS
DRAWING IS THE SOLE PROPERTY OF
<INSERT COMPANY NAME HERE>. ANY
REPRODUCTION IN PART OR AS A WHOLE
WITHOUT THE WRITTEN PERMISSION OF
<INSERT COMPANY NAME HERE> IS
PROHIBITED.

NEXT ASSY | USED ON | 3.2µm FINISH

APPLICATION | DO NOT SCALE DRAWING | | SCALE: 5:1 | WEIGHT: | SHEET 1 OF 2

SOLIDWORKS Educational Product. For Instructional Use Only.

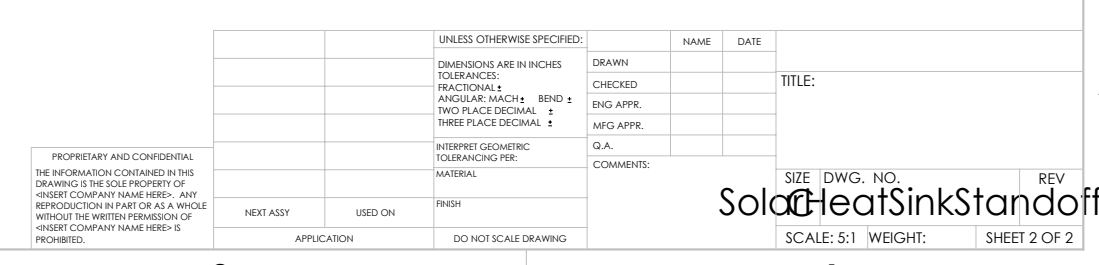
[picture p313: page 2]

UNLESS OTHERWISE SPECIFIED: | | NAME | DATE
DIMENSIONS ARE IN INCHES TOLERANCES: FRACTIONAL ANGULAR: MACH BEND TWO PLACE DECIMAL THREE PLACE DECIMAL | DRAWN

CHECKED | | | TITLE:

ENG APPR.
MFG APPR.

INTERPRET GEOMETRIC TOLERANCING PER: | Q.A.
MATERIAL | | SIZE C | DWG. NO. | REV

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

NEXT ASSY | USED ON | FINISH

APPLICATION | DO NOT SCALE DRAWING | | SCALE: 5:1 | WEIGHT: | SHEET 2 OF 2

SOLIDWORKS Educational Product. For Instructional Use Only.
