CougsInSpace/CougSat1-Hardware/CougSat1-Payload/Documentation/Payload-Germination.pdf

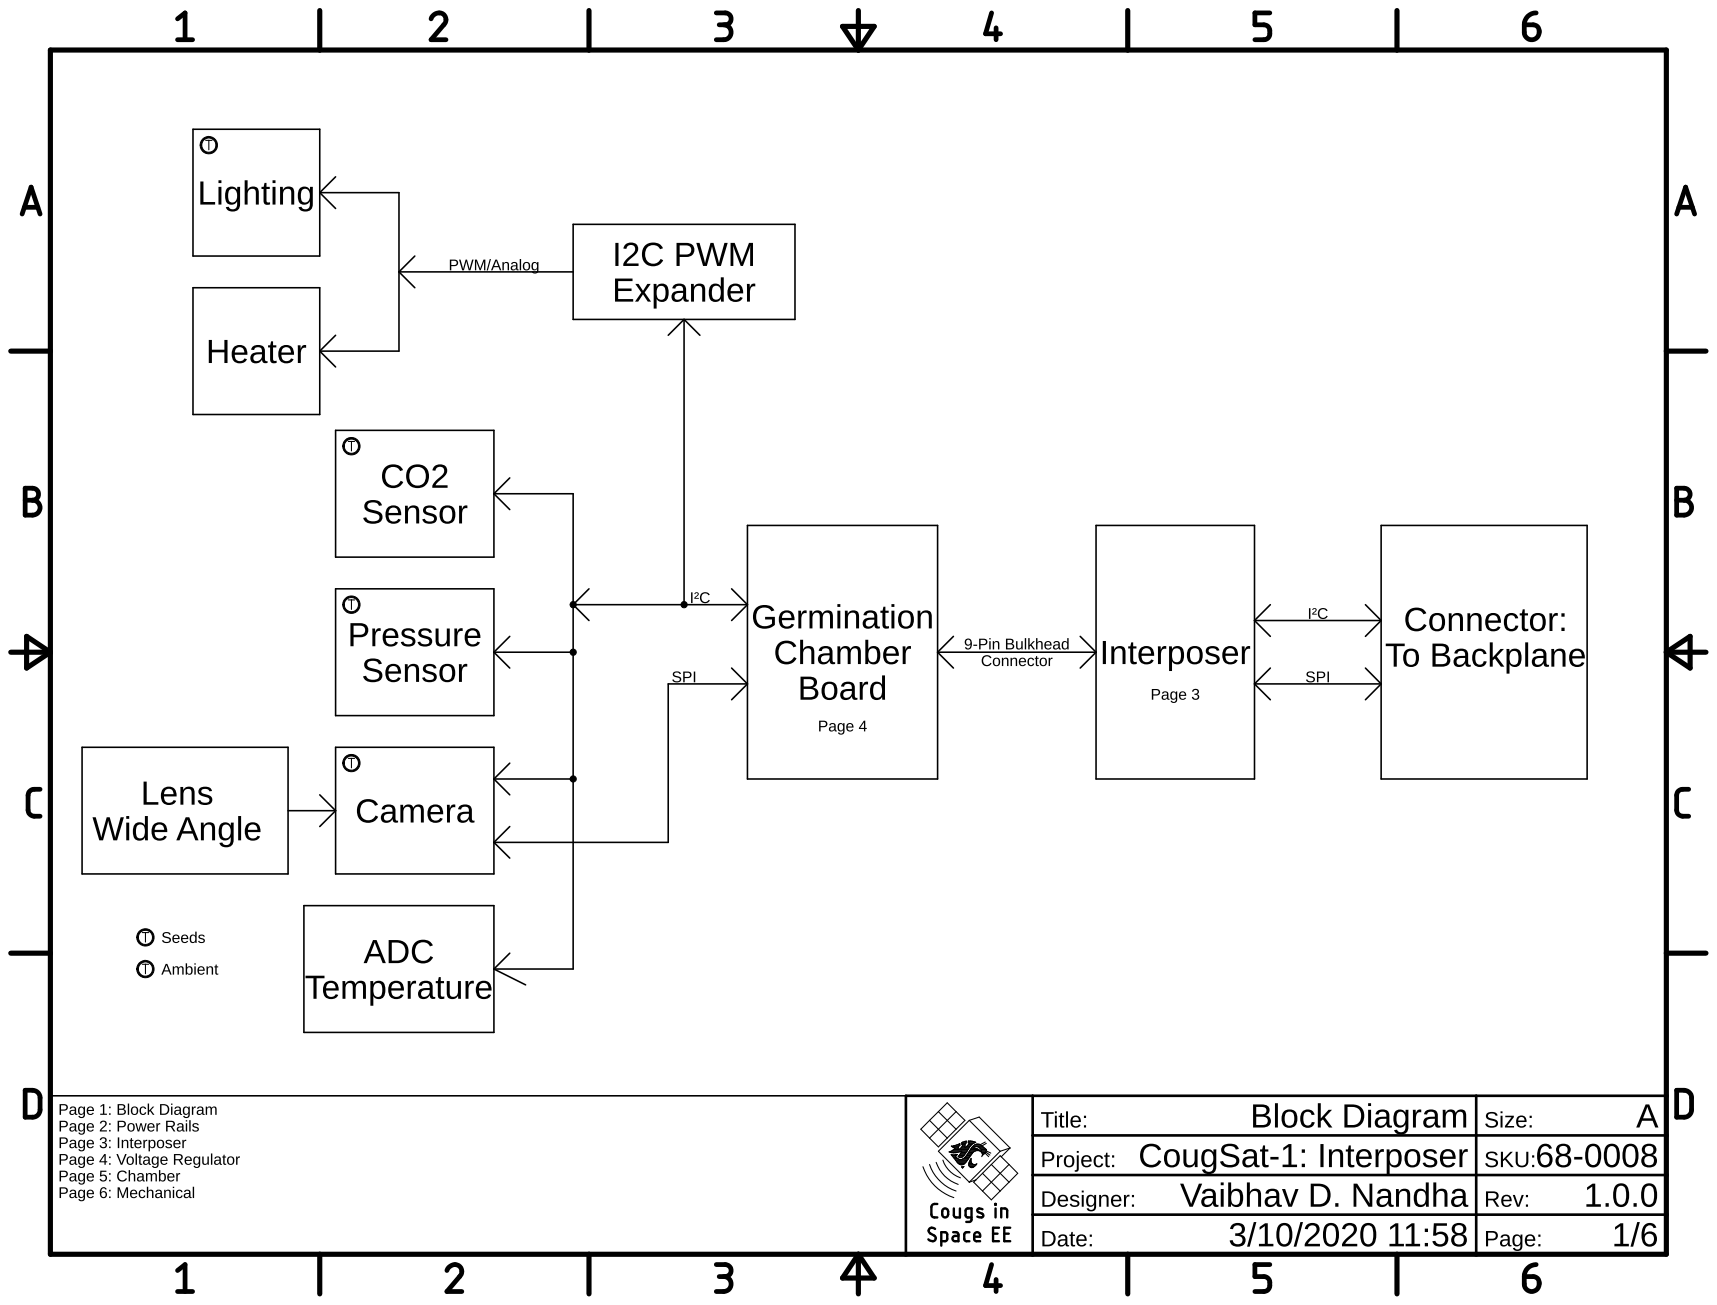
[picture p314: page 1]

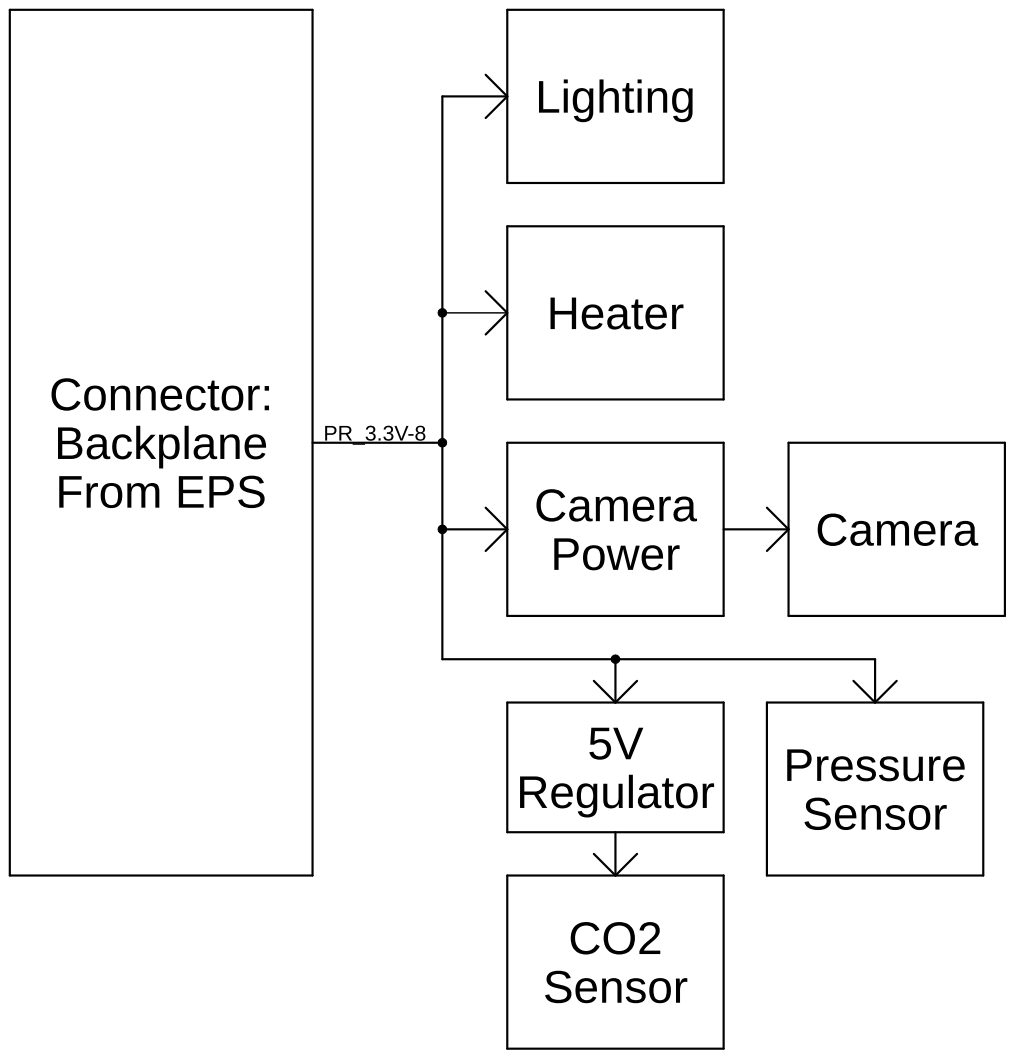
[picture p315: page 2]

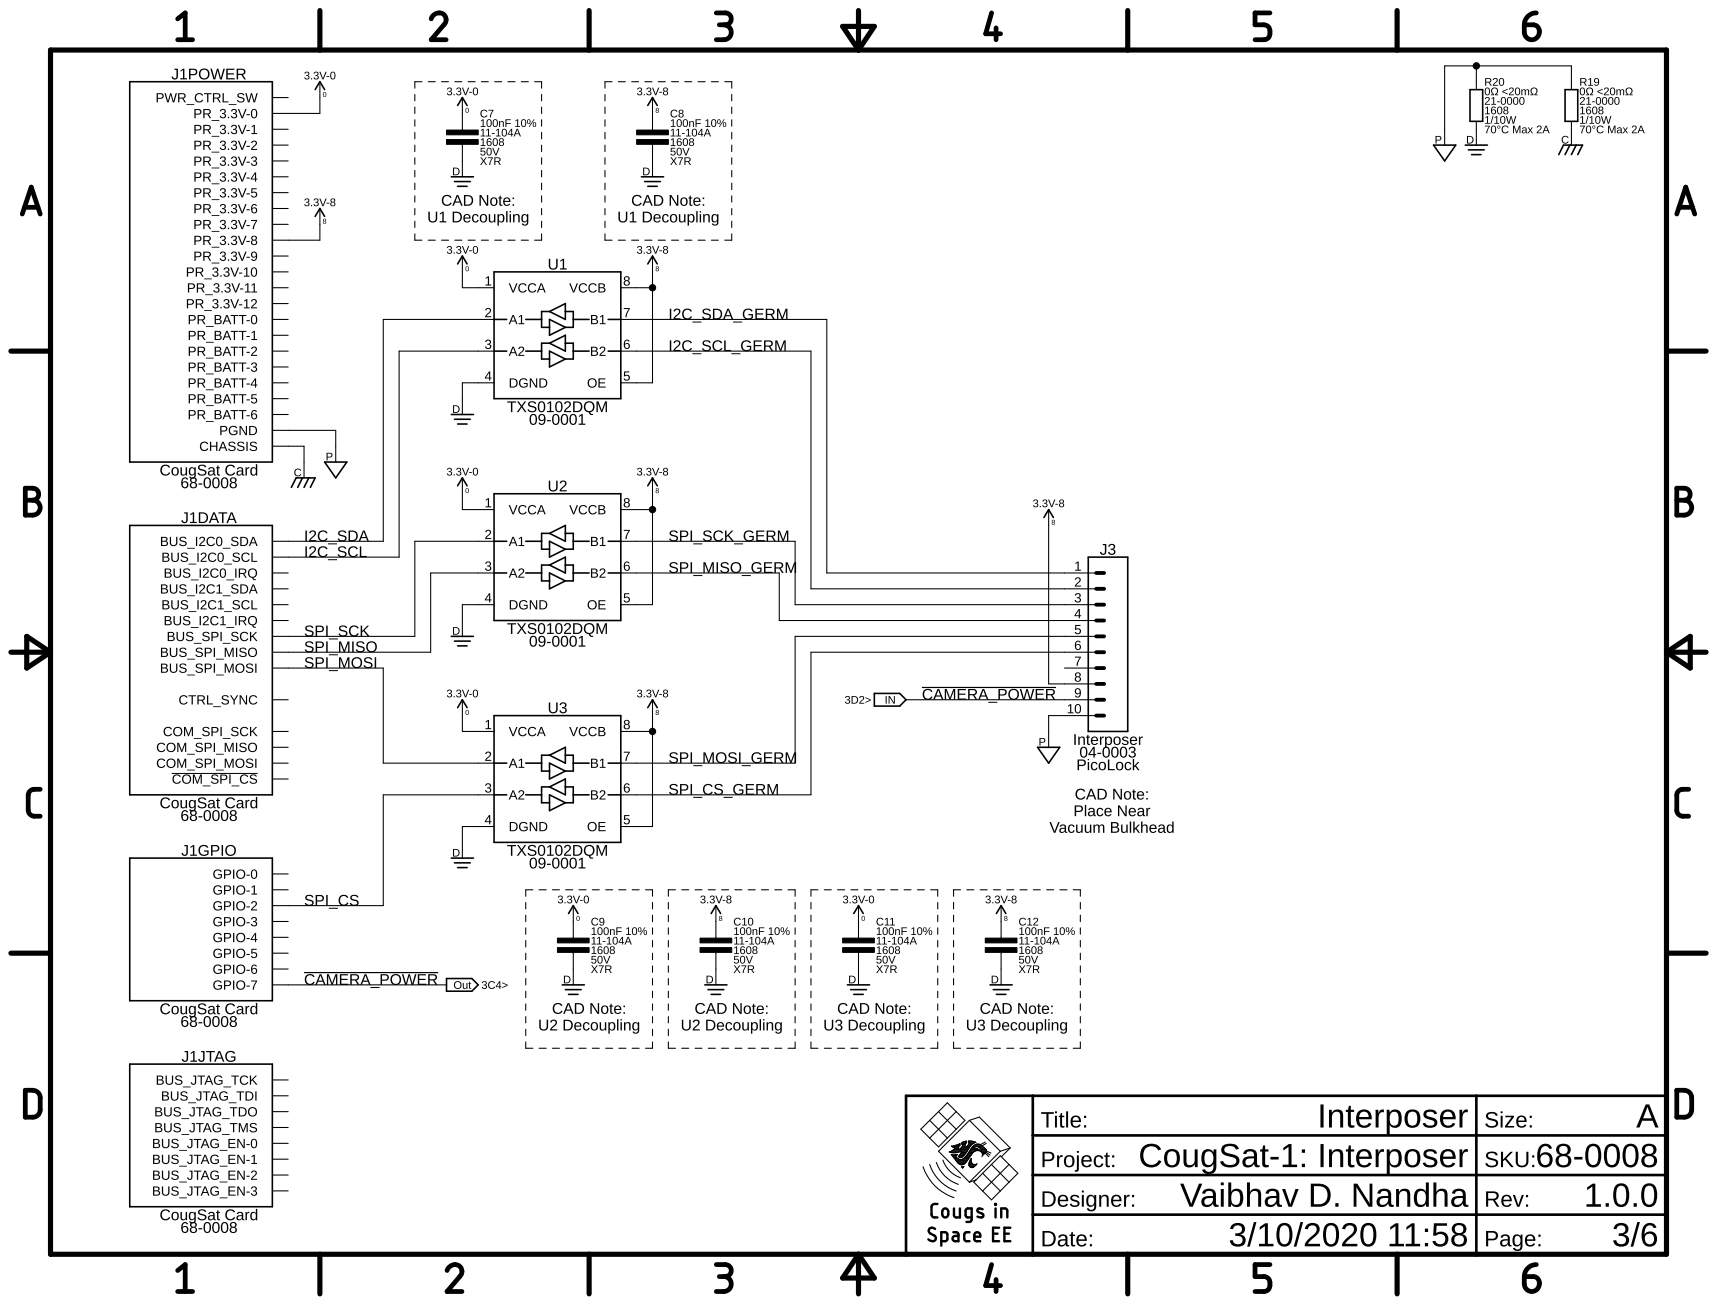
[picture p316: page 3]

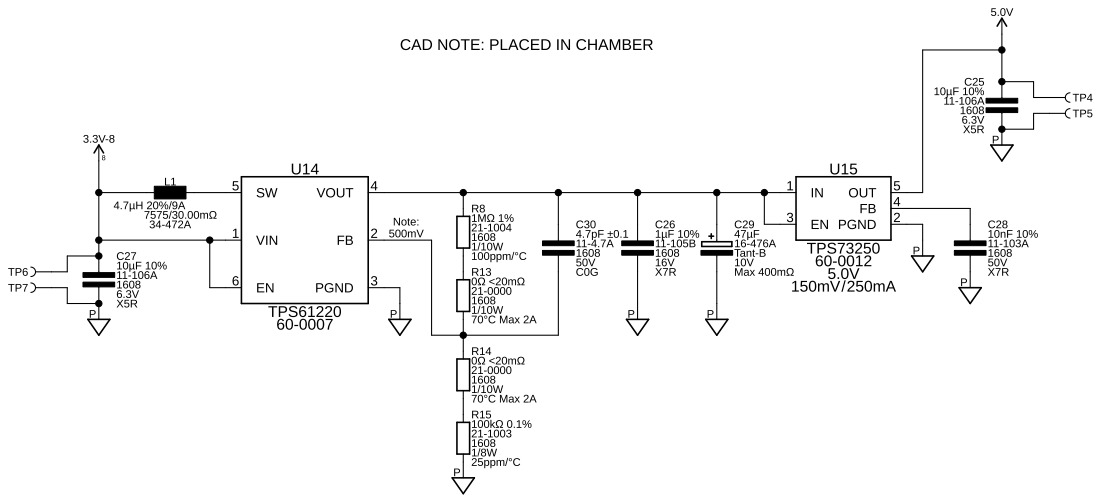
[picture p317: page 4]

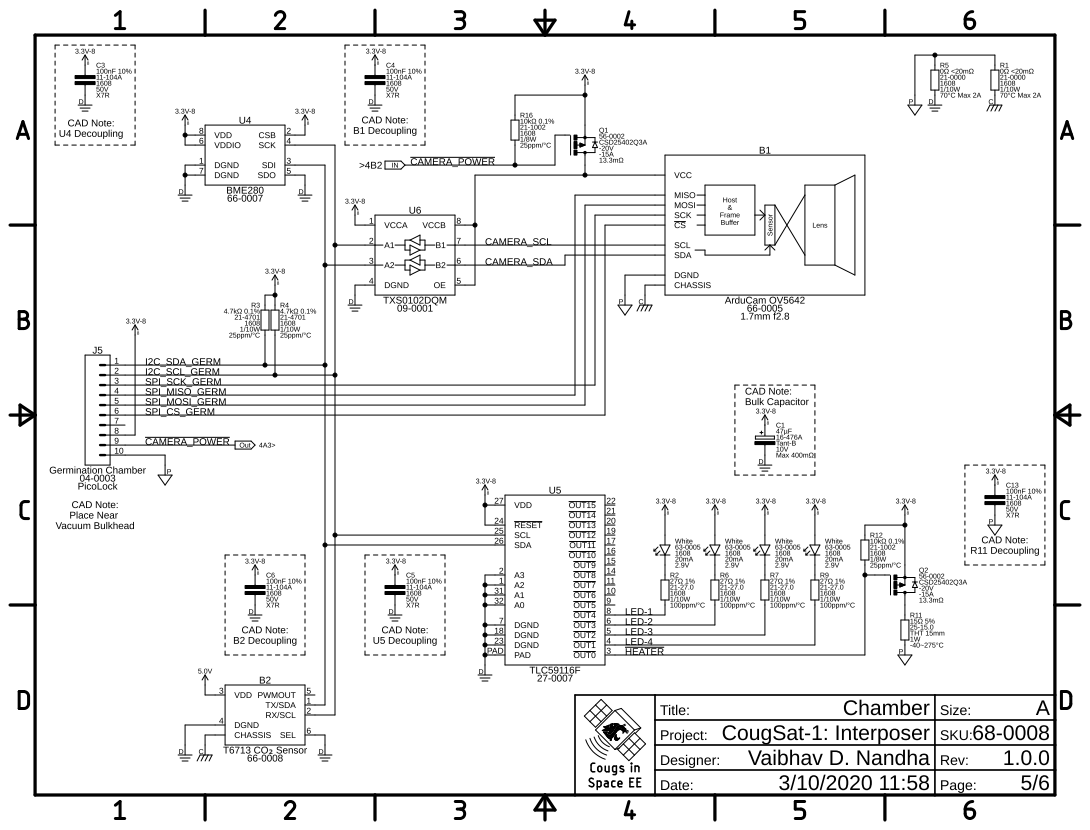
[picture p318: page 5]

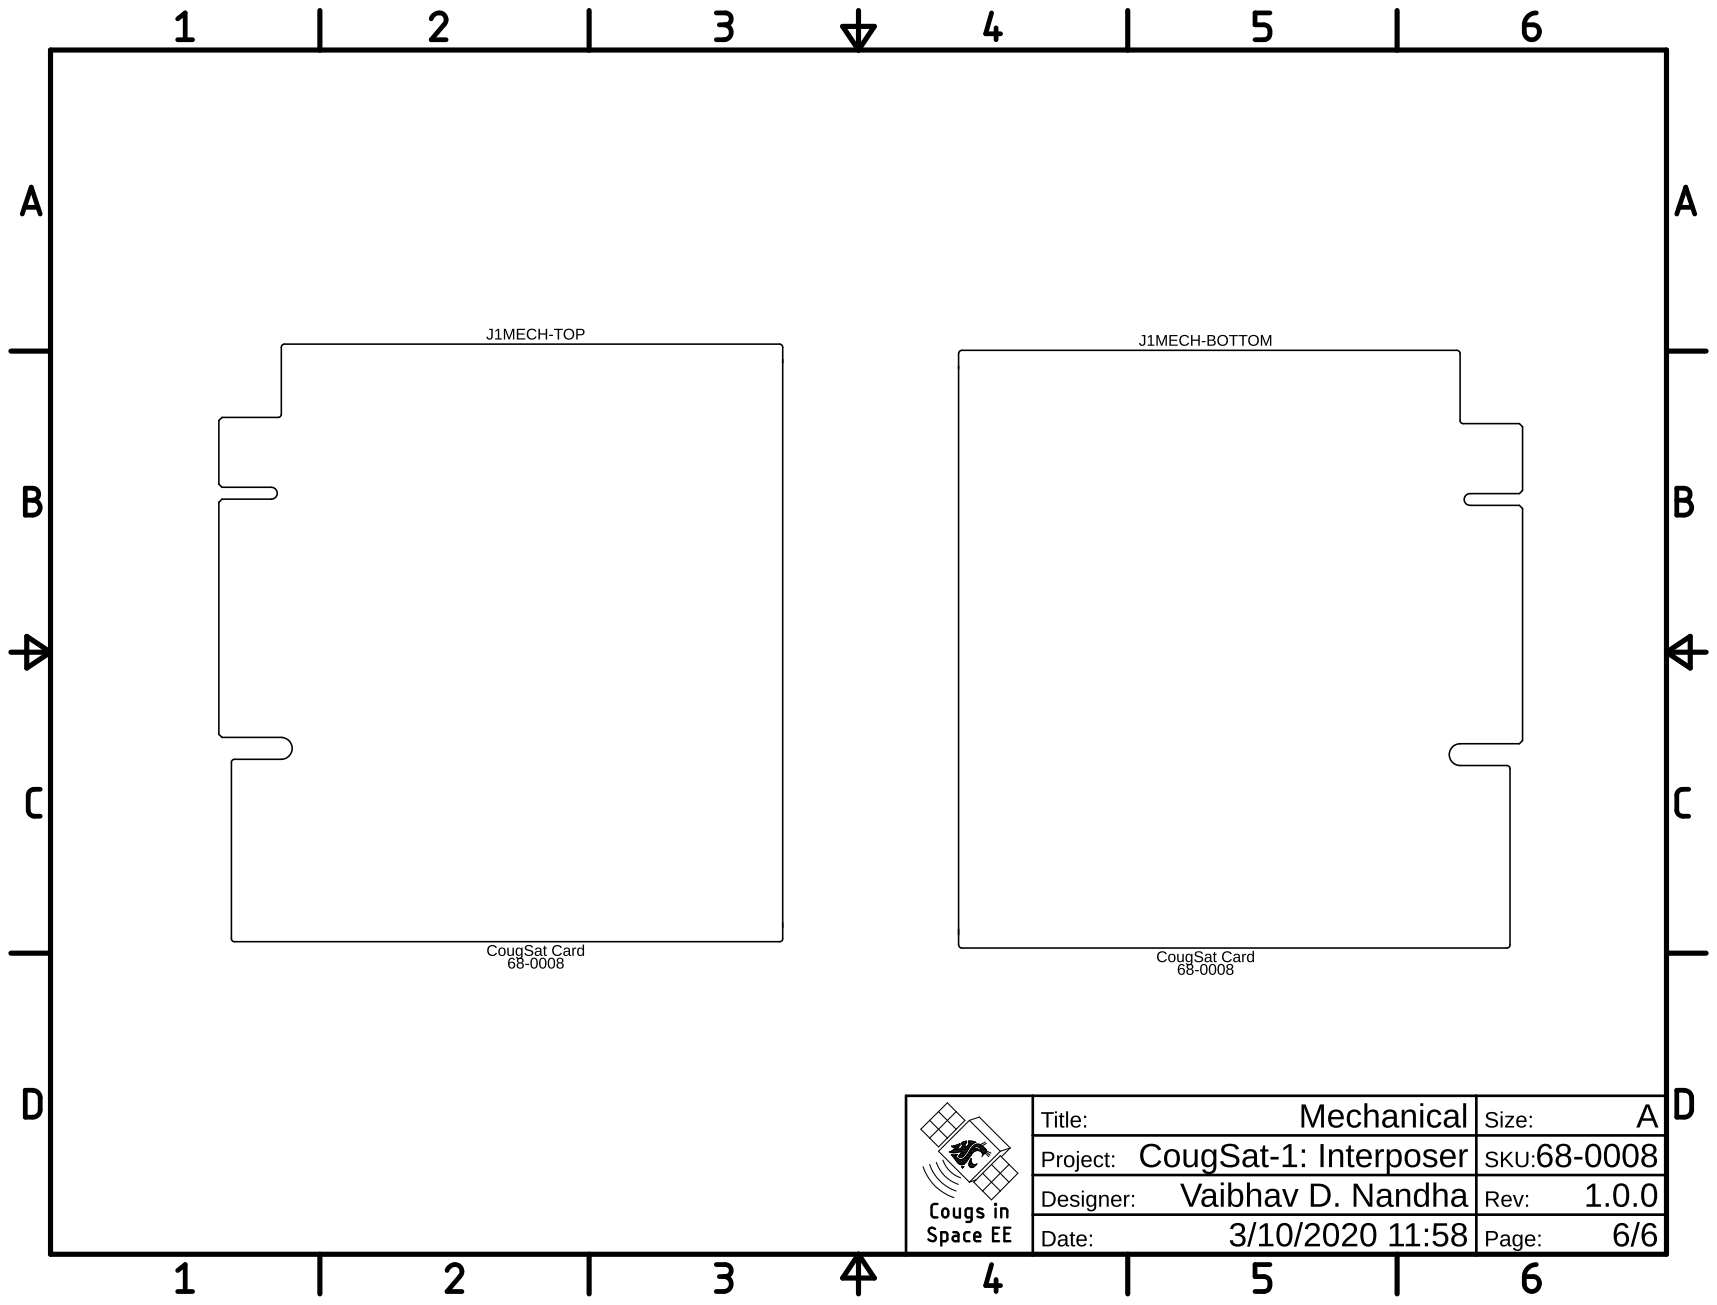
[picture p319: page 6]
