CougsInSpace/CougSat1-Hardware/CougSat1-Backplane/Documentation/CougSatModuleStandard.pdf

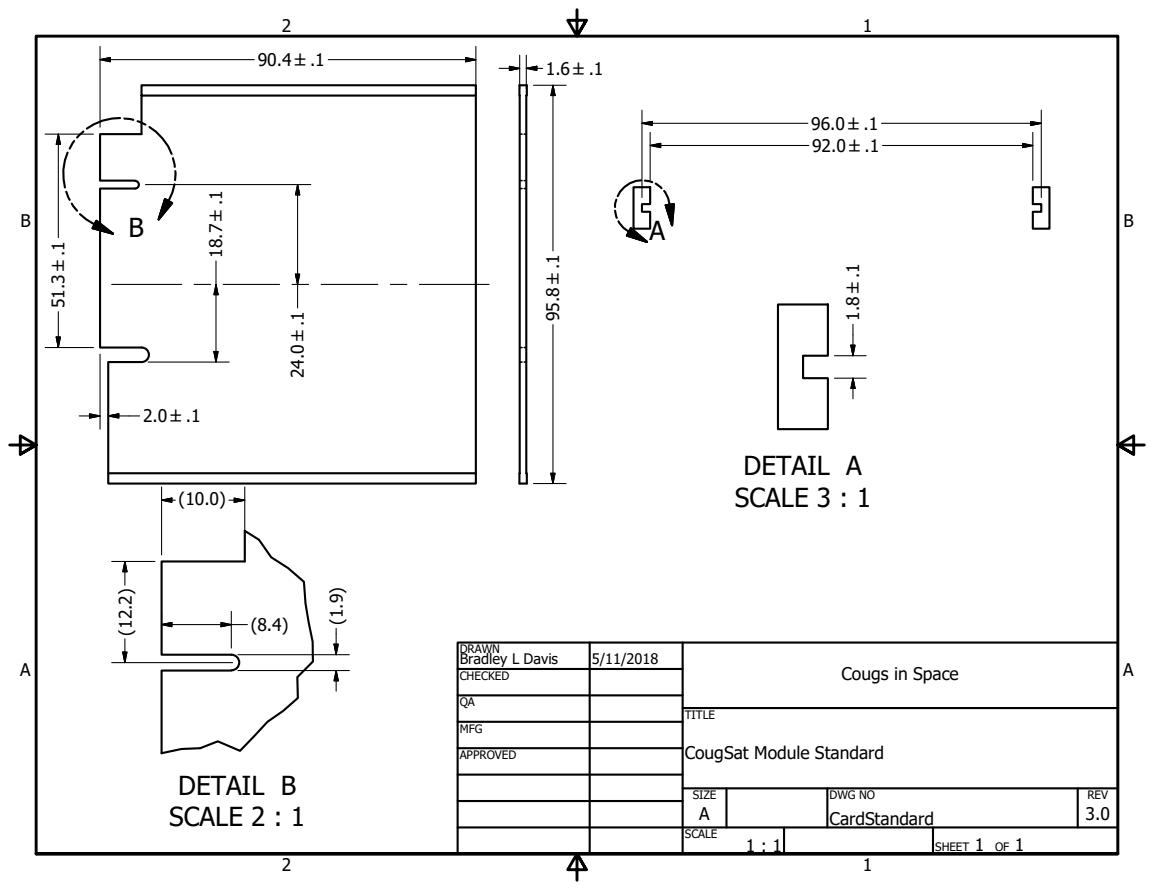
[picture p320: page 1]
DETAIL A SCALE 3 : 1; DETAIL B SCALE 2 : 1

DRAWN Bradley L Davis | 5/11/2018 | Cougs in Space

CHECKED

MFG

APPROVED

CougSat Module Standard

SIZE A | DWG NO CardStandard | REV 3.0

SCALE 1 : 1 | | SHEET 1 OF 1
