CougsInSpace/CougSat1-Hardware/CougSat1-Payload/ElectricalDesign/LTSpice/PhotodiodeAmplifier.asc

I1: current; PWL(0 0 1m 6m)
R1: res; 33k
R2: res; 10
R3: res; 1k
U1: AD8542
U2: AD8542
V1: voltage; 3.3
Named nets: 0, Vout, Vdd
.tran 0 1m 0 10n
