CougsInSpace/CougSat1-Hardware/CougSat1-RadioBoard/ElectricalDesign/LTSpice/IQAmplifier/IQAmplifier.asc

R1: res; 100k
R2: res; 100k
R3: res; 100k
R4: res; 100k
U1: AD8515
V1: voltage; 3.3
V2: voltage; 1.65
V4: voltage; SINE(1 0.5 50k 0 0 0)
V6: voltage; SINE(1 0.5 50k 0 0 180)
Named nets: 0, Vdd, CMRef, ID, ID_P, ID_N
.tran 50u
