CougsInSpace/CougSat1-Hardware/CougSat1-RadioBoard/ElectricalDesign/LTSpice/ModulatorDriver/ModulatorDriver.asc

C2: cap; 560p
C5: cap; 3.9n
I1: current; SINE(1m 1m {F} 0 0 180); AC 1m 180
I2: current; SINE(1m 1m {F}); AC 1m
I3: current; SINE(1m 1m {F}); AC 1m
I4: current; SINE(1m 1m {F} 0 0 180); AC 1m 180
R1: res; 698
R2: res; 698
R3: res; 1k
R4: res; 1.33k
R5: res; 1.33k
R6: res; 1.74k
R7: res; 12k
R8: res; 12k
Named nets: 0, 230+, 230-, 700+, 700-
.tran 1m
0.4 to 1.0V
0.7 to 1.7V
.ac dec 1000 10 1Meg
.step param F list 10k 100k 1Meg 10Meg
