CougsInSpace/CougSat1-Hardware/CougSat1-RadioBoard/ElectricalDesign/LTSpice/RFFilters/RFFilters.asc

C1: cap; 22p
C2: cap; 2p
C5: cap; 10p
C6: cap; 0.8p
I1: current; ""; AC 5.5m
I3: current; ""; AC 5.5m
L1: ind; 5.6n
L2: ind; 56n
L5: ind; 1.6n
L6: ind; 22n
R1: res; 50
R2: res; 50
R4: res; 50
R6: res; 50
V2: voltage; 3.3
Named nets: 0, Out-440M, Out-1.2G
.ac dec 1000 100Meg 10G
