CougsInSpace/CougSat1-Hardware/CougSat1-Payload/ElectricalDesign/LTSpice/RadiationSensor/RadiationSensor.asc

C1: cap; 10µ
C2: cap; 2p
C3: cap; 1n
I1: current; PULSE(0n 5n 3u 10n 10n 6u 0 1)
I2: current; SINE(0 1n 6meg)
R1: res; 10k
R2: res; 75k
R4: res; 10Meg
R5: res; 10k
R6: res; 10Meg
R7: res; 1Meg
R8: res; 47k
U1: AD8618
U2: AD8618
V1: voltage; 5
Named nets: 0, VDD
.tran 0 80u 1u 1n
