CougsInSpace/CougSat1-Hardware/CougSat1-PowerBoard/ElectricalDesign/LTSpice/EjectTimer/EjectTimer.asc

C1: cap; 220µ
C2: cap; 1m
D1: diode; 1N914
M1: pmos; IRF7204
M2: nmos; 2N7002
M3: nmos; 2N7002
M4: nmos; 2N7002
R1: res; 158k
R2: res; 10
R3: res; 10k
R4: res; 536k
R5: res; 1k
R6: res; 1k
U1: AD8515
V1: battery; 3.7; Rser=0.1
V2: voltage; PWL(0 3 1.95 3 2 0)
V3: voltage; PWL(0 4.1 0.45 4.1 0.5 0)
Named nets: 0, EJECT_TIMER_BUF
.tran 40
Umbilical plugged in with sep. sw depressed at 0s
Umbilical removed at 0.5s
Sep. sw released at 2s
