CougsInSpace/CougSat1-Hardware/CougSat1-AvionicBoard/ElectricalDesign/Avionics.brd

## EAGLE design CougSat1-AvionicBoard/ElectricalDesign/Avionics.brd (2021-10-27)

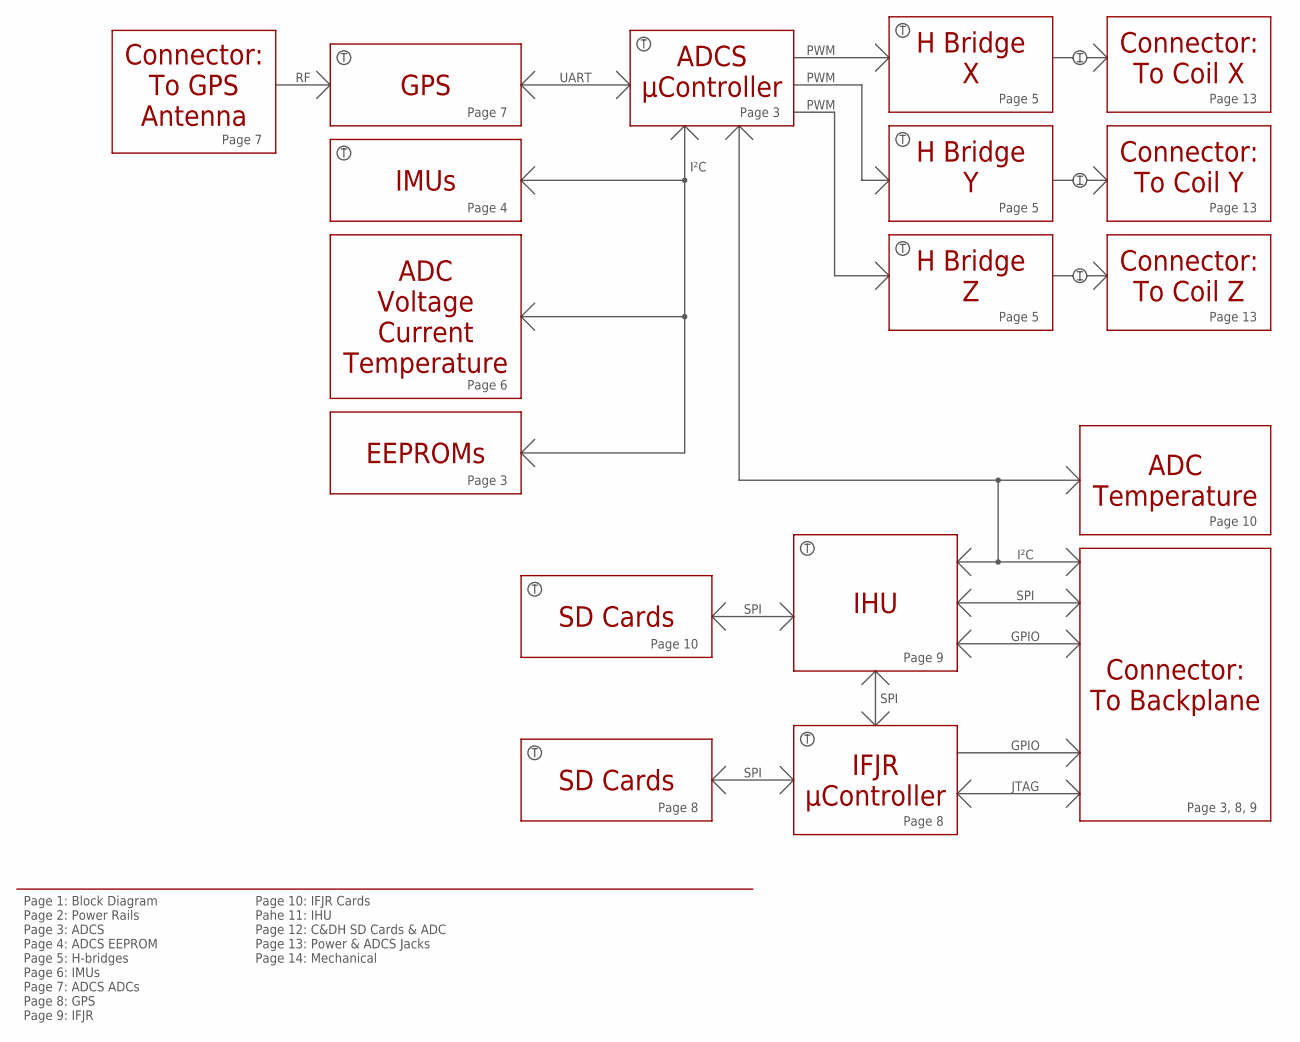
[picture p321: schematic Avionics.sch, sheet 1]

Notes on the sheet:
ADCS µController
GPS
IMUs
EEPROMs
ADC Voltage Current Temperature
H Bridge X
H Bridge Y
H Bridge Z
Connector: To Coil X
Connector: To Coil Y
Connector: To Coil Z
Connector: To GPS Antenna
I²C
PWM
UART
IHU
SD Cards
Connector: To Backplane
IFJR µController
SPI
ADC Temperature
Page 1: Block Diagram Page 2: Power Rails Page 3: ADCS Page 4: ADCS EEPROM Page 5: H-bridges Page 6: IMUs Page 7: ADCS ADCs Page 8: GPS Page 9: IFJR
JTAG
GPIO
Page 10: IFJR Cards Pahe 11: IHU Page 12: C&DH SD Cards & ADC Page 13: Power & ADCS Jacks Page 14: Mechanical
Page 3
Page 4
Page 5
Page 13
Page 6
Page 7
Page 8
Page 9
Page 10
Page 3, 8, 9

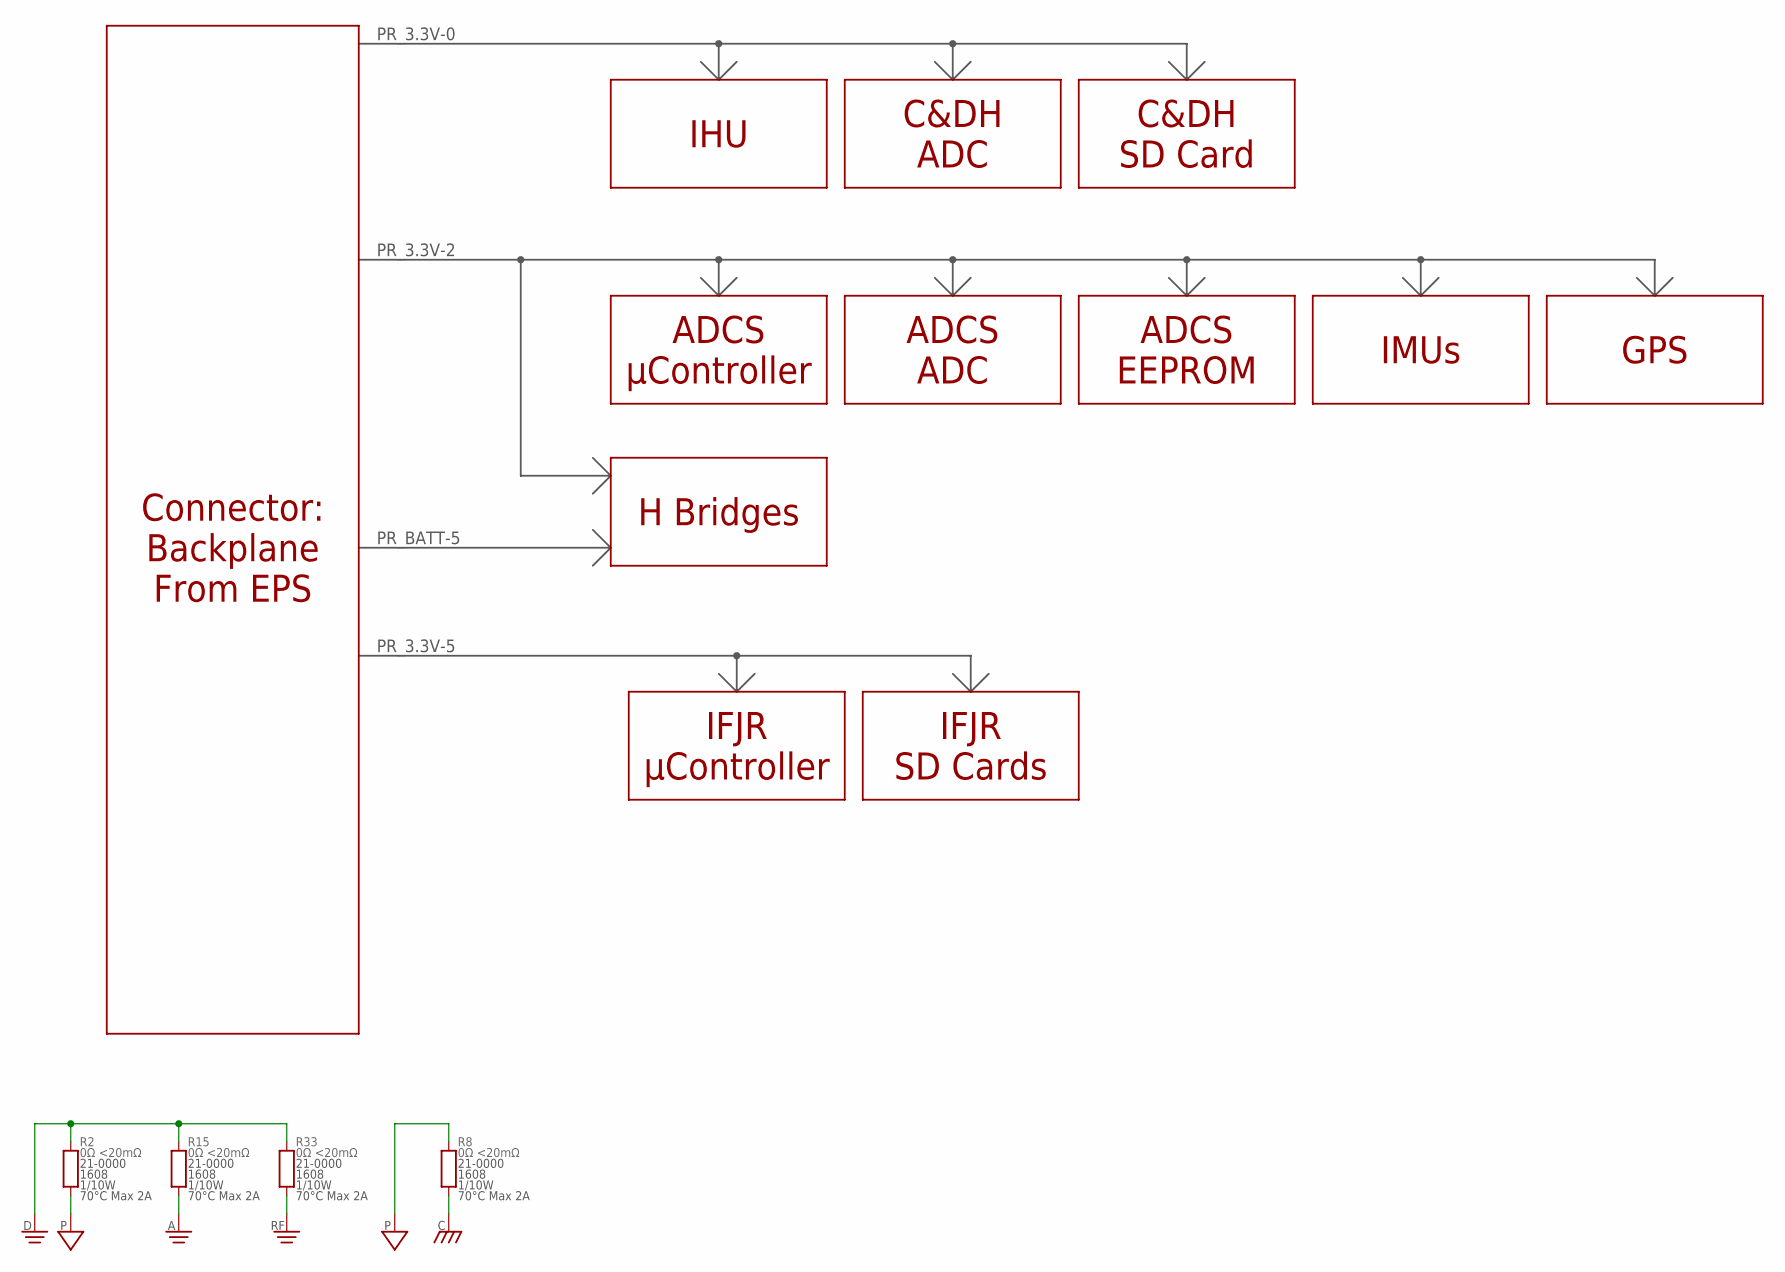
[picture p322: schematic Avionics.sch, sheet 2]

Parts:
R2, R8, R15, R33: 0Ω <20mΩ; 1608

Connections:
AGND: R15.1; also elsewhere on the board
CHASSIS: R8.1; also elsewhere on the board
DGND: R2.2, R15.2, R33.2; also elsewhere on the board
PGND: R2.1, R8.2; also elsewhere on the board
RFGND: R33.1; also elsewhere on the board

Notes on the sheet:
Connector: Backplane From EPS
IHU
C&DH SD Card
IMUs
GPS
IFJR µController
IFJR SD Cards
H Bridges
C&DH ADC
ADCS ADC
ADCS µController
ADCS EEPROM
PR_3.3V-0
PR_3.3V-2
PR_3.3V-5
PR_BATT-5

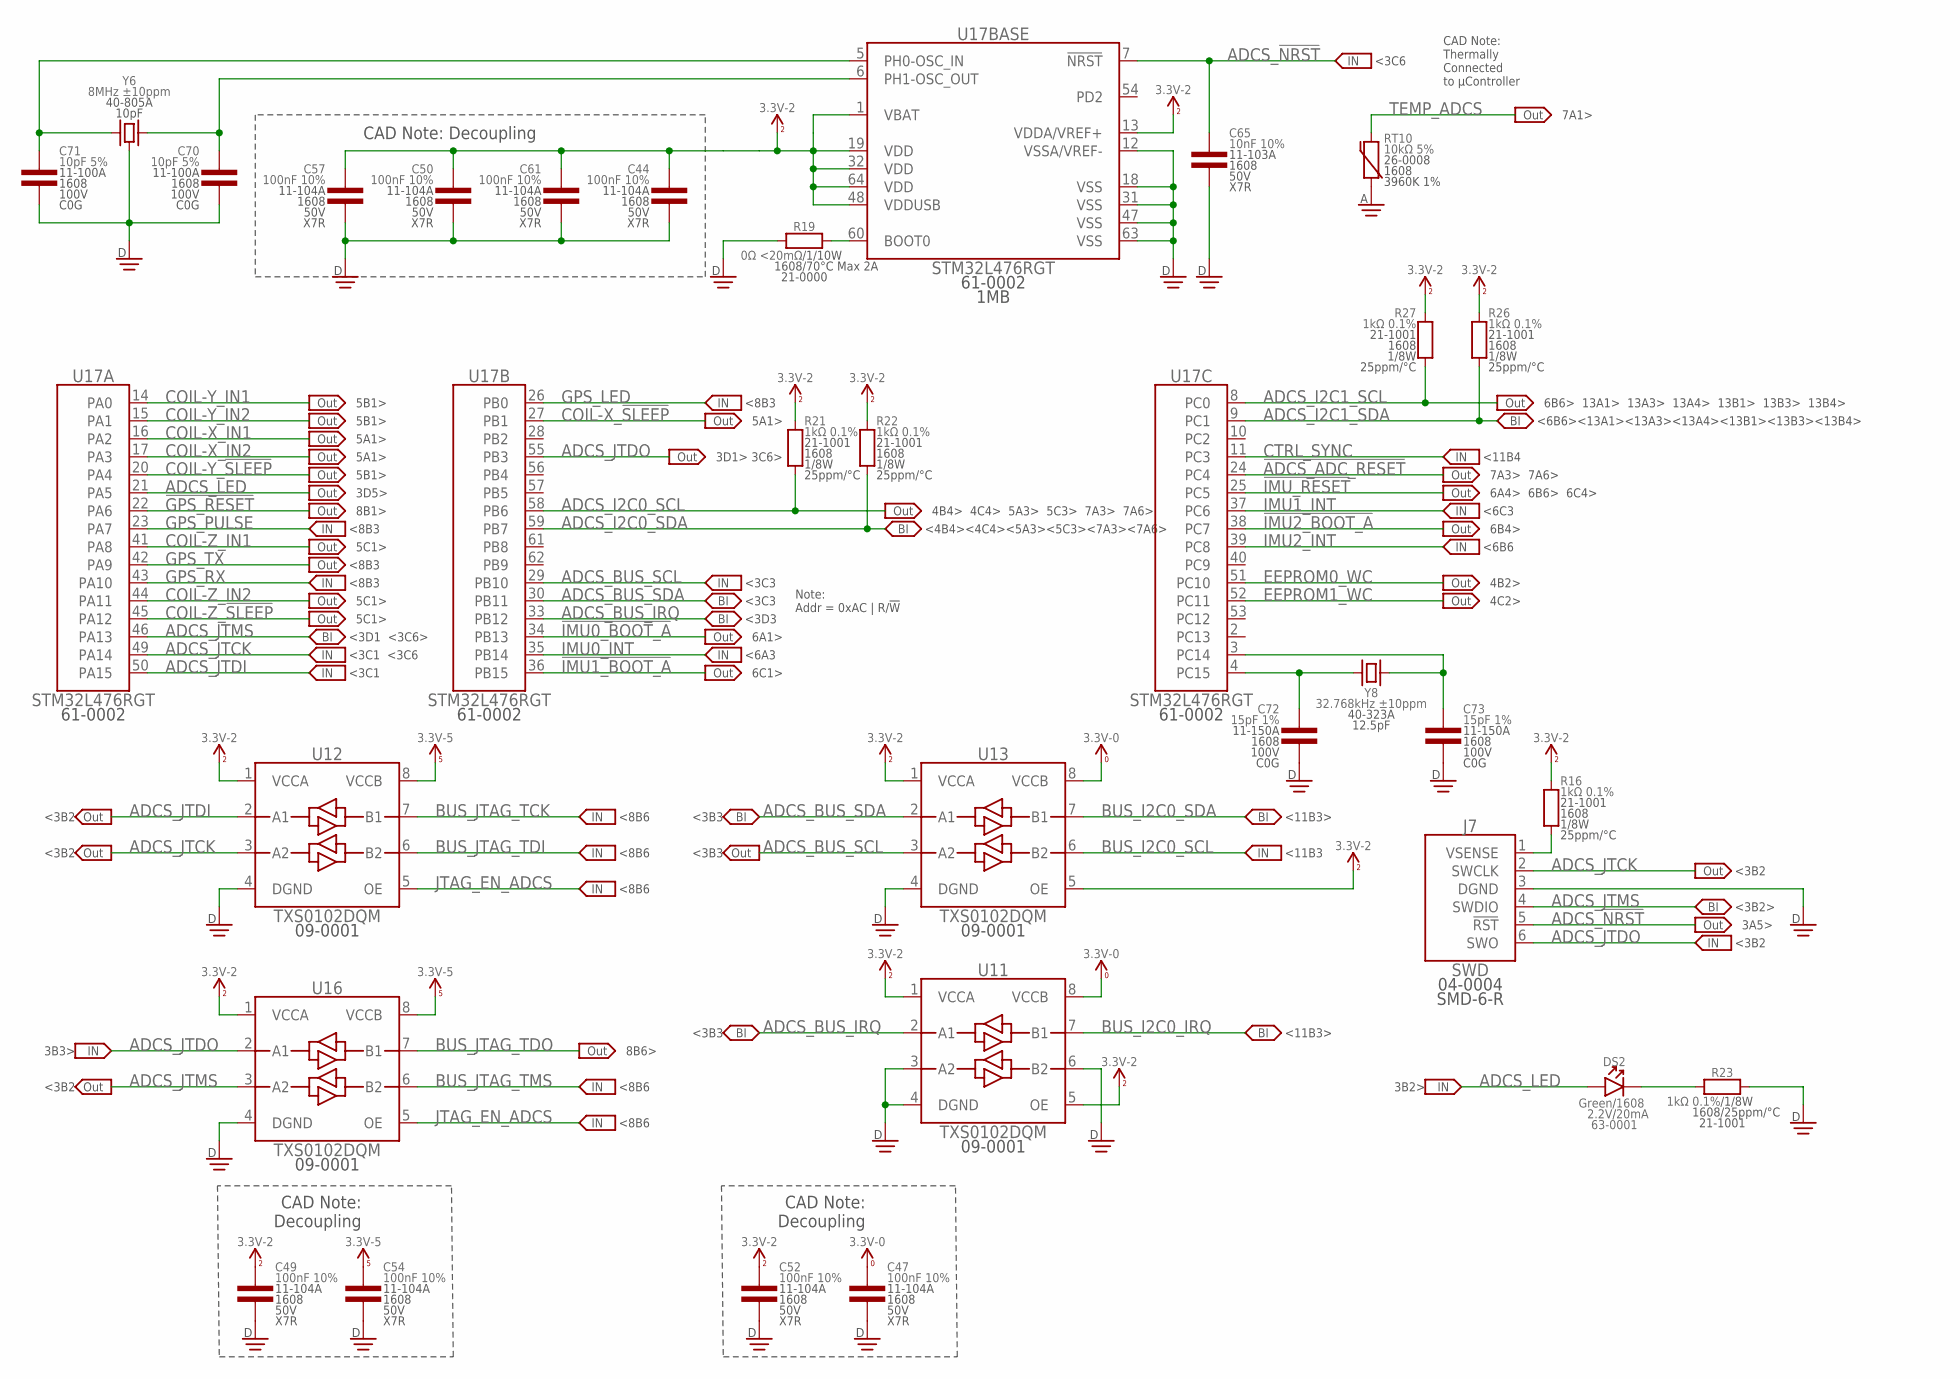
[picture p323: schematic Avionics.sch, sheet 3]

Parts:
C44, C47, C49, C50, C52, C54, C57, C61: 100nF 10%; 1608
C65: 10nF 10%; 1608
C70, C71: 10pF 5%; 1608
C72, C73: 15pF 1%; 1608
DS2: Green; 1608-POL
J7: SWD; SMD2.54-1X06-R
R16, R21, R22, R23, R26, R27: 1kΩ 0.1%; 1608
R19: 0Ω <20mΩ; 1608
RT10: 10kΩ 5%; 1608
U11, U12, U13, U16: TXS0102DQM; X2SON-8
U17: STM32L476RGT; QFP-64-1010
Y6: 8MHz ±10ppm; SMD-5032
Y8: 32.768kHz ±10ppm; SMD-3215

Connections:
3.3V_0: C47.1, U11.8 (VCCB), U13.8 (VCCB); also elsewhere on the board
3.3V_2: C44.1, C49.1, C50.1, C52.1, C57.1, C61.1, R16.2, R21.2, R22.2, R26.2, R27.2, U11.1 (VCCA), U11.5 (OE), U12.1 (VCCA), U13.1 (VCCA), U13.5 (OE), U16.1 (VCCA), U17.1 (VBAT), U17.13 (VDDA/VREF+), U17.19 (VDD), U17.32 (VDD), U17.48 (VDDUSB), U17.64 (VDD); also elsewhere on the board
3.3V_5: C54.1, U12.8 (VCCB), U16.8 (VCCB); also elsewhere on the board
!ADCS_ADC_RESET!: U17.24 (PC4); also elsewhere on the board
!GPS_RESET: U17.22 (PA6); also elsewhere on the board
!IMU0_BOOT_A: U17.34 (PB13); also elsewhere on the board
!IMU1_BOOT_A: U17.36 (PB15); also elsewhere on the board
!IMU2_BOOT_A: U17.38 (PC7); also elsewhere on the board
!IMU_RESET: U17.25 (PC5); also elsewhere on the board
ADCS_!NRST: C65.1, J7.5 (!RST), U17.7 (!NRST)
ADCS_BOOT0: R19.2, U17.60 (BOOT0)
ADCS_BUS_IRQ: U11.2 (A1), U17.33 (PB12)
ADCS_BUS_SCL: U13.3 (A2), U17.29 (PB10)
ADCS_BUS_SDA: U13.2 (A1), U17.30 (PB11)
ADCS_I2C0_SCL: R21.1, U17.58 (PB6); also elsewhere on the board
ADCS_I2C0_SDA: R22.1, U17.59 (PB7); also elsewhere on the board
ADCS_I2C1_SCL: R27.1, U17.8 (PC0); also elsewhere on the board
ADCS_I2C1_SDA: R26.1, U17.9 (PC1); also elsewhere on the board
ADCS_JTCK: J7.2 (SWCLK), U12.3 (A2), U17.49 (PA14)
ADCS_JTDI: U12.2 (A1), U17.50 (PA15)
ADCS_JTDO: J7.6 (SWO), U16.2 (A1), U17.55 (PB3)
ADCS_JTMS: J7.4 (SWDIO), U16.3 (A2), U17.46 (PA13)
ADCS_LED: DS2.A, U17.21 (PA5)
ADCS_LED_GND: DS2.C, R23.1
ADCS_OSC_32_IN: C72.1, U17.4 (PC15), Y8.1
ADCS_OSC_32_OUT: C73.1, U17.3 (PC14), Y8.2
ADCS_OSC_IN: C71.1, U17.5 (PH0-OSC_IN), Y6.1
ADCS_OSC_OUT: C70.1, U17.6 (PH1-OSC_OUT), Y6.3 (2)
ADCS_SWD_VSENCE: J7.1 (VSENSE), R16.1
AGND: RT10.1; also elsewhere on the board
BUS_I2C0_IRQ: U11.7 (B1); also elsewhere on the board
BUS_I2C0_SCL: U13.6 (B2); also elsewhere on the board
BUS_I2C0_SDA: U13.7 (B1); also elsewhere on the board
BUS_JTAG_TCK: U12.7 (B1); also elsewhere on the board
BUS_JTAG_TDI: U12.6 (B2); also elsewhere on the board
BUS_JTAG_TDO: U16.7 (B1); also elsewhere on the board
BUS_JTAG_TMS: U16.6 (B2); also elsewhere on the board
COIL-X_!SLEEP: U17.27 (PB1); also elsewhere on the board
COIL-X_IN1: U17.16 (PA2); also elsewhere on the board
COIL-X_IN2: U17.17 (PA3); also elsewhere on the board
COIL-Y_!SLEEP: U17.20 (PA4); also elsewhere on the board
COIL-Y_IN1: U17.14 (PA0); also elsewhere on the board
COIL-Y_IN2: U17.15 (PA1); also elsewhere on the board
COIL-Z_!SLEEP: U17.45 (PA12); also elsewhere on the board
COIL-Z_IN1: U17.41 (PA8); also elsewhere on the board
COIL-Z_IN2: U17.44 (PA11); also elsewhere on the board
CTRL_SYNC: U17.11 (PC3); also elsewhere on the board
DGND: C44.2, C47.2, C49.2, C50.2, C52.2, C54.2, C57.2, C61.2, C65.2, C70.2, C71.2, C72.2, C73.2, J7.3 (DGND), R19.1, R23.2, U11.3 (A2), U11.4 (DGND), U11.6 (B2), U12.4 (DGND), U13.4 (DGND), U16.4 (DGND), U17.12 (VSSA/VREF-), U17.18 (VSS), U17.31 (VSS), U17.47 (VSS), U17.63 (VSS), Y6.2 (GND), Y6.4 (GND); also elsewhere on the board
EEPROM0_WC: U17.51 (PC10); also elsewhere on the board
EEPROM1_WC: U17.52 (PC11); also elsewhere on the board
GPS_LED: U17.26 (PB0); also elsewhere on the board
GPS_PULSE: U17.23 (PA7); also elsewhere on the board
GPS_RX: U17.43 (PA10); also elsewhere on the board
GPS_TX: U17.42 (PA9); also elsewhere on the board
IMU0_INT: U17.35 (PB14); also elsewhere on the board
IMU1_INT: U17.37 (PC6); also elsewhere on the board
IMU2_INT: U17.39 (PC8); also elsewhere on the board
JTAG_EN_ADCS: U12.5 (OE), U16.5 (OE); also elsewhere on the board
TEMP_ADCS: RT10.2; also elsewhere on the board

Notes on the sheet:
5C1>
8B1>
<8B3
3D1> 3C6>
<3B2
<3B2>
4B4> 4C4> 5A3> 5C3> 7A3> 7A6>
<4B4><4C4><5A3><5C3><7A3><7A6>
<11B3>
6A1>
<6A3
6C1>
<6C3
6B4>
<6B6
4B2>
4C2>
6B6> 13A1> 13A3> 13A4> 13B1> 13B3> 13B4>
<6B6><13A1><13A3><13A4><13B1><13B3><13B4>
<3B2
3B3>
<8B6
8B6>
CAD Note: Thermally Connected to µController
7A1>
3A5>
3D5>
3B2>
CAD Note: Decoupling
CAD Note: Decoupling
Note: Addr = 0xAC | R/!W!
<11B4
6A4> 6B6> 6C4>
7A3> 7A6>
<3B3
<3D1 <3C6>
<3C1 <3C6
<3C1
<3C3
<3D3
<3C6
<11B3
5B1>
5A1>

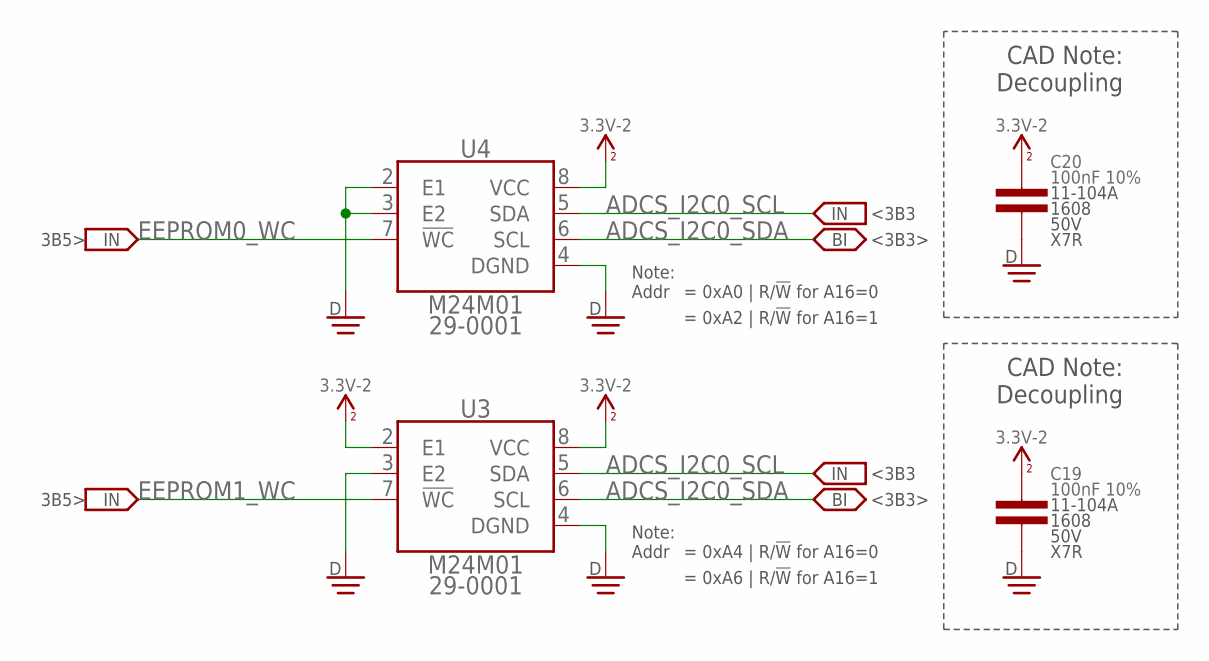
[picture p324: schematic Avionics.sch, sheet 4]

Parts:
C19, C20: 100nF 10%; 1608
U3, U4: M24M01; SO8

Connections:
3.3V_2: C19.1, C20.1, U3.2 (E1), U3.8 (VCC), U4.8 (VCC); also elsewhere on the board
ADCS_I2C0_SCL: U3.5 (SDA), U4.5 (SDA); also elsewhere on the board
ADCS_I2C0_SDA: U3.6 (SCL), U4.6 (SCL); also elsewhere on the board
DGND: C19.2, C20.2, U3.3 (E2), U3.4 (DGND), U4.2 (E1), U4.3 (E2), U4.4 (DGND); also elsewhere on the board
EEPROM0_WC: U4.7 (!WC); also elsewhere on the board
EEPROM1_WC: U3.7 (!WC); also elsewhere on the board

Notes on the sheet:
<3B3>
<3B3
3B5>
CAD Note: Decoupling
Note: Addr
= 0xA2 | R/!W! for A16=1
= 0xA0 | R/!W! for A16=0
= 0xA6 | R/!W! for A16=1
= 0xA4 | R/!W! for A16=0

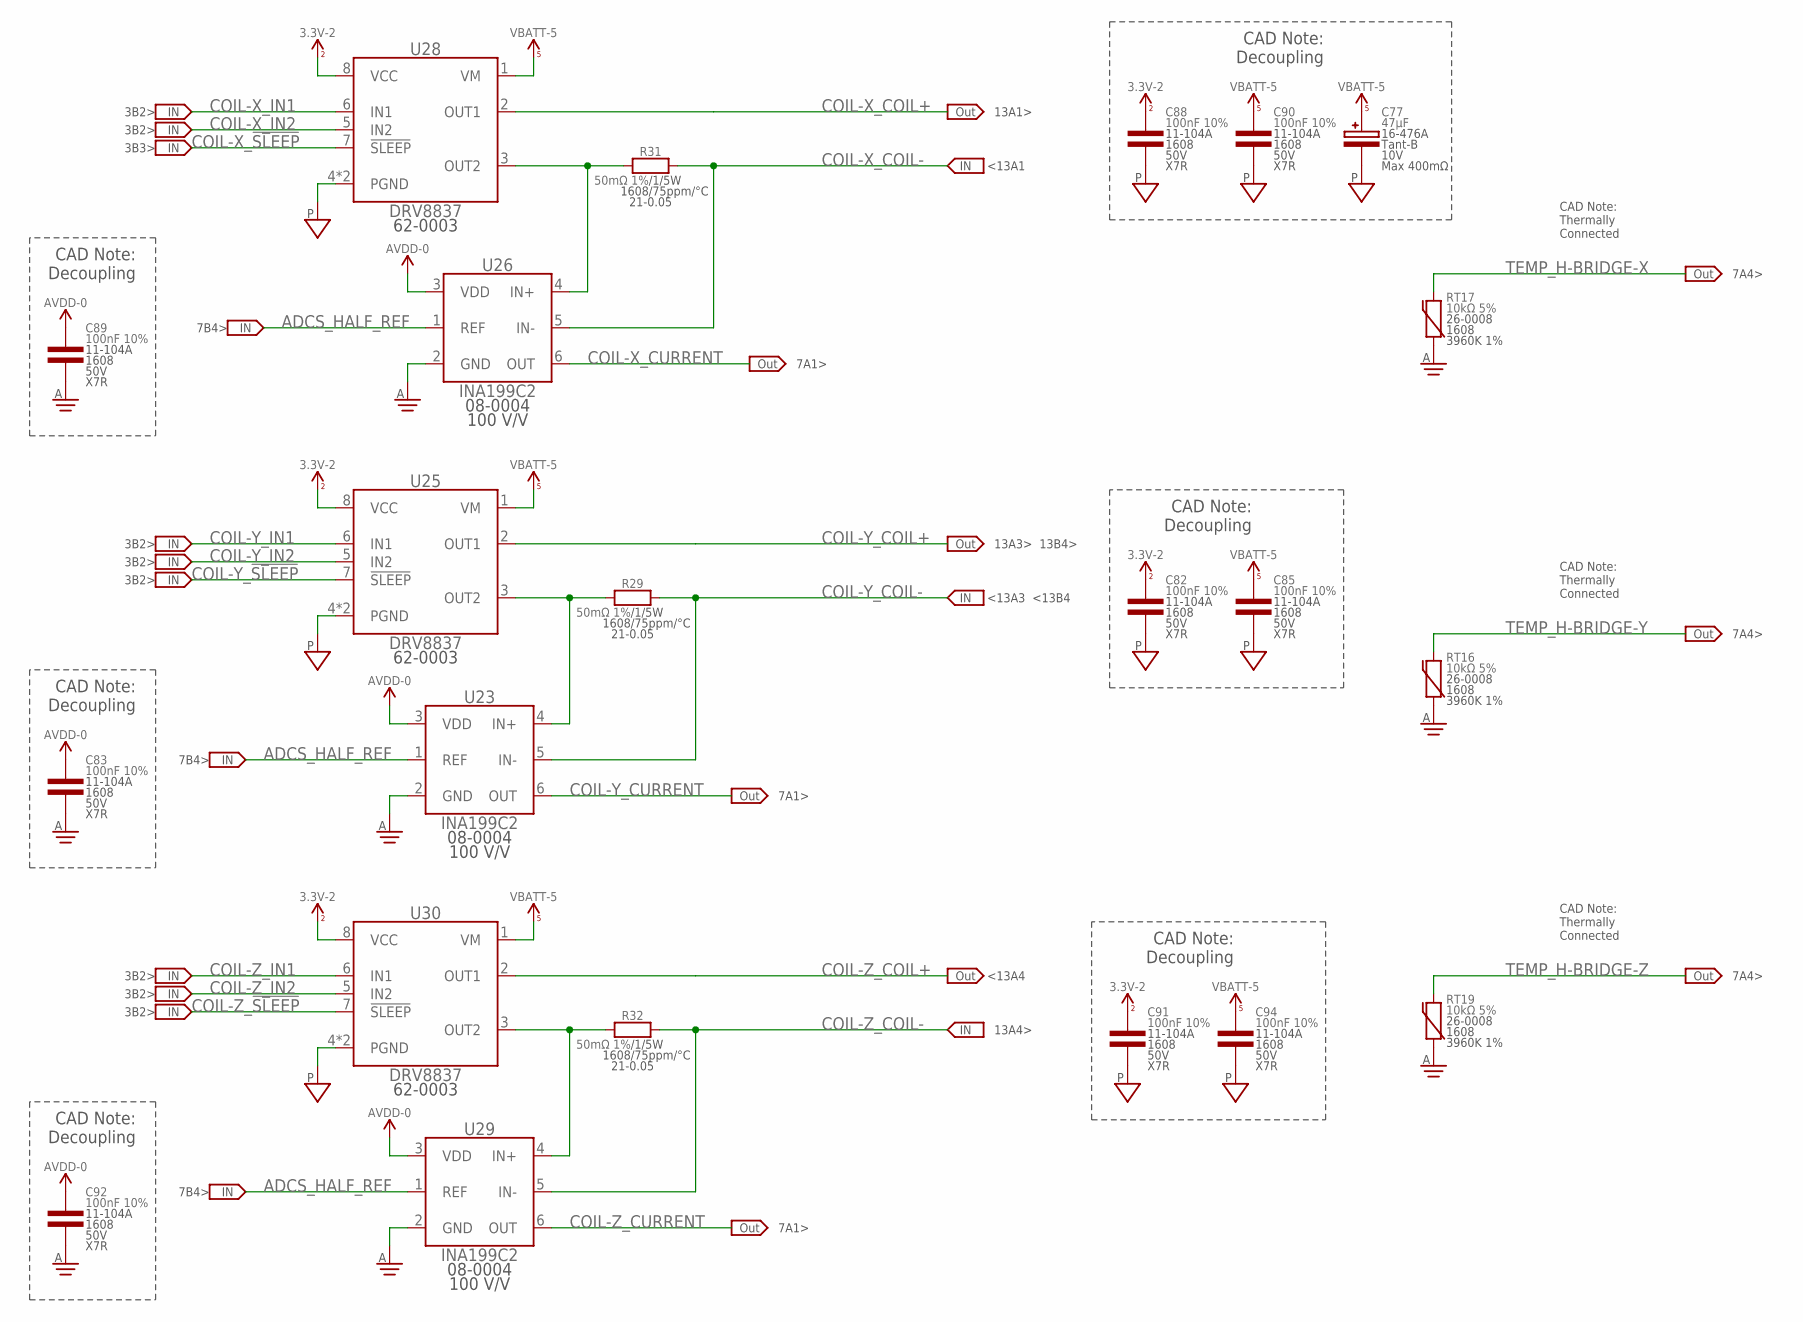
[picture p325: schematic Avionics.sch, sheet 5]

Parts:
C77: 47µF; 4028-POL
C82, C83, C85, C88, C89, C90, C91, C92, C94: 100nF 10%; 1608
R29, R31, R32: 50mΩ 1%; 1608
RT16, RT17, RT19: 10kΩ 5%; 1608
U23, U26, U29: INA199C2; SOT363
U25, U28, U30: DRV8837; WSON-8

Connections:
3.3V_2: C82.1, C88.1, C91.1, U25.8 (VCC), U28.8 (VCC), U30.8 (VCC); also elsewhere on the board
ADCS_HALF_REF: U23.1 (REF), U26.1 (REF), U29.1 (REF); also elsewhere on the board
AGND: C83.2, C89.2, C92.2, RT16.1, RT17.1, RT19.1, U23.2 (GND), U26.2 (GND), U29.2 (GND); also elsewhere on the board
AVDD-0: C83.1, C89.1, C92.1, U23.3 (VDD), U26.3 (VDD), U29.3 (VDD); also elsewhere on the board
COIL-X_!SLEEP: U28.7 (!SLEEP); also elsewhere on the board
COIL-X_COIL+: U28.2 (OUT1); also elsewhere on the board
COIL-X_COIL-: R31.2, U26.5 (IN-); also elsewhere on the board
COIL-X_CURRENT: U26.6 (OUT); also elsewhere on the board
COIL-X_IN1: U28.6 (IN1); also elsewhere on the board
COIL-X_IN2: U28.5 (IN2); also elsewhere on the board
COIL-X_OUT2: R31.1, U26.4 (IN+), U28.3 (OUT2)
COIL-Y_!SLEEP: U25.7 (!SLEEP); also elsewhere on the board
COIL-Y_COIL+: U25.2 (OUT1); also elsewhere on the board
COIL-Y_COIL-: R29.2, U23.5 (IN-); also elsewhere on the board
COIL-Y_CURRENT: U23.6 (OUT); also elsewhere on the board
COIL-Y_IN1: U25.6 (IN1); also elsewhere on the board
COIL-Y_IN2: U25.5 (IN2); also elsewhere on the board
COIL-Y_OUT2: R29.1, U23.4 (IN+), U25.3 (OUT2)
COIL-Z_!SLEEP: U30.7 (!SLEEP); also elsewhere on the board
COIL-Z_COIL+: U30.2 (OUT1); also elsewhere on the board
COIL-Z_COIL-: R32.2, U29.5 (IN-); also elsewhere on the board
COIL-Z_CURRENT: U29.6 (OUT); also elsewhere on the board
COIL-Z_IN1: U30.6 (IN1); also elsewhere on the board
COIL-Z_IN2: U30.5 (IN2); also elsewhere on the board
COIL-Z_OUT2: R32.1, U29.4 (IN+), U30.3 (OUT2)
PGND: C77.C, C82.2, C85.2, C88.2, C90.2, C91.2, C94.2, U25.4 (PGND), U25.PAD (PGND), U28.4 (PGND), U28.PAD (PGND), U30.4 (PGND), U30.PAD (PGND); also elsewhere on the board
TEMP_H-BRIDGE-X: RT17.2; also elsewhere on the board
TEMP_H-BRIDGE-Y: RT16.2; also elsewhere on the board
TEMP_H-BRIDGE-Z: RT19.2; also elsewhere on the board
VBATT_5: C77.A, C85.1, C90.1, C94.1, U25.1 (VM), U28.1 (VM), U30.1 (VM); also elsewhere on the board

Notes on the sheet:
CAD Note: Thermally Connected
7A4>
CAD Note: Decoupling
7B4>
7A1>
3B2>
13A1>
<13A1
3B3>
13A3> 13B4>
<13A3 <13B4
13A4>
<13A4

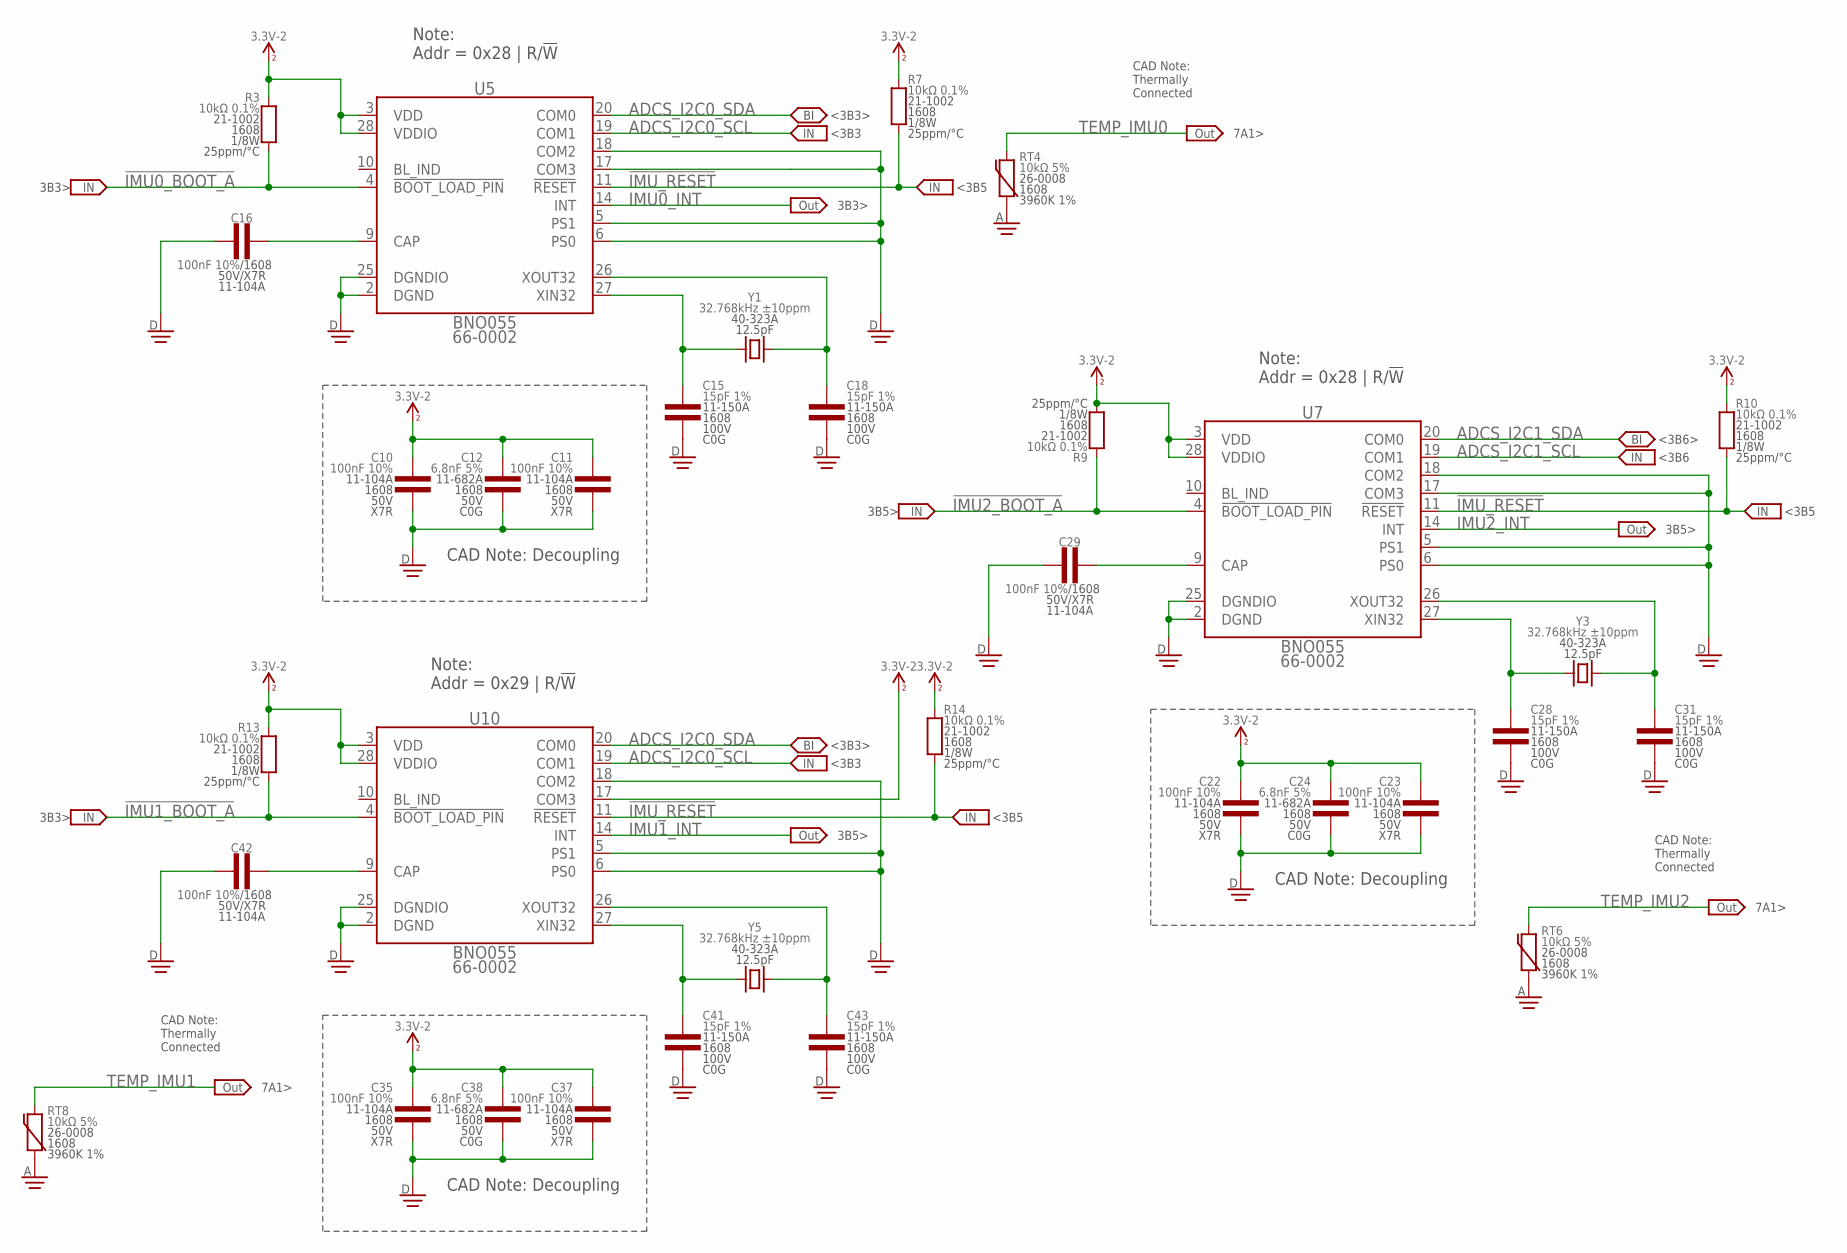
[picture p326: schematic Avionics.sch, sheet 6]

Parts:
C10, C11, C16, C22, C23, C29, C35, C37, C42: 100nF 10%; 1608
C12, C24, C38: 6.8nF 5%; 1608
C15, C18, C28, C31, C41, C43: 15pF 1%; 1608
R3, R7, R9, R10, R13, R14: 10kΩ 0.1%; 1608
RT4, RT6, RT8: 10kΩ 5%; 1608
U5, U7, U10: BNO055; LGA-28-4050
Y1, Y3, Y5: 32.768kHz ±10ppm; SMD-3215

Connections:
3.3V_2: C10.1, C11.1, C12.1, C22.1, C23.1, C24.1, C35.1, C37.1, C38.1, R3.2, R7.2, R9.1, R10.2, R13.2, R14.2, U5.3 (VDD), U5.28 (VDDIO), U7.3 (VDD), U7.28 (VDDIO), U10.3 (VDD), U10.17 (COM3), U10.28 (VDDIO); also elsewhere on the board
!IMU0_BOOT_A: R3.1, U5.4 (!BOOT_LOAD_PIN); also elsewhere on the board
!IMU1_BOOT_A: R13.1, U10.4 (!BOOT_LOAD_PIN); also elsewhere on the board
!IMU2_BOOT_A: R9.2, U7.4 (!BOOT_LOAD_PIN); also elsewhere on the board
!IMU_RESET: R7.1, R10.1, R14.1, U5.11 (!RESET), U7.11 (!RESET), U10.11 (!RESET); also elsewhere on the board
ADCS_I2C0_SCL: U5.19 (COM1), U10.19 (COM1); also elsewhere on the board
ADCS_I2C0_SDA: U5.20 (COM0), U10.20 (COM0); also elsewhere on the board
ADCS_I2C1_SCL: U7.19 (COM1); also elsewhere on the board
ADCS_I2C1_SDA: U7.20 (COM0); also elsewhere on the board
ADCS_IMU1_OSC_32_IN: C41.1, U10.27 (XIN32), Y5.2
ADCS_IMU1_OSC_32_IN1: C15.1, U5.27 (XIN32), Y1.2
ADCS_IMU1_OSC_32_IN2: C28.1, U7.27 (XIN32), Y3.2
ADCS_IMU1_OSC_32_OUT: C43.1, U10.26 (XOUT32), Y5.1
ADCS_IMU1_OSC_32_OUT1: C18.1, U5.26 (XOUT32), Y1.1
ADCS_IMU1_OSC_32_OUT2: C31.1, U7.26 (XOUT32), Y3.1
AGND: RT4.1, RT6.1, RT8.1; also elsewhere on the board
DGND: C10.2, C11.2, C12.2, C15.2, C16.1, C18.2, C22.2, C23.2, C24.2, C28.2, C29.1, C31.2, C35.2, C37.2, C38.2, C41.2, C42.1, C43.2, U5.2 (DGND), U5.5 (PS1), U5.6 (PS0), U5.17 (COM3), U5.18 (COM2), U5.25 (DGNDIO), U7.2 (DGND), U7.5 (PS1), U7.6 (PS0), U7.17 (COM3), U7.18 (COM2), U7.25 (DGNDIO), U10.2 (DGND), U10.5 (PS1), U10.6 (PS0), U10.18 (COM2), U10.25 (DGNDIO); also elsewhere on the board
IMU0_CAP: C16.2, U5.9 (CAP)
IMU0_INT: U5.14 (INT); also elsewhere on the board
IMU1_CAP: C42.2, U10.9 (CAP)
IMU1_INT: U10.14 (INT); also elsewhere on the board
IMU2_CAP: C29.2, U7.9 (CAP)
IMU2_INT: U7.14 (INT); also elsewhere on the board
TEMP_IMU0: RT4.2; also elsewhere on the board
TEMP_IMU1: RT8.2; also elsewhere on the board
TEMP_IMU2: RT6.2; also elsewhere on the board

Notes on the sheet:
CAD Note: Decoupling
<3B3>
<3B3
3B3>
3B3>
3B5>
3B5>
<3B6>
<3B6
CAD Note: Thermally Connected
7A1>
Note: Addr = 0x28 | R/!W
Note: Addr = 0x29 | R/!W
<3B5

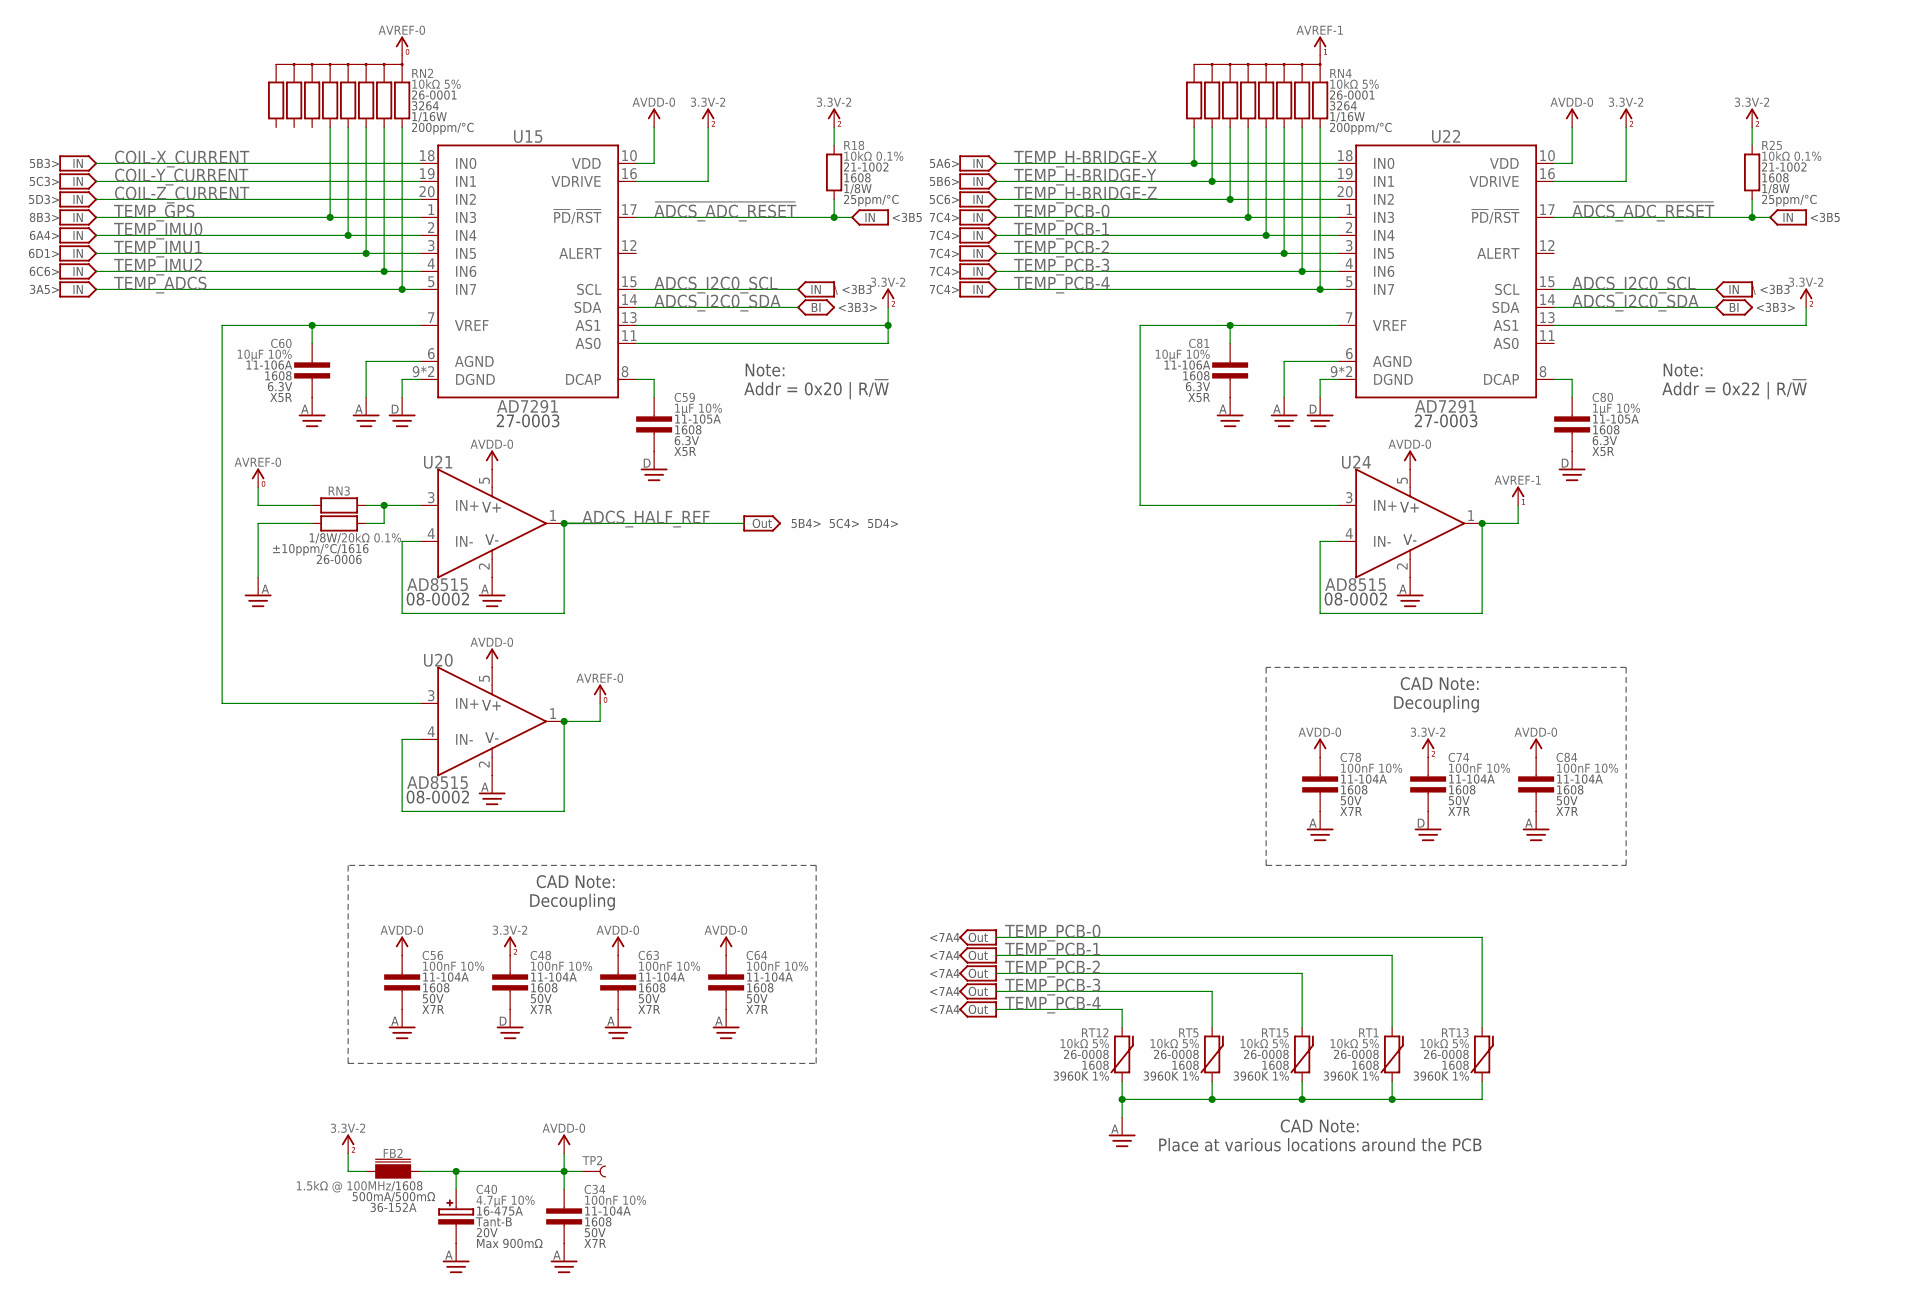
[picture p327: schematic Avionics.sch, sheet 7]

Parts:
C34, C48, C56, C63, C64, C74, C78, C84: 100nF 10%; 1608
C40: 4.7µF 10%; 4028-POL
C59, C80: 1µF 10%; 1608
C60, C81: 10µF 10%; 1608
FB2: 1.5kΩ @ 100MHz; 1608
R18, R25: 10kΩ 0.1%; 1608
RN2, RN4: 10kΩ 5%; 3264
RN3: 20kΩ 0.1%; 1616
RT1, RT5, RT12, RT13, RT15: 10kΩ 5%; 1608
TP2: TEST_POINT-SMD-C-1.25; SMD-C-1.25
U15, U22: AD7291; QFN-20-4040
U20, U21, U24: AD8515; SOT23-5

Connections:
3.3V_2: C48.1, C74.1, FB2.1, R18.2, R25.2, U15.11 (AS0), U15.13 (AS1), U15.16 (VDRIVE), U22.13 (AS1), U22.16 (VDRIVE); also elsewhere on the board
!ADCS_ADC_RESET!: R18.1, R25.1, U15.17 (!PD!/!RST), U22.17 (!PD!/!RST); also elsewhere on the board
ADCS_ADC0_DCAP: C59.1, U15.8 (DCAP)
ADCS_ADC0_VREF: C60.1, U15.7 (VREF), U20.3 (IN+)
ADCS_ADC1_DCAP: C80.1, U22.8 (DCAP)
ADCS_ADC1_VREF: C81.1, U22.7 (VREF), U24.3 (IN+)
ADCS_HALF_REF: U21.1 (OUT), U21.4 (IN-); also elsewhere on the board
ADCS_HALF_REF_UNBUFF: RN3.1 (A1), RN3.2 (B1), U21.3 (IN+)
ADCS_I2C0_SCL: U15.15 (SCL), U22.15 (SCL); also elsewhere on the board
ADCS_I2C0_SDA: U15.14 (SDA), U22.14 (SDA); also elsewhere on the board
AGND: C34.2, C40.C, C56.2, C60.2, C63.2, C64.2, C78.2, C81.2, C84.2, RN3.4 (A2), RT1.1, RT5.1, RT12.1, RT13.1, RT15.1, U15.6 (AGND), U20.2 (V-), U21.2 (V-), U22.6 (AGND), U24.2 (V-); also elsewhere on the board
AVDD-0: C34.1, C40.A, C56.1, C63.1, C64.1, C78.1, C84.1, FB2.2, TP2.1, U15.10 (VDD), U20.5 (V+), U21.5 (V+), U22.10 (VDD), U24.5 (V+); also elsewhere on the board
AVREF-0: RN2.5 (C), RN2.10 (C), RN3.3 (B2), U20.1 (OUT), U20.4 (IN-)
AVREF-1: RN4.5 (C), RN4.10 (C), U24.1 (OUT), U24.4 (IN-)
COIL-X_CURRENT: U15.18 (IN0); also elsewhere on the board
COIL-Y_CURRENT: U15.19 (IN1); also elsewhere on the board
COIL-Z_CURRENT: U15.20 (IN2); also elsewhere on the board
DGND: C48.2, C59.2, C74.2, C80.2, U15.9 (DGND), U15.PAD (DGND), U22.9 (DGND), U22.PAD (DGND); also elsewhere on the board
TEMP_ADCS: RN2.1, U15.5 (IN7); also elsewhere on the board
TEMP_GPS: RN2.6 (5), U15.1 (IN3); also elsewhere on the board
TEMP_H-BRIDGE-X: RN4.9 (8), U22.18 (IN0); also elsewhere on the board
TEMP_H-BRIDGE-Y: RN4.8 (7), U22.19 (IN1); also elsewhere on the board
TEMP_H-BRIDGE-Z: RN4.7 (6), U22.20 (IN2); also elsewhere on the board
TEMP_IMU0: RN2.4, U15.2 (IN4); also elsewhere on the board
TEMP_IMU1: RN2.3, U15.3 (IN5); also elsewhere on the board
TEMP_IMU2: RN2.2, U15.4 (IN6); also elsewhere on the board
TEMP_PCB-0: RN4.6 (5), RT13.2, U22.1 (IN3)
TEMP_PCB-1: RN4.4, RT1.2, U22.2 (IN4)
TEMP_PCB-2: RN4.3, RT15.2, U22.3 (IN5)
TEMP_PCB-3: RN4.2, RT5.2, U22.4 (IN6)
TEMP_PCB-4: RN4.1, RT12.2, U22.5 (IN7)

Notes on the sheet:
CAD Note: Decoupling
\ <3B3
<3B3>
5B4> 5C4> 5D4>
5B3>
5C3>
5D3>
8B3>
6A4>
6D1>
6C6>
3A5>
5A6>
5B6>
5C6>
Note: Addr = 0x20 | R/!W
Note: Addr = 0x22 | R/!W
CAD Note: Place at various locations around the PCB
<3B5
7C4>
<7A4
