CougsInSpace/CougSat1-Hardware/CougSat1-AvionicBoard/ElectricalDesign/Avionics.brd

## EAGLE design CougSat1-AvionicBoard/ElectricalDesign/Avionics.brd (continued)

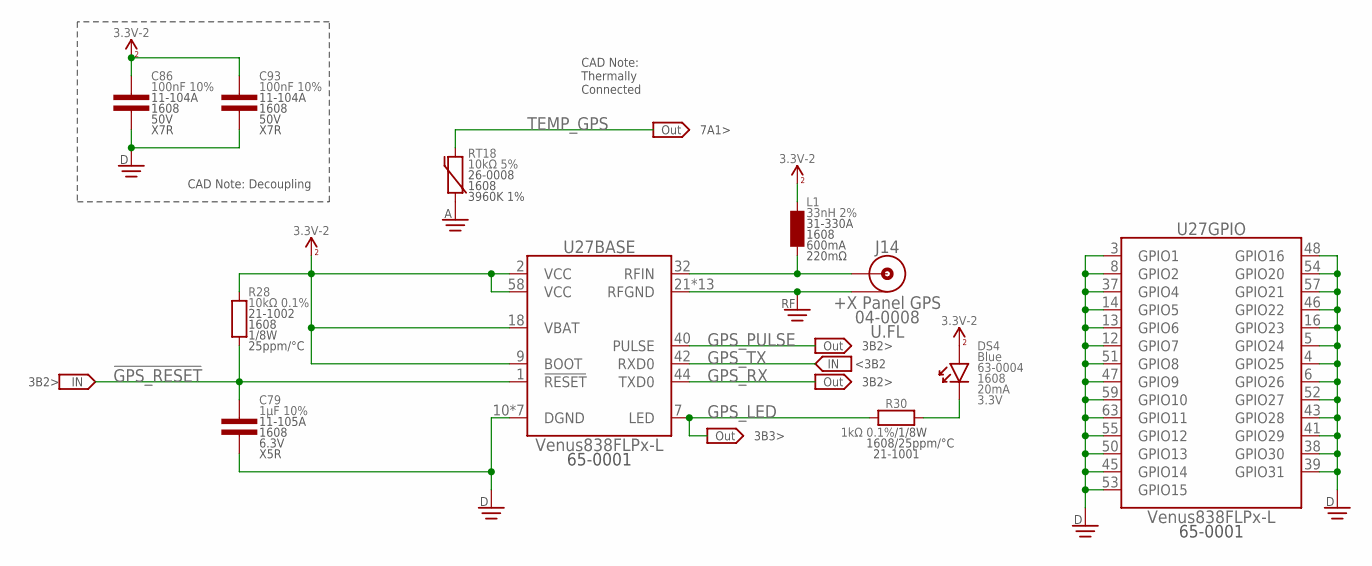
[picture p328: schematic Avionics.sch, sheet 8]

Parts:
C79: 1µF 10%; 1608
C86, C93: 100nF 10%; 1608
DS4: Blue; 1608-POL
J14: +X Panel GPS; U.FL
L1: 33nH 2%; 1608
R28: 10kΩ 0.1%; 1608
R30: 1kΩ 0.1%; 1608
RT18: 10kΩ 5%; 1608
U27: Venus838FLPx-L; VENUS-1010

Connections:
3.3V_2: C86.1, C93.1, DS4.A, L1.2, R28.2, U27.2 (VCC), U27.9 (BOOT), U27.18 (VBAT), U27.58 (VCC); also elsewhere on the board
!GPS_RESET: C79.1, R28.1, U27.1 (!RESET); also elsewhere on the board
AGND: RT18.1; also elsewhere on the board
DGND: C79.2, C86.2, C93.2, U27.3 (GPIO1), U27.4 (GPIO25), U27.5 (GPIO24), U27.6 (GPIO26), U27.8 (GPIO2), U27.10 (DGND), U27.11 (DGND), U27.12 (GPIO7), U27.13 (GPIO6), U27.14 (GPIO5), U27.15 (DGND), U27.16 (GPIO23), U27.19 (DGND), U27.37 (GPIO4), U27.38 (GPIO30), U27.39 (GPIO31), U27.41 (GPIO29), U27.43 (GPIO28), U27.45 (GPIO14), U27.46 (GPIO22), U27.47 (GPIO9), U27.48 (GPIO16), U27.49 (DGND), U27.50 (GPIO13), U27.51 (GPIO8), U27.52 (GPIO27), U27.53 (GPIO15), U27.54 (GPIO20), U27.55 (GPIO12), U27.57 (GPIO21), U27.59 (GPIO10), U27.60 (DGND), U27.63 (GPIO11), U27.64 (DGND); also elsewhere on the board
GPS_LED: R30.1, U27.7 (LED); also elsewhere on the board
GPS_LED_DIODE: DS4.C, R30.2
GPS_PULSE: U27.40 (PULSE); also elsewhere on the board
GPS_RFIN: J14.CENTER, L1.1, U27.32 (RFIN)
GPS_RX: U27.44 (TXD0); also elsewhere on the board
GPS_TX: U27.42 (RXD0); also elsewhere on the board
RFGND: J14.SHIELD@1 (SHIELD), J14.SHIELD@2 (SHIELD), J14.SHIELD@13 (SHIELD), U27.21 (RFGND), U27.22 (RFGND), U27.24 (RFGND), U27.25 (RFGND), U27.27 (RFGND), U27.28 (RFGND), U27.29 (RFGND), U27.31 (RFGND), U27.33 (RFGND), U27.61 (RFGND), U27.62 (RFGND), U27.65 (RFGND), U27.69 (RFGND); also elsewhere on the board
TEMP_GPS: RT18.2; also elsewhere on the board

Notes on the sheet:
CAD Note: Decoupling
3B2>
<3B2
3B3>
3B2>
CAD Note: Thermally Connected
7A1>

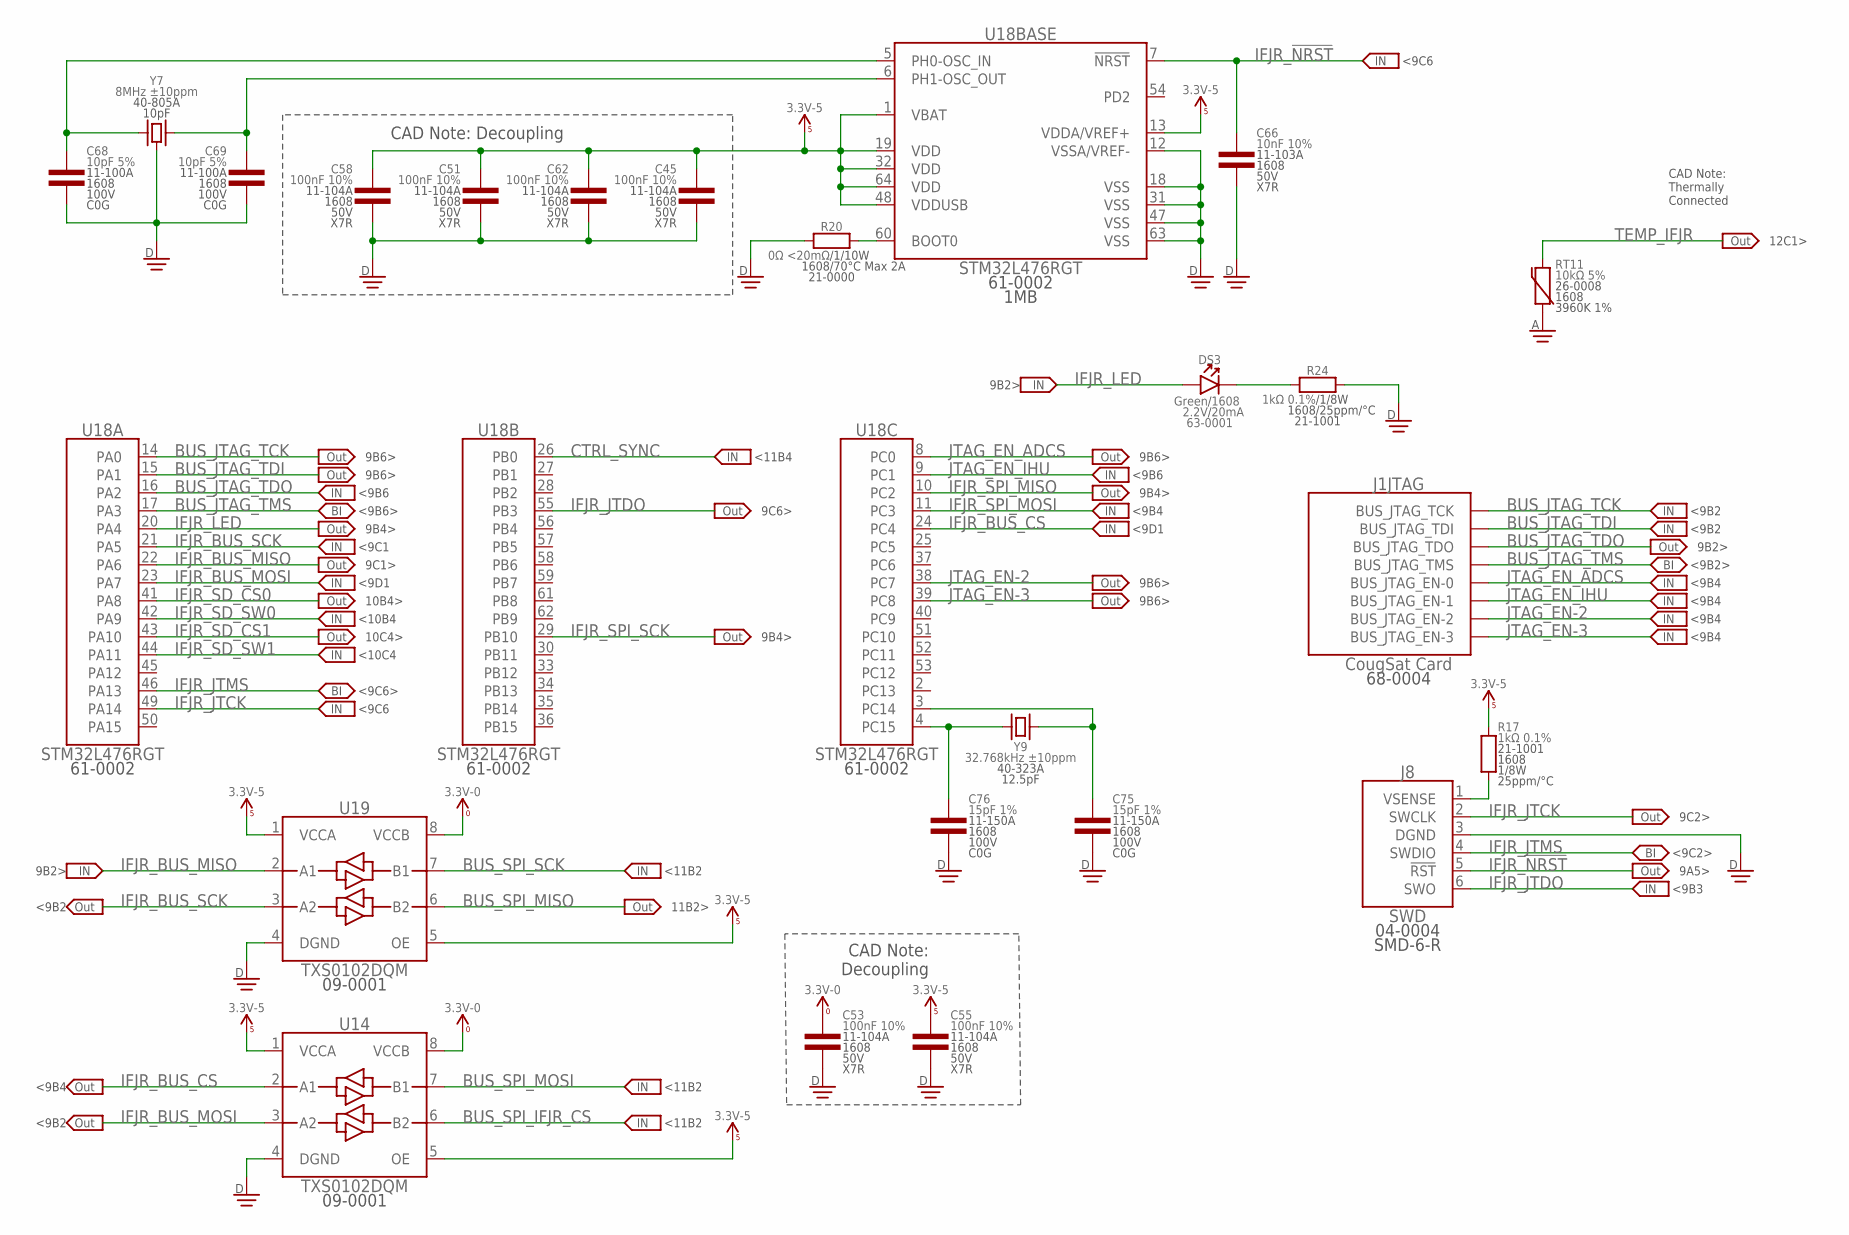
[picture p329: schematic Avionics.sch, sheet 9]

Parts:
C45, C51, C53, C55, C58, C62: 100nF 10%; 1608
C66: 10nF 10%; 1608
C68, C69: 10pF 5%; 1608
C75, C76: 15pF 1%; 1608
DS3: Green; 1608-POL
J1: CougSat Card; CARD-FULL
J8: SWD; SMD2.54-1X06-R
R17, R24: 1kΩ 0.1%; 1608
R20: 0Ω <20mΩ; 1608
RT11: 10kΩ 5%; 1608
U14, U19: TXS0102DQM; X2SON-8
U18: STM32L476RGT; QFP-64-1010
Y7: 8MHz ±10ppm; SMD-5032
Y9: 32.768kHz ±10ppm; SMD-3215

Connections:
3.3V_0: C53.1, U14.8 (VCCB), U19.8 (VCCB); also elsewhere on the board
3.3V_5: C45.1, C51.1, C55.1, C58.1, C62.1, R17.2, U14.1 (VCCA), U14.5 (OE), U18.1 (VBAT), U18.13 (VDDA/VREF+), U18.19 (VDD), U18.32 (VDD), U18.48 (VDDUSB), U18.64 (VDD), U19.1 (VCCA), U19.5 (OE); also elsewhere on the board
AGND: RT11.1; also elsewhere on the board
BUS_JTAG_TCK: J1.A46 (BUS_JTAG_TCK), U18.14 (PA0); also elsewhere on the board
BUS_JTAG_TDI: J1.A47 (BUS_JTAG_TDI), U18.15 (PA1); also elsewhere on the board
BUS_JTAG_TDO: J1.A48 (BUS_JTAG_TDO), U18.16 (PA2); also elsewhere on the board
BUS_JTAG_TMS: J1.A49 (BUS_JTAG_TMS), U18.17 (PA3); also elsewhere on the board
BUS_SPI_IFJR_CS: U14.6 (B2); also elsewhere on the board
BUS_SPI_MISO: U19.6 (B2); also elsewhere on the board
BUS_SPI_MOSI: U14.7 (B1); also elsewhere on the board
BUS_SPI_SCK: U19.7 (B1); also elsewhere on the board
CTRL_SYNC: U18.26 (PB0); also elsewhere on the board
DGND: C45.2, C51.2, C53.2, C55.2, C58.2, C62.2, C66.2, C68.2, C69.2, C75.2, C76.2, J8.3 (DGND), R20.1, R24.2, U14.4 (DGND), U18.12 (VSSA/VREF-), U18.18 (VSS), U18.31 (VSS), U18.47 (VSS), U18.63 (VSS), U19.4 (DGND), Y7.2 (GND), Y7.4 (GND); also elsewhere on the board
IFJR_!NRST: C66.1, J8.5 (!RST), U18.7 (!NRST)
IFJR_BOOT0: R20.2, U18.60 (BOOT0)
IFJR_BUS_CS: U14.2 (A1), U18.24 (PC4)
IFJR_BUS_MISO: U18.22 (PA6), U19.2 (A1)
IFJR_BUS_MOSI: U14.3 (A2), U18.23 (PA7)
IFJR_BUS_SCK: U18.21 (PA5), U19.3 (A2)
IFJR_JTCK: J8.2 (SWCLK), U18.49 (PA14)
IFJR_JTDO: J8.6 (SWO), U18.55 (PB3)
IFJR_JTMS: J8.4 (SWDIO), U18.46 (PA13)
IFJR_LED: DS3.A, U18.20 (PA4)
IFJR_LED_GND: DS3.C, R24.1
IFJR_OSC_32_IN: C76.1, U18.4 (PC15), Y9.1
IFJR_OSC_32_OUT: C75.1, U18.3 (PC14), Y9.2
IFJR_OSC_IN: C68.1, U18.5 (PH0-OSC_IN), Y7.1
IFJR_OSC_OUT: C69.1, U18.6 (PH1-OSC_OUT), Y7.3 (2)
IFJR_SD_CS0: U18.41 (PA8); also elsewhere on the board
IFJR_SD_CS1: U18.43 (PA10); also elsewhere on the board
IFJR_SD_SW0: U18.42 (PA9); also elsewhere on the board
IFJR_SD_SW1: U18.44 (PA11); also elsewhere on the board
IFJR_SPI_MISO: U18.10 (PC2); also elsewhere on the board
IFJR_SPI_MOSI: U18.11 (PC3); also elsewhere on the board
IFJR_SPI_SCK: U18.29 (PB10); also elsewhere on the board
IFJR_SWD_VSENSE: J8.1 (VSENSE), R17.1
JTAG_EN-2: J1.B48 (BUS_JTAG_EN-2), U18.38 (PC7)
JTAG_EN-3: J1.B49 (BUS_JTAG_EN-3), U18.39 (PC8)
JTAG_EN_ADCS: J1.B46 (BUS_JTAG_EN-0), U18.8 (PC0); also elsewhere on the board
JTAG_EN_IHU: J1.B47 (BUS_JTAG_EN-1), U18.9 (PC1); also elsewhere on the board
PR_3.3V-1: J1.A2 (PR_3.3V-1), J1.B2 (PR_3.3V-1)
PR_3.3V-3: J1.A4 (PR_3.3V-3), J1.B4 (PR_3.3V-3)
PR_3.3V-4: J1.A5 (PR_3.3V-4), J1.B5 (PR_3.3V-4)
PR_3.3V-6: J1.A7 (PR_3.3V-6), J1.B7 (PR_3.3V-6)
PR_3.3V-7: J1.A8 (PR_3.3V-7), J1.B8 (PR_3.3V-7)
PR_3.3V-8: J1.A9 (PR_3.3V-8), J1.B9 (PR_3.3V-8)
PR_3.3V-9: J1.A10 (PR_3.3V-9), J1.B10 (PR_3.3V-9)
PR_3.3V-10: J1.A11 (PR_3.3V-10), J1.B11 (PR_3.3V-10)
PR_3.3V-11: J1.A12 (PR_3.3V-11), J1.B12 (PR_3.3V-11)
PR_3.3V-12: J1.A13 (PR_3.3V-12), J1.B13 (PR_3.3V-12)
PR_BATT-0: J1.A14 (PR_BATT-0), J1.B14 (PR_BATT-0)
PR_BATT-1: J1.A15 (PR_BATT-1), J1.B15 (PR_BATT-1)
PR_BATT-2: J1.A16 (PR_BATT-2), J1.B16 (PR_BATT-2)
PR_BATT-3: J1.A17 (PR_BATT-3), J1.B17 (PR_BATT-3)
PR_BATT-4: J1.A18 (PR_BATT-4), J1.B18 (PR_BATT-4)
PR_BATT-6: J1.A20 (PR_BATT-6), J1.B20 (PR_BATT-6)
TEMP_IFJR: RT11.2; also elsewhere on the board

Notes on the sheet:
9B6>
<9B6>
<9B6
<9B2
9B2>
<9B2>
<9B4
<9C6
<9C6>
9C6>
9C2>
<9C2>
<9B3
9A5>
<11B4
CAD Note: Decoupling
9B2>
CAD Note: Thermally Connected
12C1>
9B4>
<9C1
9C1>
<9D1
10B4>
<10B4
10C4>
<10C4
<11B2
11B2>
<9B2
CAD Note: Decoupling
<9B4

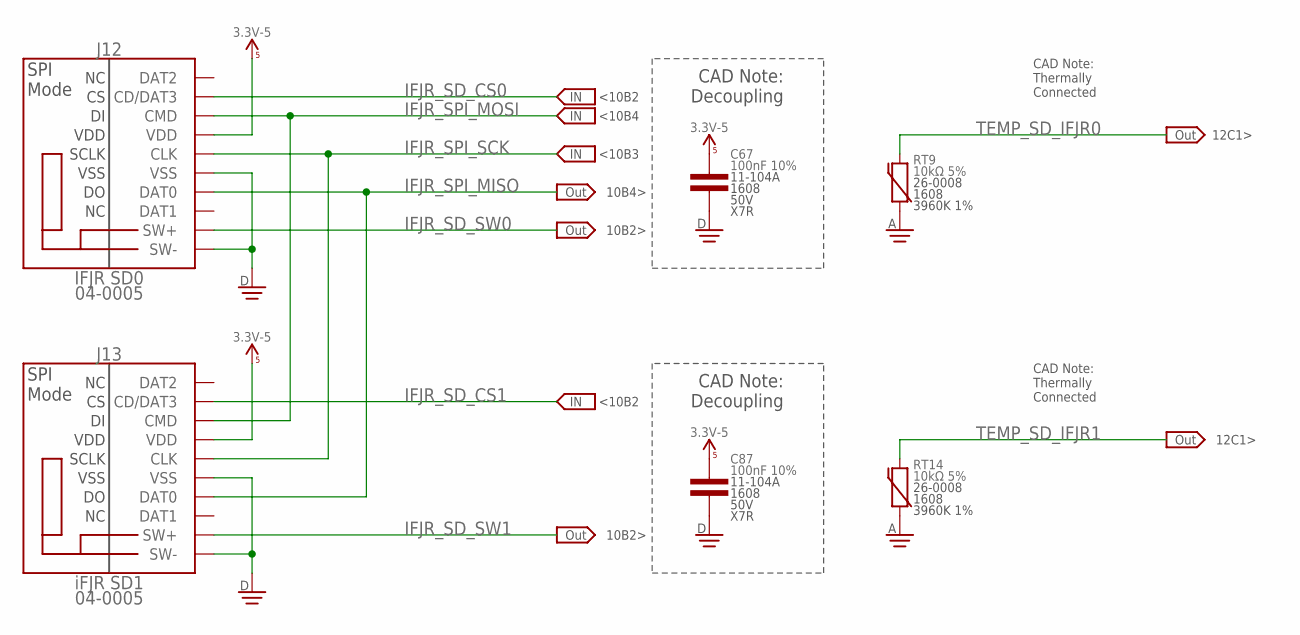
[picture p330: schematic Avionics.sch, sheet 10]

Parts:
C67, C87: 100nF 10%; 1608
J12: IFJR SD0; µSD-PUSH-PUSH
J13: iFJR SD1; µSD-PUSH-PUSH
RT9, RT14: 10kΩ 5%; 1608

Connections:
3.3V_5: C67.1, C87.1, J12.VDD, J13.VDD; also elsewhere on the board
AGND: RT9.1, RT14.1; also elsewhere on the board
DGND: C67.2, C87.2, J12.SW-LEVER (SW-), J12.VSS, J13.SW-LEVER (SW-), J13.VSS; also elsewhere on the board
IFJR_SD_CS0: J12.CD/DAT3; also elsewhere on the board
IFJR_SD_CS1: J13.CD/DAT3; also elsewhere on the board
IFJR_SD_SW0: J12.SW (SW+); also elsewhere on the board
IFJR_SD_SW1: J13.SW (SW+); also elsewhere on the board
IFJR_SPI_MISO: J12.DAT0, J13.DAT0; also elsewhere on the board
IFJR_SPI_MOSI: J12.CMD, J13.CMD; also elsewhere on the board
IFJR_SPI_SCK: J12.CLK, J13.CLK; also elsewhere on the board
TEMP_SD_IFJR0: RT9.2; also elsewhere on the board
TEMP_SD_IFJR1: RT14.2; also elsewhere on the board

Notes on the sheet:
CAD Note: Decoupling
<10B4
<10B3
10B4>
10B2>
<10B2
CAD Note: Thermally Connected
12C1>
12C1>

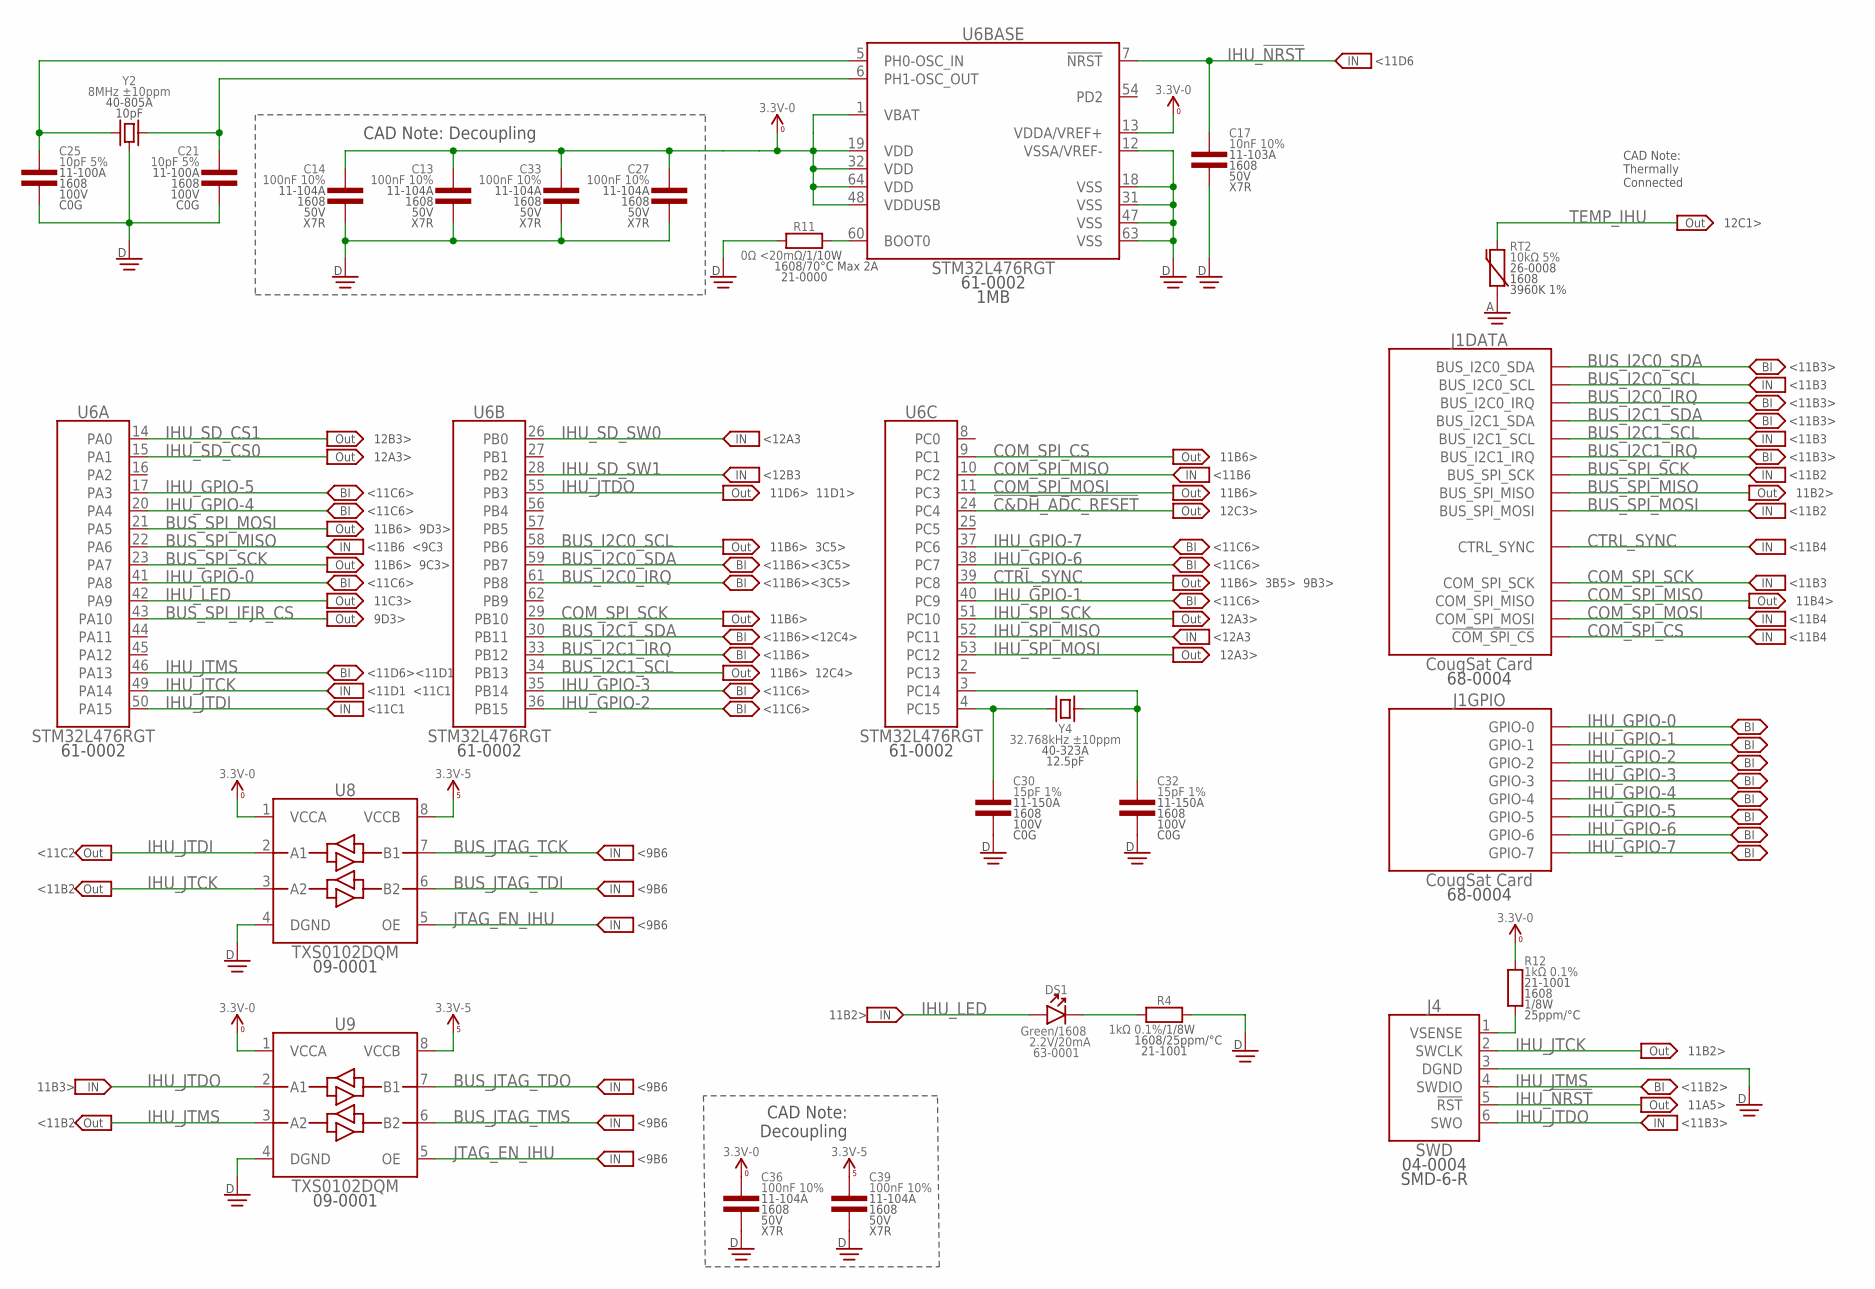
[picture p331: schematic Avionics.sch, sheet 11]

Parts:
C13, C14, C27, C33, C36, C39: 100nF 10%; 1608
C17: 10nF 10%; 1608
C21, C25: 10pF 5%; 1608
C30, C32: 15pF 1%; 1608
DS1: Green; 1608-POL
J1: CougSat Card; CARD-FULL
J4: SWD; SMD2.54-1X06-R
R4, R12: 1kΩ 0.1%; 1608
R11: 0Ω <20mΩ; 1608
RT2: 10kΩ 5%; 1608
U6: STM32L476RGT; QFP-64-1010
U8, U9: TXS0102DQM; X2SON-8
Y2: 8MHz ±10ppm; SMD-5032
Y4: 32.768kHz ±10ppm; SMD-3215

Connections:
3.3V_0: C13.1, C14.1, C27.1, C33.1, C36.1, R12.2, U6.1 (VBAT), U6.13 (VDDA/VREF+), U6.19 (VDD), U6.32 (VDD), U6.48 (VDDUSB), U6.64 (VDD), U8.1 (VCCA), U9.1 (VCCA); also elsewhere on the board
3.3V_5: C39.1, U8.8 (VCCB), U9.8 (VCCB); also elsewhere on the board
!C&DH_ADC_RESET: U6.24 (PC4); also elsewhere on the board
AGND: RT2.1; also elsewhere on the board
BUS_I2C0_IRQ: J1.A45 (BUS_I2C0_IRQ), J1.B45 (BUS_I2C0_IRQ), U6.61 (PB8); also elsewhere on the board
BUS_I2C0_SCL: J1.A44 (BUS_I2C0_SCL), J1.B44 (BUS_I2C0_SCL), U6.58 (PB6); also elsewhere on the board
BUS_I2C0_SDA: J1.A43 (BUS_I2C0_SDA), J1.B43 (BUS_I2C0_SDA), U6.59 (PB7); also elsewhere on the board
BUS_I2C1_IRQ: J1.A32 (BUS_I2C1_IRQ), J1.B32 (BUS_I2C1_IRQ), U6.33 (PB12)
BUS_I2C1_SCL: J1.A31 (BUS_I2C1_SCL), J1.B31 (BUS_I2C1_SCL), U6.34 (PB13); also elsewhere on the board
BUS_I2C1_SDA: J1.A30 (BUS_I2C1_SDA), J1.B30 (BUS_I2C1_SDA), U6.30 (PB11); also elsewhere on the board
BUS_JTAG_TCK: U8.7 (B1); also elsewhere on the board
BUS_JTAG_TDI: U8.6 (B2); also elsewhere on the board
BUS_JTAG_TDO: U9.7 (B1); also elsewhere on the board
BUS_JTAG_TMS: U9.6 (B2); also elsewhere on the board
BUS_SPI_IFJR_CS: U6.43 (PA10); also elsewhere on the board
BUS_SPI_MISO: J1.A38 (BUS_SPI_MISO), J1.B38 (BUS_SPI_MISO), U6.22 (PA6); also elsewhere on the board
BUS_SPI_MOSI: J1.A39 (BUS_SPI_MOSI), J1.B39 (BUS_SPI_MOSI), U6.21 (PA5); also elsewhere on the board
BUS_SPI_SCK: J1.A37 (BUS_SPI_SCK), J1.B37 (BUS_SPI_SCK), U6.23 (PA7); also elsewhere on the board
COM_SPI_CS: J1.A36 (!COM_SPI_CS), J1.B36 (!COM_SPI_CS), U6.9 (PC1)
COM_SPI_MISO: J1.A34 (COM_SPI_MISO), J1.B34 (COM_SPI_MISO), U6.10 (PC2)
COM_SPI_MOSI: J1.A35 (COM_SPI_MOSI), J1.B35 (COM_SPI_MOSI), U6.11 (PC3)
COM_SPI_SCK: J1.A33 (COM_SPI_SCK), J1.B33 (COM_SPI_SCK), U6.29 (PB10)
CTRL_SYNC: J1.A42 (CTRL_SYNC), J1.B42 (CTRL_SYNC), U6.39 (PC8); also elsewhere on the board
DGND: C13.2, C14.2, C17.2, C21.2, C25.2, C27.2, C30.2, C32.2, C33.2, C36.2, C39.2, J4.3 (DGND), R4.2, R11.1, U6.12 (VSSA/VREF-), U6.18 (VSS), U6.31 (VSS), U6.47 (VSS), U6.63 (VSS), U8.4 (DGND), U9.4 (DGND), Y2.2 (GND), Y2.4 (GND); also elsewhere on the board
IHU_!NRST: C17.1, J4.5 (!RST), U6.7 (!NRST)
IHU_BOOT0: R11.2, U6.60 (BOOT0)
IHU_GPIO-0: J1.A24 (GPIO-0), U6.41 (PA8)
IHU_GPIO-1: J1.A25 (GPIO-1), U6.40 (PC9)
IHU_GPIO-2: J1.A26 (GPIO-2), U6.36 (PB15)
IHU_GPIO-3: J1.A27 (GPIO-3), U6.35 (PB14)
IHU_GPIO-4: J1.A28 (GPIO-4), U6.20 (PA4)
IHU_GPIO-5: J1.A29 (GPIO-5), U6.17 (PA3)
IHU_GPIO-6: J1.A41 (GPIO-6), U6.38 (PC7)
IHU_GPIO-7: J1.B41 (GPIO-7), U6.37 (PC6)
IHU_JTCK: J4.2 (SWCLK), U6.49 (PA14), U8.3 (A2)
IHU_JTDI: U6.50 (PA15), U8.2 (A1)
IHU_JTDO: J4.6 (SWO), U6.55 (PB3), U9.2 (A1)
IHU_JTMS: J4.4 (SWDIO), U6.46 (PA13), U9.3 (A2)
IHU_LED: DS1.A, U6.42 (PA9)
IHU_LED_GND: DS1.C, R4.1
IHU_OSC_32_IN: C30.1, U6.4 (PC15), Y4.1
IHU_OSC_32_OUT: C32.1, U6.3 (PC14), Y4.2
IHU_OSC_IN: C25.1, U6.5 (PH0-OSC_IN), Y2.1
IHU_OSC_OUT: C21.1, U6.6 (PH1-OSC_OUT), Y2.3 (2)
IHU_SD_CS0: U6.15 (PA1); also elsewhere on the board
IHU_SD_CS1: U6.14 (PA0); also elsewhere on the board
IHU_SD_SW0: U6.26 (PB0); also elsewhere on the board
IHU_SD_SW1: U6.28 (PB2); also elsewhere on the board
IHU_SPI_MISO: U6.52 (PC11); also elsewhere on the board
IHU_SPI_MOSI: U6.53 (PC12); also elsewhere on the board
IHU_SPI_SCK: U6.51 (PC10); also elsewhere on the board
IHU_SWD_VSENSE: J4.1 (VSENSE), R12.1
JTAG_EN_IHU: U8.5 (OE), U9.5 (OE); also elsewhere on the board
PR_3.3V-1: J1.A2 (PR_3.3V-1), J1.B2 (PR_3.3V-1)
PR_3.3V-3: J1.A4 (PR_3.3V-3), J1.B4 (PR_3.3V-3)
PR_3.3V-4: J1.A5 (PR_3.3V-4), J1.B5 (PR_3.3V-4)
PR_3.3V-6: J1.A7 (PR_3.3V-6), J1.B7 (PR_3.3V-6)
PR_3.3V-7: J1.A8 (PR_3.3V-7), J1.B8 (PR_3.3V-7)
PR_3.3V-8: J1.A9 (PR_3.3V-8), J1.B9 (PR_3.3V-8)
PR_3.3V-9: J1.A10 (PR_3.3V-9), J1.B10 (PR_3.3V-9)
PR_3.3V-10: J1.A11 (PR_3.3V-10), J1.B11 (PR_3.3V-10)
PR_3.3V-11: J1.A12 (PR_3.3V-11), J1.B12 (PR_3.3V-11)
PR_3.3V-12: J1.A13 (PR_3.3V-12), J1.B13 (PR_3.3V-12)
PR_BATT-0: J1.A14 (PR_BATT-0), J1.B14 (PR_BATT-0)
PR_BATT-1: J1.A15 (PR_BATT-1), J1.B15 (PR_BATT-1)
PR_BATT-2: J1.A16 (PR_BATT-2), J1.B16 (PR_BATT-2)
PR_BATT-3: J1.A17 (PR_BATT-3), J1.B17 (PR_BATT-3)
PR_BATT-4: J1.A18 (PR_BATT-4), J1.B18 (PR_BATT-4)
PR_BATT-6: J1.A20 (PR_BATT-6), J1.B20 (PR_BATT-6)
TEMP_IHU: RT2.2; also elsewhere on the board

Notes on the sheet:
11B6> 3C5>
<11B6><3C5>
11B6> 12C4>
<11B6><12C4>
<11B6>
<11C6>
<11B2
11B2>
12A3>
<12A3
<12B3
<11B3>
<11B3
<11B3
11B6>
<11B6
<11B4
11B4>
<11D1 <11C1
<11D6><11D1
11D6> 11D1>
<11B2>
11B6> 3B5> 9B3>
11A5>
<11B2
11B3>
<9B6
<11C1
CAD Note: Decoupling
11B2>
11C3>
CAD Note: Thermally Connected
12C1>
12C3>
9D3>
<11D6
CAD Note: Decoupling
<11C2
12B3>
<11B6 <9C3
11B6> 9D3>
11B6> 9C3>

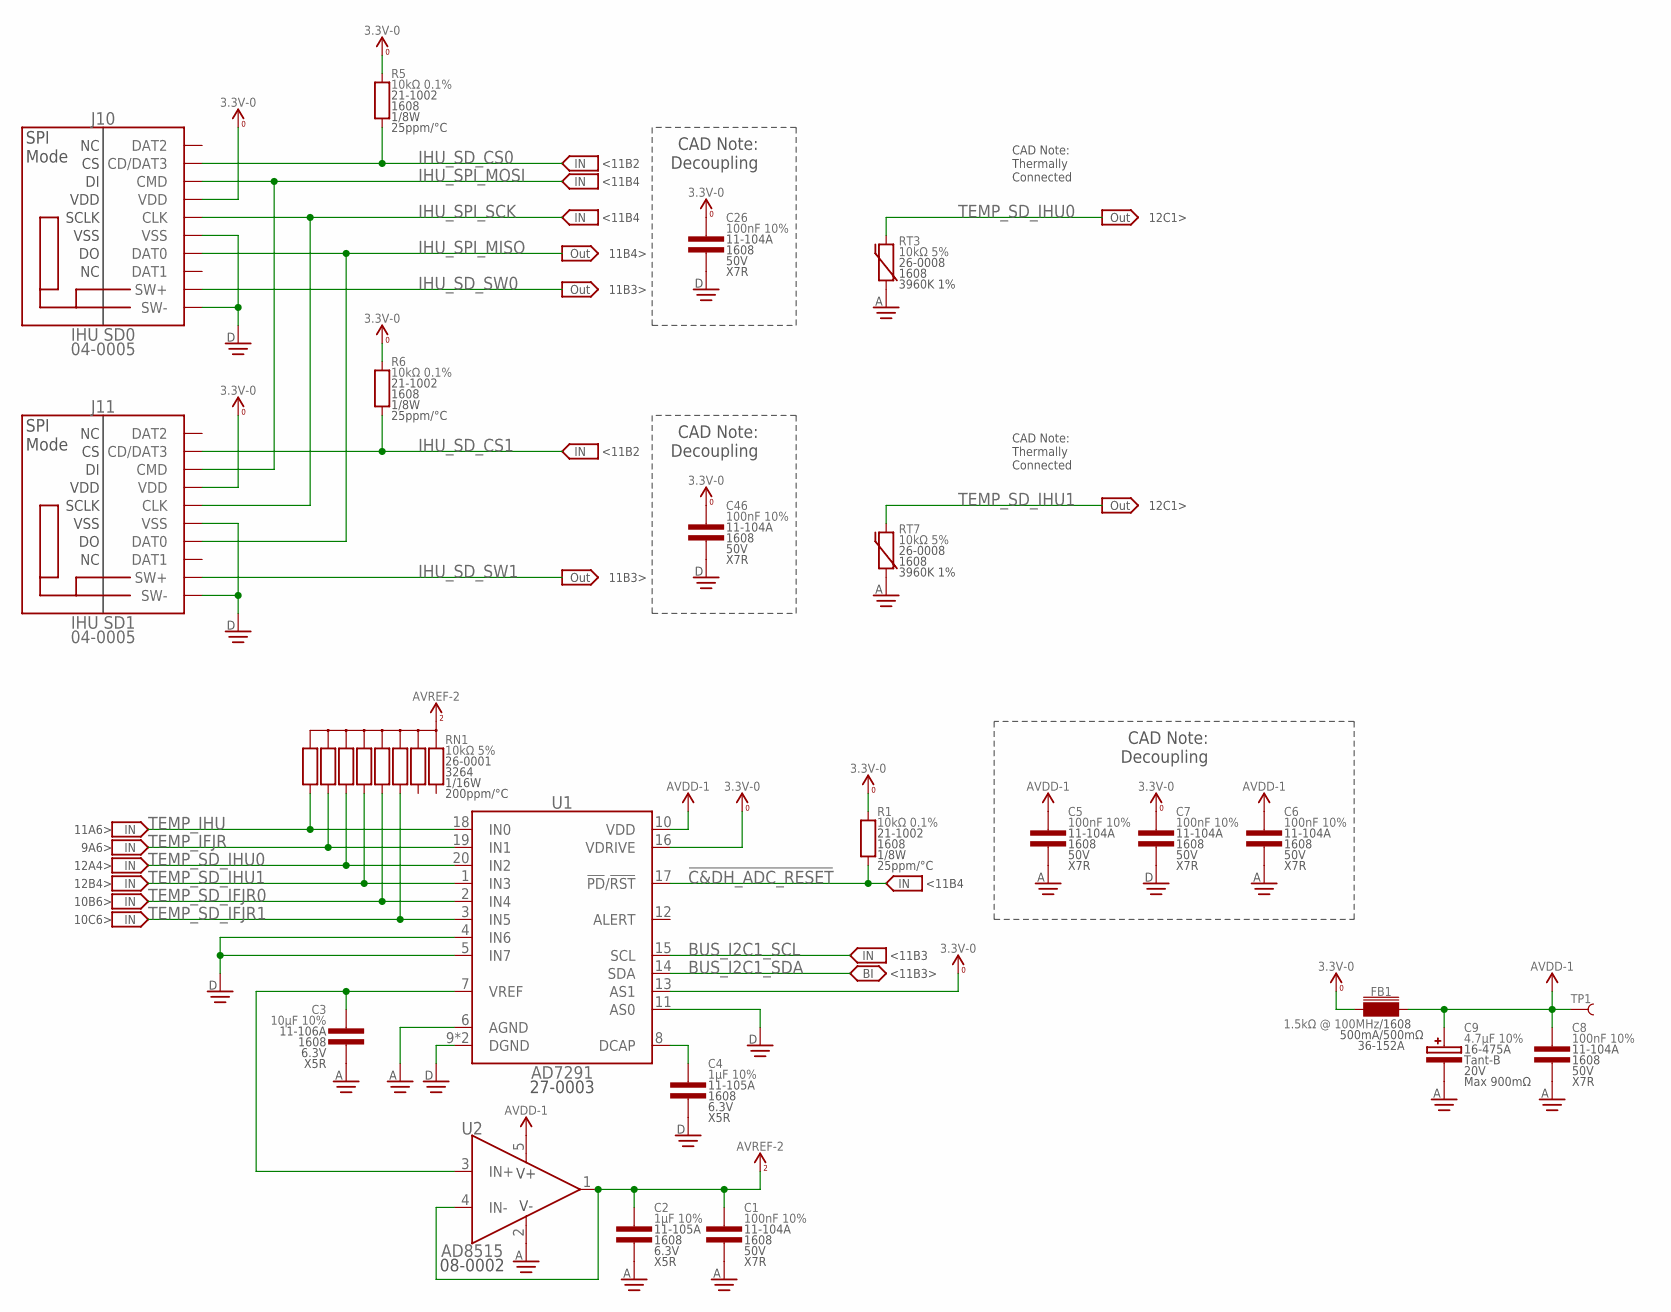
[picture p332: schematic Avionics.sch, sheet 12]

Parts:
C1, C5, C6, C7, C8, C26, C46: 100nF 10%; 1608
C2, C4: 1µF 10%; 1608
C3: 10µF 10%; 1608
C9: 4.7µF 10%; 4028-POL
FB1: 1.5kΩ @ 100MHz; 1608
J10: IHU SD0; µSD-PUSH-PUSH
J11: IHU SD1; µSD-PUSH-PUSH
R1, R5, R6: 10kΩ 0.1%; 1608
RN1: 10kΩ 5%; 3264
RT3, RT7: 10kΩ 5%; 1608
TP1: TEST_POINT-SMD-C-1.25; SMD-C-1.25
U1: AD7291; QFN-20-4040
U2: AD8515; SOT23-5

Connections:
3.3V_0: C7.1, C26.1, C46.1, FB1.1, J10.VDD, J11.VDD, R1.2, R5.2, R6.2, U1.13 (AS1), U1.16 (VDRIVE); also elsewhere on the board
!C&DH_ADC_RESET: R1.1, U1.17 (!PD!/!RST); also elsewhere on the board
AGND: C1.2, C2.2, C3.2, C5.2, C6.2, C8.2, C9.C, RT3.1, RT7.1, U1.6 (AGND), U2.2 (V-); also elsewhere on the board
AVDD-1: C5.1, C6.1, C8.1, C9.A, FB1.2, TP1.1, U1.10 (VDD), U2.5 (V+)
AVREF-2: C1.1, C2.1, RN1.5 (C), RN1.10 (C), U2.1 (OUT), U2.4 (IN-)
BUS_I2C1_SCL: U1.15 (SCL); also elsewhere on the board
BUS_I2C1_SDA: U1.14 (SDA); also elsewhere on the board
C&DH_ADC_DCAP: C4.1, U1.8 (DCAP)
C&DH_ADC_VREF: C3.1, U1.7 (VREF), U2.3 (IN+)
DGND: C4.2, C7.2, C26.2, C46.2, J10.SW-LEVER (SW-), J10.VSS, J11.SW-LEVER (SW-), J11.VSS, U1.4 (IN6), U1.5 (IN7), U1.9 (DGND), U1.11 (AS0), U1.PAD (DGND); also elsewhere on the board
IHU_SD_CS0: J10.CD/DAT3, R5.1; also elsewhere on the board
IHU_SD_CS1: J11.CD/DAT3, R6.1; also elsewhere on the board
IHU_SD_SW0: J10.SW (SW+); also elsewhere on the board
IHU_SD_SW1: J11.SW (SW+); also elsewhere on the board
IHU_SPI_MISO: J10.DAT0, J11.DAT0; also elsewhere on the board
IHU_SPI_MOSI: J10.CMD, J11.CMD; also elsewhere on the board
IHU_SPI_SCK: J10.CLK, J11.CLK; also elsewhere on the board
TEMP_IFJR: RN1.8 (7), U1.19 (IN1); also elsewhere on the board
TEMP_IHU: RN1.9 (8), U1.18 (IN0); also elsewhere on the board
TEMP_SD_IFJR0: RN1.4, U1.2 (IN4); also elsewhere on the board
TEMP_SD_IFJR1: RN1.3, U1.3 (IN5); also elsewhere on the board
TEMP_SD_IHU0: RN1.7 (6), RT3.2, U1.20 (IN2)
TEMP_SD_IHU1: RN1.6 (5), RT7.2, U1.1 (IN3)

Notes on the sheet:
<11B4
11B4>
<11B2
11B3>
CAD Note: Thermally Connected
12C1>
CAD Note: Decoupling
<11B3>
<11B3
11A6>
9A6>
12A4>
12B4>
10B6>
10C6>

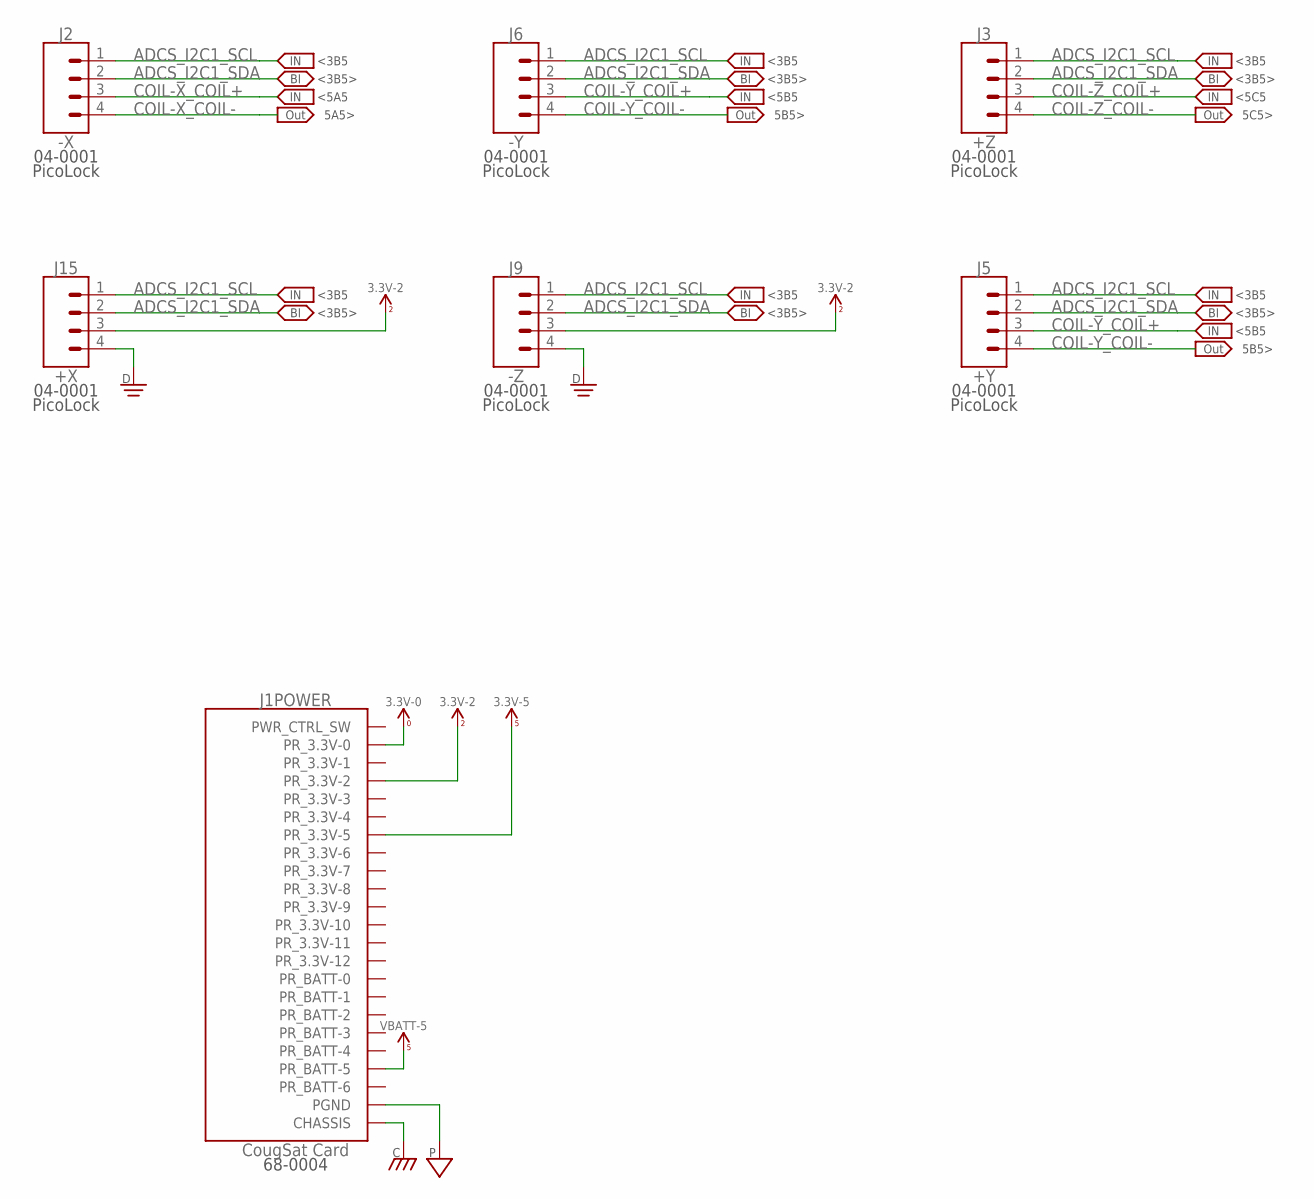
[picture p333: schematic Avionics.sch, sheet 13]

Parts:
J1: CougSat Card; CARD-FULL
J2: -X; PICOLOCK1.5-04
J3: +Z; PICOLOCK1.5-04
J5: +Y; PICOLOCK1.5-04
J6: -Y; PICOLOCK1.5-04
J9: -Z; PICOLOCK1.5-04
J15: +X; PICOLOCK1.5-04

Connections:
3.3V_0: J1.A1 (PR_3.3V-0), J1.B1 (PR_3.3V-0); also elsewhere on the board
3.3V_2: J1.A3 (PR_3.3V-2), J1.B3 (PR_3.3V-2), J9.3, J15.3; also elsewhere on the board
3.3V_5: J1.A6 (PR_3.3V-5), J1.B6 (PR_3.3V-5); also elsewhere on the board
ADCS_I2C1_SCL: J2.1, J3.1, J5.1, J6.1, J9.1, J15.1; also elsewhere on the board
ADCS_I2C1_SDA: J2.2, J3.2, J5.2, J6.2, J9.2, J15.2; also elsewhere on the board
CHASSIS: J1.CHASSIS@1 (CHASSIS), J1.CHASSIS@2 (CHASSIS), J1.CHASSIS@3 (CHASSIS), J1.CHASSIS@4 (CHASSIS); also elsewhere on the board
COIL-X_COIL+: J2.3; also elsewhere on the board
COIL-X_COIL-: J2.4; also elsewhere on the board
COIL-Y_COIL+: J5.3, J6.3; also elsewhere on the board
COIL-Y_COIL-: J5.4, J6.4; also elsewhere on the board
COIL-Z_COIL+: J3.3; also elsewhere on the board
COIL-Z_COIL-: J3.4; also elsewhere on the board
DGND: J9.4, J15.4; also elsewhere on the board
PGND: J1.A21 (PGND), J1.A22 (PGND), J1.A23 (PGND), J1.B21 (PGND), J1.B22 (PGND), J1.B23 (PGND), J1.B24 (PGND), J1.B25 (PGND), J1.B26 (PGND), J1.B27 (PGND), J1.B28 (PGND), J1.B29 (PGND); also elsewhere on the board
PR_3.3V-1: J1.A2 (PR_3.3V-1), J1.B2 (PR_3.3V-1)
PR_3.3V-3: J1.A4 (PR_3.3V-3), J1.B4 (PR_3.3V-3)
PR_3.3V-4: J1.A5 (PR_3.3V-4), J1.B5 (PR_3.3V-4)
PR_3.3V-6: J1.A7 (PR_3.3V-6), J1.B7 (PR_3.3V-6)
PR_3.3V-7: J1.A8 (PR_3.3V-7), J1.B8 (PR_3.3V-7)
PR_3.3V-8: J1.A9 (PR_3.3V-8), J1.B9 (PR_3.3V-8)
PR_3.3V-9: J1.A10 (PR_3.3V-9), J1.B10 (PR_3.3V-9)
PR_3.3V-10: J1.A11 (PR_3.3V-10), J1.B11 (PR_3.3V-10)
PR_3.3V-11: J1.A12 (PR_3.3V-11), J1.B12 (PR_3.3V-11)
PR_3.3V-12: J1.A13 (PR_3.3V-12), J1.B13 (PR_3.3V-12)
PR_BATT-0: J1.A14 (PR_BATT-0), J1.B14 (PR_BATT-0)
PR_BATT-1: J1.A15 (PR_BATT-1), J1.B15 (PR_BATT-1)
PR_BATT-2: J1.A16 (PR_BATT-2), J1.B16 (PR_BATT-2)
PR_BATT-3: J1.A17 (PR_BATT-3), J1.B17 (PR_BATT-3)
PR_BATT-4: J1.A18 (PR_BATT-4), J1.B18 (PR_BATT-4)
PR_BATT-6: J1.A20 (PR_BATT-6), J1.B20 (PR_BATT-6)
VBATT_5: J1.A19 (PR_BATT-5), J1.B19 (PR_BATT-5); also elsewhere on the board

Notes on the sheet:
<5A5
<5B5
<5C5
5C5>
5B5>
5A5>
<3B5
<3B5>

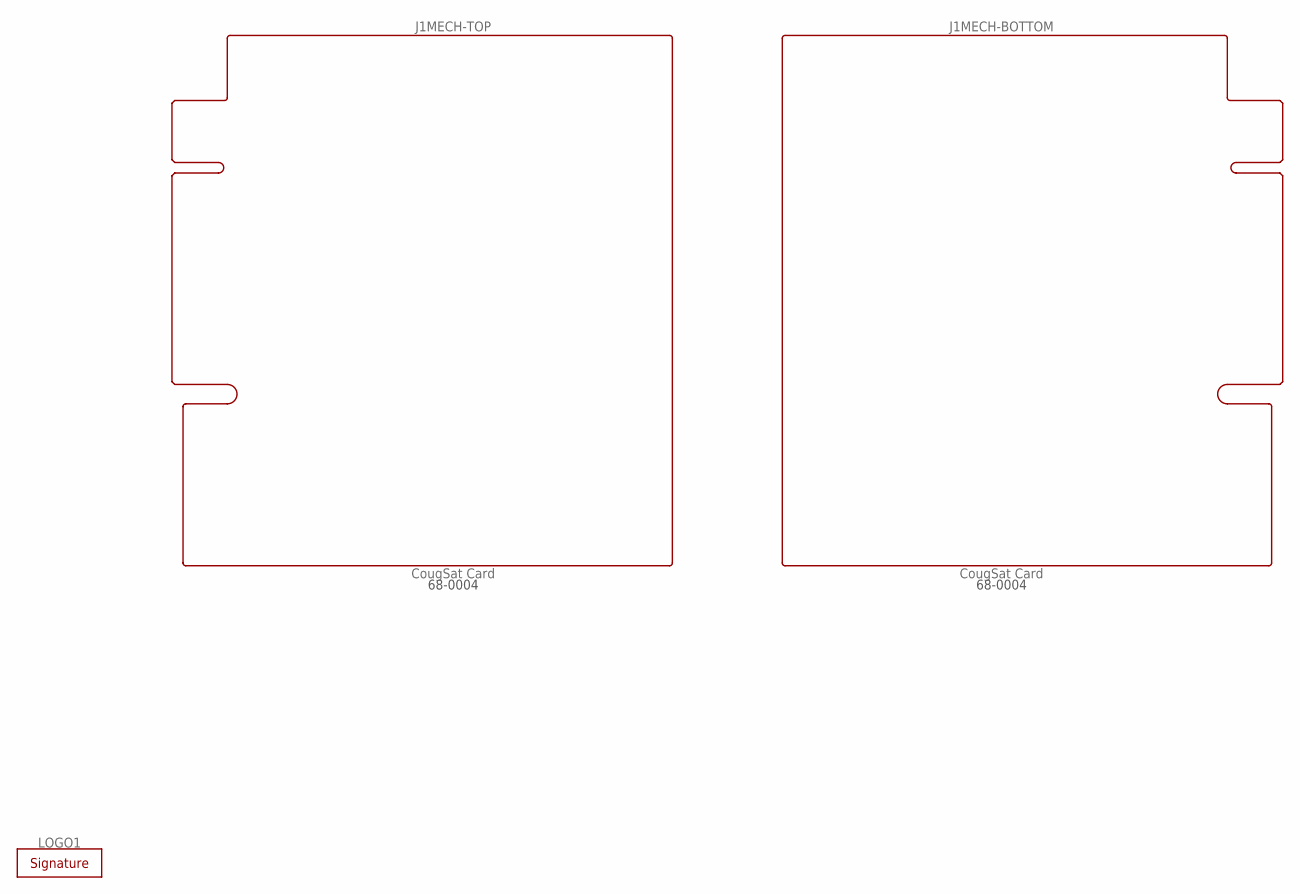
[picture p334: schematic Avionics.sch, sheet 14]

Parts:
J1: CougSat Card; CARD-FULL
LOGO1: SIGNATUREGABE; SIGN-GABE

Connections:
PR_3.3V-1: J1.A2 (PR_3.3V-1), J1.B2 (PR_3.3V-1)
PR_3.3V-3: J1.A4 (PR_3.3V-3), J1.B4 (PR_3.3V-3)
PR_3.3V-4: J1.A5 (PR_3.3V-4), J1.B5 (PR_3.3V-4)
PR_3.3V-6: J1.A7 (PR_3.3V-6), J1.B7 (PR_3.3V-6)
PR_3.3V-7: J1.A8 (PR_3.3V-7), J1.B8 (PR_3.3V-7)
PR_3.3V-8: J1.A9 (PR_3.3V-8), J1.B9 (PR_3.3V-8)
PR_3.3V-9: J1.A10 (PR_3.3V-9), J1.B10 (PR_3.3V-9)
PR_3.3V-10: J1.A11 (PR_3.3V-10), J1.B11 (PR_3.3V-10)
PR_3.3V-11: J1.A12 (PR_3.3V-11), J1.B12 (PR_3.3V-11)
PR_3.3V-12: J1.A13 (PR_3.3V-12), J1.B13 (PR_3.3V-12)
PR_BATT-0: J1.A14 (PR_BATT-0), J1.B14 (PR_BATT-0)
PR_BATT-1: J1.A15 (PR_BATT-1), J1.B15 (PR_BATT-1)
PR_BATT-2: J1.A16 (PR_BATT-2), J1.B16 (PR_BATT-2)
PR_BATT-3: J1.A17 (PR_BATT-3), J1.B17 (PR_BATT-3)
PR_BATT-4: J1.A18 (PR_BATT-4), J1.B18 (PR_BATT-4)
PR_BATT-6: J1.A20 (PR_BATT-6), J1.B20 (PR_BATT-6)
