CougsInSpace/CougSat1-Hardware/CougSat1-AvionicBoard/ElectricalDesign/Avionics.brd

## EAGLE design CougSat1-AvionicBoard/ElectricalDesign/Avionics.brd (continued)

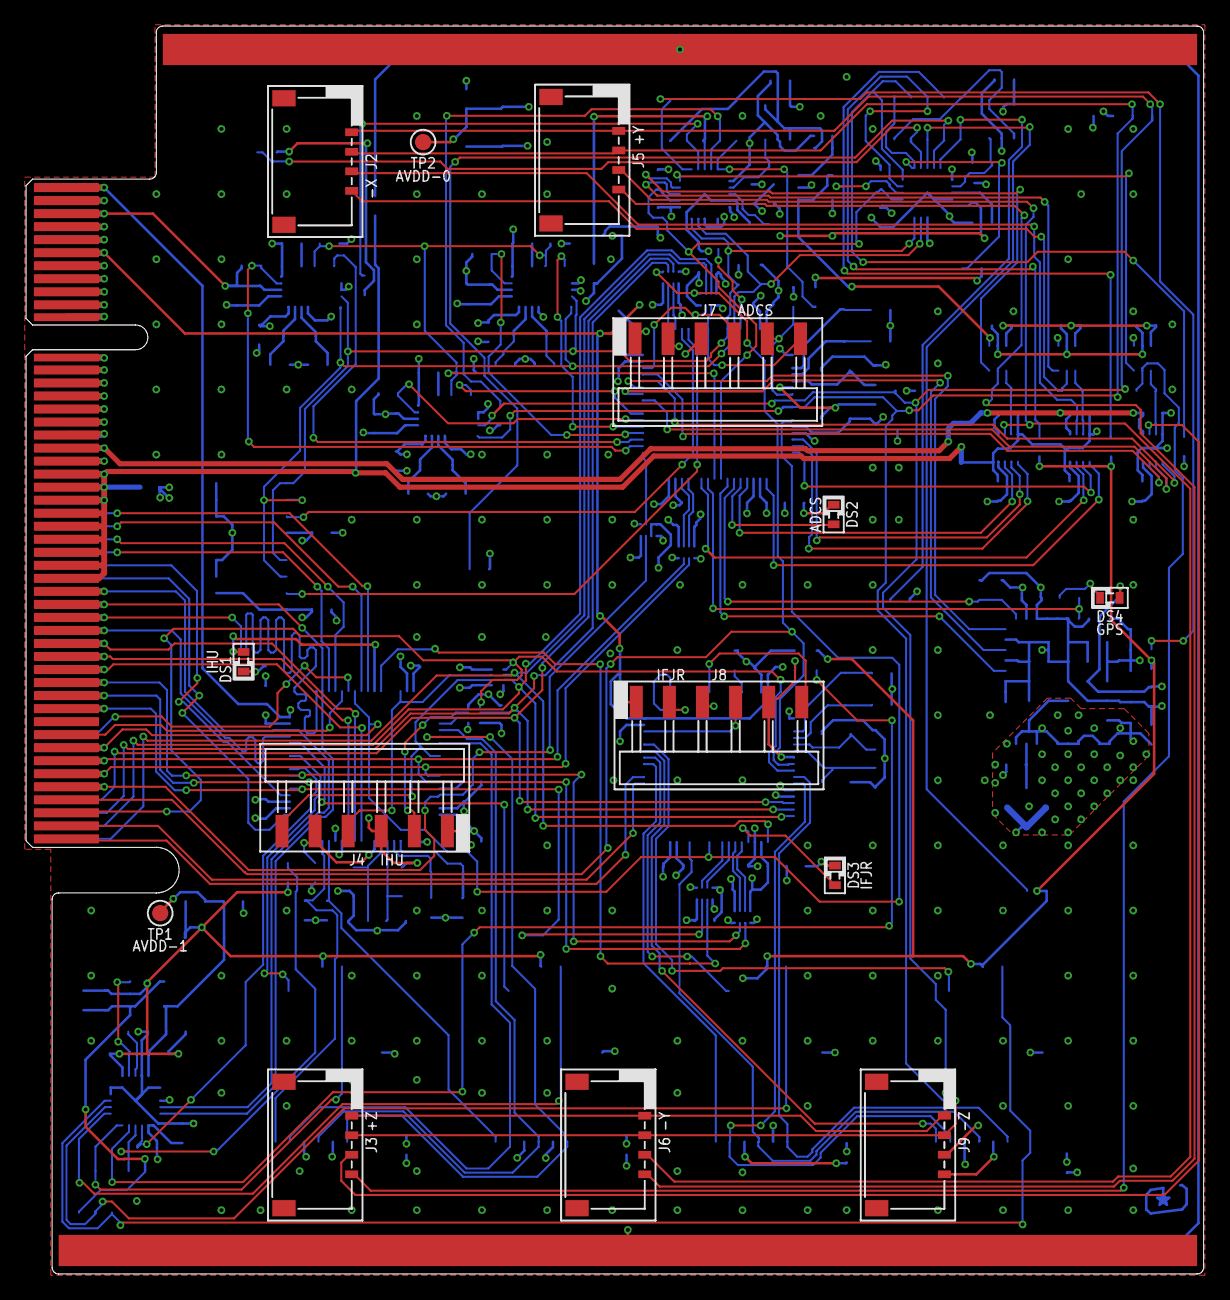
[picture p335: board Avionics.brd from above]

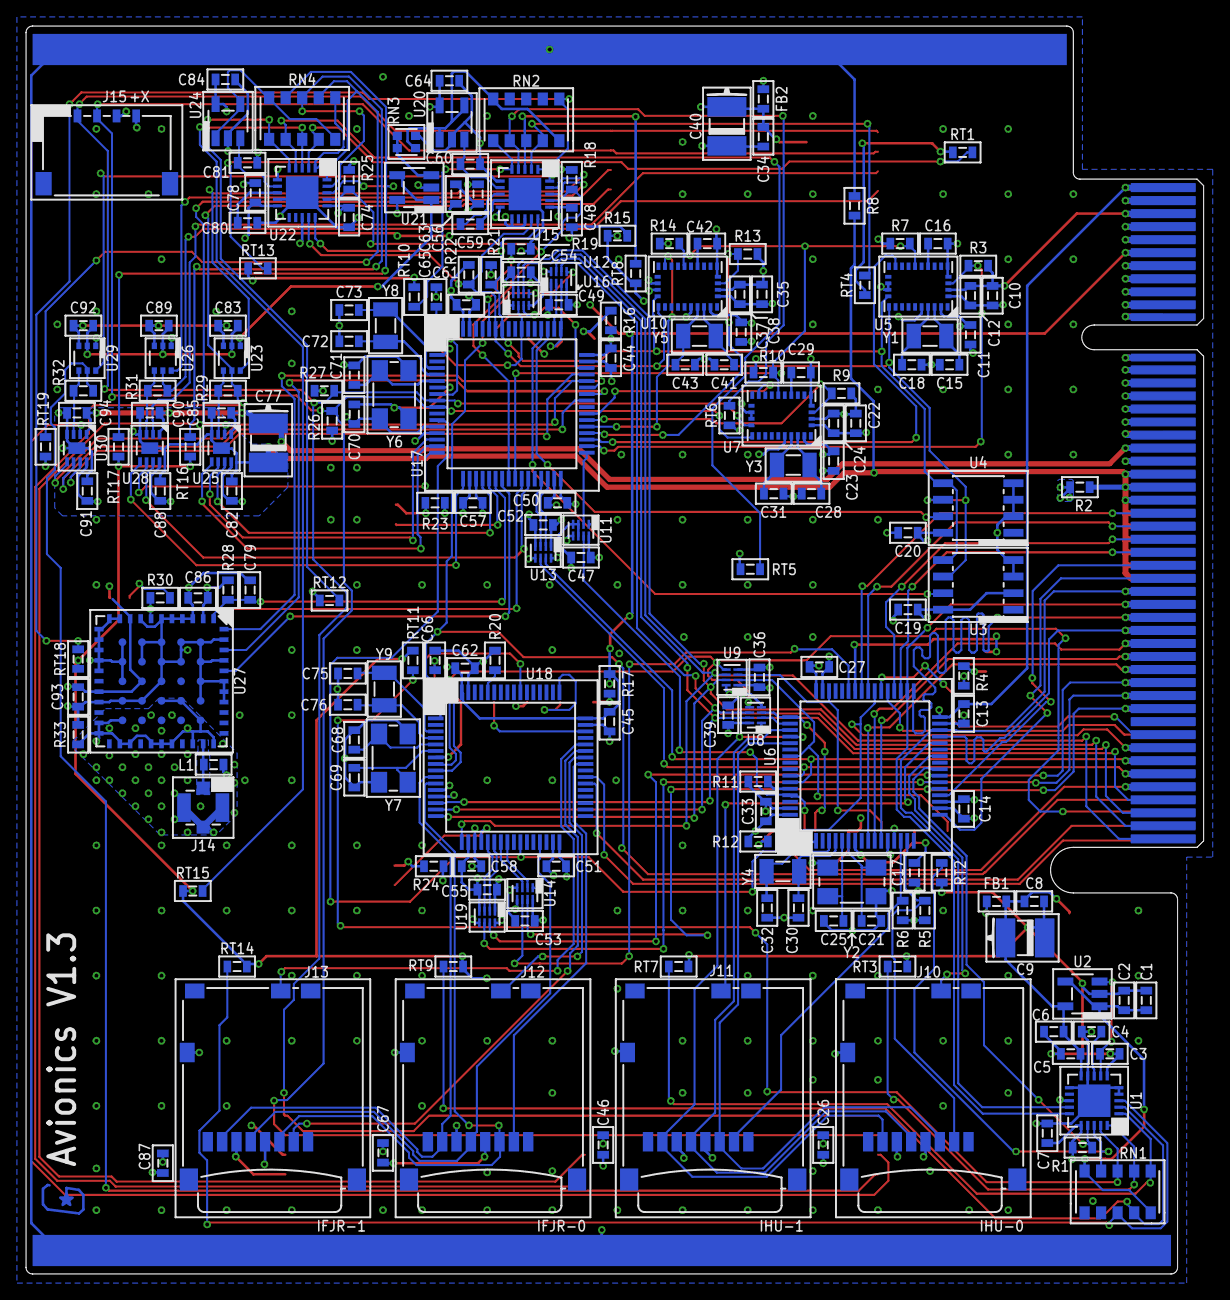
[picture p336: board Avionics.brd from below]

Board: 4 copper layers, 90.4 x 95.8 mm, 214 parts (199 on the bottom side), 199 nets.
