CougsInSpace/CougSat1-Hardware/CougSat1-PowerBoard/ElectricalDesign/EPS.brd

## EAGLE design CougSat1-PowerBoard/ElectricalDesign/EPS.brd (2021-03-04)

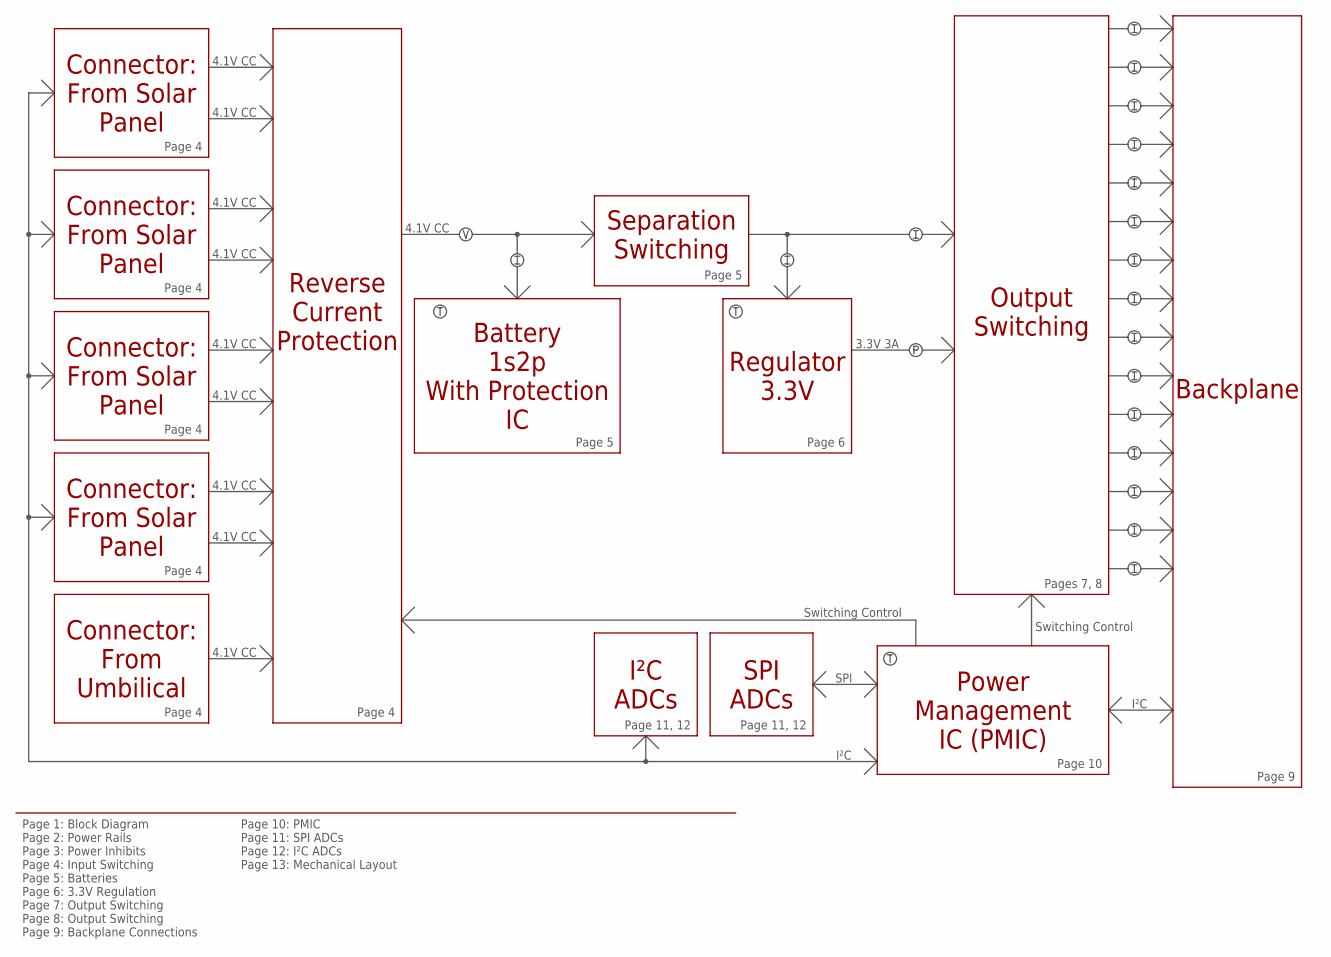
[picture p337: schematic EPS.sch, sheet 1]

Notes on the sheet:
Connector: From Solar Panel
Reverse Current Protection
Regulator 3.3V
Backplane
Power Management IC (PMIC)
I²C
Switching Control
4.1V CC
3.3V 3A
Page 4
Page 5
Page 6
Pages 7, 8
Page 9
Page 10
Page 11, 12
I²C ADCs
Page 1: Block Diagram Page 2: Power Rails Page 3: Power Inhibits Page 4: Input Switching Page 5: Batteries Page 6: 3.3V Regulation Page 7: Output Switching Page 8: Output Switching Page 9: Backplane Connections
Separation Switching
Connector: From Umbilical
Battery 1s2p With Protection IC
Page 10: PMIC Page 11: SPI ADCs Page 12: I²C ADCs Page 13: Mechanical Layout
SPI ADCs
SPI
Output Switching

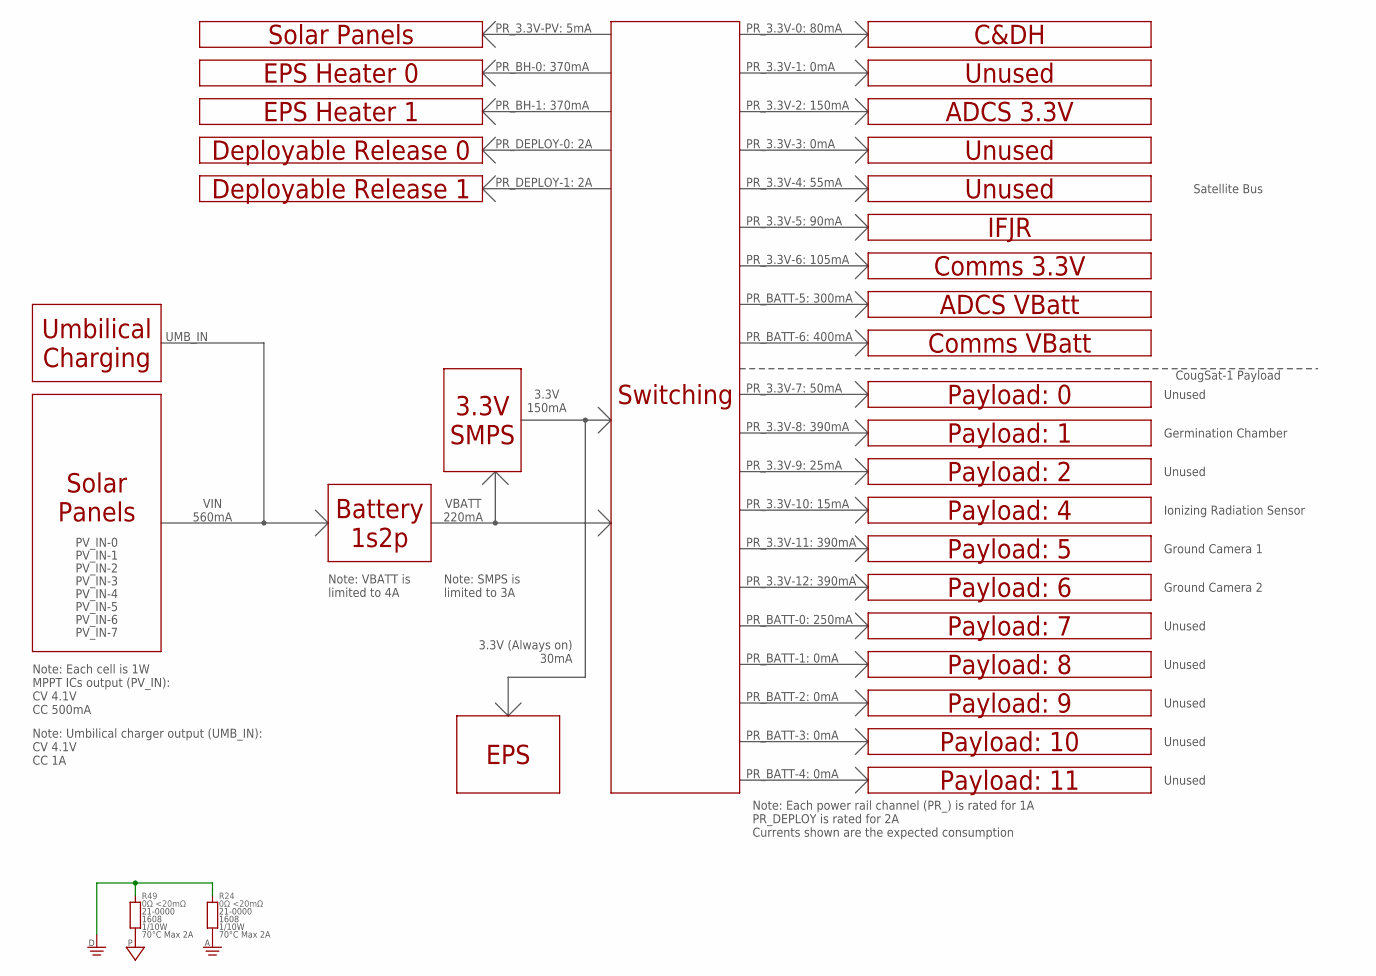
[picture p338: schematic EPS.sch, sheet 2]

Parts:
R24, R49: 0Ω <20mΩ; 1608

Connections:
AGND: R24.1; also elsewhere on the board
DGND: R24.2, R49.2; also elsewhere on the board
PGND: R49.1; also elsewhere on the board

Notes on the sheet:
Solar Panels
Battery 1s2p
3.3V SMPS
EPS
3.3V (Always on) 30mA
C&DH
PR_3.3V-0: 80mA
Unused
PR_3.3V-1: 0mA
ADCS 3.3V
PR_3.3V-2: 150mA
PR_3.3V-3: 0mA
PR_3.3V-4: 55mA
ADCS VBatt
PR_BATT-5: 300mA
IFJR
PR_3.3V-5: 90mA
Payload: 10
PR_BATT-6: 400mA
Payload: 9
PR_BATT-2: 0mA
Comms 3.3V
PR_3.3V-6: 105mA
Comms VBatt
PR_BATT-3: 0mA
Payload: 0
PR_3.3V-7: 50mA
Payload: 1
PR_3.3V-8: 390mA
Payload: 2
PR_3.3V-9: 25mA
Payload: 7
PR_BATT-0: 250mA
Payload: 4
PR_3.3V-10: 15mA
Payload: 5
PR_3.3V-11: 390mA
Payload: 11
PR_BATT-4: 0mA
Germination Chamber
Ground Camera 1
Ionizing Radiation Sensor
Payload: 6
PR_3.3V-12: 390mA
Payload: 8
PR_BATT-1: 0mA
Switching
Umbilical Charging
CougSat-1 Payload
Ground Camera 2
Note: Each power rail channel (PR_) is rated for 1A PR_DEPLOY is rated for 2A Currents shown are the expected consumption
Satellite Bus
3.3V 150mA
VBATT 220mA
VIN 560mA
UMB_IN
PV_IN-0
PV_IN-1
PV_IN-2
PV_IN-3
PV_IN-4
PV_IN-5
PV_IN-6
PV_IN-7
Note: Each cell is 1W MPPT ICs output (PV_IN): CV 4.1V CC 500mA
Solar Panels
PR_3.3V-PV: 5mA
EPS Heater 0
PR_BH-0: 370mA
EPS Heater 1
PR_BH-1: 370mA
Deployable Release 0
PR_DEPLOY-0: 2A
Note: Umbilical charger output (UMB_IN): CV 4.1V CC 1A
Note: VBATT is limited to 4A
Note: SMPS is limited to 3A
Deployable Release 1
PR_DEPLOY-1: 2A

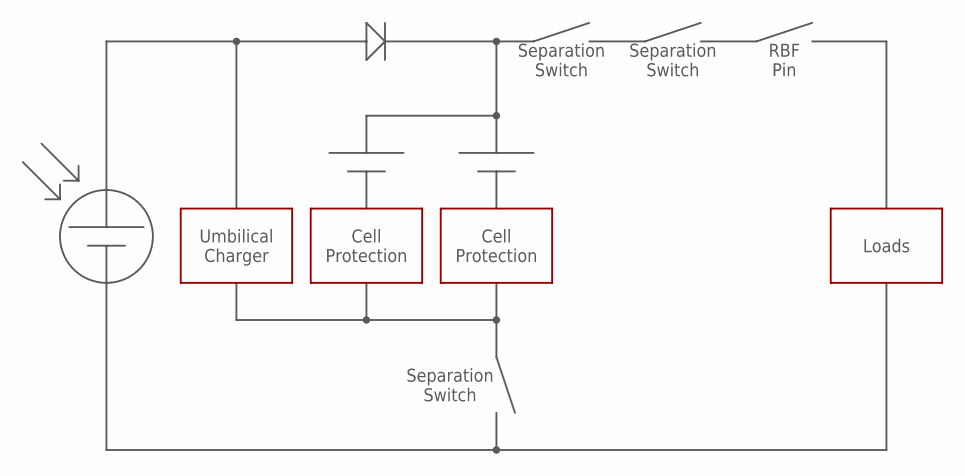
[picture p339: schematic EPS.sch, sheet 3]

Notes on the sheet:
Cell Protection
Umbilical Charger
Separation Switch
RBF Pin
Loads

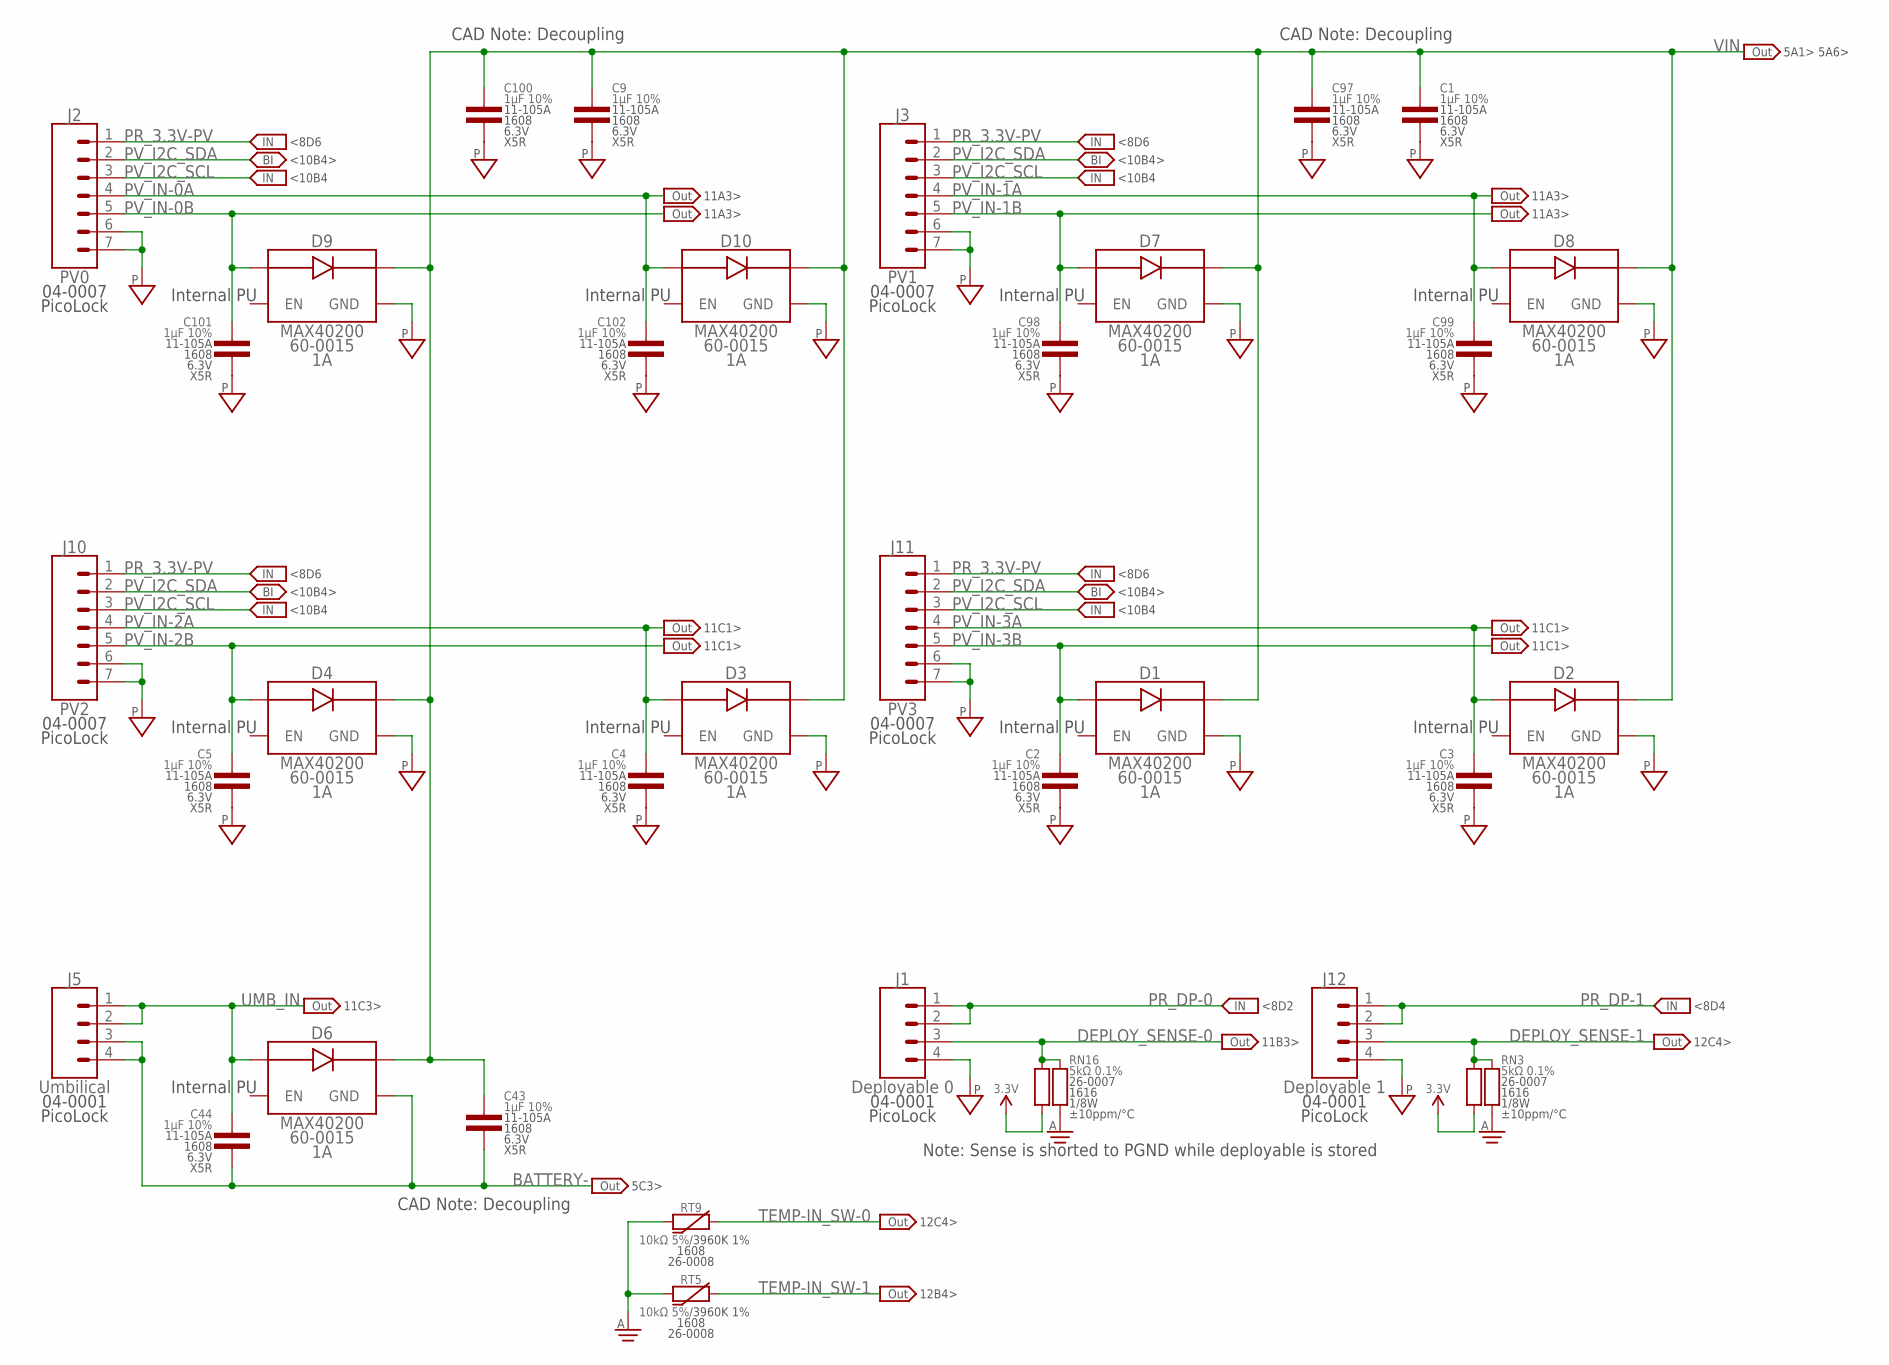
[picture p340: schematic EPS.sch, sheet 4]

Parts:
C1, C2, C3, C4, C5, C9, C43, C44, C97, C98, C99, C100, C101, C102: 1µF 10%; 1608
D1, D2, D3, D4, D6, D7, D8, D9, D10: MAX40200; SOT23-5
J1: Deployable 0; PICOLOCK1.5-04
J2: PV0; PICOLOCK1.5-07
J3: PV1; PICOLOCK1.5-07
J5: Umbilical; PICOLOCK1.5-04
J10: PV2; PICOLOCK1.5-07
J11: PV3; PICOLOCK1.5-07
J12: Deployable 1; PICOLOCK1.5-04
RN3, RN16: 5kΩ 0.1%; 1616
RT5, RT9: 10kΩ 5%; 1608

Connections:
3.3V: RN3.2 (B1), RN16.2 (B1); also elsewhere on the board
AGND: RN3.1 (A1), RN16.1 (A1), RT5.1, RT9.1; also elsewhere on the board
BATTERY-: C43.2, C44.2, D6.2 (GND), J5.3, J5.4; also elsewhere on the board
DEPLOY_SENSE-0: J1.3, RN16.3 (B2), RN16.4 (A2); also elsewhere on the board
DEPLOY_SENSE-1: J12.3, RN3.3 (B2), RN3.4 (A2); also elsewhere on the board
PGND: C1.2, C2.2, C3.2, C4.2, C5.2, C9.2, C97.2, C98.2, C99.2, C100.2, C101.2, C102.2, D1.2 (GND), D2.2 (GND), D3.2 (GND), D4.2 (GND), D7.2 (GND), D8.2 (GND), D9.2 (GND), D10.2 (GND), J1.4, J2.6, J2.7, J3.6, J3.7, J10.6, J10.7, J11.6, J11.7, J12.4; also elsewhere on the board
PR_3.3V-PV: J2.1, J3.1, J10.1, J11.1; also elsewhere on the board
PR_DP-0: J1.1, J1.2; also elsewhere on the board
PR_DP-1: J12.1, J12.2; also elsewhere on the board
PV_I2C_SCL: J2.3, J3.3, J10.3, J11.3; also elsewhere on the board
PV_I2C_SDA: J2.2, J3.2, J10.2, J11.2; also elsewhere on the board
PV_IN-0A: C102.1, D10.1 (IN), J2.4; also elsewhere on the board
PV_IN-0B: C101.1, D9.1 (IN), J2.5; also elsewhere on the board
PV_IN-1A: C99.1, D8.1 (IN), J3.4; also elsewhere on the board
PV_IN-1B: C98.1, D7.1 (IN), J3.5; also elsewhere on the board
PV_IN-2A: C4.1, D3.1 (IN), J10.4; also elsewhere on the board
PV_IN-2B: C5.1, D4.1 (IN), J10.5; also elsewhere on the board
PV_IN-3A: C3.1, D2.1 (IN), J11.4; also elsewhere on the board
PV_IN-3B: C2.1, D1.1 (IN), J11.5; also elsewhere on the board
TEMP-IN_SW-0: RT9.2; also elsewhere on the board
TEMP-IN_SW-1: RT5.2; also elsewhere on the board
UMB_IN: C44.1, D6.1 (IN), J5.1, J5.2; also elsewhere on the board
VIN: C1.1, C9.1, C43.1, C97.1, C100.1, D1.5 (OUT), D2.5 (OUT), D3.5 (OUT), D4.5 (OUT), D6.5 (OUT), D7.5 (OUT), D8.5 (OUT), D9.5 (OUT), D10.5 (OUT); also elsewhere on the board

Notes on the sheet:
Note: Sense is shorted to PGND while deployable is stored
CAD Note: Decoupling
Internal PU
5A1> 5A6>
<8D6
<10B4
<10B4>
11A3>
11C1>
11C3>
5C3>
11B3>
12C4>
12B4>
<8D2
<8D4

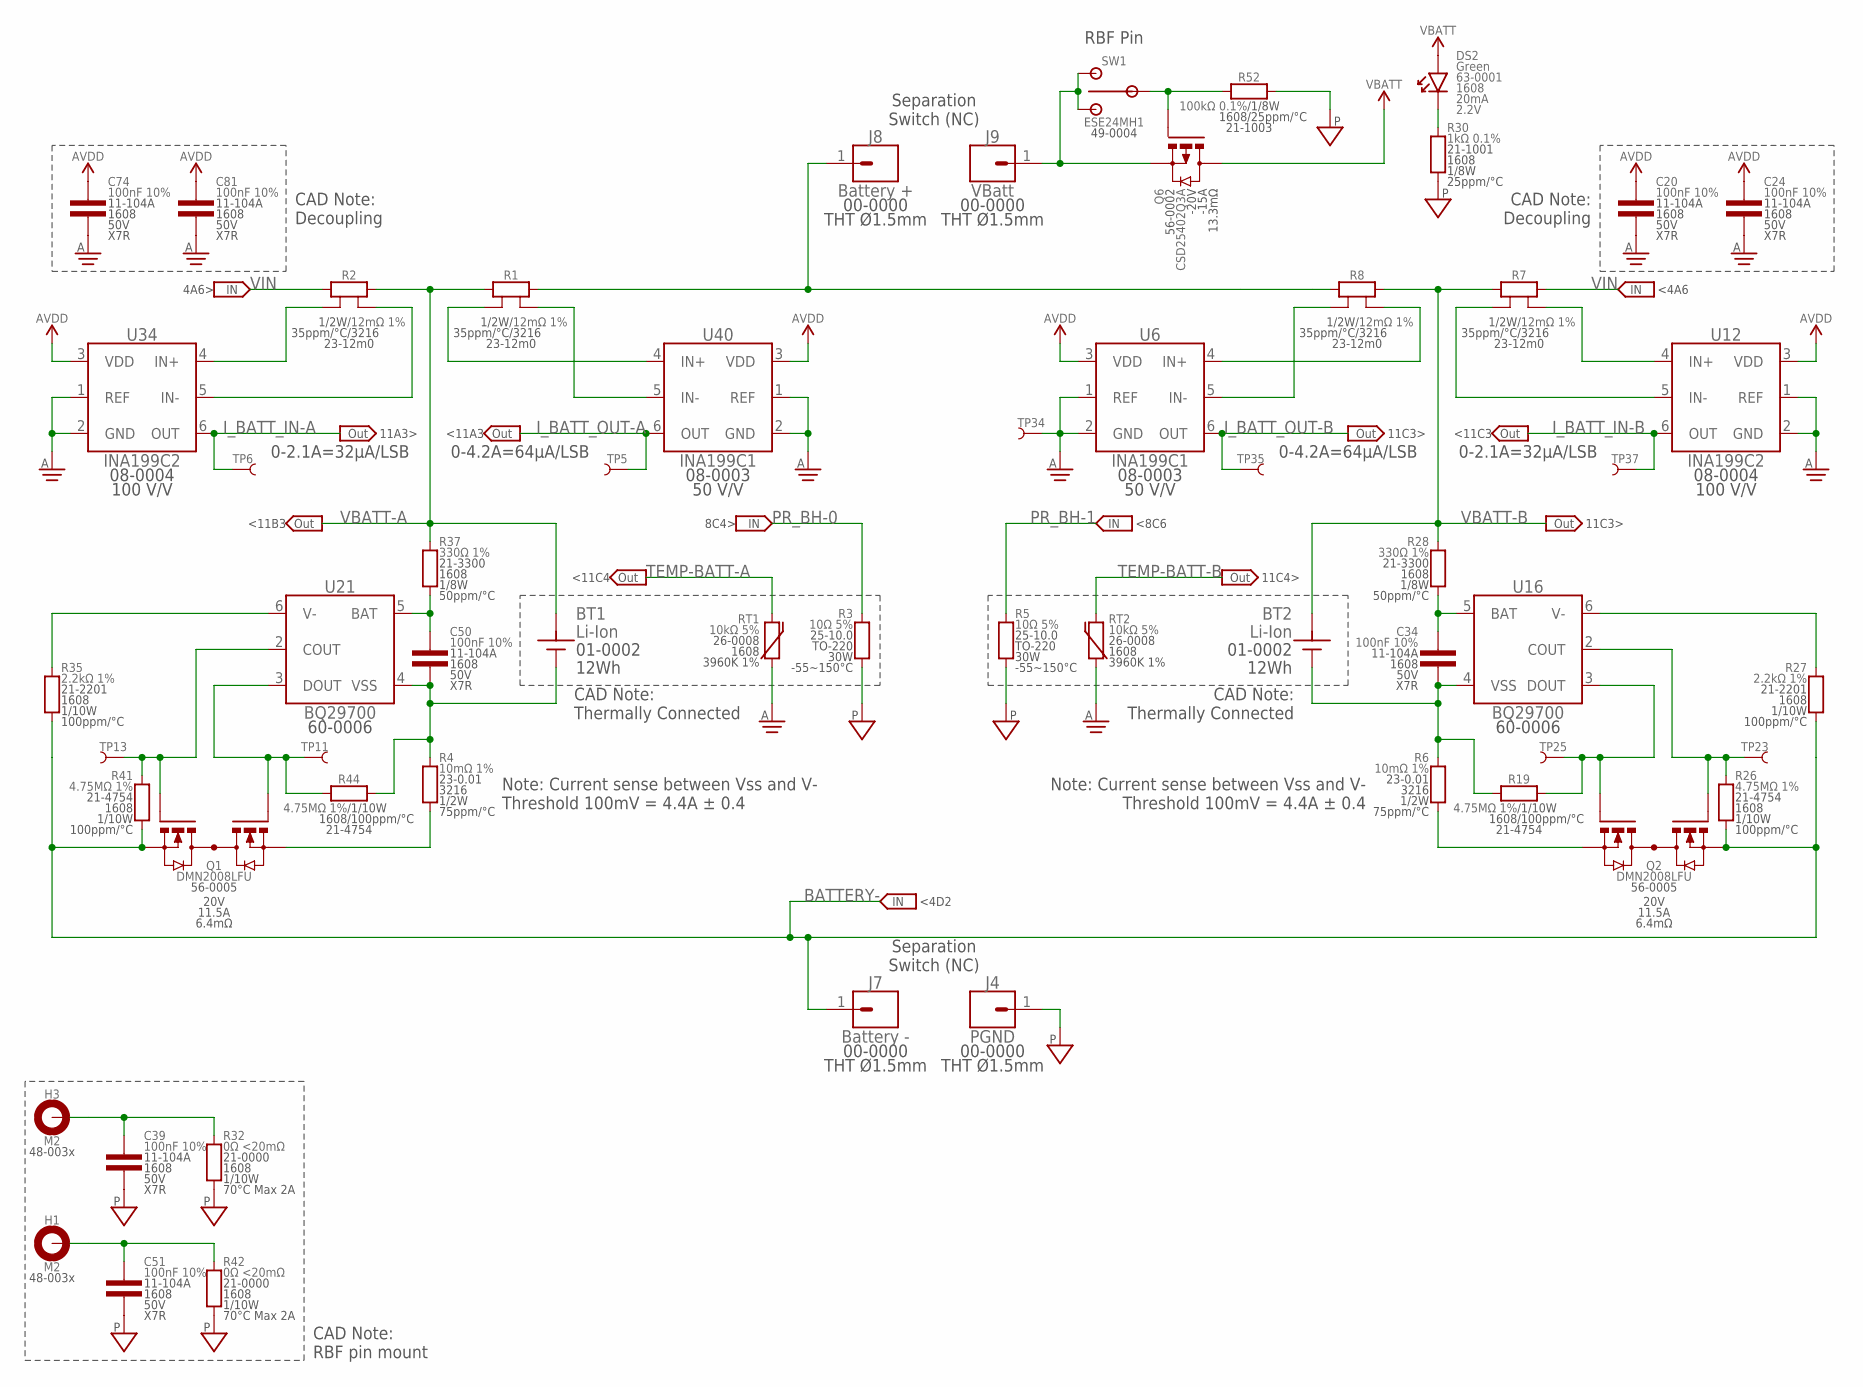
[picture p341: schematic EPS.sch, sheet 5]

Parts:
BT1, BT2: Li-Ion; 18650-SOLDERED
C20, C24, C34, C39, C50, C51, C74, C81: 100nF 10%; 1608
DS2: Green; 1608-POL
H1, H3: M2; MOUNTING_HOLE-2.2
J4: PGND; THT-1.5
J7: Battery -; THT-1.5
J8: Battery +; THT-1.5
J9: VBatt; THT-1.5
Q1, Q2: DMN2008LFU; UDFN-6-B
Q6: CSD25402Q3A; SON-3333
R1, R2, R7, R8: 12mΩ 1%; 3216-KELVIN
R3, R5: 10Ω 5%; TO-220-2
R4, R6: 10mΩ 1%; 3216
R19, R26, R41, R44: 4.75MΩ 1%; 1608
R27, R35: 2.2kΩ 1%; 1608
R28, R37: 330Ω 1%; 1608
R30: 1kΩ 0.1%; 1608
R32, R42: 0Ω <20mΩ; 1608
R52: 100kΩ 0.1%; 1608
RT1, RT2: 10kΩ 5%; 1608
SW1: ESE24MH1
TP5, TP6, TP11, TP13, TP23, TP25, TP34, TP35, TP37: TEST_POINT-SMD-C-1.25; SMD-C-1.25
U6, U40: INA199C1; SOT363
U12, U34: INA199C2; SOT363
U16, U21: BQ29700; WSON-6

Connections:
AGND: C20.2, C24.2, C74.2, C81.2, RT1.1, RT2.1, TP34.1, U6.1 (REF), U6.2 (GND), U12.1 (REF), U12.2 (GND), U34.1 (REF), U34.2 (GND), U40.1 (REF), U40.2 (GND); also elsewhere on the board
AVDD: C20.1, C24.1, C74.1, C81.1, U6.3 (VDD), U12.3 (VDD), U34.3 (VDD), U40.3 (VDD); also elsewhere on the board
BATTERY+: J8.1, R1.1, R8.2
BATTERY-: J7.1, Q1.1 (S1), Q2.6 (S2), R26.1, R27.1, R35.1, R41.1; also elsewhere on the board
BATT_PROTECT_BAT-A: C50.1, R37.1, U21.5 (BAT)
BATT_PROTECT_BAT-B: C34.1, R28.1, U16.5 (BAT)
BATT_PROTECT_COUT-A: Q1.3 (G1), R41.2, TP13.1, U21.2 (COUT)
BATT_PROTECT_COUT-B: Q2.4 (G2), R26.2, TP23.1, U16.2 (COUT)
BATT_PROTECT_DOUT-A: Q1.4 (G2), R44.1, TP11.1, U21.3 (DOUT)
BATT_PROTECT_DOUT-B: Q2.3 (G1), R19.2, TP25.1, U16.3 (DOUT)
BATT_PROTECT_GND-A: R35.2, U21.6 (V-)
BATT_PROTECT_GND-B: R27.2, U16.6 (V-)
BP_VSS-A: BT1.A, C50.2, R4.2, R44.2, U21.4 (VSS)
BP_VSS-B: BT2.A, C34.2, R6.2, R19.1, U16.4 (VSS)
BP_VSS_I-A: Q1.6 (S2), R4.1
BP_VSS_I-B: Q2.1 (S1), R6.1
CHASSIS_RBF0: C39.1, H3.1, H3.V1, H3.V2, H3.V3, H3.V4, H3.V5, H3.V6, H3.V7, H3.V8, R32.2
CHASSIS_RBF1: C51.1, H1.1, H1.V1, H1.V2, H1.V3, H1.V4, H1.V5, H1.V6, H1.V7, H1.V8, R42.2
I_BATT_IN-A: TP6.1, U34.6 (OUT); also elsewhere on the board
I_BATT_IN-A_N: R2.1-KELVIN, U34.5 (IN-)
I_BATT_IN-A_P: R2.2-KELVIN, U34.4 (IN+)
I_BATT_IN-B: TP37.1, U12.6 (OUT); also elsewhere on the board
I_BATT_IN-B_N: R7.2-KELVIN, U12.5 (IN-)
I_BATT_IN-B_P: R7.1-KELVIN, U12.4 (IN+)
I_BATT_OUT-A: TP5.1, U40.6 (OUT); also elsewhere on the board
I_BATT_OUT-A_N: R1.1-KELVIN, U40.5 (IN-)
I_BATT_OUT-A_P: R1.2-KELVIN, U40.4 (IN+)
I_BATT_OUT-B: TP35.1, U6.6 (OUT); also elsewhere on the board
I_BATT_OUT-B_N: R8.2-KELVIN, U6.5 (IN-)
I_BATT_OUT-B_P: R8.1-KELVIN, U6.4 (IN+)
PGND: C39.2, C51.2, J4.1, R3.1, R5.1, R30.1, R32.1, R42.1, R52.2; also elsewhere on the board
PR_BH-0: R3.3 (2); also elsewhere on the board
PR_BH-1: R5.3 (2); also elsewhere on the board
RBF_GATE: Q6.4 (G), R52.1, SW1.C
TEMP-BATT-A: RT1.2; also elsewhere on the board
TEMP-BATT-B: RT2.2; also elsewhere on the board
VBATT: DS2.A, Q6.1 (D), Q6.2 (D), Q6.3 (D); also elsewhere on the board
VBATT-A: BT1.C, R1.2, R2.1, R37.2; also elsewhere on the board
VBATT-B: BT2.C, R7.2, R8.1, R28.2; also elsewhere on the board
VBATT_LED: DS2.C, R30.2
VBATT_RBF: J9.1, Q6.5 (S), Q6.6 (S), Q6.7 (S), Q6.8 (S), Q6.PAD (S), SW1.1, SW1.2
VIN: R2.2, R7.1; also elsewhere on the board

Notes on the sheet:
CAD Note: Thermally Connected
CAD Note: RBF pin mount
Note: Current sense between Vss and V- Threshold 100mV = 4.4A ± 0.4
CAD Note: Decoupling
0-4.2A=64µA/LSB
0-2.1A=32µA/LSB
Separation Switch (NC)
RBF Pin
<4A6
<4D2
11C3>
<8C6
11A3>
11C4>
4A6>
8C4>
<11A3
<11C3
<11C4
<11B3

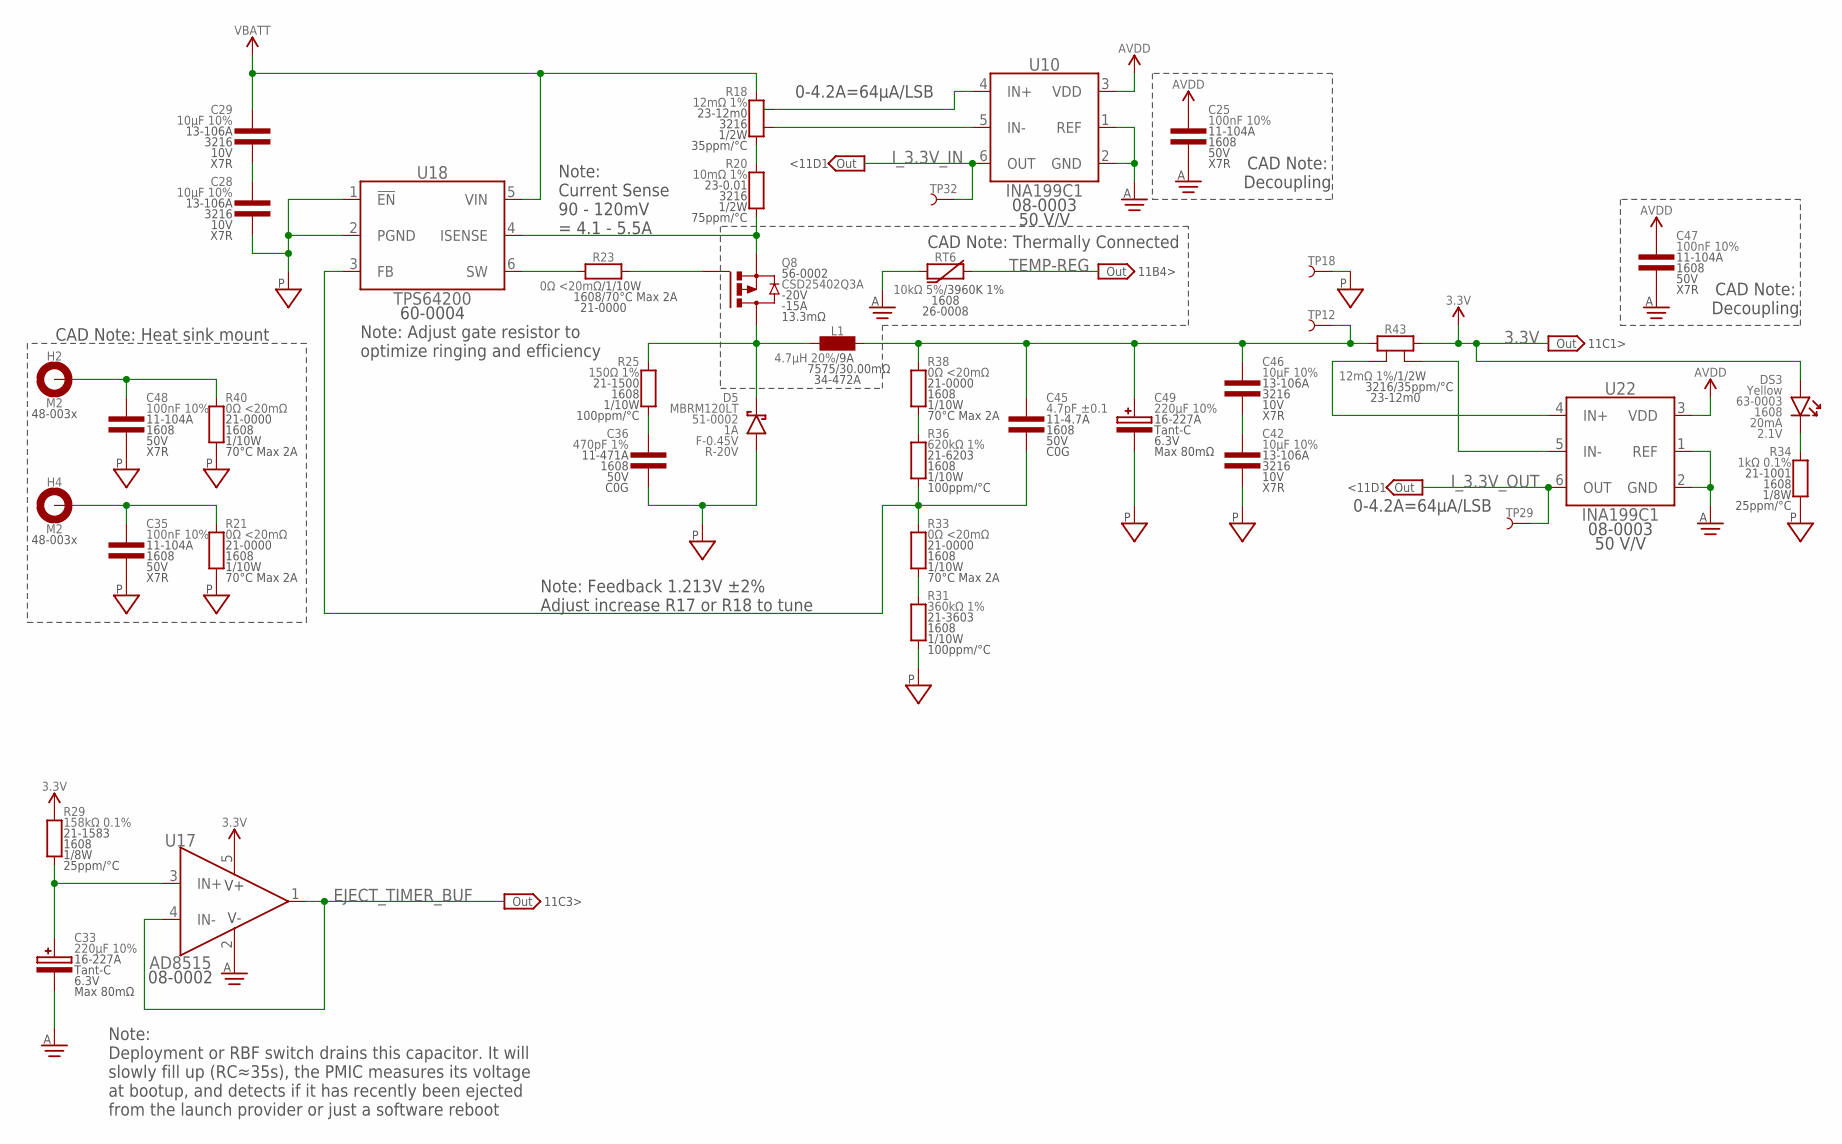
[picture p342: schematic EPS.sch, sheet 6]

Parts:
C25, C35, C47, C48: 100nF 10%; 1608
C28, C29, C42, C46: 10µF 10%; 3216
C33, C49: 220µF 10%; 7132-POL
C36: 470pF 1%; 1608
C45: 4.7pF ±0.1; 1608
D5: MBRM120LT; POWERMITE
DS3: Yellow; 1608-POL
H2, H4: M2; MOUNTING_HOLE-2.2
L1: 4.7µH 20%; 7575
Q8: CSD25402Q3A; SON-3333
R18, R43: 12mΩ 1%; 3216-KELVIN
R20: 10mΩ 1%; 3216
R21, R23, R33, R38, R40: 0Ω <20mΩ; 1608
R25: 150Ω 1%; 1608
R29: 158kΩ 0.1%; 1608
R31: 360kΩ 1%; 1608
R34: 1kΩ 0.1%; 1608
R36: 620kΩ 1%; 1608
RT6: 10kΩ 5%; 1608
TP12, TP29, TP32: TEST_POINT-SMD-C-1.25; SMD-C-1.25
TP18: TEST_POINT-THT-0.7; THT-0.7
U10, U22: INA199C1; SOT363
U17: AD8515; SOT23-5
U18: TPS64200; SOT23-6

Connections:
3.3V: DS3.A, R29.2, R43.2, U17.5 (V+); also elsewhere on the board
3.3V_I: C45.1, C46.1, C49.A, L1.2, R38.2, R43.1, TP12.1
3.3V_ISENS: Q8.5 (S), Q8.6 (S), Q8.7 (S), Q8.8 (S), Q8.PAD (S), R20.1, U18.4 (ISENSE)
3.3V_LED: DS3.C, R34.2
3.3V_REG_BUCK_NODE: D5.C, L1.1, Q8.1 (D), Q8.2 (D), Q8.3 (D), R25.2
3.3V_REG_FB: C45.2, R33.2, R36.1, U18.3 (FB)
3.3V_REG_FBRES_HIGH: R36.2, R38.1
3.3V_REG_FBRES_LOW: R31.2, R33.1
3.3V_REG_INCAP: C28.1, C29.2
3.3V_REG_OUTCAP: C42.1, C46.2
3.3V_REG_RSENS: R18.1, R20.2
3.3V_REG_SNUBBER: C36.1, R25.1
3.3V_REG_SW: R23.1, U18.6 (SW)
3.3V_REG_SW_GATE: Q8.4 (G), R23.2
AGND: C25.2, C33.C, C47.2, RT6.1, U10.1 (REF), U10.2 (GND), U17.2 (V-), U22.1 (REF), U22.2 (GND); also elsewhere on the board
AVDD: C25.1, C47.1, U10.3 (VDD), U22.3 (VDD); also elsewhere on the board
CHASSIS_REG1: C48.1, H2.1, H2.V1, H2.V2, H2.V3, H2.V4, H2.V5, H2.V6, H2.V7, H2.V8, R40.2
CHASSIS_REG2: C35.1, H4.1, H4.V1, H4.V2, H4.V3, H4.V4, H4.V5, H4.V6, H4.V7, H4.V8, R21.2
EJECT_TIMER: C33.A, R29.1, U17.3 (IN+)
EJECT_TIMER_BUF: U17.1 (OUT), U17.4 (IN-); also elsewhere on the board
I_3.3V_IN: TP32.1, U10.6 (OUT); also elsewhere on the board
I_3.3V_IN_N: R18.1-KELVIN, U10.5 (IN-)
I_3.3V_IN_P: R18.2-KELVIN, U10.4 (IN+)
I_3.3V_OUT: TP29.1, U22.6 (OUT); also elsewhere on the board
I_3.3V_OUT_N: R43.2-KELVIN, U22.5 (IN-)
I_3.3V_OUT_P: R43.1-KELVIN, U22.4 (IN+)
PGND: C28.2, C35.2, C36.2, C42.2, C48.2, C49.C, D5.A, R21.1, R31.1, R34.1, R40.1, TP18.1, U18.1 (!EN), U18.2 (PGND); also elsewhere on the board
TEMP-REG: RT6.2; also elsewhere on the board
VBATT: C29.1, R18.2, U18.5 (VIN); also elsewhere on the board

Notes on the sheet:
Note: Feedback 1.213V ±2% Adjust increase R17 or R18 to tune
Note: Current Sense 90 - 120mV = 4.1 - 5.5A
CAD Note: Thermally Connected
CAD Note: Heat sink mount
Note: Adjust gate resistor to optimize ringing and efficiency
0-4.2A=64µA/LSB
CAD Note: Decoupling
Note: Deployment or RBF switch drains this capacitor. It will slowly fill up (RC≈35s), the PMIC measures its voltage at bootup, and detects if it has recently been ejected from the launch provider or just a software reboot
<11D1
11C1>
11B4>
11C3>
