CougsInSpace/CougSat1-Hardware/CougSat1-PowerBoard/ElectricalDesign/EPS.brd

## EAGLE design CougSat1-PowerBoard/ElectricalDesign/EPS.brd (continued)

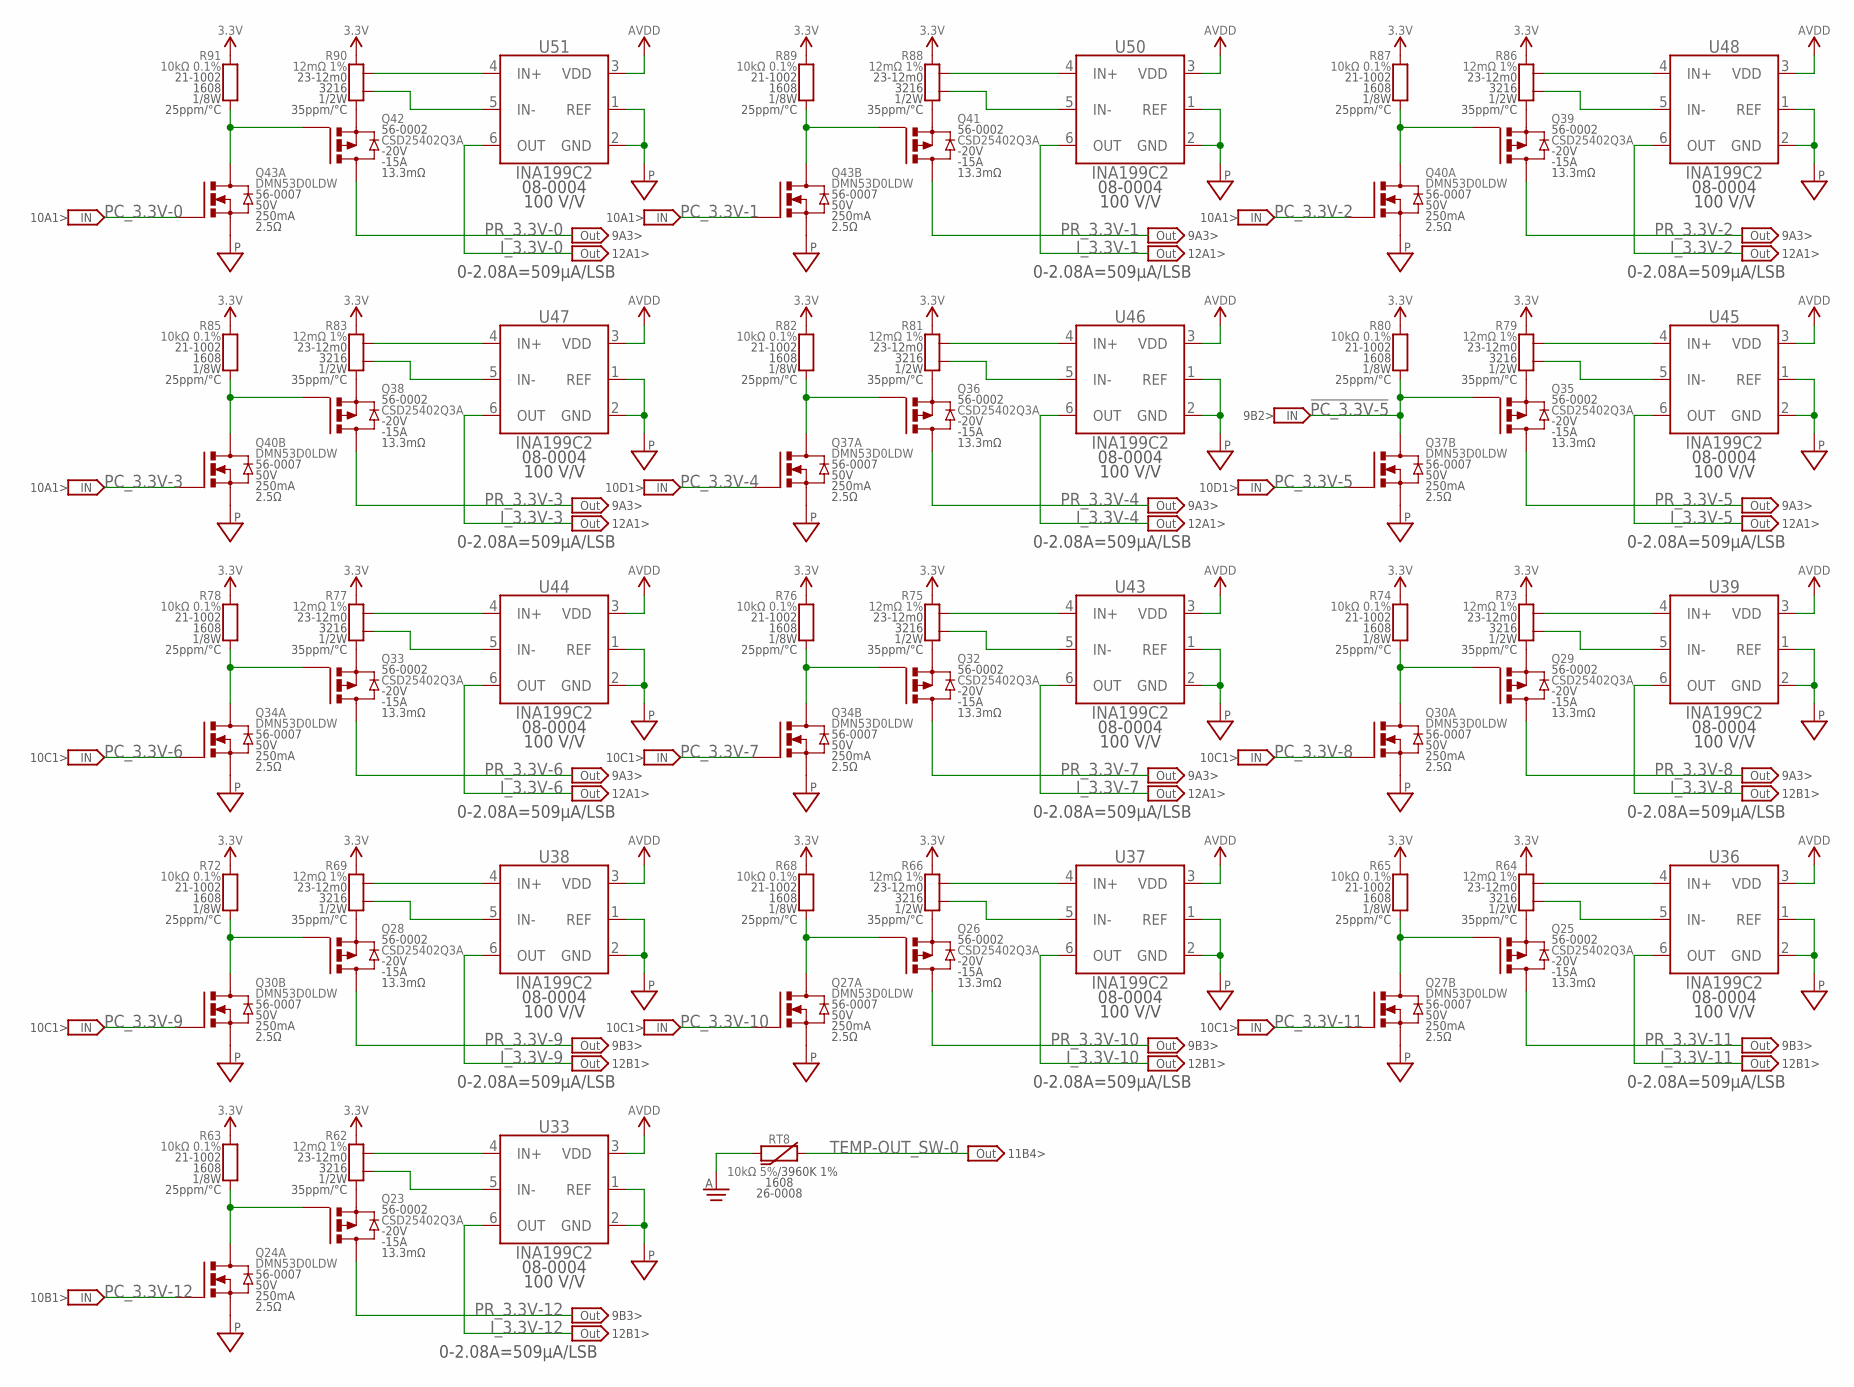
[picture p343: schematic EPS.sch, sheet 7]

Parts:
Q23, Q25, Q26, Q28, Q29, Q32, Q33, Q35, Q36, Q38, Q39, Q41, Q42: CSD25402Q3A; SON-3333
Q24, Q27, Q30, Q34, Q37, Q40, Q43: DMN53D0LDW; SOT363
R62, R64, R66, R69, R73, R75, R77, R79, R81, R83, R86, R88, R90: 12mΩ 1%; 3216-KELVIN
R63, R65, R68, R72, R74, R76, R78, R80, R82, R85, R87, R89, R91: 10kΩ 0.1%; 1608
RT8: 10kΩ 5%; 1608
U33, U36, U37, U38, U39, U43, U44, U45, U46, U47, U48, U50, U51: INA199C2; SOT363

Connections:
3.3V: R62.2, R63.2, R64.2, R65.2, R66.2, R68.2, R69.2, R72.2, R73.2, R74.2, R75.2, R76.2, R77.2, R78.2, R79.2, R80.2, R81.2, R82.2, R83.2, R85.2, R86.2, R87.2, R88.2, R89.2, R90.2, R91.2; also elsewhere on the board
!PC_3.3V-0: Q42.4 (G), Q43.6 (D), R91.1
!PC_3.3V-1: Q41.4 (G), Q43.3 (D), R89.1
!PC_3.3V-2: Q39.4 (G), Q40.6 (D), R87.1
!PC_3.3V-3: Q38.4 (G), Q40.3 (D), R85.1
!PC_3.3V-4: Q36.4 (G), Q37.6 (D), R82.1
!PC_3.3V-5: Q35.4 (G), Q37.3 (D), R80.1; also elsewhere on the board
!PC_3.3V-6: Q33.4 (G), Q34.6 (D), R78.1
!PC_3.3V-7: Q32.4 (G), Q34.3 (D), R76.1
!PC_3.3V-8: Q29.4 (G), Q30.6 (D), R74.1
!PC_3.3V-9: Q28.4 (G), Q30.3 (D), R72.1
!PC_3.3V-10: Q26.4 (G), Q27.6 (D), R68.1
!PC_3.3V-11: Q25.4 (G), Q27.3 (D), R65.1
!PC_3.3V-12: Q23.4 (G), Q24.6 (D), R63.1
AGND: RT8.1; also elsewhere on the board
AVDD: U33.3 (VDD), U36.3 (VDD), U37.3 (VDD), U38.3 (VDD), U39.3 (VDD), U43.3 (VDD), U44.3 (VDD), U45.3 (VDD), U46.3 (VDD), U47.3 (VDD), U48.3 (VDD), U50.3 (VDD), U51.3 (VDD); also elsewhere on the board
I_3.3V-0: U51.6 (OUT); also elsewhere on the board
I_3.3V-0_N: R90.1-KELVIN, U51.5 (IN-)
I_3.3V-0_P: R90.2-KELVIN, U51.4 (IN+)
I_3.3V-1: U50.6 (OUT); also elsewhere on the board
I_3.3V-1_N: R88.1-KELVIN, U50.5 (IN-)
I_3.3V-1_P: R88.2-KELVIN, U50.4 (IN+)
I_3.3V-2: U48.6 (OUT); also elsewhere on the board
I_3.3V-2_N: R86.1-KELVIN, U48.5 (IN-)
I_3.3V-2_P: R86.2-KELVIN, U48.4 (IN+)
I_3.3V-3: U47.6 (OUT); also elsewhere on the board
I_3.3V-3_N: R83.1-KELVIN, U47.5 (IN-)
I_3.3V-3_P: R83.2-KELVIN, U47.4 (IN+)
I_3.3V-4: U46.6 (OUT); also elsewhere on the board
I_3.3V-4_N: R81.1-KELVIN, U46.5 (IN-)
I_3.3V-4_P: R81.2-KELVIN, U46.4 (IN+)
I_3.3V-5: U45.6 (OUT); also elsewhere on the board
I_3.3V-5_N: R79.1-KELVIN, U45.5 (IN-)
I_3.3V-5_P: R79.2-KELVIN, U45.4 (IN+)
I_3.3V-6: U44.6 (OUT); also elsewhere on the board
I_3.3V-6_N: R77.1-KELVIN, U44.5 (IN-)
I_3.3V-6_P: R77.2-KELVIN, U44.4 (IN+)
I_3.3V-7: U43.6 (OUT); also elsewhere on the board
I_3.3V-7_N: R75.1-KELVIN, U43.5 (IN-)
I_3.3V-7_P: R75.2-KELVIN, U43.4 (IN+)
I_3.3V-8: U39.6 (OUT); also elsewhere on the board
I_3.3V-8_N: R73.1-KELVIN, U39.5 (IN-)
I_3.3V-8_P: R73.2-KELVIN, U39.4 (IN+)
I_3.3V-9: U38.6 (OUT); also elsewhere on the board
I_3.3V-9_N: R69.1-KELVIN, U38.5 (IN-)
I_3.3V-9_P: R69.2-KELVIN, U38.4 (IN+)
I_3.3V-10: U37.6 (OUT); also elsewhere on the board
I_3.3V-10_N: R66.1-KELVIN, U37.5 (IN-)
I_3.3V-10_P: R66.2-KELVIN, U37.4 (IN+)
I_3.3V-11: U36.6 (OUT); also elsewhere on the board
I_3.3V-11_N: R64.1-KELVIN, U36.5 (IN-)
I_3.3V-11_P: R64.2-KELVIN, U36.4 (IN+)
I_3.3V-12: U33.6 (OUT); also elsewhere on the board
I_3.3V-12_N: R62.1-KELVIN, U33.5 (IN-)
I_3.3V-12_P: R62.2-KELVIN, U33.4 (IN+)
PC_3.3V-0: Q43.2 (G); also elsewhere on the board
PC_3.3V-1: Q43.5 (G); also elsewhere on the board
PC_3.3V-2: Q40.2 (G); also elsewhere on the board
PC_3.3V-3: Q40.5 (G); also elsewhere on the board
PC_3.3V-4: Q37.2 (G); also elsewhere on the board
PC_3.3V-5: Q37.5 (G); also elsewhere on the board
PC_3.3V-6: Q34.2 (G); also elsewhere on the board
PC_3.3V-7: Q34.5 (G); also elsewhere on the board
PC_3.3V-8: Q30.2 (G); also elsewhere on the board
PC_3.3V-9: Q30.5 (G); also elsewhere on the board
PC_3.3V-10: Q27.2 (G); also elsewhere on the board
PC_3.3V-11: Q27.5 (G); also elsewhere on the board
PC_3.3V-12: Q24.2 (G); also elsewhere on the board
PGND: Q24.1 (S), Q27.1 (S), Q27.4 (S), Q30.1 (S), Q30.4 (S), Q34.1 (S), Q34.4 (S), Q37.1 (S), Q37.4 (S), Q40.1 (S), Q40.4 (S), Q43.1 (S), Q43.4 (S), U33.1 (REF), U33.2 (GND), U36.1 (REF), U36.2 (GND), U37.1 (REF), U37.2 (GND), U38.1 (REF), U38.2 (GND), U39.1 (REF), U39.2 (GND), U43.1 (REF), U43.2 (GND), U44.1 (REF), U44.2 (GND), U45.1 (REF), U45.2 (GND), U46.1 (REF), U46.2 (GND), U47.1 (REF), U47.2 (GND), U48.1 (REF), U48.2 (GND), U50.1 (REF), U50.2 (GND), U51.1 (REF), U51.2 (GND); also elsewhere on the board
PR_3.3V-0: Q42.1 (D), Q42.2 (D), Q42.3 (D); also elsewhere on the board
PR_3.3V-1: Q41.1 (D), Q41.2 (D), Q41.3 (D); also elsewhere on the board
PR_3.3V-2: Q39.1 (D), Q39.2 (D), Q39.3 (D); also elsewhere on the board
PR_3.3V-3: Q38.1 (D), Q38.2 (D), Q38.3 (D); also elsewhere on the board
PR_3.3V-4: Q36.1 (D), Q36.2 (D), Q36.3 (D); also elsewhere on the board
PR_3.3V-5: Q35.1 (D), Q35.2 (D), Q35.3 (D); also elsewhere on the board
PR_3.3V-6: Q33.1 (D), Q33.2 (D), Q33.3 (D); also elsewhere on the board
PR_3.3V-7: Q32.1 (D), Q32.2 (D), Q32.3 (D); also elsewhere on the board
PR_3.3V-8: Q29.1 (D), Q29.2 (D), Q29.3 (D); also elsewhere on the board
PR_3.3V-9: Q28.1 (D), Q28.2 (D), Q28.3 (D); also elsewhere on the board
PR_3.3V-10: Q26.1 (D), Q26.2 (D), Q26.3 (D); also elsewhere on the board
PR_3.3V-11: Q25.1 (D), Q25.2 (D), Q25.3 (D); also elsewhere on the board
PR_3.3V-12: Q23.1 (D), Q23.2 (D), Q23.3 (D); also elsewhere on the board
PR_FET_3.3V-0: Q42.5 (S), Q42.6 (S), Q42.7 (S), Q42.8 (S), Q42.PAD (S), R90.1
PR_FET_3.3V-1: Q41.5 (S), Q41.6 (S), Q41.7 (S), Q41.8 (S), Q41.PAD (S), R88.1
PR_FET_3.3V-2: Q39.5 (S), Q39.6 (S), Q39.7 (S), Q39.8 (S), Q39.PAD (S), R86.1
PR_FET_3.3V-3: Q38.5 (S), Q38.6 (S), Q38.7 (S), Q38.8 (S), Q38.PAD (S), R83.1
PR_FET_3.3V-4: Q36.5 (S), Q36.6 (S), Q36.7 (S), Q36.8 (S), Q36.PAD (S), R81.1
PR_FET_3.3V-5: Q35.5 (S), Q35.6 (S), Q35.7 (S), Q35.8 (S), Q35.PAD (S), R79.1
PR_FET_3.3V-6: Q33.5 (S), Q33.6 (S), Q33.7 (S), Q33.8 (S), Q33.PAD (S), R77.1
PR_FET_3.3V-7: Q32.5 (S), Q32.6 (S), Q32.7 (S), Q32.8 (S), Q32.PAD (S), R75.1
PR_FET_3.3V-8: Q29.5 (S), Q29.6 (S), Q29.7 (S), Q29.8 (S), Q29.PAD (S), R73.1
PR_FET_3.3V-9: Q28.5 (S), Q28.6 (S), Q28.7 (S), Q28.8 (S), Q28.PAD (S), R69.1
PR_FET_3.3V-10: Q26.5 (S), Q26.6 (S), Q26.7 (S), Q26.8 (S), Q26.PAD (S), R66.1
PR_FET_3.3V-11: Q25.5 (S), Q25.6 (S), Q25.7 (S), Q25.8 (S), Q25.PAD (S), R64.1
PR_FET_3.3V-12: Q23.5 (S), Q23.6 (S), Q23.7 (S), Q23.8 (S), Q23.PAD (S), R62.1
TEMP-OUT_SW-0: RT8.2; also elsewhere on the board

Notes on the sheet:
0-2.08A=509µA/LSB
9A3>
9B3>
12A1>
12B1>
11B4>
10A1>
10B1>
10C1>
10D1>
9B2>

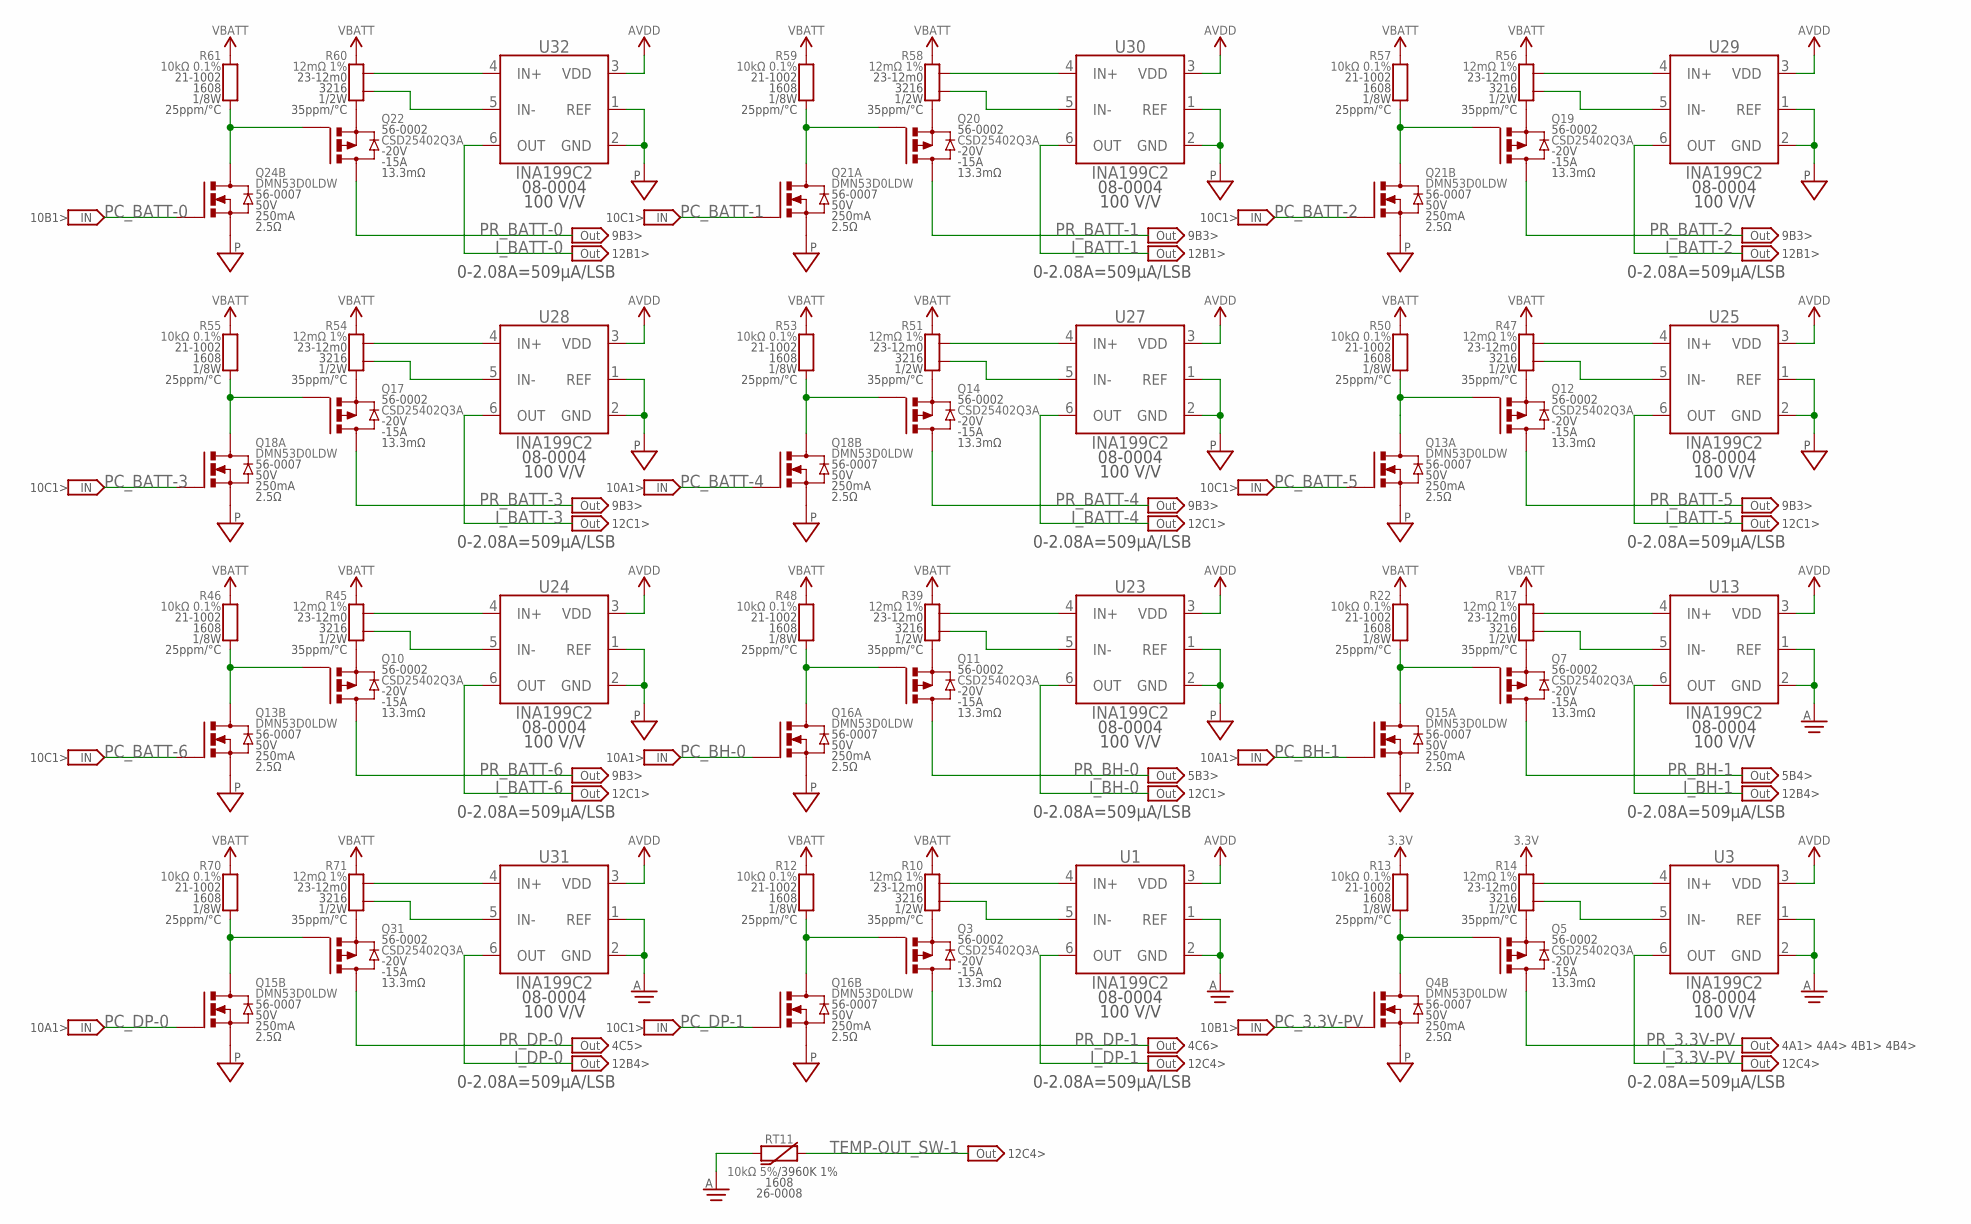
[picture p344: schematic EPS.sch, sheet 8]

Parts:
Q3, Q5, Q7, Q10, Q11, Q12, Q14, Q17, Q19, Q20, Q22, Q31: CSD25402Q3A; SON-3333
Q4, Q13, Q15, Q16, Q18, Q21, Q24: DMN53D0LDW; SOT363
R10, R14, R17, R39, R45, R47, R51, R54, R56, R58, R60, R71: 12mΩ 1%; 3216-KELVIN
R12, R13, R22, R46, R48, R50, R53, R55, R57, R59, R61, R70: 10kΩ 0.1%; 1608
RT11: 10kΩ 5%; 1608
U1, U3, U13, U23, U24, U25, U27, U28, U29, U30, U31, U32: INA199C2; SOT363

Connections:
3.3V: R13.2, R14.2; also elsewhere on the board
!PC_3.3V-PV: Q4.3 (D), Q5.4 (G), R13.1
!PC_BATT-0: Q22.4 (G), Q24.3 (D), R61.1
!PC_BATT-1: Q20.4 (G), Q21.6 (D), R59.1
!PC_BATT-2: Q19.4 (G), Q21.3 (D), R57.1
!PC_BATT-3: Q17.4 (G), Q18.6 (D), R55.1
!PC_BATT-4: Q14.4 (G), Q18.3 (D), R53.1
!PC_BATT-5: Q12.4 (G), Q13.6 (D), R50.1
!PC_BATT-6: Q10.4 (G), Q13.3 (D), R46.1
!PC_BH-0: Q11.4 (G), Q16.6 (D), R48.1
!PC_BH-1: Q7.4 (G), Q15.6 (D), R22.1
!PC_DP-0: Q15.3 (D), Q31.4 (G), R70.1
!PC_DP-1: Q3.4 (G), Q16.3 (D), R12.1
AGND: RT11.1, U1.1 (REF), U1.2 (GND), U3.1 (REF), U3.2 (GND), U13.1 (REF), U13.2 (GND), U31.1 (REF), U31.2 (GND); also elsewhere on the board
AVDD: U1.3 (VDD), U3.3 (VDD), U13.3 (VDD), U23.3 (VDD), U24.3 (VDD), U25.3 (VDD), U27.3 (VDD), U28.3 (VDD), U29.3 (VDD), U30.3 (VDD), U31.3 (VDD), U32.3 (VDD); also elsewhere on the board
I_3.3V-PV: U3.6 (OUT); also elsewhere on the board
I_3.3V-PV_N: R14.1-KELVIN, U3.5 (IN-)
I_3.3V-PV_P: R14.2-KELVIN, U3.4 (IN+)
I_BATT-0: U32.6 (OUT); also elsewhere on the board
I_BATT-0_N: R60.1-KELVIN, U32.5 (IN-)
I_BATT-0_P: R60.2-KELVIN, U32.4 (IN+)
I_BATT-1: U30.6 (OUT); also elsewhere on the board
I_BATT-1_N: R58.1-KELVIN, U30.5 (IN-)
I_BATT-1_P: R58.2-KELVIN, U30.4 (IN+)
I_BATT-2: U29.6 (OUT); also elsewhere on the board
I_BATT-2_N: R56.1-KELVIN, U29.5 (IN-)
I_BATT-2_P: R56.2-KELVIN, U29.4 (IN+)
I_BATT-3: U28.6 (OUT); also elsewhere on the board
I_BATT-3_N: R54.1-KELVIN, U28.5 (IN-)
I_BATT-3_P: R54.2-KELVIN, U28.4 (IN+)
I_BATT-4: U27.6 (OUT); also elsewhere on the board
I_BATT-4_N: R51.1-KELVIN, U27.5 (IN-)
I_BATT-4_P: R51.2-KELVIN, U27.4 (IN+)
I_BATT-5: U25.6 (OUT); also elsewhere on the board
I_BATT-5_N: R47.1-KELVIN, U25.5 (IN-)
I_BATT-5_P: R47.2-KELVIN, U25.4 (IN+)
I_BATT-6: U24.6 (OUT); also elsewhere on the board
I_BATT-6_N: R45.1-KELVIN, U24.5 (IN-)
I_BATT-6_P: R45.2-KELVIN, U24.4 (IN+)
I_BH-0: U23.6 (OUT); also elsewhere on the board
I_BH-0_N: R39.1-KELVIN, U23.5 (IN-)
I_BH-0_P: R39.2-KELVIN, U23.4 (IN+)
I_BH-1: U13.6 (OUT); also elsewhere on the board
I_BH-1_N: R17.1-KELVIN, U13.5 (IN-)
I_BH-1_P: R17.2-KELVIN, U13.4 (IN+)
I_DP-0: U31.6 (OUT); also elsewhere on the board
I_DP-0_N: R71.1-KELVIN, U31.5 (IN-)
I_DP-0_P: R71.2-KELVIN, U31.4 (IN+)
I_DP-1: U1.6 (OUT); also elsewhere on the board
I_DP-1_N: R10.1-KELVIN, U1.5 (IN-)
I_DP-1_P: R10.2-KELVIN, U1.4 (IN+)
PC_3.3V-PV: Q4.5 (G); also elsewhere on the board
PC_BATT-0: Q24.5 (G); also elsewhere on the board
PC_BATT-1: Q21.2 (G); also elsewhere on the board
PC_BATT-2: Q21.5 (G); also elsewhere on the board
PC_BATT-3: Q18.2 (G); also elsewhere on the board
PC_BATT-4: Q18.5 (G); also elsewhere on the board
PC_BATT-5: Q13.2 (G); also elsewhere on the board
PC_BATT-6: Q13.5 (G); also elsewhere on the board
PC_BH-0: Q16.2 (G); also elsewhere on the board
PC_BH-1: Q15.2 (G); also elsewhere on the board
PC_DP-0: Q15.5 (G); also elsewhere on the board
PC_DP-1: Q16.5 (G); also elsewhere on the board
PGND: Q4.4 (S), Q13.1 (S), Q13.4 (S), Q15.1 (S), Q15.4 (S), Q16.1 (S), Q16.4 (S), Q18.1 (S), Q18.4 (S), Q21.1 (S), Q21.4 (S), Q24.4 (S), U23.1 (REF), U23.2 (GND), U24.1 (REF), U24.2 (GND), U25.1 (REF), U25.2 (GND), U27.1 (REF), U27.2 (GND), U28.1 (REF), U28.2 (GND), U29.1 (REF), U29.2 (GND), U30.1 (REF), U30.2 (GND), U32.1 (REF), U32.2 (GND); also elsewhere on the board
PR_3.3V-PV: Q5.1 (D), Q5.2 (D), Q5.3 (D); also elsewhere on the board
PR_BATT-0: Q22.1 (D), Q22.2 (D), Q22.3 (D); also elsewhere on the board
PR_BATT-1: Q20.1 (D), Q20.2 (D), Q20.3 (D); also elsewhere on the board
PR_BATT-2: Q19.1 (D), Q19.2 (D), Q19.3 (D); also elsewhere on the board
PR_BATT-3: Q17.1 (D), Q17.2 (D), Q17.3 (D); also elsewhere on the board
PR_BATT-4: Q14.1 (D), Q14.2 (D), Q14.3 (D); also elsewhere on the board
PR_BATT-5: Q12.1 (D), Q12.2 (D), Q12.3 (D); also elsewhere on the board
PR_BATT-6: Q10.1 (D), Q10.2 (D), Q10.3 (D); also elsewhere on the board
PR_BH-0: Q11.1 (D), Q11.2 (D), Q11.3 (D); also elsewhere on the board
PR_BH-1: Q7.1 (D), Q7.2 (D), Q7.3 (D); also elsewhere on the board
PR_DP-0: Q31.1 (D), Q31.2 (D), Q31.3 (D); also elsewhere on the board
PR_DP-1: Q3.1 (D), Q3.2 (D), Q3.3 (D); also elsewhere on the board
PR_FET_3.3V-21: Q31.5 (S), Q31.6 (S), Q31.7 (S), Q31.8 (S), Q31.PAD (S), R71.1
PR_FET_3.3V-22: Q3.5 (S), Q3.6 (S), Q3.7 (S), Q3.8 (S), Q3.PAD (S), R10.1
PR_FET_3.3V-PV: Q5.5 (S), Q5.6 (S), Q5.7 (S), Q5.8 (S), Q5.PAD (S), R14.1
PR_FET_BATT-0: Q22.5 (S), Q22.6 (S), Q22.7 (S), Q22.8 (S), Q22.PAD (S), R60.1
PR_FET_BATT-1: Q20.5 (S), Q20.6 (S), Q20.7 (S), Q20.8 (S), Q20.PAD (S), R58.1
PR_FET_BATT-2: Q19.5 (S), Q19.6 (S), Q19.7 (S), Q19.8 (S), Q19.PAD (S), R56.1
PR_FET_BATT-3: Q17.5 (S), Q17.6 (S), Q17.7 (S), Q17.8 (S), Q17.PAD (S), R54.1
PR_FET_BATT-4: Q14.5 (S), Q14.6 (S), Q14.7 (S), Q14.8 (S), Q14.PAD (S), R51.1
PR_FET_BATT-5: Q12.5 (S), Q12.6 (S), Q12.7 (S), Q12.8 (S), Q12.PAD (S), R47.1
PR_FET_BATT-6: Q10.5 (S), Q10.6 (S), Q10.7 (S), Q10.8 (S), Q10.PAD (S), R45.1
PR_FET_BH-0: Q11.5 (S), Q11.6 (S), Q11.7 (S), Q11.8 (S), Q11.PAD (S), R39.1
PR_FET_BH-1: Q7.5 (S), Q7.6 (S), Q7.7 (S), Q7.8 (S), Q7.PAD (S), R17.1
TEMP-OUT_SW-1: RT11.2; also elsewhere on the board
VBATT: R10.2, R12.2, R17.2, R22.2, R39.2, R45.2, R46.2, R47.2, R48.2, R50.2, R51.2, R53.2, R54.2, R55.2, R56.2, R57.2, R58.2, R59.2, R60.2, R61.2, R70.2, R71.2; also elsewhere on the board

Notes on the sheet:
0-2.08A=509µA/LSB
10A1>
10B1>
10C1>
9B3>
5B3>
5B4>
4C5>
4C6>
4A1> 4A4> 4B1> 4B4>
12B1>
12C1>
12B4>
12C4>

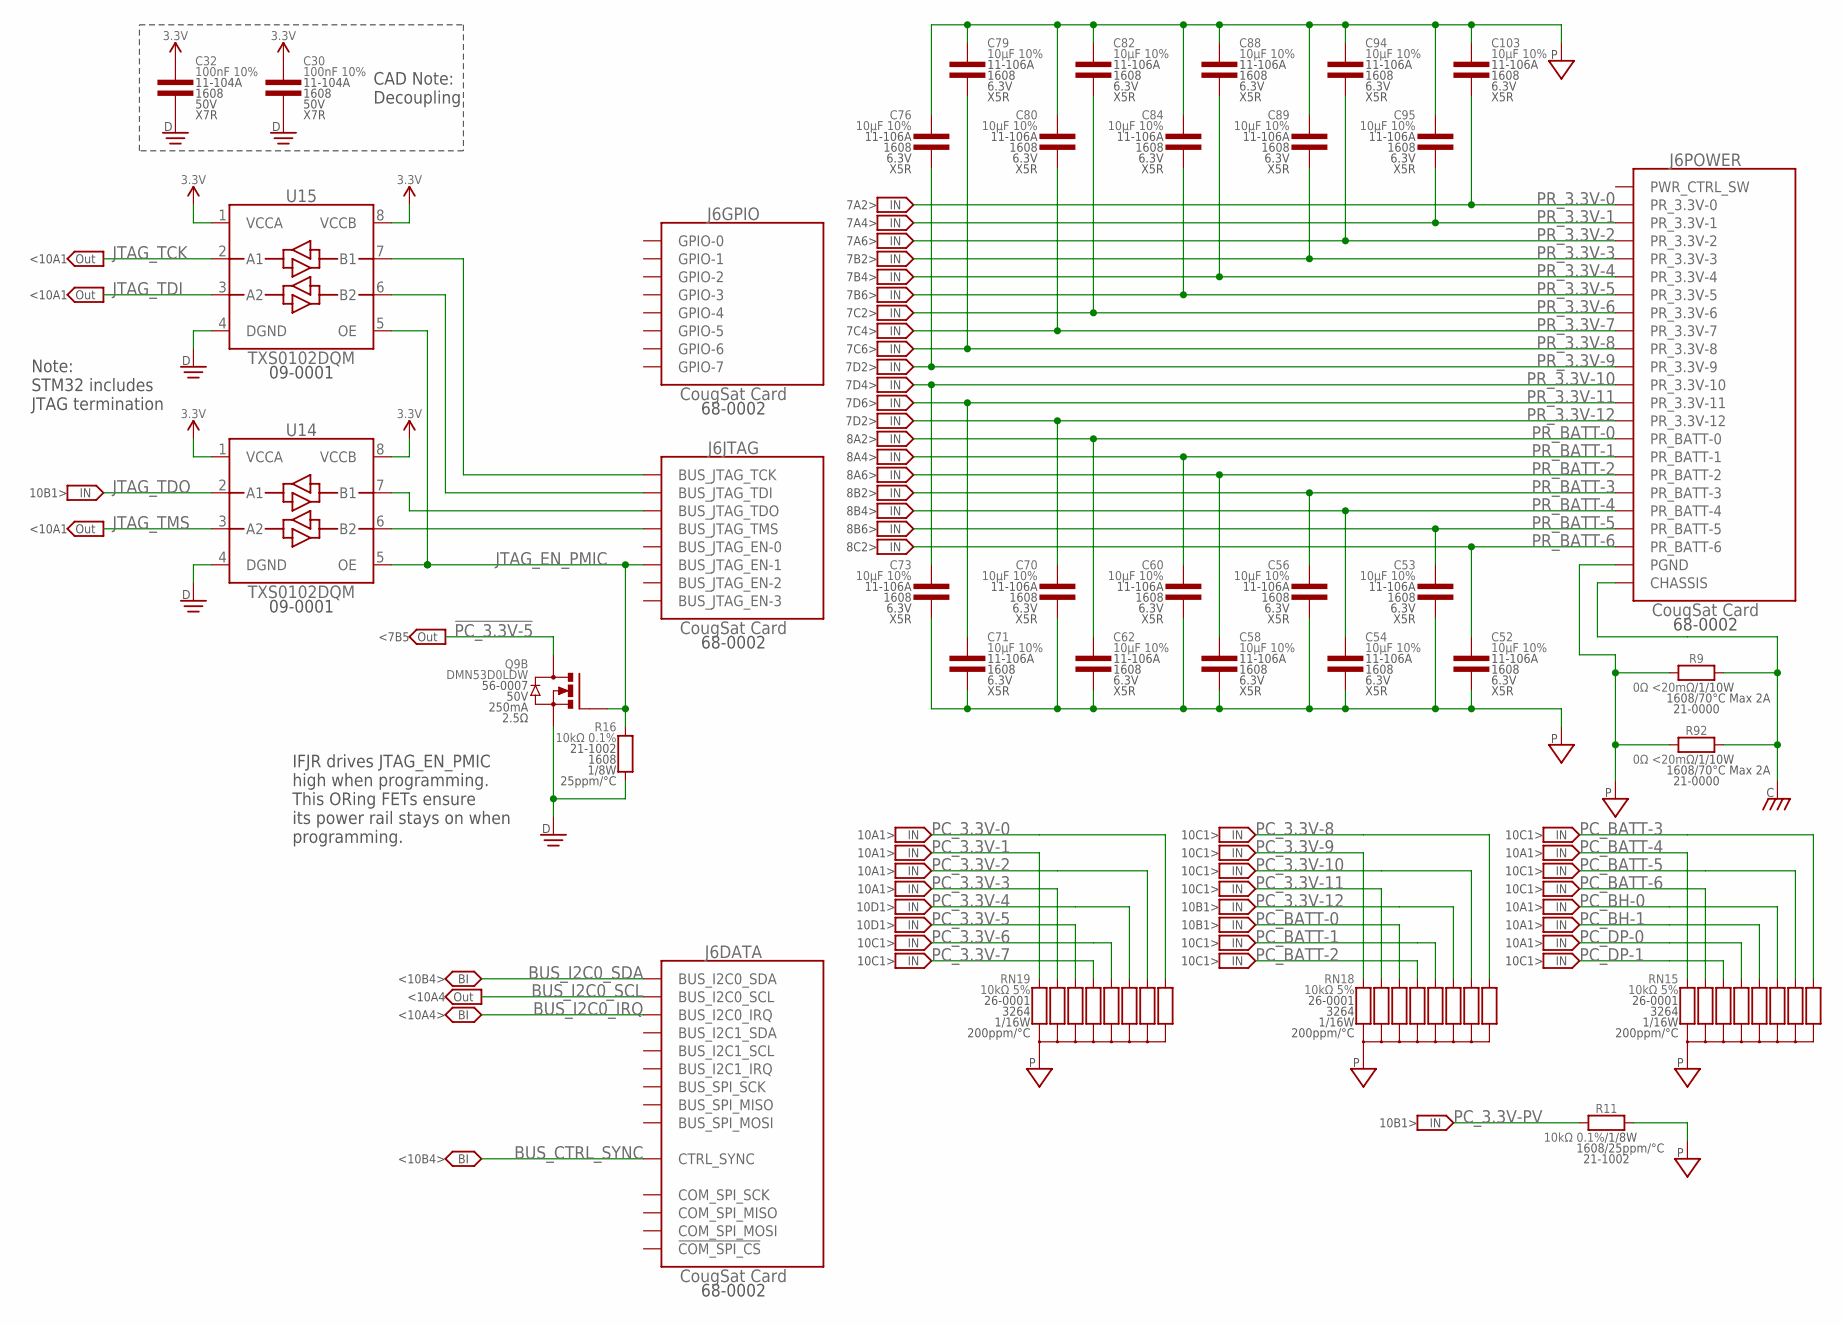
[picture p345: schematic EPS.sch, sheet 9]

Parts:
C30, C32: 100nF 10%; 1608
C52, C53, C54, C56, C58, C60, C62, C70, C71, C73, C76, C79, C80, C82, C84, C88, C89, C94, C95, C103: 10µF 10%; 1608
J6: CougSat Card; CARD-FULL-OPEN+X
Q9: DMN53D0LDW; SOT363
R9, R92: 0Ω <20mΩ; 1608
R11, R16: 10kΩ 0.1%; 1608
RN15, RN18, RN19: 10kΩ 5%; 3264
U14, U15: TXS0102DQM; X2SON-8

Connections:
3.3V: C30.1, C32.1, U14.1 (VCCA), U14.8 (VCCB), U15.1 (VCCA), U15.8 (VCCB); also elsewhere on the board
!PC_3.3V-5: Q9.3 (D); also elsewhere on the board
BUS_CTRL_SYNC: J6.A42 (CTRL_SYNC), J6.B42 (CTRL_SYNC); also elsewhere on the board
BUS_I2C0_IRQ: J6.A45 (BUS_I2C0_IRQ), J6.B45 (BUS_I2C0_IRQ); also elsewhere on the board
BUS_I2C0_SCL: J6.A44 (BUS_I2C0_SCL), J6.B44 (BUS_I2C0_SCL); also elsewhere on the board
BUS_I2C0_SDA: J6.A43 (BUS_I2C0_SDA), J6.B43 (BUS_I2C0_SDA); also elsewhere on the board
BUS_JTAG_TCK: J6.A46 (BUS_JTAG_TCK), U15.7 (B1)
BUS_JTAG_TDI: J6.A47 (BUS_JTAG_TDI), U15.6 (B2)
BUS_JTAG_TDO: J6.A48 (BUS_JTAG_TDO), U14.7 (B1)
BUS_JTAG_TMS: J6.A49 (BUS_JTAG_TMS), U14.6 (B2)
CHASSIS: J6.CHASSIS@1 (CHASSIS), J6.CHASSIS@2 (CHASSIS), J6.CHASSIS@3 (CHASSIS), J6.CHASSIS@4 (CHASSIS), R9.2, R92.2
DGND: C30.2, C32.2, Q9.4 (S), R16.1, U14.4 (DGND), U15.4 (DGND); also elsewhere on the board
JTAG_EN_PMIC: J6.B47 (BUS_JTAG_EN-1), Q9.5 (G), R16.2, U14.5 (OE), U15.5 (OE)
JTAG_TCK: U15.2 (A1); also elsewhere on the board
JTAG_TDI: U15.3 (A2); also elsewhere on the board
JTAG_TDO: U14.2 (A1); also elsewhere on the board
JTAG_TMS: U14.3 (A2); also elsewhere on the board
PC_3.3V-0: RN19.9 (8); also elsewhere on the board
PC_3.3V-1: RN19.1; also elsewhere on the board
PC_3.3V-2: RN19.8 (7); also elsewhere on the board
PC_3.3V-3: RN19.2; also elsewhere on the board
PC_3.3V-4: RN19.7 (6); also elsewhere on the board
PC_3.3V-5: RN19.3; also elsewhere on the board
PC_3.3V-6: RN19.6 (5); also elsewhere on the board
PC_3.3V-7: RN19.4; also elsewhere on the board
PC_3.3V-8: RN18.9 (8); also elsewhere on the board
PC_3.3V-9: RN18.1; also elsewhere on the board
PC_3.3V-10: RN18.8 (7); also elsewhere on the board
PC_3.3V-11: RN18.2; also elsewhere on the board
PC_3.3V-12: RN18.7 (6); also elsewhere on the board
PC_3.3V-PV: R11.1; also elsewhere on the board
PC_BATT-0: RN18.3; also elsewhere on the board
PC_BATT-1: RN18.6 (5); also elsewhere on the board
PC_BATT-2: RN18.4; also elsewhere on the board
PC_BATT-3: RN15.9 (8); also elsewhere on the board
PC_BATT-4: RN15.1; also elsewhere on the board
PC_BATT-5: RN15.8 (7); also elsewhere on the board
PC_BATT-6: RN15.2; also elsewhere on the board
PC_BH-0: RN15.7 (6); also elsewhere on the board
PC_BH-1: RN15.6 (5); also elsewhere on the board
PC_DP-0: RN15.4; also elsewhere on the board
PC_DP-1: RN15.3; also elsewhere on the board
PGND: C52.2, C53.2, C54.2, C56.2, C58.2, C60.2, C62.2, C70.2, C71.2, C73.2, C76.1, C79.1, C80.1, C82.1, C84.1, C88.1, C89.1, C94.1, C95.1, C103.1, J6.A21 (PGND), J6.A22 (PGND), J6.A23 (PGND), J6.B21 (PGND), J6.B22 (PGND), J6.B23 (PGND), J6.B24 (PGND), J6.B25 (PGND), J6.B26 (PGND), J6.B27 (PGND), J6.B28 (PGND), J6.B29 (PGND), R9.1, R11.2, R92.1, RN15.5 (C), RN15.10 (C), RN18.5 (C), RN18.10 (C), RN19.5 (C), RN19.10 (C); also elsewhere on the board
PR_3.3V-0: C103.2, J6.A1 (PR_3.3V-0), J6.B1 (PR_3.3V-0); also elsewhere on the board
PR_3.3V-1: C95.2, J6.A2 (PR_3.3V-1), J6.B2 (PR_3.3V-1); also elsewhere on the board
PR_3.3V-2: C94.2, J6.A3 (PR_3.3V-2), J6.B3 (PR_3.3V-2); also elsewhere on the board
PR_3.3V-3: C89.2, J6.A4 (PR_3.3V-3), J6.B4 (PR_3.3V-3); also elsewhere on the board
PR_3.3V-4: C88.2, J6.A5 (PR_3.3V-4), J6.B5 (PR_3.3V-4); also elsewhere on the board
PR_3.3V-5: C84.2, J6.A6 (PR_3.3V-5), J6.B6 (PR_3.3V-5); also elsewhere on the board
PR_3.3V-6: C82.2, J6.A7 (PR_3.3V-6), J6.B7 (PR_3.3V-6); also elsewhere on the board
PR_3.3V-7: C80.2, J6.A8 (PR_3.3V-7), J6.B8 (PR_3.3V-7); also elsewhere on the board
PR_3.3V-8: C79.2, J6.A9 (PR_3.3V-8), J6.B9 (PR_3.3V-8); also elsewhere on the board
PR_3.3V-9: C76.2, J6.A10 (PR_3.3V-9), J6.B10 (PR_3.3V-9); also elsewhere on the board
PR_3.3V-10: C73.1, J6.A11 (PR_3.3V-10), J6.B11 (PR_3.3V-10); also elsewhere on the board
PR_3.3V-11: C71.1, J6.A12 (PR_3.3V-11), J6.B12 (PR_3.3V-11); also elsewhere on the board
PR_3.3V-12: C70.1, J6.A13 (PR_3.3V-12), J6.B13 (PR_3.3V-12); also elsewhere on the board
PR_BATT-0: C62.1, J6.A14 (PR_BATT-0), J6.B14 (PR_BATT-0); also elsewhere on the board
PR_BATT-1: C60.1, J6.A15 (PR_BATT-1), J6.B15 (PR_BATT-1); also elsewhere on the board
PR_BATT-2: C58.1, J6.A16 (PR_BATT-2), J6.B16 (PR_BATT-2); also elsewhere on the board
PR_BATT-3: C56.1, J6.A17 (PR_BATT-3), J6.B17 (PR_BATT-3); also elsewhere on the board
PR_BATT-4: C54.1, J6.A18 (PR_BATT-4), J6.B18 (PR_BATT-4); also elsewhere on the board
PR_BATT-5: C53.1, J6.A19 (PR_BATT-5), J6.B19 (PR_BATT-5); also elsewhere on the board
PR_BATT-6: C52.1, J6.A20 (PR_BATT-6), J6.B20 (PR_BATT-6); also elsewhere on the board

Notes on the sheet:
CAD Note: Decoupling
Note: STM32 includes JTAG termination
IFJR drives JTAG_EN_PMIC high when programming. This ORing FETs ensure its power rail stays on when programming.
<10A1
10B1>
10C1>
10D1>
10A1>
<10B4>
<10A4>
<10A4
<7B5
7A2>
7A4>
7A6>
7B2>
7B4>
7B6>
7C2>
7C4>
7C6>
7D2>
7D4>
7D6>
8A2>
8A4>
8A6>
8B2>
8B4>
8B6>
8C2>
