CougsInSpace/CougSat1-Hardware/CougSat1-PowerBoard/ElectricalDesign/EPS.brd

## EAGLE design CougSat1-PowerBoard/ElectricalDesign/EPS.brd (continued)

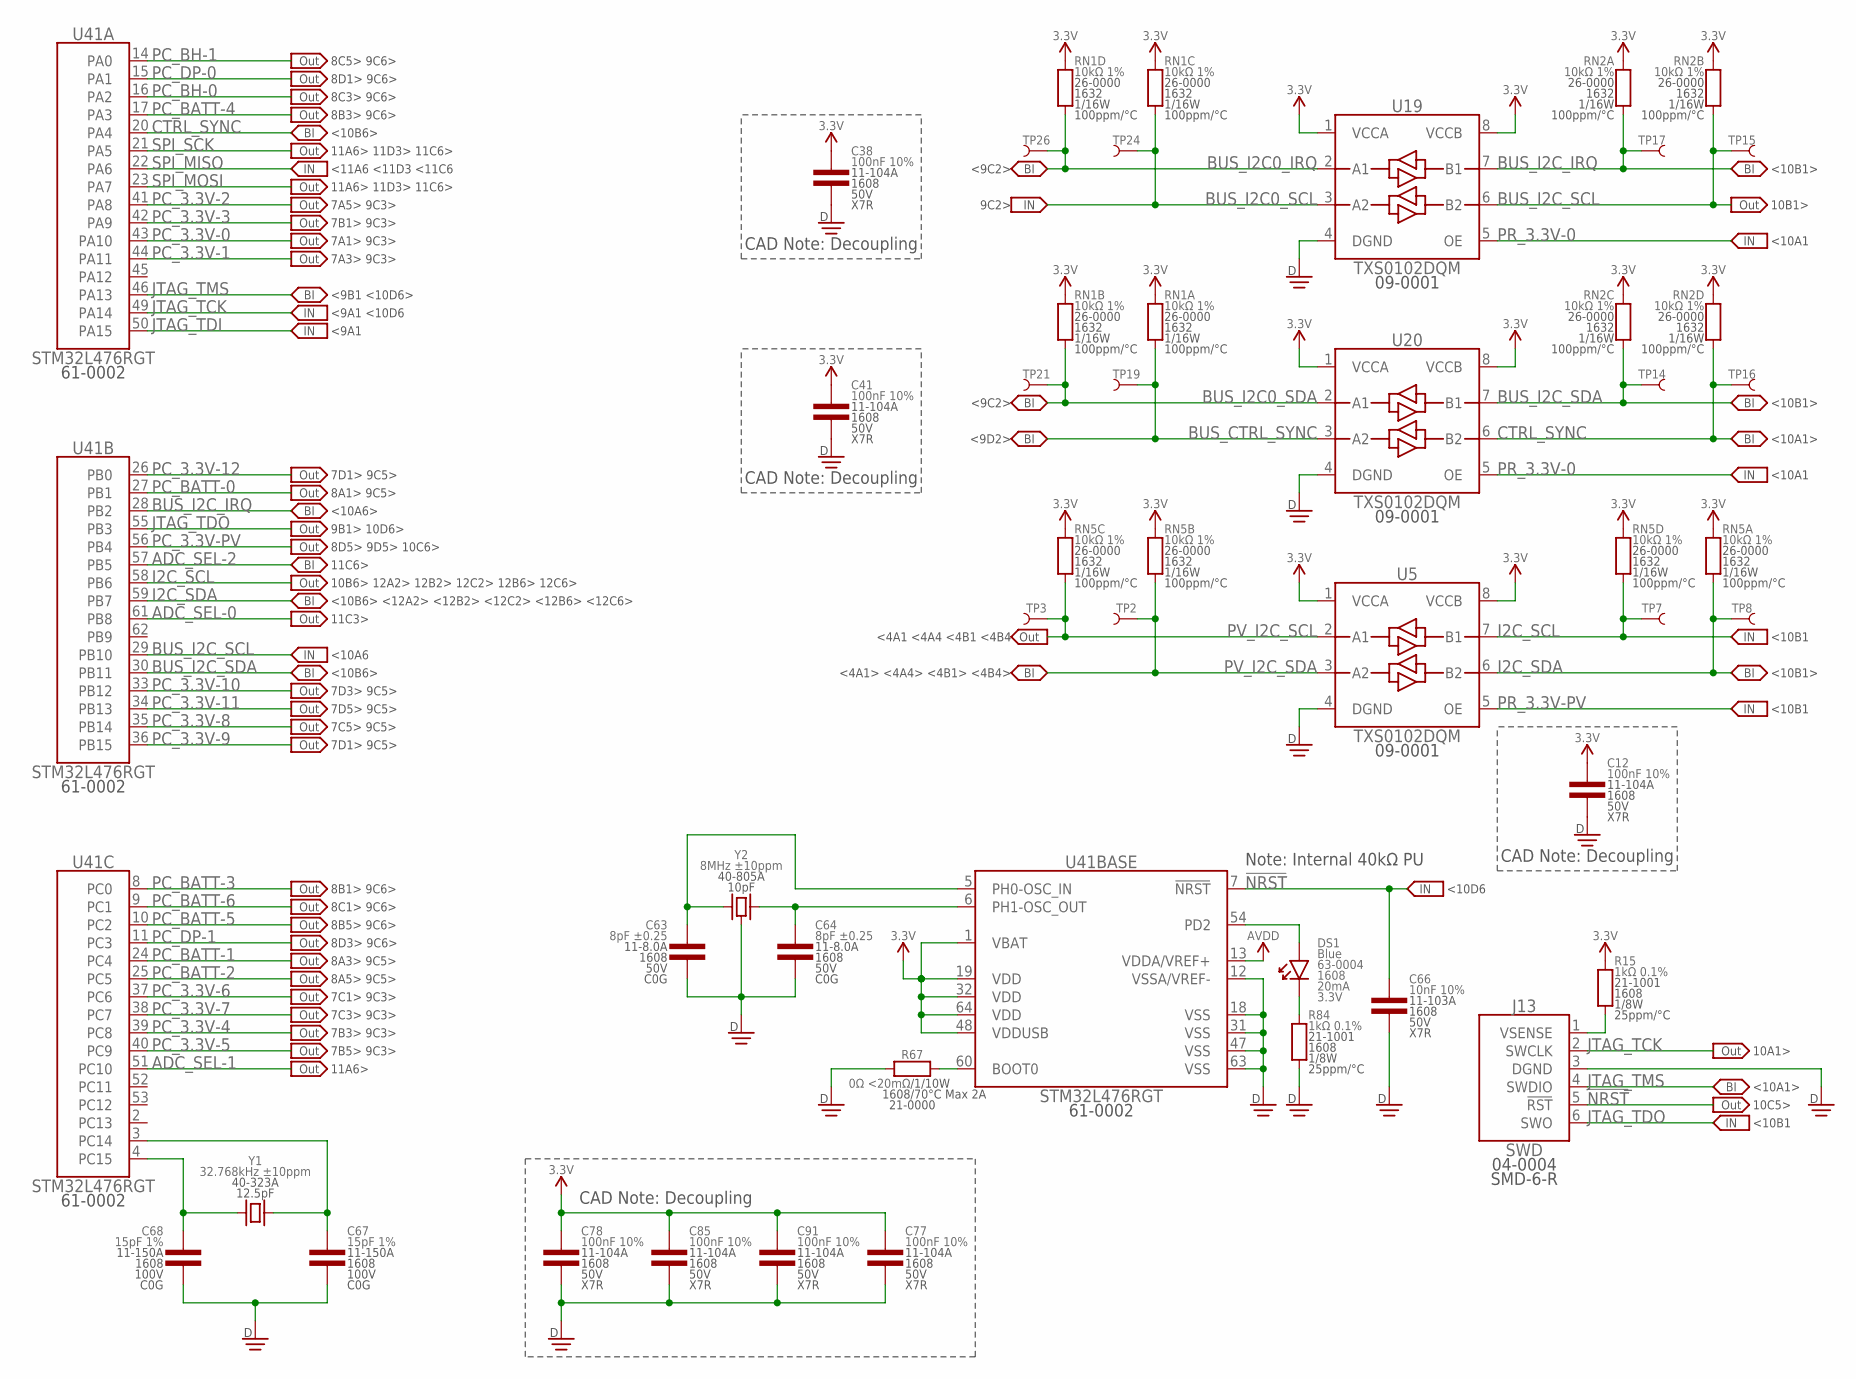
[picture p346: schematic EPS.sch, sheet 10]

Parts:
C12, C38, C41, C77, C78, C85, C91: 100nF 10%; 1608
C63, C64: 8pF ±0.25; 1608
C66: 10nF 10%; 1608
C67, C68: 15pF 1%; 1608
DS1: Blue; 1608-POL
J13: SWD; SMD2.54-1X06-R
R15, R84: 1kΩ 0.1%; 1608
R67: 0Ω <20mΩ; 1608
RN1, RN2, RN5: 10kΩ 1%; 1632
TP2, TP3, TP7, TP8, TP14, TP15, TP16, TP17, TP19, TP21, TP24, TP26: TEST_POINT-SMD-C-1.25; SMD-C-1.25
U5, U19, U20: TXS0102DQM; X2SON-8
U41: STM32L476RGT; QFP-64-1010
Y1: 32.768kHz ±10ppm; SMD-3215
Y2: 8MHz ±10ppm; SMD-5032

Connections:
3.3V: C12.1, C38.1, C41.1, C77.1, C78.1, C85.1, C91.1, R15.2, RN1.5 (2), RN1.6 (2), RN1.7 (2), RN1.8 (2), RN2.5 (2), RN2.6 (2), RN2.7 (2), RN2.8 (2), RN5.5 (2), RN5.6 (2), RN5.7 (2), RN5.8 (2), U5.1 (VCCA), U5.8 (VCCB), U19.1 (VCCA), U19.8 (VCCB), U20.1 (VCCA), U20.8 (VCCB), U41.1 (VBAT), U41.19 (VDD), U41.32 (VDD), U41.48 (VDDUSB), U41.64 (VDD); also elsewhere on the board
!NRST: C66.1, J13.5 (!RST), U41.7 (!NRST)
ADC_SEL-0: U41.61 (PB8); also elsewhere on the board
ADC_SEL-1: U41.51 (PC10); also elsewhere on the board
ADC_SEL-2: U41.57 (PB5); also elsewhere on the board
AVDD: U41.13 (VDDA/VREF+); also elsewhere on the board
BOOT0: R67.2, U41.60 (BOOT0)
BUS_CTRL_SYNC: RN1.1, TP19.1, U20.3 (A2); also elsewhere on the board
BUS_I2C0_IRQ: RN1.4 (1), TP26.1, U19.2 (A1); also elsewhere on the board
BUS_I2C0_SCL: RN1.3 (1), TP24.1, U19.3 (A2); also elsewhere on the board
BUS_I2C0_SDA: RN1.2 (1), TP21.1, U20.2 (A1); also elsewhere on the board
BUS_I2C_IRQ: RN2.1, TP17.1, U19.7 (B1), U41.28 (PB2)
BUS_I2C_SCL: RN2.2 (1), TP15.1, U19.6 (B2), U41.29 (PB10)
BUS_I2C_SDA: RN2.3 (1), TP14.1, U20.7 (B1), U41.30 (PB11)
CTRL_SYNC: RN2.4 (1), TP16.1, U20.6 (B2), U41.20 (PA4)
DGND: C12.2, C38.2, C41.2, C63.2, C64.2, C66.2, C67.2, C68.2, C77.2, C78.2, C85.2, C91.2, J13.3 (DGND), R67.1, R84.1, U5.4 (DGND), U19.4 (DGND), U20.4 (DGND), U41.12 (VSSA/VREF-), U41.18 (VSS), U41.31 (VSS), U41.47 (VSS), U41.63 (VSS), Y2.2 (GND), Y2.4 (GND); also elsewhere on the board
I2C_SCL: RN5.4 (1), TP7.1, U5.7 (B1), U41.58 (PB6); also elsewhere on the board
I2C_SDA: RN5.1, TP8.1, U5.6 (B2), U41.59 (PB7); also elsewhere on the board
JTAG_TCK: J13.2 (SWCLK), U41.49 (PA14); also elsewhere on the board
JTAG_TDI: U41.50 (PA15); also elsewhere on the board
JTAG_TDO: J13.6 (SWO), U41.55 (PB3); also elsewhere on the board
JTAG_TMS: J13.4 (SWDIO), U41.46 (PA13); also elsewhere on the board
OSC32_IN: C67.1, U41.3 (PC14), Y1.2
OSC32_OUT: C68.1, U41.4 (PC15), Y1.1
OSC_IN: C63.1, U41.5 (PH0-OSC_IN), Y2.1
OSC_OUT: C64.1, U41.6 (PH1-OSC_OUT), Y2.3 (2)
PC_3.3V-0: U41.43 (PA10); also elsewhere on the board
PC_3.3V-1: U41.44 (PA11); also elsewhere on the board
PC_3.3V-2: U41.41 (PA8); also elsewhere on the board
PC_3.3V-3: U41.42 (PA9); also elsewhere on the board
PC_3.3V-4: U41.39 (PC8); also elsewhere on the board
PC_3.3V-5: U41.40 (PC9); also elsewhere on the board
PC_3.3V-6: U41.37 (PC6); also elsewhere on the board
PC_3.3V-7: U41.38 (PC7); also elsewhere on the board
PC_3.3V-8: U41.35 (PB14); also elsewhere on the board
PC_3.3V-9: U41.36 (PB15); also elsewhere on the board
PC_3.3V-10: U41.33 (PB12); also elsewhere on the board
PC_3.3V-11: U41.34 (PB13); also elsewhere on the board
PC_3.3V-12: U41.26 (PB0); also elsewhere on the board
PC_3.3V-PV: U41.56 (PB4); also elsewhere on the board
PC_BATT-0: U41.27 (PB1); also elsewhere on the board
PC_BATT-1: U41.24 (PC4); also elsewhere on the board
PC_BATT-2: U41.25 (PC5); also elsewhere on the board
PC_BATT-3: U41.8 (PC0); also elsewhere on the board
PC_BATT-4: U41.17 (PA3); also elsewhere on the board
PC_BATT-5: U41.10 (PC2); also elsewhere on the board
PC_BATT-6: U41.9 (PC1); also elsewhere on the board
PC_BH-0: U41.16 (PA2); also elsewhere on the board
PC_BH-1: U41.14 (PA0); also elsewhere on the board
PC_DP-0: U41.15 (PA1); also elsewhere on the board
PC_DP-1: U41.11 (PC3); also elsewhere on the board
PMIC_LED-A: DS1.A, U41.54 (EXTRA_PIN)
PMIC_LED-C: DS1.C, R84.2
PR_3.3V-0: U19.5 (OE), U20.5 (OE); also elsewhere on the board
PR_3.3V-PV: U5.5 (OE); also elsewhere on the board
PV_I2C_SCL: RN5.3 (1), TP3.1, U5.2 (A1); also elsewhere on the board
PV_I2C_SDA: RN5.2 (1), TP2.1, U5.3 (A2); also elsewhere on the board
SPI_MISO: U41.22 (PA6); also elsewhere on the board
SPI_MOSI: U41.23 (PA7); also elsewhere on the board
SPI_SCK: U41.21 (PA5); also elsewhere on the board
SWD_VSENSE: J13.1 (VSENSE), R15.1

Notes on the sheet:
CAD Note: Decoupling
Note: Internal 40kΩ PU
<9C2>
9C2>
<9D2>
<4A1> <4A4> <4B1> <4B4>
<4A1 <4A4 <4B1 <4B4
<10B1>
10B1>
<10A1>
<10A1
<10B1
<10D6
10A1>
10C5>
8C5> 9C6>
8C3> 9C6>
8D3> 9C6>
8D1> 9C6>
8D5> 9D5> 10C6>
8B5> 9C6>
8B3> 9C6>
8B1> 9C6>
8C1> 9C6>
8A1> 9C5>
8A3> 9C5>
8A5> 9C5>
7C5> 9C5>
7D5> 9C5>
7D3> 9C5>
7D1> 9C5>
7A1> 9C3>
7A3> 9C3>
7A5> 9C3>
7B5> 9C3>
7B3> 9C3>
7B1> 9C3>
7C1> 9C3>
7C3> 9C3>
11C3>
11C6>
11A6>
<10B6>
<10A6>
<10A6
<9B1 <10D6>
<9A1 <10D6
<9A1
9B1> 10D6>
11A6> 11D3> 11C6>
<11A6 <11D3 <11C6
10B6> 12A2> 12B2> 12C2> 12B6> 12C6>
<10B6> <12A2> <12B2> <12C2> <12B6> <12C6>

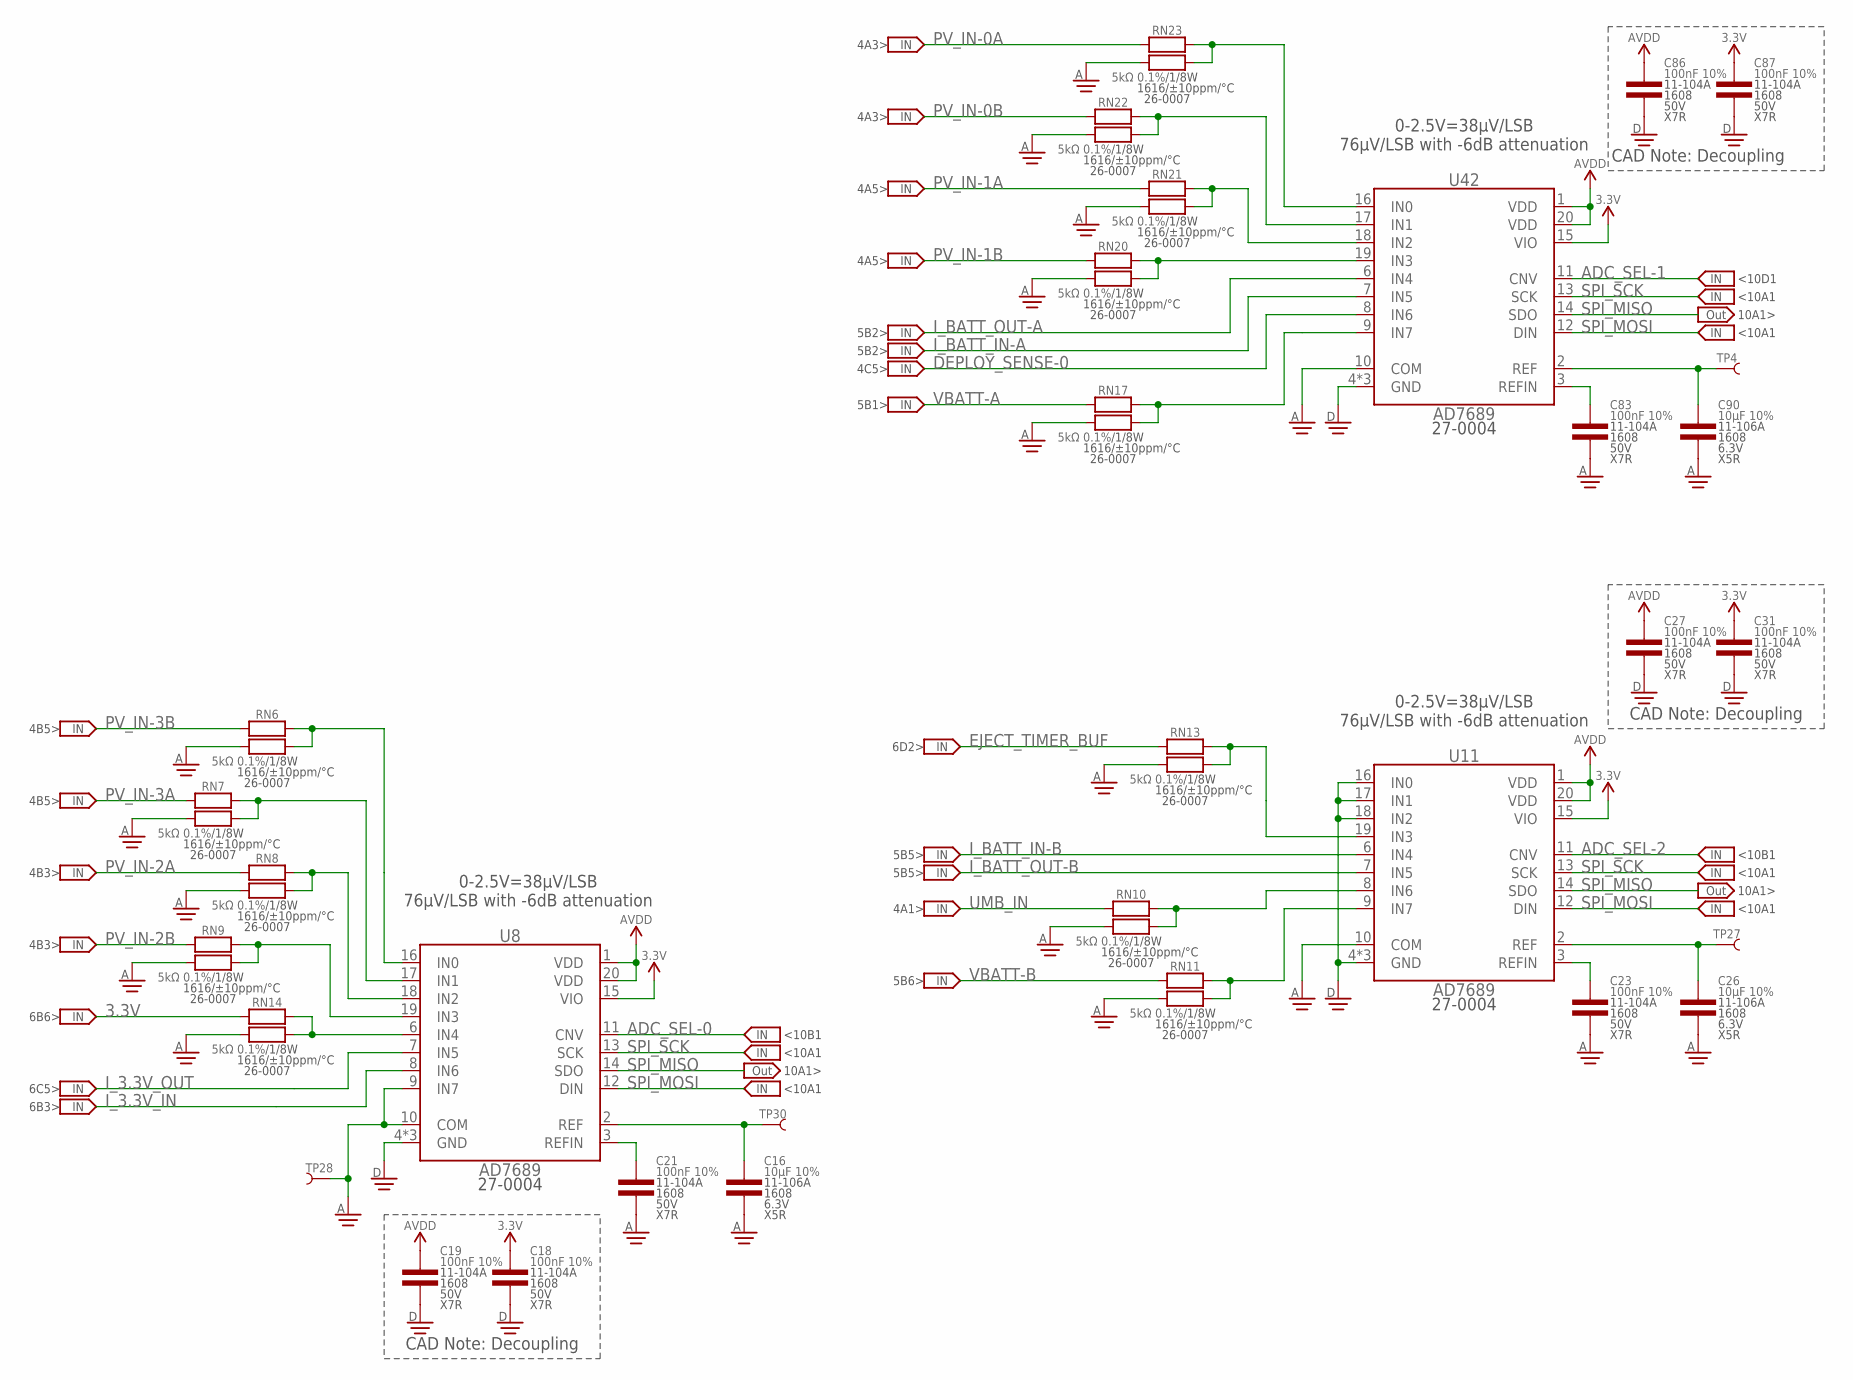
[picture p347: schematic EPS.sch, sheet 11]

Parts:
C16, C26, C90: 10µF 10%; 1608
C18, C19, C21, C23, C27, C31, C83, C86, C87: 100nF 10%; 1608
RN6, RN7, RN8, RN9, RN10, RN11, RN13, RN14, RN17, RN20, RN21, RN22, RN23: 5kΩ 0.1%; 1616
TP4, TP27, TP28, TP30: TEST_POINT-SMD-C-1.25; SMD-C-1.25
U8, U11, U42: AD7689; QFN-20-4040

Connections:
3.3V: C18.1, C31.1, C87.1, RN14.2 (B1), U8.15 (VIO), U11.15 (VIO), U42.15 (VIO); also elsewhere on the board
ADC_3.3V: RN14.3 (B2), RN14.4 (A2), U8.6 (IN4)
ADC_EJECT_TIMER_BUF: RN13.3 (B2), RN13.4 (A2), U11.19 (IN3)
ADC_PV_IN-0A: RN23.3 (B2), RN23.4 (A2), U42.16 (IN0)
ADC_PV_IN-0B: RN22.3 (B2), RN22.4 (A2), U42.17 (IN1)
ADC_PV_IN-1A: RN21.3 (B2), RN21.4 (A2), U42.18 (IN2)
ADC_PV_IN-1B: RN20.3 (B2), RN20.4 (A2), U42.19 (IN3)
ADC_PV_IN-2A: RN8.3 (B2), RN8.4 (A2), U8.18 (IN2)
ADC_PV_IN-2B: RN9.3 (B2), RN9.4 (A2), U8.19 (IN3)
ADC_PV_IN-3A: RN7.3 (B2), RN7.4 (A2), U8.17 (IN1)
ADC_PV_IN-3B: RN6.3 (B2), RN6.4 (A2), U8.16 (IN0)
ADC_REF-0: C16.1, TP30.1, U8.2 (REF)
ADC_REF-1: C90.1, TP4.1, U42.2 (REF)
ADC_REF-2: C26.1, TP27.1, U11.2 (REF)
ADC_REFIN-0: C21.1, U8.3 (REFIN)
ADC_REFIN-1: C83.1, U42.3 (REFIN)
ADC_REFIN-2: C23.1, U11.3 (REFIN)
ADC_SEL-0: U8.11 (CNV); also elsewhere on the board
ADC_SEL-1: U42.11 (CNV); also elsewhere on the board
ADC_SEL-2: U11.11 (CNV); also elsewhere on the board
ADC_UMB_IN: RN10.3 (B2), RN10.4 (A2), U11.8 (IN6)
ADC_VBATT-A: RN17.3 (B2), RN17.4 (A2), U42.9 (IN7)
ADC_VBATT-B: RN11.3 (B2), RN11.4 (A2), U11.9 (IN7)
AGND: C16.2, C21.2, C23.2, C26.2, C83.2, C90.2, RN6.1 (A1), RN7.1 (A1), RN8.1 (A1), RN9.1 (A1), RN10.1 (A1), RN11.1 (A1), RN13.1 (A1), RN14.1 (A1), RN17.1 (A1), RN20.1 (A1), RN21.1 (A1), RN22.1 (A1), RN23.1 (A1), TP28.1, U8.9 (IN7), U8.10 (COM), U11.10 (COM), U42.10 (COM); also elsewhere on the board
AVDD: C19.1, C27.1, C86.1, U8.1 (VDD), U8.20 (VDD), U11.1 (VDD), U11.20 (VDD), U42.1 (VDD), U42.20 (VDD); also elsewhere on the board
DEPLOY_SENSE-0: U42.8 (IN6); also elsewhere on the board
DGND: C18.2, C19.2, C27.2, C31.2, C86.2, C87.2, U8.4 (GND), U8.5 (GND), U8.PAD (GND), U11.4 (GND), U11.5 (GND), U11.16 (IN0), U11.17 (IN1), U11.18 (IN2), U11.PAD (GND), U42.4 (GND), U42.5 (GND), U42.PAD (GND); also elsewhere on the board
EJECT_TIMER_BUF: RN13.2 (B1); also elsewhere on the board
I_3.3V_IN: U8.8 (IN6); also elsewhere on the board
I_3.3V_OUT: U8.7 (IN5); also elsewhere on the board
I_BATT_IN-A: U42.7 (IN5); also elsewhere on the board
I_BATT_IN-B: U11.6 (IN4); also elsewhere on the board
I_BATT_OUT-A: U42.6 (IN4); also elsewhere on the board
I_BATT_OUT-B: U11.7 (IN5); also elsewhere on the board
PV_IN-0A: RN23.2 (B1); also elsewhere on the board
PV_IN-0B: RN22.2 (B1); also elsewhere on the board
PV_IN-1A: RN21.2 (B1); also elsewhere on the board
PV_IN-1B: RN20.2 (B1); also elsewhere on the board
PV_IN-2A: RN8.2 (B1); also elsewhere on the board
PV_IN-2B: RN9.2 (B1); also elsewhere on the board
PV_IN-3A: RN7.2 (B1); also elsewhere on the board
PV_IN-3B: RN6.2 (B1); also elsewhere on the board
SPI_MISO: U8.14 (SDO), U11.14 (SDO), U42.14 (SDO); also elsewhere on the board
SPI_MOSI: U8.12 (DIN), U11.12 (DIN), U42.12 (DIN); also elsewhere on the board
SPI_SCK: U8.13 (SCK), U11.13 (SCK), U42.13 (SCK); also elsewhere on the board
UMB_IN: RN10.2 (B1); also elsewhere on the board
VBATT-A: RN17.2 (B1); also elsewhere on the board
VBATT-B: RN11.2 (B1); also elsewhere on the board

Notes on the sheet:
CAD Note: Decoupling
0-2.5V=38µV/LSB 76µV/LSB with -6dB attenuation
4A3>
4A5>
4B5>
4B3>
4A1>
4C5>
5B2>
5B5>
5B6>
5B1>
6B6>
6C5>
6B3>
6D2>
<10A1
10A1>
<10B1
<10D1

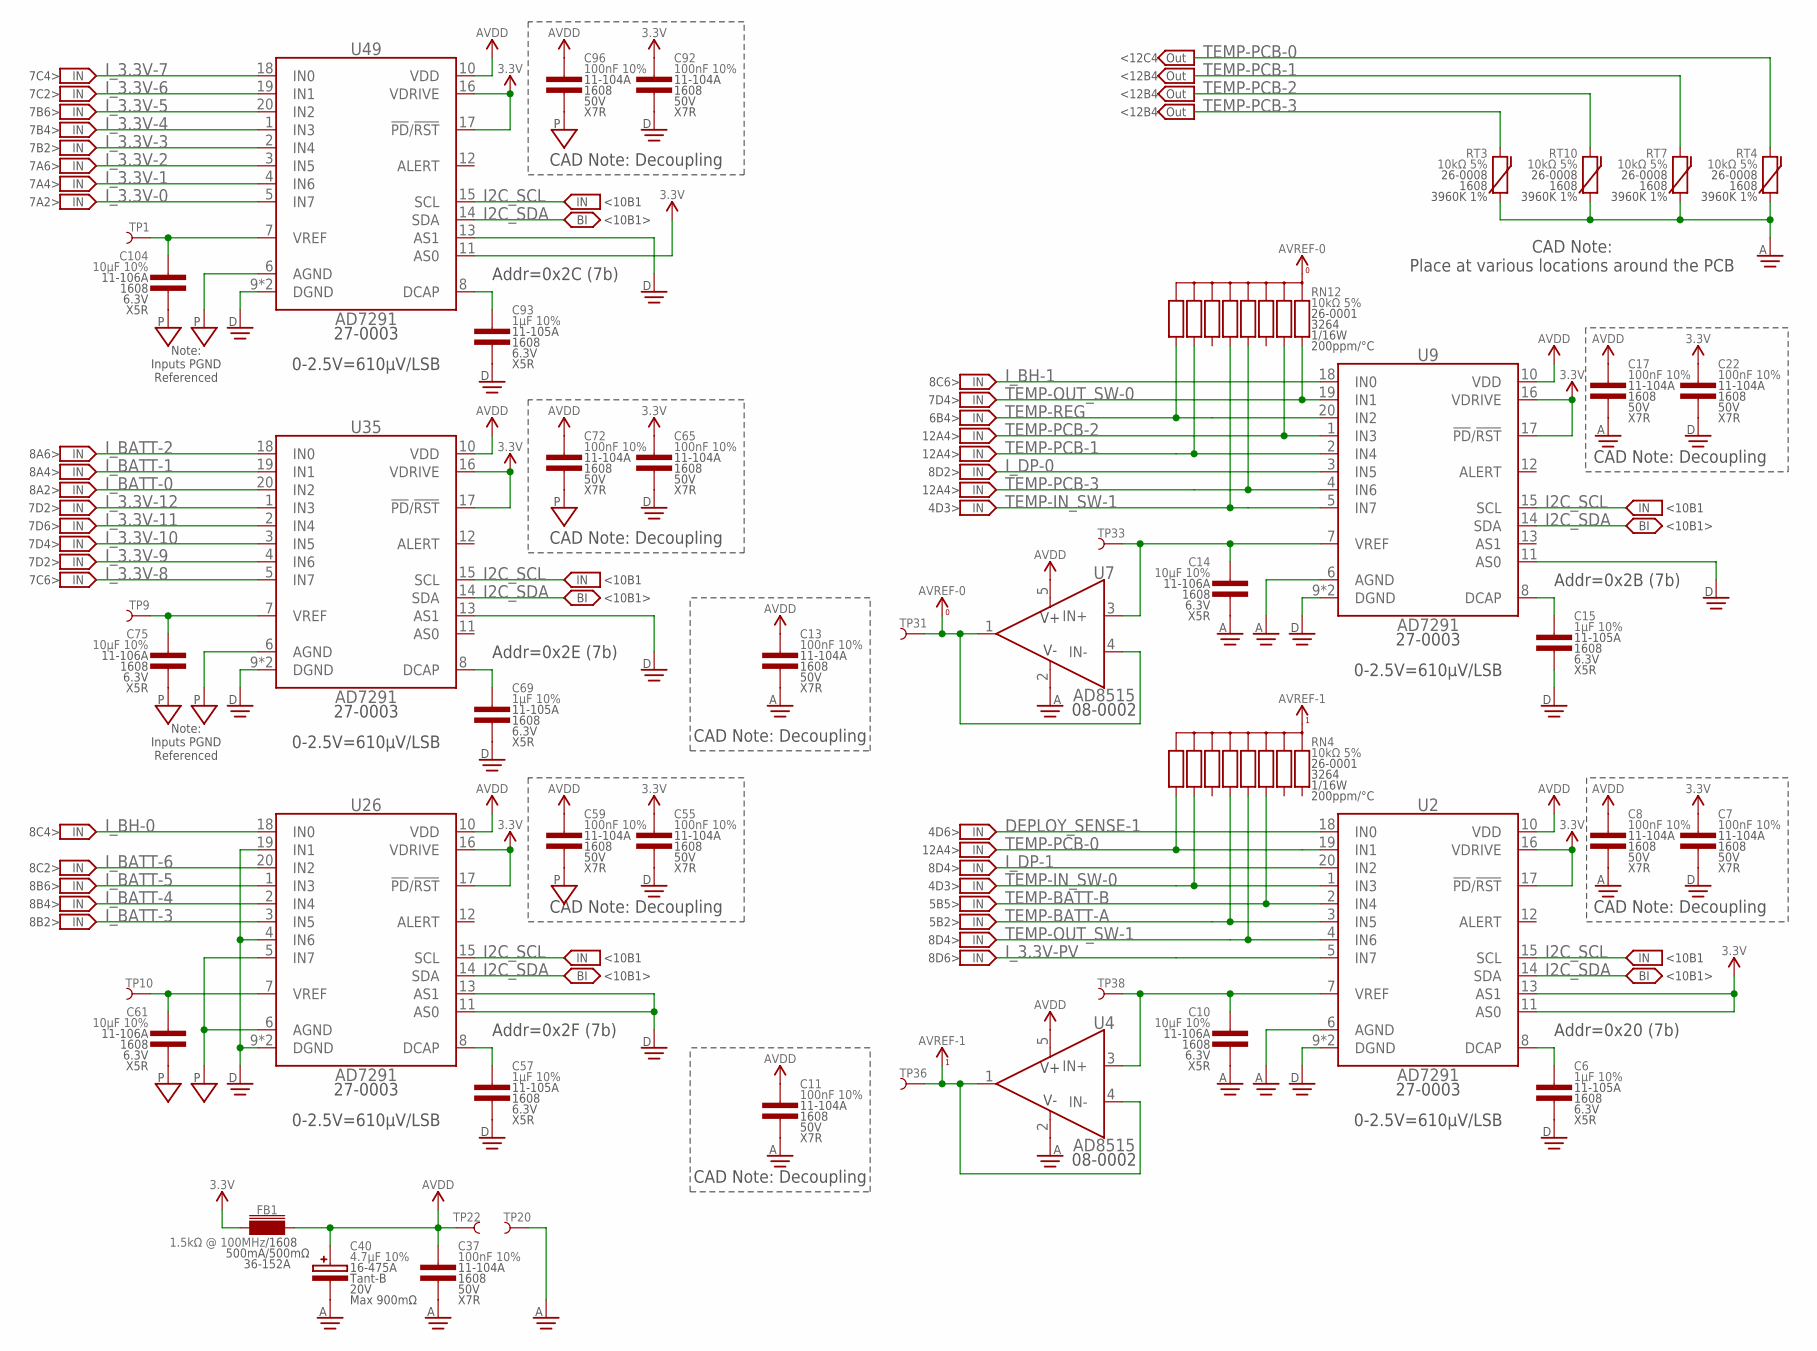
[picture p348: schematic EPS.sch, sheet 12]

Parts:
C6, C15, C57, C69, C93: 1µF 10%; 1608
C7, C8, C11, C13, C17, C22, C37, C55, C59, C65, C72, C92, C96: 100nF 10%; 1608
C10, C14, C61, C75, C104: 10µF 10%; 1608
C40: 4.7µF 10%; 4028-POL
FB1: 1.5kΩ @ 100MHz; 1608
RN4, RN12: 10kΩ 5%; 3264
RT3, RT4, RT7, RT10: 10kΩ 5%; 1608
TP1, TP9, TP10, TP20, TP22, TP31, TP33, TP36, TP38: TEST_POINT-SMD-C-1.25; SMD-C-1.25
U2, U9, U26, U35, U49: AD7291; QFN-20-4040
U4, U7: AD8515; SOT23-5

Connections:
3.3V: C7.1, C22.1, C55.1, C65.1, C92.1, FB1.1, U2.11 (AS0), U2.13 (AS1), U2.16 (VDRIVE), U2.17 (!PD!/!RST), U9.16 (VDRIVE), U9.17 (!PD!/!RST), U26.16 (VDRIVE), U26.17 (!PD!/!RST), U35.16 (VDRIVE), U35.17 (!PD!/!RST), U49.11 (AS0), U49.16 (VDRIVE), U49.17 (!PD!/!RST); also elsewhere on the board
ADC_DCAP-3: C93.1, U49.8 (DCAP)
ADC_DCAP-4: C69.1, U35.8 (DCAP)
ADC_DCAP-5: C57.1, U26.8 (DCAP)
ADC_DCAP-6: C15.1, U9.8 (DCAP)
ADC_DCAP-7: C6.1, U2.8 (DCAP)
ADC_REF-3: C104.1, TP1.1, U49.7 (VREF)
ADC_REF-4: C75.1, TP9.1, U35.7 (VREF)
ADC_REF-5: C61.1, TP10.1, U26.7 (VREF)
ADC_REF-6: C14.1, TP33.1, U7.3 (IN+), U9.7 (VREF)
ADC_REF-7: C10.1, TP38.1, U2.7 (VREF), U4.3 (IN+)
AGND: C8.2, C10.2, C11.2, C13.2, C14.2, C17.2, C37.2, C40.C, RT3.1, RT4.1, RT7.1, RT10.1, TP20.1, U2.6 (AGND), U4.2 (V-), U7.2 (V-), U9.6 (AGND); also elsewhere on the board
AVDD: C8.1, C11.1, C13.1, C17.1, C37.1, C40.A, C59.1, C72.1, C96.1, FB1.2, TP22.1, U2.10 (VDD), U4.5 (V+), U7.5 (V+), U9.10 (VDD), U26.10 (VDD), U35.10 (VDD), U49.10 (VDD); also elsewhere on the board
AVREF-0: RN12.5 (C), RN12.10 (C), TP31.1, U7.1 (OUT), U7.4 (IN-)
AVREF-1: RN4.5 (C), RN4.10 (C), TP36.1, U4.1 (OUT), U4.4 (IN-)
DEPLOY_SENSE-1: U2.18 (IN0); also elsewhere on the board
DGND: C6.2, C7.2, C15.2, C22.2, C55.2, C57.2, C65.2, C69.2, C92.2, C93.2, U2.9 (DGND), U2.PAD (DGND), U9.9 (DGND), U9.11 (AS0), U9.PAD (DGND), U26.4 (IN6), U26.9 (DGND), U26.11 (AS0), U26.13 (AS1), U26.19 (IN1), U26.PAD (DGND), U35.9 (DGND), U35.13 (AS1), U35.PAD (DGND), U49.9 (DGND), U49.13 (AS1), U49.PAD (DGND); also elsewhere on the board
I2C_SCL: U2.15 (SCL), U9.15 (SCL), U26.15 (SCL), U35.15 (SCL), U49.15 (SCL); also elsewhere on the board
I2C_SDA: U2.14 (SDA), U9.14 (SDA), U26.14 (SDA), U35.14 (SDA), U49.14 (SDA); also elsewhere on the board
I_3.3V-0: U49.5 (IN7); also elsewhere on the board
I_3.3V-1: U49.4 (IN6); also elsewhere on the board
I_3.3V-2: U49.3 (IN5); also elsewhere on the board
I_3.3V-3: U49.2 (IN4); also elsewhere on the board
I_3.3V-4: U49.1 (IN3); also elsewhere on the board
I_3.3V-5: U49.20 (IN2); also elsewhere on the board
I_3.3V-6: U49.19 (IN1); also elsewhere on the board
I_3.3V-7: U49.18 (IN0); also elsewhere on the board
I_3.3V-8: U35.5 (IN7); also elsewhere on the board
I_3.3V-9: U35.4 (IN6); also elsewhere on the board
I_3.3V-10: U35.3 (IN5); also elsewhere on the board
I_3.3V-11: U35.2 (IN4); also elsewhere on the board
I_3.3V-12: U35.1 (IN3); also elsewhere on the board
I_3.3V-PV: U2.5 (IN7); also elsewhere on the board
I_BATT-0: U35.20 (IN2); also elsewhere on the board
I_BATT-1: U35.19 (IN1); also elsewhere on the board
I_BATT-2: U35.18 (IN0); also elsewhere on the board
I_BATT-3: U26.3 (IN5); also elsewhere on the board
I_BATT-4: U26.2 (IN4); also elsewhere on the board
I_BATT-5: U26.1 (IN3); also elsewhere on the board
I_BATT-6: U26.20 (IN2); also elsewhere on the board
I_BH-0: U26.18 (IN0); also elsewhere on the board
I_BH-1: U9.18 (IN0); also elsewhere on the board
I_DP-0: U9.3 (IN5); also elsewhere on the board
I_DP-1: U2.20 (IN2); also elsewhere on the board
PGND: C59.2, C61.2, C72.2, C75.2, C96.2, C104.2, U26.5 (IN7), U26.6 (AGND), U35.6 (AGND), U49.6 (AGND); also elsewhere on the board
TEMP-BATT-A: RN4.6 (5), U2.3 (IN5); also elsewhere on the board
TEMP-BATT-B: RN4.3, U2.2 (IN4); also elsewhere on the board
TEMP-IN_SW-0: RN4.8 (7), U2.1 (IN3); also elsewhere on the board
TEMP-IN_SW-1: RN12.6 (5), U9.5 (IN7); also elsewhere on the board
TEMP-OUT_SW-0: RN12.1, U9.19 (IN1); also elsewhere on the board
TEMP-OUT_SW-1: RN4.4, U2.4 (IN6); also elsewhere on the board
TEMP-PCB-0: RN4.9 (8), RT4.2, U2.19 (IN1)
TEMP-PCB-1: RN12.8 (7), RT7.2, U9.2 (IN4)
TEMP-PCB-2: RN12.2, RT10.2, U9.1 (IN3)
TEMP-PCB-3: RN12.4, RT3.2, U9.4 (IN6)
TEMP-REG: RN12.9 (8), U9.20 (IN2); also elsewhere on the board

Notes on the sheet:
CAD Note: Decoupling
Addr=0x2C (7b)
Addr=0x2E (7b)
Addr=0x2F (7b)
Addr=0x2B (7b)
Addr=0x20 (7b)
CAD Note: Place at various locations around the PCB
0-2.5V=610µV/LSB
Note: Inputs PGND Referenced
<10B1
<10B1>
12A4>
7A2>
7A4>
7A6>
7B2>
7B4>
7B6>
7C2>
7C4>
7C6>
7D2>
7D4>
7D6>
8A2>
8A4>
8A6>
8B2>
8B4>
8B6>
8C2>
8C4>
8C6>
8D6>
8D4>
8D2>
4D6>
4D3>
5B2>
5B5>
6B4>
<12B4
<12C4

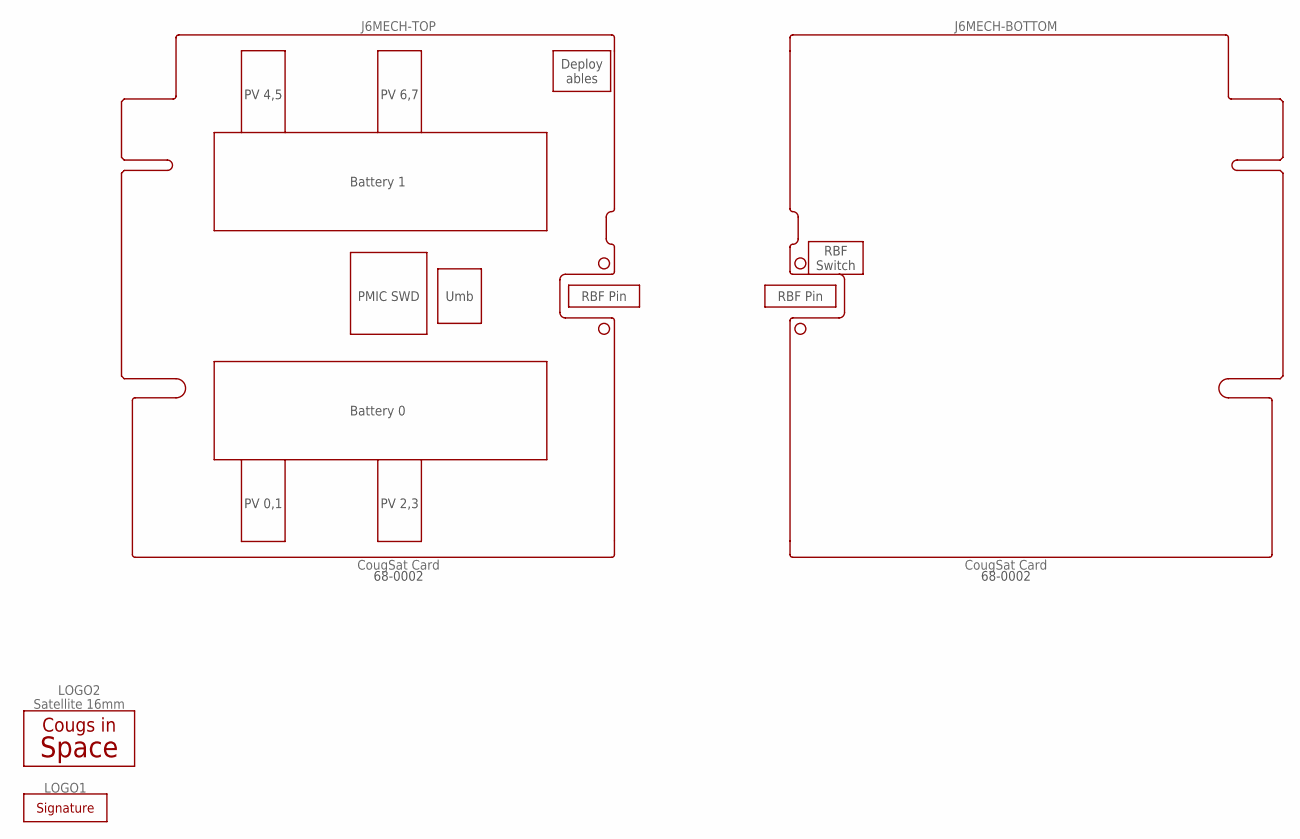
[picture p349: schematic EPS.sch, sheet 13]

Parts:
J6: CougSat Card; CARD-FULL-OPEN+X
LOGO1: SIGNATUREBRADLEY; SIGN-BRADLEY
LOGO2: Satellite 16mm; CIS-SATELLITE-16

Notes on the sheet:
PV 0,1
PV 2,3
PV 4,5
PV 6,7
Battery 0
Battery 1
PMIC SWD
Umb
RBF Pin
RBF Switch
Deploy ables

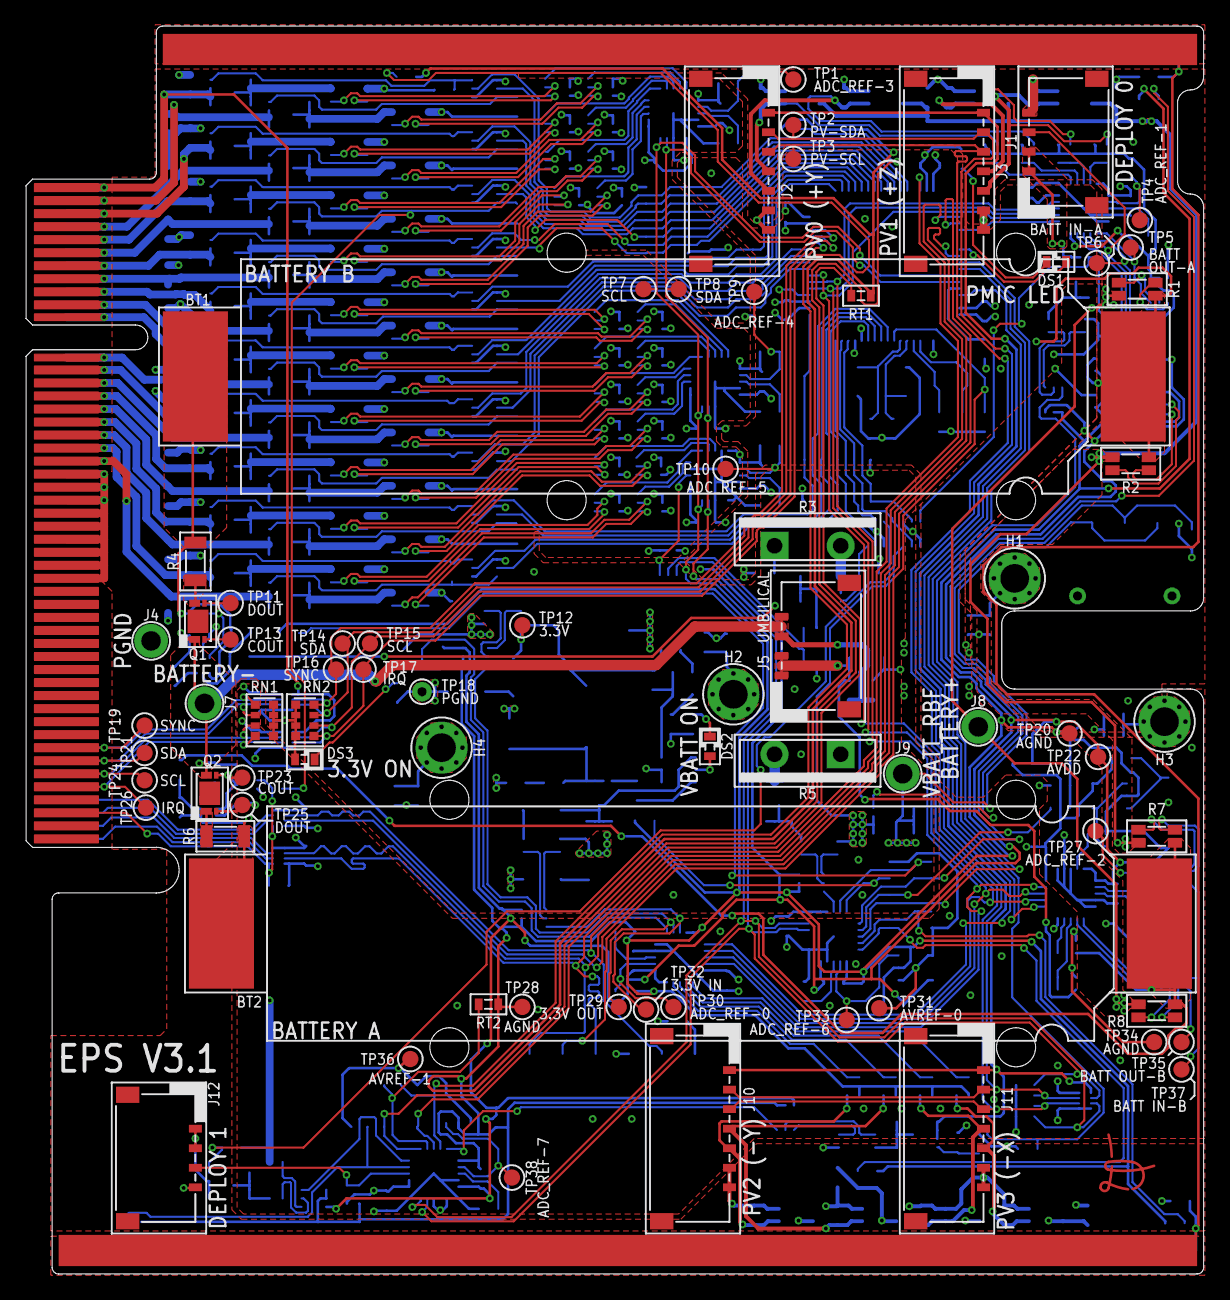
[picture p350: board EPS.brd from above]

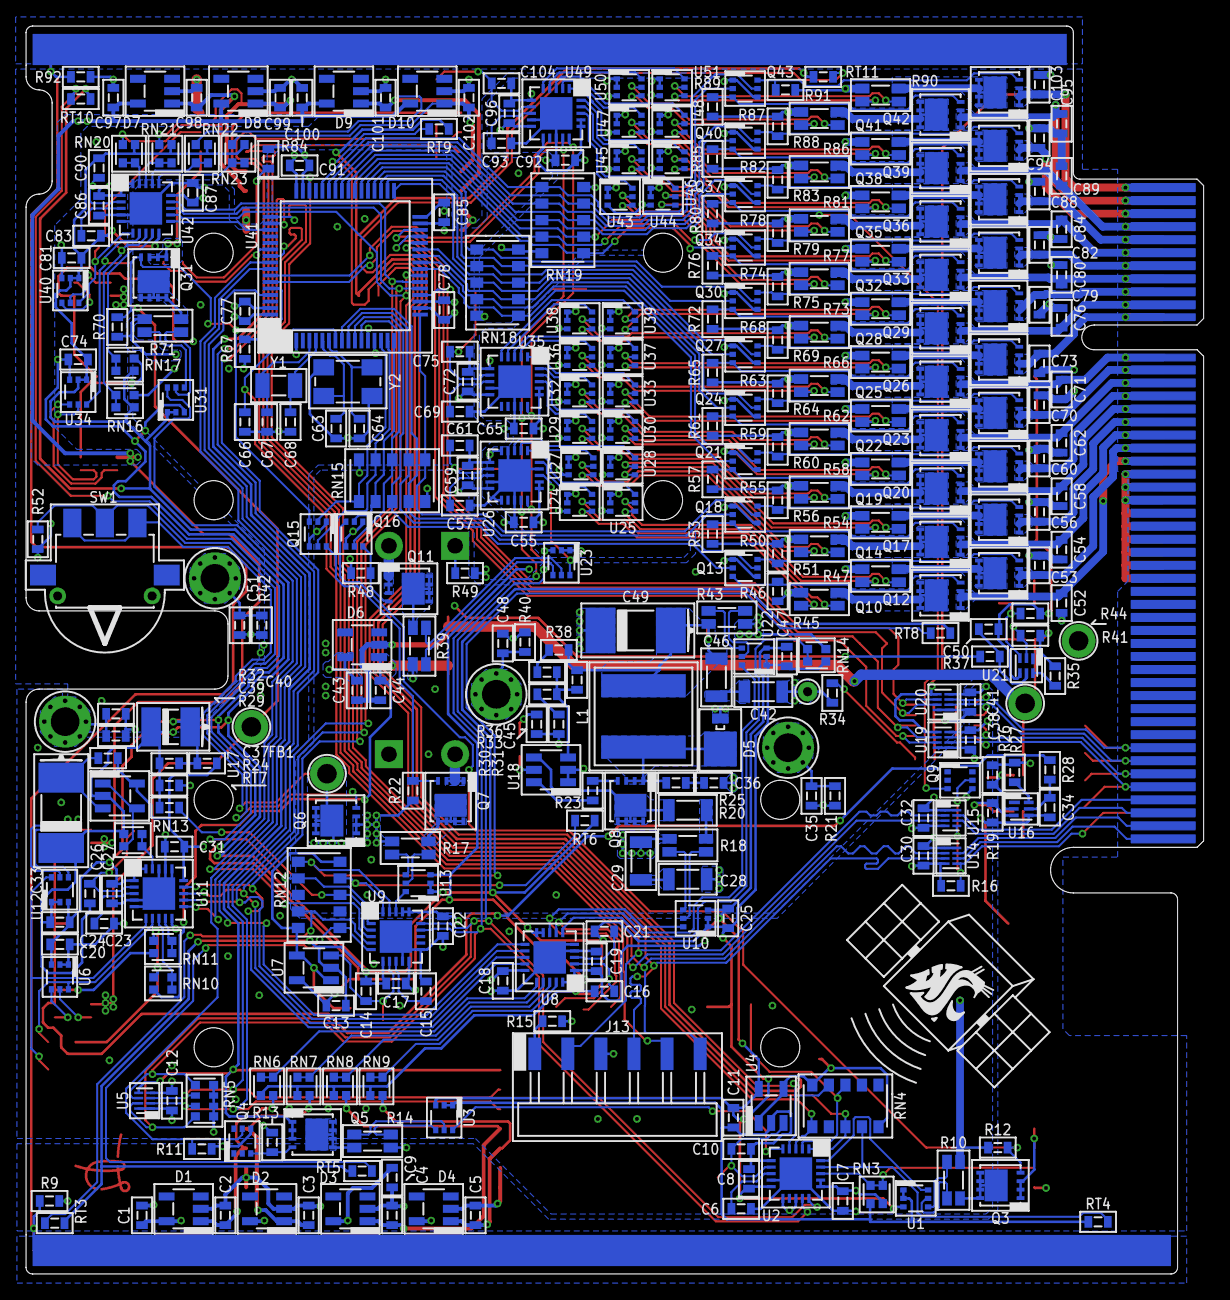
[picture p351: board EPS.brd from below]

Board: 4 copper layers, 90.4 x 95.8 mm, 401 parts (327 on the bottom side), 328 nets.
