CougsInSpace/CougSat1-Hardware/CougSat1-RadioBoard/ElectricalDesign/Comms.brd

## EAGLE design CougSat1-RadioBoard/ElectricalDesign/Comms.brd (2021-02-09)

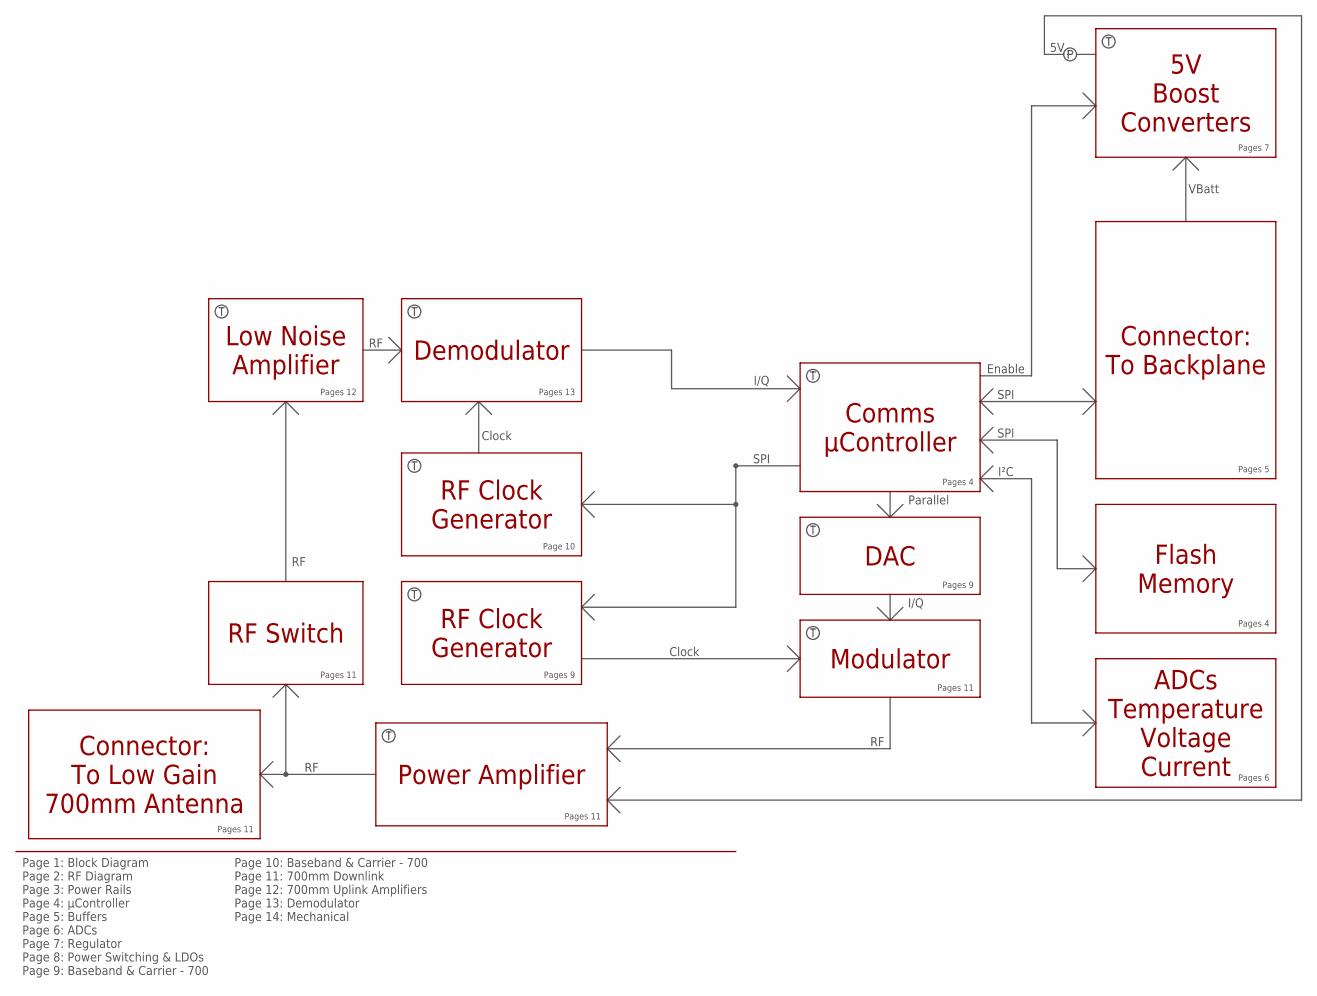
[picture p352: schematic Comms.sch, sheet 1]

Notes on the sheet:
Page 1: Block Diagram Page 2: RF Diagram Page 3: Power Rails Page 4: µController Page 5: Buffers Page 6: ADCs Page 7: Regulator Page 8: Power Switching & LDOs Page 9: Baseband & Carrier - 700
Connector: To Backplane
Comms µController
5V Boost Converters
Modulator
RF Clock Generator
Power Amplifier
Connector: To Low Gain 700mm Antenna
RF Switch
Demodulator
Low Noise Amplifier
ADCs Temperature Voltage Current
Flash Memory
VBatt
SPI
I/Q
Clock
Enable
I²C
Page 10: Baseband & Carrier - 700 Page 11: 700mm Downlink Page 12: 700mm Uplink Amplifiers Page 13: Demodulator Page 14: Mechanical
Pages 6
Page 10
DAC
Parallel
Pages 4
Pages 5
Pages 7
Pages 13
Pages 12
Pages 9
Pages 11

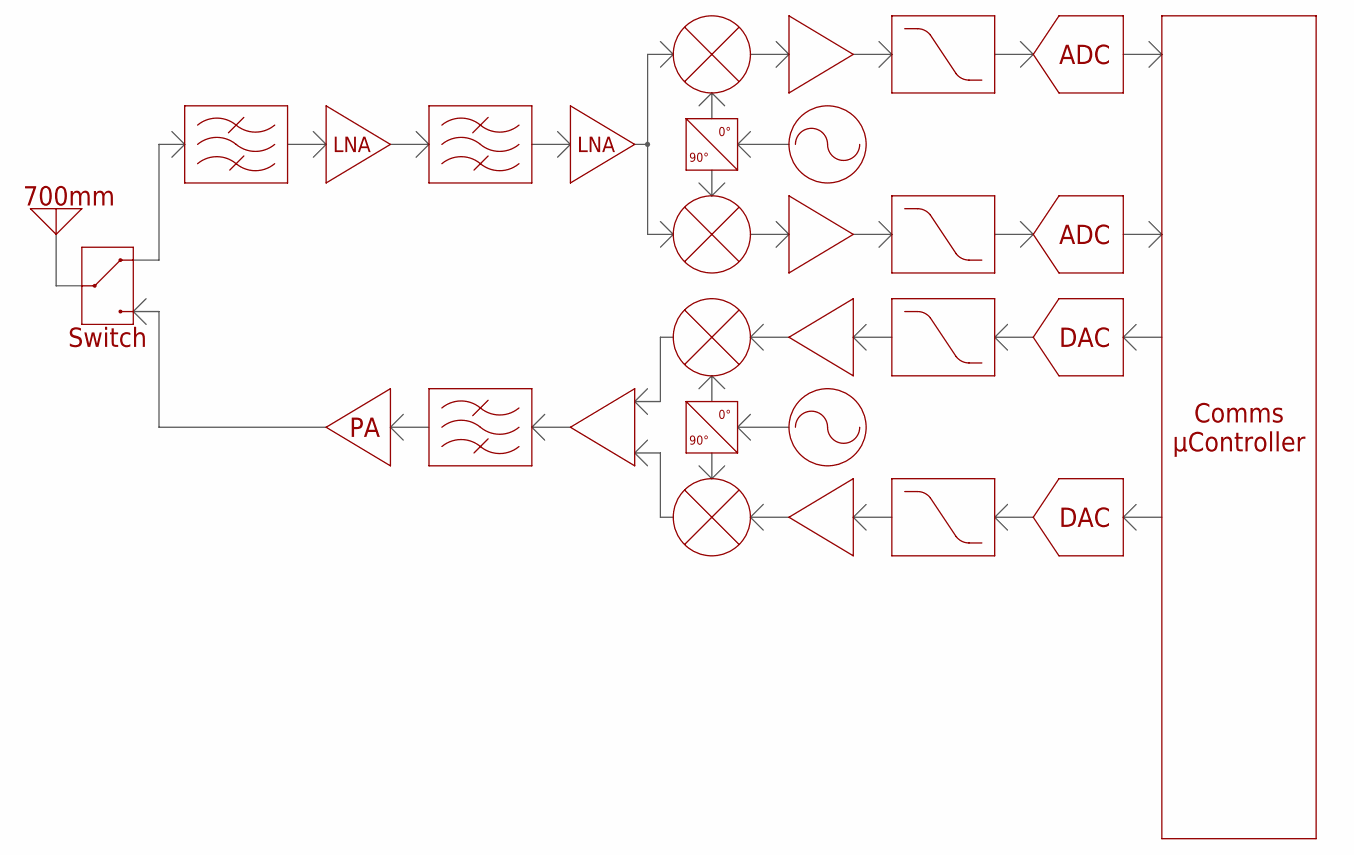
[picture p353: schematic Comms.sch, sheet 2]

Notes on the sheet:
LNA
DAC
ADC
90°
Switch
Comms µController
700mm
