CougsInSpace/CougSat1-Hardware/CougSat1-RadioBoard/ElectricalDesign/Comms.brd

## EAGLE design CougSat1-RadioBoard/ElectricalDesign/Comms.brd (continued)

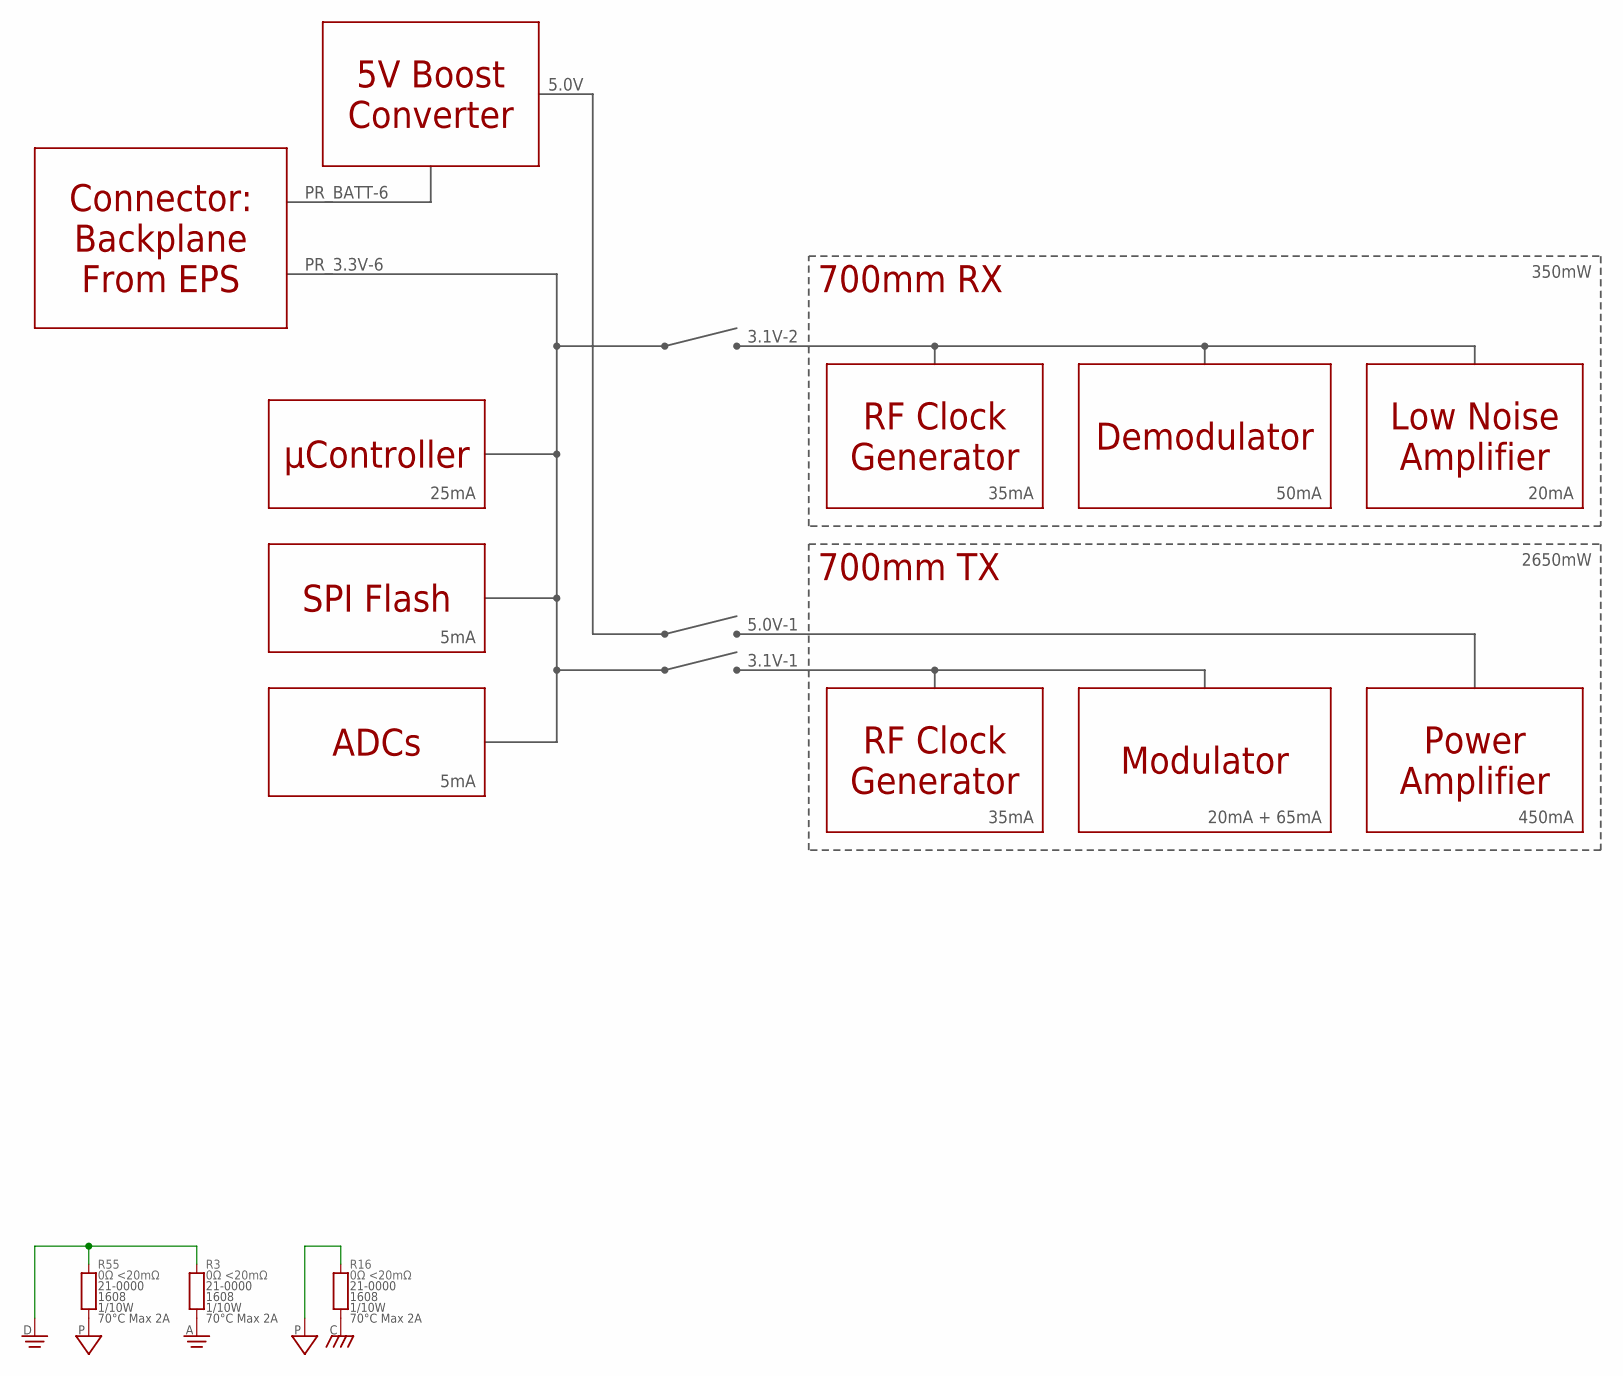
[picture p354: schematic Comms.sch, sheet 3]

Parts:
R3, R16, R55: 0Ω <20mΩ; 1608

Connections:
AGND: R3.1; also elsewhere on the board
CHASSIS: R16.1; also elsewhere on the board
DGND: R3.2, R55.2; also elsewhere on the board
PGND: R16.2, R55.1; also elsewhere on the board

Notes on the sheet:
Connector: Backplane From EPS
5V Boost Converter
µController
RF Clock Generator
Low Noise Amplifier
SPI Flash
ADCs
Demodulator
5.0V
PR_BATT-6
Modulator
700mm RX
700mm TX
3.1V-2
3.1V-1
PR_3.3V-6
5.0V-1
Power Amplifier
20mA
20mA + 65mA
50mA
35mA
450mA
25mA
5mA
350mW
2650mW

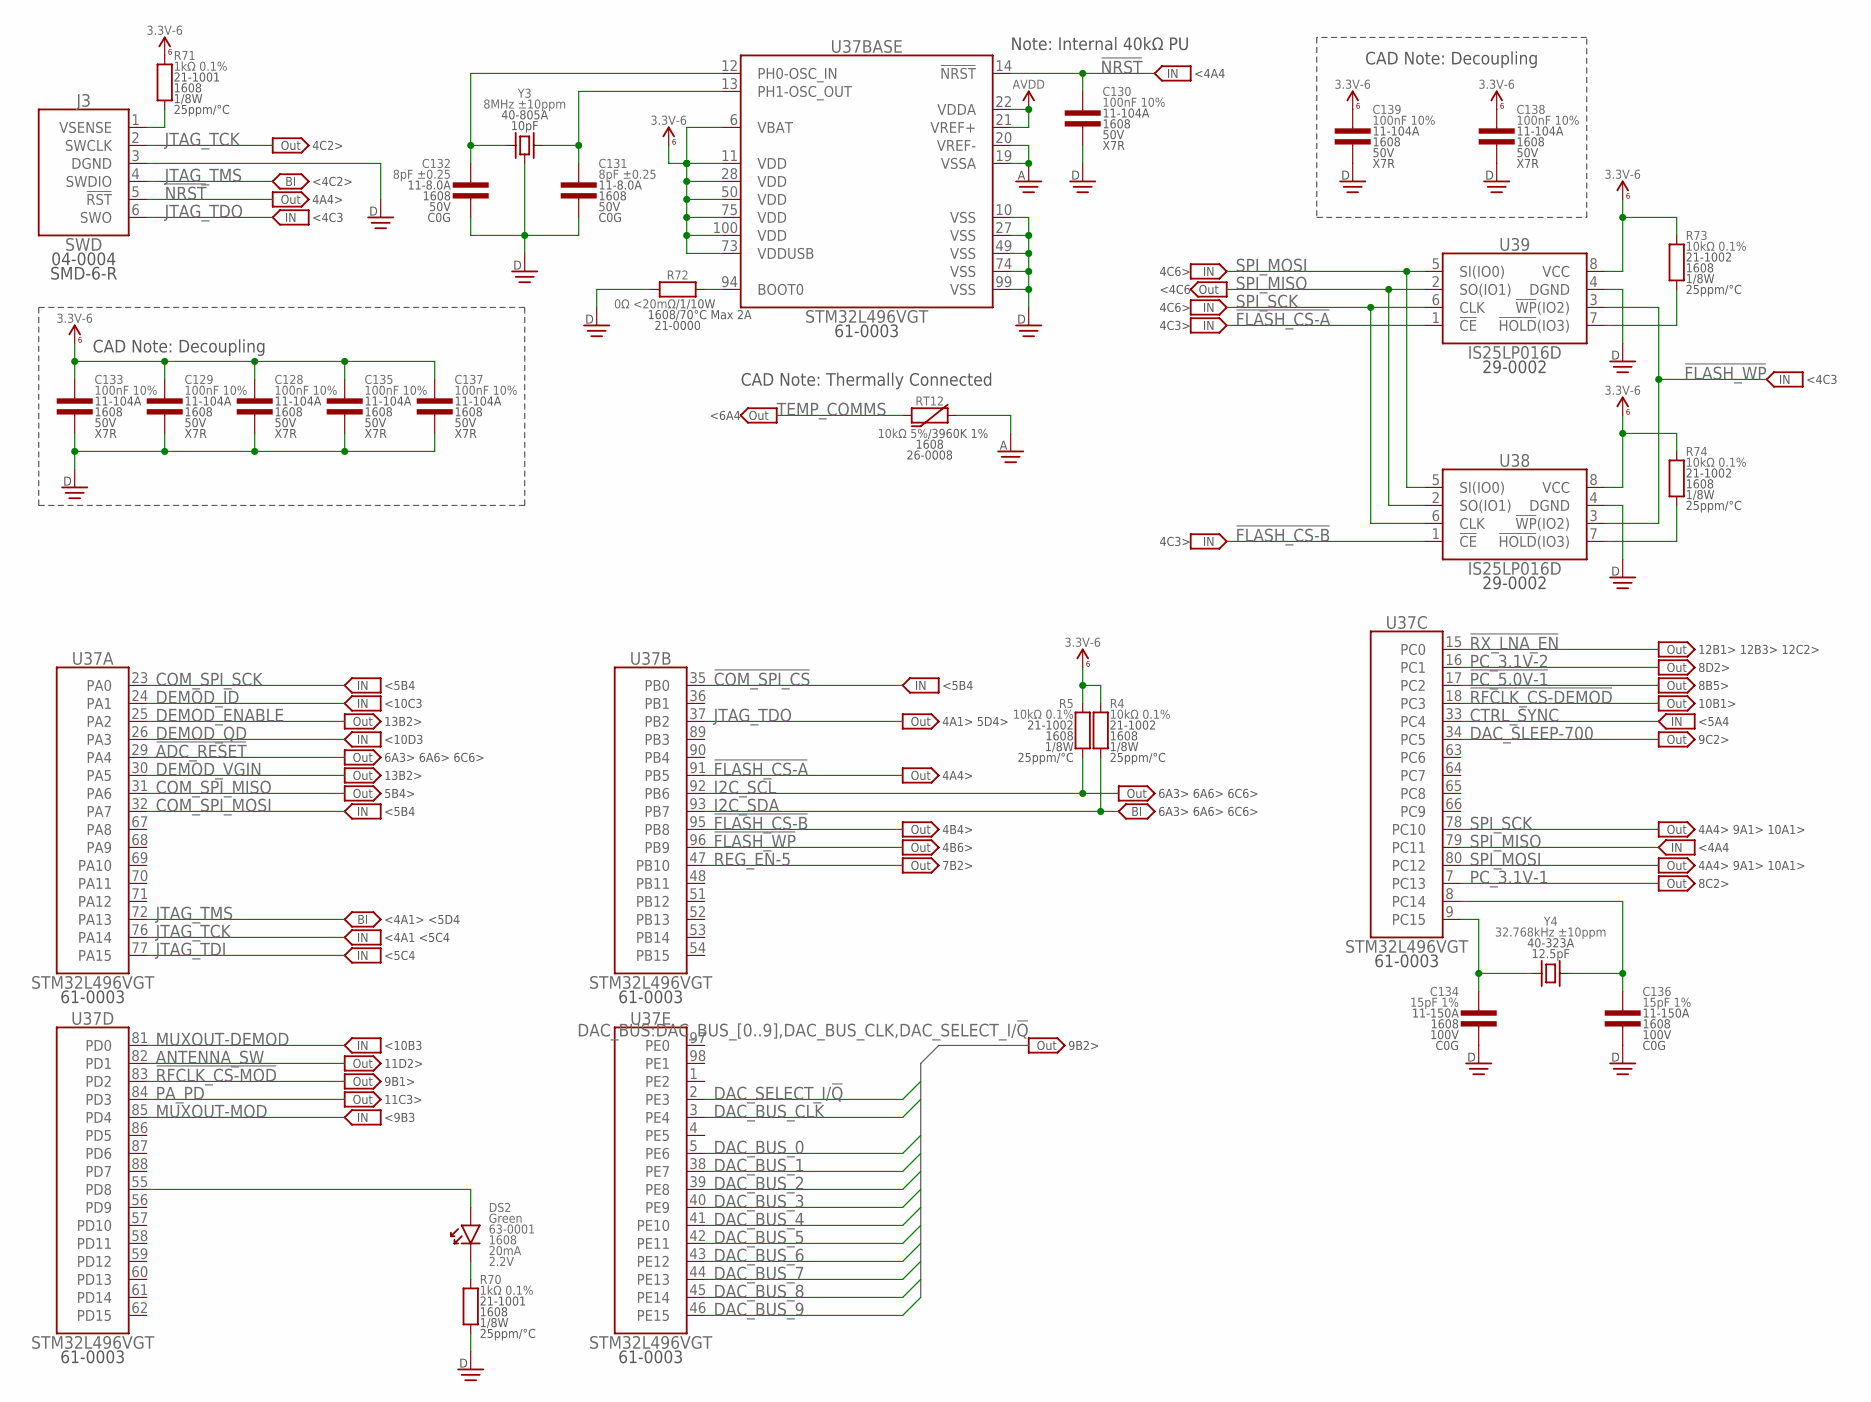
[picture p355: schematic Comms.sch, sheet 4]

Parts:
C128, C129, C130, C133, C135, C137, C138, C139: 100nF 10%; 1608
C131, C132: 8pF ±0.25; 1608
C134, C136: 15pF 1%; 1608
DS2: Green; 1608-POL
J3: SWD; SMD2.54-1X06-R
R4, R5, R73, R74: 10kΩ 0.1%; 1608
R70, R71: 1kΩ 0.1%; 1608
R72: 0Ω <20mΩ; 1608
RT12: 10kΩ 5%; 1608
U37: STM32L496VGT; QFP-100-1414
U38, U39: IS25LP016D; SO8
Y3: 8MHz ±10ppm; SMD-5032
Y4: 32.768kHz ±10ppm; SMD-3215

Connections:
3.3V_6: C128.1, C129.1, C133.1, C135.1, C137.1, C138.1, C139.1, R4.2, R5.2, R71.2, R73.2, R74.2, U37.6 (VBAT), U37.11 (VDD), U37.28 (VDD), U37.50 (VDD), U37.73 (VDDUSB), U37.75 (VDD), U37.100 (VDD), U38.8 (VCC), U39.8 (VCC); also elsewhere on the board
!ADC_RESET: U37.29 (PA4); also elsewhere on the board
!COM_SPI_CS: U37.35 (PB0); also elsewhere on the board
!FLASH_CS-A: U37.91 (PB5), U39.1 (!CE)
!FLASH_CS-B: U37.95 (PB8), U38.1 (!CE)
!FLASH_WP: U37.96 (PB9), U38.3 (!WP!(IO2)), U39.3 (!WP!(IO2))
!NRST: C130.1, J3.5 (!RST), U37.14 (!NRST)
!PC_5.0V-1: U37.17 (PC2); also elsewhere on the board
!RFCLK_CS-DEMOD: U37.18 (PC3); also elsewhere on the board
!RFCLK_CS-MOD: U37.83 (PD2); also elsewhere on the board
!RX_LNA_EN: U37.15 (PC0); also elsewhere on the board
AGND: RT12.2, U37.19 (VSSA), U37.20 (VREF-); also elsewhere on the board
ANTENNA_SW: U37.82 (PD1); also elsewhere on the board
AVDD: U37.21 (VREF+), U37.22 (VDDA); also elsewhere on the board
BOOT0: R72.2, U37.94 (BOOT0)
COM_SPI_MISO: U37.31 (PA6); also elsewhere on the board
COM_SPI_MOSI: U37.32 (PA7); also elsewhere on the board
COM_SPI_SCK: U37.23 (PA0); also elsewhere on the board
CTRL_SYNC: U37.33 (PC4); also elsewhere on the board
DAC_BUS_0: U37.5 (PE6); also elsewhere on the board
DAC_BUS_1: U37.38 (PE7); also elsewhere on the board
DAC_BUS_2: U37.39 (PE8); also elsewhere on the board
DAC_BUS_3: U37.40 (PE9); also elsewhere on the board
DAC_BUS_4: U37.41 (PE10); also elsewhere on the board
DAC_BUS_5: U37.42 (PE11); also elsewhere on the board
DAC_BUS_6: U37.43 (PE12); also elsewhere on the board
DAC_BUS_7: U37.44 (PE13); also elsewhere on the board
DAC_BUS_8: U37.45 (PE14); also elsewhere on the board
DAC_BUS_9: U37.46 (PE15); also elsewhere on the board
DAC_BUS_CLK: U37.3 (PE4); also elsewhere on the board
DAC_SELECT_I/!Q: U37.2 (PE3); also elsewhere on the board
DAC_SLEEP-700: U37.34 (PC5); also elsewhere on the board
DEMOD_ENABLE: U37.25 (PA2); also elsewhere on the board
DEMOD_ID: U37.24 (PA1); also elsewhere on the board
DEMOD_QD: U37.26 (PA3); also elsewhere on the board
DEMOD_VGIN: U37.30 (PA5); also elsewhere on the board
DGND: C128.2, C129.2, C130.2, C131.2, C132.2, C133.2, C134.2, C135.2, C136.2, C137.2, C138.2, C139.2, J3.3 (DGND), R70.1, R72.1, U37.10 (VSS), U37.27 (VSS), U37.49 (VSS), U37.74 (VSS), U37.99 (VSS), U38.4 (DGND), U39.4 (DGND), Y3.2 (GND), Y3.4 (GND); also elsewhere on the board
FLASH_HOLD-A: R73.1, U39.7 (!HOLD!(IO3))
FLASH_HOLD-B: R74.1, U38.7 (!HOLD!(IO3))
I2C_SCL: R5.1, U37.92 (PB6); also elsewhere on the board
I2C_SDA: R4.1, U37.93 (PB7); also elsewhere on the board
JTAG_TCK: J3.2 (SWCLK), U37.76 (PA14); also elsewhere on the board
JTAG_TDI: U37.77 (PA15); also elsewhere on the board
JTAG_TDO: J3.6 (SWO), U37.37 (PB2); also elsewhere on the board
JTAG_TMS: J3.4 (SWDIO), U37.72 (PA13); also elsewhere on the board
LED_A: DS2.A, U37.55 (PD8)
LED_C: DS2.C, R70.2
MUXOUT-DEMOD: U37.81 (PD0); also elsewhere on the board
MUXOUT-MOD: U37.85 (PD4); also elsewhere on the board
OSC32_IN: C136.1, U37.8 (PC14), Y4.2
OSC32_OUT: C134.1, U37.9 (PC15), Y4.1
OSC_IN: C132.1, U37.12 (PH0-OSC_IN), Y3.1
OSC_OUT: C131.1, U37.13 (PH1-OSC_OUT), Y3.3 (2)
PA_PD: U37.84 (PD3); also elsewhere on the board
PC_3.1V-1: U37.7 (PC13); also elsewhere on the board
PC_3.1V-2: U37.16 (PC1); also elsewhere on the board
REG_EN-5: U37.47 (PB10); also elsewhere on the board
SPI_MISO: U37.79 (PC11), U38.2 (SO(IO1)), U39.2 (SO(IO1))
SPI_MOSI: U37.80 (PC12), U38.5 (SI(IO0)), U39.5 (SI(IO0)); also elsewhere on the board
SPI_SCK: U37.78 (PC10), U38.6 (CLK), U39.6 (CLK); also elsewhere on the board
SWD_VSENSE: J3.1 (VSENSE), R71.1
TEMP_COMMS: RT12.1; also elsewhere on the board

Notes on the sheet:
CAD Note: Decoupling
Note: Internal 40kΩ PU
CAD Note: Thermally Connected
4C2>
<4C2>
<4C3
4A4>
<4A4
<4A1 <5C4
<4A1> <5D4
<5C4
4A1> 5D4>
<5B4
5B4>
<5A4
6A3> 6A6> 6C6>
4B4>
4B6>
4A4> 9A1> 10A1>
4C6>
<4C6
4C3>
<6A4
7B2>
8C2>
8B5>
8D2>
9B2>
<9B3
<10B3
9C2>
9B1>
10B1>
<10C3
<10D3
11D2>
11C3>
12B1> 12B3> 12C2>
13B2>

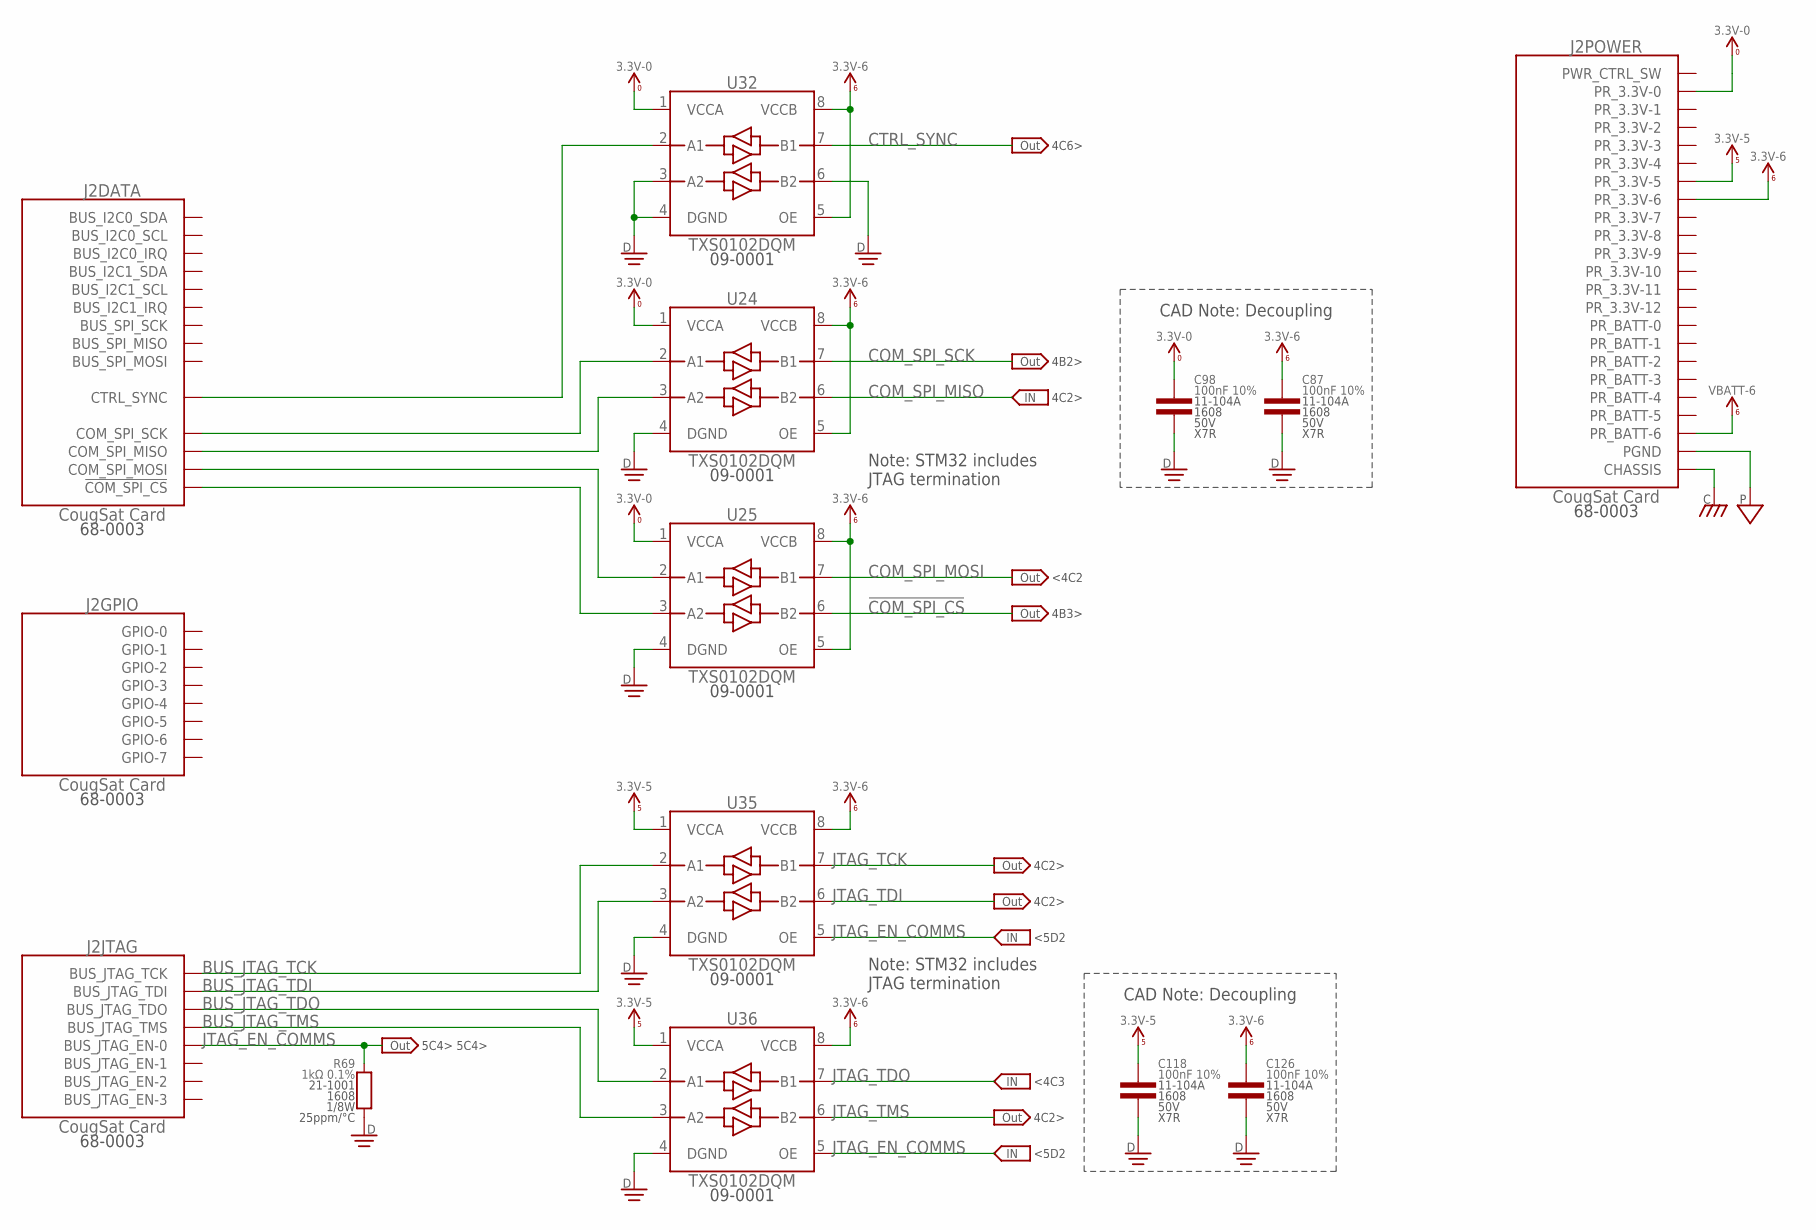
[picture p356: schematic Comms.sch, sheet 5]

Parts:
C87, C98, C118, C126: 100nF 10%; 1608
J2: CougSat Card; CARD-FULL-OPEN+X
R69: 1kΩ 0.1%; 1608
U24, U25, U32, U35, U36: TXS0102DQM; X2SON-8

Connections:
3.3V_0: C98.1, J2.A1 (PR_3.3V-0), J2.B1 (PR_3.3V-0), U24.1 (VCCA), U25.1 (VCCA), U32.1 (VCCA)
3.3V_5: C118.1, J2.A6 (PR_3.3V-5), J2.B6 (PR_3.3V-5), U35.1 (VCCA), U36.1 (VCCA)
3.3V_6: C87.1, C126.1, J2.A7 (PR_3.3V-6), J2.B7 (PR_3.3V-6), U24.5 (OE), U24.8 (VCCB), U25.5 (OE), U25.8 (VCCB), U32.5 (OE), U32.8 (VCCB), U35.8 (VCCB), U36.8 (VCCB); also elsewhere on the board
!BUS_COM_SPI_CS: J2.A36 (!COM_SPI_CS), J2.B36 (!COM_SPI_CS), U25.3 (A2)
!COM_SPI_CS: U25.6 (B2); also elsewhere on the board
BUS_COM_SPI_MISO: J2.A34 (COM_SPI_MISO), J2.B34 (COM_SPI_MISO), U24.3 (A2)
BUS_COM_SPI_MOSI: J2.A35 (COM_SPI_MOSI), J2.B35 (COM_SPI_MOSI), U25.2 (A1)
BUS_COM_SPI_SCK: J2.A33 (COM_SPI_SCK), J2.B33 (COM_SPI_SCK), U24.2 (A1)
BUS_CTRL_SYNC: J2.A42 (CTRL_SYNC), J2.B42 (CTRL_SYNC), U32.2 (A1)
BUS_JTAG_TCK: J2.A46 (BUS_JTAG_TCK), U35.2 (A1)
BUS_JTAG_TDI: J2.A47 (BUS_JTAG_TDI), U35.3 (A2)
BUS_JTAG_TDO: J2.A48 (BUS_JTAG_TDO), U36.2 (A1)
BUS_JTAG_TMS: J2.A49 (BUS_JTAG_TMS), U36.3 (A2)
CHASSIS: J2.CHASSIS@1 (CHASSIS), J2.CHASSIS@2 (CHASSIS), J2.CHASSIS@3 (CHASSIS), J2.CHASSIS@4 (CHASSIS); also elsewhere on the board
COM_SPI_MISO: U24.6 (B2); also elsewhere on the board
COM_SPI_MOSI: U25.7 (B1); also elsewhere on the board
COM_SPI_SCK: U24.7 (B1); also elsewhere on the board
CTRL_SYNC: U32.7 (B1); also elsewhere on the board
DGND: C87.2, C98.2, C118.2, C126.2, R69.1, U24.4 (DGND), U25.4 (DGND), U32.3 (A2), U32.4 (DGND), U32.6 (B2), U35.4 (DGND), U36.4 (DGND); also elsewhere on the board
JTAG_EN_COMMS: J2.B46 (BUS_JTAG_EN-0), R69.2, U35.5 (OE), U36.5 (OE)
JTAG_TCK: U35.7 (B1); also elsewhere on the board
JTAG_TDI: U35.6 (B2); also elsewhere on the board
JTAG_TDO: U36.7 (B1); also elsewhere on the board
JTAG_TMS: U36.6 (B2); also elsewhere on the board
PGND: J2.A21 (PGND), J2.A22 (PGND), J2.A23 (PGND), J2.B21 (PGND), J2.B22 (PGND), J2.B23 (PGND), J2.B24 (PGND), J2.B25 (PGND), J2.B26 (PGND), J2.B27 (PGND), J2.B28 (PGND), J2.B29 (PGND); also elsewhere on the board
PR_3.3V-1: J2.A2 (PR_3.3V-1), J2.B2 (PR_3.3V-1)
PR_3.3V-2: J2.A3 (PR_3.3V-2), J2.B3 (PR_3.3V-2)
PR_3.3V-3: J2.A4 (PR_3.3V-3), J2.B4 (PR_3.3V-3)
PR_3.3V-4: J2.A5 (PR_3.3V-4), J2.B5 (PR_3.3V-4)
PR_3.3V-7: J2.A8 (PR_3.3V-7), J2.B8 (PR_3.3V-7)
PR_3.3V-8: J2.A9 (PR_3.3V-8), J2.B9 (PR_3.3V-8)
PR_3.3V-9: J2.A10 (PR_3.3V-9), J2.B10 (PR_3.3V-9)
PR_3.3V-10: J2.A11 (PR_3.3V-10), J2.B11 (PR_3.3V-10)
PR_3.3V-11: J2.A12 (PR_3.3V-11), J2.B12 (PR_3.3V-11)
PR_3.3V-12: J2.A13 (PR_3.3V-12), J2.B13 (PR_3.3V-12)
PR_BATT-0: J2.A14 (PR_BATT-0), J2.B14 (PR_BATT-0)
PR_BATT-1: J2.A15 (PR_BATT-1), J2.B15 (PR_BATT-1)
PR_BATT-2: J2.A16 (PR_BATT-2), J2.B16 (PR_BATT-2)
PR_BATT-3: J2.A17 (PR_BATT-3), J2.B17 (PR_BATT-3)
PR_BATT-4: J2.A18 (PR_BATT-4), J2.B18 (PR_BATT-4)
PR_BATT-5: J2.A19 (PR_BATT-5), J2.B19 (PR_BATT-5)
VBATT_6: J2.A20 (PR_BATT-6), J2.B20 (PR_BATT-6); also elsewhere on the board

Notes on the sheet:
<5D2
CAD Note: Decoupling
4C2>
Note: STM32 includes JTAG termination
<4C3
5C4> 5C4>
4B2>
4B3>
<4C2
4C6>

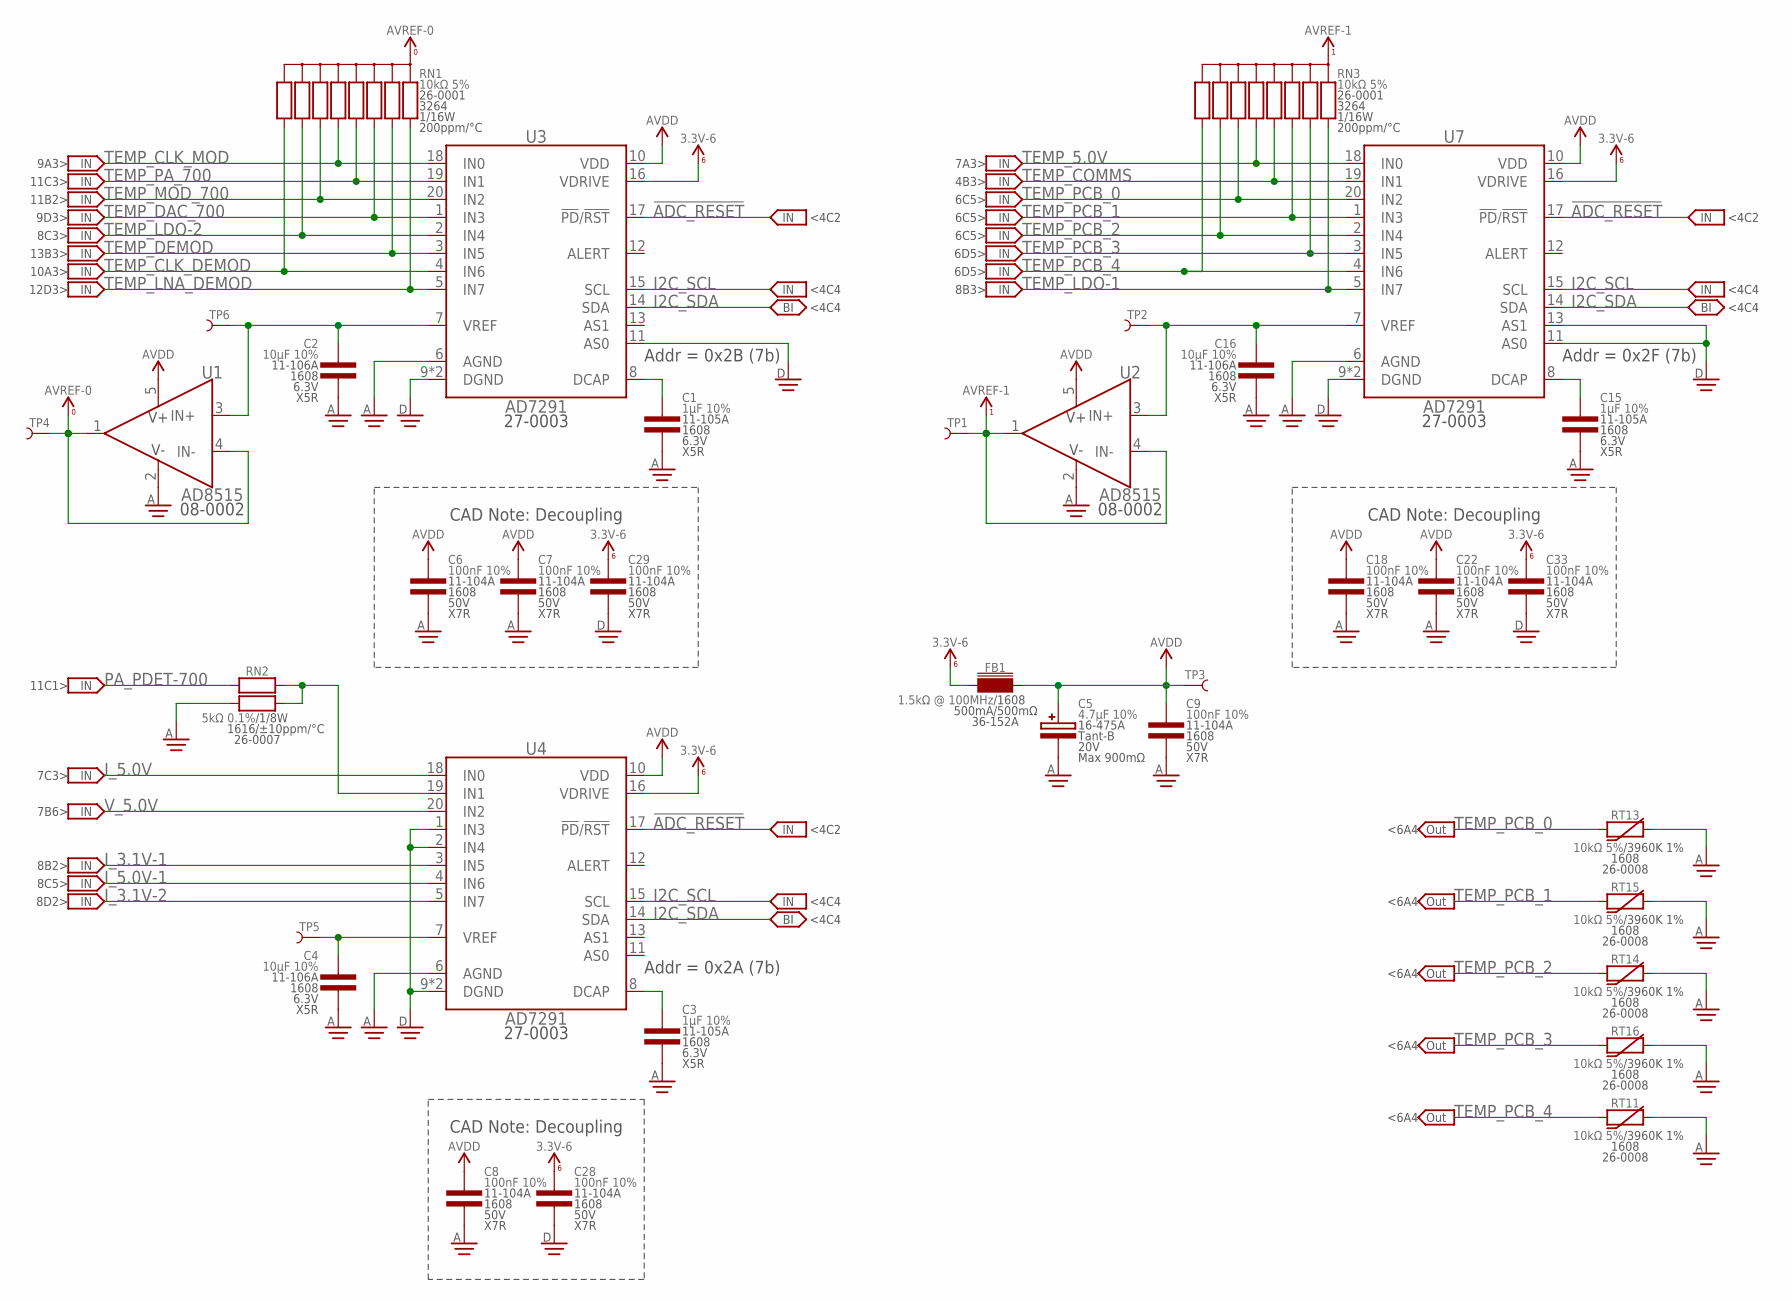
[picture p357: schematic Comms.sch, sheet 6]

Parts:
C1, C3, C15: 1µF 10%; 1608
C2, C4, C16: 10µF 10%; 1608
C5: 4.7µF 10%; 4028-POL
C6, C7, C8, C9, C18, C22, C28, C29, C33: 100nF 10%; 1608
FB1: 1.5kΩ @ 100MHz; 1608
RN1, RN3: 10kΩ 5%; 3264
RN2: 5kΩ 0.1%; 1616
RT11, RT13, RT14, RT15, RT16: 10kΩ 5%; 1608
TP1, TP2, TP3, TP4, TP5, TP6: TEST_POINT-SMD-C-1.25; SMD-C-1.25
U1, U2: AD8515; SOT23-5
U3, U4, U7: AD7291; QFN-20-4040

Connections:
3.3V_6: C28.1, C29.1, C33.1, FB1.1, U3.16 (VDRIVE), U4.16 (VDRIVE), U7.16 (VDRIVE); also elsewhere on the board
!ADC_RESET: U3.17 (!PD!/!RST), U4.17 (!PD!/!RST), U7.17 (!PD!/!RST); also elsewhere on the board
ADC_DCAP-0: C1.1, U3.8 (DCAP)
ADC_DCAP-1: C15.1, U7.8 (DCAP)
ADC_DCAP-2: C3.1, U4.8 (DCAP)
ADC_PA_PDET-700: RN2.3 (B2), RN2.4 (A2), U4.19 (IN1)
ADC_VREF-0: C2.1, TP6.1, U1.3 (IN+), U3.7 (VREF)
ADC_VREF-1: C16.1, TP2.1, U2.3 (IN+), U7.7 (VREF)
ADC_VREF-2: C4.1, TP5.1, U4.7 (VREF)
AGND: C1.2, C2.2, C3.2, C4.2, C5.C, C6.2, C7.2, C8.2, C9.2, C15.2, C16.2, C18.2, C22.2, RN2.1 (A1), RT11.2, RT13.2, RT14.2, RT15.2, RT16.2, U1.2 (V-), U2.2 (V-), U3.6 (AGND), U4.6 (AGND), U7.6 (AGND); also elsewhere on the board
AVDD: C5.A, C6.1, C7.1, C8.1, C9.1, C18.1, C22.1, FB1.2, TP3.1, U1.5 (V+), U2.5 (V+), U3.10 (VDD), U4.10 (VDD), U7.10 (VDD); also elsewhere on the board
AVREF-0: RN1.5 (C), RN1.10 (C), TP4.1, U1.1 (OUT), U1.4 (IN-)
AVREF-1: RN3.5 (C), RN3.10 (C), TP1.1, U2.1 (OUT), U2.4 (IN-)
DGND: C28.2, C29.2, C33.2, U3.9 (DGND), U3.11 (AS0), U3.PAD (DGND), U4.1 (IN3), U4.2 (IN4), U4.9 (DGND), U4.PAD (DGND), U7.9 (DGND), U7.11 (AS0), U7.13 (AS1), U7.PAD (DGND); also elsewhere on the board
I2C_SCL: U3.15 (SCL), U4.15 (SCL), U7.15 (SCL); also elsewhere on the board
I2C_SDA: U3.14 (SDA), U4.14 (SDA), U7.14 (SDA); also elsewhere on the board
I_3.1V-1: U4.3 (IN5); also elsewhere on the board
I_3.1V-2: U4.5 (IN7); also elsewhere on the board
I_5.0V: U4.18 (IN0); also elsewhere on the board
I_5.0V-1: U4.4 (IN6); also elsewhere on the board
PA_PDET-700: RN2.2 (B1); also elsewhere on the board
TEMP_5.0V: RN3.6 (5), U7.18 (IN0); also elsewhere on the board
TEMP_CLK_DEMOD: RN1.9 (8), U3.4 (IN6); also elsewhere on the board
TEMP_CLK_MOD: RN1.6 (5), U3.18 (IN0); also elsewhere on the board
TEMP_COMMS: RN3.4, U7.19 (IN1); also elsewhere on the board
TEMP_DAC_700: RN1.3, U3.1 (IN3); also elsewhere on the board
TEMP_DEMOD: RN1.2, U3.3 (IN5); also elsewhere on the board
TEMP_LDO-1: RN3.1, U7.5 (IN7); also elsewhere on the board
TEMP_LDO-2: RN1.8 (7), U3.2 (IN4); also elsewhere on the board
TEMP_LNA_DEMOD: RN1.1, U3.5 (IN7); also elsewhere on the board
TEMP_MOD_700: RN1.7 (6), U3.20 (IN2); also elsewhere on the board
TEMP_PA_700: RN1.4, U3.19 (IN1); also elsewhere on the board
TEMP_PCB_0: RN3.7 (6), RT13.1, U7.20 (IN2)
TEMP_PCB_1: RN3.3, RT15.1, U7.1 (IN3)
TEMP_PCB_2: RN3.8 (7), RT14.1, U7.2 (IN4)
TEMP_PCB_3: RN3.2, RT16.1, U7.3 (IN5)
TEMP_PCB_4: RN3.9 (8), RT11.1, U7.4 (IN6)
V_5.0V: U4.20 (IN2); also elsewhere on the board

Notes on the sheet:
<4C2
<4C4
CAD Note: Decoupling
Addr = 0x2B (7b)
Addr = 0x2F (7b)
Addr = 0x2A (7b)
4B3>
7A3>
8B3>
8C3>
8B2>
8D2>
8C5>
7C3>
7B6>
6C5>
9A3>
9D3>
10A3>
11B2>
11C3>
12D3>
13B3>
11C1>
<6A4
6D5>

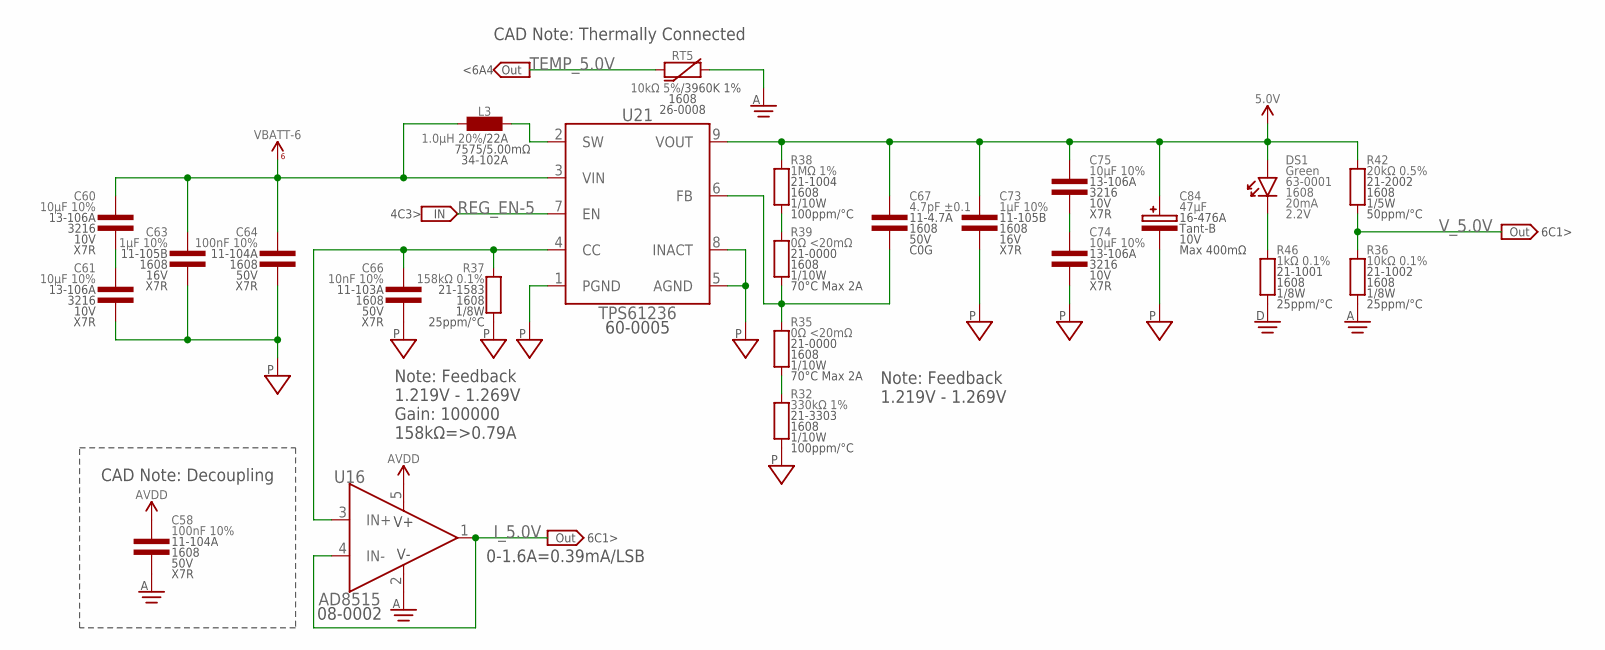
[picture p358: schematic Comms.sch, sheet 7]

Parts:
C58, C64: 100nF 10%; 1608
C60, C61, C74, C75: 10µF 10%; 3216
C63, C73: 1µF 10%; 1608
C66: 10nF 10%; 1608
C67: 4.7pF ±0.1; 1608
C84: 47µF; 4028-POL
DS1: Green; 1608-POL
L3: 1.0µH 20%; 7575
R32: 330kΩ 1%; 1608
R35, R39: 0Ω <20mΩ; 1608
R36: 10kΩ 0.1%; 1608
R37: 158kΩ 0.1%; 1608
R38: 1MΩ 1%; 1608
R42: 20kΩ 0.5%; 1608
R46: 1kΩ 0.1%; 1608
RT5: 10kΩ 5%; 1608
U16: AD8515; SOT23-5
U21: TPS61236; QFN-TPS6123X

Connections:
5.0V: C67.1, C73.1, C75.1, C84.A, DS1.A, R38.2, R42.2, U21.9 (VOUT); also elsewhere on the board
AGND: C58.2, R36.1, RT5.2, U16.2 (V-); also elsewhere on the board
AVDD: C58.1, U16.5 (V+); also elsewhere on the board
DGND: R46.1; also elsewhere on the board
I_5.0V: U16.1 (OUT), U16.4 (IN-); also elsewhere on the board
LED_C-5: DS1.C, R46.2
PGND: C61.2, C63.2, C64.2, C66.2, C73.2, C74.2, C84.C, R32.1, R37.1, U21.1 (PGND), U21.5 (AGND), U21.8 (INACT); also elsewhere on the board
REG_CC-5: C66.1, R37.2, U16.3 (IN+), U21.4 (CC)
REG_CIN-5: C60.2, C61.1
REG_COUT-5: C74.1, C75.2
REG_EN-5: U21.7 (EN); also elsewhere on the board
REG_FB-5: C67.2, R35.2, R39.1, U21.6 (FB)
REG_FB_RES-HIGH-5: R38.1, R39.2
REG_FB_RES-LOW-5: R32.2, R35.1
REG_SW-5: L3.2, U21.2 (SW)
TEMP_5.0V: RT5.1; also elsewhere on the board
VBATT_6: C60.1, C63.1, C64.1, L3.1, U21.3 (VIN); also elsewhere on the board
V_5.0V: R36.2, R42.1; also elsewhere on the board

Notes on the sheet:
Note: Feedback 1.219V - 1.269V
Note: Feedback 1.219V - 1.269V Gain: 100000 158kΩ=>0.79A
CAD Note: Thermally Connected
0-1.6A=0.39mA/LSB
CAD Note: Decoupling
<6A4
6C1>
4C3>

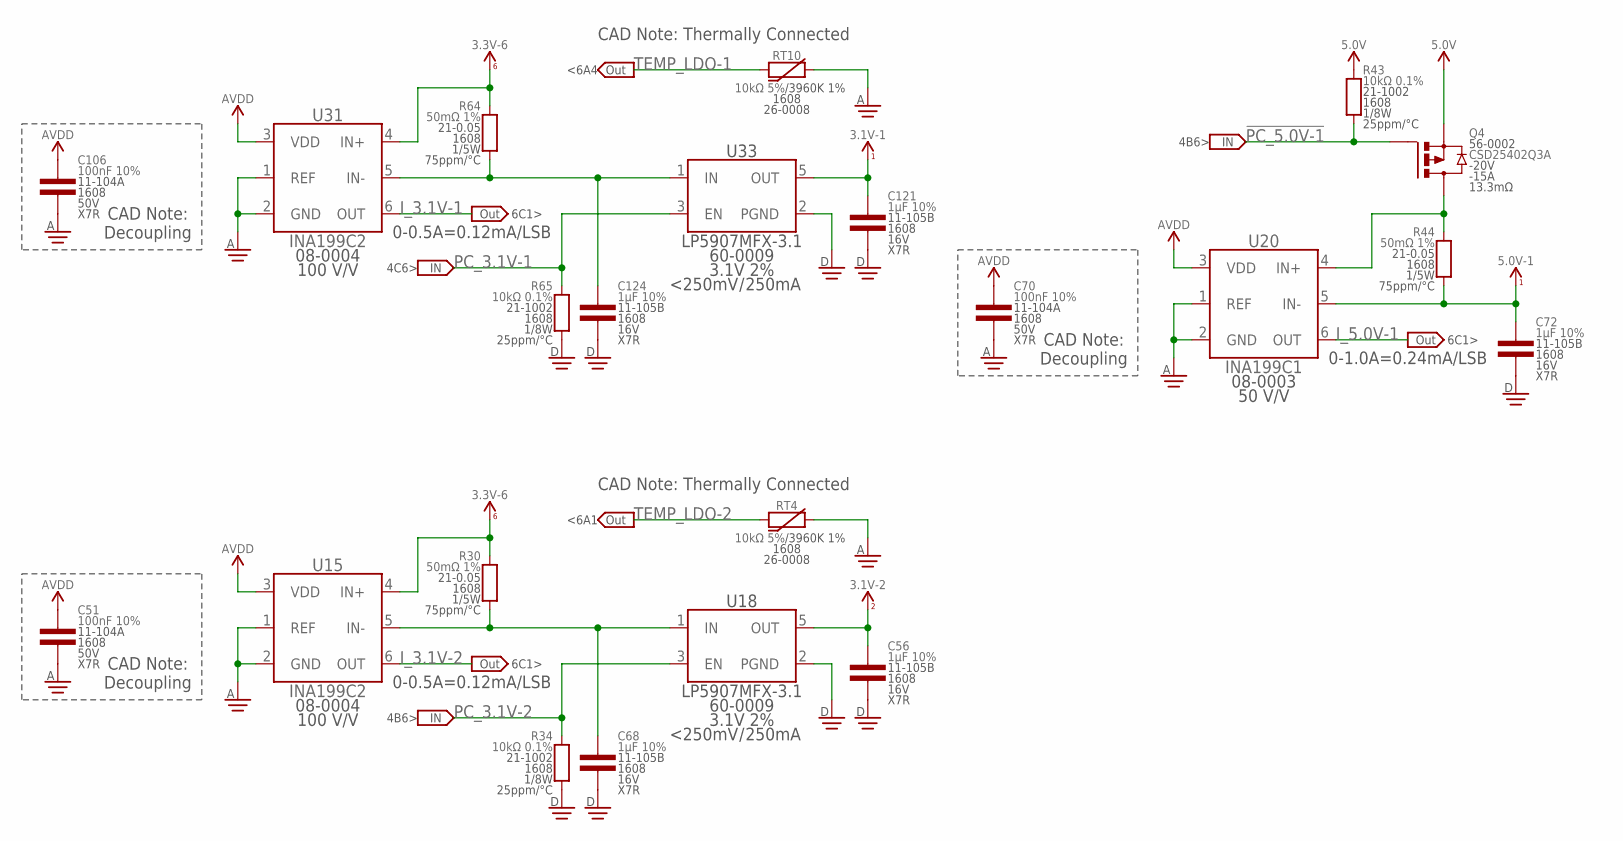
[picture p359: schematic Comms.sch, sheet 8]

Parts:
C51, C70, C106: 100nF 10%; 1608
C56, C68, C72, C121, C124: 1µF 10%; 1608
Q4: CSD25402Q3A; SON-3333
R30, R44, R64: 50mΩ 1%; 1608
R34, R43, R65: 10kΩ 0.1%; 1608
RT4, RT10: 10kΩ 5%; 1608
U15, U31: INA199C2; SOT363
U18, U33: LP5907MFX-3.1; SOT23-5
U20: INA199C1; SOT363

Connections:
3.1V_1: C121.1, U33.5 (OUT); also elsewhere on the board
3.1V_2: C56.1, U18.5 (OUT); also elsewhere on the board
3.3V_6: R30.2, R64.2, U15.4 (IN+), U31.4 (IN+); also elsewhere on the board
5.0V: Q4.5 (S), Q4.6 (S), Q4.7 (S), Q4.8 (S), Q4.PAD (S), R43.2; also elsewhere on the board
5.0V_1: C72.1, R44.1, U20.5 (IN-); also elsewhere on the board
!PC_5.0V-1: Q4.4 (G), R43.1; also elsewhere on the board
AGND: C51.2, C70.2, C106.2, RT4.2, RT10.2, U15.1 (REF), U15.2 (GND), U20.1 (REF), U20.2 (GND), U31.1 (REF), U31.2 (GND); also elsewhere on the board
AVDD: C51.1, C70.1, C106.1, U15.3 (VDD), U20.3 (VDD), U31.3 (VDD); also elsewhere on the board
DGND: C56.2, C68.2, C72.2, C121.2, C124.2, R34.1, R65.1, U18.2 (PGND), U33.2 (PGND); also elsewhere on the board
I_3.1V-1: U31.6 (OUT); also elsewhere on the board
I_3.1V-1N: C124.1, R64.1, U31.5 (IN-), U33.1 (IN)
I_3.1V-2: U15.6 (OUT); also elsewhere on the board
I_3.1V-2N: C68.1, R30.1, U15.5 (IN-), U18.1 (IN)
I_5.0V-1: U20.6 (OUT); also elsewhere on the board
I_5.0V_1P: Q4.1 (D), Q4.2 (D), Q4.3 (D), R44.2, U20.4 (IN+)
PC_3.1V-1: R65.2, U33.3 (EN); also elsewhere on the board
PC_3.1V-2: R34.2, U18.3 (EN); also elsewhere on the board
TEMP_LDO-1: RT10.1; also elsewhere on the board
TEMP_LDO-2: RT4.1; also elsewhere on the board

Notes on the sheet:
0-0.5A=0.12mA/LSB
CAD Note: Decoupling
0-1.0A=0.24mA/LSB
CAD Note: Thermally Connected
<6A4
<6A1
4B6>
4C6>
6C1>
