CougsInSpace/CougSat1-Hardware/CougSat1-RadioBoard/ElectricalDesign/Comms.brd

## EAGLE design CougSat1-RadioBoard/ElectricalDesign/Comms.brd (continued)

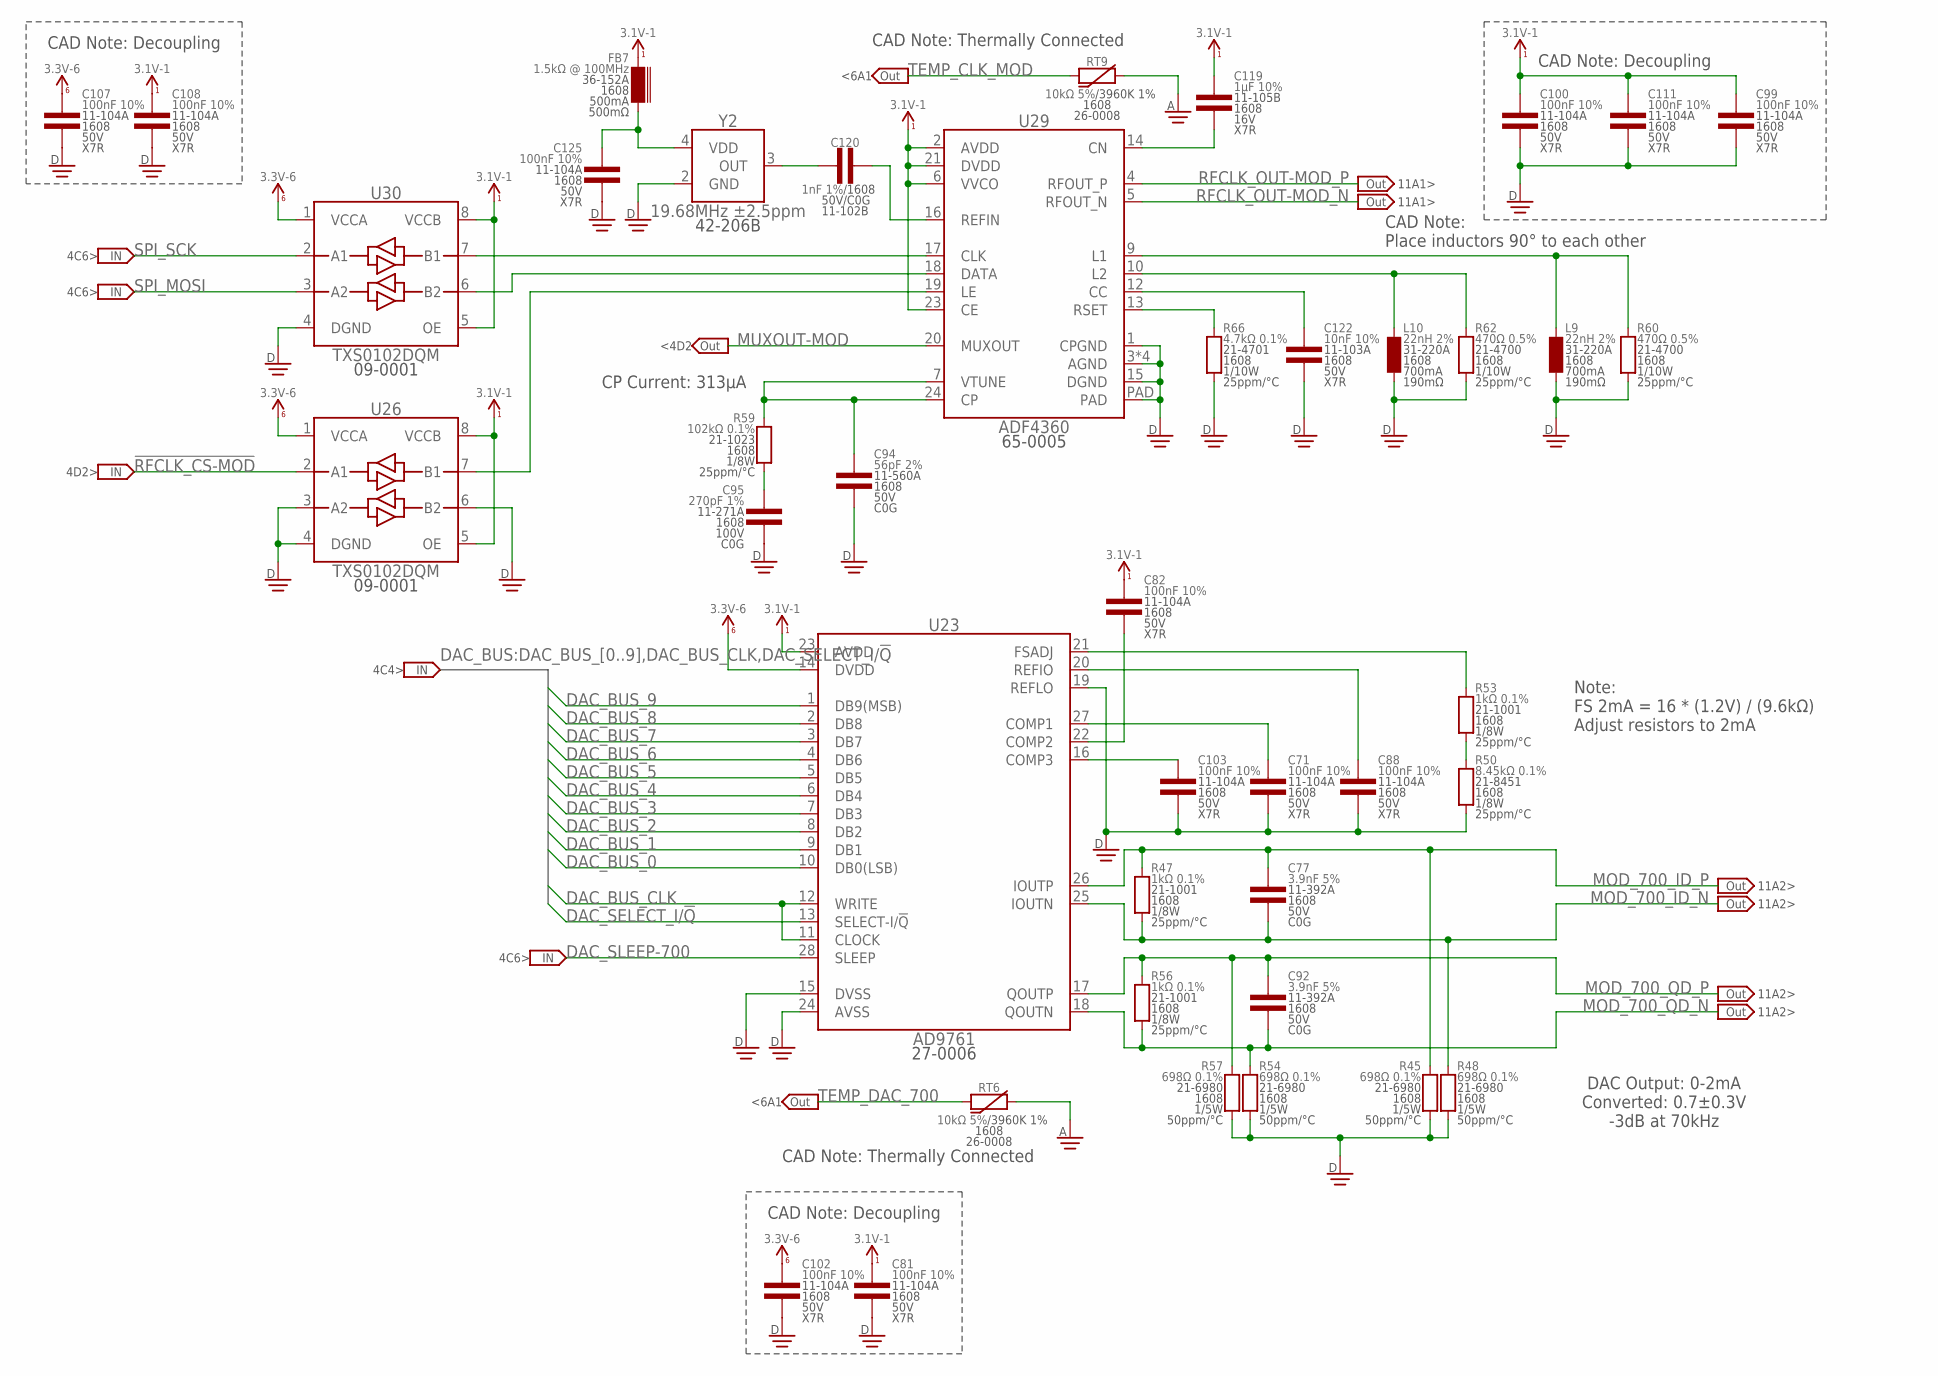
[picture p360: schematic Comms.sch, sheet 9]

Parts:
C71, C81, C82, C88, C99, C100, C102, C103, C107, C108, C111, C125: 100nF 10%; 1608
C77, C92: 3.9nF 5%; 1608
C94: 56pF 2%; 1608
C95: 270pF 1%; 1608
C119: 1µF 10%; 1608
C120: 1nF 1%; 1608
C122: 10nF 10%; 1608
FB7: 1.5kΩ @ 100MHz; 1608
L9, L10: 22nH 2%; 1608
R45, R48, R54, R57: 698Ω 0.1%; 1608
R47, R53, R56: 1kΩ 0.1%; 1608
R50: 8.45kΩ 0.1%; 1608
R59: 102kΩ 0.1%; 1608
R60, R62: 470Ω 0.5%; 1608
R66: 4.7kΩ 0.1%; 1608
RT6, RT9: 10kΩ 5%; 1608
U23: AD9761; SSOP-28
U26, U30: TXS0102DQM; X2SON-8
U29: ADF4360; QFN-24-4040
Y2: 19.68MHz ±2.5ppm; SMD-3225

Connections:
3.1V_1: C81.1, C82.1, C99.1, C100.1, C108.1, C111.1, C119.1, FB7.2, U23.23 (AVDD), U26.5 (OE), U26.8 (VCCB), U29.2 (AVDD), U29.6 (VVCO), U29.21 (DVDD), U29.23 (CE), U30.5 (OE), U30.8 (VCCB); also elsewhere on the board
3.3V_6: C102.1, C107.1, U23.14 (DVDD), U26.1 (VCCA), U30.1 (VCCA); also elsewhere on the board
!MOD_CS: U26.7 (B1), U29.19 (LE)
!RFCLK_CS-MOD: U26.2 (A1); also elsewhere on the board
AGND: RT6.2, RT9.2; also elsewhere on the board
DAC_BUS_0: U23.10 (DB0(LSB)); also elsewhere on the board
DAC_BUS_1: U23.9 (DB1); also elsewhere on the board
DAC_BUS_2: U23.8 (DB2); also elsewhere on the board
DAC_BUS_3: U23.7 (DB3); also elsewhere on the board
DAC_BUS_4: U23.6 (DB4); also elsewhere on the board
DAC_BUS_5: U23.5 (DB5); also elsewhere on the board
DAC_BUS_6: U23.4 (DB6); also elsewhere on the board
DAC_BUS_7: U23.3 (DB7); also elsewhere on the board
DAC_BUS_8: U23.2 (DB8); also elsewhere on the board
DAC_BUS_9: U23.1 (DB9(MSB)); also elsewhere on the board
DAC_BUS_CLK: U23.11 (CLOCK), U23.12 (WRITE); also elsewhere on the board
DAC_COMP1-700: C71.1, U23.27 (COMP1)
DAC_COMP2-700: C82.2, U23.22 (COMP2)
DAC_COMP3-700: C103.1, U23.16 (COMP3)
DAC_FSADJ-700: R53.2, U23.21 (FSADJ)
DAC_FSASJ_MID-700: R50.2, R53.1
DAC_REFIO-700: C88.1, U23.20 (REFIO)
DAC_SELECT_I/!Q: U23.13 (SELECT-I/!Q); also elsewhere on the board
DAC_SLEEP-700: U23.28 (SLEEP); also elsewhere on the board
DGND: C71.2, C81.2, C88.2, C94.2, C95.2, C99.2, C100.2, C102.2, C103.2, C107.2, C108.2, C111.2, C122.2, C125.2, L9.1, L10.1, R45.1, R48.1, R50.1, R54.1, R57.1, R60.1, R62.1, R66.1, U23.15 (DVSS), U23.19 (REFLO), U23.24 (AVSS), U26.3 (A2), U26.4 (DGND), U26.6 (B2), U29.1 (CPGND), U29.3 (AGND), U29.8 (AGND), U29.11 (AGND), U29.15 (DGND), U29.22 (AGND), U29.PAD, U30.4 (DGND), Y2.2 (GND); also elsewhere on the board
MOD_700_ID_N: C77.2, R47.1, R48.2, U23.25 (IOUTN); also elsewhere on the board
MOD_700_ID_P: C77.1, R45.2, R47.2, U23.26 (IOUTP); also elsewhere on the board
MOD_700_QD_N: C92.2, R54.2, R56.1, U23.18 (QOUTN); also elsewhere on the board
MOD_700_QD_P: C92.1, R56.2, R57.2, U23.17 (QOUTP); also elsewhere on the board
MOD_MOSI: U29.18 (DATA), U30.6 (B2)
MOD_SCK: U29.17 (CLK), U30.7 (B1)
MUXOUT-MOD: U29.20 (MUXOUT); also elsewhere on the board
REF_CLK_VDD-1: C125.1, FB7.1, Y2.4 (VDD)
RFCLK_CC-MOD: C122.1, U29.12 (CC)
RFCLK_CN-MOD: C119.2, U29.14 (CN)
RFCLK_CP-MOD: C94.1, R59.2, U29.7 (VTUNE), U29.24 (CP)
RFCLK_L1-MOD: L9.2, R60.2, U29.9 (L1)
RFCLK_L2-MOD: L10.2, R62.2, U29.10 (L2)
RFCLK_OUT-MOD_N: U29.5 (RFOUT_N); also elsewhere on the board
RFCLK_OUT-MOD_P: U29.4 (RFOUT_P); also elsewhere on the board
RFCLK_REFIN-MOD: C120.2, U29.16 (REFIN)
RFCLK_REFOUT-MOD: C120.1, Y2.3 (OUT)
RFCLK_RSET-MOD: R66.2, U29.13 (RSET)
RFCLK_VTUNE_FILTER-MOD: C95.1, R59.1
SPI_MOSI: U30.3 (A2); also elsewhere on the board
SPI_SCK: U30.2 (A1); also elsewhere on the board
TEMP_CLK_MOD: RT9.1; also elsewhere on the board
TEMP_DAC_700: RT6.1; also elsewhere on the board

Notes on the sheet:
CAD Note: Decoupling
CAD Note: Place inductors 90° to each other
CAD Note: Thermally Connected
CP Current: 313µA
DAC Output: 0-2mA Converted: 0.7±0.3V -3dB at 70kHz
Note: FS 2mA = 16 * (1.2V) / (9.6kΩ) Adjust resistors to 2mA
11A1>
11A2>
<6A1
<4D2
4C4>
4C6>
4D2>

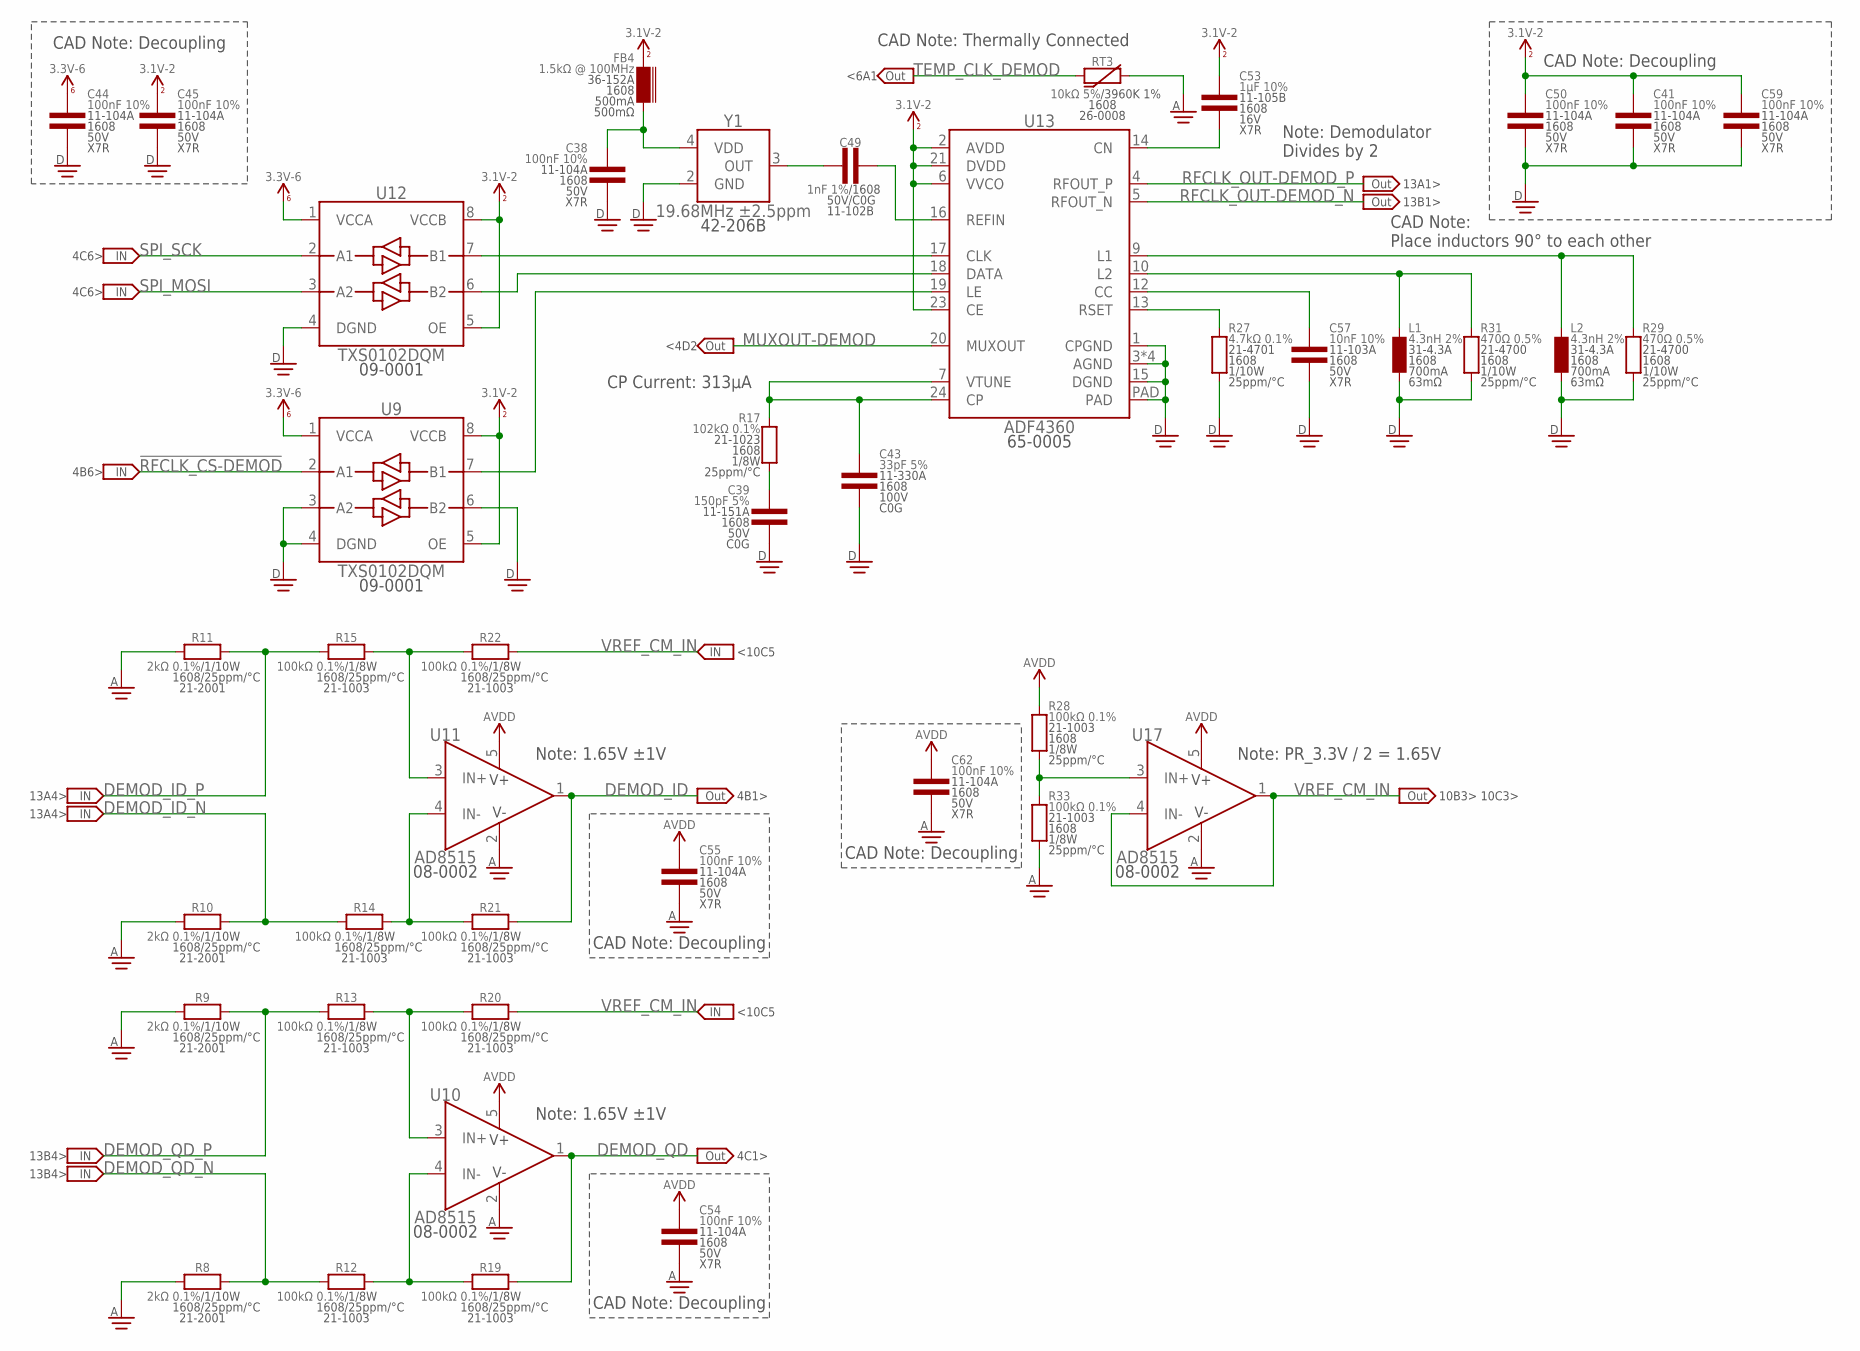
[picture p361: schematic Comms.sch, sheet 10]

Parts:
C38, C41, C44, C45, C50, C54, C55, C59, C62: 100nF 10%; 1608
C39: 150pF 5%; 1608
C43: 33pF 5%; 1608
C49: 1nF 1%; 1608
C53: 1µF 10%; 1608
C57: 10nF 10%; 1608
FB4: 1.5kΩ @ 100MHz; 1608
L1, L2: 4.3nH 2%; 1608
R8, R9, R10, R11: 2kΩ 0.1%; 1608
R12, R13, R14, R15, R19, R20, R21, R22, R28, R33: 100kΩ 0.1%; 1608
R17: 102kΩ 0.1%; 1608
R27: 4.7kΩ 0.1%; 1608
R29, R31: 470Ω 0.5%; 1608
RT3: 10kΩ 5%; 1608
U9, U12: TXS0102DQM; X2SON-8
U10, U11, U17: AD8515; SOT23-5
U13: ADF4360; QFN-24-4040
Y1: 19.68MHz ±2.5ppm; SMD-3225

Connections:
3.1V_2: C41.1, C45.1, C50.1, C53.1, C59.1, FB4.2, U9.5 (OE), U9.8 (VCCB), U12.5 (OE), U12.8 (VCCB), U13.2 (AVDD), U13.6 (VVCO), U13.21 (DVDD), U13.23 (CE); also elsewhere on the board
3.3V_6: C44.1, U9.1 (VCCA), U12.1 (VCCA); also elsewhere on the board
!DEMOD_CS: U9.7 (B1), U13.19 (LE)
!RFCLK_CS-DEMOD: U9.2 (A1); also elsewhere on the board
AGND: C54.2, C55.2, C62.2, R8.1, R9.1, R10.1, R11.1, R33.1, RT3.2, U10.2 (V-), U11.2 (V-), U17.2 (V-); also elsewhere on the board
AVDD: C54.1, C55.1, C62.1, R28.2, U10.5 (V+), U11.5 (V+), U17.5 (V+); also elsewhere on the board
DEMOD_AMP_ID_IN+: R15.2, R22.1, U11.3 (IN+)
DEMOD_AMP_ID_IN-: R14.2, R21.1, U11.4 (IN-)
DEMOD_AMP_QD_IN+: R13.2, R20.1, U10.3 (IN+)
DEMOD_AMP_QD_IN-: R12.2, R19.1, U10.4 (IN-)
DEMOD_ID: R21.2, U11.1 (OUT); also elsewhere on the board
DEMOD_ID_N: R10.2, R14.1; also elsewhere on the board
DEMOD_ID_P: R11.2, R15.1; also elsewhere on the board
DEMOD_MOSI: U12.6 (B2), U13.18 (DATA)
DEMOD_QD: R19.2, U10.1 (OUT); also elsewhere on the board
DEMOD_QD_N: R8.2, R12.1; also elsewhere on the board
DEMOD_QD_P: R9.2, R13.1; also elsewhere on the board
DEMOD_SCK: U12.7 (B1), U13.17 (CLK)
DGND: C38.2, C39.2, C41.2, C43.2, C44.2, C45.2, C50.2, C57.2, C59.2, L1.1, L2.1, R27.1, R29.1, R31.1, U9.3 (A2), U9.4 (DGND), U9.6 (B2), U12.4 (DGND), U13.1 (CPGND), U13.3 (AGND), U13.8 (AGND), U13.11 (AGND), U13.15 (DGND), U13.22 (AGND), U13.PAD, Y1.2 (GND); also elsewhere on the board
MUXOUT-DEMOD: U13.20 (MUXOUT); also elsewhere on the board
REF_CLK_VDD-2: C38.1, FB4.1, Y1.4 (VDD)
RFCLK_CC-DEMOD: C57.1, U13.12 (CC)
RFCLK_CN-DEMOD: C53.2, U13.14 (CN)
RFCLK_CP-DEMOD: C43.1, R17.2, U13.7 (VTUNE), U13.24 (CP)
RFCLK_L1-DEMOD: L2.2, R29.2, U13.9 (L1)
RFCLK_L2-DEMOD: L1.2, R31.2, U13.10 (L2)
RFCLK_OUT-DEMOD_N: U13.5 (RFOUT_N); also elsewhere on the board
RFCLK_OUT-DEMOD_P: U13.4 (RFOUT_P); also elsewhere on the board
RFCLK_REFIN-DEMOD: C49.2, U13.16 (REFIN)
RFCLK_REFOUT-DEMOD: C49.1, Y1.3 (OUT)
RFCLK_RSET-DEMOD: R27.2, U13.13 (RSET)
RFCLK_VTUNE_FILTER-DEMOD: C39.1, R17.1
SPI_MOSI: U12.3 (A2); also elsewhere on the board
SPI_SCK: U12.2 (A1); also elsewhere on the board
TEMP_CLK_DEMOD: RT3.1; also elsewhere on the board
VREF_CM_IN: R20.2, R22.2, U17.1 (OUT), U17.4 (IN-)
VREF_CM_IN_AMP_IN: R28.1, R33.2, U17.3 (IN+)

Notes on the sheet:
CAD Note: Decoupling
Note: PR_3.3V / 2 = 1.65V
CAD Note: Place inductors 90° to each other
Note: Demodulator Divides by 2
CAD Note: Thermally Connected
CP Current: 313µA
Note: 1.65V ±1V
4C6>
4B6>
<4D2
<6A1
13A4>
13B4>
13A1>
13B1>
<10C5
10B3> 10C3>
4B1>
4C1>

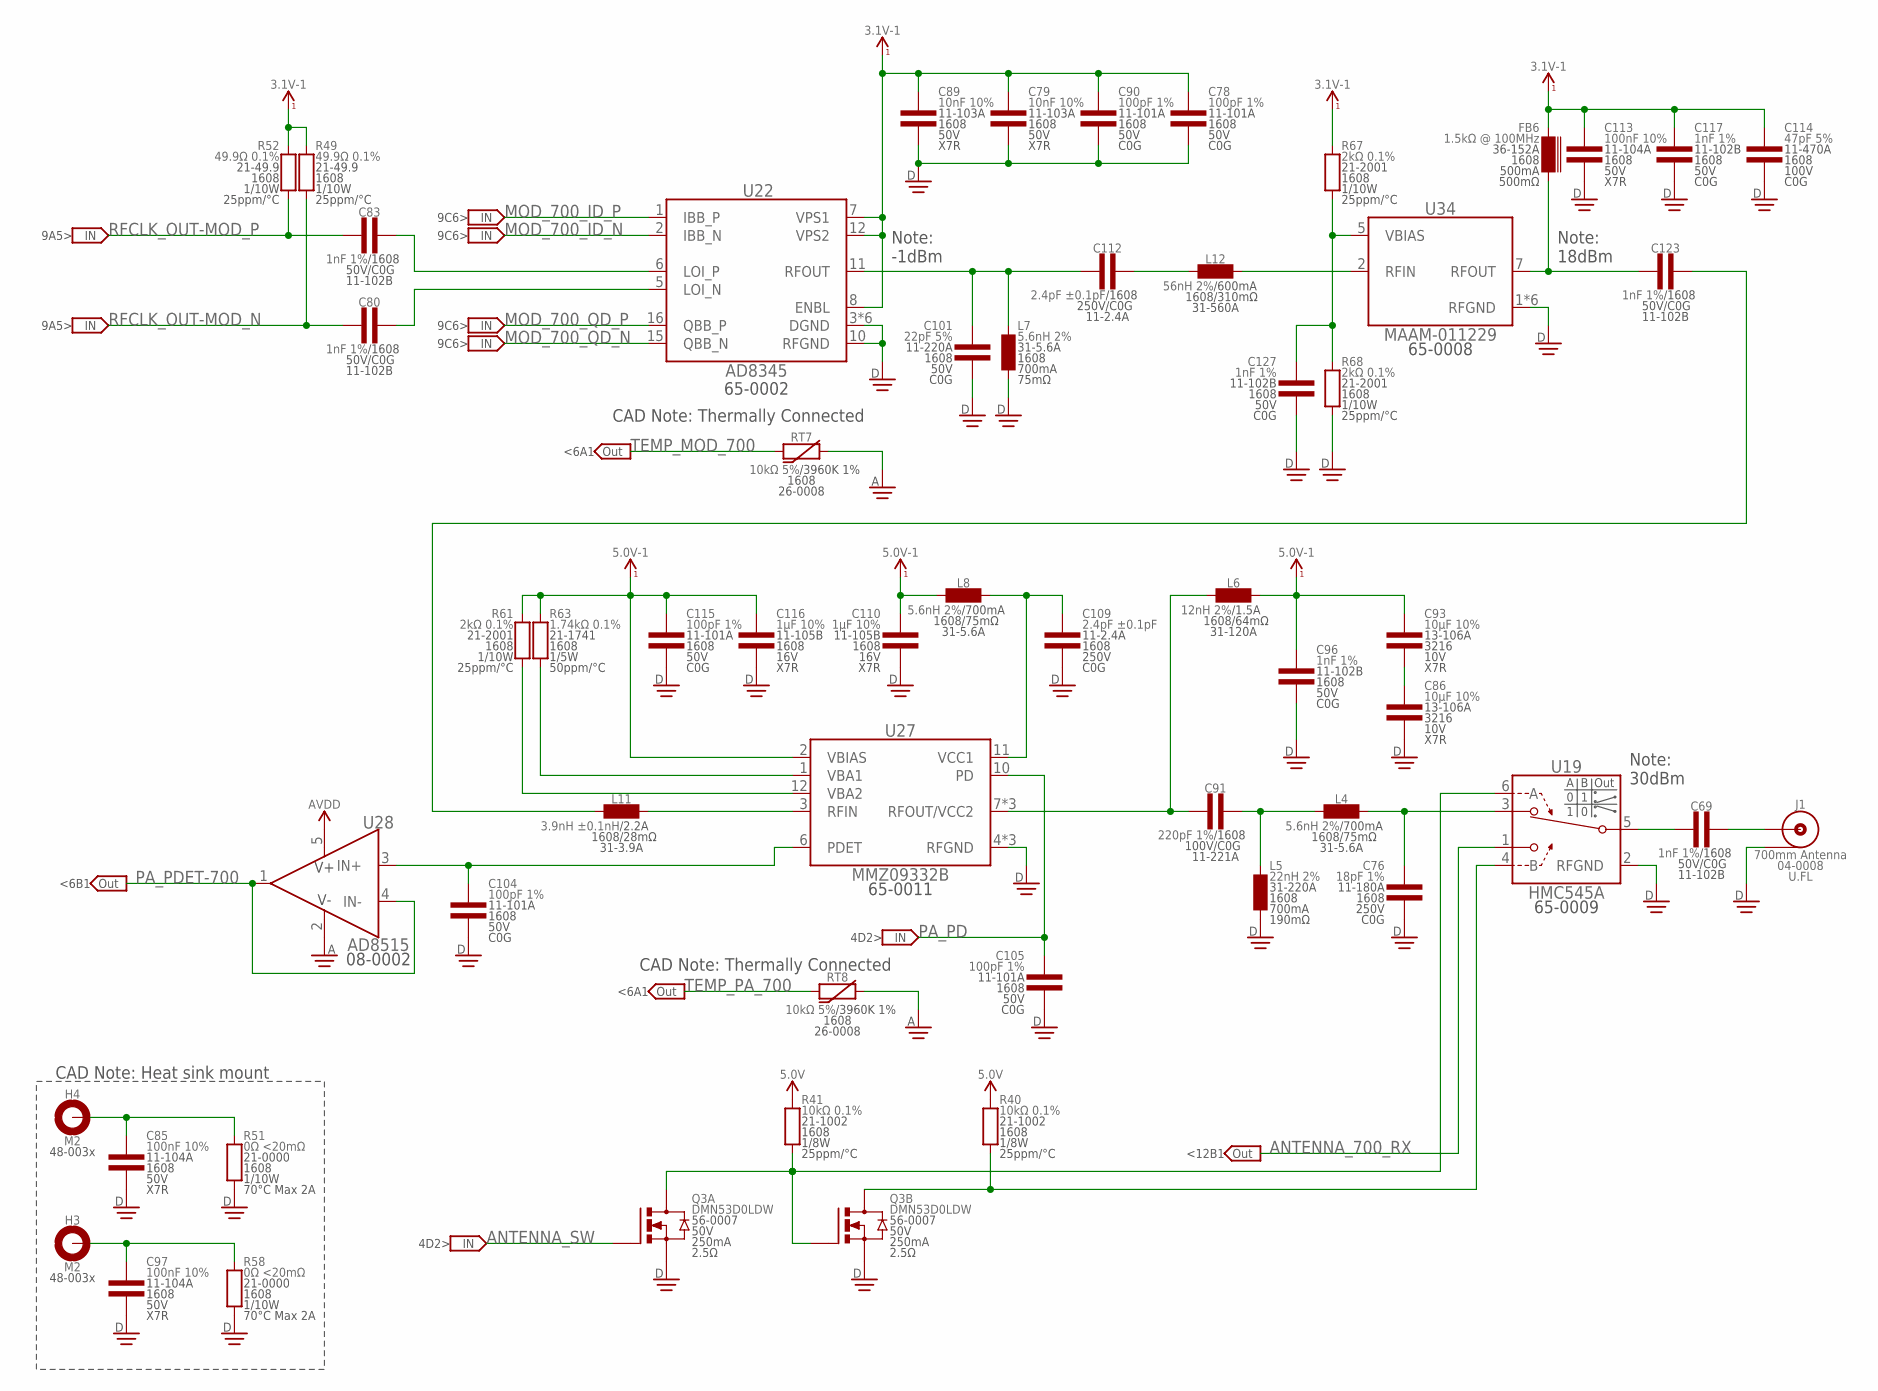
[picture p362: schematic Comms.sch, sheet 11]

Parts:
C69, C80, C83, C96, C117, C123, C127: 1nF 1%; 1608
C76: 18pF 1%; 1608
C78, C90, C104, C105, C115: 100pF 1%; 1608
C79, C89: 10nF 10%; 1608
C85, C97, C113: 100nF 10%; 1608
C86, C93: 10µF 10%; 3216
C91: 220pF 1%; 1608
C101: 22pF 5%; 1608
C109, C112: 2.4pF ±0.1pF; 1608
C110, C116: 1µF 10%; 1608
C114: 47pF 5%; 1608
FB6: 1.5kΩ @ 100MHz; 1608
H3, H4: M2; MOUNTING_HOLE-2.2
J1: 700mm Antenna; U.FL
L4, L7, L8: 5.6nH 2%; 1608
L5: 22nH 2%; 1608
L6: 12nH 2%; 1608
L11: 3.9nH ±0.1nH; 1608
L12: 56nH 2%; 1608
Q3: DMN53D0LDW; SOT363
R40, R41: 10kΩ 0.1%; 1608
R49, R52: 49.9Ω 0.1%; 1608
R51, R58: 0Ω <20mΩ; 1608
R61, R67, R68: 2kΩ 0.1%; 1608
R63: 1.74kΩ 0.1%; 1608
RT7, RT8: 10kΩ 5%; 1608
U19: HMC545A; SOT23-6
U22: AD8345; TSSOP-16
U27: MMZ09332B; QFN-12-3030
U28: AD8515; SOT23-5
U34: MAAM-011229; DFN-8-2020

Connections:
3.1V_1: C78.1, C79.1, C89.1, C90.1, C113.1, C114.1, C117.1, FB6.2, R49.2, R52.2, R67.2, U22.7 (VPS1), U22.8 (ENBL), U22.12 (VPS2); also elsewhere on the board
5.0V: R40.2, R41.2; also elsewhere on the board
5.0V_1: C93.1, C96.1, C110.1, C115.1, C116.1, L6.2, L8.1, R61.2, R63.2, U27.2 (VBIAS); also elsewhere on the board
AGND: RT7.2, RT8.2, U28.2 (V-); also elsewhere on the board
ANTENNA_700: C69.1, U19.5 (RFC)
ANTENNA_700_COAX: C69.2, J1.CENTER
ANTENNA_700_RX: U19.1 (RF2); also elsewhere on the board
ANTENNA_700_TX: C76.1, L4.2, U19.3 (RF1)
ANTENNA_SW: Q3.2 (G); also elsewhere on the board
ANTENNA_SW_A: Q3.5 (G), Q3.6 (D), R41.1, U19.6 (A)
ANTENNA_SW_B: Q3.3 (D), R40.1, U19.4 (B)
AVDD: U28.5 (V+); also elsewhere on the board
CHASSIS_700-0: C85.1, H4.1, H4.V1, H4.V2, H4.V3, H4.V4, H4.V5, H4.V6, H4.V7, H4.V8, R51.2
CHASSIS_700-1: C97.1, H3.1, H3.V1, H3.V2, H3.V3, H3.V4, H3.V5, H3.V6, H3.V7, H3.V8, R58.2
DGND: C76.2, C78.2, C79.2, C85.2, C86.2, C89.2, C90.2, C96.2, C97.2, C101.2, C104.2, C105.2, C109.2, C110.2, C113.2, C114.2, C115.2, C116.2, C117.2, C127.2, J1.SHIELD@1 (SHIELD), J1.SHIELD@2 (SHIELD), J1.SHIELD@13 (SHIELD), L5.1, L7.1, Q3.1 (S), Q3.4 (S), R51.1, R58.1, R68.1, U19.2 (RFGND), U22.3 (DGND), U22.4 (DGND), U22.9 (DGND), U22.10 (RFGND), U22.13 (DGND), U22.14 (DGND), U22.PAD (DGND), U27.4 (RFGND), U27.5 (RFGND), U27.PAD (RFGND), U34.1 (RFGND), U34.3 (RFGND), U34.4 (RFGND), U34.6 (RFGND), U34.8 (RFGND), U34.PAD (RFGND); also elsewhere on the board
MOD_700_ID_N: U22.2 (IBB_N); also elsewhere on the board
MOD_700_ID_P: U22.1 (IBB_P); also elsewhere on the board
MOD_700_LOI_N: C80.2, U22.5 (LOI_N)
MOD_700_LOI_P: C83.2, U22.6 (LOI_P)
MOD_700_QD_N: U22.15 (QBB_N); also elsewhere on the board
MOD_700_QD_P: U22.16 (QBB_P); also elsewhere on the board
MOD_700_RFOUT: C101.1, C112.1, L7.2, U22.11 (RFOUT)
MOD_LNA_700_RFIN: L12.2, U34.2 (RFIN)
MOD_LNA_700_RFINMID: C112.2, L12.1
MOD_LNA_700_RFOUT: C123.1, FB6.1, U34.7 (RFOUT)
MOD_PA_700_RFIN: L11.2, U27.3 (RFIN)
MOD_PA_700_RFINMID: C123.2, L11.1
PA_CAPMID: C86.1, C93.2
PA_PD: C105.1, U27.10 (PD); also elsewhere on the board
PA_PDET-700: U28.1 (OUT), U28.4 (IN-); also elsewhere on the board
PA_PDET_UNBUF-700: C104.1, U27.6 (PDET), U28.3 (IN+)
PA_RFOUT-700: C91.1, L6.1, U27.7 (RFOUT/VCC2), U27.8 (RFOUT/VCC2), U27.9 (RFOUT/VCC2)
PA_RFOUTMID-700: C91.2, L4.1, L5.2
PA_VBA1-700: R63.1, U27.1 (VBA1)
PA_VBA2-700: R61.1, U27.12 (VBA2)
PA_VCC1-700: C109.1, L8.2, U27.11 (VCC1)
PREAMP_700_BIAS: C127.1, R67.1, R68.2, U34.5 (VBIAS)
RFCLK_OUT-MOD_N: C80.1, R49.1; also elsewhere on the board
RFCLK_OUT-MOD_P: C83.1, R52.1; also elsewhere on the board
TEMP_MOD_700: RT7.1; also elsewhere on the board
TEMP_PA_700: RT8.1; also elsewhere on the board

Notes on the sheet:
Note: -1dBm
Note: 30dBm
Note: 18dBm
CAD Note: Thermally Connected
CAD Note: Heat sink mount
<6A1
<6B1
9A5>
9C6>
4D2>
<12B1

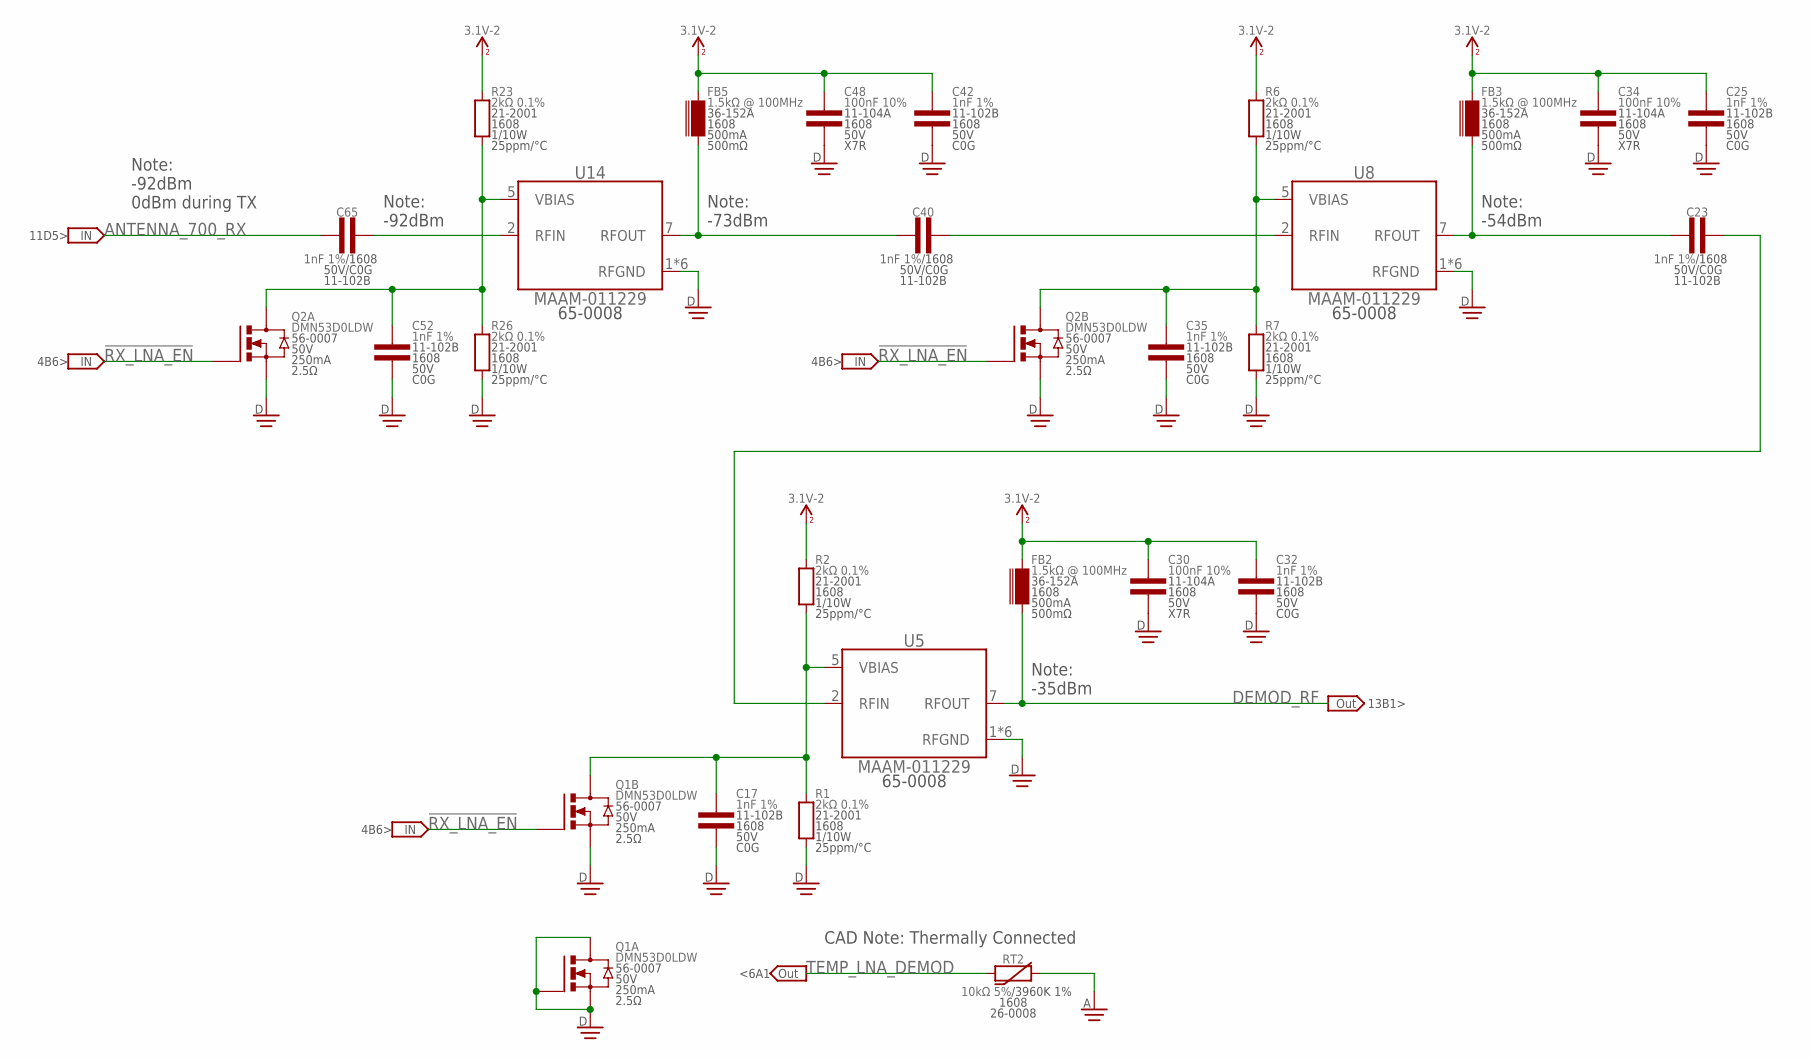
[picture p363: schematic Comms.sch, sheet 12]

Parts:
C17, C23, C25, C32, C35, C40, C42, C52, C65: 1nF 1%; 1608
C30, C34, C48: 100nF 10%; 1608
FB2, FB3, FB5: 1.5kΩ @ 100MHz; 1608
Q1, Q2: DMN53D0LDW; SOT363
R1, R2, R6, R7, R23, R26: 2kΩ 0.1%; 1608
RT2: 10kΩ 5%; 1608
U5, U8, U14: MAAM-011229; DFN-8-2020

Connections:
3.1V_2: C25.1, C30.1, C32.1, C34.1, C42.1, C48.1, FB2.2, FB3.2, FB5.2, R2.2, R6.2, R23.2; also elsewhere on the board
!RX_LNA_EN: Q1.5 (G), Q2.2 (G), Q2.5 (G); also elsewhere on the board
AGND: RT2.2; also elsewhere on the board
ANTENNA_700_RX: C65.1; also elsewhere on the board
DEMOD_RF: FB2.1, U5.7 (RFOUT); also elsewhere on the board
DGND: C17.2, C25.2, C30.2, C32.2, C34.2, C35.2, C42.2, C48.2, C52.2, Q1.1 (S), Q1.2 (G), Q1.4 (S), Q1.6 (D), Q2.1 (S), Q2.4 (S), R1.1, R7.1, R26.1, U5.1 (RFGND), U5.3 (RFGND), U5.4 (RFGND), U5.6 (RFGND), U5.8 (RFGND), U5.PAD (RFGND), U8.1 (RFGND), U8.3 (RFGND), U8.4 (RFGND), U8.6 (RFGND), U8.8 (RFGND), U8.PAD (RFGND), U14.1 (RFGND), U14.3 (RFGND), U14.4 (RFGND), U14.6 (RFGND), U14.8 (RFGND), U14.PAD (RFGND); also elsewhere on the board
RX_LNA_BIAS-0: C52.1, Q2.6 (D), R23.1, R26.2, U14.5 (VBIAS)
RX_LNA_BIAS-1: C35.1, Q2.3 (D), R6.1, R7.2, U8.5 (VBIAS)
RX_LNA_BIAS-2: C17.1, Q1.3 (D), R1.2, R2.1, U5.5 (VBIAS)
RX_LNA_RFIN-0: C65.2, U14.2 (RFIN)
RX_LNA_RFIN-1: C40.2, U8.2 (RFIN)
RX_LNA_RFIN-2: C23.2, U5.2 (RFIN)
RX_LNA_RFOUT-0: C40.1, FB5.1, U14.7 (RFOUT)
RX_LNA_RFOUT-1: C23.1, FB3.1, U8.7 (RFOUT)
TEMP_LNA_DEMOD: RT2.1; also elsewhere on the board

Notes on the sheet:
Note: -54dBm
Note: -35dBm
13B1>
CAD Note: Thermally Connected
Note: -92dBm 0dBm during TX
Note: -92dBm
Note: -73dBm
11D5>
4B6>
<6A1

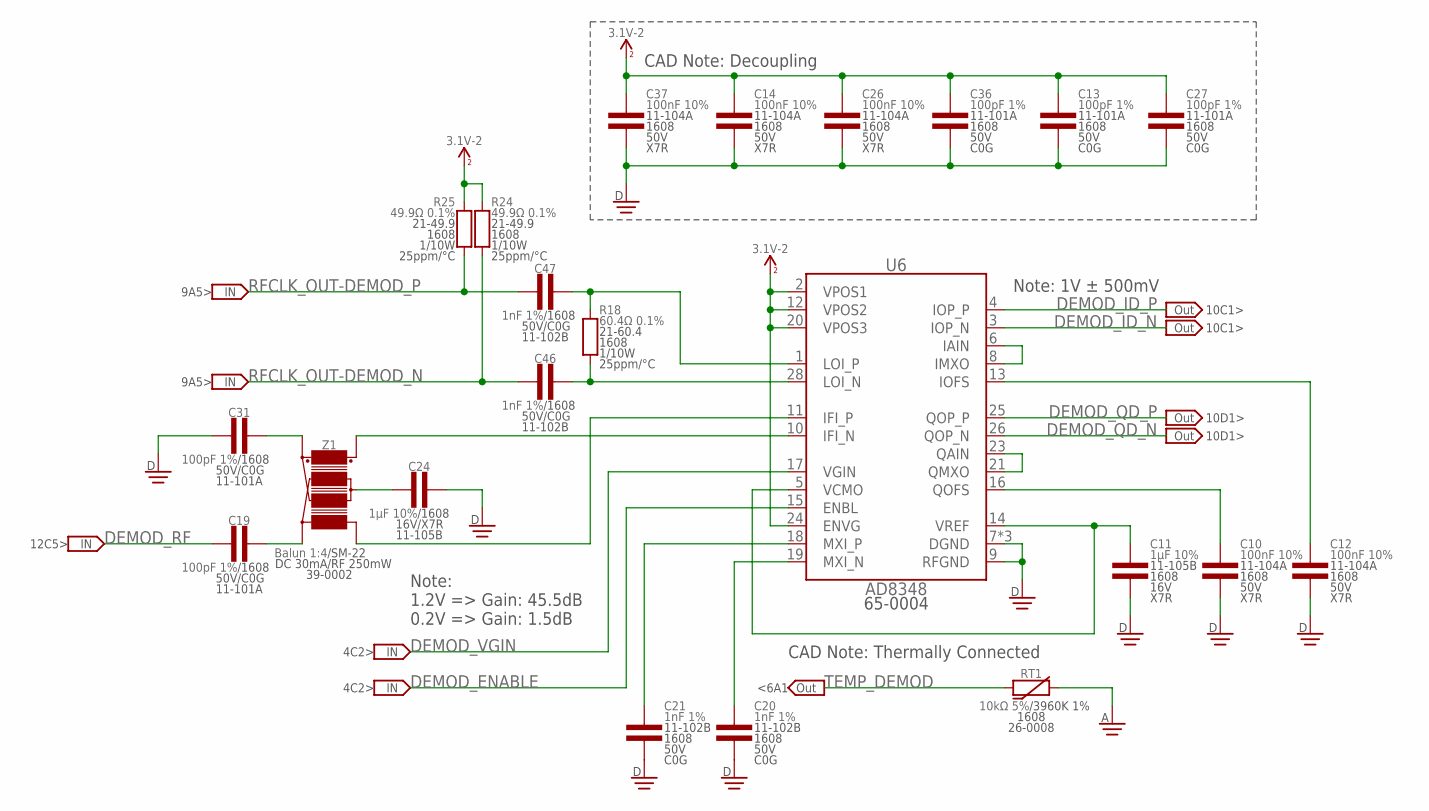
[picture p364: schematic Comms.sch, sheet 13]

Parts:
C10, C12, C14, C26, C37: 100nF 10%; 1608
C11, C24: 1µF 10%; 1608
C13, C19, C27, C31, C36: 100pF 1%; 1608
C20, C21, C46, C47: 1nF 1%; 1608
R18: 60.4Ω 0.1%; 1608
R24, R25: 49.9Ω 0.1%; 1608
RT1: 10kΩ 5%; 1608
U6: AD8348; TSSOP-28
Z1: Balun 1:4; SM-22

Connections:
3.1V_2: C13.1, C14.1, C26.1, C27.1, C36.1, C37.1, R24.2, R25.2, U6.2 (VPOS1), U6.12 (VPOS2), U6.20 (VPOS3), U6.24 (ENVG); also elsewhere on the board
AGND: RT1.2; also elsewhere on the board
DEMODE_MXI_P: C21.1, U6.18 (MXI_P)
DEMOD_700_BALUN_PRIMARY1: C31.2, Z1.5 (PRIMARY-DOT)
DEMOD_700_BALUN_PRIMARY_DOT1: C19.2, Z1.4 (PRIMARY)
DEMOD_700_BALUN_SCT: C24.1, Z1.2 (SECONDARY-CT)
DEMOD_700_IFI_N: U6.11 (IFI_P), Z1.3 (SECONDARY)
DEMOD_700_IFI_P: U6.10 (IFI_N), Z1.1 (SECONDARY-DOT)
DEMOD_700_LOI_N: C46.2, R18.1, U6.28 (LOI_N)
DEMOD_700_LOI_P: C47.2, R18.2, U6.1 (LOI_P)
DEMOD_ENABLE: U6.15 (ENBL); also elsewhere on the board
DEMOD_ID_N: U6.3 (IOP_N); also elsewhere on the board
DEMOD_ID_P: U6.4 (IOP_P); also elsewhere on the board
DEMOD_IMXO: U6.6 (IAIN), U6.8 (IMXO)
DEMOD_IOFS: C12.1, U6.13 (IOFS)
DEMOD_MXI_N: C20.1, U6.19 (MXI_N)
DEMOD_QD_N: U6.26 (QOP_N); also elsewhere on the board
DEMOD_QD_P: U6.25 (QOP_P); also elsewhere on the board
DEMOD_QMXO: U6.21 (QMXO), U6.23 (QAIN)
DEMOD_QOFS1: C10.1, U6.16 (QOFS)
DEMOD_RF: C19.1; also elsewhere on the board
DEMOD_VGIN: U6.17 (VGIN); also elsewhere on the board
DEMOD_VREF: C11.1, U6.5 (VCMO), U6.14 (VREF)
DGND: C10.2, C11.2, C12.2, C13.2, C14.2, C20.2, C21.2, C24.2, C26.2, C27.2, C31.1, C36.2, C37.2, U6.7 (DGND), U6.9 (RFGND), U6.22 (DGND), U6.27 (DGND); also elsewhere on the board
RFCLK_OUT-DEMOD_N: C46.1, R24.1; also elsewhere on the board
RFCLK_OUT-DEMOD_P: C47.1, R25.1; also elsewhere on the board
TEMP_DEMOD: RT1.1; also elsewhere on the board

Notes on the sheet:
Note: 1.2V => Gain: 45.5dB 0.2V => Gain: 1.5dB
Note: 1V ± 500mV
CAD Note: Decoupling
CAD Note: Thermally Connected
9A5>
12C5>
4C2>
<6A1
10C1>
10D1>

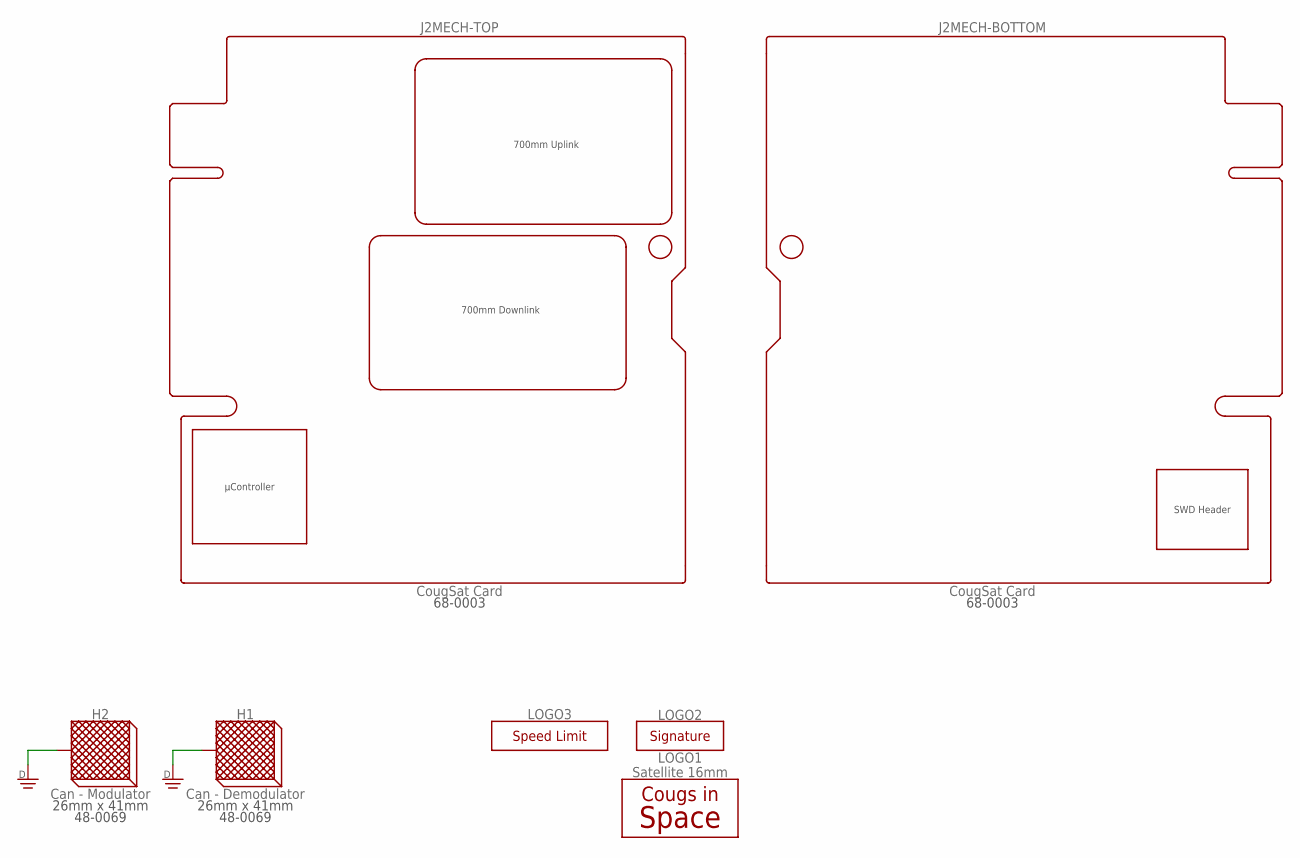
[picture p365: schematic Comms.sch, sheet 14]

Parts:
H1: Can - Demodulator; SHIELD-2641
H2: Can - Modulator; SHIELD-2641
J2: CougSat Card; CARD-FULL-OPEN+X
LOGO1: Satellite 16mm; CIS-SATELLITE-16
LOGO2: SIGNATUREBRADLEY; SIGN-BRADLEY
LOGO3: Speed Limit; SPEED_LIMIT

Connections:
DGND: H1.1, H1.2, H2.1, H2.2; also elsewhere on the board
PR_3.3V-1: J2.A2 (PR_3.3V-1), J2.B2 (PR_3.3V-1)
PR_3.3V-2: J2.A3 (PR_3.3V-2), J2.B3 (PR_3.3V-2)
PR_3.3V-3: J2.A4 (PR_3.3V-3), J2.B4 (PR_3.3V-3)
PR_3.3V-4: J2.A5 (PR_3.3V-4), J2.B5 (PR_3.3V-4)
PR_3.3V-7: J2.A8 (PR_3.3V-7), J2.B8 (PR_3.3V-7)
PR_3.3V-8: J2.A9 (PR_3.3V-8), J2.B9 (PR_3.3V-8)
PR_3.3V-9: J2.A10 (PR_3.3V-9), J2.B10 (PR_3.3V-9)
PR_3.3V-10: J2.A11 (PR_3.3V-10), J2.B11 (PR_3.3V-10)
PR_3.3V-11: J2.A12 (PR_3.3V-11), J2.B12 (PR_3.3V-11)
PR_3.3V-12: J2.A13 (PR_3.3V-12), J2.B13 (PR_3.3V-12)
PR_BATT-0: J2.A14 (PR_BATT-0), J2.B14 (PR_BATT-0)
PR_BATT-1: J2.A15 (PR_BATT-1), J2.B15 (PR_BATT-1)
PR_BATT-2: J2.A16 (PR_BATT-2), J2.B16 (PR_BATT-2)
PR_BATT-3: J2.A17 (PR_BATT-3), J2.B17 (PR_BATT-3)
PR_BATT-4: J2.A18 (PR_BATT-4), J2.B18 (PR_BATT-4)
PR_BATT-5: J2.A19 (PR_BATT-5), J2.B19 (PR_BATT-5)

Notes on the sheet:
µController
700mm Downlink
700mm Uplink
SWD Header
