CougsInSpace/CougSat1-Hardware/CougSat1-RadioBoard/ElectricalDesign/Comms.brd

## EAGLE design CougSat1-RadioBoard/ElectricalDesign/Comms.brd (continued)

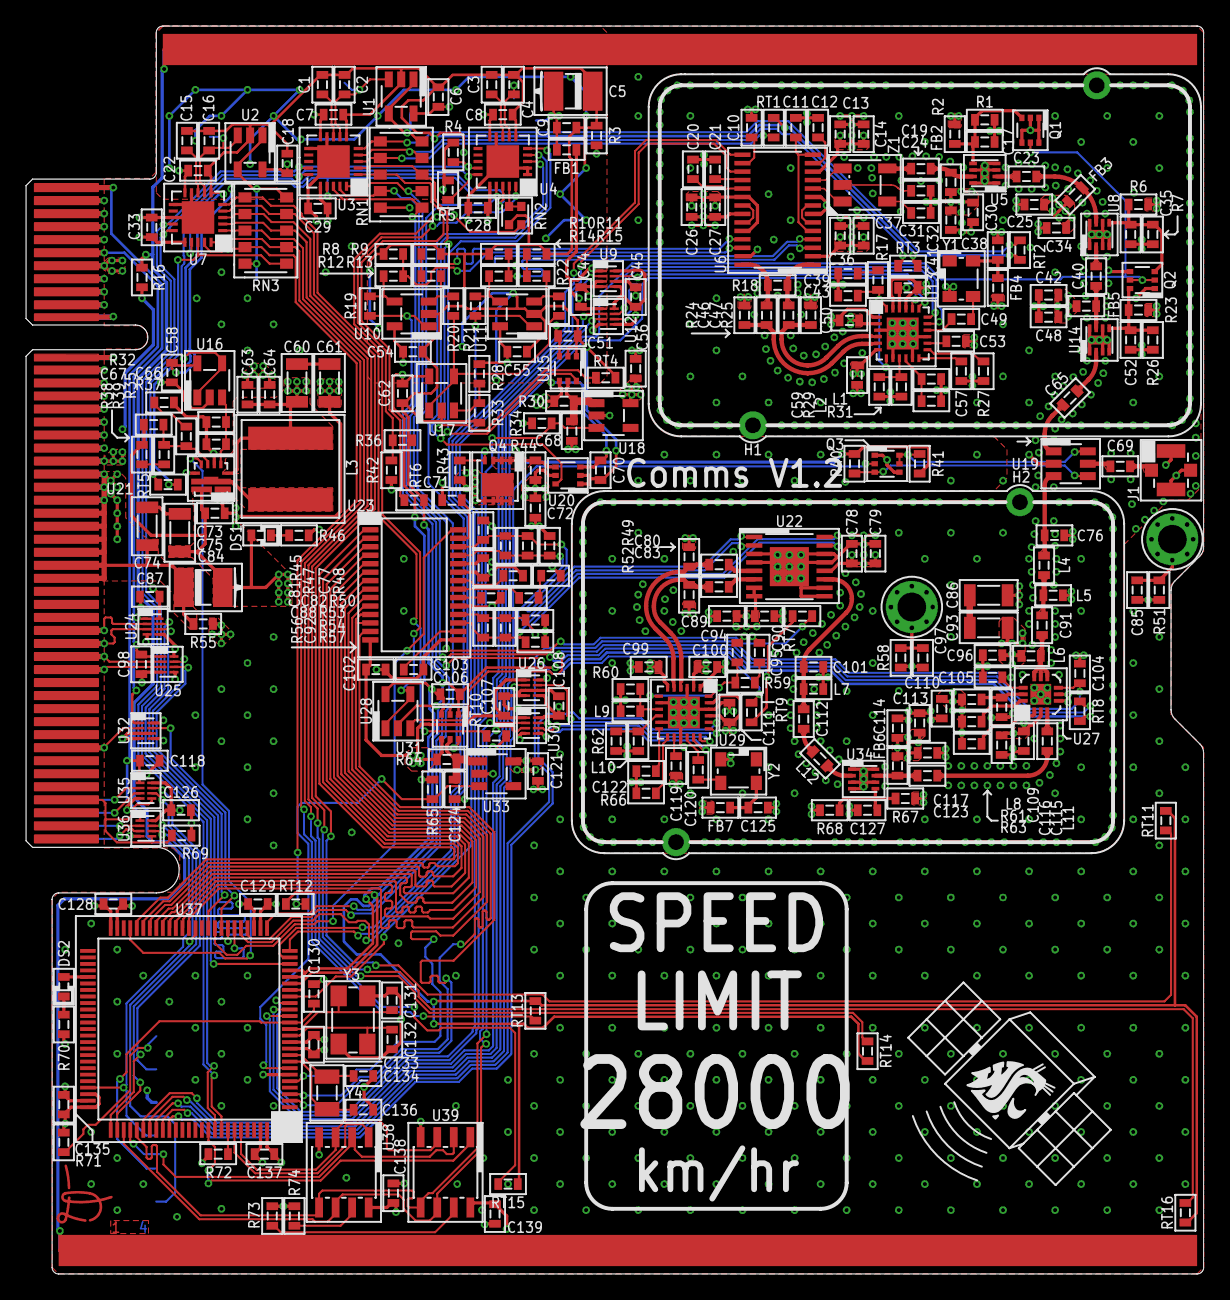
[picture p366: board Comms.brd from above]

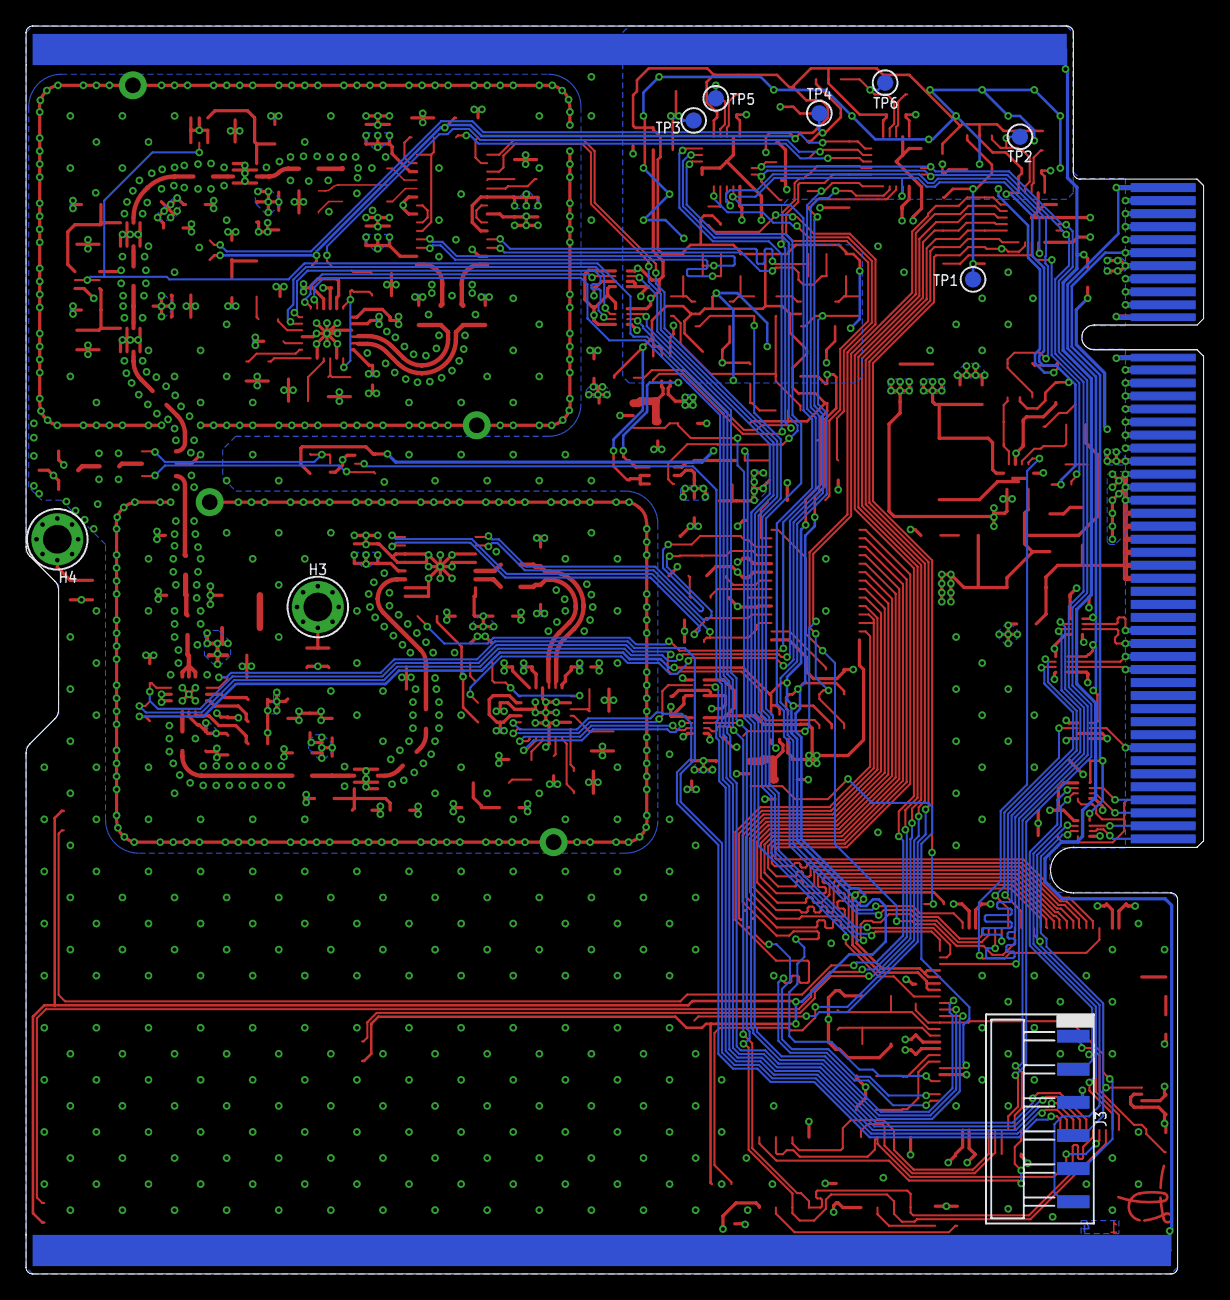
[picture p367: board Comms.brd from below]

Board: 4 copper layers, 90.4 x 95.8 mm, 317 parts (9 on the bottom side), 235 nets.
