CougsInSpace/CougSat1-Hardware/CougSat1-RadioBoard/ElectricalDesign/+XPanel.brd

## EAGLE design CougSat1-RadioBoard/ElectricalDesign/+XPanel.brd (2020-03-10)

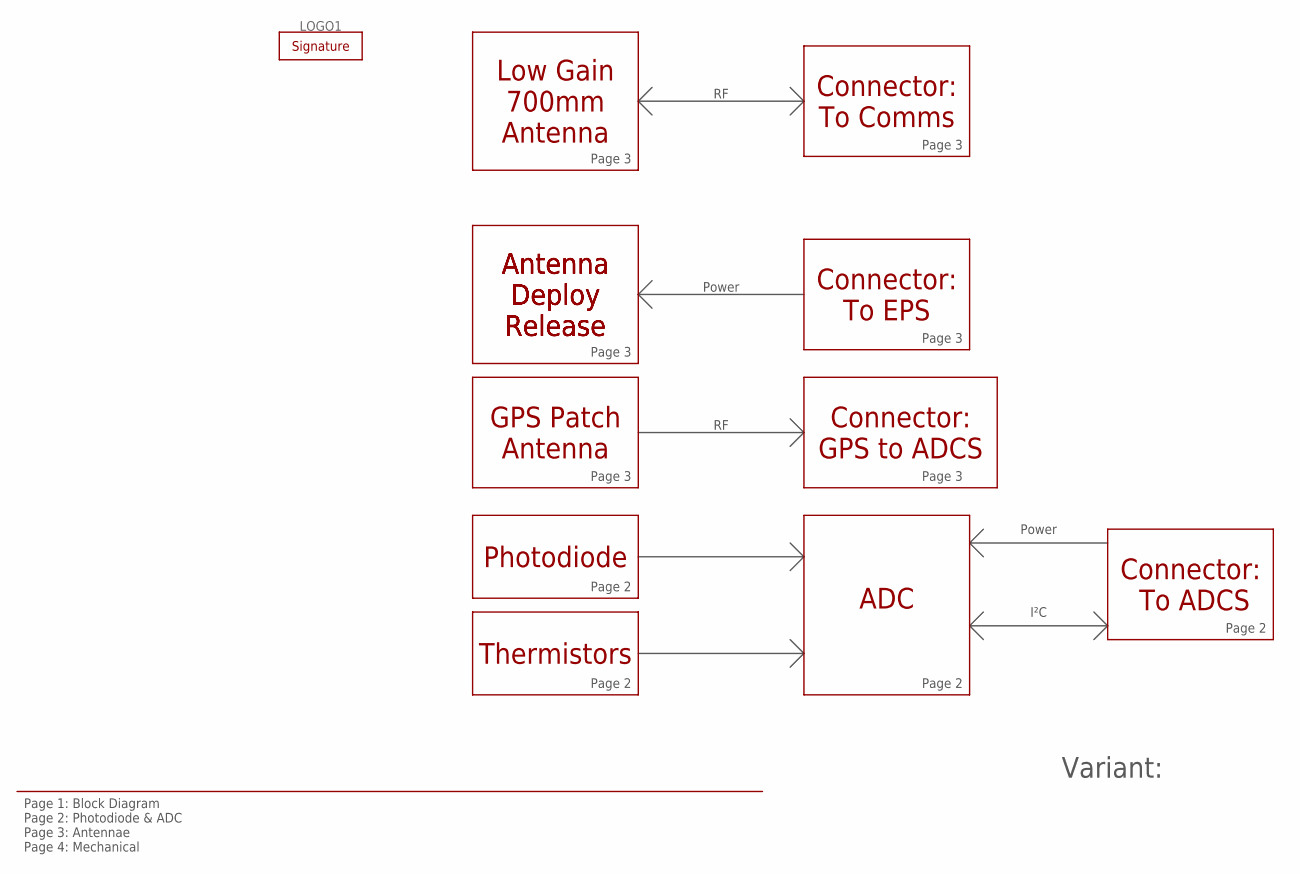
[picture p368: schematic +XPanel.sch, sheet 1]

Parts:
LOGO1: SIGNATUREJAYSON; SIGN-JAYSON

Notes on the sheet:
Page 1: Block Diagram Page 2: Photodiode & ADC Page 3: Antennae Page 4: Mechanical
Low Gain 700mm Antenna
GPS Patch Antenna
Antenna Deploy Release
Connector: To Comms
Connector: To EPS
Connector: GPS to ADCS
Power
Photodiode
ADC
Connector: To ADCS
I²C
Page 2
Page 3
Thermistors
Variant:

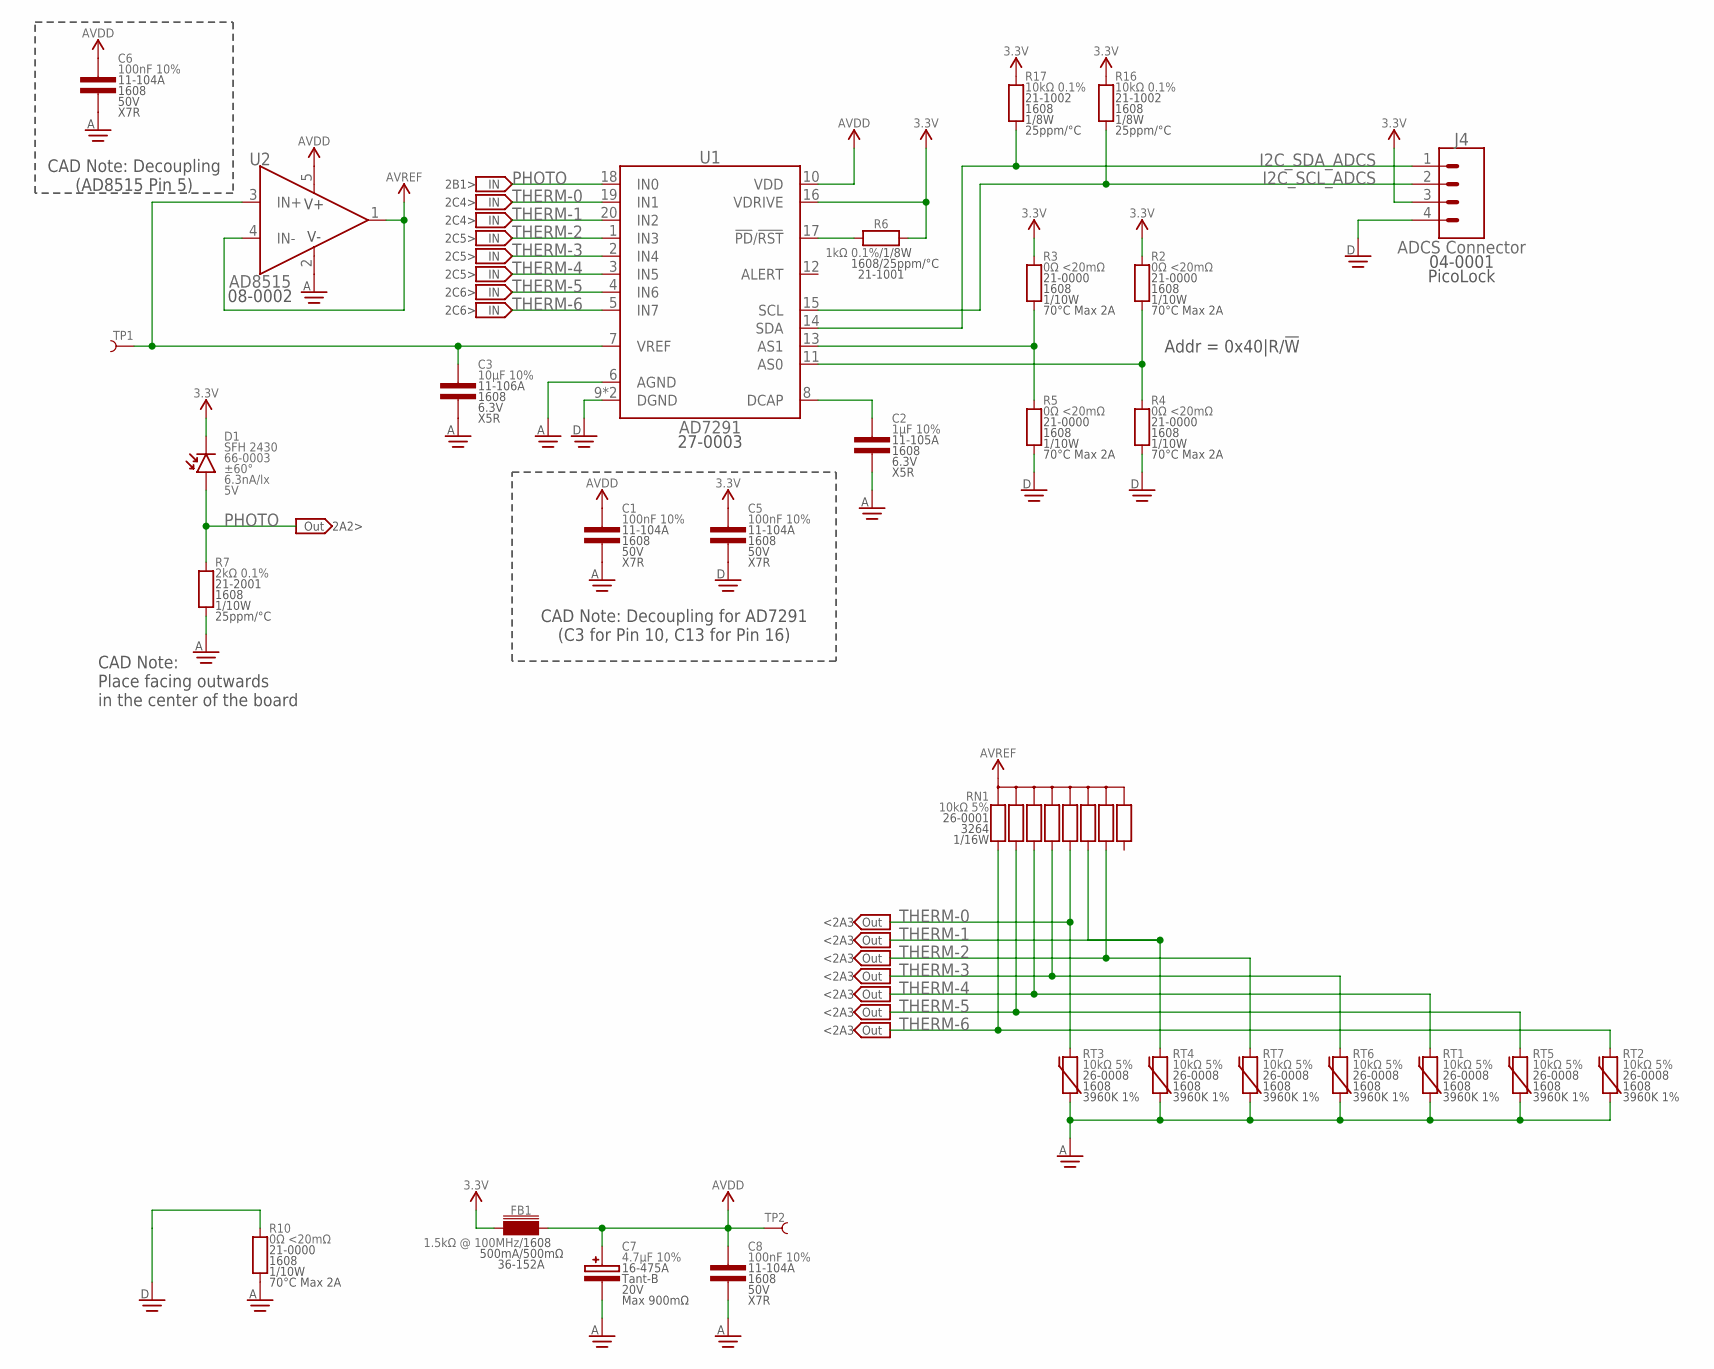
[picture p369: schematic +XPanel.sch, sheet 2]

Parts:
C1, C5, C6, C8: 100nF 10%; 1608
C2: 1µF 10%; 1608
C3: 10µF 10%; 1608
C7: 4.7µF 10%; 4028-POL
D1: SFH 2430; SFH2430
FB1: 1.5kΩ @ 100MHz; 1608
J4: ADCS Connector; PICOLOCK1.5-04
R2, R3, R4, R5, R10: 0Ω <20mΩ; 1608
R6: 1kΩ 0.1%; 1608
R7: 2kΩ 0.1%; 1608
R16, R17: 10kΩ 0.1%; 1608
RN1: 10kΩ 5%; 3264
RT1, RT2, RT3, RT4, RT5, RT6, RT7: 10kΩ 5%; 1608
TP1, TP2: TEST_POINT-SMD-C-1.25; SMD-C-1.25
U1: AD7291; QFN-20-4040
U2: AD8515; SOT23-5

Connections:
3.3V: C5.1, D1.C, FB1.1, J4.3, R2.2, R3.2, R6.2, R16.2, R17.2, U1.16 (VDRIVE)
ADC_AS0: R2.1, R4.2, U1.11 (AS0)
ADC_AS1: R3.1, R5.2, U1.13 (AS1)
AGND: C1.2, C2.2, C3.2, C6.2, C7.C, C8.2, R7.1, R10.1, RT1.1, RT2.1, RT3.1, RT4.1, RT5.1, RT6.1, RT7.1, U1.6 (AGND), U2.2 (V-)
AVDD: C1.1, C6.1, C7.A, C8.1, FB1.2, TP2.1, U1.10 (VDD), U2.5 (V+)
AVREF: RN1.5 (C), RN1.10 (C), U2.1 (OUT), U2.4 (IN-)
AVREF_UNBUF: C3.1, TP1.1, U1.7 (VREF), U2.3 (IN+)
DCAP: C2.1, U1.8 (DCAP)
DGND: C5.2, J4.4, R4.1, R5.1, R10.2, U1.9 (DGND), U1.PAD (DGND)
I2C_SCL_ADCS: J4.2, R16.1, U1.15 (SCL)
I2C_SDA_ADCS: J4.1, R17.1, U1.14 (SDA)
PD_RST: R6.1, U1.17 (!PD!/!RST)
PHOTO: D1.A, R7.2, U1.18 (IN0)
THERM-0: RN1.6 (5), RT3.2, U1.19 (IN1)
THERM-1: RN1.7 (6), RT4.2, U1.20 (IN2)
THERM-2: RN1.8 (7), RT7.2, U1.1 (IN3)
THERM-3: RN1.4, RT6.2, U1.2 (IN4)
THERM-4: RN1.3, RT1.2, U1.3 (IN5)
THERM-5: RN1.2, RT5.2, U1.4 (IN6)
THERM-6: RN1.1, RT2.2, U1.5 (IN7)

Notes on the sheet:
CAD Note: Place facing outwards in the center of the board
<2A3
2C6>
2C5>
2C5>
2C4>
2C4>
Addr = 0x40|R/!W
CAD Note: Decoupling (AD8515 Pin 5)
CAD Note: Decoupling for AD7291 (C3 for Pin 10, C13 for Pin 16)
2B1>
2A2>

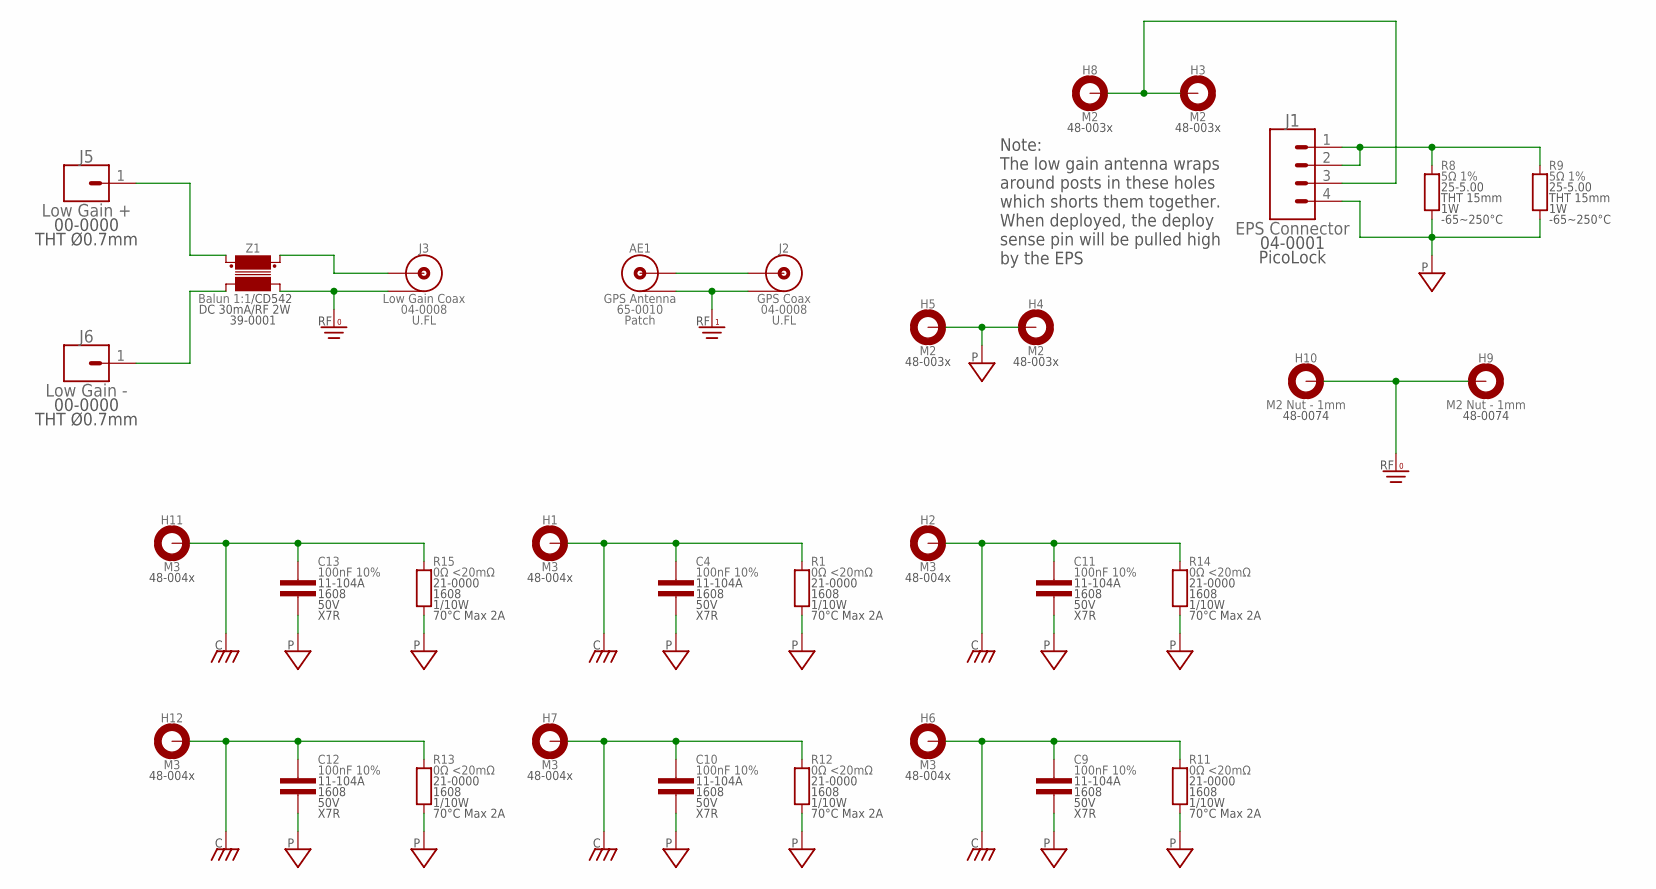
[picture p370: schematic +XPanel.sch, sheet 3]

Parts:
AE1: GPS Antenna; ANTENNA-GPS
C4, C9, C10, C11, C12, C13: 100nF 10%; 1608
H1, H2, H6, H7, H11, H12: M3; MOUNTING_HOLE-3.3
H3, H4, H5, H8: M2; MOUNTING_HOLE-2.2
H9, H10: M2 Nut - 1mm; MOUNTING_HOLE-M2_NUT
J1: EPS Connector; PICOLOCK1.5-04
J2: GPS Coax; U.FL
J3: Low Gain Coax; U.FL
J5: Low Gain +; THT-0.7
J6: Low Gain -; THT-0.7
R1, R11, R12, R13, R14, R15: 0Ω <20mΩ; 1608
R8, R9: 5Ω 1%; THT-15MM
Z1: Balun 1:1; CD542

Connections:
CHASSIS: C4.1, C9.1, C10.1, C11.1, C12.1, C13.1, H1.1, H1.V1, H1.V2, H1.V3, H1.V4, H1.V5, H1.V6, H1.V7, H1.V8, H1.V9, H1.V10, H2.1, H2.V1, H2.V2, H2.V3, H2.V4, H2.V5, H2.V6, H2.V7, H2.V8, H2.V9, H2.V10, H6.1, H6.V1, H6.V2, H6.V3, H6.V4, H6.V5, H6.V6, H6.V7, H6.V8, H6.V9, H6.V10, H7.1, H7.V1, H7.V2, H7.V3, H7.V4, H7.V5, H7.V6, H7.V7, H7.V8, H7.V9, H7.V10, H11.1, H11.V1, H11.V2, H11.V3, H11.V4, H11.V5, H11.V6, H11.V7, H11.V8, H11.V9, H11.V10, H12.1, H12.V1, H12.V2, H12.V3, H12.V4, H12.V5, H12.V6, H12.V7, H12.V8, H12.V9, H12.V10, R1.2, R11.2, R12.2, R13.2, R14.2, R15.2
DEPLOYABLE: J1.1, J1.2, R8.2, R9.2
GPS_COAX: AE1.CENTER, J2.CENTER
LOW_GAIN_COAX: J3.CENTER, Z1.6 (SECONDARY-DOT)
LOW_GAIN_N: J6.1, Z1.3 (PRIMARY)
LOW_GAIN_P: J5.1, Z1.1 (PRIMARY-DOT)
PGND: C4.2, C9.2, C10.2, C11.2, C12.2, C13.2, H4.1, H4.V1, H4.V2, H4.V3, H4.V4, H4.V5, H4.V6, H4.V7, H4.V8, H5.1, H5.V1, H5.V2, H5.V3, H5.V4, H5.V5, H5.V6, H5.V7, H5.V8, J1.4, R1.1, R8.1, R9.1, R11.1, R12.1, R13.1, R14.1, R15.1
RFGND-0: H9.1, H9.V1, H9.V2, H9.V3, H9.V4, H9.V5, H9.V6, H9.V7, H9.V8, H10.1, H10.V1, H10.V2, H10.V3, H10.V4, H10.V5, H10.V6, H10.V7, H10.V8, J3.SHIELD@1 (SHIELD), J3.SHIELD@2 (SHIELD), J3.SHIELD@13 (SHIELD), Z1.4 (SECONDARY)
RFGND-1: AE1.GND (SHIELD), J2.SHIELD@1 (SHIELD), J2.SHIELD@2 (SHIELD), J2.SHIELD@13 (SHIELD)
SENSE: H3.1, H3.V1, H3.V2, H3.V3, H3.V4, H3.V5, H3.V6, H3.V7, H3.V8, H8.1, H8.V1, H8.V2, H8.V3, H8.V4, H8.V5, H8.V6, H8.V7, H8.V8, J1.3

Notes on the sheet:
Note: The low gain antenna wraps around posts in these holes which shorts them together. When deployed, the deploy sense pin will be pulled high by the EPS

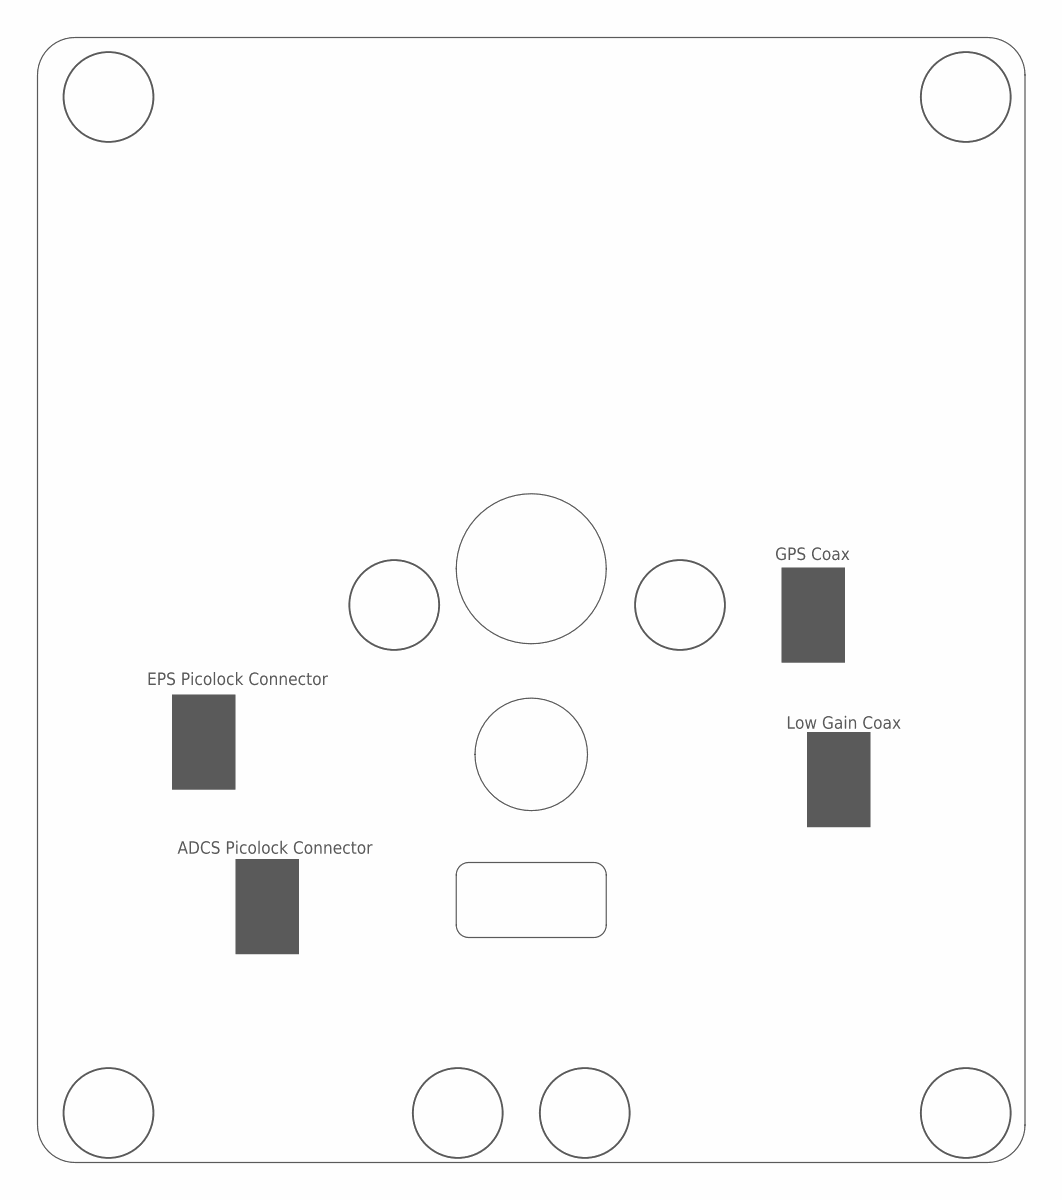
[picture p371: schematic +XPanel.sch, sheet 4]

Notes on the sheet:
ADCS Picolock Connector
EPS Picolock Connector
Low Gain Coax
GPS Coax

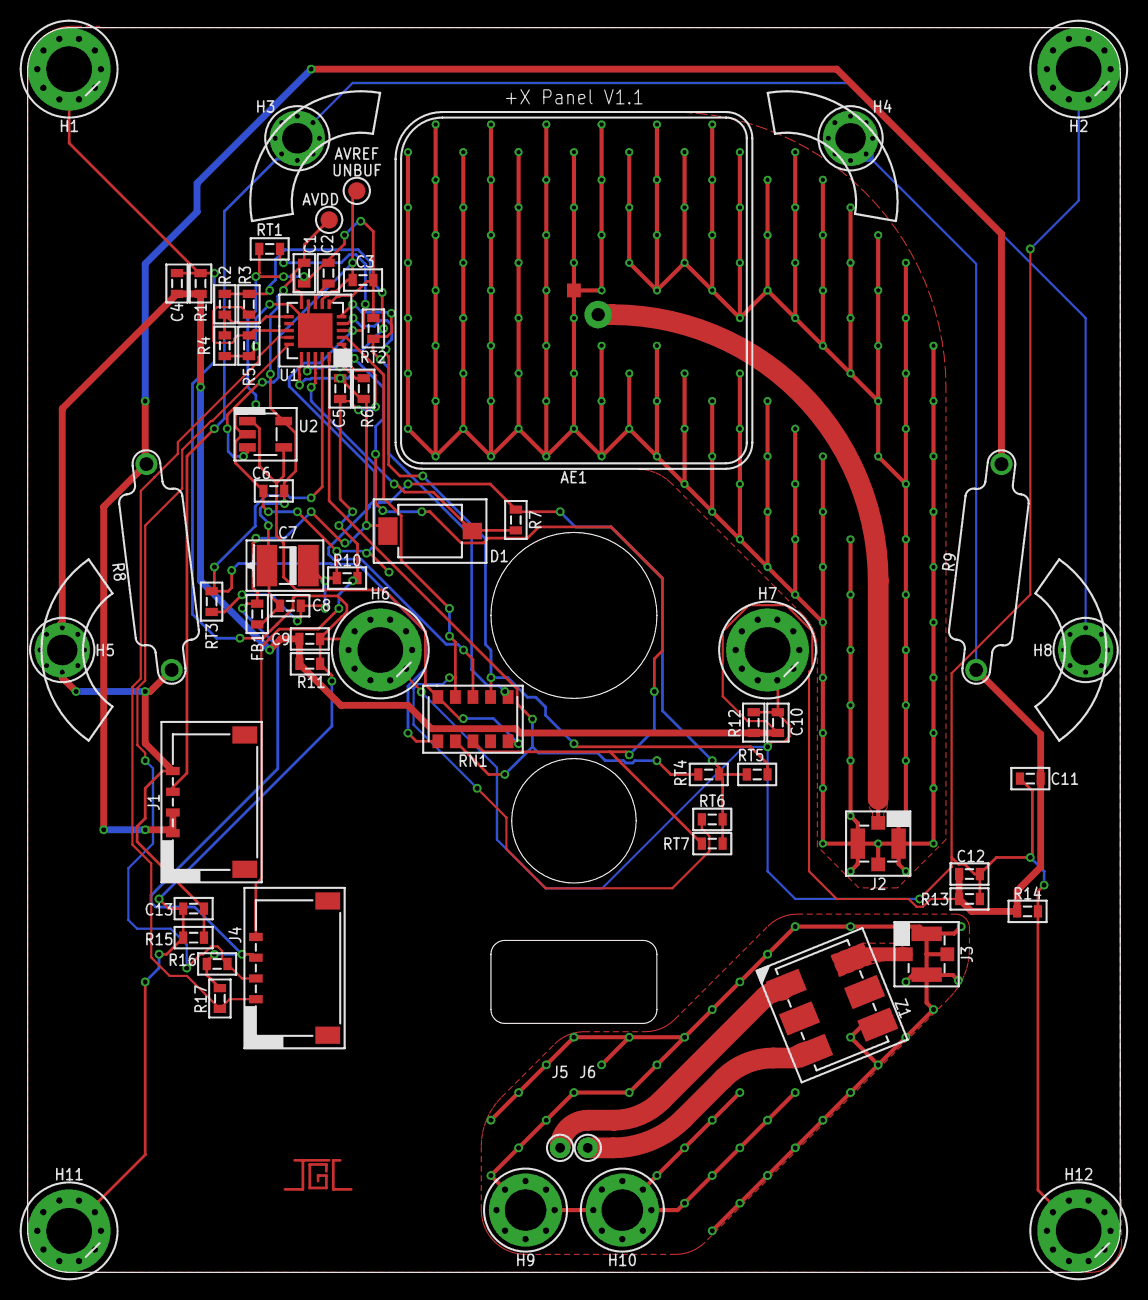
[picture p372: board +XPanel.brd from above]

Board: 2 copper layers, 79.0 x 90.0 mm, 65 parts (0 on the bottom side), 30 nets.
