CougsInSpace/CougSat1-Hardware/CougSat1-RadioBoard/ElectricalDesign/-ZPanel.brd

## EAGLE design CougSat1-RadioBoard/ElectricalDesign/-ZPanel.brd (2020-03-05)

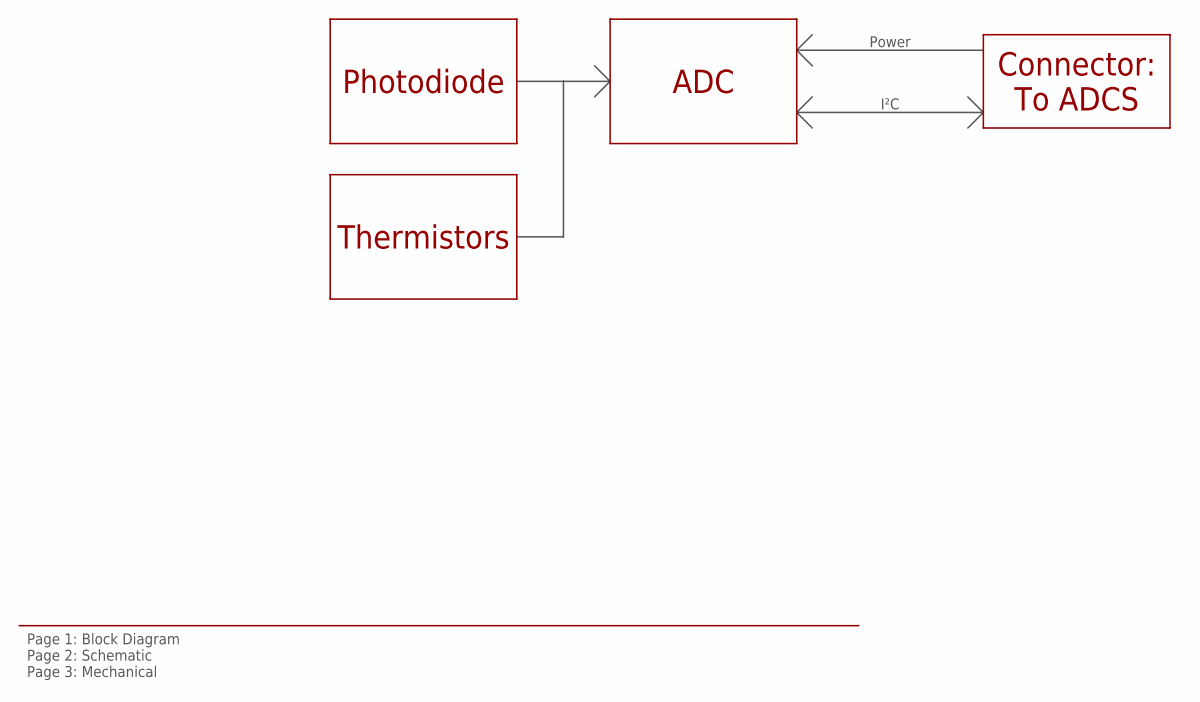
[picture p373: schematic -ZPanel.sch, sheet 1]

Notes on the sheet:
Page 1: Block Diagram Page 2: Schematic Page 3: Mechanical
ADC
Connector: To ADCS
Power
I²C
Photodiode
Thermistors

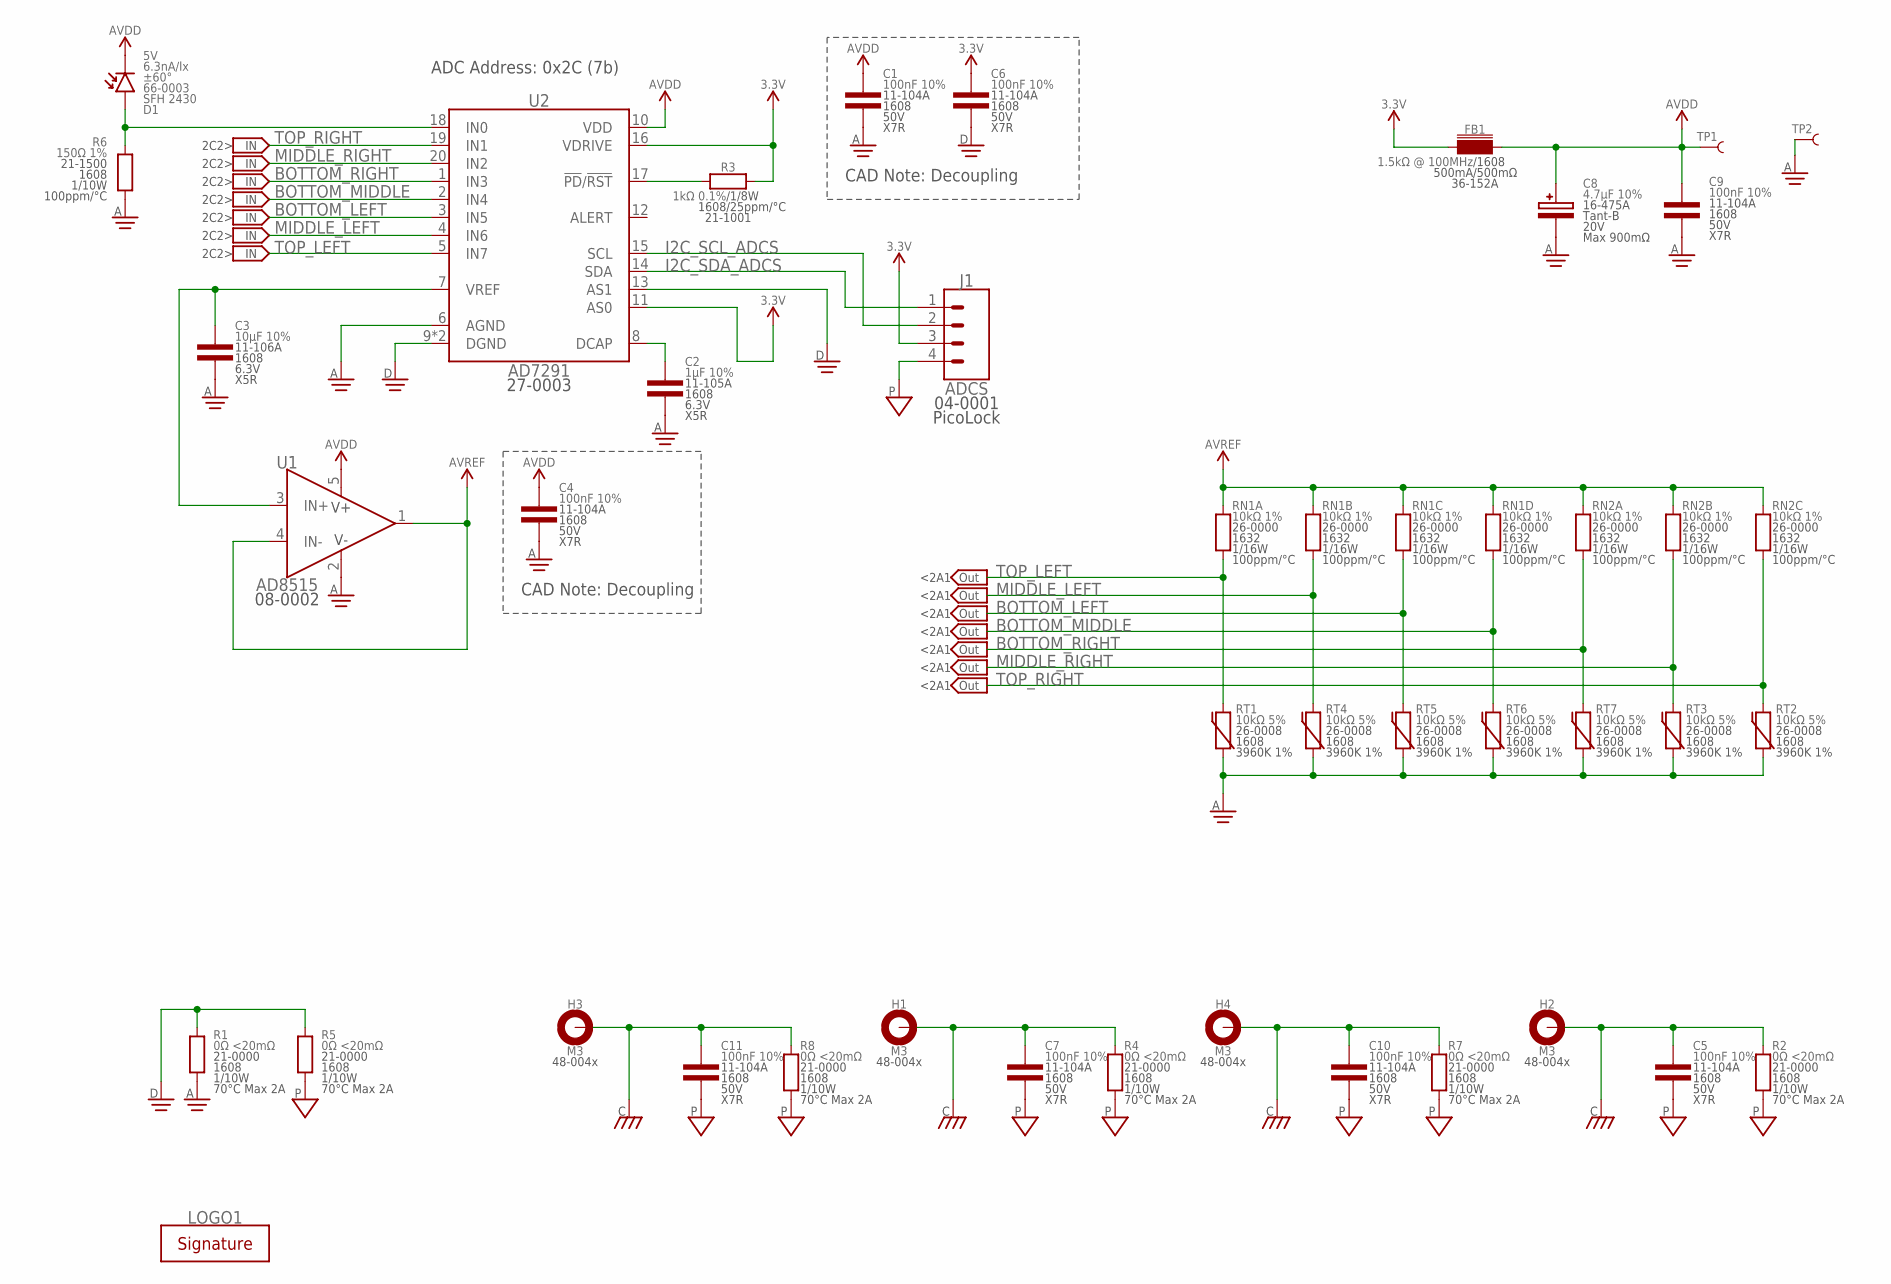
[picture p374: schematic -ZPanel.sch, sheet 2]

Parts:
C1, C4, C5, C6, C7, C9, C10, C11: 100nF 10%; 1608
C2: 1µF 10%; 1608
C3: 10µF 10%; 1608
C8: 4.7µF 10%; 4028-POL
D1: SFH 2430; SFH2430
FB1: 1.5kΩ @ 100MHz; 1608
H1, H2, H3, H4: M3; MOUNTING_HOLE-3.3
J1: ADCS; PICOLOCK1.5-04
LOGO1: SIGNATUREJOSH; SIGN-JOSH
R1, R2, R4, R5, R7, R8: 0Ω <20mΩ; 1608
R3: 1kΩ 0.1%; 1608
R6: 150Ω 1%; 1608
RN1, RN2: 10kΩ 1%; 1632
RT1, RT2, RT3, RT4, RT5, RT6, RT7: 10kΩ 5%; 1608
TP1, TP2: TEST_POINT-THT-0.7; THT-0.7
U1: AD8515; SOT23-5
U2: AD7291; QFN-20-4040

Connections:
3.3V: C6.1, FB1.1, J1.3, R3.2, U2.11 (AS0), U2.16 (VDRIVE)
AGND: C1.2, C2.2, C3.2, C4.2, C8.C, C9.2, R1.1, R6.1, RT1.1, RT2.1, RT3.1, RT4.1, RT5.1, RT6.1, RT7.1, TP2.1, U1.2 (V-), U2.6 (AGND)
AVDD: C1.1, C4.1, C8.A, C9.1, D1.C, FB1.2, TP1.1, U1.5 (V+), U2.10 (VDD)
AVREF: RN1.5 (2), RN1.6 (2), RN1.7 (2), RN1.8 (2), RN2.6 (2), RN2.7 (2), RN2.8 (2), U1.1 (OUT), U1.4 (IN-)
BOTTOM_LEFT: RN1.3 (1), RT5.2, U2.3 (IN5)
BOTTOM_MIDDLE: RN1.4 (1), RT6.2, U2.2 (IN4)
BOTTOM_RIGHT: RN2.1, RT7.2, U2.1 (IN3)
CHASSIS: C5.1, C7.1, C10.1, C11.1, H1.1, H1.V1, H1.V2, H1.V3, H1.V4, H1.V5, H1.V6, H1.V7, H1.V8, H1.V9, H1.V10, H2.1, H2.V1, H2.V2, H2.V3, H2.V4, H2.V5, H2.V6, H2.V7, H2.V8, H2.V9, H2.V10, H3.1, H3.V1, H3.V2, H3.V3, H3.V4, H3.V5, H3.V6, H3.V7, H3.V8, H3.V9, H3.V10, H4.1, H4.V1, H4.V2, H4.V3, H4.V4, H4.V5, H4.V6, H4.V7, H4.V8, H4.V9, H4.V10, R2.2, R4.2, R7.2, R8.2
DCAP: C2.1, U2.8 (DCAP)
DGND: C6.2, R1.2, R5.2, U2.9 (DGND), U2.13 (AS1), U2.PAD (DGND)
I2C_SCL_ADCS: J1.2, U2.15 (SCL)
I2C_SDA_ADCS: J1.1, U2.14 (SDA)
MIDDLE_LEFT: RN1.2 (1), RT4.2, U2.4 (IN6)
MIDDLE_RIGHT: RN2.2 (1), RT3.2, U2.20 (IN2)
PD/RST: R3.1, U2.17 (!PD!/!RST)
PGND: C5.2, C7.2, C10.2, C11.2, J1.4, R2.1, R4.1, R5.1, R7.1, R8.1
PHOTODIODE_ADC: D1.A, R6.2, U2.18 (IN0)
TOP_LEFT: RN1.1, RT1.2, U2.5 (IN7)
TOP_RIGHT: RN2.3 (1), RT2.2, U2.19 (IN1)
VREF: C3.1, U1.3 (IN+), U2.7 (VREF)

Notes on the sheet:
2C2>
<2A1
CAD Note: Decoupling
ADC Address: 0x2C (7b)

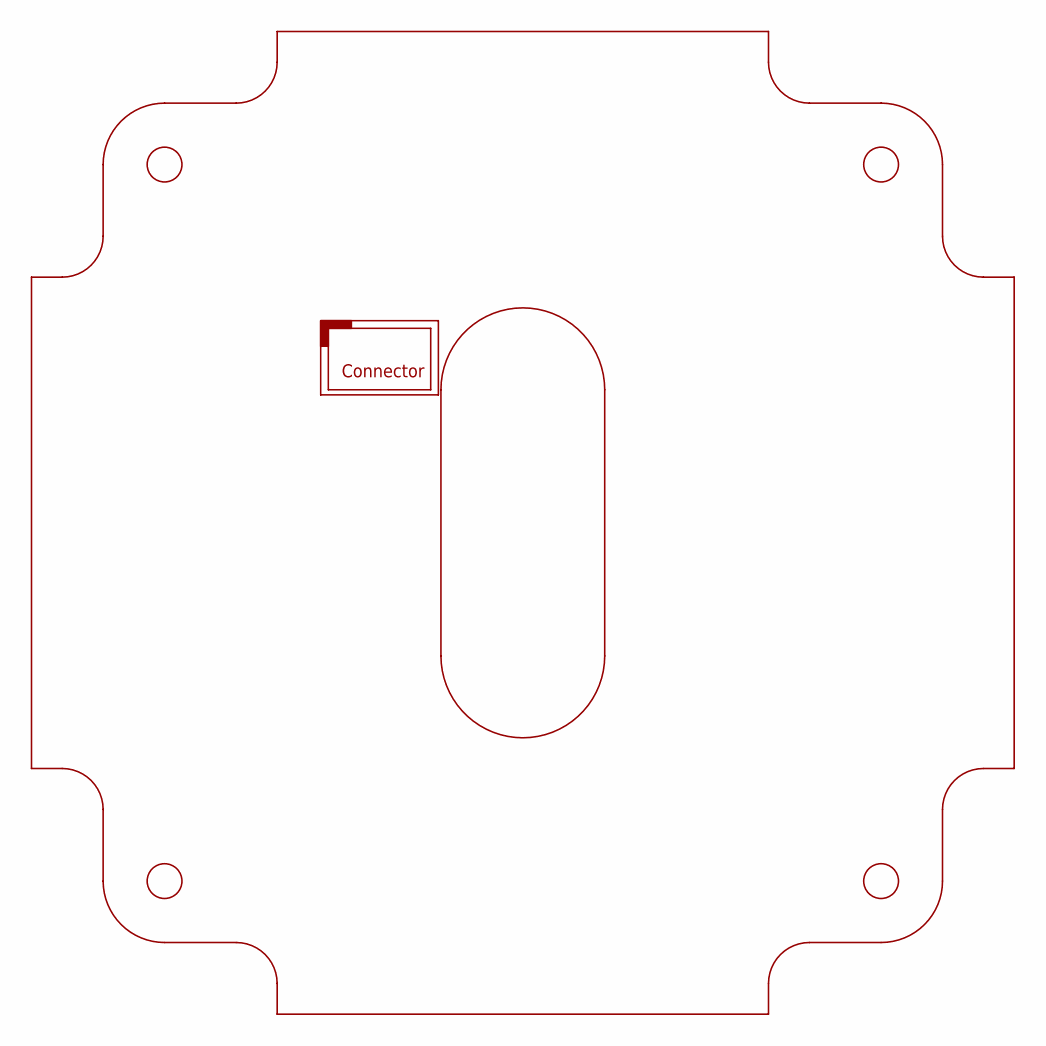
[picture p375: schematic -ZPanel.sch, sheet 3]

Notes on the sheet:
Connector

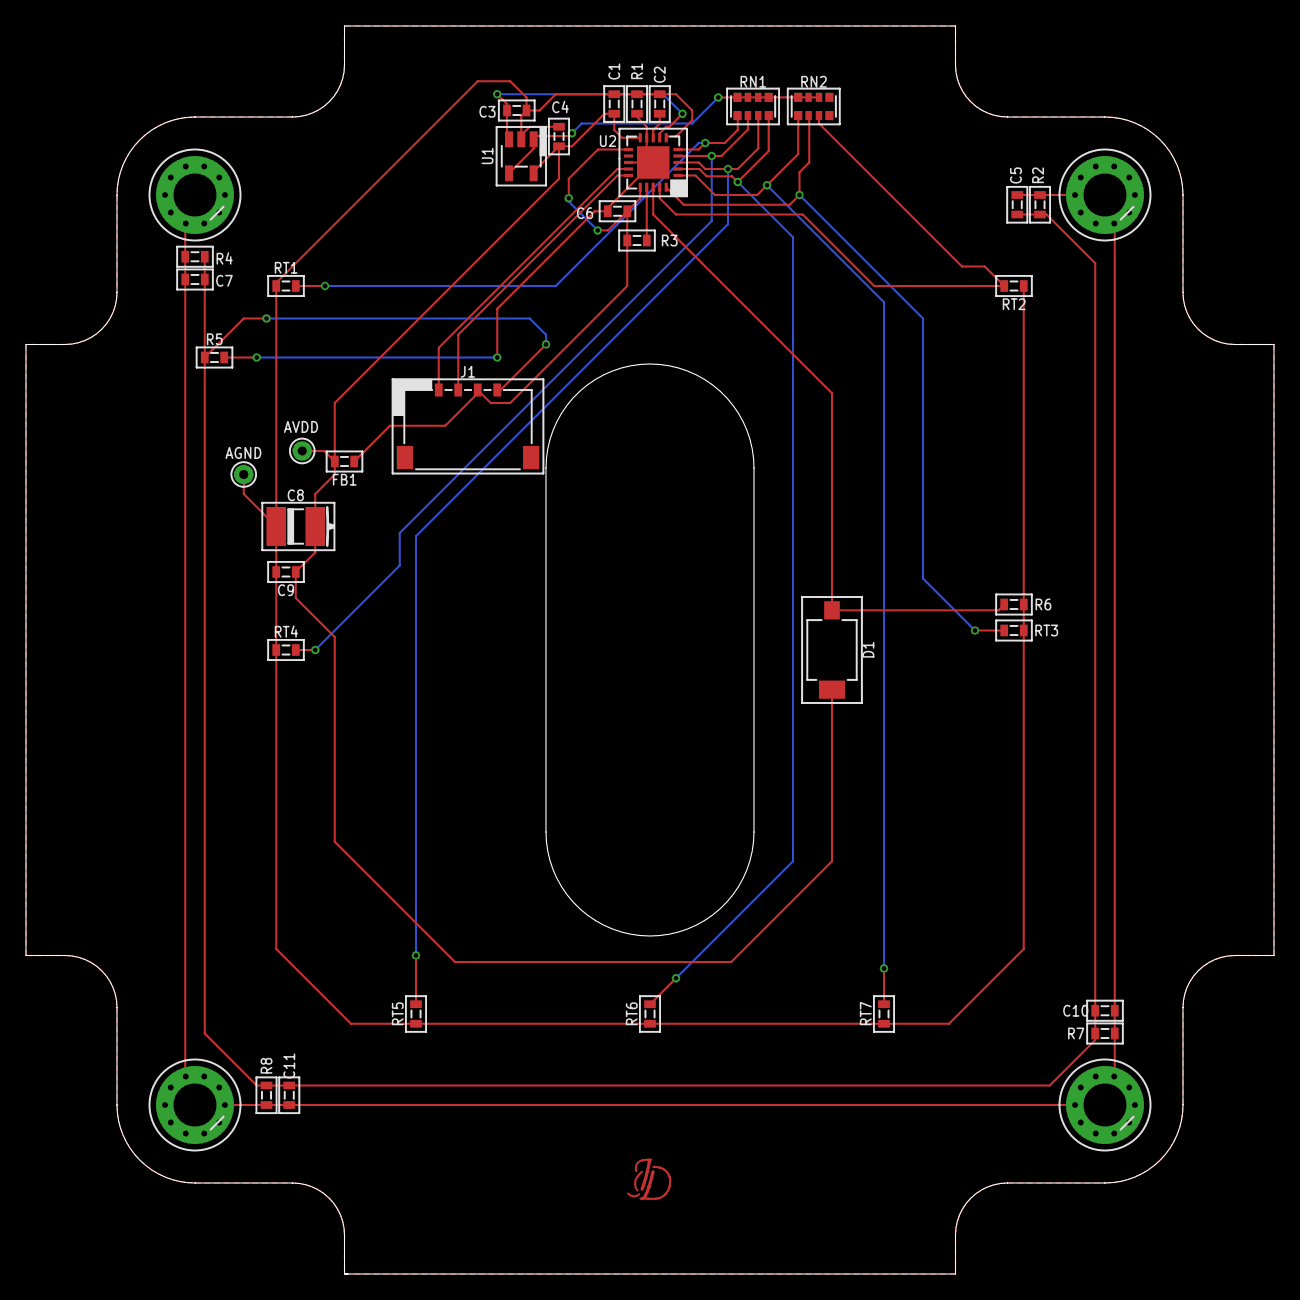
[picture p376: board -ZPanel.brd from above]

Board: 2 copper layers, 96.0 x 96.0 mm, 40 parts (0 on the bottom side), 20 nets.
