CougsInSpace/CougSat1-Hardware/CougSat1-Backplane/ElectricalDesign/Backplane.brd

## EAGLE design CougSat1-Backplane/ElectricalDesign/Backplane.brd (2020-02-19)

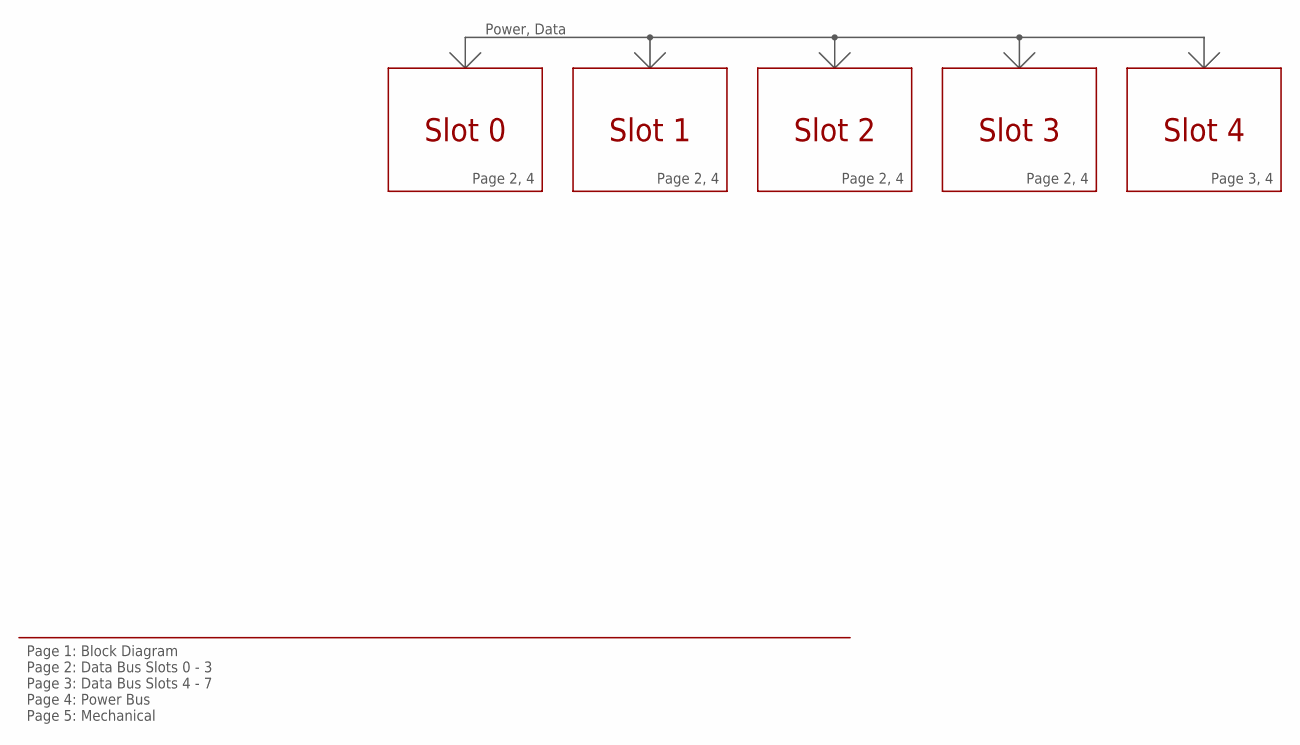
[picture p377: schematic Backplane.sch, sheet 1]

Notes on the sheet:
Slot 0
Slot 1
Slot 2
Slot 3
Slot 4
Page 1: Block Diagram Page 2: Data Bus Slots 0 - 3 Page 3: Data Bus Slots 4 - 7 Page 4: Power Bus Page 5: Mechanical
Page 2, 4
Page 3, 4
Power, Data
