CougsInSpace/CougSat1-Hardware/CougSat1-Backplane/ElectricalDesign/Backplane.brd

## EAGLE design CougSat1-Backplane/ElectricalDesign/Backplane.brd (continued)

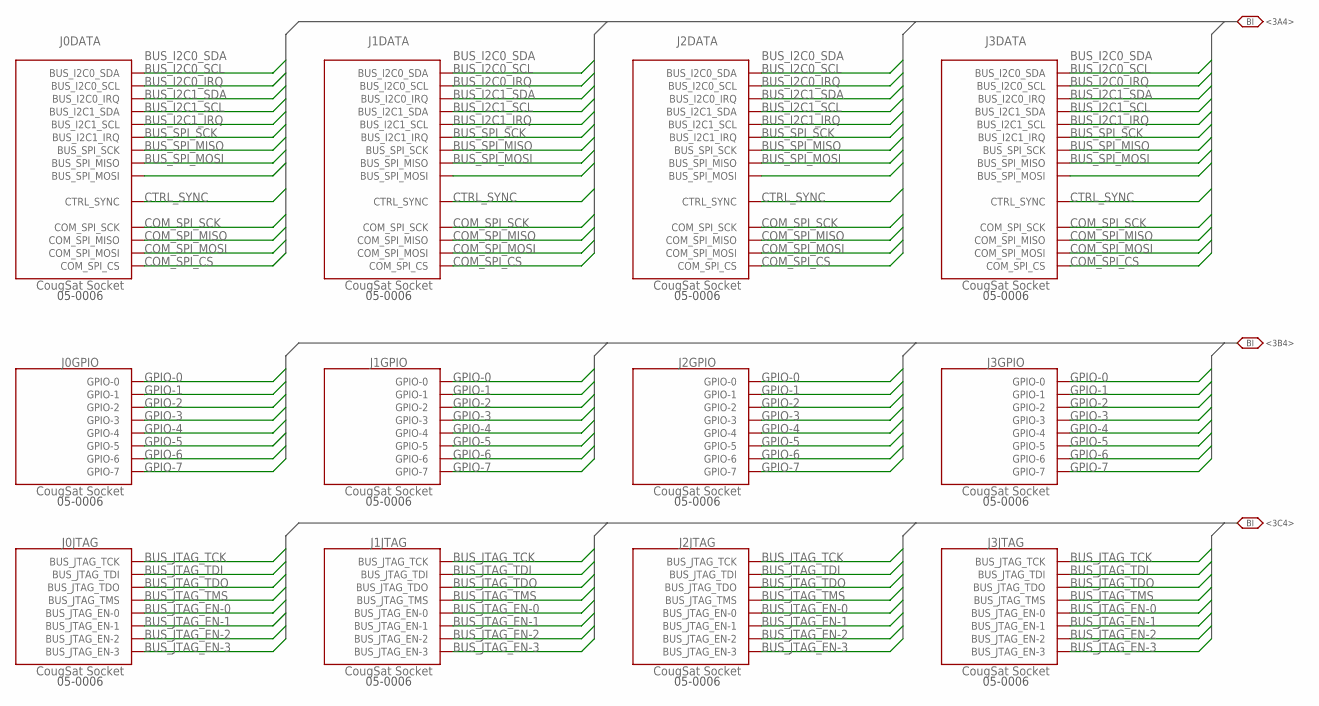
[picture p378: schematic Backplane.sch, sheet 2]

Parts:
J0, J1, J2, J3: CougSat Socket; PCIE-8

Connections:
BUS_I2C0_IRQ: J0.A45 (BUS_I2C0_IRQ), J0.B45 (BUS_I2C0_IRQ), J1.A45 (BUS_I2C0_IRQ), J1.B45 (BUS_I2C0_IRQ), J2.A45 (BUS_I2C0_IRQ), J2.B45 (BUS_I2C0_IRQ), J3.A45 (BUS_I2C0_IRQ), J3.B45 (BUS_I2C0_IRQ); also elsewhere on the board
BUS_I2C0_SCL: J0.A44 (BUS_I2C0_SCL), J0.B44 (BUS_I2C0_SCL), J1.A44 (BUS_I2C0_SCL), J1.B44 (BUS_I2C0_SCL), J2.A44 (BUS_I2C0_SCL), J2.B44 (BUS_I2C0_SCL), J3.A44 (BUS_I2C0_SCL), J3.B44 (BUS_I2C0_SCL); also elsewhere on the board
BUS_I2C0_SDA: J0.A43 (BUS_I2C0_SDA), J0.B43 (BUS_I2C0_SDA), J1.A43 (BUS_I2C0_SDA), J1.B43 (BUS_I2C0_SDA), J2.A43 (BUS_I2C0_SDA), J2.B43 (BUS_I2C0_SDA), J3.A43 (BUS_I2C0_SDA), J3.B43 (BUS_I2C0_SDA); also elsewhere on the board
BUS_I2C1_IRQ: J0.A32 (BUS_I2C1_IRQ), J0.B32 (BUS_I2C1_IRQ), J1.A32 (BUS_I2C1_IRQ), J1.B32 (BUS_I2C1_IRQ), J2.A32 (BUS_I2C1_IRQ), J2.B32 (BUS_I2C1_IRQ), J3.A32 (BUS_I2C1_IRQ), J3.B32 (BUS_I2C1_IRQ); also elsewhere on the board
BUS_I2C1_SCL: J0.A31 (BUS_I2C1_SCL), J0.B31 (BUS_I2C1_SCL), J1.A31 (BUS_I2C1_SCL), J1.B31 (BUS_I2C1_SCL), J2.A31 (BUS_I2C1_SCL), J2.B31 (BUS_I2C1_SCL), J3.A31 (BUS_I2C1_SCL), J3.B31 (BUS_I2C1_SCL); also elsewhere on the board
BUS_I2C1_SDA: J0.A30 (BUS_I2C1_SDA), J0.B30 (BUS_I2C1_SDA), J1.A30 (BUS_I2C1_SDA), J1.B30 (BUS_I2C1_SDA), J2.A30 (BUS_I2C1_SDA), J2.B30 (BUS_I2C1_SDA), J3.A30 (BUS_I2C1_SDA), J3.B30 (BUS_I2C1_SDA); also elsewhere on the board
BUS_JTAG_EN-0: J0.B46 (BUS_JTAG_EN-0), J1.B46 (BUS_JTAG_EN-0), J2.B46 (BUS_JTAG_EN-0), J3.B46 (BUS_JTAG_EN-0); also elsewhere on the board
BUS_JTAG_EN-1: J0.B47 (BUS_JTAG_EN-1), J1.B47 (BUS_JTAG_EN-1), J2.B47 (BUS_JTAG_EN-1), J3.B47 (BUS_JTAG_EN-1); also elsewhere on the board
BUS_JTAG_EN-2: J0.B48 (BUS_JTAG_EN-2), J1.B48 (BUS_JTAG_EN-2), J2.B48 (BUS_JTAG_EN-2), J3.B48 (BUS_JTAG_EN-2); also elsewhere on the board
BUS_JTAG_EN-3: J0.B49 (BUS_JTAG_EN-3), J1.B49 (BUS_JTAG_EN-3), J2.B49 (BUS_JTAG_EN-3), J3.B49 (BUS_JTAG_EN-3); also elsewhere on the board
BUS_JTAG_TCK: J0.A46 (BUS_JTAG_TCK), J1.A46 (BUS_JTAG_TCK), J2.A46 (BUS_JTAG_TCK), J3.A46 (BUS_JTAG_TCK); also elsewhere on the board
BUS_JTAG_TDI: J0.A47 (BUS_JTAG_TDI), J1.A47 (BUS_JTAG_TDI), J2.A47 (BUS_JTAG_TDI), J3.A47 (BUS_JTAG_TDI); also elsewhere on the board
BUS_JTAG_TDO: J0.A48 (BUS_JTAG_TDO), J1.A48 (BUS_JTAG_TDO), J2.A48 (BUS_JTAG_TDO), J3.A48 (BUS_JTAG_TDO); also elsewhere on the board
BUS_JTAG_TMS: J0.A49 (BUS_JTAG_TMS), J1.A49 (BUS_JTAG_TMS), J2.A49 (BUS_JTAG_TMS), J3.A49 (BUS_JTAG_TMS); also elsewhere on the board
BUS_SPI_MISO: J0.A38 (BUS_SPI_MISO), J0.B38 (BUS_SPI_MISO), J1.A38 (BUS_SPI_MISO), J1.B38 (BUS_SPI_MISO), J2.A38 (BUS_SPI_MISO), J2.B38 (BUS_SPI_MISO), J3.A38 (BUS_SPI_MISO), J3.B38 (BUS_SPI_MISO); also elsewhere on the board
BUS_SPI_MOSI: J0.A39 (BUS_SPI_MOSI), J0.B39 (BUS_SPI_MOSI), J1.A39 (BUS_SPI_MOSI), J1.B39 (BUS_SPI_MOSI), J2.A39 (BUS_SPI_MOSI), J2.B39 (BUS_SPI_MOSI), J3.A39 (BUS_SPI_MOSI), J3.B39 (BUS_SPI_MOSI); also elsewhere on the board
BUS_SPI_SCK: J0.A37 (BUS_SPI_SCK), J0.B37 (BUS_SPI_SCK), J1.A37 (BUS_SPI_SCK), J1.B37 (BUS_SPI_SCK), J2.A37 (BUS_SPI_SCK), J2.B37 (BUS_SPI_SCK), J3.A37 (BUS_SPI_SCK), J3.B37 (BUS_SPI_SCK); also elsewhere on the board
COM_SPI_CS: J0.A36 (COM_SPI_CS), J0.B36 (COM_SPI_CS), J1.A36 (COM_SPI_CS), J1.B36 (COM_SPI_CS), J2.A36 (COM_SPI_CS), J2.B36 (COM_SPI_CS), J3.A36 (COM_SPI_CS), J3.B36 (COM_SPI_CS); also elsewhere on the board
COM_SPI_MISO: J0.A34 (COM_SPI_MISO), J0.B34 (COM_SPI_MISO), J1.A34 (COM_SPI_MISO), J1.B34 (COM_SPI_MISO), J2.A34 (COM_SPI_MISO), J2.B34 (COM_SPI_MISO), J3.A34 (COM_SPI_MISO), J3.B34 (COM_SPI_MISO); also elsewhere on the board
COM_SPI_MOSI: J0.A35 (COM_SPI_MOSI), J0.B35 (COM_SPI_MOSI), J1.A35 (COM_SPI_MOSI), J1.B35 (COM_SPI_MOSI), J2.A35 (COM_SPI_MOSI), J2.B35 (COM_SPI_MOSI), J3.A35 (COM_SPI_MOSI), J3.B35 (COM_SPI_MOSI); also elsewhere on the board
COM_SPI_SCK: J0.A33 (COM_SPI_SCK), J0.B33 (COM_SPI_SCK), J1.A33 (COM_SPI_SCK), J1.B33 (COM_SPI_SCK), J2.A33 (COM_SPI_SCK), J2.B33 (COM_SPI_SCK), J3.A33 (COM_SPI_SCK), J3.B33 (COM_SPI_SCK); also elsewhere on the board
CTRL_SYNC: J0.A42 (CTRL_SYNC), J0.B42 (CTRL_SYNC), J1.A42 (CTRL_SYNC), J1.B42 (CTRL_SYNC), J2.A42 (CTRL_SYNC), J2.B42 (CTRL_SYNC), J3.A42 (CTRL_SYNC), J3.B42 (CTRL_SYNC); also elsewhere on the board
GPIO-0: J0.A24 (GPIO-0), J1.A24 (GPIO-0), J2.A24 (GPIO-0), J3.A24 (GPIO-0); also elsewhere on the board
GPIO-1: J0.A25 (GPIO-1), J1.A25 (GPIO-1), J2.A25 (GPIO-1), J3.A25 (GPIO-1); also elsewhere on the board
GPIO-2: J0.A26 (GPIO-2), J1.A26 (GPIO-2), J2.A26 (GPIO-2), J3.A26 (GPIO-2); also elsewhere on the board
GPIO-3: J0.A27 (GPIO-3), J1.A27 (GPIO-3), J2.A27 (GPIO-3), J3.A27 (GPIO-3); also elsewhere on the board
GPIO-4: J0.A28 (GPIO-4), J1.A28 (GPIO-4), J2.A28 (GPIO-4), J3.A28 (GPIO-4); also elsewhere on the board
GPIO-5: J0.A29 (GPIO-5), J1.A29 (GPIO-5), J2.A29 (GPIO-5), J3.A29 (GPIO-5); also elsewhere on the board
GPIO-6: J0.A41 (GPIO-6), J1.A41 (GPIO-6), J2.A41 (GPIO-6), J3.A41 (GPIO-6); also elsewhere on the board
GPIO-7: J0.B41 (GPIO-7), J1.B41 (GPIO-7), J2.B41 (GPIO-7), J3.B41 (GPIO-7); also elsewhere on the board

Notes on the sheet:
<3A4>
<3B4>
<3C4>

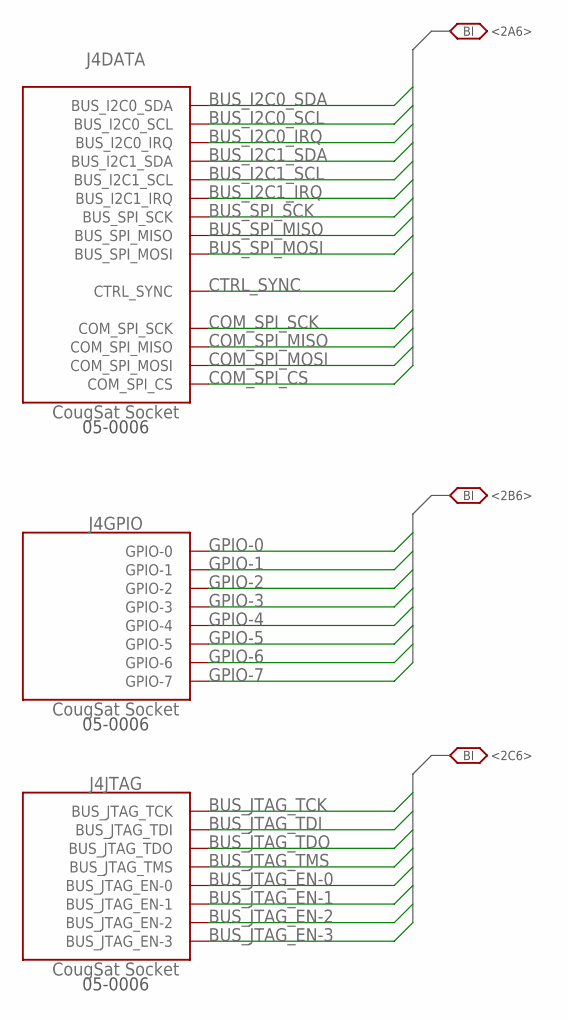
[picture p379: schematic Backplane.sch, sheet 3]

Parts:
J4: CougSat Socket; PCIE-8

Connections:
BUS_I2C0_IRQ: J4.A45 (BUS_I2C0_IRQ), J4.B45 (BUS_I2C0_IRQ); also elsewhere on the board
BUS_I2C0_SCL: J4.A44 (BUS_I2C0_SCL), J4.B44 (BUS_I2C0_SCL); also elsewhere on the board
BUS_I2C0_SDA: J4.A43 (BUS_I2C0_SDA), J4.B43 (BUS_I2C0_SDA); also elsewhere on the board
BUS_I2C1_IRQ: J4.A32 (BUS_I2C1_IRQ), J4.B32 (BUS_I2C1_IRQ); also elsewhere on the board
BUS_I2C1_SCL: J4.A31 (BUS_I2C1_SCL), J4.B31 (BUS_I2C1_SCL); also elsewhere on the board
BUS_I2C1_SDA: J4.A30 (BUS_I2C1_SDA), J4.B30 (BUS_I2C1_SDA); also elsewhere on the board
BUS_JTAG_EN-0: J4.B46 (BUS_JTAG_EN-0); also elsewhere on the board
BUS_JTAG_EN-1: J4.B47 (BUS_JTAG_EN-1); also elsewhere on the board
BUS_JTAG_EN-2: J4.B48 (BUS_JTAG_EN-2); also elsewhere on the board
BUS_JTAG_EN-3: J4.B49 (BUS_JTAG_EN-3); also elsewhere on the board
BUS_JTAG_TCK: J4.A46 (BUS_JTAG_TCK); also elsewhere on the board
BUS_JTAG_TDI: J4.A47 (BUS_JTAG_TDI); also elsewhere on the board
BUS_JTAG_TDO: J4.A48 (BUS_JTAG_TDO); also elsewhere on the board
BUS_JTAG_TMS: J4.A49 (BUS_JTAG_TMS); also elsewhere on the board
BUS_SPI_MISO: J4.A38 (BUS_SPI_MISO), J4.B38 (BUS_SPI_MISO); also elsewhere on the board
BUS_SPI_MOSI: J4.A39 (BUS_SPI_MOSI), J4.B39 (BUS_SPI_MOSI); also elsewhere on the board
BUS_SPI_SCK: J4.A37 (BUS_SPI_SCK), J4.B37 (BUS_SPI_SCK); also elsewhere on the board
COM_SPI_CS: J4.A36 (COM_SPI_CS), J4.B36 (COM_SPI_CS); also elsewhere on the board
COM_SPI_MISO: J4.A34 (COM_SPI_MISO), J4.B34 (COM_SPI_MISO); also elsewhere on the board
COM_SPI_MOSI: J4.A35 (COM_SPI_MOSI), J4.B35 (COM_SPI_MOSI); also elsewhere on the board
COM_SPI_SCK: J4.A33 (COM_SPI_SCK), J4.B33 (COM_SPI_SCK); also elsewhere on the board
CTRL_SYNC: J4.A42 (CTRL_SYNC), J4.B42 (CTRL_SYNC); also elsewhere on the board
GPIO-0: J4.A24 (GPIO-0); also elsewhere on the board
GPIO-1: J4.A25 (GPIO-1); also elsewhere on the board
GPIO-2: J4.A26 (GPIO-2); also elsewhere on the board
GPIO-3: J4.A27 (GPIO-3); also elsewhere on the board
GPIO-4: J4.A28 (GPIO-4); also elsewhere on the board
GPIO-5: J4.A29 (GPIO-5); also elsewhere on the board
GPIO-6: J4.A41 (GPIO-6); also elsewhere on the board
GPIO-7: J4.B41 (GPIO-7); also elsewhere on the board

Notes on the sheet:
<2A6>
<2B6>
<2C6>

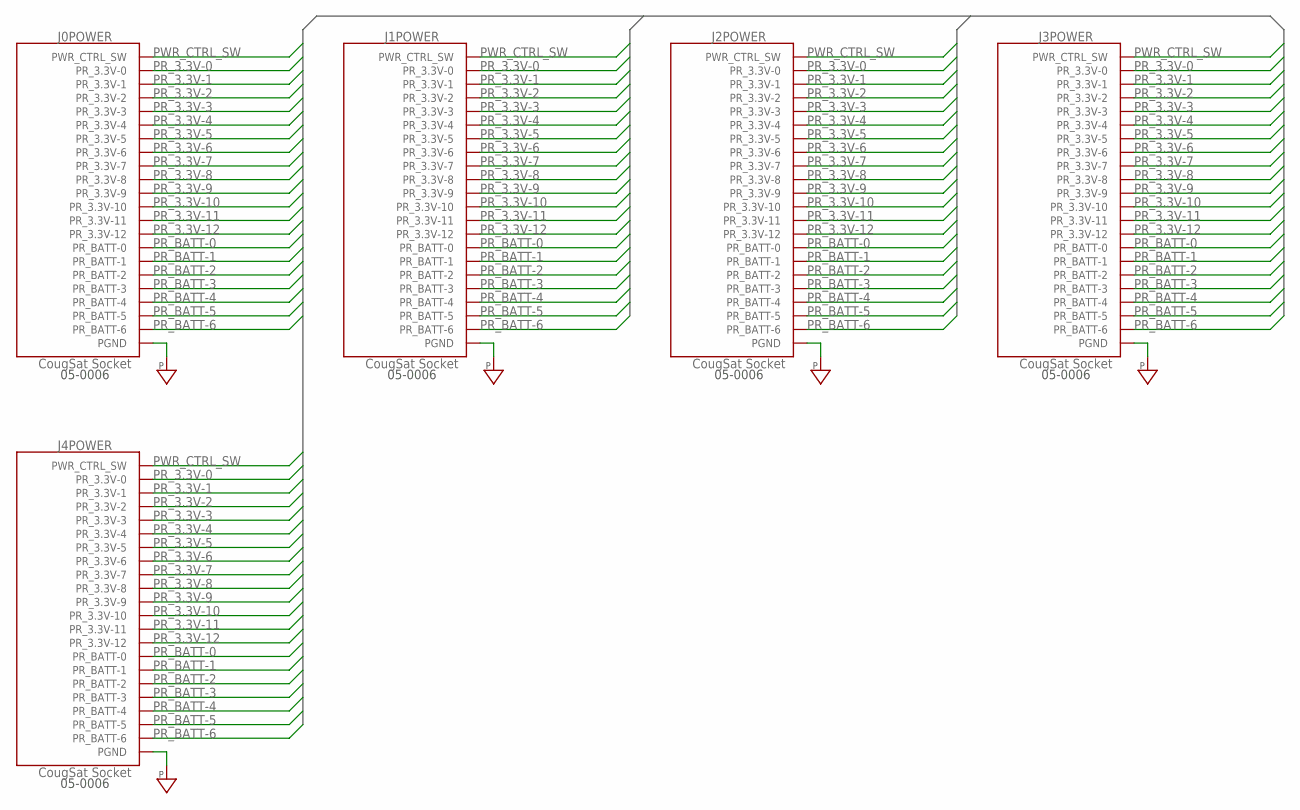
[picture p380: schematic Backplane.sch, sheet 4]

Parts:
J0, J1, J2, J3, J4: CougSat Socket; PCIE-8

Connections:
PGND: J0.A21 (PGND), J0.A22 (PGND), J0.A23 (PGND), J0.B21 (PGND), J0.B22 (PGND), J0.B23 (PGND), J0.B24 (PGND), J0.B25 (PGND), J0.B26 (PGND), J0.B27 (PGND), J0.B28 (PGND), J0.B29 (PGND), J1.A21 (PGND), J1.A22 (PGND), J1.A23 (PGND), J1.B21 (PGND), J1.B22 (PGND), J1.B23 (PGND), J1.B24 (PGND), J1.B25 (PGND), J1.B26 (PGND), J1.B27 (PGND), J1.B28 (PGND), J1.B29 (PGND), J2.A21 (PGND), J2.A22 (PGND), J2.A23 (PGND), J2.B21 (PGND), J2.B22 (PGND), J2.B23 (PGND), J2.B24 (PGND), J2.B25 (PGND), J2.B26 (PGND), J2.B27 (PGND), J2.B28 (PGND), J2.B29 (PGND), J3.A21 (PGND), J3.A22 (PGND), J3.A23 (PGND), J3.B21 (PGND), J3.B22 (PGND), J3.B23 (PGND), J3.B24 (PGND), J3.B25 (PGND), J3.B26 (PGND), J3.B27 (PGND), J3.B28 (PGND), J3.B29 (PGND), J4.A21 (PGND), J4.A22 (PGND), J4.A23 (PGND), J4.B21 (PGND), J4.B22 (PGND), J4.B23 (PGND), J4.B24 (PGND), J4.B25 (PGND), J4.B26 (PGND), J4.B27 (PGND), J4.B28 (PGND), J4.B29 (PGND); also elsewhere on the board
PR_3.3V-0: J0.A1 (PR_3.3V-0), J0.B1 (PR_3.3V-0), J1.A1 (PR_3.3V-0), J1.B1 (PR_3.3V-0), J2.A1 (PR_3.3V-0), J2.B1 (PR_3.3V-0), J3.A1 (PR_3.3V-0), J3.B1 (PR_3.3V-0), J4.A1 (PR_3.3V-0), J4.B1 (PR_3.3V-0)
PR_3.3V-1: J0.A2 (PR_3.3V-1), J0.B2 (PR_3.3V-1), J1.A2 (PR_3.3V-1), J1.B2 (PR_3.3V-1), J2.A2 (PR_3.3V-1), J2.B2 (PR_3.3V-1), J3.A2 (PR_3.3V-1), J3.B2 (PR_3.3V-1), J4.A2 (PR_3.3V-1), J4.B2 (PR_3.3V-1)
PR_3.3V-2: J0.A3 (PR_3.3V-2), J0.B3 (PR_3.3V-2), J1.A3 (PR_3.3V-2), J1.B3 (PR_3.3V-2), J2.A3 (PR_3.3V-2), J2.B3 (PR_3.3V-2), J3.A3 (PR_3.3V-2), J3.B3 (PR_3.3V-2), J4.A3 (PR_3.3V-2), J4.B3 (PR_3.3V-2)
PR_3.3V-3: J0.A4 (PR_3.3V-3), J0.B4 (PR_3.3V-3), J1.A4 (PR_3.3V-3), J1.B4 (PR_3.3V-3), J2.A4 (PR_3.3V-3), J2.B4 (PR_3.3V-3), J3.A4 (PR_3.3V-3), J3.B4 (PR_3.3V-3), J4.A4 (PR_3.3V-3), J4.B4 (PR_3.3V-3)
PR_3.3V-4: J0.A5 (PR_3.3V-4), J0.B5 (PR_3.3V-4), J1.A5 (PR_3.3V-4), J1.B5 (PR_3.3V-4), J2.A5 (PR_3.3V-4), J2.B5 (PR_3.3V-4), J3.A5 (PR_3.3V-4), J3.B5 (PR_3.3V-4), J4.A5 (PR_3.3V-4), J4.B5 (PR_3.3V-4)
PR_3.3V-5: J0.A6 (PR_3.3V-5), J0.B6 (PR_3.3V-5), J1.A6 (PR_3.3V-5), J1.B6 (PR_3.3V-5), J2.A6 (PR_3.3V-5), J2.B6 (PR_3.3V-5), J3.A6 (PR_3.3V-5), J3.B6 (PR_3.3V-5), J4.A6 (PR_3.3V-5), J4.B6 (PR_3.3V-5)
PR_3.3V-6: J0.A7 (PR_3.3V-6), J0.B7 (PR_3.3V-6), J1.A7 (PR_3.3V-6), J1.B7 (PR_3.3V-6), J2.A7 (PR_3.3V-6), J2.B7 (PR_3.3V-6), J3.A7 (PR_3.3V-6), J3.B7 (PR_3.3V-6), J4.A7 (PR_3.3V-6), J4.B7 (PR_3.3V-6)
PR_3.3V-7: J0.A8 (PR_3.3V-7), J0.B8 (PR_3.3V-7), J1.A8 (PR_3.3V-7), J1.B8 (PR_3.3V-7), J2.A8 (PR_3.3V-7), J2.B8 (PR_3.3V-7), J3.A8 (PR_3.3V-7), J3.B8 (PR_3.3V-7), J4.A8 (PR_3.3V-7), J4.B8 (PR_3.3V-7)
PR_3.3V-8: J0.A9 (PR_3.3V-8), J0.B9 (PR_3.3V-8), J1.A9 (PR_3.3V-8), J1.B9 (PR_3.3V-8), J2.A9 (PR_3.3V-8), J2.B9 (PR_3.3V-8), J3.A9 (PR_3.3V-8), J3.B9 (PR_3.3V-8), J4.A9 (PR_3.3V-8), J4.B9 (PR_3.3V-8)
PR_3.3V-9: J0.A10 (PR_3.3V-9), J0.B10 (PR_3.3V-9), J1.A10 (PR_3.3V-9), J1.B10 (PR_3.3V-9), J2.A10 (PR_3.3V-9), J2.B10 (PR_3.3V-9), J3.A10 (PR_3.3V-9), J3.B10 (PR_3.3V-9), J4.A10 (PR_3.3V-9), J4.B10 (PR_3.3V-9)
PR_3.3V-10: J0.A11 (PR_3.3V-10), J0.B11 (PR_3.3V-10), J1.A11 (PR_3.3V-10), J1.B11 (PR_3.3V-10), J2.A11 (PR_3.3V-10), J2.B11 (PR_3.3V-10), J3.A11 (PR_3.3V-10), J3.B11 (PR_3.3V-10), J4.A11 (PR_3.3V-10), J4.B11 (PR_3.3V-10)
PR_3.3V-11: J0.A12 (PR_3.3V-11), J0.B12 (PR_3.3V-11), J1.A12 (PR_3.3V-11), J1.B12 (PR_3.3V-11), J2.A12 (PR_3.3V-11), J2.B12 (PR_3.3V-11), J3.A12 (PR_3.3V-11), J3.B12 (PR_3.3V-11), J4.A12 (PR_3.3V-11), J4.B12 (PR_3.3V-11)
PR_3.3V-12: J0.A13 (PR_3.3V-12), J0.B13 (PR_3.3V-12), J1.A13 (PR_3.3V-12), J1.B13 (PR_3.3V-12), J2.A13 (PR_3.3V-12), J2.B13 (PR_3.3V-12), J3.A13 (PR_3.3V-12), J3.B13 (PR_3.3V-12), J4.A13 (PR_3.3V-12), J4.B13 (PR_3.3V-12)
PR_BATT-0: J0.A14 (PR_BATT-0), J0.B14 (PR_BATT-0), J1.A14 (PR_BATT-0), J1.B14 (PR_BATT-0), J2.A14 (PR_BATT-0), J2.B14 (PR_BATT-0), J3.A14 (PR_BATT-0), J3.B14 (PR_BATT-0), J4.A14 (PR_BATT-0), J4.B14 (PR_BATT-0)
PR_BATT-1: J0.A15 (PR_BATT-1), J0.B15 (PR_BATT-1), J1.A15 (PR_BATT-1), J1.B15 (PR_BATT-1), J2.A15 (PR_BATT-1), J2.B15 (PR_BATT-1), J3.A15 (PR_BATT-1), J3.B15 (PR_BATT-1), J4.A15 (PR_BATT-1), J4.B15 (PR_BATT-1)
PR_BATT-2: J0.A16 (PR_BATT-2), J0.B16 (PR_BATT-2), J1.A16 (PR_BATT-2), J1.B16 (PR_BATT-2), J2.A16 (PR_BATT-2), J2.B16 (PR_BATT-2), J3.A16 (PR_BATT-2), J3.B16 (PR_BATT-2), J4.A16 (PR_BATT-2), J4.B16 (PR_BATT-2)
PR_BATT-3: J0.A17 (PR_BATT-3), J0.B17 (PR_BATT-3), J1.A17 (PR_BATT-3), J1.B17 (PR_BATT-3), J2.A17 (PR_BATT-3), J2.B17 (PR_BATT-3), J3.A17 (PR_BATT-3), J3.B17 (PR_BATT-3), J4.A17 (PR_BATT-3), J4.B17 (PR_BATT-3)
PR_BATT-4: J0.A18 (PR_BATT-4), J0.B18 (PR_BATT-4), J1.A18 (PR_BATT-4), J1.B18 (PR_BATT-4), J2.A18 (PR_BATT-4), J2.B18 (PR_BATT-4), J3.A18 (PR_BATT-4), J3.B18 (PR_BATT-4), J4.A18 (PR_BATT-4), J4.B18 (PR_BATT-4)
PR_BATT-5: J0.A19 (PR_BATT-5), J0.B19 (PR_BATT-5), J1.A19 (PR_BATT-5), J1.B19 (PR_BATT-5), J2.A19 (PR_BATT-5), J2.B19 (PR_BATT-5), J3.A19 (PR_BATT-5), J3.B19 (PR_BATT-5), J4.A19 (PR_BATT-5), J4.B19 (PR_BATT-5)
PR_BATT-6: J0.A20 (PR_BATT-6), J0.B20 (PR_BATT-6), J1.A20 (PR_BATT-6), J1.B20 (PR_BATT-6), J2.A20 (PR_BATT-6), J2.B20 (PR_BATT-6), J3.A20 (PR_BATT-6), J3.B20 (PR_BATT-6), J4.A20 (PR_BATT-6), J4.B20 (PR_BATT-6)
PWR_CTRL_SW: J0.A40 (PWR_CTRL_SW), J0.B40 (PWR_CTRL_SW), J1.A40 (PWR_CTRL_SW), J1.B40 (PWR_CTRL_SW), J2.A40 (PWR_CTRL_SW), J2.B40 (PWR_CTRL_SW), J3.A40 (PWR_CTRL_SW), J3.B40 (PWR_CTRL_SW), J4.A40 (PWR_CTRL_SW), J4.B40 (PWR_CTRL_SW)

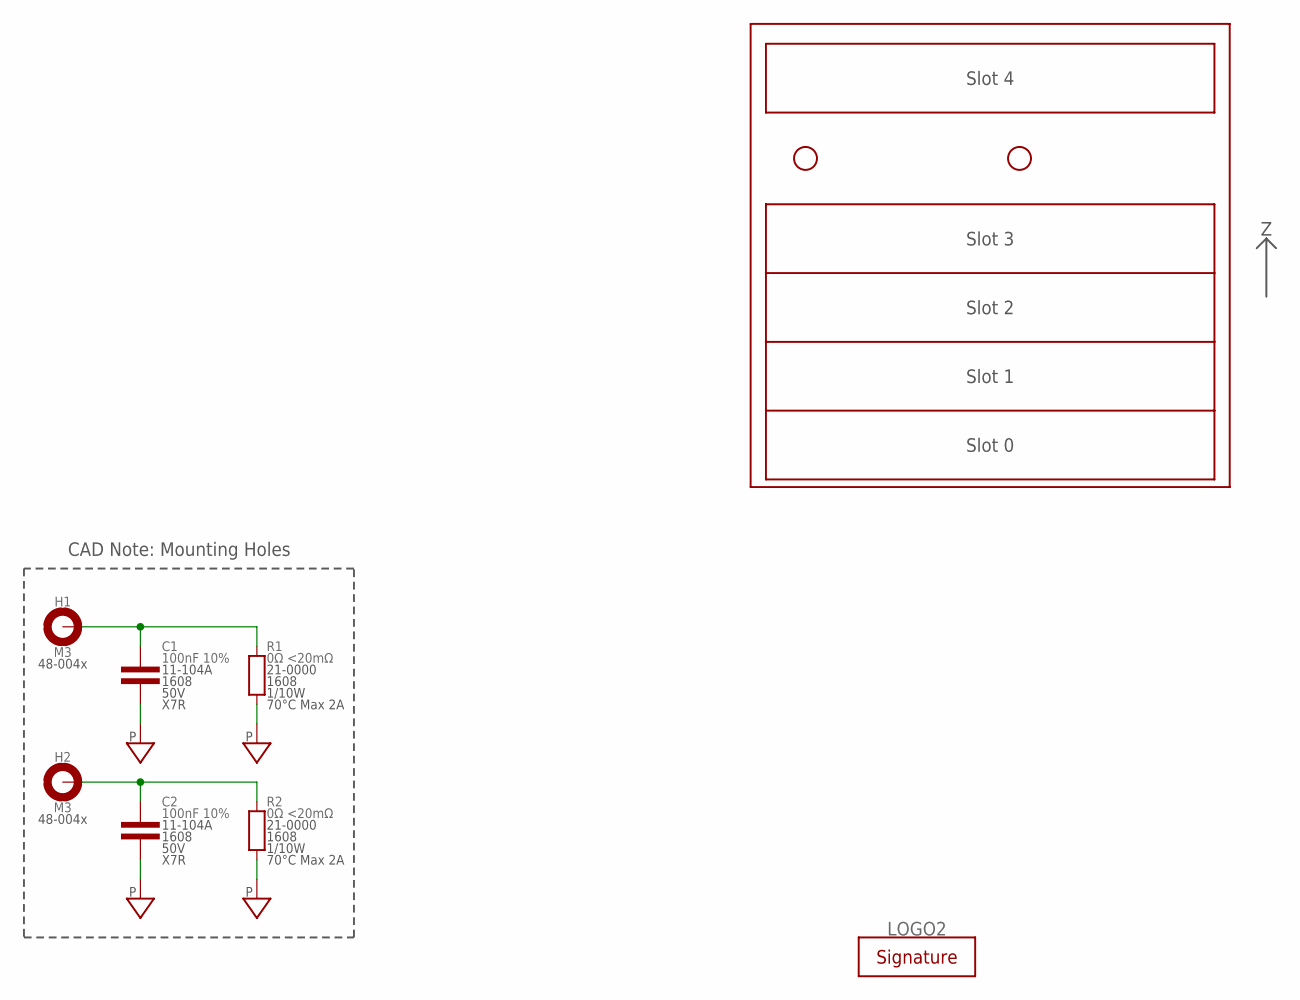
[picture p381: schematic Backplane.sch, sheet 5]

Parts:
C1, C2: 100nF 10%; 1608
H1, H2: M3; MOUNTING_HOLE-3.3
LOGO2: SIGNATUREHENDRIK; SIGN-HENDRIK
R1, R2: 0Ω <20mΩ; 1608

Connections:
CHASSIS1: C1.1, H1.1, H1.V1, H1.V2, H1.V3, H1.V4, H1.V5, H1.V6, H1.V7, H1.V8, H1.V9, H1.V10, R1.2
CHASSIS2: C2.1, H2.1, H2.V1, H2.V2, H2.V3, H2.V4, H2.V5, H2.V6, H2.V7, H2.V8, H2.V9, H2.V10, R2.2
PGND: C1.2, C2.2, R1.1, R2.1; also elsewhere on the board

Notes on the sheet:
CAD Note: Mounting Holes
Slot 0
Slot 1
Slot 2
Slot 3
Slot 4

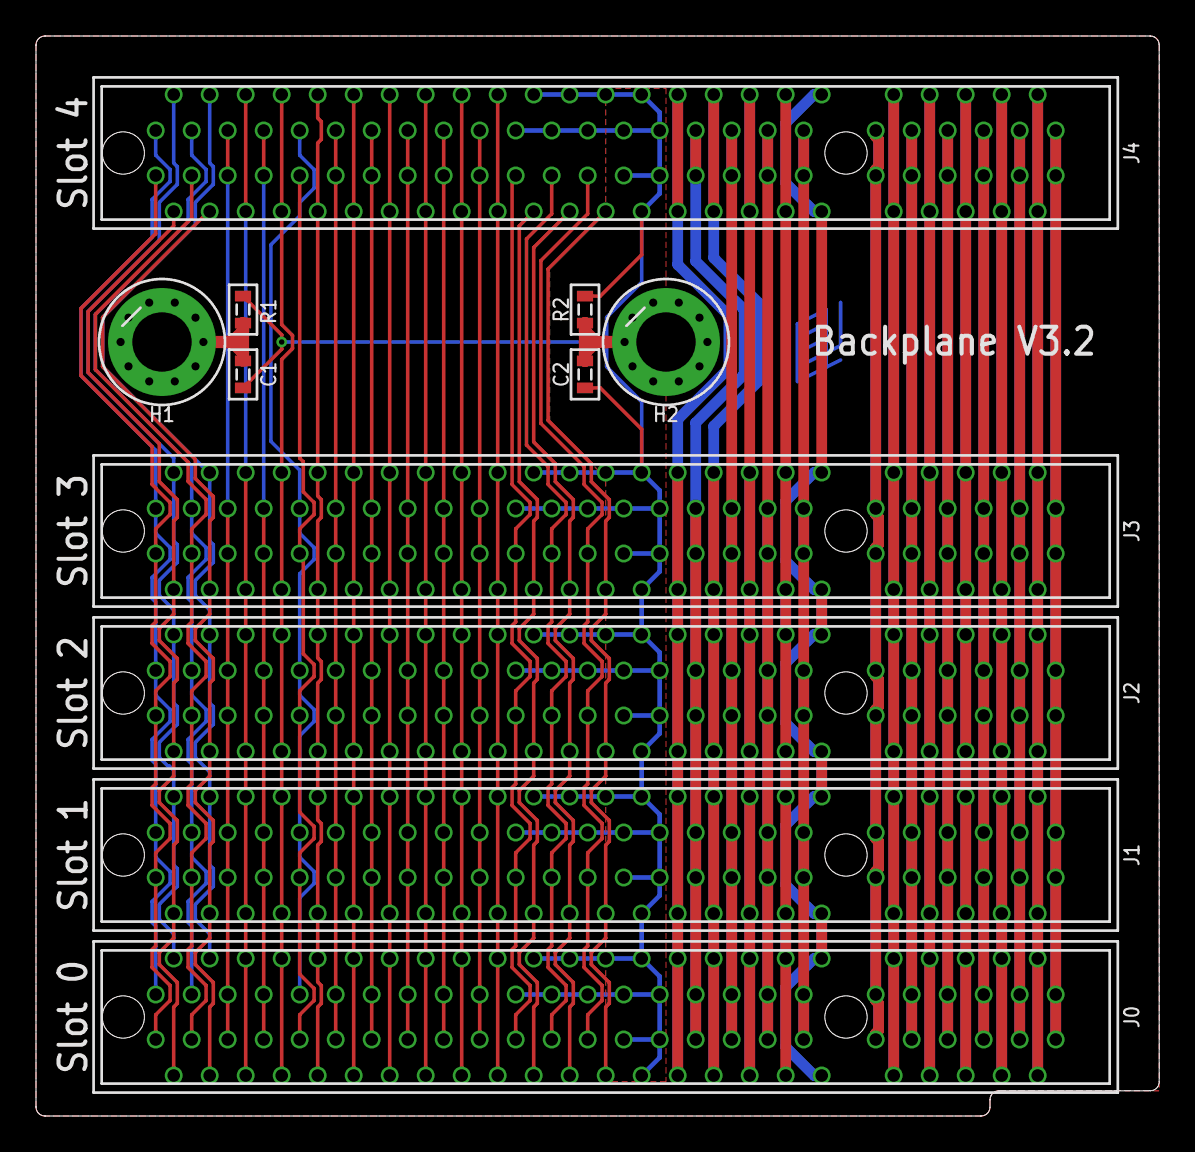
[picture p382: board Backplane.brd from above]

Board: 2 copper layers, 62.4 x 60.0 mm, 12 parts (1 on the bottom side), 54 nets.
