CougsInSpace/CougSat1-Hardware/CougSat1-PowerBoard/ElectricalDesign/SolarPanel.brd

## EAGLE design CougSat1-PowerBoard/ElectricalDesign/SolarPanel.brd (2020-02-16)

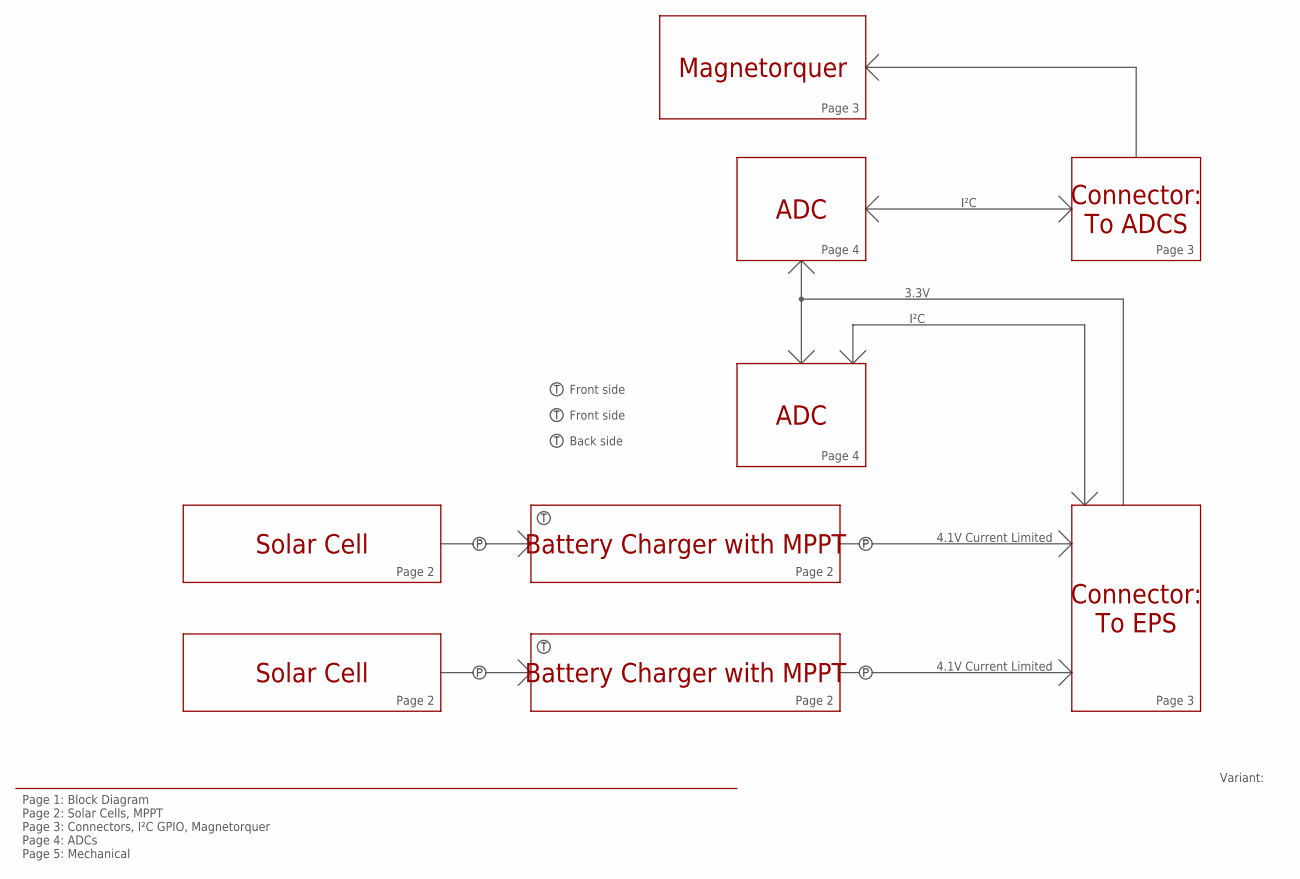
[picture p383: schematic SolarPanel.sch, sheet 1]

Notes on the sheet:
Solar Cell
Battery Charger with MPPT
Connector: To EPS
ADC
4.1V Current Limited
3.3V
I²C
Page 2
Page 3
Page 4
Page 1: Block Diagram Page 2: Solar Cells, MPPT Page 3: Connectors, I²C GPIO, Magnetorquer Page 4: ADCs Page 5: Mechanical
Magnetorquer
Front side
Back side
Connector: To ADCS
Variant:

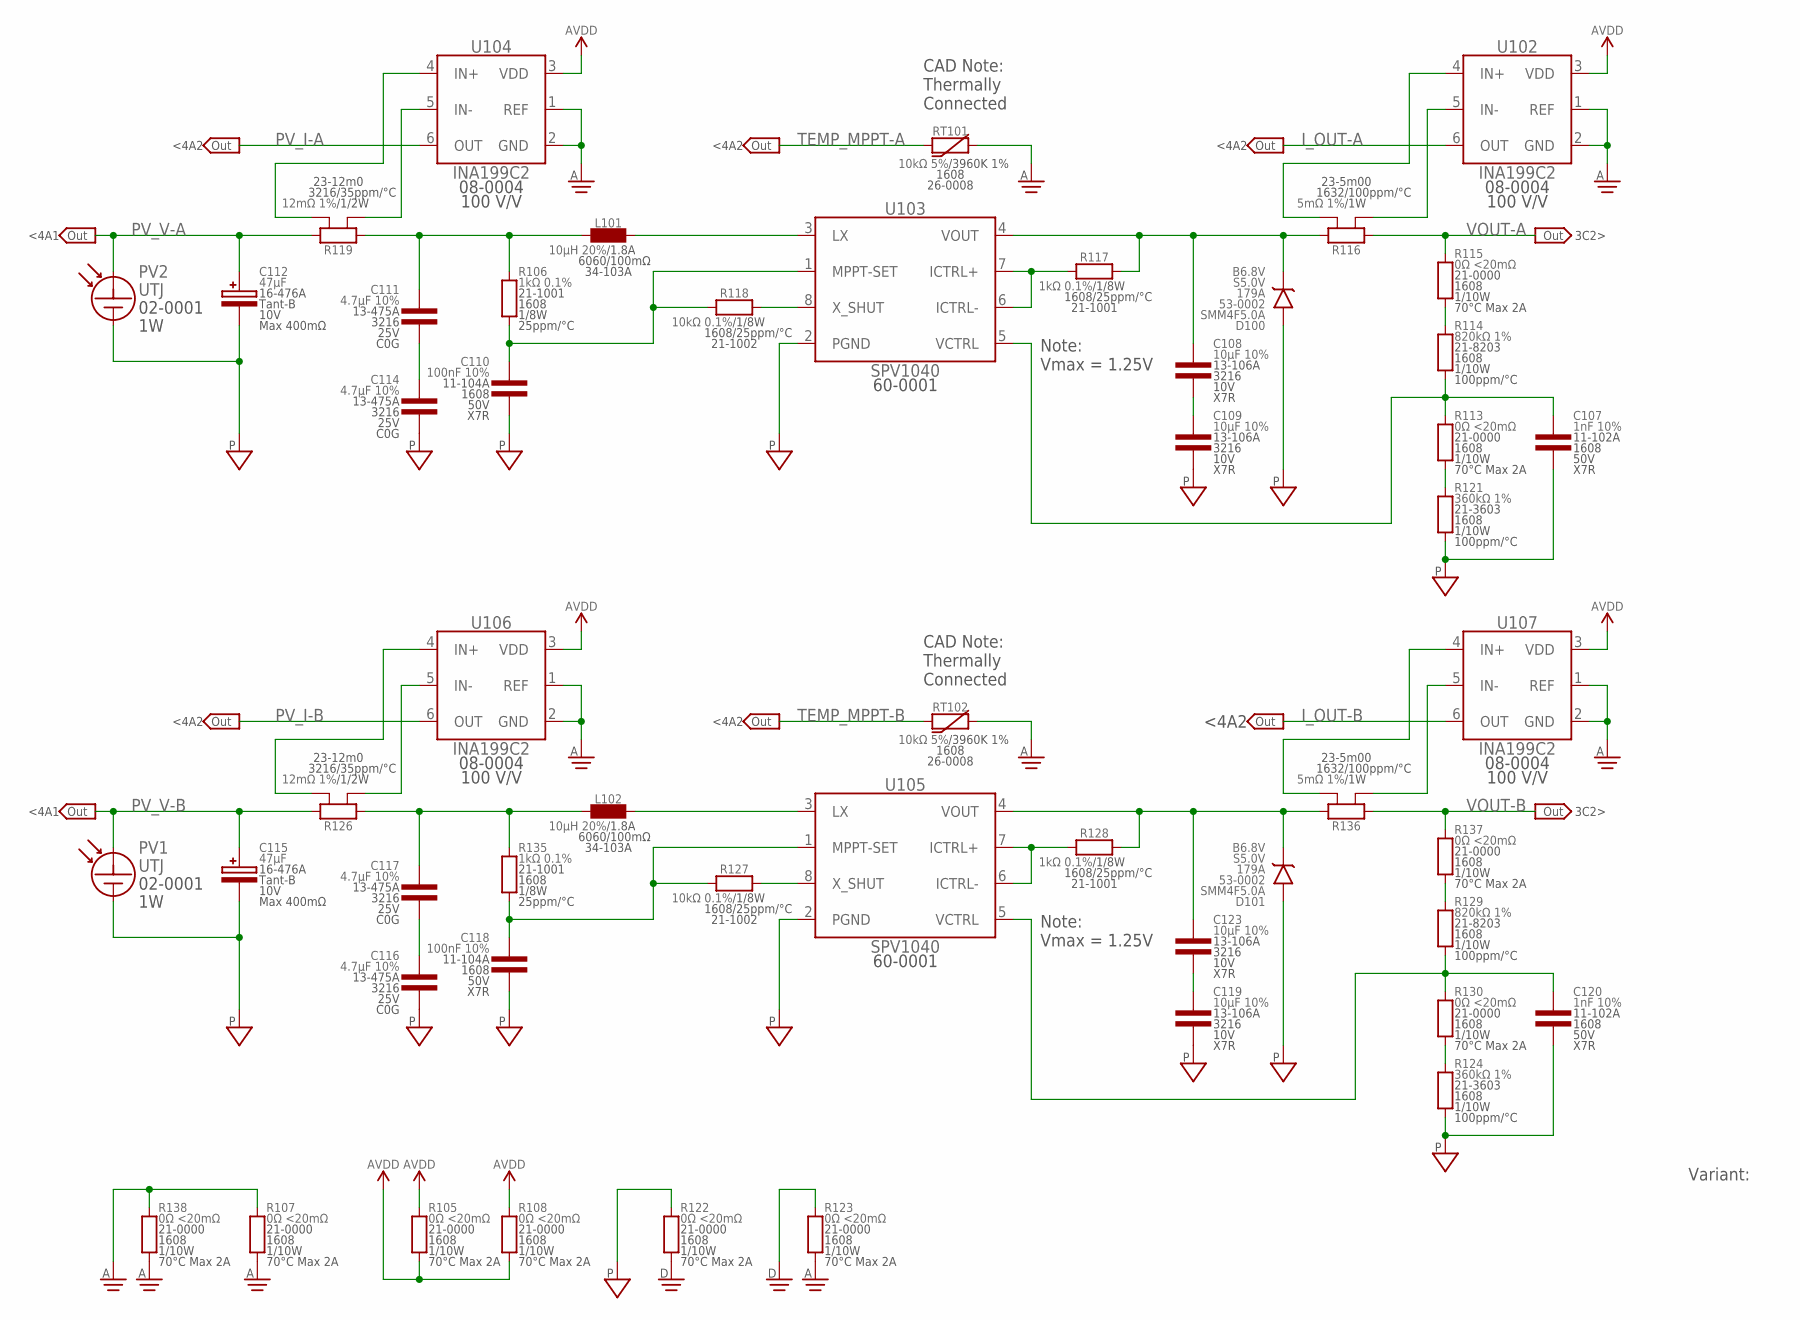
[picture p384: schematic SolarPanel.sch, sheet 2]

Parts:
C107, C120: 1nF 10%; 1608
C108, C109, C119, C123: 10µF 10%; 3216
C110, C118: 100nF 10%; 1608
C111, C114, C116, C117: 4.7µF 10%; 3216
C112, C115: 47µF; 4028-POL
D100, D101: SMM4F5.0A; STMITE
L101, L102: 10µH 20%; 6060
PV1, PV2: UTJ; SPECTROLABS-UTJ
R105, R107, R108, R113, R115, R122, R123, R130, R137, R138: 0Ω <20mΩ; 1608
R106, R117, R128, R135: 1kΩ 0.1%; 1608
R114, R129: 820kΩ 1%; 1608
R116, R136: 5mΩ 1%; 1632-KELVIN
R118, R127: 10kΩ 0.1%; 1608
R119, R126: 12mΩ 1%; 3216-KELVIN
R121, R124: 360kΩ 1%; 1608
RT101, RT102: 10kΩ 5%; 1608
U102, U104, U106, U107: INA199C2; SOT363
U103, U105: SPV1040; TSSOP8

Connections:
AGND: R107.1, R107.2, R123.1, R138.1, R138.2, RT101.2, RT102.2, U102.1 (REF), U102.2 (GND), U104.1 (REF), U104.2 (GND), U106.1 (REF), U106.2 (GND), U107.1 (REF), U107.2 (GND); also elsewhere on the board
AVDD: R105.1, R105.2, R108.1, R108.2, U102.3 (VDD), U104.3 (VDD), U106.3 (VDD), U107.3 (VDD); also elsewhere on the board
DGND: R122.1, R123.2; also elsewhere on the board
I_OUT-A: U102.6 (OUT); also elsewhere on the board
I_OUT-B: U107.6 (OUT); also elsewhere on the board
MPPT_FBRES_HIGH-A: R114.2, R115.1
MPPT_FBRES_HIGH-B: R129.2, R137.1
MPPT_FBRES_LOW-A: R113.1, R121.2
MPPT_FBRES_LOW-B: R124.2, R130.1
MPPT_ICTRL-A: R117.1, U103.6 (ICTRL-), U103.7 (ICTRL+)
MPPT_ICTRL-B: R128.1, U105.6 (ICTRL-), U105.7 (ICTRL+)
MPPT_LX-A: L101.2, U103.3 (LX)
MPPT_LX-B: L102.2, U105.3 (LX)
MPPT_OUTCAP-A: C108.2, C109.1
MPPT_OUTCAP-B: C119.1, C123.2
MPPT_SET-A: C110.1, R106.1, R118.1, U103.1 (MPPT-SET)
MPPT_SET-B: C118.1, R127.1, R135.1, U105.1 (MPPT-SET)
MPPT_VCTRL-A: C107.1, R113.2, R114.1, U103.5 (VCTRL)
MPPT_VCTRL-B: C120.1, R129.1, R130.2, U105.5 (VCTRL)
MPPT_VOUT-A: C108.1, D100.C, R116.1, R117.2, U103.4 (VOUT)
MPPT_VOUT-B: C123.1, D101.C, R128.2, R136.1, U105.4 (VOUT)
OUTPUT_CAP-A: C111.2, C114.1
OUTPUT_CAP-B: C116.1, C117.2
PGND: C107.2, C109.2, C110.2, C112.C, C114.2, C115.C, C116.2, C118.2, C119.2, C120.2, D100.A, D101.A, PV1.VSS@1 (A), PV1.VSS@2 (A), PV1.VSS@3 (A), PV2.VSS@1 (A), PV2.VSS@2 (A), PV2.VSS@3 (A), R121.1, R122.2, R124.1, U103.2 (PGND), U105.2 (PGND); also elsewhere on the board
PV_I-A: U104.6 (OUT); also elsewhere on the board
PV_I-B: U106.6 (OUT); also elsewhere on the board
PV_IIN_N-A: C111.1, L101.1, R106.2, R119.2
PV_IIN_N-B: C117.1, L102.1, R126.2, R135.2
PV_I_N-A: R119.2-KELVIN, U104.5 (IN-)
PV_I_N-B: R126.2-KELVIN, U106.5 (IN-)
PV_I_P-A: R119.1-KELVIN, U104.4 (IN+)
PV_I_P-B: R126.1-KELVIN, U106.4 (IN+)
PV_V-A: C112.A, PV2.VCC@1 (C), PV2.VCC@2 (C), PV2.VCC@3 (C), PV2.VCC@4 (C), R119.1; also elsewhere on the board
PV_V-B: C115.A, PV1.VCC@1 (C), PV1.VCC@2 (C), PV1.VCC@3 (C), PV1.VCC@4 (C), R126.1; also elsewhere on the board
TEMP_MPPT-A: RT101.1; also elsewhere on the board
TEMP_MPPT-B: RT102.1; also elsewhere on the board
VOUT-A: R115.2, R116.2; also elsewhere on the board
VOUT-B: R136.2, R137.2; also elsewhere on the board
VOUT_N-A: R116.2-KELVIN, U102.5 (IN-)
VOUT_N-B: R136.2-KELVIN, U107.5 (IN-)
VOUT_P-A: R116.1-KELVIN, U102.4 (IN+)
VOUT_P-B: R136.1-KELVIN, U107.4 (IN+)
X_SHUT-A: R118.2, U103.8 (X_SHUT)
X_SHUT-B: R127.2, U105.8 (X_SHUT)

Notes on the sheet:
Note: Vmax = 1.25V
3C2>
<4A2
CAD Note: Thermally Connected
Variant:
<4A1

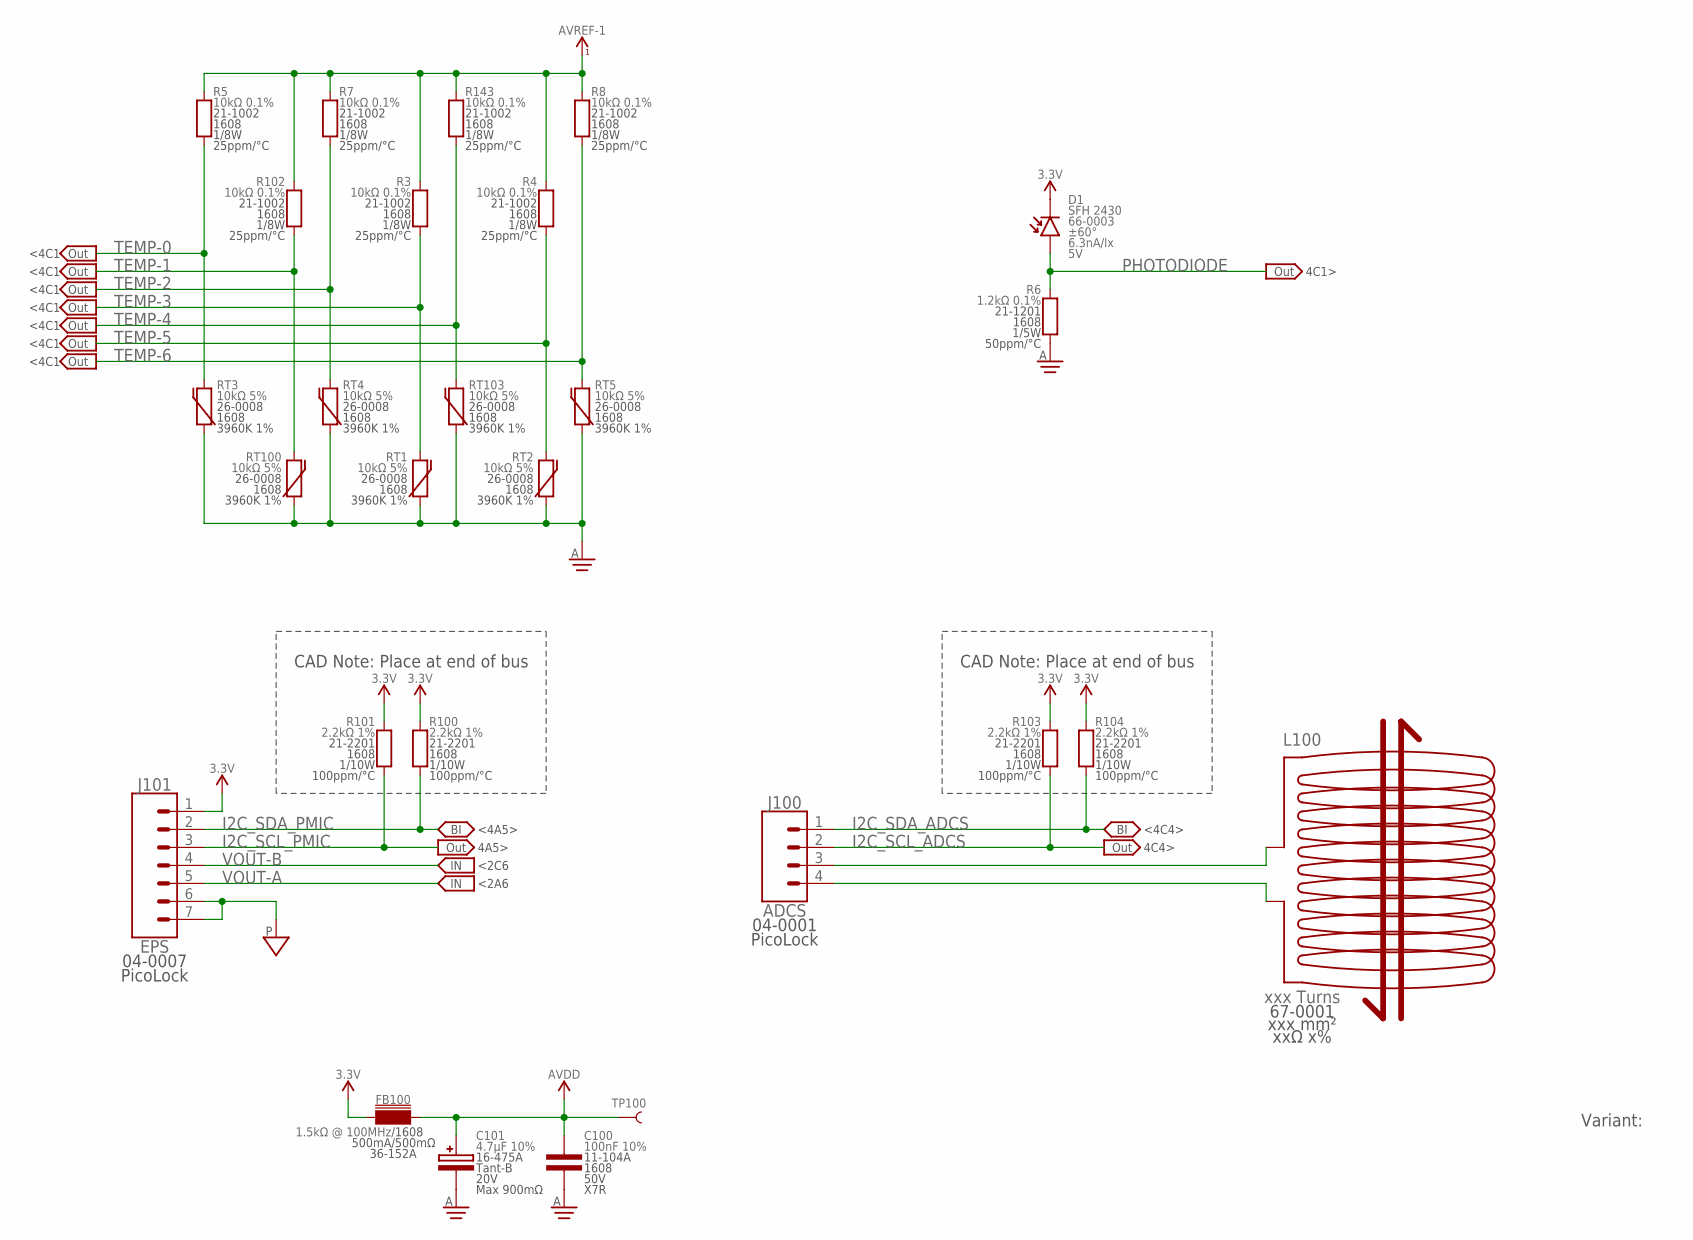
[picture p385: schematic SolarPanel.sch, sheet 3]

Parts:
C100: 100nF 10%; 1608
C101: 4.7µF 10%; 4028-POL
D1: SFH 2430; SFH2430
FB100: 1.5kΩ @ 100MHz; 1608
J100: ADCS; PICOLOCK1.5-04
J101: EPS; PICOLOCK1.5-07
L100: xxx Turns; SMD-3030-2
R3, R4, R5, R7, R8, R102, R143: 10kΩ 0.1%; 1608
R6: 1.2kΩ 0.1%; 1608
R100, R101, R103, R104: 2.2kΩ 1%; 1608
RT1, RT2, RT3, RT4, RT5, RT100, RT103: 10kΩ 5%; 1608
TP100: TEST_POINT-SMD-C-1.25; SMD-C-1.25

Connections:
3.3V: D1.C, FB100.1, J101.1, R100.2, R101.2, R103.2, R104.2; also elsewhere on the board
AGND: C100.2, C101.C, R6.1, RT1.1, RT2.1, RT3.1, RT4.1, RT5.1, RT100.1, RT103.1; also elsewhere on the board
AVDD: C100.1, C101.A, FB100.2, TP100.1; also elsewhere on the board
AVREF-1: R3.2, R4.2, R5.2, R7.2, R8.2, R102.2, R143.2; also elsewhere on the board
I2C_SCL_ADCS: J100.2, R103.1; also elsewhere on the board
I2C_SCL_PMIC: J101.3, R101.1; also elsewhere on the board
I2C_SDA_ADCS: J100.1, R104.1; also elsewhere on the board
I2C_SDA_PMIC: J101.2, R100.1; also elsewhere on the board
MAGNETORQUER-IN: J100.3, L100.1
MAGNETORQUER_OUT: J100.4, L100.2
PGND: J101.6, J101.7; also elsewhere on the board
PHOTODIODE: D1.A, R6.2; also elsewhere on the board
TEMP-0: R5.1, RT3.2; also elsewhere on the board
TEMP-1: R102.1, RT100.2; also elsewhere on the board
TEMP-2: R7.1, RT4.2; also elsewhere on the board
TEMP-3: R3.1, RT1.2; also elsewhere on the board
TEMP-4: R143.1, RT103.2; also elsewhere on the board
TEMP-5: R4.1, RT2.2; also elsewhere on the board
TEMP-6: R8.1, RT5.2; also elsewhere on the board
VOUT-A: J101.5; also elsewhere on the board
VOUT-B: J101.4; also elsewhere on the board

Notes on the sheet:
<4A5>
4A5>
CAD Note: Place at end of bus
Variant:
4C4>
<4C4>
<4C1
4C1>
<2C6
<2A6
