CougsInSpace/CougSat1-Hardware/CougSat1-PowerBoard/ElectricalDesign/SolarPanel.brd

## EAGLE design CougSat1-PowerBoard/ElectricalDesign/SolarPanel.brd (continued)

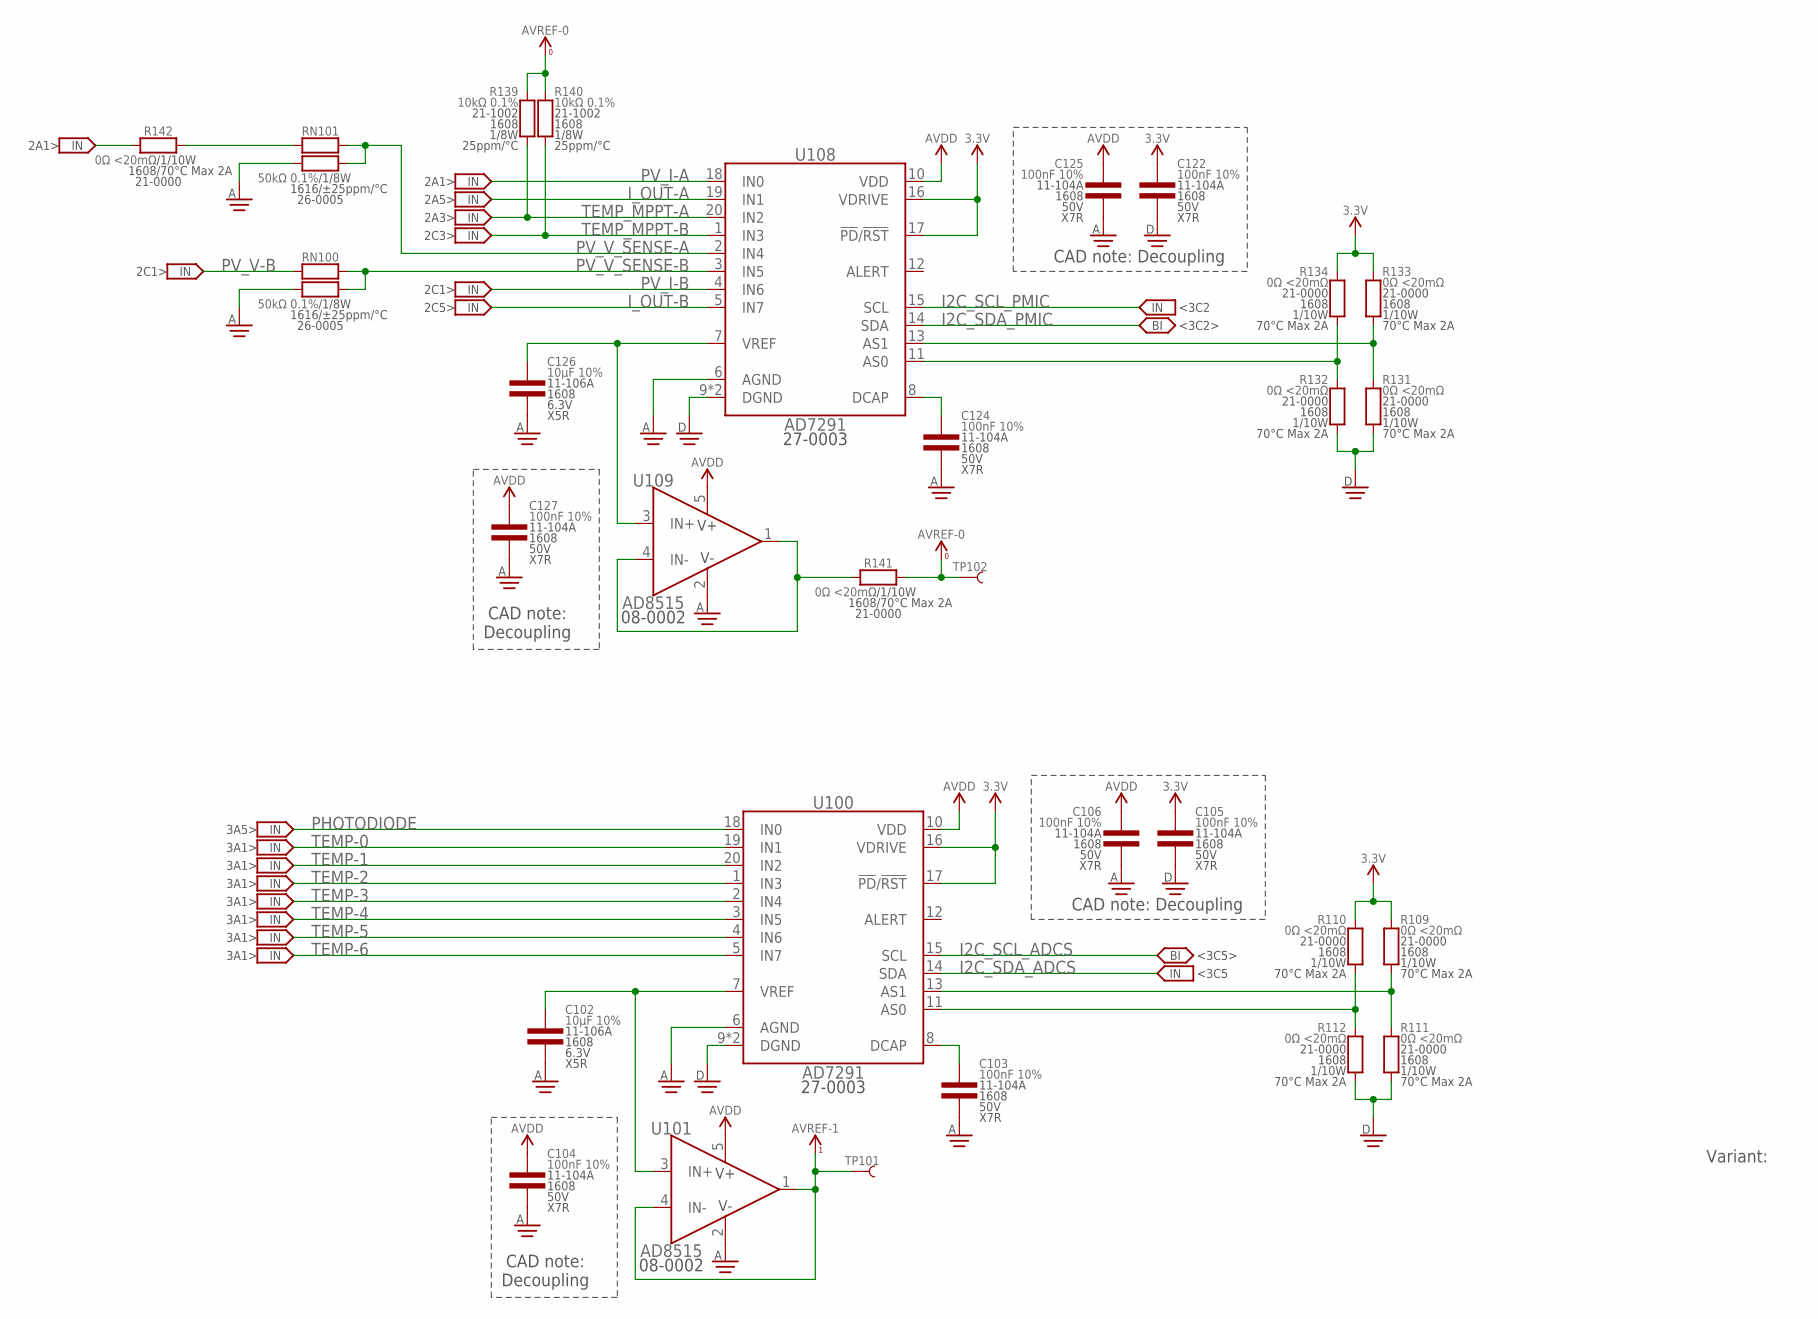
[picture p386: schematic SolarPanel.sch, sheet 4]

Parts:
C102, C126: 10µF 10%; 1608
C103, C104, C105, C106, C122, C124, C125, C127: 100nF 10%; 1608
R109, R110, R111, R112, R131, R132, R133, R134, R141, R142: 0Ω <20mΩ; 1608
R139, R140: 10kΩ 0.1%; 1608
RN100, RN101: 50kΩ 0.1%; 1616
TP101, TP102: TEST_POINT-SMD-C-1.25; SMD-C-1.25
U100, U108: AD7291; QFN-20-4040
U101, U109: AD8515; SOT23-5

Connections:
3.3V: C105.1, C122.1, R109.2, R110.2, R133.2, R134.2, U100.16 (VDRIVE), U100.17 (!PD!/!RST), U108.16 (VDRIVE), U108.17 (!PD!/!RST); also elsewhere on the board
ADC_AS0-ADCS: R110.1, R112.2, U100.11 (AS0)
ADC_AS0-EPS: R132.2, R134.1, U108.11 (AS0)
ADC_AS1-ADCS: R109.1, R111.2, U100.13 (AS1)
ADC_AS1-EPS: R131.2, R133.1, U108.13 (AS1)
ADC_DCAP-ADCS: C103.1, U100.8 (DCAP)
ADC_DCAP-EPS: C124.1, U108.8 (DCAP)
ADC_VREF-ADCS: C102.1, U100.7 (VREF), U101.3 (IN+)
ADC_VREF-EPS: C126.1, U108.7 (VREF), U109.3 (IN+)
AGND: C102.2, C103.2, C104.2, C106.2, C124.2, C125.2, C126.2, C127.2, RN100.1 (A1), RN101.1 (A1), U100.6 (AGND), U101.2 (V-), U108.6 (AGND), U109.2 (V-); also elsewhere on the board
AVDD: C104.1, C106.1, C125.1, C127.1, U100.10 (VDD), U101.5 (V+), U108.10 (VDD), U109.5 (V+); also elsewhere on the board
AVREF-0: R139.2, R140.2, R141.2, TP102.1
AVREF-1: TP101.1, U101.1 (OUT), U101.4 (IN-); also elsewhere on the board
AVREF-BUFF: R141.1, U109.1 (OUT), U109.4 (IN-)
DGND: C105.2, C122.2, R111.1, R112.1, R131.1, R132.1, U100.9 (DGND), U100.PAD (DGND), U108.9 (DGND), U108.PAD (DGND); also elsewhere on the board
I2C_SCL_ADCS: U100.15 (SCL); also elsewhere on the board
I2C_SCL_PMIC: U108.15 (SCL); also elsewhere on the board
I2C_SDA_ADCS: U100.14 (SDA); also elsewhere on the board
I2C_SDA_PMIC: U108.14 (SDA); also elsewhere on the board
I_OUT-A: U108.19 (IN1); also elsewhere on the board
I_OUT-B: U108.5 (IN7); also elsewhere on the board
PHOTODIODE: U100.18 (IN0); also elsewhere on the board
PV_I-A: U108.18 (IN0); also elsewhere on the board
PV_I-B: U108.4 (IN6); also elsewhere on the board
PV_V-A: R142.1; also elsewhere on the board
PV_V-A_JUMP: R142.2, RN101.2 (B1)
PV_V-B: RN100.2 (B1); also elsewhere on the board
PV_V_SENSE-A: RN101.3 (B2), RN101.4 (A2), U108.2 (IN4)
PV_V_SENSE-B: RN100.3 (B2), RN100.4 (A2), U108.3 (IN5)
TEMP-0: U100.19 (IN1); also elsewhere on the board
TEMP-1: U100.20 (IN2); also elsewhere on the board
TEMP-2: U100.1 (IN3); also elsewhere on the board
TEMP-3: U100.2 (IN4); also elsewhere on the board
TEMP-4: U100.3 (IN5); also elsewhere on the board
TEMP-5: U100.4 (IN6); also elsewhere on the board
TEMP-6: U100.5 (IN7); also elsewhere on the board
TEMP_MPPT-A: R139.1, U108.20 (IN2); also elsewhere on the board
TEMP_MPPT-B: R140.1, U108.1 (IN3); also elsewhere on the board

Notes on the sheet:
Variant:
<3C2
<3C2>
CAD note: Decoupling
<3C5>
<3C5
3A5>
CAD note: Decoupling
3A1>
2A1>
2C1>
2C5>
2A3>
2C3>
2A5>

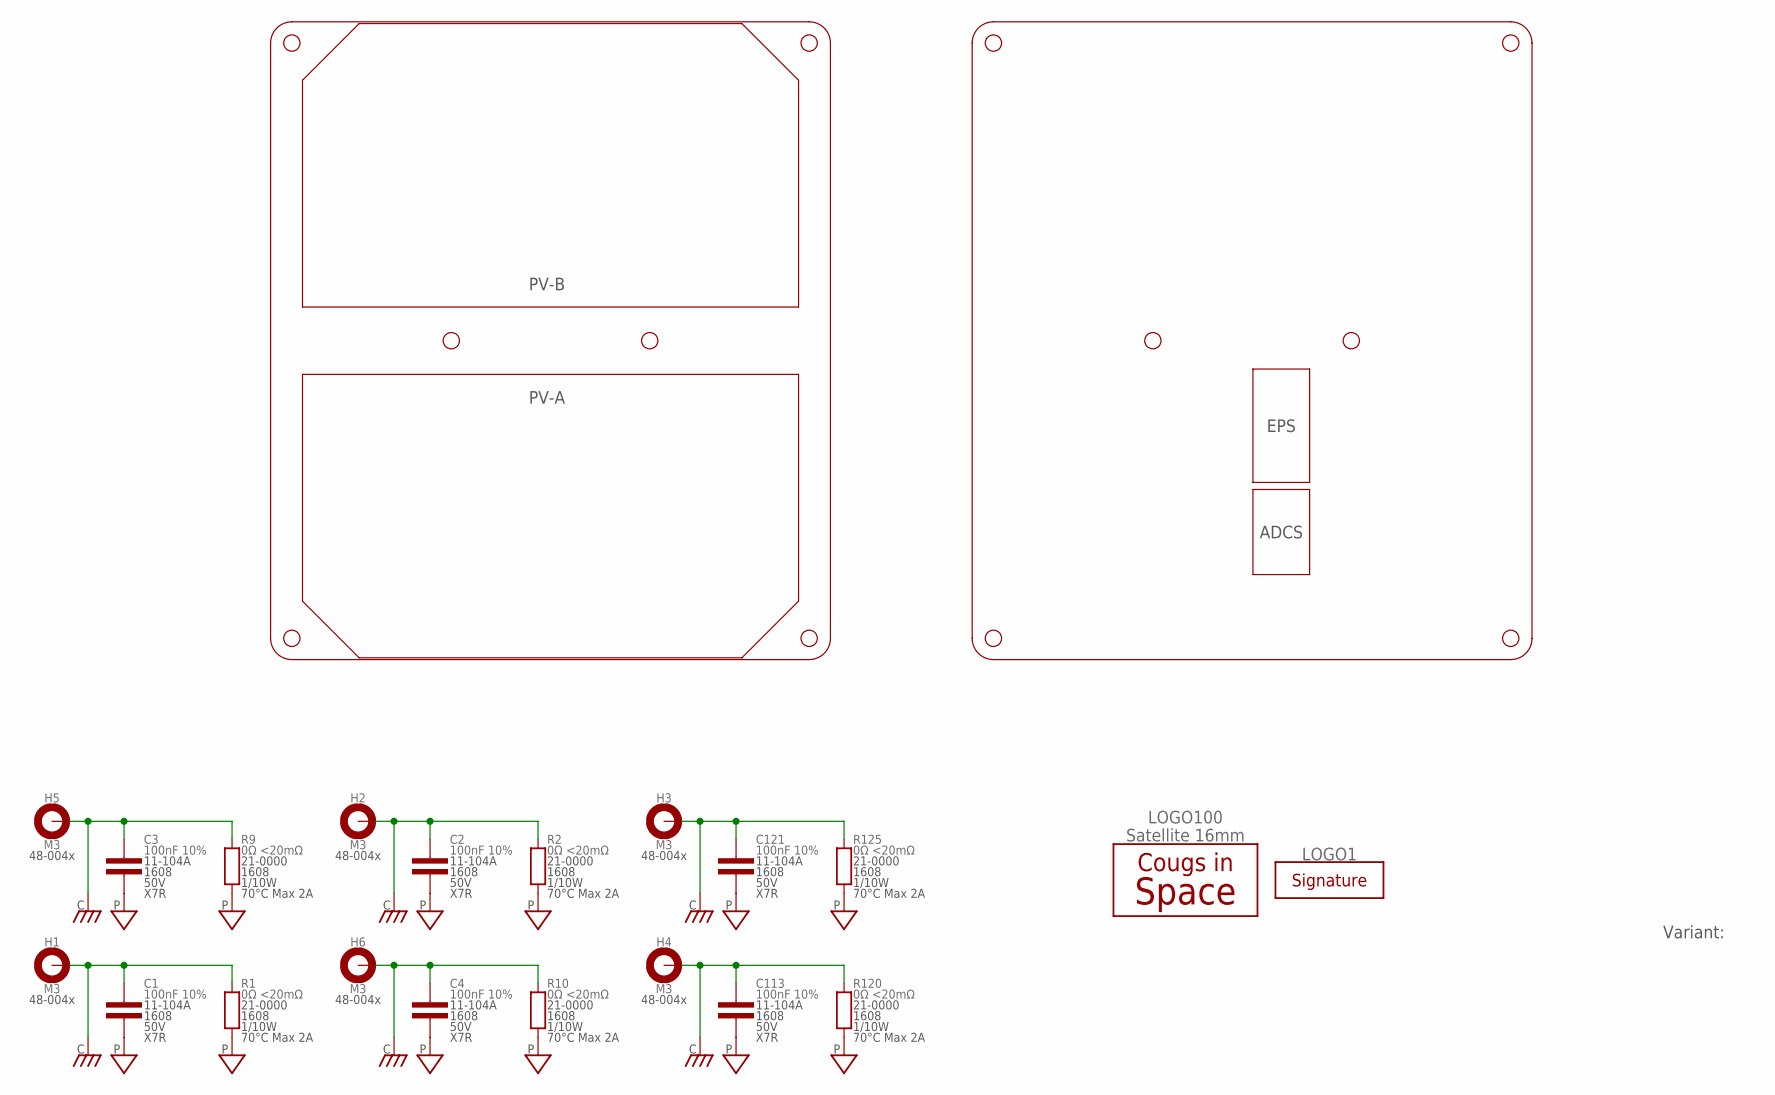
[picture p387: schematic SolarPanel.sch, sheet 5]

Parts:
C1, C2, C3, C4, C113, C121: 100nF 10%; 1608
H1, H2, H3, H4, H5, H6: M3; MOUNTING_HOLE-3.3
LOGO1: SIGNATUREHENDRIK; SIGN-HENDRIK
LOGO100: Satellite 16mm; CIS-SATELLITE-16
R1, R2, R9, R10, R120, R125: 0Ω <20mΩ; 1608

Connections:
CHASSIS: C1.1, C2.1, C3.1, C4.1, C113.1, C121.1, H1.1, H1.V1, H1.V2, H1.V3, H1.V4, H1.V5, H1.V6, H1.V7, H1.V8, H1.V9, H1.V10, H2.1, H2.V1, H2.V2, H2.V3, H2.V4, H2.V5, H2.V6, H2.V7, H2.V8, H2.V9, H2.V10, H3.1, H3.V1, H3.V2, H3.V3, H3.V4, H3.V5, H3.V6, H3.V7, H3.V8, H3.V9, H3.V10, H4.1, H4.V1, H4.V2, H4.V3, H4.V4, H4.V5, H4.V6, H4.V7, H4.V8, H4.V9, H4.V10, H5.1, H5.V1, H5.V2, H5.V3, H5.V4, H5.V5, H5.V6, H5.V7, H5.V8, H5.V9, H5.V10, H6.1, H6.V1, H6.V2, H6.V3, H6.V4, H6.V5, H6.V6, H6.V7, H6.V8, H6.V9, H6.V10, R1.2, R2.2, R9.2, R10.2, R120.2, R125.2
PGND: C1.2, C2.2, C3.2, C4.2, C113.2, C121.2, R1.1, R2.1, R9.1, R10.1, R120.1, R125.1; also elsewhere on the board

Notes on the sheet:
Variant:
PV-A
PV-B
EPS
ADCS

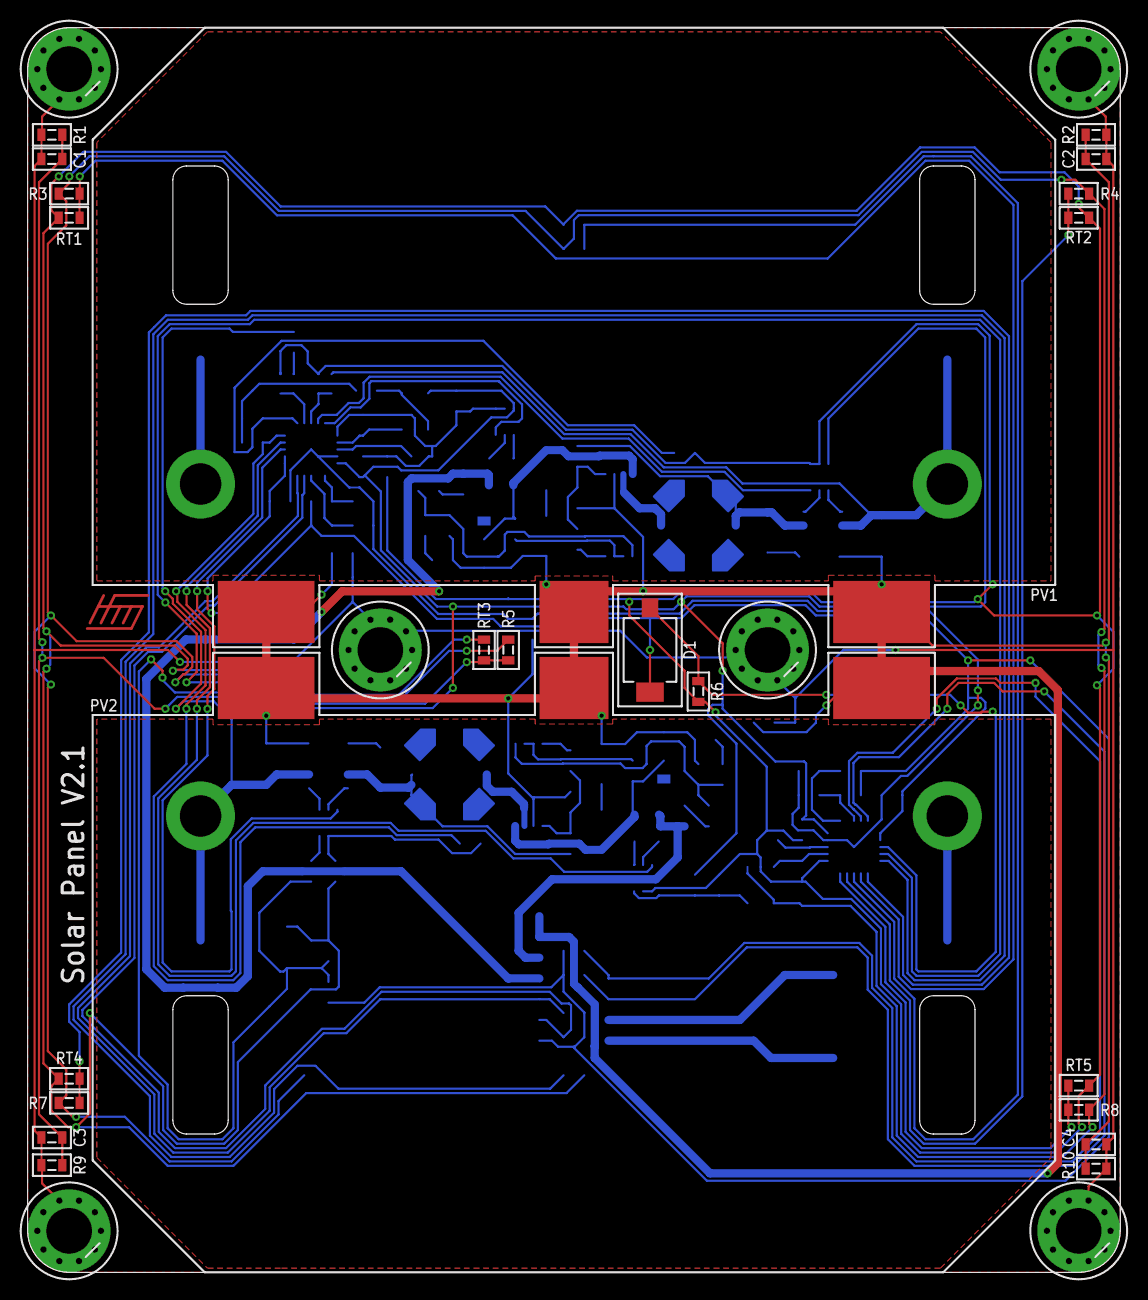
[picture p388: board SolarPanel.brd from above]

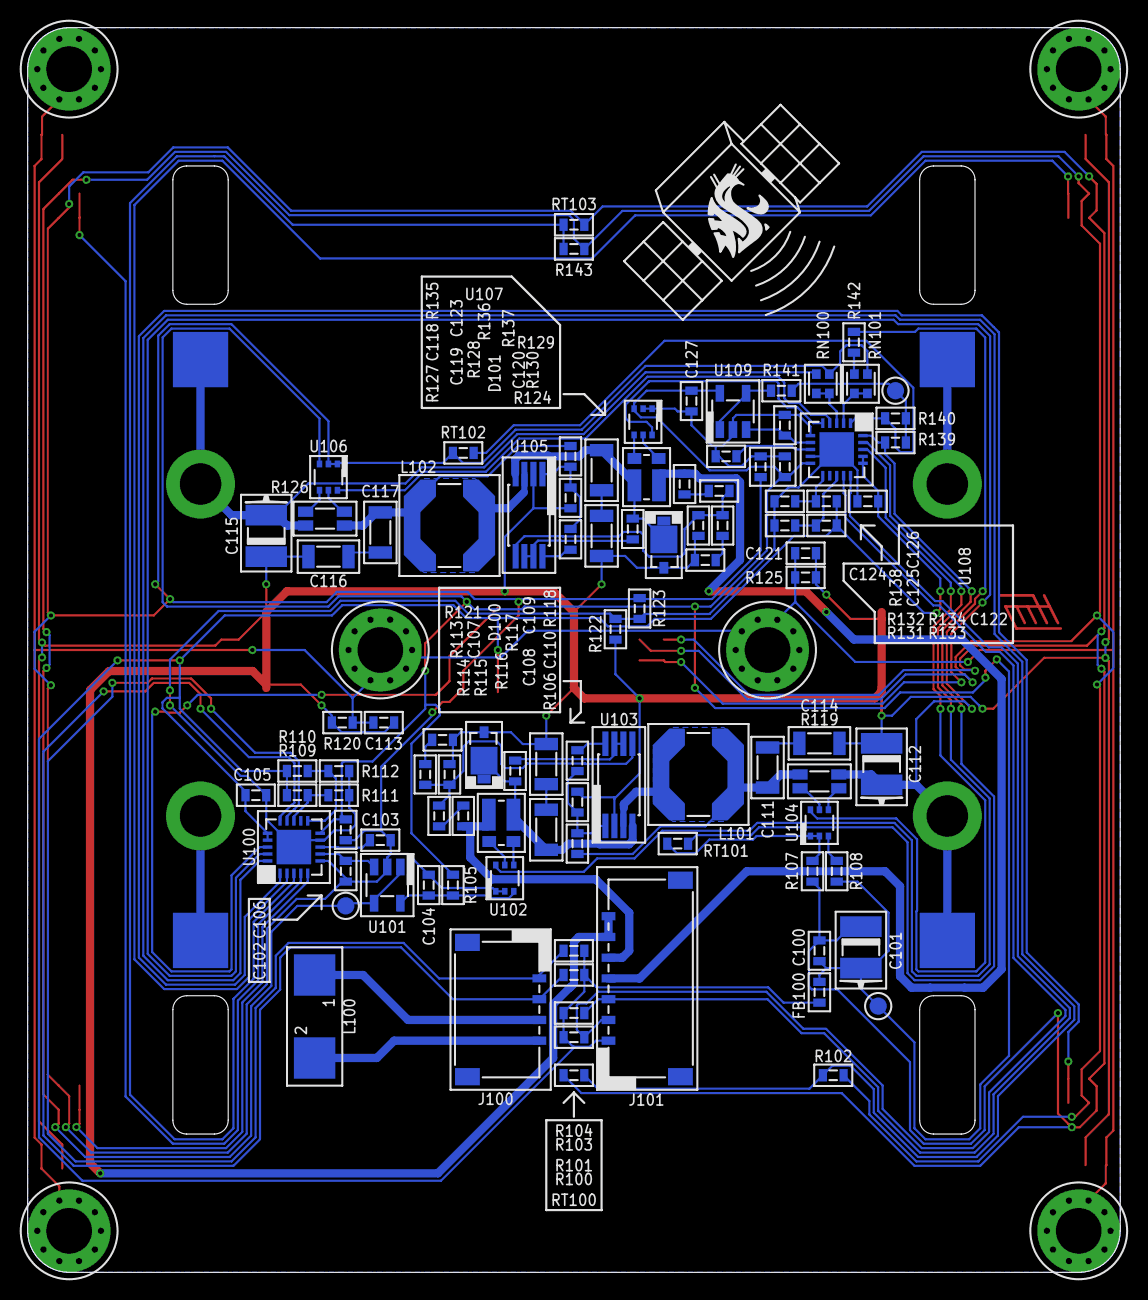
[picture p389: board SolarPanel.brd from below]

Board: 2 copper layers, 79.0 x 90.0 mm, 129 parts (100 on the bottom side), 74 nets.
