CougsInSpace/CougSat1-Hardware/CougSat1-Payload/ElectricalDesign/Payload-Camera.brd

## EAGLE design CougSat1-Payload/ElectricalDesign/Payload-Camera.brd (2019-10-23)

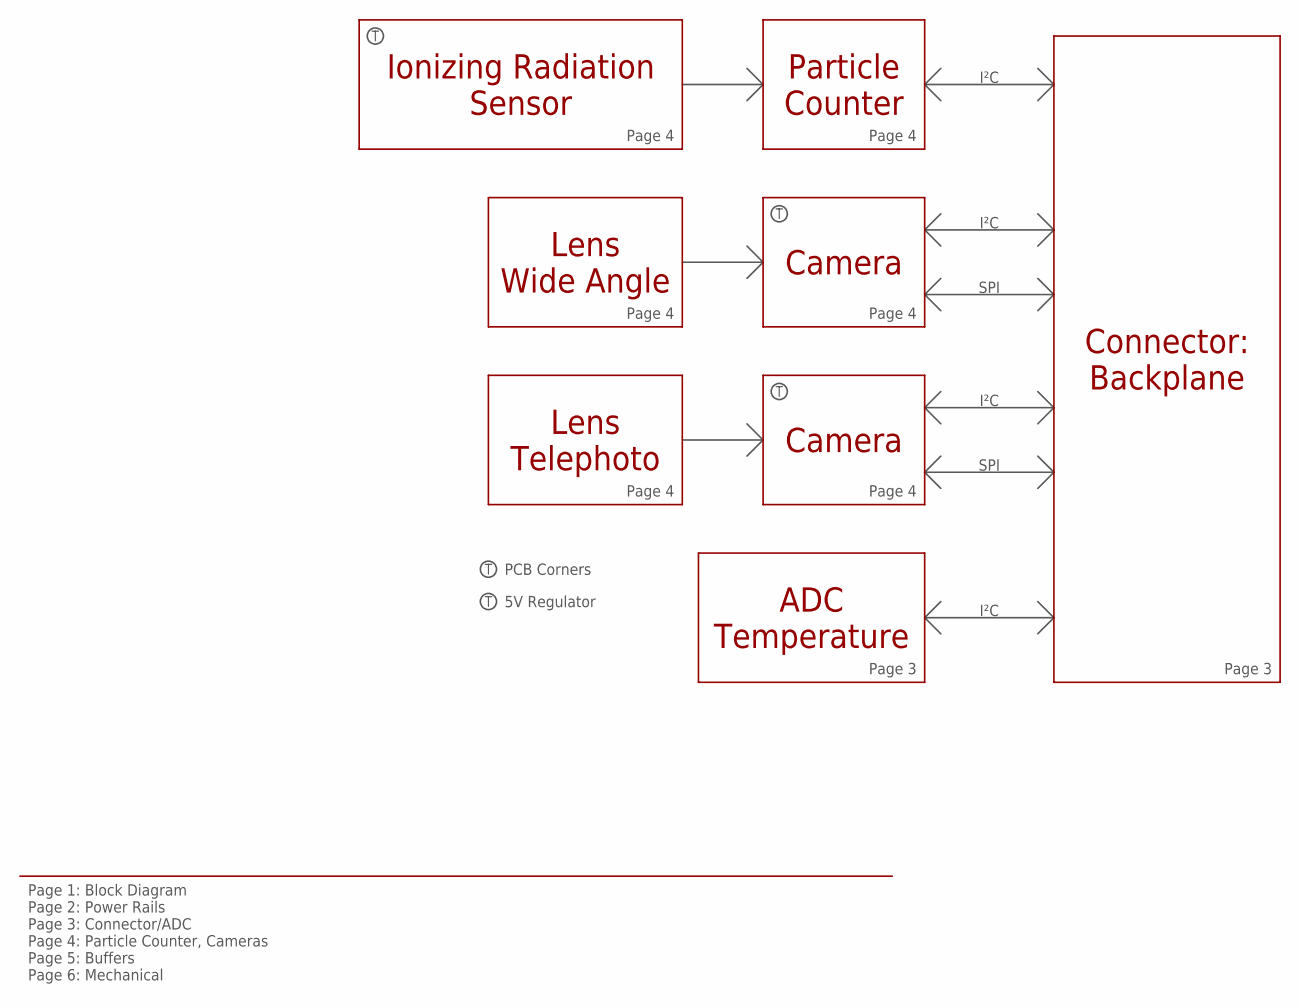
[picture p390: schematic Payload-Camera.sch, sheet 1]

Notes on the sheet:
Connector: Backplane
Camera
Lens Wide Angle
Lens Telephoto
Ionizing Radiation Sensor
Particle Counter
ADC Temperature
I²C
SPI
PCB Corners
Page 1: Block Diagram Page 2: Power Rails Page 3: Connector/ADC Page 4: Particle Counter, Cameras Page 5: Buffers Page 6: Mechanical
Page 4
Page 3
5V Regulator

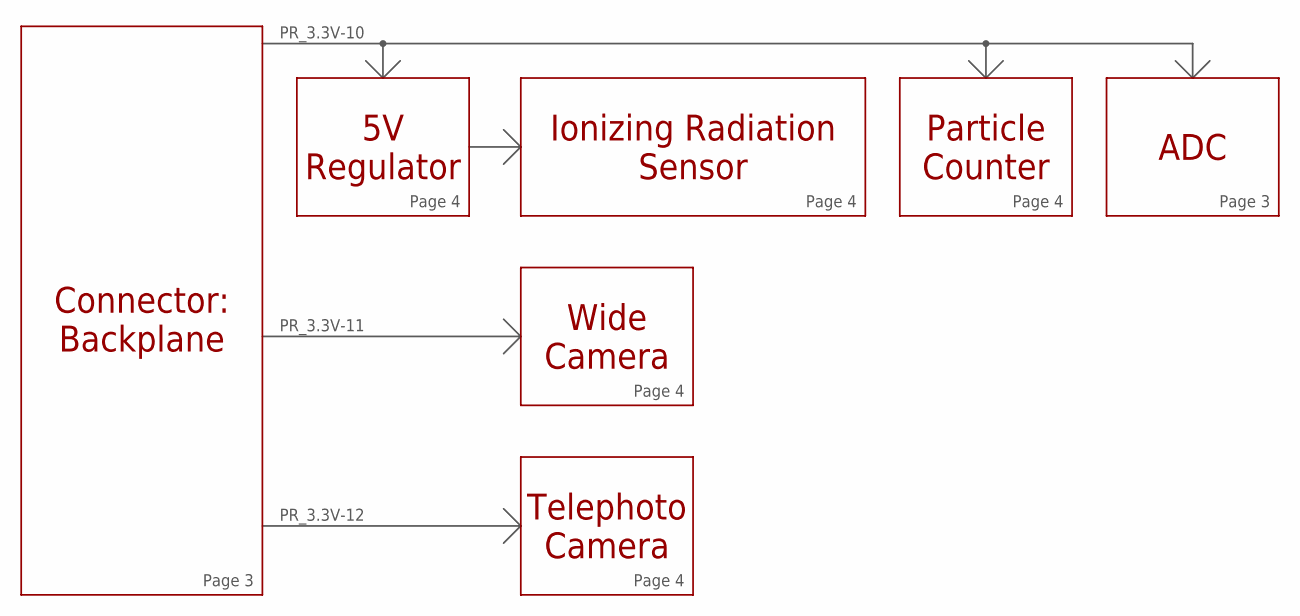
[picture p391: schematic Payload-Camera.sch, sheet 2]

Notes on the sheet:
Connector: Backplane
Wide Camera
Telephoto Camera
Ionizing Radiation Sensor
Particle Counter
ADC
PR_3.3V-10
PR_3.3V-11
PR_3.3V-12
Page 3
Page 4
5V Regulator

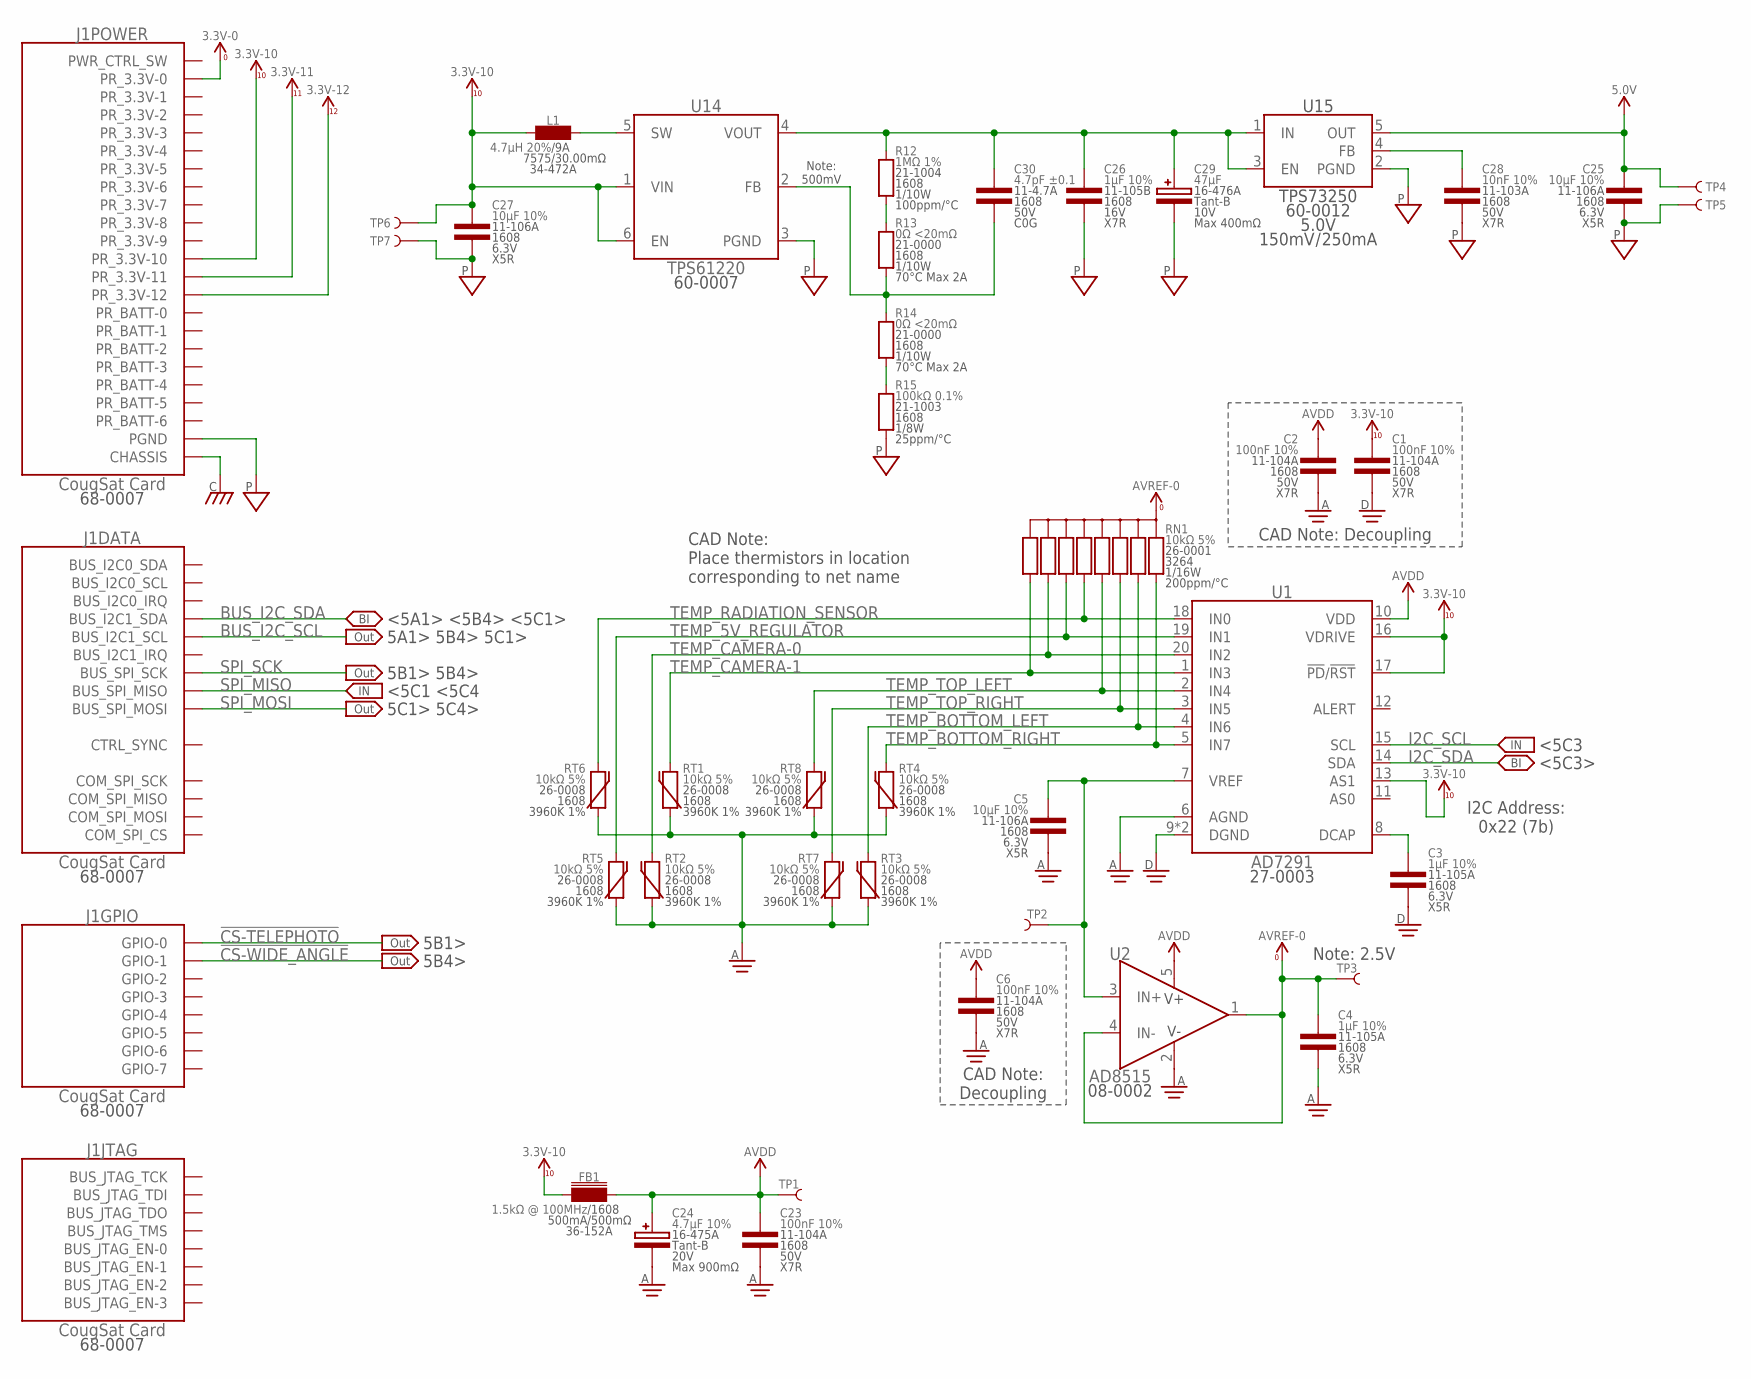
[picture p392: schematic Payload-Camera.sch, sheet 3]

Parts:
C1, C2, C6, C23: 100nF 10%; 1608
C3, C4, C26: 1µF 10%; 1608
C5, C25, C27: 10µF 10%; 1608
C24: 4.7µF 10%; 4028-POL
C28: 10nF 10%; 1608
C29: 47µF; 4028-POL
C30: 4.7pF ±0.1; 1608
FB1: 1.5kΩ @ 100MHz; 1608
J1: CougSat Card; CARD-FULL-OPEN+X
L1: 4.7µH 20%; 7575
R12: 1MΩ 1%; 1608
R13, R14: 0Ω <20mΩ; 1608
R15: 100kΩ 0.1%; 1608
RN1: 10kΩ 5%; 3264
RT1, RT2, RT3, RT4, RT5, RT6, RT7, RT8: 10kΩ 5%; 1608
TP1, TP2, TP3: TEST_POINT-SMD-C-1.25; SMD-C-1.25
TP4, TP5, TP6, TP7: TEST_POINT-THT-1.0; THT-1.0
U1: AD7291; QFN-20-4040
U2: AD8515; SOT23-5
U14: TPS61220; SOT363
U15: TPS73250; SOT23-5

Connections:
3.3V_0: J1.A1 (PR_3.3V-0), J1.B1 (PR_3.3V-0); also elsewhere on the board
3.3V_10: C1.1, C27.1, FB1.1, J1.A11 (PR_3.3V-10), J1.B11 (PR_3.3V-10), L1.1, TP6.1, U1.13 (AS1), U1.16 (VDRIVE), U1.17 (!PD!/!RST), U14.1 (VIN), U14.6 (EN); also elsewhere on the board
3.3V_11: J1.A12 (PR_3.3V-11), J1.B12 (PR_3.3V-11); also elsewhere on the board
3.3V_12: J1.A13 (PR_3.3V-12), J1.B13 (PR_3.3V-12); also elsewhere on the board
5.0V: C25.1, TP4.1, U15.5 (OUT); also elsewhere on the board
!CS-TELEPHOTO: J1.A24 (GPIO-0); also elsewhere on the board
!CS-WIDE_ANGLE: J1.A25 (GPIO-1); also elsewhere on the board
ADC_DCAP: C3.1, U1.8 (DCAP)
ADC_VREF: C5.1, TP2.1, U1.7 (VREF), U2.3 (IN+)
AGND: C2.2, C4.2, C5.2, C6.2, C23.2, C24.C, RT1.1, RT2.1, RT3.1, RT4.1, RT5.1, RT6.1, RT7.1, RT8.1, U1.6 (AGND), U2.2 (V-); also elsewhere on the board
AVDD: C2.1, C6.1, C23.1, C24.A, FB1.2, TP1.1, U1.10 (VDD), U2.5 (V+)
AVREF-0: C4.1, RN1.5 (C), RN1.10 (C), TP3.1, U2.1 (OUT), U2.4 (IN-)
BOOST_FB: C30.2, R13.1, R14.2, U14.2 (FB)
BOOST_FB-HIGH: R12.1, R13.2
BOOST_FB-LOW: R14.1, R15.2
BOOST_IN: L1.2, U14.5 (SW)
BOOST_OUT: C26.1, C29.A, C30.1, R12.2, U14.4 (VOUT), U15.1 (IN), U15.3 (EN)
BUS_I2C_SCL: J1.A31 (BUS_I2C1_SCL), J1.B31 (BUS_I2C1_SCL); also elsewhere on the board
BUS_I2C_SDA: J1.A30 (BUS_I2C1_SDA), J1.B30 (BUS_I2C1_SDA); also elsewhere on the board
CHASSIS: J1.CHASSIS@1 (CHASSIS), J1.CHASSIS@2 (CHASSIS), J1.CHASSIS@3 (CHASSIS), J1.CHASSIS@4 (CHASSIS); also elsewhere on the board
DGND: C1.2, C3.2, U1.9 (DGND), U1.PAD (DGND); also elsewhere on the board
I2C_SCL: U1.15 (SCL); also elsewhere on the board
I2C_SDA: U1.14 (SDA); also elsewhere on the board
PGND: C25.2, C26.2, C27.2, C28.2, C29.C, J1.A21 (PGND), J1.A22 (PGND), J1.A23 (PGND), J1.B21 (PGND), J1.B22 (PGND), J1.B23 (PGND), J1.B24 (PGND), J1.B25 (PGND), J1.B26 (PGND), J1.B27 (PGND), J1.B28 (PGND), J1.B29 (PGND), R15.1, TP5.1, TP7.1, U14.3 (PGND), U15.2 (PGND); also elsewhere on the board
PR_3.3V-1: J1.A2 (PR_3.3V-1), J1.B2 (PR_3.3V-1)
PR_3.3V-2: J1.A3 (PR_3.3V-2), J1.B3 (PR_3.3V-2)
PR_3.3V-3: J1.A4 (PR_3.3V-3), J1.B4 (PR_3.3V-3)
PR_3.3V-4: J1.A5 (PR_3.3V-4), J1.B5 (PR_3.3V-4)
PR_3.3V-5: J1.A6 (PR_3.3V-5), J1.B6 (PR_3.3V-5)
PR_3.3V-6: J1.A7 (PR_3.3V-6), J1.B7 (PR_3.3V-6)
PR_3.3V-7: J1.A8 (PR_3.3V-7), J1.B8 (PR_3.3V-7)
PR_3.3V-8: J1.A9 (PR_3.3V-8), J1.B9 (PR_3.3V-8)
PR_3.3V-9: J1.A10 (PR_3.3V-9), J1.B10 (PR_3.3V-9)
PR_BATT-0: J1.A14 (PR_BATT-0), J1.B14 (PR_BATT-0)
PR_BATT-1: J1.A15 (PR_BATT-1), J1.B15 (PR_BATT-1)
PR_BATT-2: J1.A16 (PR_BATT-2), J1.B16 (PR_BATT-2)
PR_BATT-3: J1.A17 (PR_BATT-3), J1.B17 (PR_BATT-3)
PR_BATT-4: J1.A18 (PR_BATT-4), J1.B18 (PR_BATT-4)
PR_BATT-5: J1.A19 (PR_BATT-5), J1.B19 (PR_BATT-5)
PR_BATT-6: J1.A20 (PR_BATT-6), J1.B20 (PR_BATT-6)
REG_FB: C28.1, U15.4 (FB)
SPI_MISO: J1.A38 (BUS_SPI_MISO), J1.B38 (BUS_SPI_MISO); also elsewhere on the board
SPI_MOSI: J1.A39 (BUS_SPI_MOSI), J1.B39 (BUS_SPI_MOSI); also elsewhere on the board
SPI_SCK: J1.A37 (BUS_SPI_SCK), J1.B37 (BUS_SPI_SCK); also elsewhere on the board
TEMP_5V_REGULATOR: RN1.7 (6), RT5.2, U1.19 (IN1)
TEMP_BOTTOM_LEFT: RN1.2, RT3.2, U1.4 (IN6)
TEMP_BOTTOM_RIGHT: RN1.1, RT4.2, U1.5 (IN7)
TEMP_CAMERA-0: RN1.8 (7), RT2.2, U1.20 (IN2)
TEMP_CAMERA-1: RN1.9 (8), RT1.2, U1.1 (IN3)
TEMP_RADIATION_SENSOR: RN1.6 (5), RT6.2, U1.18 (IN0)
TEMP_TOP_LEFT: RN1.4, RT8.2, U1.2 (IN4)
TEMP_TOP_RIGHT: RN1.3, RT7.2, U1.3 (IN5)

Notes on the sheet:
CAD Note: Decoupling
CAD Note: Decoupling
<5A1> <5B4> <5C1>
5A1> 5B4> 5C1>
5B1> 5B4>
5C1> 5C4>
<5C1 <5C4
<5C3>
<5C3
Note: 500mV
CAD Note: Place thermistors in location corresponding to net name
5B1>
5B4>
Note: 2.5V
I2C Address: 0x22 (7b)

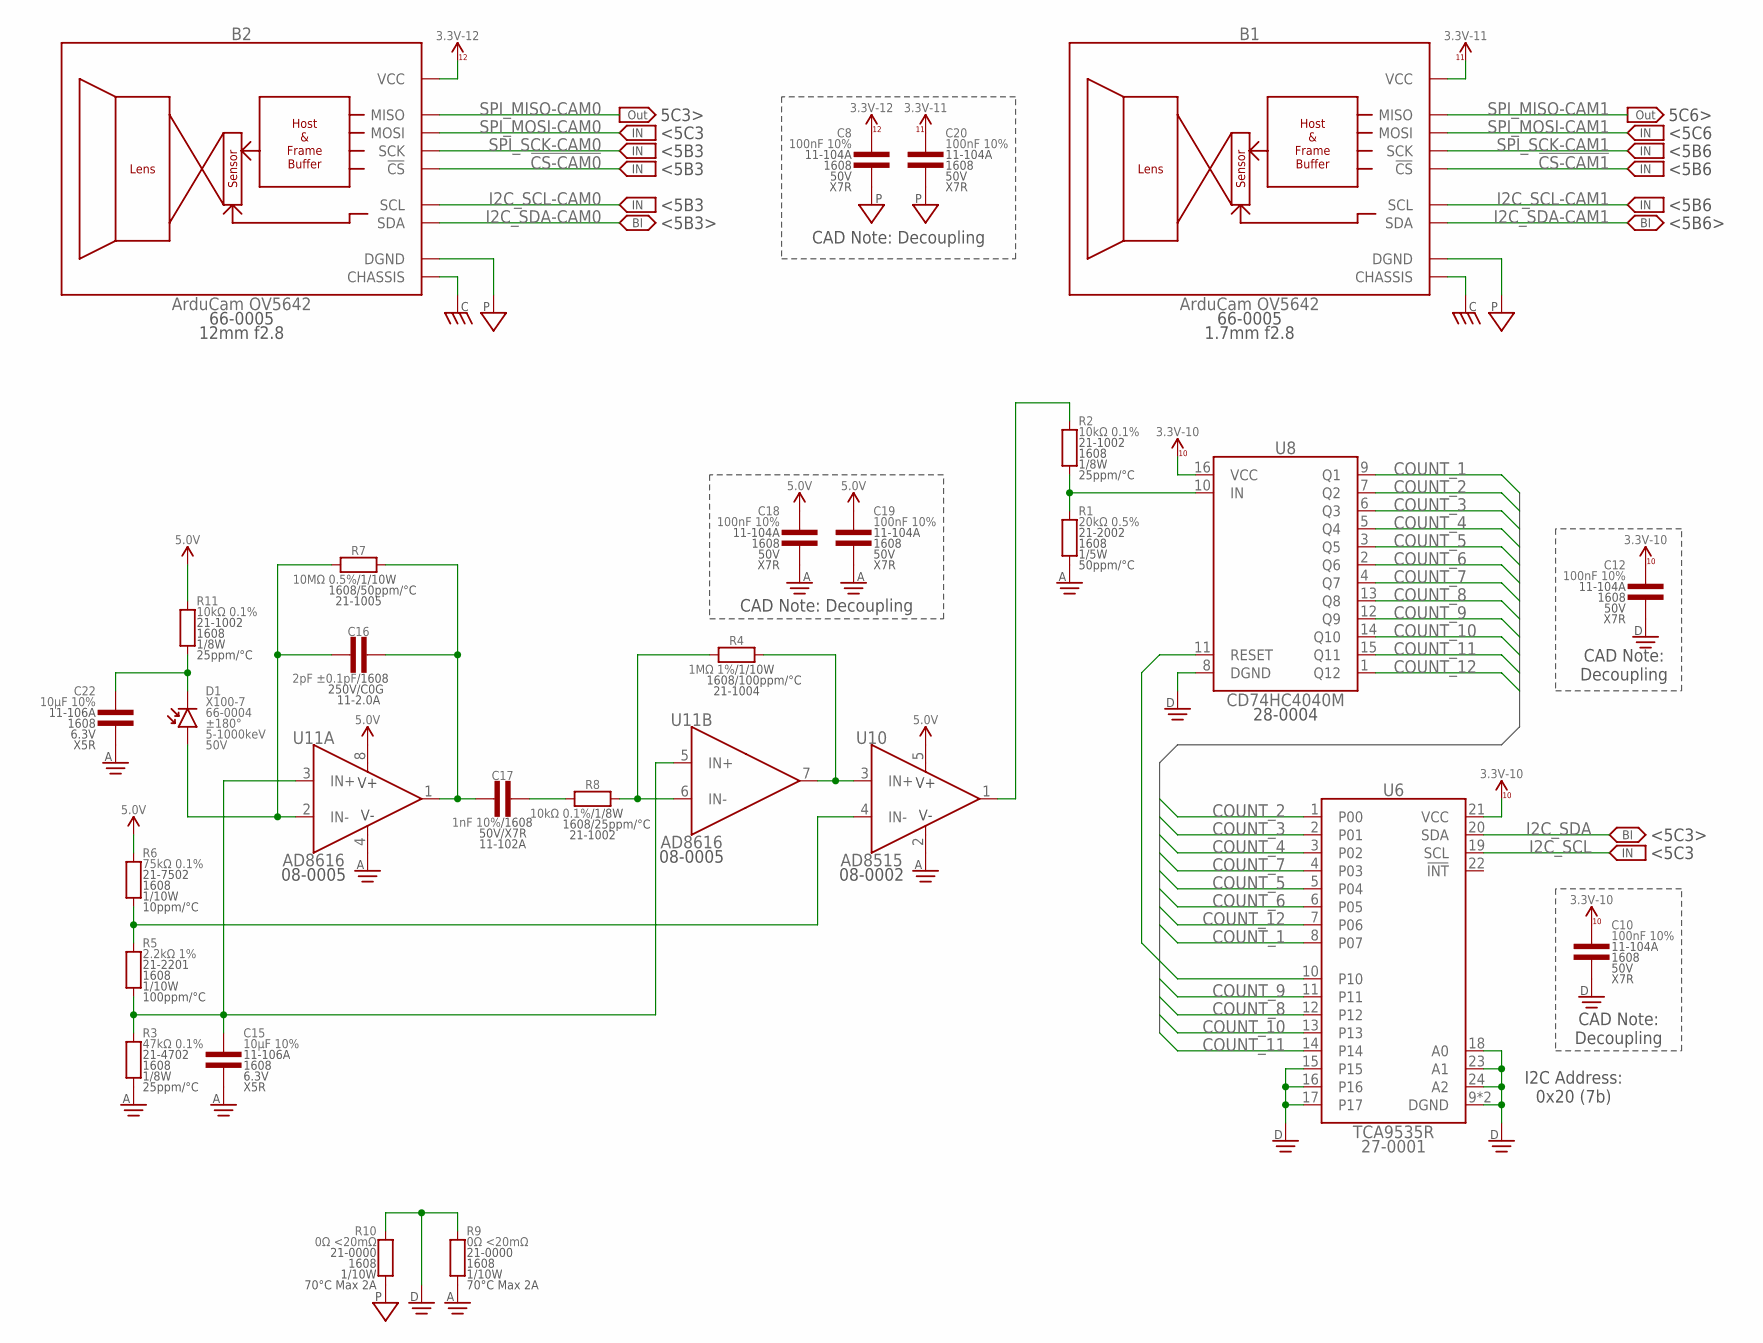
[picture p393: schematic Payload-Camera.sch, sheet 4]

Parts:
B1, B2: ArduCam OV5642; ARDUCAM
C8, C10, C12, C18, C19, C20: 100nF 10%; 1608
C15, C22: 10µF 10%; 1608
C16: 2pF ±0.1pF; 1608
C17: 1nF 10%; 1608
D1: X100-7; X100-7-THD
R1: 20kΩ 0.5%; 1608
R2, R8, R11: 10kΩ 0.1%; 1608
R3: 47kΩ 0.1%; 1608
R4: 1MΩ 1%; 1608
R5: 2.2kΩ 1%; 1608
R6: 75kΩ 0.1%; 1608
R7: 10MΩ 0.5%; 1608
R9, R10: 0Ω <20mΩ; 1608
U6: TCA9535R; QFN-24-4040
U8: CD74HC4040M; SO16
U10: AD8515; SOT23-5
U11: AD8616; MSOP-8

Connections:
3.3V_10: C10.1, C12.1, U6.21 (VCC), U8.16 (VCC); also elsewhere on the board
3.3V_11: B1.6 (VCC), C20.1; also elsewhere on the board
3.3V_12: B2.6 (VCC), C8.1; also elsewhere on the board
5.0V: C18.1, C19.1, R6.2, R11.2, U10.5 (V+), U11.8 (V+); also elsewhere on the board
!CS-CAM0: B2.1 (!CS); also elsewhere on the board
!CS-CAM1: B1.1 (!CS); also elsewhere on the board
AGND: C15.2, C18.2, C19.2, C22.2, R1.1, R3.1, R9.1, U10.2 (V-), U11.4 (V-); also elsewhere on the board
ATRIP: R2.2, U10.1 (OUT)
CHASSIS: B1.CHASSIS@1 (CHASSIS), B1.CHASSIS@2 (CHASSIS), B1.CHASSIS@3 (CHASSIS), B1.CHASSIS@4 (CHASSIS), B1.CHASSIS@5 (CHASSIS), B1.CHASSIS@6 (CHASSIS), B1.CHASSIS@7 (CHASSIS), B1.CHASSIS@8 (CHASSIS), B1.CHASSIS@9 (CHASSIS), B1.CHASSIS@10 (CHASSIS), B1.CHASSIS@11 (CHASSIS), B1.CHASSIS@12 (CHASSIS), B1.CHASSIS@13 (CHASSIS), B1.CHASSIS@14 (CHASSIS), B1.CHASSIS@15 (CHASSIS), B1.CHASSIS@16 (CHASSIS), B1.CHASSIS@17 (CHASSIS), B1.CHASSIS@18 (CHASSIS), B2.CHASSIS@1 (CHASSIS), B2.CHASSIS@2 (CHASSIS), B2.CHASSIS@3 (CHASSIS), B2.CHASSIS@4 (CHASSIS), B2.CHASSIS@5 (CHASSIS), B2.CHASSIS@6 (CHASSIS), B2.CHASSIS@7 (CHASSIS), B2.CHASSIS@8 (CHASSIS), B2.CHASSIS@9 (CHASSIS), B2.CHASSIS@10 (CHASSIS), B2.CHASSIS@11 (CHASSIS), B2.CHASSIS@12 (CHASSIS), B2.CHASSIS@13 (CHASSIS), B2.CHASSIS@14 (CHASSIS), B2.CHASSIS@15 (CHASSIS), B2.CHASSIS@16 (CHASSIS), B2.CHASSIS@17 (CHASSIS), B2.CHASSIS@18 (CHASSIS); also elsewhere on the board
COUNTER_IN: R1.2, R2.1, U8.10 (IN)
COUNTER_RESET: U6.10, U8.11 (RESET)
COUNT_1: U6.8 (P07), U8.9 (Q1)
COUNT_2: U6.1 (P00), U8.7 (Q2)
COUNT_3: U6.2 (P01), U8.6 (Q3)
COUNT_4: U6.3 (P02), U8.5 (Q4)
COUNT_5: U6.5 (P04), U8.3 (Q5)
COUNT_6: U6.6 (P05), U8.2 (Q6)
COUNT_7: U6.4 (P03), U8.4 (Q7)
COUNT_8: U6.12, U8.13 (Q8)
COUNT_9: U6.11, U8.12 (Q9)
COUNT_10: U6.13, U8.14 (Q10)
COUNT_11: U6.14, U8.15 (Q11)
COUNT_12: U6.7 (P06), U8.1 (Q12)
DGND: C10.2, C12.2, R9.2, R10.2, U6.9 (DGND), U6.15, U6.16, U6.17, U6.18 (A0), U6.23 (A1), U6.24 (A2), U6.PAD (DGND), U8.8 (DGND); also elsewhere on the board
DIFF_IN: R4.1, R8.2, U11.6 (IN-)
DIFF_INT_IN: C17.2, R8.1
DIFF_OUT: R4.2, U10.3 (IN+), U11.7 (OUT)
I2C_SCL: U6.19 (SCL); also elsewhere on the board
I2C_SCL-CAM0: B2.8 (SCL); also elsewhere on the board
I2C_SCL-CAM1: B1.8 (SCL); also elsewhere on the board
I2C_SDA: U6.20 (SDA); also elsewhere on the board
I2C_SDA-CAM0: B2.7 (SDA); also elsewhere on the board
I2C_SDA-CAM1: B1.7 (SDA); also elsewhere on the board
PD_IN: C22.1, D1.C, R11.1
PD_OUT_THRESH: R5.2, R6.1, U10.4 (IN-)
PD_VDIV_OUT: C15.1, R3.2, R5.1, U11.3 (IN+), U11.5 (IN+)
PGND: B1.5 (DGND), B2.5 (DGND), C8.2, C20.2, R10.1; also elsewhere on the board
QAMP_IN: C16.1, D1.A, R7.1, U11.2 (IN-)
QAMP_OUT: C16.2, C17.1, R7.2, U11.1 (OUT)
SPI_MISO-CAM0: B2.3 (MISO); also elsewhere on the board
SPI_MISO-CAM1: B1.3 (MISO); also elsewhere on the board
SPI_MOSI-CAM0: B2.2 (MOSI); also elsewhere on the board
SPI_MOSI-CAM1: B1.2 (MOSI); also elsewhere on the board
SPI_SCK-CAM0: B2.4 (SCK); also elsewhere on the board
SPI_SCK-CAM1: B1.4 (SCK); also elsewhere on the board

Notes on the sheet:
5C3>
5C6>
<5B3>
<5B6>
<5C3
<5B3
<5B6
<5C6
<5C3>
CAD Note: Decoupling
CAD Note: Decoupling
I2C Address: 0x20 (7b)
