CougsInSpace/CougSat1-Hardware/CougSat1-Payload/ElectricalDesign/Payload-Camera.brd

## EAGLE design CougSat1-Payload/ElectricalDesign/Payload-Camera.brd (continued)

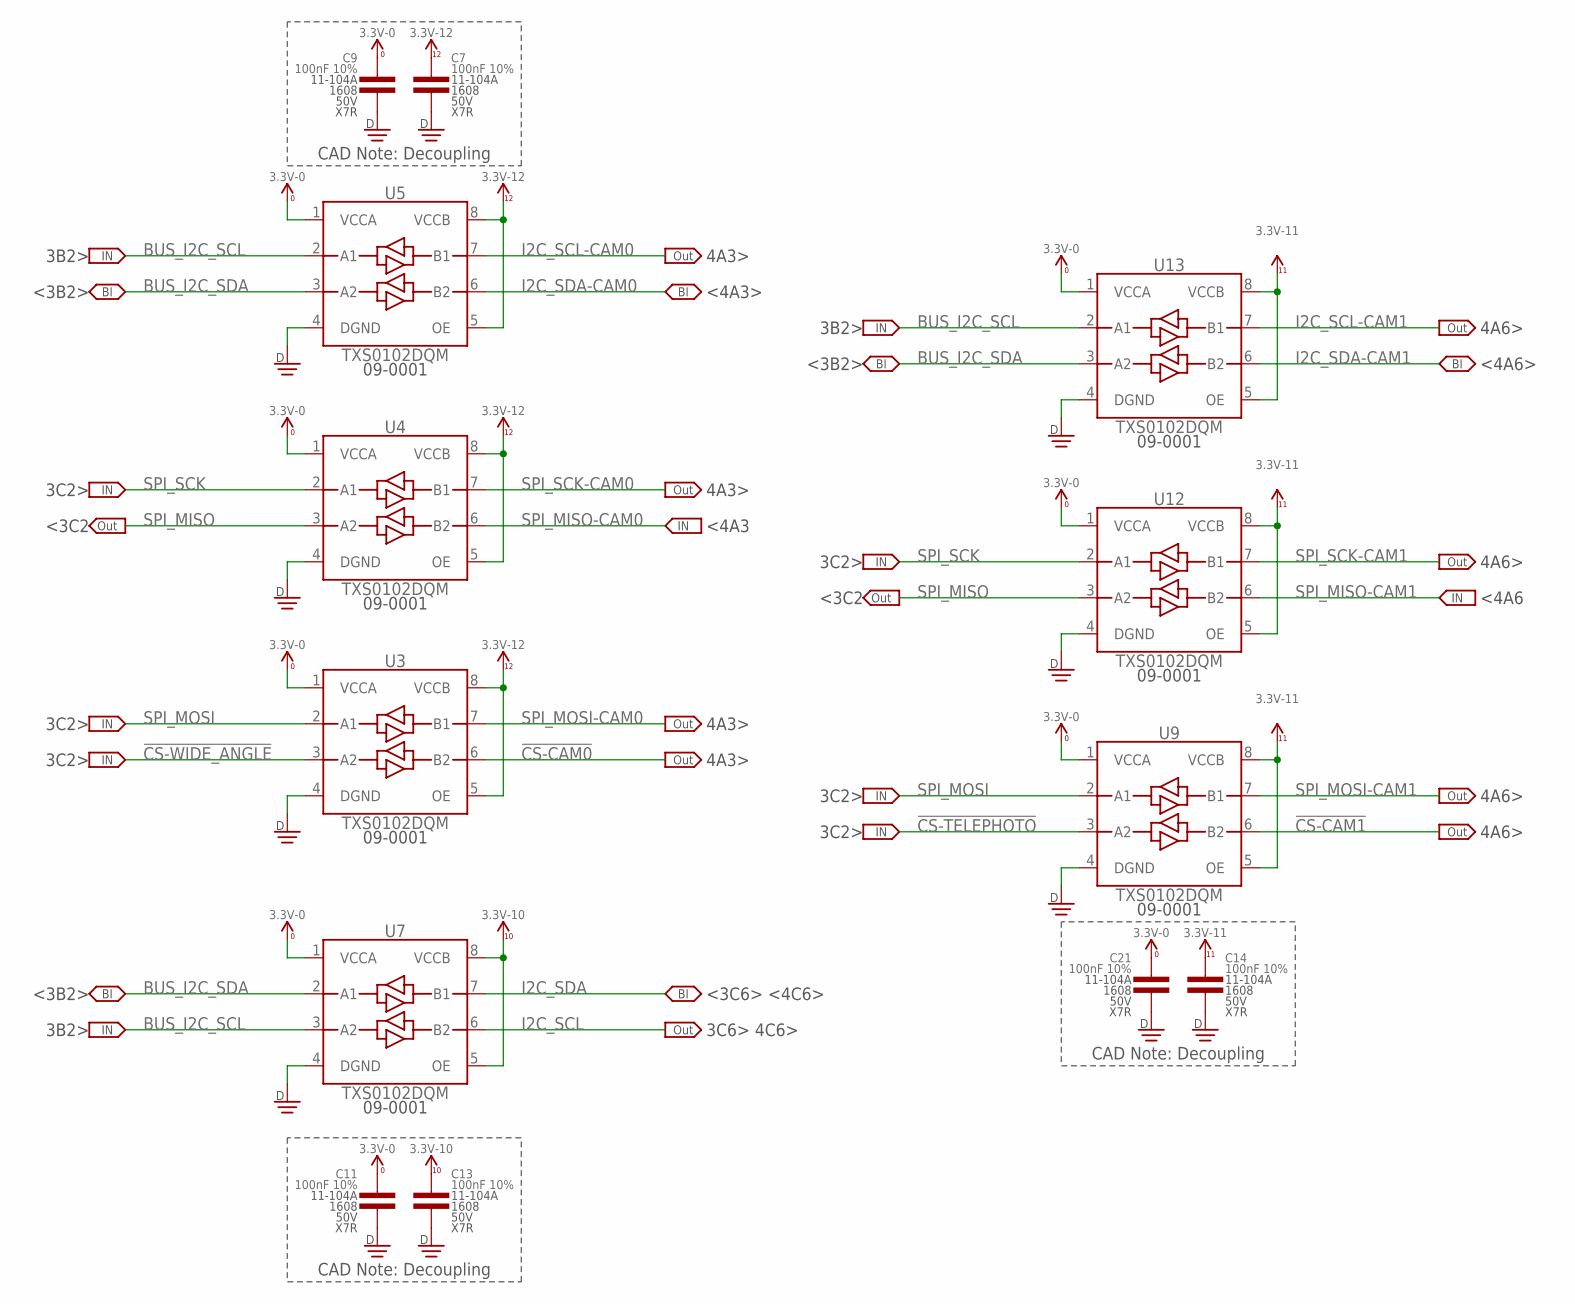
[picture p394: schematic Payload-Camera.sch, sheet 5]

Parts:
C7, C9, C11, C13, C14, C21: 100nF 10%; 1608
U3, U4, U5, U7, U9, U12, U13: TXS0102DQM; X2SON-8

Connections:
3.3V_0: C9.1, C11.1, C21.1, U3.1 (VCCA), U4.1 (VCCA), U5.1 (VCCA), U7.1 (VCCA), U9.1 (VCCA), U12.1 (VCCA), U13.1 (VCCA); also elsewhere on the board
3.3V_10: C13.1, U7.5 (OE), U7.8 (VCCB); also elsewhere on the board
3.3V_11: C14.1, U9.5 (OE), U9.8 (VCCB), U12.5 (OE), U12.8 (VCCB), U13.5 (OE), U13.8 (VCCB); also elsewhere on the board
3.3V_12: C7.1, U3.5 (OE), U3.8 (VCCB), U4.5 (OE), U4.8 (VCCB), U5.5 (OE), U5.8 (VCCB); also elsewhere on the board
!CS-CAM0: U3.6 (B2); also elsewhere on the board
!CS-CAM1: U9.6 (B2); also elsewhere on the board
!CS-TELEPHOTO: U9.3 (A2); also elsewhere on the board
!CS-WIDE_ANGLE: U3.3 (A2); also elsewhere on the board
BUS_I2C_SCL: U5.2 (A1), U7.3 (A2), U13.2 (A1); also elsewhere on the board
BUS_I2C_SDA: U5.3 (A2), U7.2 (A1), U13.3 (A2); also elsewhere on the board
DGND: C7.2, C9.2, C11.2, C13.2, C14.2, C21.2, U3.4 (DGND), U4.4 (DGND), U5.4 (DGND), U7.4 (DGND), U9.4 (DGND), U12.4 (DGND), U13.4 (DGND); also elsewhere on the board
I2C_SCL: U7.6 (B2); also elsewhere on the board
I2C_SCL-CAM0: U5.7 (B1); also elsewhere on the board
I2C_SCL-CAM1: U13.7 (B1); also elsewhere on the board
I2C_SDA: U7.7 (B1); also elsewhere on the board
I2C_SDA-CAM0: U5.6 (B2); also elsewhere on the board
I2C_SDA-CAM1: U13.6 (B2); also elsewhere on the board
SPI_MISO: U4.3 (A2), U12.3 (A2); also elsewhere on the board
SPI_MISO-CAM0: U4.6 (B2); also elsewhere on the board
SPI_MISO-CAM1: U12.6 (B2); also elsewhere on the board
SPI_MOSI: U3.2 (A1), U9.2 (A1); also elsewhere on the board
SPI_MOSI-CAM0: U3.7 (B1); also elsewhere on the board
SPI_MOSI-CAM1: U9.7 (B1); also elsewhere on the board
SPI_SCK: U4.2 (A1), U12.2 (A1); also elsewhere on the board
SPI_SCK-CAM0: U4.7 (B1); also elsewhere on the board
SPI_SCK-CAM1: U12.7 (B1); also elsewhere on the board

Notes on the sheet:
3C2>
4A3>
4A6>
CAD Note: Decoupling
<3B2>
3B2>
<4A3>
<4A6>
<3C2
<4A6
<4A3
<3C6> <4C6>
3C6> 4C6>

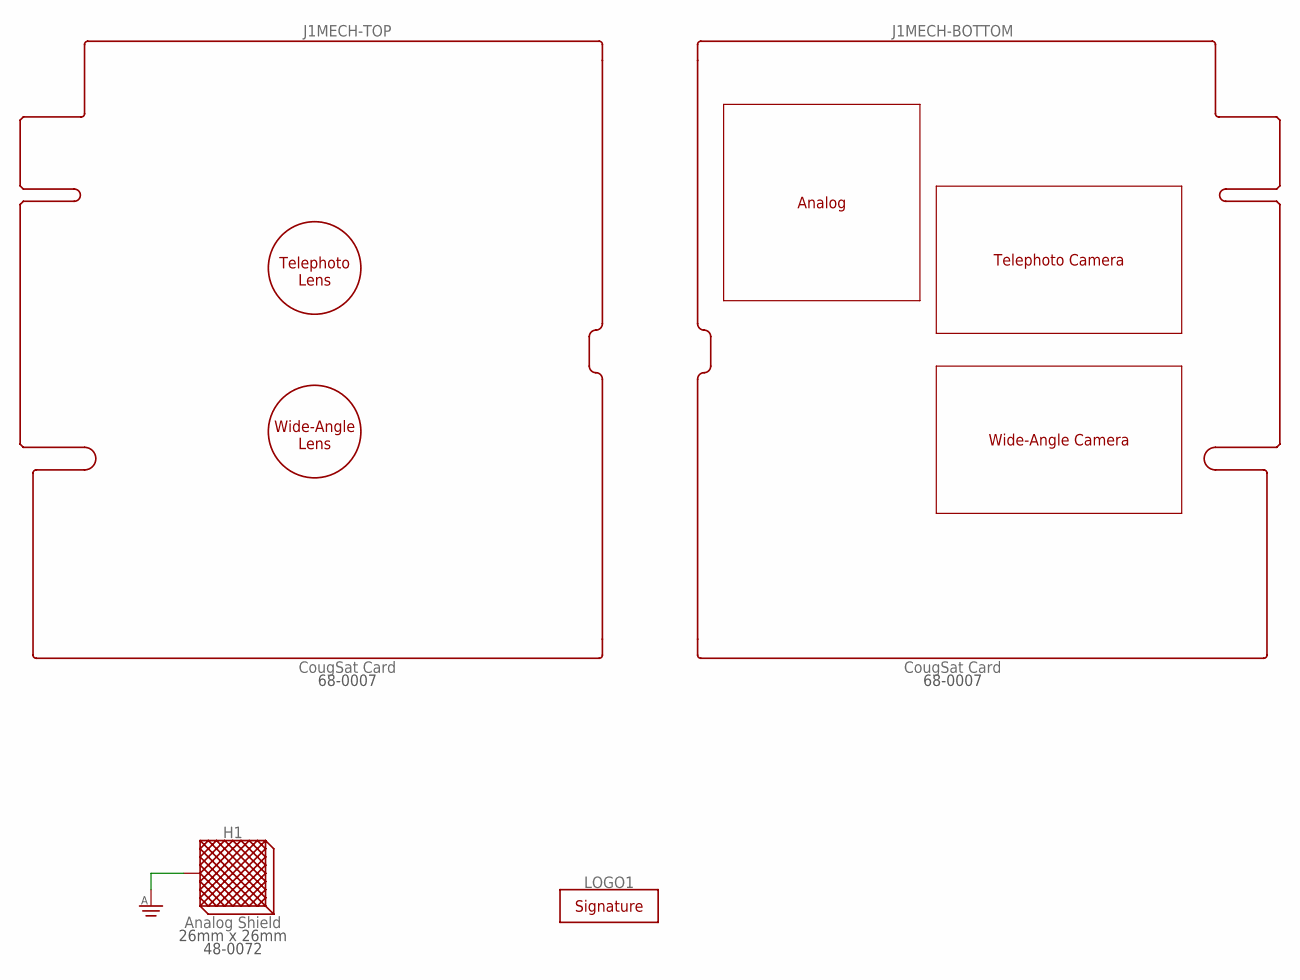
[picture p395: schematic Payload-Camera.sch, sheet 6]

Parts:
H1: Analog Shield; SHIELD-2626
J1: CougSat Card; CARD-FULL-OPEN+X
LOGO1: SIGNATUREHENDRIK; SIGN-HENDRIK

Connections:
AGND: H1.1, H1.2, H1.3, H1.4, H1.5, H1.6, H1.7, H1.8, H1.9, H1.10, H1.11, H1.12, H1.13, H1.14, H1.15, H1.16, H1.17, H1.18, H1.19, H1.20; also elsewhere on the board
PR_3.3V-1: J1.A2 (PR_3.3V-1), J1.B2 (PR_3.3V-1)
PR_3.3V-2: J1.A3 (PR_3.3V-2), J1.B3 (PR_3.3V-2)
PR_3.3V-3: J1.A4 (PR_3.3V-3), J1.B4 (PR_3.3V-3)
PR_3.3V-4: J1.A5 (PR_3.3V-4), J1.B5 (PR_3.3V-4)
PR_3.3V-5: J1.A6 (PR_3.3V-5), J1.B6 (PR_3.3V-5)
PR_3.3V-6: J1.A7 (PR_3.3V-6), J1.B7 (PR_3.3V-6)
PR_3.3V-7: J1.A8 (PR_3.3V-7), J1.B8 (PR_3.3V-7)
PR_3.3V-8: J1.A9 (PR_3.3V-8), J1.B9 (PR_3.3V-8)
PR_3.3V-9: J1.A10 (PR_3.3V-9), J1.B10 (PR_3.3V-9)
PR_BATT-0: J1.A14 (PR_BATT-0), J1.B14 (PR_BATT-0)
PR_BATT-1: J1.A15 (PR_BATT-1), J1.B15 (PR_BATT-1)
PR_BATT-2: J1.A16 (PR_BATT-2), J1.B16 (PR_BATT-2)
PR_BATT-3: J1.A17 (PR_BATT-3), J1.B17 (PR_BATT-3)
PR_BATT-4: J1.A18 (PR_BATT-4), J1.B18 (PR_BATT-4)
PR_BATT-5: J1.A19 (PR_BATT-5), J1.B19 (PR_BATT-5)
PR_BATT-6: J1.A20 (PR_BATT-6), J1.B20 (PR_BATT-6)

Notes on the sheet:
Analog
Telephoto Camera
Wide-Angle Camera
Telephoto Lens
Wide-Angle Lens

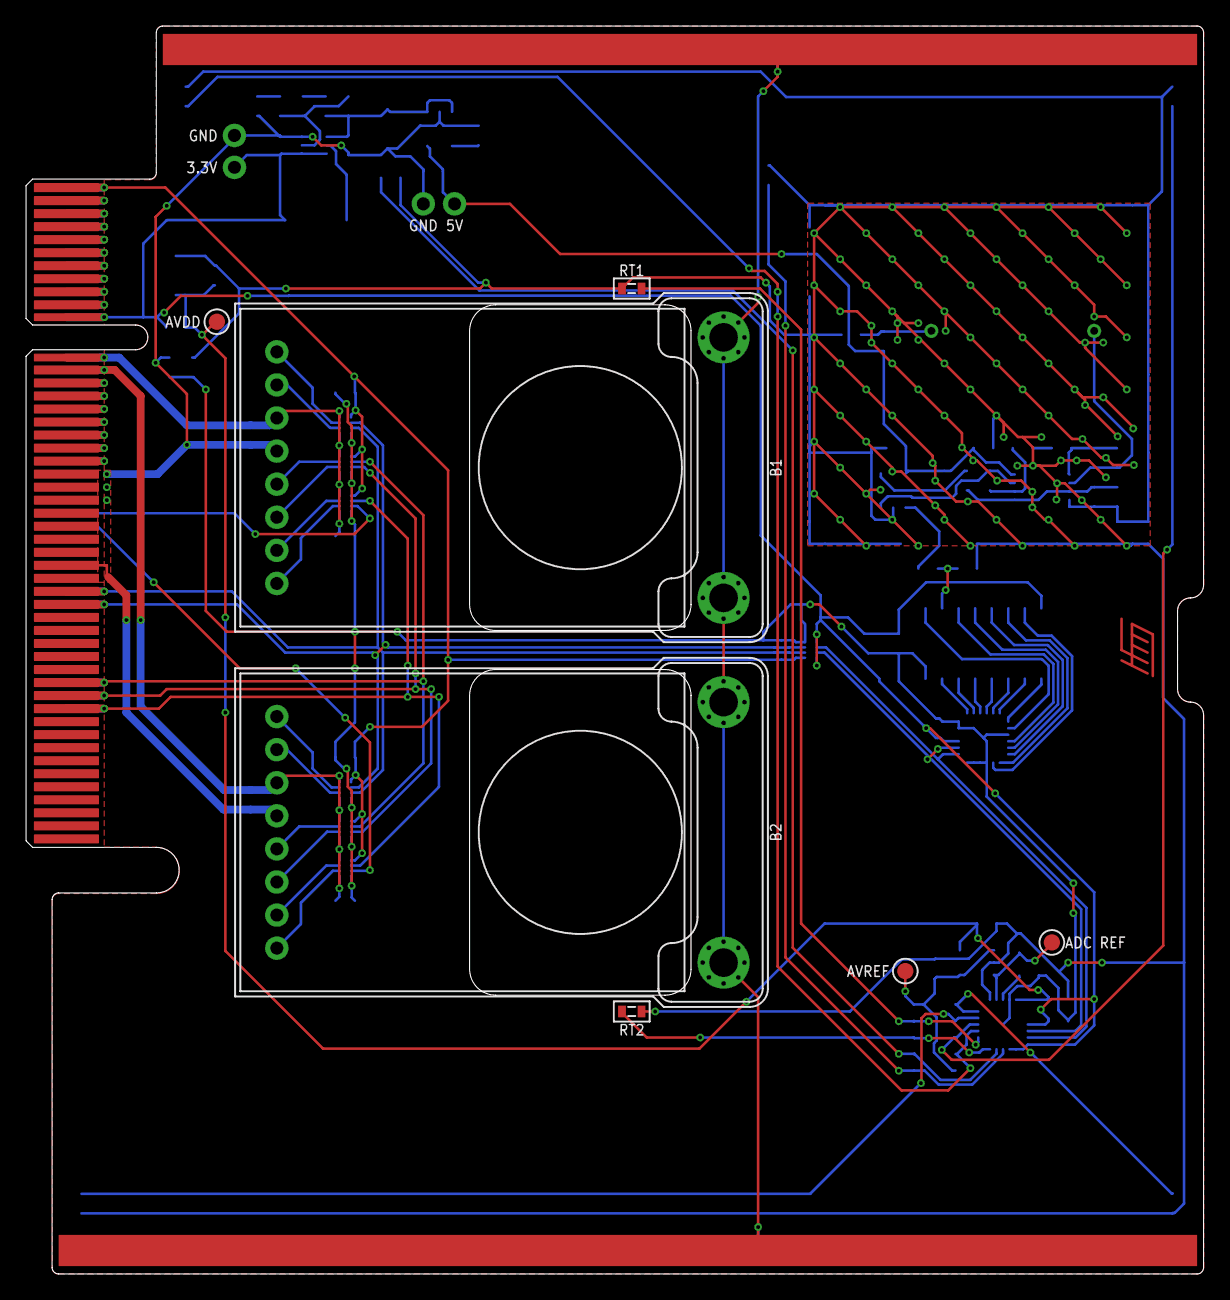
[picture p396: board Payload-Camera.brd from above]

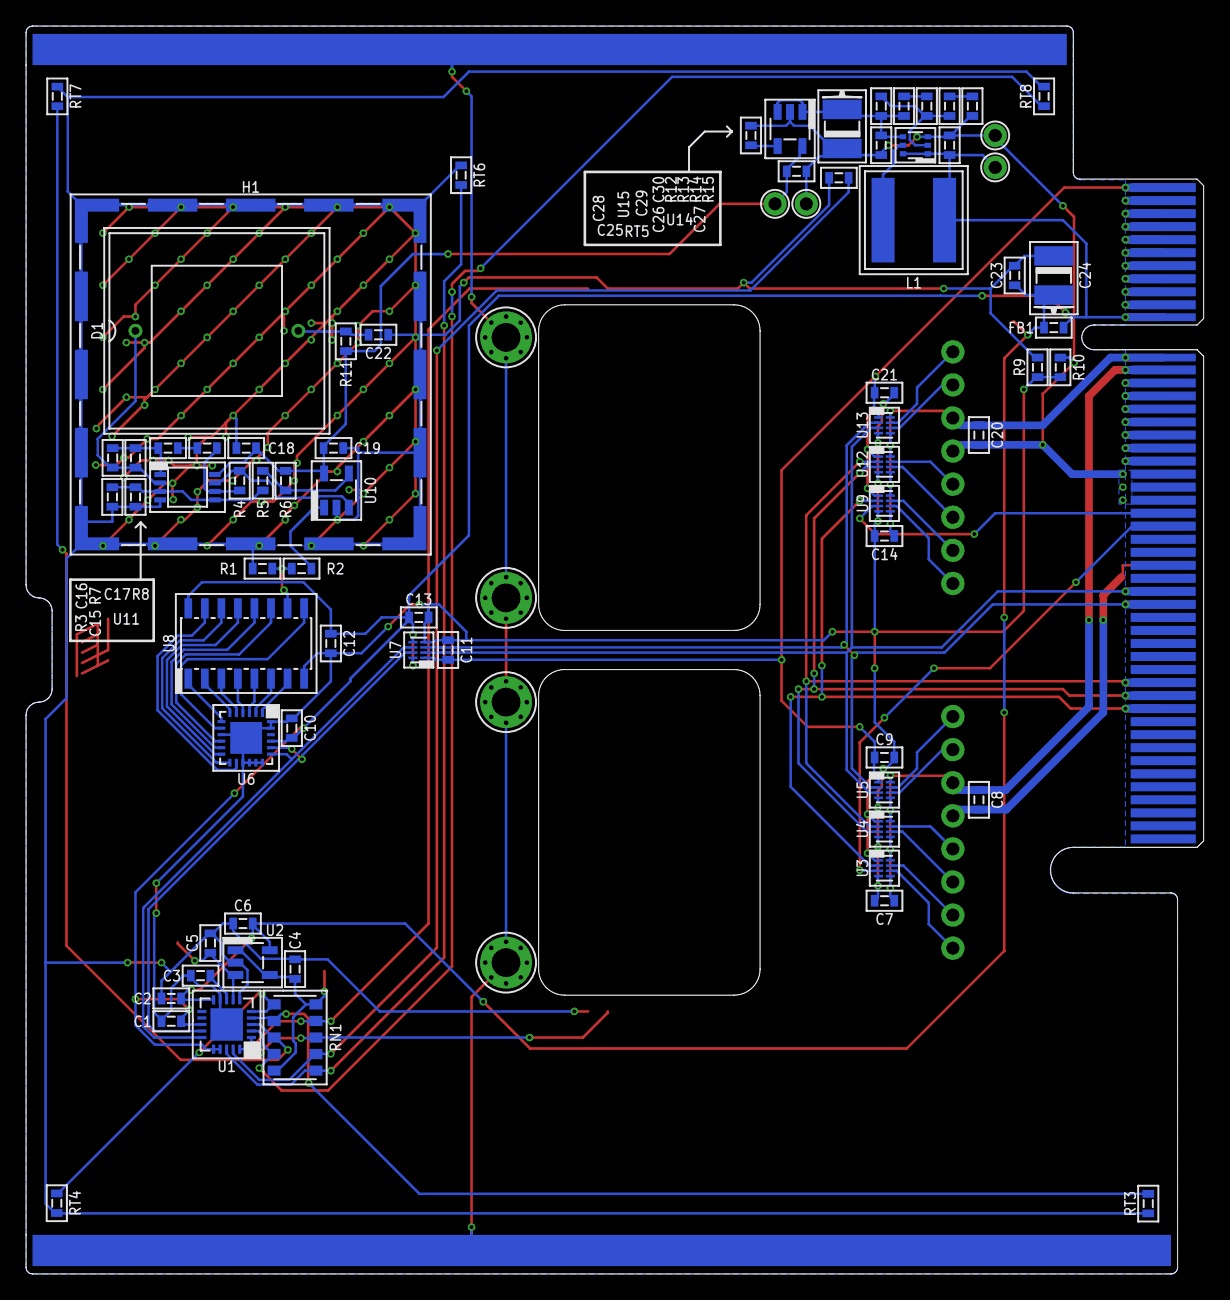
[picture p397: board Payload-Camera.brd from below]

Board: 2 copper layers, 90.4 x 95.8 mm, 84 parts (75 on the bottom side), 87 nets.
