CougsInSpace/CougSat1-Hardware/CougSat1-Umbilical/ElectricalDesign/Umbilical.brd

## EAGLE design CougSat1-Umbilical/ElectricalDesign/Umbilical.brd (2019-09-26)

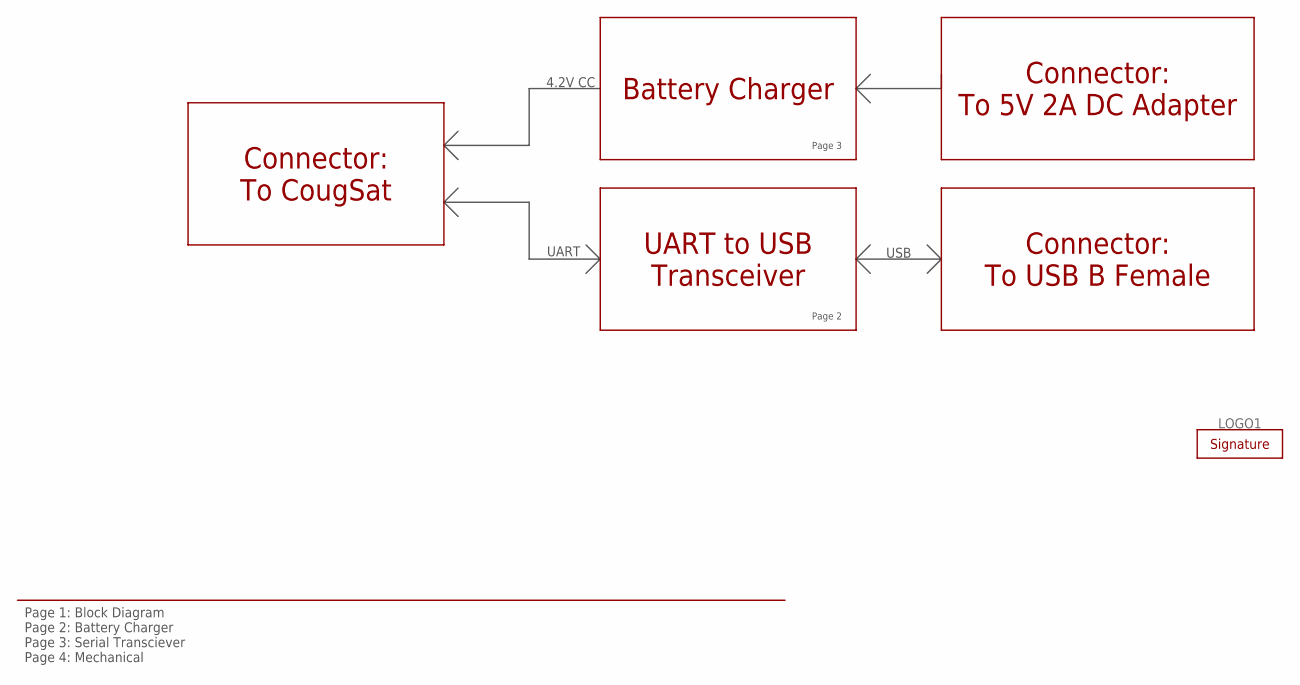
[picture p398: schematic Umbilical.sch, sheet 1]

Parts:
LOGO1: SIGNATUREJAYSON; SIGN-JAYSON

Notes on the sheet:
Page 1: Block Diagram Page 2: Battery Charger Page 3: Serial Transciever Page 4: Mechanical
Connector: To CougSat
Battery Charger
UART to USB Transceiver
Connector: To 5V 2A DC Adapter
Connector: To USB B Female
4.2V CC
UART
USB
Page 2
Page 3

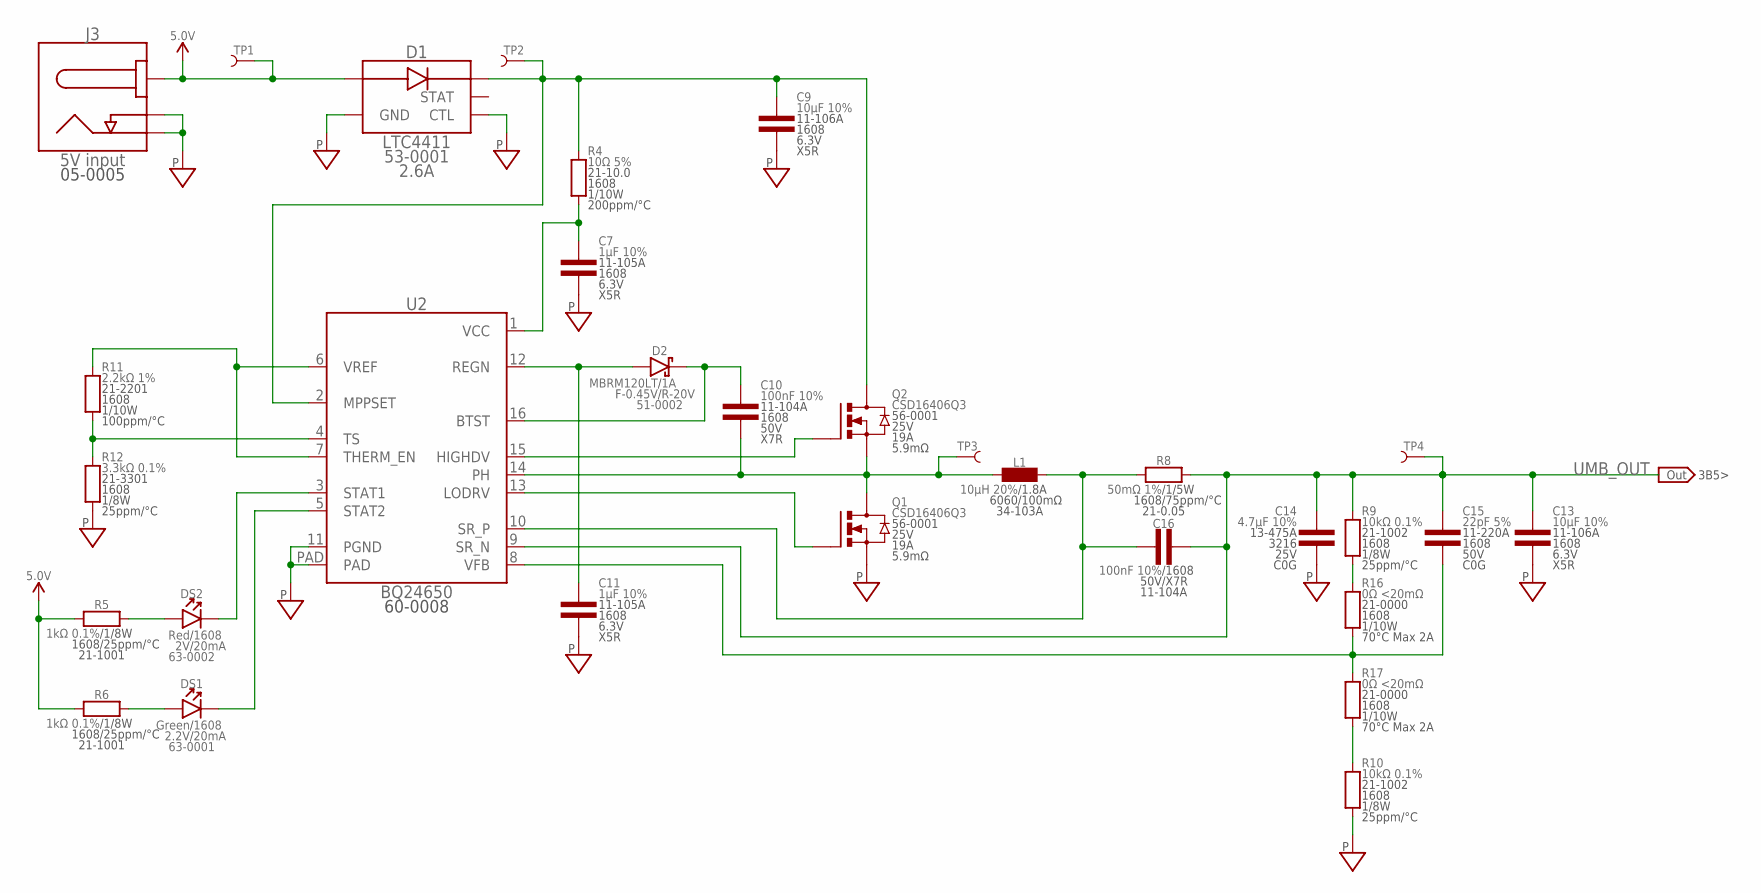
[picture p399: schematic Umbilical.sch, sheet 2]

Parts:
C7, C11: 1µF 10%; 1608
C9, C13: 10µF 10%; 1608
C10, C16: 100nF 10%; 1608
C14: 4.7µF 10%; 3216
C15: 22pF 5%; 1608
D1: LTC4411; SOT23-5
D2: MBRM120LT; POWERMITE
DS1: Green; 1608-POL
DS2: Red; 1608-POL
J3: 5V input; BARREL-2.1X5.5-R
L1: 10µH 20%; 6060
Q1, Q2: CSD16406Q3; SON-3333
R4: 10Ω 5%; 1608
R5, R6: 1kΩ 0.1%; 1608
R8: 50mΩ 1%; 1608
R9, R10: 10kΩ 0.1%; 1608
R11: 2.2kΩ 1%; 1608
R12: 3.3kΩ 0.1%; 1608
R16, R17: 0Ω <20mΩ; 1608
TP1, TP2, TP3, TP4: TEST_POINT-THT-1.0; THT-1.0
U2: BQ24650; QFN-16-3535

Connections:
5.0V: D1.1 (IN), J3.1 (CENTER), R5.1, R6.1, TP1.1
BTST: C10.1, D2.C, U2.16 (BTST)
CHARGING_STAT_G: DS1.C, U2.5 (STAT2)
CHARGING_STAT_G_LED: DS1.A, R6.2
CHARGING_STAT_R: DS2.C, U2.3 (STAT1)
CHARGING_STAT_R_LED: DS2.A, R5.2
DIODE_OUT: C9.1, D1.5 (OUT), Q2.5 (D), Q2.6 (D), Q2.7 (D), Q2.8 (D), Q2.PAD (D), R4.2, TP2.1, U2.2 (MPPSET)
FEEDBACK_HIGH: R9.1, R16.2
FEEDBACK_LOW: R10.2, R17.1
HIGHDV: Q2.4 (G), U2.15 (HIGHDV)
LODRV: Q1.4 (G), U2.13 (LODRV)
PGND: C7.2, C9.2, C11.2, C13.2, C14.2, D1.2 (GND), D1.3 (CTL), J3.2 (SLEEVE), J3.3 (SW), Q1.1 (S), Q1.2 (S), Q1.3 (S), R10.1, R12.1, U2.11 (PGND), U2.PAD; also elsewhere on the board
PH: C10.2, L1.1, Q1.5 (D), Q1.6 (D), Q1.7 (D), Q1.8 (D), Q1.PAD (D), Q2.1 (S), Q2.2 (S), Q2.3 (S), TP3.1, U2.14 (PH)
REGN: C11.1, D2.A, U2.12 (REGN)
SR_P: C16.1, L1.2, R8.1, U2.10 (SR_P)
TS: R11.1, R12.2, U2.4 (TS)
UMB_OUT: C13.1, C14.1, C15.1, C16.2, R8.2, R9.2, TP4.1, U2.9 (SR_N); also elsewhere on the board
VCC: C7.1, R4.1, U2.1 (VCC)
VFB: C15.2, R16.1, R17.2, U2.8 (VFB)
VREF: R11.2, U2.6 (VREF), U2.7 (THERM_EN)

Notes on the sheet:
3B5>

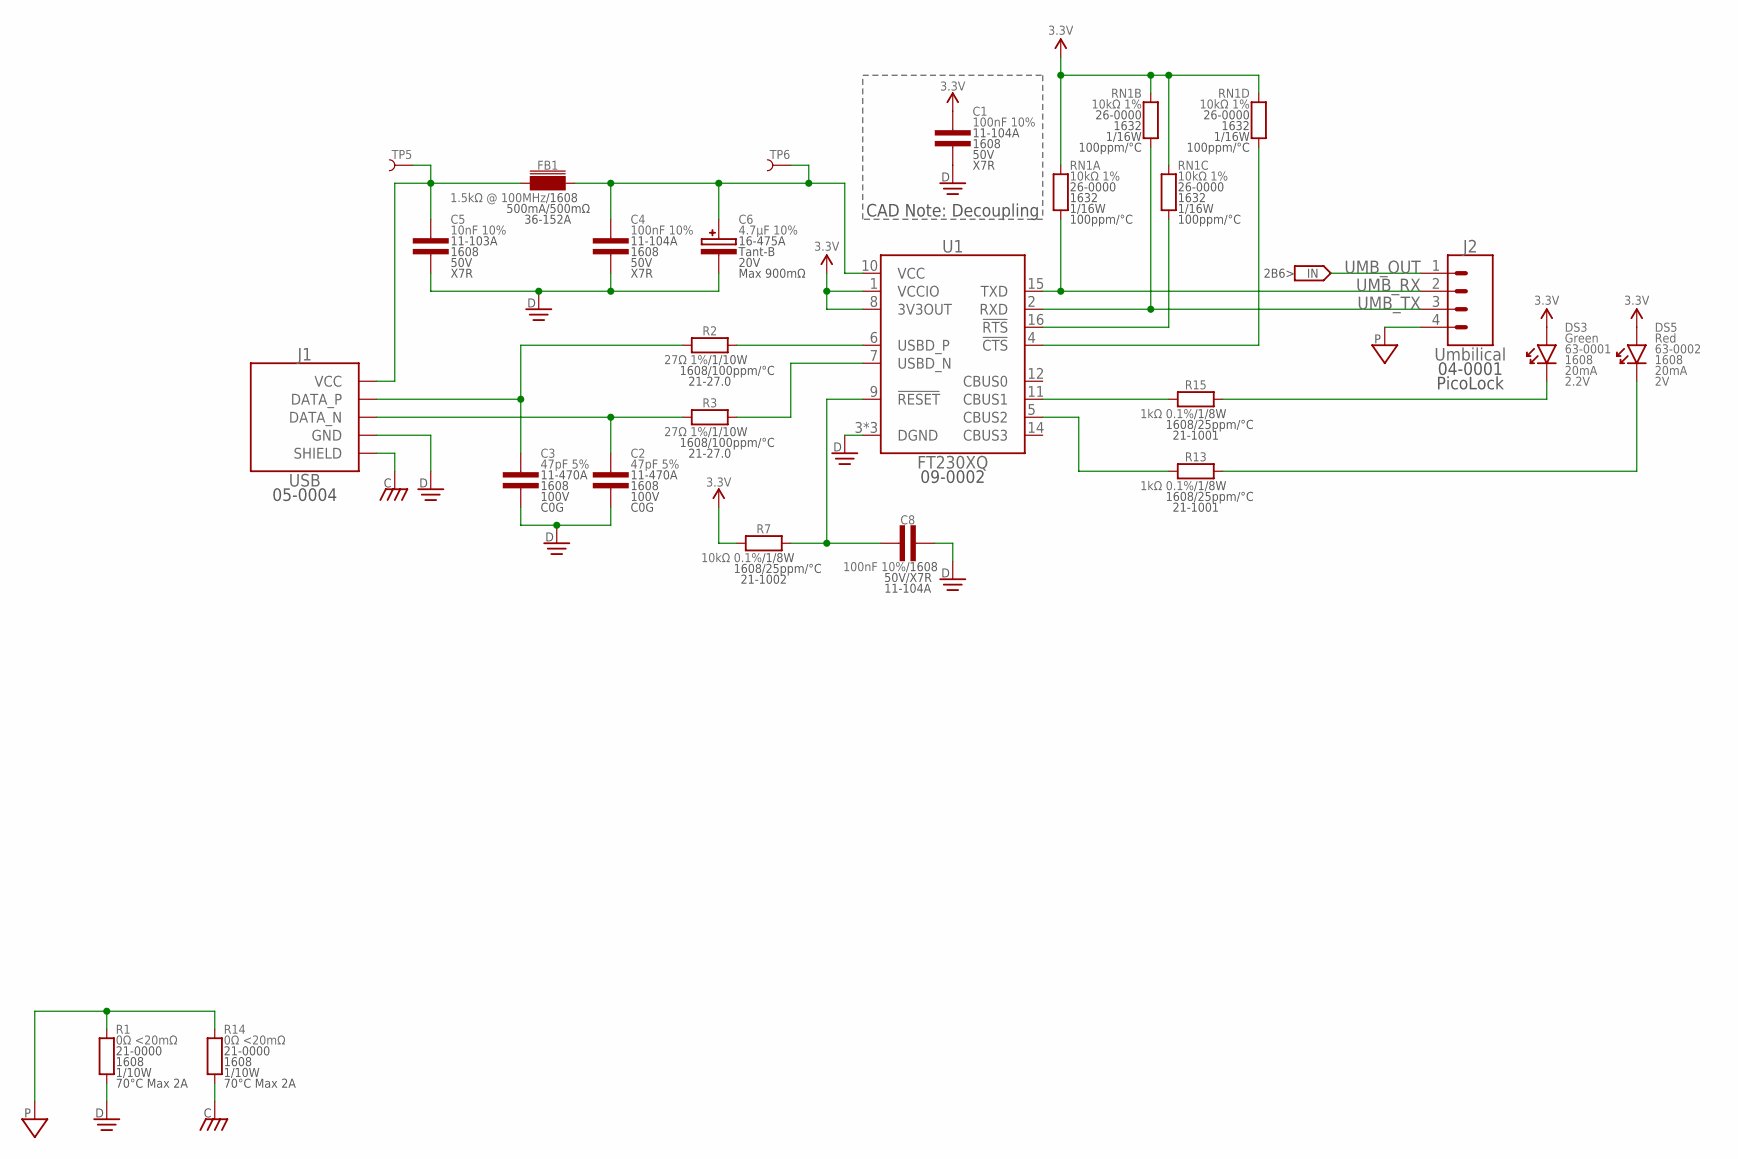
[picture p400: schematic Umbilical.sch, sheet 3]

Parts:
C1, C4, C8: 100nF 10%; 1608
C2, C3: 47pF 5%; 1608
C5: 10nF 10%; 1608
C6: 4.7µF 10%; 4028-POL
DS3: Green; 1608-POL
DS5: Red; 1608-POL
FB1: 1.5kΩ @ 100MHz; 1608
J1: USB; USB-B-FEMALE
J2: Umbilical; PICOLOCK1.5-04
R1, R14: 0Ω <20mΩ; 1608
R2, R3: 27Ω 1%; 1608
R7: 10kΩ 0.1%; 1608
R13, R15: 1kΩ 0.1%; 1608
RN1: 10kΩ 1%; 1632
TP5, TP6: TEST_POINT-THT-1.0; THT-1.0
U1: FT230XQ; QFN-16-4040

Connections:
3.3V: C1.1, DS3.A, DS5.A, R7.1, RN1.5 (2), RN1.6 (2), RN1.7 (2), RN1.8 (2), U1.1 (VCCIO), U1.8 (3V3OUT)
!CTS: RN1.4 (1), U1.4 (!CTS)
!RTS: RN1.3 (1), U1.16 (!RTS)
CBUS1: R15.1, U1.11 (CBUS1)
CBUS2: R13.1, U1.5 (CBUS2)
CHASSIS: J1.SHIELD@1 (SHIELD), J1.SHIELD@2 (SHIELD), R14.1
DGND: C1.2, C2.2, C3.2, C4.2, C5.2, C6.C, C8.2, J1.4 (GND), R1.1, U1.3 (DGND), U1.13 (DGND), U1.PAD (DGND)
PGND: J2.4, R1.2, R14.2; also elsewhere on the board
RXLED_C: DS5.C, R13.2
TXLED_C: DS3.C, R15.2
UMB_OUT: J2.1; also elsewhere on the board
UMB_RX: J2.2, RN1.1, U1.15 (TXD)
UMB_TX: J2.3, RN1.2 (1), U1.2 (RXD)
USB5V: C5.1, FB1.1, J1.1 (VCC), TP5.1
USB5V_FILTERED: C4.1, C6.A, FB1.2, TP6.1, U1.10 (VCC)
USB_CONN_N: C2.1, J1.2 (DATA_N), R3.1
USB_CONN_P: C3.1, J1.3 (DATA_P), R2.1
USB_N: R3.2, U1.7 (USBD_N)
USB_P: R2.2, U1.6 (USBD_P)
USB_RESET: C8.1, R7.2, U1.9 (!RESET)

Notes on the sheet:
CAD Note: Decoupling
2B6>

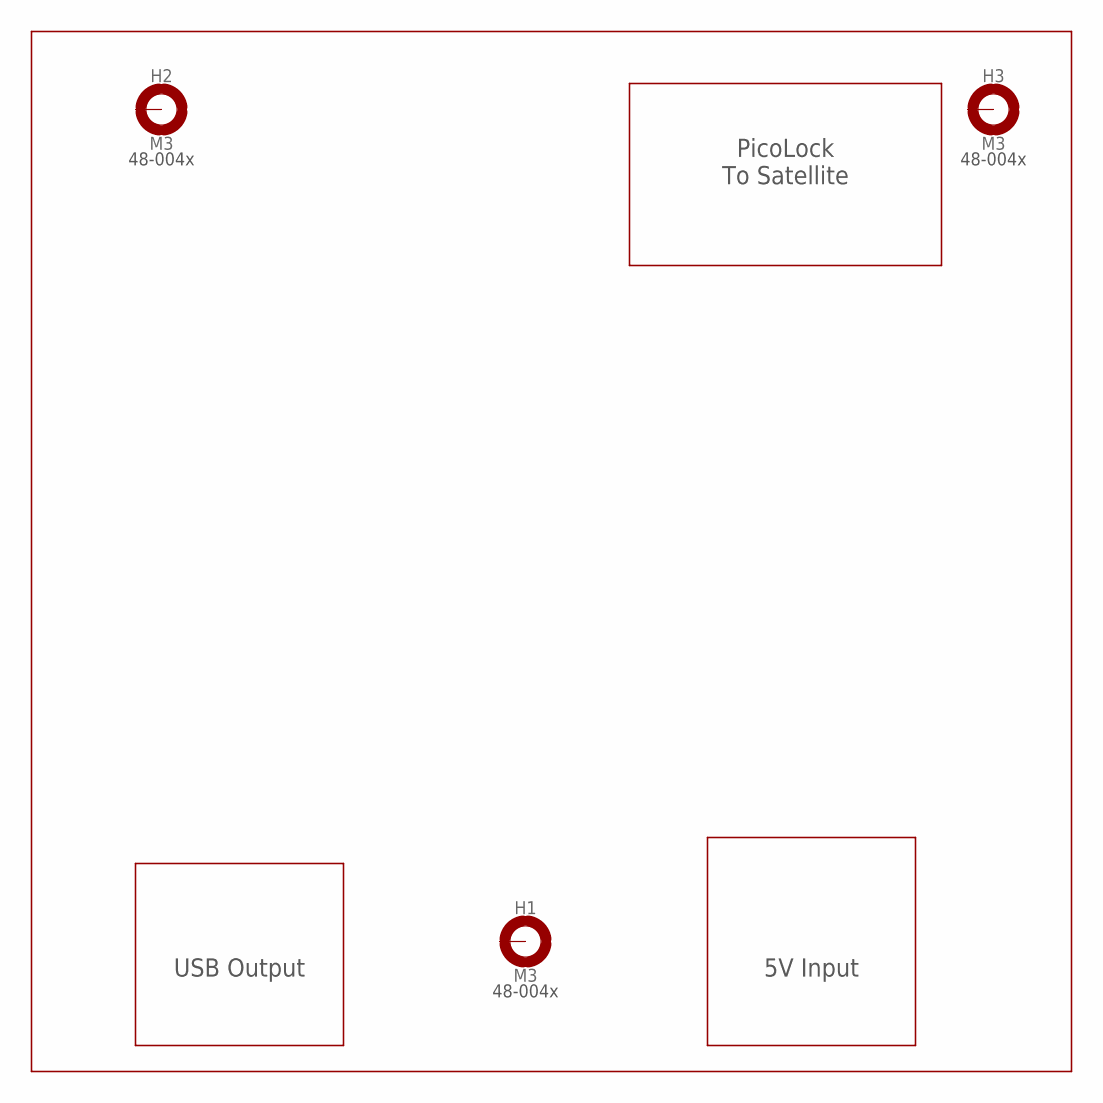
[picture p401: schematic Umbilical.sch, sheet 4]

Parts:
H1, H2, H3: M3; MOUNTING_HOLE-3.3

Notes on the sheet:
PicoLock To Satellite
5V Input
USB Output

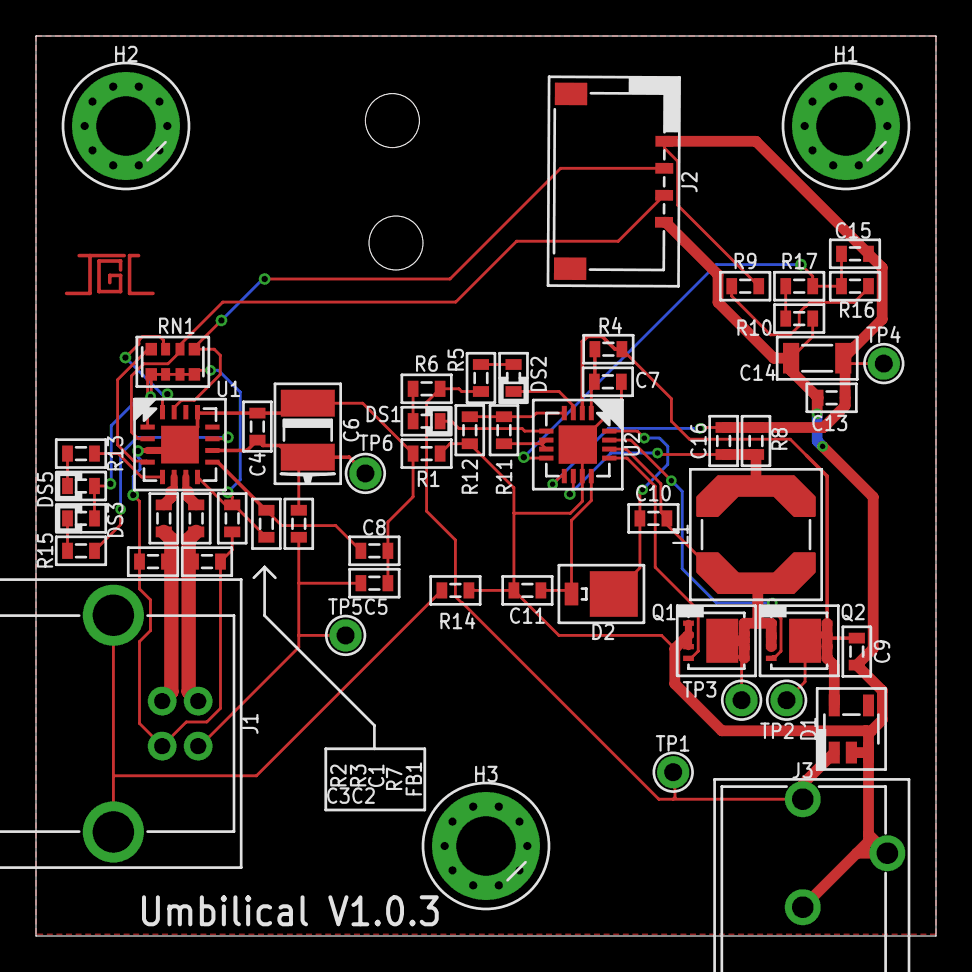
[picture p402: board Umbilical.brd from above]

Board: 2 copper layers, 50.0 x 50.0 mm, 58 parts (0 on the bottom side), 38 nets.
