CougsInSpace/CougSat1-Hardware/CougSat1-Backplane/ElectricalDesign/Breakout.brd

## EAGLE design CougSat1-Backplane/ElectricalDesign/Breakout.brd (2019-06-06)

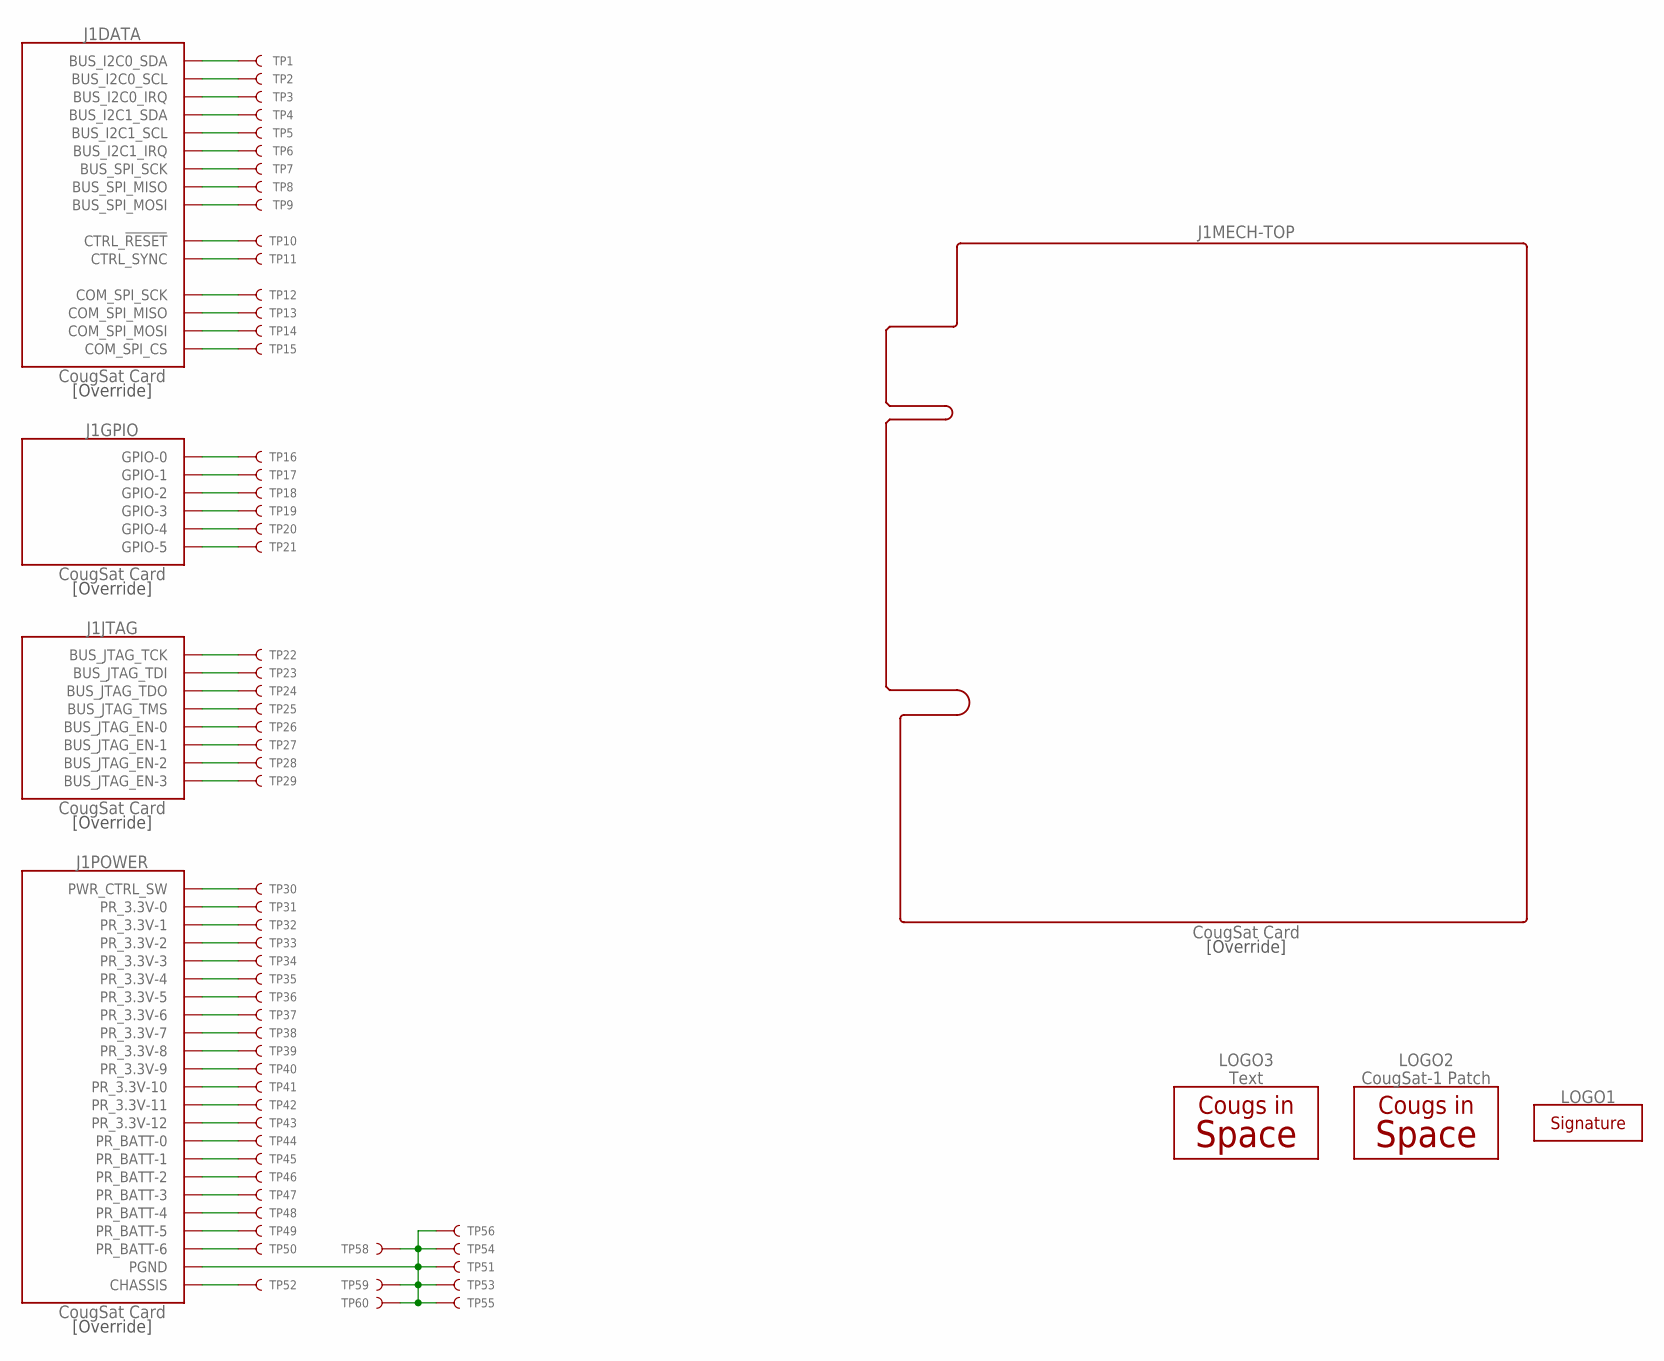
[picture p403: schematic Breakout.sch]

Parts:
J1: CougSat Card; CARD-FULL
LOGO1: SIGNATUREHENDRIK; SIGN-HENDRIK
LOGO2: CougSat-1 Patch; CIS-PATCH-1
LOGO3: Text; CIS-TEXT
TP1, TP2, TP3, TP4, TP5, TP6, TP7, TP8, TP9, TP10, TP11, TP12, TP13, TP14, TP15, TP16, TP17, TP18, TP19, TP20, TP21, TP22, TP23, TP24, TP25, TP26, TP27, TP28, TP29, TP30, TP31, TP32, TP33, TP34, TP35, TP36, TP37, TP38, TP39, TP40, TP41, TP42, TP43, TP44, TP45, TP46, TP47, TP48, TP49, TP50, TP51, TP52, TP53, TP54, TP55, TP56, TP58, TP59, TP60: TEST_POINT-THT-1.0; THT-1.0

Connections:
BUS_12C0_IRQ: J1.A45 (BUS_I2C0_IRQ), J1.B45 (BUS_I2C0_IRQ), TP3.1
BUS_12C0_SCL: J1.A44 (BUS_I2C0_SCL), J1.B44 (BUS_I2C0_SCL), TP2.1
BUS_12C0_SDA: J1.A43 (BUS_I2C0_SDA), J1.B43 (BUS_I2C0_SDA), TP1.1
BUS_12C1_IRQ: J1.A32 (BUS_I2C1_IRQ), J1.B32 (BUS_I2C1_IRQ), TP6.1
BUS_12C1_SCL: J1.A31 (BUS_I2C1_SCL), J1.B31 (BUS_I2C1_SCL), TP5.1
BUS_12C1_SDA: J1.A30 (BUS_I2C1_SDA), J1.B30 (BUS_I2C1_SDA), TP4.1
BUS_JTAG_EN-0: J1.B46 (BUS_JTAG_EN-0), TP26.1
BUS_JTAG_EN-1: J1.B47 (BUS_JTAG_EN-1), TP27.1
BUS_JTAG_EN-2: J1.B48 (BUS_JTAG_EN-2), TP28.1
BUS_JTAG_EN-3: J1.B49 (BUS_JTAG_EN-3), TP29.1
BUS_JTAG_TCK: J1.A46 (BUS_JTAG_TCK), TP22.1
BUS_JTAG_TDI: J1.A47 (BUS_JTAG_TDI), TP23.1
BUS_JTAG_TDO: J1.A48 (BUS_JTAG_TDO), TP24.1
BUS_JTAG_TMS: J1.A49 (BUS_JTAG_TMS), TP25.1
BUS_SPI_MISO: J1.A38 (BUS_SPI_MISO), J1.B38 (BUS_SPI_MISO), TP8.1
BUS_SPI_MOSI: J1.A39 (BUS_SPI_MOSI), J1.B39 (BUS_SPI_MOSI), TP9.1
BUS_SPI_SCK: J1.A37 (BUS_SPI_SCK), J1.B37 (BUS_SPI_SCK), TP7.1
CHASSIS: J1.CHASSIS@1 (CHASSIS), J1.CHASSIS@2 (CHASSIS), J1.CHASSIS@3 (CHASSIS), J1.CHASSIS@4 (CHASSIS), TP52.1
COM_SPI_CS: J1.A36 (COM_SPI_CS), J1.B36 (COM_SPI_CS), TP15.1
COM_SPI_MISO: J1.A34 (COM_SPI_MISO), J1.B34 (COM_SPI_MISO), TP13.1
COM_SPI_MOSI: J1.A35 (COM_SPI_MOSI), J1.B35 (COM_SPI_MOSI), TP14.1
COM_SPI_SCK: J1.A33 (COM_SPI_SCK), J1.B33 (COM_SPI_SCK), TP12.1
CTRL_RESET: J1.A41 (CTRL_!RESET), J1.B41 (CTRL_!RESET), TP10.1
CTRL_SYNC: J1.A42 (CTRL_SYNC), J1.B42 (CTRL_SYNC), TP11.1
GPIO-0: J1.A24 (GPIO-0), TP16.1
GPIO-1: J1.A25 (GPIO-1), TP17.1
GPIO-2: J1.A26 (GPIO-2), TP18.1
GPIO-3: J1.A27 (GPIO-3), TP19.1
GPIO-4: J1.A28 (GPIO-4), TP20.1
GPIO-5: J1.A29 (GPIO-5), TP21.1
PGND: J1.A21 (PGND), J1.A22 (PGND), J1.A23 (PGND), J1.B21 (PGND), J1.B22 (PGND), J1.B23 (PGND), J1.B24 (PGND), J1.B25 (PGND), J1.B26 (PGND), J1.B27 (PGND), J1.B28 (PGND), J1.B29 (PGND), TP51.1, TP53.1, TP54.1, TP55.1, TP56.1, TP58.1, TP59.1, TP60.1
PR_3.3V-0: J1.A1 (PR_3.3V-0), J1.B1 (PR_3.3V-0), TP31.1
PR_3.3V-1: J1.A2 (PR_3.3V-1), J1.B2 (PR_3.3V-1), TP32.1
PR_3.3V-2: J1.A3 (PR_3.3V-2), J1.B3 (PR_3.3V-2), TP33.1
PR_3.3V-3: J1.A4 (PR_3.3V-3), J1.B4 (PR_3.3V-3), TP34.1
PR_3.3V-4: J1.A5 (PR_3.3V-4), J1.B5 (PR_3.3V-4), TP35.1
PR_3.3V-5: J1.A6 (PR_3.3V-5), J1.B6 (PR_3.3V-5), TP36.1
PR_3.3V-6: J1.A7 (PR_3.3V-6), J1.B7 (PR_3.3V-6), TP37.1
PR_3.3V-7: J1.A8 (PR_3.3V-7), J1.B8 (PR_3.3V-7), TP38.1
PR_3.3V-8: J1.A9 (PR_3.3V-8), J1.B9 (PR_3.3V-8), TP39.1
PR_3.3V-9: J1.A10 (PR_3.3V-9), J1.B10 (PR_3.3V-9), TP40.1
PR_3.3V-10: J1.A11 (PR_3.3V-10), J1.B11 (PR_3.3V-10), TP41.1
PR_3.3V-11: J1.A12 (PR_3.3V-11), J1.B12 (PR_3.3V-11), TP42.1
PR_3.3V-12: J1.A13 (PR_3.3V-12), J1.B13 (PR_3.3V-12), TP43.1
PR_BATT-0: J1.A14 (PR_BATT-0), J1.B14 (PR_BATT-0), TP44.1
PR_BATT-1: J1.A15 (PR_BATT-1), J1.B15 (PR_BATT-1), TP45.1
PR_BATT-2: J1.A16 (PR_BATT-2), J1.B16 (PR_BATT-2), TP46.1
PR_BATT-3: J1.A17 (PR_BATT-3), J1.B17 (PR_BATT-3), TP47.1
PR_BATT-4: J1.A18 (PR_BATT-4), J1.B18 (PR_BATT-4), TP48.1
PR_BATT-5: J1.A19 (PR_BATT-5), J1.B19 (PR_BATT-5), TP49.1
PR_BATT-6: J1.A20 (PR_BATT-6), J1.B20 (PR_BATT-6), TP50.1
PWR_CTRL_SW: J1.A40 (PWR_CTRL_SW), J1.B40 (PWR_CTRL_SW), TP30.1
