CougsInSpace/CougSat1-Hardware/CougSat1-Backplane/ElectricalDesign/Breakout.brd

## EAGLE design CougSat1-Backplane/ElectricalDesign/Breakout.brd (continued)

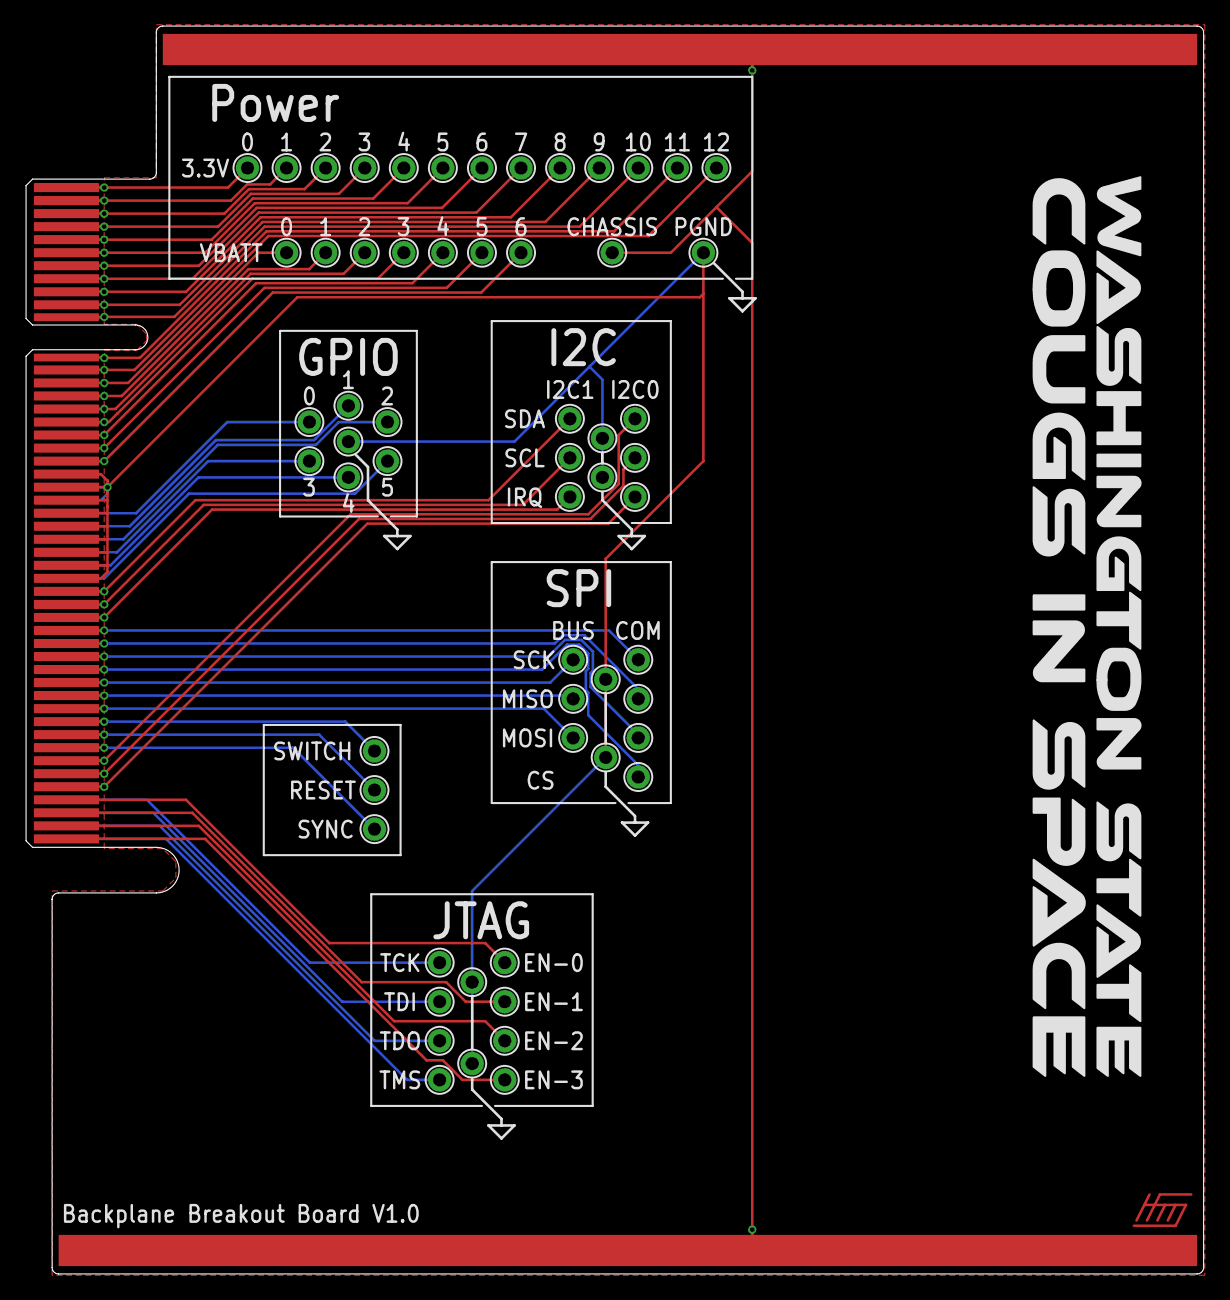
[picture p404: board Breakout.brd from above]

Board: 2 copper layers, 90.4 x 95.8 mm, 63 parts (1 on the bottom side), 52 nets.
