CougsInSpace/CougSat1-Hardware/CougSat1-AvionicBoard/Documentation/Native/ADCS.ioc

Mcu.UserName=STM32L476RGTx
PA0.Signal=S_TIM2_CH1
PA1.Signal=S_TIM2_CH2
PA10.Signal=USART1_RX
PA11.Signal=S_TIM1_CH4
PA2.Signal=S_TIM2_CH3
PA3.Signal=S_TIM2_CH4
PA8.Signal=S_TIM1_CH1
PA9.Signal=USART1_TX
PB10.Signal=I2C2_SCL
PB11.Signal=I2C2_SDA
PB6.Signal=I2C1_SCL
PB7.Signal=I2C1_SDA
PC0.Signal=I2C3_SCL
PC1.Signal=I2C3_SDA
