CougsInSpace/CougSat1-Hardware/(commit log)

2018-04-29 Redistrubuted Energy for Static Panels
    [EnergyBudget.xlsx]
2018-05-12 Updated Card Standard
    [CardRailStandard.ipt, CardStandard.idw, CardStandard.ipt]
2018-05-12 Added Sheet for Safe Mode
    [EnergyBudget.xlsx]
2018-05-25 Created Solar Panel Block Diagram
    Fixes #67
    [SolarPanel.brd, SolarPanel.sch]
2018-05-25 Created Block Diagram
    [EPS.sch, Power.brd, Power.sch]
2018-05-27 Added Power Rails Sheet and Removed 5V Regulator
    [EPS.sch]
2018-05-27 Updated Energy Uses
    [EnergyBudget.xlsx]
2018-05-27 Updated Diagram Symbols
    [SolarPanel.sch]
2018-05-28 Redistributed Backplane Connections
    [ElectricalBusAllocation.xlsx]
2018-05-28 Adjusted Power Rail Channel Current Rating
    [EPS.sch]
2018-05-29 Added Independant Solar Cell Input
    [EPS.sch]
2018-05-29 Added Independant Cell Output and Temperature Monitoring
    [SolarPanel.sch]
2018-05-29 Created CAD and RBF Pin Mount
    [CardPower.iam, CardPower_PCB.ipt, EPS.iam, EPS_PCB.ipt, EPS_RBFPinHolder.ipt]
2018-05-30 Moved RBF Switch to Reversed Side
    [EPS.iam, EPS_PCB.ipt, EPS_RBFPinHolder.ipt, EPS_SwitchNut.ipt]
2018-06-03 Fixed Typo
    I2C1's SDA and SCL were swapped on the BusDescription page
    [ElectricalBusAllocation.xlsx]
2018-06-04 Added Umbilical Connector
    [EPS.Harness.iam, EPS.Harness.ipt, EPS.iam, EPS_BatteryTab.ipt, EPS_BatteyTie.ipt, EPS_PCB.ipt]
2018-06-04 Exported CAD to STEP
2018-06-05 Placed Key Mechanical Components
    [EPS.Harness.iam, EPS.Harness.ipt, EPS.brd, EPS.iam, EPS.sch, EPS_PCB.ipt, EPS_RBFPinHolder.ipt]
2018-06-08 Create Solar Panel CAD
    [SolarPanel.iam, SolarPanel_CoilForm.ipt, SolarPanel_PCB.ipt]
2018-06-09 Added Balance Switching and Battery Protection
    [EPS.brd, EPS.sch]
2018-06-10 Added Separation Switching
    [EPS.brd, EPS.sch]
2018-06-10 Replaced MOSFETs with Dual MOSFETs
    [EPS.brd, EPS.sch]
2018-06-11 Split Sheet 3 Into 3 & 4
    [EPS.brd, EPS.sch]
2018-06-12 Added 3.3V Regulation
    [EPS.brd, EPS.sch]
2018-06-12 Added CubeSat Requirements
    [CougSat1-SystemRequirements.xlsx]
2018-06-16 Added Subsystem Requirements
    [CougSat1-SystemRequirements.xlsx]
2018-06-17 Added Output Switching Matrix
    [EPS.brd, EPS.sch]
2018-06-29 added an IHU requirement
    [CougSat1-SystemRequirements.xlsx]
2018-07-09 Added PMIC and All GPIO
    [EPS.brd, EPS.sch]
2018-07-12 Refactored Spreadsheet
    [CougSat1-Requirements.xlsx, CougSat1-SystemRequirements.xlsx]
2018-07-14 Added System Requirements and EPS Design Requirements
    [CougSat1-Requirements.xlsx]
2018-07-17 Change RCS to Comms
    [CardRCS.iam, CardRCS_PCB.ipt]
2018-07-17 Changed Font to Proportional to Fix PDF Search
    [EPS.brd, EPS.sch]
2018-07-22 Added ADCs
    [EPS.brd, EPS.sch]
2018-07-22 Adjusted Cable Cutout
    [EPS.brd, EPS.sch]
2018-07-22 Added JTAG Disconnector and LEDs
    [EPS.brd, EPS.sch, EnergyBudget.xlsx]
2018-07-24 Added Switching Defaults
    [EPS.brd, EPS.sch]
2018-07-26 Wrote Schematic Documentation
    [EPS.brd, EPS.sch]
2018-07-28 Added C&DH, ECS, and Structure Design Requirements
    [CougSat1-Requirements.xlsx]
2018-08-03 Wrote Comms Design Requirements
    [CougSat1-Requirements.xlsx]
2018-08-08 Placed Components in Rough Location
    [EPS.brd, EPS.sch]
2018-08-12 Added JTAG Termintation and Regulator Gate Series Resistors
    [EPS.brd, EPS.sch]
2018-08-23 Laid Out 3.3V Channels
    [EPS.brd, EPS.sch]
2018-08-24 Added ADCS and Payload Design Requirements
    [CougSat1-Requirements.xlsx]
2018-08-24 Added Ground Design Requirements
    [CougSat1-Requirements.xlsx]
2018-08-25 Laid Out All Distribution and Output Current Sensing
    [EPS.brd, EPS.sch]
2018-09-08 Laid Out Distribution Control Signals
    [EPS.brd, EPS.sch]
2018-09-11 Created Schematic File for Comms
    [Comms.sch]
2018-09-11 Fixed PAYLOAD-004 Reasoning
    [CougSat1-Requirements.xlsx]
2018-09-14 Played With Laser Calculations
    [CougSat1-PayloadCalculations.xlsx]
2018-09-14 Updated I²C Addresses
    [EPS.brd, EPS.sch]
2018-09-15 Laid Out Voltage ADC
    [EPS.brd, EPS.sch]
2018-09-15 Laid Out 3V3A Regulator
    [EPS.brd, EPS.sch]
2018-09-16 Created Schematic for Solar Panel Board
    [SolarPanel.brd, SolarPanel.sch]
2018-09-16 Revert "Created Schematic for Solar Panel Board"
    This reverts commit 2ca5e56b656e20597a97aaec5b86eb3fadf17f80.
    [SolarPanel.brd, SolarPanel.sch]
2018-09-16 Revert "Revert "Created Schematic for Solar Panel Board""
    This reverts commit ee51c553cfecec04df470319fa20f089781f9e71.
    [SolarPanel.brd, SolarPanel.sch]
2018-09-17 Fixed Wrong Branch Error
    [SolarPanel.brd, SolarPanel.sch]
2018-09-17 Updated Backplane Schematic
    [Backplane.brd, Backplane.sch, ElectricalBusAllocation.xlsx]
2018-09-17 Wrote Backplane Design Document
    [Backplane.brd, Backplane.sch, ElectricalBusAllocation.xlsx]
2018-09-17 Created Umbilical Block Diagram
    [Umbilical.sch]
2018-09-19 Laid Out JTAG
    [EPS.brd, EPS.sch]
2018-09-20 Added Label to Block Diagram Connector
    [Backplane.sch]
2018-09-21 Added RF Diagram
    [Comms.sch]
2018-09-22 Added Power Rails
    [Comms.sch]
2018-09-22 Laid Out Regulator B
    [EPS.brd, EPS.sch]
2018-09-22 Laid Out Rest of Traces
    [EPS.brd, EPS.sch]
2018-09-23 Fixed Off Schematic Layout
    Fitting onto one page and off sheet connectors
    [EPS.brd, EPS.sch]
2018-09-23 Created Ground Station Block Diagram
    [CommicationBudget.xlsx, GroundStation.sch]
2018-09-23 Added Copper Balancing
    [EPS.brd]
2018-09-23 Created Avionics Board Block Diagram V1.0
    Took a second look at the block diagram to ensure necessary components were included.
    [Avionics Block Diagram V1.0.sch, Avionics.brd, Avionics.sch]
2018-09-24 Added C&DH and IFJR Block Diagram
    [Avionics.sch]
2018-09-24 Fixed Version Number
    [Avionics.sch]
2018-09-24 Specified IFJR is a µController
    [Avionics.sch]
2018-09-24 Created +X Panel Block Diagram
    [+XPanel.sch]
2018-09-25 Analyzed Link Budget
    [CommicationBudget.xlsx, GroundStation.sch, Link Budget.xlsx]
2018-09-27 Created Helical Antenna
    [Ground.iam, Ground_Antenna230mm.iam, Ground_Antenna230mm_Helix.ipt, Ground_Antenna230mm_Reflector.ipt, Ground_Antenna230mm_Support.ipt, Ground_Antenna700mm.iam, Ground_Antenna700mm_Helix.ipt, Ground_Antenna700mm_Reflector.ipt]
2018-09-29 Fixed Reference Designators and Length Matching
    [EPS.brd, EPS.sch]
2018-09-29 Generated Gerber Files
2018-09-29 Updated PCB CAD
    [EPS_PCB.ipt]
2018-09-29 Assembled mCAD and Fixed Reference Designator Location
    [EPS.brd, EPS_BatteryHeatsink.ipt, EPS_PCB.ipt, EPS_RBFPinHolder.ipt, EPS_RegulatorHeatsink-A.ipt, EPS_RegulatorHeatsink-B.ipt]
2018-10-01 Moved CougSat-1 Files To CougSat1-Readme
    [CougSat1-BillOfMaterials.xlsx, CougSat1-MassAllocation.xlsx, CougSat1-PayloadCalculations.xlsx, CougSat1-Requirements.xlsx]
2018-10-01 Wrote Switching and Charging Tests
2018-10-03 Wrote Battery and 3.3V Regulator Tests
2018-10-04 Wrote ADC, I²C, and Programming Tests
2018-10-05 Created Solar Panel Schematic
    [SolarPanel.brd, SolarPanel.sch]
2018-10-05 Fixed Errors in Schematic
    All EPS ICs are sourced from VBATT
    [EPS.brd, EPS.sch]
2018-10-05 Switched to New Template
2018-10-06 Updated mCAD
    [EPS.sch, EPS_PCB.ipt]
2018-10-07 Created PDFs of Schematic and Documentation
    [SolarPanel.brd, SolarPanel.sch]
2018-10-07 Fixed Formatting
    [EPS.sch]
2018-10-09 Fixed Formatting and Exported Assembly Variants
    [SolarPanel.brd, SolarPanel.sch]
2018-10-14 Designed Antennas
    [Ground.iam, Ground_Antenna230mm.iam, Ground_Antenna230mm_Reflector.ipt, Ground_Antenna230mm_Support.ipt, Ground_Antenna230mm_SupportArm.ipt, Ground_Antenna700mm.iam, Ground_Antenna700mm_Helix.ipt, Ground_Antenna700mm_Reflector.ipt]
2018-10-16 Laid Out Backplane
    [Backplane.brd, Backplane.sch]
2018-10-18 Generate Gerbers
    [Backplane.brd, Backplane.sch]
2018-10-18 Created Backplane mCAD
    [Backplane.iam, Backplane_CenterNut.ipt, Backplane_PCB.ipt]
2018-10-21 Added Elevation Servo
    [Ground.iam, Ground_Antenna230mm.iam, Ground_Antenna230mm_Reflector.ipt, Ground_Antenna230mm_Support.ipt, Ground_Antenna230mm_SupportArm.ipt, Ground_Antenna700mm.iam, Ground_Antenna700mm_Reflector.ipt, Ground_Antenna700mm_Support.ipt]
2018-10-23 Added Shaft Collar and Exported to STEP
    [Ground.iam, Ground_Tracker.iam, Ground_Tracker_Bearing.ipt, Ground_Tracker_CrossTubeCollar.ipt, Ground_Tracker_ElevationGear.ipt, Ground_Tracker_ElevationPinion.ipt, Ground_Tracker_ServoMount.ipt]
2018-10-24 Changed Cutout for Solar Panel Mount
    [Backplane.brd, Backplane.iam, Backplane.sch, Backplane_PCB.ipt]
2018-10-26 Drew Board Outline
    [SolarPanel.brd, SolarPanel.sch]
2018-10-26 Added Second ADC
    [SolarPanel.brd, SolarPanel.sch]
2018-10-27 Updated Block Diagram
    [SolarPanel.brd, SolarPanel.sch]
2018-10-28 Started mCAD for +XPanel
    [+XPanel.iam, +XPanel_AntennaMount.ipt, +XPanel_AntennaPost.ipt, +XPanel_PCB.ipt]
2018-10-28 Created Schematic for ADCS Portion
    [Avionics.sch]
2018-10-30 Rough Locations for Battery Chargers, Connectors, GPIO
    [SolarPanel.brd, SolarPanel.sch]
2018-10-31 Worked on Routing
    [SolarPanel.brd, SolarPanel.sch]
2018-11-01 CADed Antennas
    [+XPanel.iam, +XPanel_AntennaMount.ipt, +XPanel_AntennaPost.ipt, +XPanel_AntennaStored+Y.ipt, +XPanel_AntennaStored-Y.ipt, +XPanel_AntennaString.ipt, +XPanel_PCB.ipt]
2018-11-03 Added Deployed Antenna
    [+XPanel.iam, +XPanel_AntennaDeployed.ipt, +XPanel_AntennaStored+Y.ipt]
2018-11-03 CADed High Gain Antenna
    [-ZPanel.iam, -ZPanel_AntennaDeloyed.ipt, -ZPanel_AntennaStored.ipt, -ZPanel_PCB.ipt, -ZPanel_PCBExtender.ipt, -ZPanel_SpringDeployed.ipt, -ZPanel_SpringLeft.ipt, -ZPanel_SpringRight.ipt]
2018-11-04 Added Mounting Holes
    [-ZPanel_PCB.ipt]
2018-11-05 Changed 56-0004 to 56-0006
    [EPS.brd, EPS.sch]
2018-11-05 Updated From Wrong Branch
    [+XPanel.sch]
2018-11-05 Routed MPPTs, part of ADC
    [SolarPanel.brd, SolarPanel.sch]
2018-11-05 Routed Grounds, Power
    [SolarPanel.brd, SolarPanel.sch]
2018-11-07 Added Access Cutouts
    [-ZPanel_PCB.ipt]
2018-11-07 Minor Routing Changes
    [SolarPanel.brd]
2018-11-08 Routing Changes, Added Thermistors
    [SolarPanel.brd, SolarPanel.sch]
2018-11-10 Adjusted Camera Hole
    [-ZPanel.iam, -ZPanel_PCB.ipt, -ZPanel_PCBExtender.ipt]
2018-11-10 Created Camera Payload Block Diagram
    [Payload-A.brd, Payload-A.sch, Payload-Camera.sch]
2018-11-10 Created Germination Payload Block Diagram
    [Payload-Germination.sch]
2018-11-12 Addded Photodiode, Moved Holes
    [SolarPanel.brd, SolarPanel.sch]
2018-11-12 +x schematic
    [+XPanel2.sch]
2018-11-12 Update CougSat1-Umbilical/ElectricalDesign/Umbilical.sch
    Finished Umbilical schematic
    [Umbilical.sch]
2018-11-12 Moved Mounting Hole Capacitors
    [SolarPanel.brd, SolarPanel.sch]
2018-11-12 Length Matched I2C
    [SolarPanel.brd]
2018-11-13 Exported to STEP
    [-ZPanel.1.0.0.stp]
2018-11-13 Added Photodiodes
    [-ZPanel.sch]
2018-11-13 Update CougSat1-Umbilical/ElectricalDesign/Umbilical.sch
    Fixed typing errors and cleaned up schmatic
    [Umbilical.sch]
2018-11-14 Added µController, ADC, and SD Cards
    [Comms.sch]
2018-11-15 Added 5V Regulator
    [Comms.sch]
2018-11-15 Adjusted Holes
    [+XPanel.iam, +XPanel_PCB.ipt]
2018-11-15 Update CougSat1-Umbilical/ElectricalDesign/Umbilical.sch
    1.0.1
    Cleaned up schematic and changed resistors.
    [Umbilical.sch]
2018-11-15 Update CougSat1-Umbilical/ElectricalDesign/Umbilical.sch
    1.0.2
    Fixed value of J3
    [Umbilical.sch]
2018-11-15 Added RF Clocks
    [Comms.sch]
2018-11-18 Added Differential Drivers
    [Comms.sch]
2018-11-20 Arranged Reference Designators
    [SolarPanel.brd, SolarPanel.sch]
2018-11-23 Added 9V Regulator
    [Comms.sch]
2018-11-24 Added 230mm Amplifiers
    [Comms.sch]
2018-11-24 Added Power Amplifiers and 700mm TX
    [Comms.sch]
2018-11-25 Added RF Switch
    [Comms.sch]
2018-11-27 Added RX LNA
    [Comms.sch]
2018-11-30 Added Demodulator
    [Comms.sch]
2018-12-01 Wrote Non-RF Design Documentation
    [Comms.sch]
2018-12-02 Wrote RF Chain Documentation
    [Comms.sch]
2018-12-04 Added Layout Constraints
    [Comms.sch]
2018-12-07 Fixed Separation Switching Test
2018-12-09 Finished Layout
    [SolarPanel.brd, SolarPanel.sch]
2018-12-09 Created Gerbers
2018-12-10 Exported PDFs of Schematic
    [SolarPanel.brd, SolarPanel.sch]
2018-12-11 Fixed Solar Cell Stopmask
    [SolarPanel.brd, SolarPanel.sch]
2018-12-11 Created mCAD
    [SolarPanel.iam, SolarPanel_CoilForm.ipt, SolarPanel_PCB.ipt]
2019-01-10 Fixed Issues
    [Comms.sch]
2019-01-11 Laid Out Board
    [Comms.brd]
2019-01-20 Added Resistors to Sense Signals For ADC
    [SolarPanel.brd, SolarPanel.sch]
2019-01-20 Updates to ADC Section of Solar Panel Documentation
2019-01-20 Added BOM for Solar Panel
    [SolarPanelBOM.csv]
2019-01-27 Schematic Asthetic Changes
    [SolarPanel.brd, SolarPanel.sch]
2019-01-31 Updated Avionics Schematic
    [Avionics.sch]
2019-01-31 Edited ADCs and RF Clock Generators
    [Comms.brd, Comms.sch]
2019-02-02 Minor Schematic Changes
    [SolarPanel.brd, SolarPanel.sch]
2019-02-02 Wrote Testing 3.1
    [Comms.brd, Comms.sch]
2019-02-03 Added Paired Resistors
    [SolarPanel.brd, SolarPanel.sch]
2019-02-04 Adjusted Layout After Part Changes
    [Comms.brd, Comms.sch]
2019-02-04 Exported Gerbers
2019-02-05 Wrote Power Supplies and µController Tests
    [Comms.brd, Comms.sch]
2019-02-06 Wrote RF Chain Testing and Added mCAD to Full Assembly
    [Comms.brd, Comms.sch]
2019-02-09 Worked on Functional Tests
    [SolarPanel.brd, SolarPanel.sch]
2019-02-09 Fixed SPI Flash Typo
2019-02-10 Add files via upload
    Added through holes. Gave +1mm to -z panel spacing.
    [+XPanel.SLDASM, -ZPanel.1.0.0.SLDASM, 10mm_91239A115_CLASS 10.9 STL BUTTON-HEAD SOCKET CAP SCREW.SLDPRT, 5mm_91290A110_BLACK-OXIDE CLASS 12.9 SOCKET HEAD CAP SCREW.SLDPRT, 6mm_91290A111_BLACK-OXIDE CLASS 12.9 SOCKET HEAD CAP SCREW.SLDPRT, 90965A130_TYPE 316 STAINLESS STEEL FLAT WASHER.SLDPRT, 91239A109_CLASS 10.9 STL BUTTON-HEAD SOCKET CAP SCREW.SLDPRT, 91239A113_CLASS 10.9 STL BUTTON-HEAD SOCKET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]
2019-02-10 Fixed File Locations
    [+XPanel.SLDASM, -ZPanel.1.0.0.SLDASM, 10mm_91239A115_CLASS 10.9 STL BUTTON-HEAD SOCKET CAP SCREW.SLDPRT, 5mm_91290A110_BLACK-OXIDE CLASS 12.9 SOCKET HEAD CAP SCREW.SLDPRT, 6mm_91290A111_BLACK-OXIDE CLASS 12.9 SOCKET HEAD CAP SCREW.SLDPRT, 90965A130_TYPE 316 STAINLESS STEEL FLAT WASHER.SLDPRT, 91239A109_CLASS 10.9 STL BUTTON-HEAD SOCKET CAP SCREW.SLDPRT, 91239A113_CLASS 10.9 STL BUTTON-HEAD SOCKET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]
2019-02-10 Removed GPIO
    [SolarPanel.brd, SolarPanel.sch]
2019-02-10 Wrote ADC Functional Tests
    [SolarPanel.sch]
2019-02-11 Generated Gerbers
    [SolarPanel.brd]
2019-02-13 Add files via upload
    Magnetorquer slots added.
    Slots for payload added.
    Drawings updated.
    [+XPanel.SLDASM, -ZPanel.1.0.0.SLDASM, 10mm_91239A115_CLASS 10.9 STL BUTTON-HEAD SOCKET CAP SCREW.SLDPRT, 5mm_91290A110_BLACK-OXIDE CLASS 12.9 SOCKET HEAD CAP SCREW.SLDPRT, 6mm_91290A111_BLACK-OXIDE CLASS 12.9 SOCKET HEAD CAP SCREW.SLDPRT, 90965A130_TYPE 316 STAINLESS STEEL FLAT WASHER.SLDPRT, 91239A109_CLASS 10.9 STL BUTTON-HEAD SOCKET CAP SCREW.SLDPRT, 91239A113_CLASS 10.9 STL BUTTON-HEAD SOCKET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]
2019-02-15 Fixes to testing section, rewrote ADC
2019-02-15 Added 5k series resistors on ADC inputs
    [SolarPanel.brd, SolarPanel.sch]
2019-02-16 Added sections for photodiodes and thermistors
2019-02-16 Exported PDFs
    [SolarPanel.brd, SolarPanel.sch]
2019-02-17 Fixed Formatting, Updated mCAD
    [SolarPanel.2.0.1.stp, SolarPanel.brd, SolarPanel.iam, SolarPanel.sch, SolarPanel_PCB.ipt]
2019-02-25 Updated Backplane and Card to Revision 3.0
    [CardRailStandard.ipt, CardStandard.idw, CardStandard.ipt]
2019-02-25 Created pin allocation for new connector
    [ElectricalBusAllocation.xlsx]
2019-03-03 Tested 3.3V Regulator
    [Efficiency.xlsx, RegulatorA-10kHz.csv]
2019-03-03 Added RC to reset and changed current sense resistor.
    [Umbilical.sch]
2019-03-21 update schematic
    [Umbilical.brd, Umbilical.sch]
2019-03-24 added test points
    [Umbilical.brd, Umbilical.sch]
2019-03-24 fixed board outline
    [Umbilical.brd, Umbilical.sch]
2019-03-24 Routed everything
    [Backplane.brd, Backplane.sch]
2019-03-24 Placed components
    [Umbilical.brd, Umbilical.sch]
2019-03-24 Tested 3.3V Regulator Output Current Limit
2019-03-25 Tested Analog Voltage Reference
2019-03-28 Updated +X.sch
    [+XPanel.sch]
2019-03-28 Tested Battery Load Response
2019-03-31 Updated Schematic
    [+XPanel.sch]
2019-03-31 Removed Outdated Schematic
    [+XPanel2.sch]
2019-03-31 Placed jacks
    [Backplane.brd, Backplane.sch]
2019-03-31 Created Design Document, Updated Schematic
    [+XPanel.sch]
2019-04-03 Added Final Components to Schematic
    [Avionics.sch]
2019-04-03 Started 3.3V Load Response Testing
2019-04-05 Changed Alternate Parts and Removed Project Files
    [Comms.brd, Comms.sch]
2019-04-07 Minor routing/asthetic changes
    [Backplane.brd, Backplane.sch]
2019-04-07 Created Schematic and Design Document
    [-ZPanel.sch]
2019-04-11 Exported PDF
    [Umbilical.brd, Umbilical.sch]
2019-04-11 Added balancing and silkscreen decals
    [Backplane.brd, Backplane.sch]
2019-04-14 Updated Schematic and Design Document
    [+XPanel.sch]
2019-04-14 Performed before-power-on tests
    [SolarPanel.brd, SolarPanel.sch]
2019-04-21 Added voltage reference
    [+XPanel.sch]
2019-04-22 Added ADC address
    [+XPanel.sch]
2019-04-28 Tested 3.3V Load Response
2019-04-28 Added Antenna Parameters
2019-04-28 Reorganized Schematic Document
2019-05-16 Final asthetic changes, re-exported pdfs
    [Backplane.brd, Backplane.sch]
2019-05-16 Completed output voltage test
2019-05-18 Tested Battery Protection
2019-05-19 Made breakout board
    [Breakout.brd, Breakout.sch]
2019-05-19 Exported gerbers for breakout board
2019-05-19 Fixed dimension errors, updated signature
    [Backplane.brd, Backplane.sch]
2019-05-20 Fixed Board Outline and Updated mCAD
    [Backplane.brd, Backplane.iam, Backplane_PCB.ipt]
2019-05-22 Changed current limit test for battery chargers
    [SolarPanel.brd, SolarPanel.sch]
2019-05-27 Tested 5V regulator and before power on check
    [5V - Efficiency.xlsx, 5V - Ripple - 1kHz.csv]
2019-06-17 Did output voltage tests
2019-06-23 Update Avionics.sch
    Adjusted schematic
    [Avionics.sch]
2019-06-23 Added inductor
    [Avionics.sch]
2019-06-23 Fixed errors in board layout
    [Backplane.brd, Backplane.sch]
2019-06-23 This file didn't get saved
    [Backplane.sch]
2019-06-26 Tested temperature sensing
2019-06-27 Updated RBF pin switch
    [Backplane.iam, CardStandard.ipt, EPS_BatteryHeatsink.ipt, EPS_BatteyTie.ipt, EPS_PCB.ipt, EPS_RBFPinHolder.ipt, EPS_SwitchNut.ipt]
2019-06-27 Updated block diagram and power rails sheets
    [EPS.sch]
2019-06-28 Changed input switching to auto-balancing ideal diodes
    [EPS.sch]
2019-06-29 Updated Document
    [+XPanel.sch]
2019-06-29 Completed testing
    [Efficiency.xlsx]
2019-06-30 Fixed Typo in Document
    [+XPanel.sch]
2019-07-01 Updated Thermistors
    [Avionics.sch]
2019-07-01 Added Current-Sense Amplifiers
    [Avionics.sch]
2019-07-01 Updated ADCs
    [Avionics.sch]
2019-07-01 Adjusted SPI and LED pins
    [Avionics.sch]
2019-07-03 Updated connectors
    [+XPanel.sch]
2019-07-08 Added new ADC
    [+XPanel.sch]
2019-07-08 Updated Power Rails
    [Avionics.sch]
2019-07-08 Updated battery protection and current monitoring
    [EPS.sch]
2019-07-08 Updated separation switching
    [EPS.sch]
2019-07-08 Resolved Errors
    [Avionics.sch]
2019-07-09 Revision 1.1
    Made changes to fix errors listed for design document and schematic
    [-ZPanel.sch]
2019-07-09 Updated 3.3V regulator current sense and 3.3V ideal diodes
    [EPS.sch]
2019-07-09 Changed output switching to ideal diodes
    [EPS.sch]
2019-07-10 Updated Off-sheet Connectors
    [Avionics.sch]
2019-07-10 Updated ADC Address
    [+XPanel.sch]
2019-07-10 Fixed Off-Sheet Connector
    [+XPanel.sch]
2019-07-10 Updated backplane connection and started pin planning
    [EPS.sch]
2019-07-12 Fixed ERC errors
    [EPS.sch]
2019-07-14 Added Thermistors
    [+XPanel.sch]
2019-07-17 Minor schematic asthetic changes
    [+XPanel.sch]
2019-07-17 Finished Schematic and Updated ADCS Design Doc
2019-07-18 Updated off sheet connector labels
    [EPS.sch]
2019-07-18 Executed Comms Test 3.10, 3.8
    [5V - Ripple - 1kHz.csv, 9V - Efficiency.xlsx]
2019-07-24 Merged and fixed conflicts
    [Umbilical.brd, Umbilical.sch]
2019-07-25 Created Board File
    [+XPanel.brd]
2019-07-26 Placed holes
    [+XPanel.brd, +XPanel.sch]
2019-07-26 Executed Test 3.10-9V, 3.13, & 3.14
2019-07-27 Finished Initial Part Placement
    [+XPanel.brd]
2019-07-27 Updated design document
    [EPS.brd, EPS.sch]
2019-07-28 Fixed mCAD merge
    [EPS.iam, EPS_PCB.ipt]
2019-07-28 Fixed Parts Placement
    [+XPanel.brd]
2019-07-28 Added Nuts
    [+XPanel.brd, +XPanel.sch]
2019-07-28 Created Shapes
    [+XPanel.brd]
2019-07-29 Drew tKeepout for deployables
    [+XPanel.brd, +XPanel.sch]
2019-07-30 Moved Parts Out of Restricted Area
    [+XPanel.brd]
2019-07-31 Update -ZPanel.sch
    Ready for re-review
    [-ZPanel.sch]
2019-07-31 Moved Patch Antenna
    [+XPanel.brd, +XPanel.sch]
2019-07-31 Tested LDOs and I2C bus
2019-07-31 Updated Umbilical
    [Umbilical.brd]
2019-08-01 Moved decoupling capacitors
    [+XPanel.brd, +XPanel.sch]
2019-08-01 Fixed typos
    [EPS.sch]
2019-08-03 Moved Capacitors
    [+XPanel.brd, +XPanel.sch]
2019-08-03 Routed Initial Traces
    [+XPanel.brd, +XPanel.sch]
2019-08-04 Began EPS part placement
    [EPS.brd, EPS.sch]
2019-08-05 Revised Schematic and Began Board Placement
    [Avionics.brd, Avionics.sch]
2019-08-05 Exported Schematic to PDF
2019-08-08 Added ADC
    [Payload-Camera.sch]
2019-08-10 Placed most parts
    Fixes #483
    [EPS.brd, EPS.sch]
2019-08-13 Revised Schematic
    [Avionics.brd, Avionics.sch]
2019-08-16 Changed EPS to 4 layer
    [EPS.brd, EPS.sch]
2019-08-18 Added cameras
    [Payload-Camera.sch]
2019-08-18 Routed I2C
    [+XPanel.brd]
2019-08-18 Ready For Review
    [-ZPanel.sch]
2019-08-19 Laid out output and battery protection blocks
    [EPS.brd, EPS.sch]
2019-08-21 Laid out 3.3V-A
    [EPS.brd, EPS.sch]
2019-08-23 Laid out PV input 0 & 1 and moved 3V3-B regulator
    [EPS.brd, EPS.sch]
2019-08-25 Updated RF Traces
    [+XPanel.brd, +XPanel.sch]
2019-08-27 Laid out 3.3V-B and B side PV inputs
    [EPS.brd, EPS.sch]
2019-08-29 Laid out VIN and battery current sense
    [EPS.brd, EPS.sch]
2019-08-30 Added geiger counter
    [Payload-Camera.sch]
2019-08-31 Laid out battery B
    [EPS.brd, EPS.sch]
2019-09-05 Laid out temperature ADC and output switching control
    [EPS.brd, EPS.sch]
2019-09-08 Created design document
    [Payload-Camera.sch]
2019-09-08 Added GPIO Expander
    [Payload-Camera.sch]
2019-09-08 Rerouted Traces
    [+XPanel.brd, +XPanel.sch]
2019-09-08 Updated RF
    [+XPanel.brd, +XPanel.sch]
2019-09-08 Fixed trace width issues
    [Umbilical.brd]
2019-09-09 Laid out JTAG, BH-0, and remaining ADC
    [EPS.brd, EPS.sch]
2019-09-10 Laid out remaining signals
    [EPS.brd, EPS.sch]
2019-09-11 Final asthetic changes, exported pdf
    [Payload-Camera.sch]
2019-09-12 Update umbilical
    [Umbilical.brd]
2019-09-13 1.0.3
    Ready for review
    [-ZPanel.sch]
2019-09-14 Adjusted trace layout and polygons
    [EPS.brd, EPS.sch]
2019-09-14 Placed reference designators
    [EPS.brd, EPS.sch]
2019-09-15 Document block diagram section
    [Payload-Camera.sch]
2019-09-16 Fixed formatting and removed bad files
    [Avionics.brd, Avionics.sch]
2019-09-18 Changed AVDD to AVDD-0
    [Avionics.brd, Avionics.sch]
2019-09-20 Updated tests and off-sheet connectors
    [EPS.sch]
2019-09-22 Added dcaps, wrote more documentation
    [Payload-Camera.sch]
2019-09-22 Exported PDF Added Balancing
    [Umbilical.brd]
2019-09-22 Generated Gerber File
    [Umbilical.brd]
2019-09-22 Design Doc ready for review
    Layout is extremely rough
    [-ZPanel.brd]
2019-09-22 Finished schematic section documentation
2019-09-22 Removed bad files
    [copper_bottom.gbr, copper_top.gbr, drills.xln, gerber_job.gbrjob, profile.gbr, silkscreen_bottom.gbr, silkscreen_top.gbr, soldermask_bottom.gbr]
2019-09-24 Switched CTRL_RESET to GPIO pins
    [Backplane.brd, Backplane.sch]
2019-09-24 Exported pdfs and gerbers
2019-09-25 Added Three M2 Holes
    [Umbilical.brd, Umbilical.sch]
2019-09-25 Fixed Mounting Holes And Pico Lock
    [Umbilical.brd]
2019-09-25 Wrote layout constraints
    [Payload-Camera.sch]
2019-09-25 Changed Board Size
    [Umbilical.brd]
2019-09-26 Added board thickness to document
2019-09-26 Drew Mechanical Page
    [Umbilical.brd, Umbilical.sch]
2019-09-26 Fixed The Last Issues
    [Umbilical.brd, Umbilical.sch]
2019-09-26 Fixed DRC issues
    [Umbilical.brd, Umbilical.sch]
2019-09-26 FIxed Revision Number
    [Umbilical.sch]
2019-09-27 Removed pull up from current sense
    [EPS.brd, EPS.sch]
2019-09-29 Addressed feedback in schematic section
    [Payload-Camera.sch]
2019-09-29 Added buffers on I2C and SPI busses
    [Payload-Camera.sch]
2019-09-29 Fixed RF Traces
    [+XPanel.brd, +XPanel.sch]
2019-10-02 Removed CTRL_RESET
    [Avionics.brd, Avionics.sch]
2019-10-04 Switched out old ADCs for new ADCs
    [SolarPanel.brd, SolarPanel.sch]
2019-10-06 Switched a DGND to AGND
    [Payload-Camera.sch]
2019-10-06 Laid out RF
    [+XPanel.brd, +XPanel.sch]
2019-10-06 Fixed Airwires
    [+XPanel.brd]
2019-10-06 Finished items listed
    Comments:
    -Gabe verified AS1 low AS0 high
    -Unsure about section 3 formatting
    [-ZPanel.brd, -ZPanel.sch]
2019-10-06 Ready for re-review
    Fixed issues mentioned before.
    [-ZPanel.sch]
2019-10-06 Placed Large Components
    [Avionics.brd, Avionics.sch]
2019-10-07 Added dcaps to buffers, specified 7b I2C addresses
    [Payload-Camera.sch]
2019-10-07 Routed Traces
    [+XPanel.brd, +XPanel.sch]
2019-10-07 Fixed formatting and adjusted antenna tests
    [-ZPanel.sch]
2019-10-08 Changed photodiode circuit
    [SolarPanel.sch]
2019-10-09 Stuffed addresses on variants, exported PDFs
    [SolarPanel.brd, SolarPanel.sch]
2019-10-09 Modified Photodiode
    [+XPanel.brd, +XPanel.sch]
2019-10-10 Fixed Traces
    [+XPanel.brd]
2019-10-10 Updated Photodiode Schematic
    [+XPanel.brd, +XPanel.sch]
2019-10-12 Moved photodiode into shield, placed analog components
    [Payload-Camera.brd]
2019-10-13 Added Balancing
    [+XPanel.brd, +XPanel.sch]
2019-10-14 Tested uplink and downlink chains
2019-10-14 Laid out analog traces
    [Payload-Camera.brd, Payload-Camera.sch]
2019-10-16 Optimized Traces
    [+XPanel.brd, +XPanel.sch]
2019-10-17 Added Decoupling Capacitor
    [+XPanel.brd, +XPanel.sch]
2019-10-20 added buffers
    not wired yet
    [Payload-Germination.sch]
2019-10-20 Exported Files
    [+XPanel.brd, +XPanel.sch]
2019-10-21 Addressed feedback
    [Payload-Camera.brd, Payload-Camera.sch]
2019-10-22 Fixed board coordinates and created mCAD
    [+XPanel.iam, +XPanel_PCB.ipt, -ZPanel.iam, -ZPanel_PCB.ipt, Backplane.iam, CardStandard.ipt, Payload-Camera.brd, Payload-Camera.iam]
2019-10-23 Fixed chematic off-sheet connectors
    [SolarPanel.brd, SolarPanel.sch]
2019-10-23 Fixed final DRC errors and re-exported gerbers
    [Payload-Camera.brd]
2019-10-23 Implemented MOD 7, 9 and updated libraries
    [Comms.brd, Comms.sch]
2019-10-23 Reallocated microcontroller pins and added baseband filters to LTSpice
2019-10-23 Designed RF filters
2019-10-24 Fixed Errors
    [+XPanel.brd]
2019-10-27 Updated microcontroller, ADCs, RF clock generators, and power rails
    [Comms.brd, Comms.sch]
2019-10-27 Updated buffer connections
    Connected SPI and I2C to buffers
    [Payload-Germination.sch]
2019-10-27 Revert "Updated buffer connections"
    This reverts commit 97c00d36a388c3aa67f6eef2402791ba84bf0edd.
    [Payload-Germination.sch]
2019-10-27 Reverts the revert
    [Payload-Germination.sch]
2019-10-28 Addressed most feedback points
    [SolarPanel.brd, SolarPanel.sch]
2019-10-28 Completed Schematic
    Fixes #185
    Added powerlines to buffers
    Labeled aesthetics in&out to appropriate data lines.
    [Payload-Germination.sch]
2019-10-29 Finished Placing Components, Began Wiring
    [Avionics.brd, Avionics.sch]
2019-10-29 Updated baseband DAC and amplifiers
    [Comms.brd, Comms.sch]
2019-10-29 Deleted Empty Sheets
    [Avionics.sch]
2019-10-30 Replaced DAC with 27-0006
    [Comms.brd, Comms.sch]
2019-10-30 Updated 700mm PA
    [Comms.brd, Comms.sch]
2019-10-30 Fixed Spacing
    [+XPanel.brd, +XPanel.sch]
2019-10-31 Added Variant Label
    [+XPanel.brd, +XPanel.sch]
2019-10-31 Updated RX demodulator
    [Comms.brd, Comms.sch]
2019-11-03 Updated 230mm PA and removed 9V and -3.3V supplies
    [Comms.brd, Comms.sch]
2019-11-03 Placed AVDD Circuits and Ground Straps
    [Avionics.brd, Avionics.sch]
2019-11-04 Added RF Trace Constraints
2019-11-04 Changed processor and fixed ERC errors
    [Comms.brd, Comms.sch]
2019-11-04 Updated Comms schematic design section
2019-11-04 Updated layout constraints and tests
    [Comms.brd, Comms.sch]
2019-11-07 Updated photodiode circuit
    [SolarPanel.brd, SolarPanel.sch]
2019-11-07 Exported Schematic
    [+XPanel.brd, +XPanel.sch]
2019-11-07 Created mCAD and updated board reference designators and RF soldermask
    [+XPanel.brd, +XPanel.iam, +XPanel.sch, +XPanel_PCB.ipt]
2019-11-08 Began part placement
    [Comms.brd, Comms.sch]
2019-11-09 Placed Comms parts
    [Comms.brd, Comms.sch]
2019-11-09 Laid out RF traces
    [Comms.brd, Comms.sch]
2019-11-09 Laid out decapaps for the RF chips
    [Comms.brd, Comms.sch]
2019-11-09 Changed isolated ground to a solid DGND and relaying on layout to ensure good layout
    [Comms.brd, Comms.sch]
2019-11-10 Laid out 230mm radio
    [Comms.brd, Comms.sch]
2019-11-10 Laid out 700mm modulator
    [Comms.brd, Comms.sch]
2019-11-10 Completed Schematic
    Made all changes. Started Mechanical
    [Payload-Germination.sch]
2019-11-10 Addressed feedback, exported PDFs
    [SolarPanel.brd, SolarPanel.sch]
2019-11-11 Tested Most Resistances
2019-11-12 Laid out 700mm demodulator
    [Comms.brd, Comms.sch]
2019-11-13 Layout 1.0.0
    [-ZPanel.brd, -ZPanel.sch]
2019-11-14 Revert "Layout 1.0.0"
    This reverts commit 992a898be94d747baefa5f2d3c94eef64dce9a72.
    [-ZPanel.brd, -ZPanel.sch]
2019-11-14 Revert "Layout 1.0.0"
    This reverts commit 45e26b36c6b6eae2ae3e254edbdc3df9bd2e5650.
    [-ZPanel.brd, -ZPanel.sch]
2019-11-14 Layout 1.0.1
    Layout is ready for review. I changed the order of thermal inputs to the ADC for layout purposes on the schematic side also
    [-ZPanel.brd, -ZPanel.sch]
2019-11-14 Laid out SPI flash and ADCs :rocket:
    [Comms.brd, Comms.sch]
2019-11-14 Layout for -Z 1.0.1
    [-ZPanel.brd]
2019-11-15 Laid out SPI bus, regulator, and JTAG
    [Comms.brd, Comms.sch]
2019-11-15 Layout 1.0.2
    Ready for RF
    [-ZPanel.brd, -ZPanel.sch]
2019-11-17 Laid out ADCs and 700mm thermistors and SPI
    [Comms.brd, Comms.sch]
2019-11-19 Laid out remaining traces
    [Comms.brd, Comms.sch]
2019-11-19 Adjusted silkscreen
    [Comms.brd, Comms.sch]
2019-11-19 Fixed photodiode circuit
    [SolarPanel.brd, SolarPanel.sch]
2019-11-19 Addressed all feedback
    [SolarPanel.brd, SolarPanel.sch]
2019-11-21 Updated off-sheet labels and exported gerbers
    [Comms.brd, Comms.sch]
2019-11-21 Created mCAD, fixed silkscreen
    [+XPanel.iam, +XPanel_PCB.ipt, Comms.brd, Comms.sch, Comms_PCB.ipt, Payload-Camera.iam, Structure.iam]
2019-11-28 Adjusted ground pour and R84 ref des
    [Comms.brd]
2020-01-19 Routed Most Traces
    [Avionics.brd, Avionics.sch]
2020-01-20 Removed 23cm from link budget
    [Link Budget.xlsx]
2020-01-20 Removed 230mm circuits
    [Comms.brd, Comms.sch, Link Budget.xlsx]
2020-01-20 Removed 230mm from design document
2020-01-23 Ready for review
    Ripped up RF traces
    [-ZPanel.brd, -ZPanel.sch]
2020-01-26 Photodiode Test
    [+XPanel.brd, +XPanel.sch]
2020-01-27 Placed most components for battery chargers
    [SolarPanel.brd, SolarPanel.sch]
2020-01-28 Placed most remaining components
    [SolarPanel.brd, SolarPanel.sch]
2020-01-30 Update -Z Layout
    Layout updated considering these notes
    - Caps and for chassis should be placed near contacts
    - avoid sharp corners
    - distance inconsistencies
    - top layer components
    - snap everything to the grid 0.25mm grid
    [-ZPanel.brd]
2020-01-30 Updated Layout Z
    Updated minimizing VREF and adding R1 to connect DGND to PGND
    [-ZPanel.brd, -ZPanel.sch]
2020-01-30 Update Layout -Z
    Ignore last one this one gud
    [-ZPanel.brd]
2020-01-30 Updated -Z Layout
    Last one bad this 1 gud
    [-ZPanel.brd]
2020-01-31 Tested antenna
2020-02-01 Added Germination Payload Temperature ADC to C&DH-Design
    [Avionics-Test.brd, Avionics-Test.sch, Avionics.brd, Avionics.sch]
2020-02-01 Added Camera I2C Addresses to C&DH-Design
2020-02-01 Completed Schematic
    [Payload-Germination.sch, Payload-Interposer.sch]
2020-02-02 Tested Antenna frequency
2020-02-07 Update -ZPanel.brd
    - Fixed layout concerning decoupling caps and other space inconsistencies
    [-ZPanel.brd]
2020-02-07 Board File Became Corrupted
    [Avionics-Test.brd]
2020-02-07 Revert "Board File Became Corrupted"
    This reverts commit 1ea1317df9c400dd9955655996187b1771273903.
    [Avionics-Test.brd]
2020-02-07 Board, error
    Board almost ready, error during save&push
    [Payload-Interposer.sch]
2020-02-08 Fixed merge conflicts
    [Payload-Interposer.sch]
2020-02-09 Made changes
    requested by HMS Hendrik
    [Payload-Interposer.sch]
2020-02-10 Updated schematic
    Separated chamber components from interposer components in schematic.
    Sheet 3 now has interposer components
    Sheet 4 now has Chamber components
    [Payload-Interposer.sch]
2020-02-10 Laid out battery chargers and ADCs
    [SolarPanel.brd, SolarPanel.sch]
2020-02-10 Finished laying out traces
    [SolarPanel.brd, SolarPanel.sch]
2020-02-10 Did silkscreen
    [SolarPanel.brd, SolarPanel.sch]
2020-02-10 Made changes
    As requested by Hendrik
    [Payload-Interposer.sch]
2020-02-11 Removed Unused Connectors, Shrunk Outline
    [Backplane.brd, Backplane.sch]
2020-02-12 Update -ZPanel.brd
    Added cross hatching and moved the reference designators into visible spots. Also fixed some space inconsistencies again.
    [-ZPanel.brd]
2020-02-12 Update -ZPanel.brd
    Fixed changes mentioned on slack
    [-ZPanel.brd]
2020-02-12 Made board and schematic pretty again
    [Backplane.brd, Backplane.sch]
2020-02-12 Recovered Board FIle
    [Avionics-Test.brd]
2020-02-13 Update -ZPanel.brd
    Fixed weirdness
    [-ZPanel.brd]
2020-02-13 Finished Routing C&DH ADC
    [Avionics-Test.brd]
2020-02-13 Rearranged IHU GPIO for Routing
    [Avionics-Test.brd, Avionics-Test.sch]
2020-02-13 Adjusted silkscreen and exported gerbers
    [SolarPanel.brd, SolarPanel.sch]
2020-02-14 Fixed minor routing asthetic issue
    [SolarPanel.brd]
2020-02-16 Updated mCAD decal
    [SolarPanel_PCB.ipt]
2020-02-16 Fixed polygon rank reference designators
    [Backplane.brd, Backplane.sch]
2020-02-17 Schematic Completed
    [Payload-Interposer.sch]
2020-02-19 Routed Some Power
    [Avionics-Test.brd]
2020-02-21 Implement schematic changes
    [EPS.brd, EPS.sch]
2020-02-21 Adjusted notes
    [EPS.brd, EPS.sch]
2020-02-23 made appropriate changes
    [Payload-Interposer.sch]
2020-02-23 Changed resistors
    [+XPanel.brd, +XPanel.sch]
2020-02-23 Revised changes mentioned in PR
    [-ZPanel.brd, -ZPanel.sch]
2020-02-23 Placed critical location components
    [+XPanel.brd, +XPanel.sch]
2020-02-24 Added power inhibit page
    [EPS.brd, EPS.sch]
2020-02-25 Completed Germination Payload System Doc 1.0
    [Payload-Interposer.sch]
2020-02-26 Removed unhelpful copper
    [EPS.brd, EPS.sch]
2020-02-26 Update 2/26/2020
    [-ZPanel.brd, -ZPanel.sch]
2020-02-28 Update 2/27/2020
    Added Signature
    [-ZPanel.brd, -ZPanel.sch]
2020-02-28 Imported structure from GrabCAD
    [Germination_Bottom.ipt, Germination_Top.ipt, Structure.iam, Structure_+X.ipt, Structure_+Z.ipt, Structure_-X.ipt, Structure_-Z.ipt, Structure_MagnetorquerForm.ipt]
2020-02-28 Fixed EPS interferences
    [EPS_BatteyTie.ipt, EPS_PCB.ipt]
2020-02-28 Fixed mCAD interferences
    [+XPanel.iam, -ZPanel.iam, CardStandard.ipt, Payload-Camera.iam, Payload-Camera_Support.ipt, SolarPanel.iam]
2020-02-28 Added interposer PCB
    [Payload-Interposer.iam, Payload-Interposer_PCB.ipt]
2020-03-01 Changed resistor in documentation
2020-03-01 Updated routing
    [+XPanel.brd]
2020-03-01 Began Routing DGND
    [Avionics-Test.brd]
2020-03-01 Imported updated solar panel heatsink
    [Structure.iam, Structure_SolarPanelHeatsink.ipt]
2020-03-02 Laid out output switching
    [EPS.brd, EPS.sch]
2020-03-05 Made mCAD and updated board
    [-ZPanel.1.1.1.stp, -ZPanel.brd, -ZPanel.iam, -ZPanel.sch, -ZPanel_AntennaDeloyed.ipt, -ZPanel_AntennaStored.ipt, -ZPanel_PCB.ipt, -ZPanel_PCBExtender.ipt]
2020-03-08 Updated board revision number
    [+XPanel.brd, +XPanel.sch]
2020-03-08 schematic updated
    [Payload-Interposer.sch]
2020-03-08 Asthetic changes
    [Payload-Interposer.sch]
2020-03-09 made more changes required
    [Payload-Interposer.sch]
2020-03-11 Began output current sensing layout
    [EPS.brd, EPS.sch]
2020-09-17 Laid out output current sensing
    [EPS.brd, EPS.sch]
2020-10-06 Laid out µController
    [EPS.brd, EPS.sch]
2020-10-06 Imported structure changes
    [Germination.iam, Germination_Bottom.ipt, Germination_Top.ipt, Structure.iam, Structure_+X.ipt, Structure_-X.ipt, Structure_-Z.ipt, Structure_MagnetorquerForm.ipt]
2020-10-20 Updated germination chamber
    [Germination.iam, Germination_Bottom.ipt, Germination_Top.ipt, Structure.iam]
2020-10-22 Updated structure for wire harness, updated wire harness
    [+XPanel.SLDASM, -ZPanel.1.0.0.SLDASM, 10mm_91239A115_CLASS 10.9 STL BUTTON-HEAD SOCKET CAP SCREW.SLDPRT, 5mm_91290A110_BLACK-OXIDE CLASS 12.9 SOCKET HEAD CAP SCREW.SLDPRT, 6mm_91290A111_BLACK-OXIDE CLASS 12.9 SOCKET HEAD CAP SCREW.SLDPRT, 90965A130_TYPE 316 STAINLESS STEEL FLAT WASHER.SLDPRT, 91239A109_CLASS 10.9 STL BUTTON-HEAD SOCKET CAP SCREW.SLDPRT, 91239A113_CLASS 10.9 STL BUTTON-HEAD SOCKET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]
2020-12-04 Added polygons
    [EPS.brd]
2020-12-04 Fixed silkscreen and off-sheet connectors
    [EPS.brd, EPS.sch]
2020-12-05 Exported gerbers and updated mCAD
    [CougSat-1.Harness.iam, EPS.Harness.iam, EPS.Harness.ipt, EPS_PCB.ipt, EPS_RegulatorHeatsink.ipt, EPS_RegulatorHeatsinkBatteryAdapter.ipt, EPS_RegulatorHeatsinkClamp.ipt, Payload-Camera_PCB.ipt]
2021-02-02 Regenerated gerbers v1.2.1 with updated card library part
    [Comms.brd, Comms.sch]
2021-02-09 Re-exported gerbers with minor corrections
    [Comms.brd]
2021-10-10 Routed 4 Layer Avionics Board
    [Avionics-Test.brd, Avionics-Test.sch]
2021-10-15 Adjusted silkscreen and poured polygons
    [Avionics-Test.brd, Avionics-Test.sch, Avionics.brd, Avionics.sch]
2021-10-26 Added signature
    [Avionics.brd, Avionics.sch]
2021-10-27 Produced mCAD
    [Avionics.brd, Avionics.iam, Avionics.sch, Avionics_PCB.ipt]
2021-10-27 Integrated Avionics into satellite
    [CougSat-1.Harness.iam, EPS_RegulatorHeatsink.ipt, Structure.iam]
